douglaspmcgowan/cloth-feed-gripper/docs/gripper/evidence/ui-publication-20261023/README.md

# Gripper fit/loading fixes delivered

PR21 was merged to main2018f46 and deployed to the existing https://cloth-feed-gripper.vercel.app project. The actual public review HTML, facts and provenance match the independently accepted source bytes. The existing live guard passed27checks with0failures.

Receiving Windows static checks passed29tests with1unchanged native-CadQuery skip; lint, public-content and canonical project verification passed. The deployed viewer regression exercised gap/overlap findings at390/768/1440, three loading/failure states and delayed-success recovery. All9native screenshots fully decode; raw assertions and bounds are retained.

The browser run used actual production HTML and model/data assets, with only the exact original verified Three.js dependency served from recorded fixtures. Blocked and delayed dependencies are intentional negative controls. This proves the scoped deployed UI behavior under that dependency boundary, not current CDN availability or full C2/hardware readiness. Prior independent acceptance in PDS PR87 applies to byte-identical product source. Known whole-model exploded clipping and camera-bearing permalink reload remain separate follow-ups. Film and engineering/physical claims are unchanged.

See summary.json and the complete19original browser artifacts. The phone gap capture shows both labelled comparison anchors and a locator; the dependency-terminal capture deliberately shows the failed-library recovery state.
