douglaspmcgowan/cloth-feed-gripper/ecad/gripper/kicad/fab/README.md

# Fabrication release — gripper controller rev A

<!-- ORDER-STATUS:BEGIN -->
## Order status — DO NOT ORDER

Input provenance uses per-module read granularity; each row lists modules read in margins.json.

- `input-fuse-hold`: missing: F1 MF-MSMF260/16X — hold-current tolerance at 25 C; find in datasheet electrical characteristics table; 47 uF ceramics — effective capacitance at DC bias; find in manufacturer DC-bias curves; FSR sensor — fit exponent confidence interval; find in DESIGN-BASIS.md section 10 force sweep; L1 SRP1245A-100M — inductance tolerance and bias derating; find in manufacturer datasheet curves; servo Fit A dyno specimen — stall-current fit confidence interval; find in DESIGN-BASIS.md section 10 force/current sweep; RS1 WSLP1206R1000FEA — resistance over temperature; find in manufacturer datasheet and calibration step; wrist capacitor — capacitance after bias temperature and ageing; find in manufacturer datasheet; unclassified: ELEC.c_comp_F; unclassified: ELEC.c_pole_F; unclassified: ELEC.cable_len_m; unclassified: ELEC.cable_power_awg; unclassified: ELEC.r_comp_ohm; unclassified: ELEC.r_fb_bot_ohm; unclassified: ELEC.r_fb_top_ohm; unclassified: ELEC.r_rt_ohm; unclassified: ELEC.vref_V; unclassified: ams_dropout_max; unclassified: ams_vout_tol; unclassified: awg20_ohm_m; unclassified: awg26_ohm_m; unclassified: buck_feedback_resistor_tolerance; unclassified: buck_input_max_v; unclassified: buck_input_min_v; unclassified: buck_nominal_input_v; unclassified: buck_servo_lead_resistance_ohm; unclassified: c12_esr; unclassified: c_wrist_esr; unclassified: cable_l_per_m; unclassified: cer_derate_6v6; unclassified: d2_vf; unclassified: d7_vf_100ma; unclassified: d7_vf_slope; unclassified: devkit_diode_drop; unclassified: devkit_overhead_a; unclassified: droop_5v_load_a; unclassified: droop_comp_zero_v; unclassified: droop_default_rise_s; unclassified: droop_default_vin_v; unclassified: droop_diode_v; unclassified: droop_end_time_s; unclassified: droop_fast_rise_s; unclassified: droop_fsw_hz; unclassified: droop_low_vin_v; unclassified: droop_no_wrist_cap_f; unclassified: droop_recovery_band_v; unclassified: droop_servo_idle_a; unclassified: droop_step_time_s; unclassified: droop_sweep_cap_1000_f; unclassified: droop_sweep_cap_2200_f; unclassified: droop_sweep_cap_220_f; unclassified: droop_sweep_cap_470_f; unclassified: droop_voltage_floor_v; unclassified: esp_bod_default; unclassified: esp_i_active_nowifi; unclassified: esp_i_wifi_rx; unclassified: esp_i_wifi_tx_peak; unclassified: esp_vdd_min_flash; unclassified: f1_hold; unclassified: f1_r1max; unclassified: fit_a_hold_a; unclassified: fit_a_resistance_ohm; unclassified: fit_a_torque_nm_per_a; unclassified: fit_b_hold_a; unclassified: fit_b_resistance_ohm; unclassified: fit_b_stall_a; unclassified: fit_b_torque_nm_per_a; unclassified: fsr_default_vcc_mv; unclassified: fsr_fit_r1n_ohm; unclassified: harness_plug_band_v; unclassified: ibus_5v_idle; unclassified: l1_dcr; unclassified: mcp_dropout_max; unclassified: mcp_iout_max; unclassified: mcp_rth_sot223; unclassified: mcp_vout_tol; unclassified: power_3v3_minus_1pct_mv; unclassified: power_3v3_minus_3pct_mv; unclassified: power_3v3_plus_1pct_mv; unclassified: power_3v3_rail_v; unclassified: power_board_plane_resistance_ohm; unclassified: power_diode_reference_current_a; unclassified: power_external_3v3_load_a; unclassified: power_fit_a_stall_current_a; unclassified: power_five_volt_rail_v; unclassified: power_fsr_force_high_n; unclassified: power_fsr_force_low_n; unclassified: power_fsr_return_current_a; unclassified: power_ground_wire_length_m; unclassified: power_ldo_dropout_scale_cap; unclassified: power_ldo_full_load_dropout_ratio; unclassified: power_ldo_light_load_a; unclassified: power_ldo_load_span_a; unclassified: power_log_current_floor_a; unclassified: power_rating_margin_factor; unclassified: power_regen_basis_mj; unclassified: power_regen_high_mj; unclassified: power_regen_low_mj; unclassified: power_regen_min_mj; unclassified: power_regen_rotor_mj; unclassified: power_starting_efficiency; unclassified: power_switch_transition_time_s; unclassified: power_usb_max_v; unclassified: power_usb_min_v; unclassified: q1_rds; unclassified: rs1_rating; unclassified: servo_idle_a; unclassified: servo_vmax; unclassified: servo_vmin; unclassified: tps_ea_gain; unclassified: tps_ea_gm; unclassified: tps_ea_imax; unclassified: tps_ilim_min; unclassified: tps_ilim_typ; unclassified: tps_iq; unclassified: tps_ps_gm; unclassified: tps_rds_typ; unclassified: tps_rt_coeff; unclassified: tps_rt_exp; unclassified: tps_rth_ja; unclassified: tps_vref; unclassified: tps_vref_max; unclassified: tps_vref_min; unclassified: wire_gauges_awg
- `input-fuse-trip`: missing: F1 MF-MSMF260/16X — trip-current tolerance at 25 C; find in datasheet electrical characteristics table; 47 uF ceramics — effective capacitance at DC bias; find in manufacturer DC-bias curves; FSR sensor — fit exponent confidence interval; find in DESIGN-BASIS.md section 10 force sweep; L1 SRP1245A-100M — inductance tolerance and bias derating; find in manufacturer datasheet curves; servo Fit A dyno specimen — stall-current fit confidence interval; find in DESIGN-BASIS.md section 10 force/current sweep; RS1 WSLP1206R1000FEA — resistance over temperature; find in manufacturer datasheet and calibration step; wrist capacitor — capacitance after bias temperature and ageing; find in manufacturer datasheet; unclassified: ELEC.c_comp_F; unclassified: ELEC.c_pole_F; unclassified: ELEC.cable_len_m; unclassified: ELEC.cable_power_awg; unclassified: ELEC.r_comp_ohm; unclassified: ELEC.r_fb_bot_ohm; unclassified: ELEC.r_fb_top_ohm; unclassified: ELEC.r_rt_ohm; unclassified: ELEC.vref_V; unclassified: ams_dropout_max; unclassified: ams_vout_tol; unclassified: awg20_ohm_m; unclassified: awg26_ohm_m; unclassified: buck_feedback_resistor_tolerance; unclassified: buck_input_max_v; unclassified: buck_input_min_v; unclassified: buck_nominal_input_v; unclassified: buck_servo_lead_resistance_ohm; unclassified: c12_esr; unclassified: c_wrist_esr; unclassified: cable_l_per_m; unclassified: cer_derate_6v6; unclassified: d2_vf; unclassified: d7_vf_100ma; unclassified: d7_vf_slope; unclassified: devkit_diode_drop; unclassified: devkit_overhead_a; unclassified: droop_5v_load_a; unclassified: droop_comp_zero_v; unclassified: droop_default_rise_s; unclassified: droop_default_vin_v; unclassified: droop_diode_v; unclassified: droop_end_time_s; unclassified: droop_fast_rise_s; unclassified: droop_fsw_hz; unclassified: droop_low_vin_v; unclassified: droop_no_wrist_cap_f; unclassified: droop_recovery_band_v; unclassified: droop_servo_idle_a; unclassified: droop_step_time_s; unclassified: droop_sweep_cap_1000_f; unclassified: droop_sweep_cap_2200_f; unclassified: droop_sweep_cap_220_f; unclassified: droop_sweep_cap_470_f; unclassified: droop_voltage_floor_v; unclassified: esp_bod_default; unclassified: esp_i_active_nowifi; unclassified: esp_i_wifi_rx; unclassified: esp_i_wifi_tx_peak; unclassified: esp_vdd_min_flash; unclassified: f1_hold; unclassified: f1_r1max; unclassified: f1_trip; unclassified: fit_a_hold_a; unclassified: fit_a_resistance_ohm; unclassified: fit_a_torque_nm_per_a; unclassified: fit_b_hold_a; unclassified: fit_b_resistance_ohm; unclassified: fit_b_stall_a; unclassified: fit_b_torque_nm_per_a; unclassified: fsr_default_vcc_mv; unclassified: fsr_fit_r1n_ohm; unclassified: harness_plug_band_v; unclassified: ibus_5v_idle; unclassified: l1_dcr; unclassified: mcp_dropout_max; unclassified: mcp_iout_max; unclassified: mcp_rth_sot223; unclassified: mcp_vout_tol; unclassified: power_3v3_minus_1pct_mv; unclassified: power_3v3_minus_3pct_mv; unclassified: power_3v3_plus_1pct_mv; unclassified: power_3v3_rail_v; unclassified: power_board_plane_resistance_ohm; unclassified: power_diode_reference_current_a; unclassified: power_external_3v3_load_a; unclassified: power_fit_a_stall_current_a; unclassified: power_five_volt_rail_v; unclassified: power_fsr_force_high_n; unclassified: power_fsr_force_low_n; unclassified: power_fsr_return_current_a; unclassified: power_ground_wire_length_m; unclassified: power_ldo_dropout_scale_cap; unclassified: power_ldo_full_load_dropout_ratio; unclassified: power_ldo_light_load_a; unclassified: power_ldo_load_span_a; unclassified: power_log_current_floor_a; unclassified: power_rating_margin_factor; unclassified: power_regen_basis_mj; unclassified: power_regen_high_mj; unclassified: power_regen_low_mj; unclassified: power_regen_min_mj; unclassified: power_regen_rotor_mj; unclassified: power_starting_efficiency; unclassified: power_switch_transition_time_s; unclassified: power_usb_max_v; unclassified: power_usb_min_v; unclassified: q1_rds; unclassified: rs1_rating; unclassified: servo_idle_a; unclassified: servo_vmax; unclassified: servo_vmin; unclassified: tps_ea_gain; unclassified: tps_ea_gm; unclassified: tps_ea_imax; unclassified: tps_ilim_min; unclassified: tps_ilim_typ; unclassified: tps_iq; unclassified: tps_ps_gm; unclassified: tps_rds_typ; unclassified: tps_rt_coeff; unclassified: tps_rt_exp; unclassified: tps_rth_ja; unclassified: tps_vref; unclassified: tps_vref_max; unclassified: tps_vref_min; unclassified: wire_gauges_awg
- `buck-current-limit`: missing: U1 TPS54560BDDAR — current-limit test-condition variation; find in datasheet electrical characteristics table; 47 uF ceramics — effective capacitance at DC bias; find in manufacturer DC-bias curves; L1 SRP1245A-100M — inductance tolerance and bias derating; find in manufacturer datasheet curves; servo Fit A dyno specimen — stall-current fit confidence interval; find in DESIGN-BASIS.md section 10 force/current sweep; RS1 WSLP1206R1000FEA — resistance over temperature; find in manufacturer datasheet and calibration step; wrist capacitor — capacitance after bias temperature and ageing; find in manufacturer datasheet; unclassified: ELEC.c_comp_F; unclassified: ELEC.c_pole_F; unclassified: ELEC.cable_len_m; unclassified: ELEC.cable_power_awg; unclassified: ELEC.r_comp_ohm; unclassified: ELEC.r_fb_bot_ohm; unclassified: ELEC.r_fb_top_ohm; unclassified: awg20_ohm_m; unclassified: c12_esr; unclassified: c_wrist_esr; unclassified: cable_l_per_m; unclassified: cer_derate_6v6; unclassified: devkit_overhead_a; unclassified: droop_5v_load_a; unclassified: droop_comp_zero_v; unclassified: droop_default_rise_s; unclassified: droop_default_vin_v; unclassified: droop_diode_v; unclassified: droop_end_time_s; unclassified: droop_fast_rise_s; unclassified: droop_fsw_hz; unclassified: droop_low_vin_v; unclassified: droop_no_wrist_cap_f; unclassified: droop_recovery_band_v; unclassified: droop_servo_idle_a; unclassified: droop_step_time_s; unclassified: droop_sweep_cap_1000_f; unclassified: droop_sweep_cap_2200_f; unclassified: droop_sweep_cap_220_f; unclassified: droop_sweep_cap_470_f; unclassified: droop_voltage_floor_v; unclassified: esp_i_active_nowifi; unclassified: esp_i_wifi_rx; unclassified: esp_i_wifi_tx_peak; unclassified: fit_a_hold_a; unclassified: fit_a_resistance_ohm; unclassified: fit_a_torque_nm_per_a; unclassified: fit_b_hold_a; unclassified: fit_b_resistance_ohm; unclassified: fit_b_stall_a; unclassified: fit_b_torque_nm_per_a; unclassified: ibus_5v_idle; unclassified: mcp_dropout_max; unclassified: mcp_iout_max; unclassified: power_external_3v3_load_a; unclassified: power_five_volt_rail_v; unclassified: power_ldo_dropout_scale_cap; unclassified: servo_vmin; unclassified: tps_ea_gain; unclassified: tps_ea_gm; unclassified: tps_ea_imax; unclassified: tps_ilim_min; unclassified: tps_ilim_typ; unclassified: tps_ps_gm; unclassified: tps_rds_typ; unclassified: tps_vref
- `buck-thermal`: missing: U1 TPS54560BDDAR — junction-to-ambient thermal resistance for the assembled PCB; find in DESIGN-BASIS.md section 10 thermal-rise bench step; 47 uF ceramics — effective capacitance at DC bias; find in manufacturer DC-bias curves; FSR sensor — fit exponent confidence interval; find in DESIGN-BASIS.md section 10 force sweep; L1 SRP1245A-100M — inductance tolerance and bias derating; find in manufacturer datasheet curves; servo Fit A dyno specimen — stall-current fit confidence interval; find in DESIGN-BASIS.md section 10 force/current sweep; RS1 WSLP1206R1000FEA — resistance over temperature; find in manufacturer datasheet and calibration step; wrist capacitor — capacitance after bias temperature and ageing; find in manufacturer datasheet; unclassified: ELEC.c_comp_F; unclassified: ELEC.c_pole_F; unclassified: ELEC.cable_len_m; unclassified: ELEC.cable_power_awg; unclassified: ELEC.r_comp_ohm; unclassified: ELEC.r_fb_bot_ohm; unclassified: ELEC.r_fb_top_ohm; unclassified: ELEC.r_rt_ohm; unclassified: ELEC.vref_V; unclassified: ams_dropout_max; unclassified: ams_vout_tol; unclassified: awg20_ohm_m; unclassified: awg26_ohm_m; unclassified: buck_feedback_resistor_tolerance; unclassified: buck_input_max_v; unclassified: buck_input_min_v; unclassified: buck_junction_rise_limit_c; unclassified: buck_nominal_input_v; unclassified: buck_servo_lead_resistance_ohm; unclassified: c12_esr; unclassified: c_wrist_esr; unclassified: cable_l_per_m; unclassified: cer_derate_6v6; unclassified: d2_vf; unclassified: d7_vf_100ma; unclassified: d7_vf_slope; unclassified: devkit_diode_drop; unclassified: devkit_overhead_a; unclassified: droop_5v_load_a; unclassified: droop_comp_zero_v; unclassified: droop_default_rise_s; unclassified: droop_default_vin_v; unclassified: droop_diode_v; unclassified: droop_end_time_s; unclassified: droop_fast_rise_s; unclassified: droop_fsw_hz; unclassified: droop_low_vin_v; unclassified: droop_no_wrist_cap_f; unclassified: droop_recovery_band_v; unclassified: droop_servo_idle_a; unclassified: droop_step_time_s; unclassified: droop_sweep_cap_1000_f; unclassified: droop_sweep_cap_2200_f; unclassified: droop_sweep_cap_220_f; unclassified: droop_sweep_cap_470_f; unclassified: droop_voltage_floor_v; unclassified: esp_bod_default; unclassified: esp_i_active_nowifi; unclassified: esp_i_wifi_rx; unclassified: esp_i_wifi_tx_peak; unclassified: esp_vdd_min_flash; unclassified: f1_hold; unclassified: f1_r1max; unclassified: fit_a_hold_a; unclassified: fit_a_resistance_ohm; unclassified: fit_a_torque_nm_per_a; unclassified: fit_b_hold_a; unclassified: fit_b_resistance_ohm; unclassified: fit_b_stall_a; unclassified: fit_b_torque_nm_per_a; unclassified: fsr_default_vcc_mv; unclassified: fsr_fit_r1n_ohm; unclassified: harness_plug_band_v; unclassified: ibus_5v_idle; unclassified: l1_dcr; unclassified: mcp_dropout_max; unclassified: mcp_iout_max; unclassified: mcp_rth_sot223; unclassified: mcp_vout_tol; unclassified: power_3v3_minus_1pct_mv; unclassified: power_3v3_minus_3pct_mv; unclassified: power_3v3_plus_1pct_mv; unclassified: power_3v3_rail_v; unclassified: power_board_plane_resistance_ohm; unclassified: power_diode_reference_current_a; unclassified: power_external_3v3_load_a; unclassified: power_fit_a_stall_current_a; unclassified: power_five_volt_rail_v; unclassified: power_fsr_force_high_n; unclassified: power_fsr_force_low_n; unclassified: power_fsr_return_current_a; unclassified: power_ground_wire_length_m; unclassified: power_ldo_dropout_scale_cap; unclassified: power_ldo_full_load_dropout_ratio; unclassified: power_ldo_light_load_a; unclassified: power_ldo_load_span_a; unclassified: power_log_current_floor_a; unclassified: power_rating_margin_factor; unclassified: power_regen_basis_mj; unclassified: power_regen_high_mj; unclassified: power_regen_low_mj; unclassified: power_regen_min_mj; unclassified: power_regen_rotor_mj; unclassified: power_starting_efficiency; unclassified: power_switch_transition_time_s; unclassified: power_usb_max_v; unclassified: power_usb_min_v; unclassified: q1_rds; unclassified: rs1_rating; unclassified: servo_idle_a; unclassified: servo_vmax; unclassified: servo_vmin; unclassified: tps_ea_gain; unclassified: tps_ea_gm; unclassified: tps_ea_imax; unclassified: tps_ilim_min; unclassified: tps_ilim_typ; unclassified: tps_iq; unclassified: tps_ps_gm; unclassified: tps_rds_typ; unclassified: tps_rt_coeff; unclassified: tps_rt_exp; unclassified: tps_rth_ja; unclassified: tps_vref; unclassified: tps_vref_max; unclassified: tps_vref_min; unclassified: wire_gauges_awg
- `trace-current`: missing: PCB copper — finished copper thickness tolerance; find in PCB fabricator stack-up certificate; servo Fit A dyno specimen — stall-current fit confidence interval; find in DESIGN-BASIS.md section 10 force/current sweep; unclassified: cu_rho; unclassified: cu_tc; unclassified: ipc_b; unclassified: ipc_c; unclassified: ipc_k_ext; unclassified: ipc_mil_per_oz; unclassified: trace_ambient_temperature_c; unclassified: trace_auxiliary_current_a; unclassified: trace_hold_current_a; unclassified: trace_mm_per_mil; unclassified: trace_reference_length_mm; unclassified: trace_reference_temperature_c; unclassified: trace_supply_current_a; unclassified: trace_temperature_rises_c; unclassified: trace_via_drill_mm; unclassified: trace_via_plating_um
- `trace-neck-current`: verify transient heating or widen neck; missing: PCB copper — finished copper thickness tolerance; find in PCB fabricator stack-up certificate; servo Fit A dyno specimen — stall-current fit confidence interval; find in DESIGN-BASIS.md section 10 force/current sweep; unclassified: cu_rho; unclassified: cu_tc; unclassified: ipc_b; unclassified: ipc_c; unclassified: ipc_k_ext; unclassified: ipc_mil_per_oz; unclassified: trace_ambient_temperature_c; unclassified: trace_auxiliary_current_a; unclassified: trace_hold_current_a; unclassified: trace_mm_per_mil; unclassified: trace_reference_length_mm; unclassified: trace_reference_temperature_c; unclassified: trace_supply_current_a; unclassified: trace_temperature_rises_c; unclassified: trace_via_drill_mm; unclassified: trace_via_plating_um
- `trace-temperature`: missing: PCB copper — finished copper thickness tolerance; find in PCB fabricator stack-up certificate; servo Fit A dyno specimen — stall-current fit confidence interval; find in DESIGN-BASIS.md section 10 force/current sweep; unclassified: cu_rho; unclassified: cu_tc; unclassified: ipc_b; unclassified: ipc_c; unclassified: ipc_k_ext; unclassified: ipc_mil_per_oz; unclassified: trace_ambient_temperature_c; unclassified: trace_auxiliary_current_a; unclassified: trace_hold_current_a; unclassified: trace_mm_per_mil; unclassified: trace_reference_length_mm; unclassified: trace_reference_temperature_c; unclassified: trace_supply_current_a; unclassified: trace_temp_rise_limit_c; unclassified: trace_temperature_rises_c; unclassified: trace_via_drill_mm; unclassified: trace_via_plating_um
- `trace-drop`: missing: PCB copper — finished copper thickness tolerance; find in PCB fabricator stack-up certificate; servo Fit A dyno specimen — stall-current fit confidence interval; find in DESIGN-BASIS.md section 10 force/current sweep; unclassified: cu_rho; unclassified: cu_tc; unclassified: ipc_b; unclassified: ipc_c; unclassified: ipc_k_ext; unclassified: ipc_mil_per_oz; unclassified: trace_ambient_temperature_c; unclassified: trace_auxiliary_current_a; unclassified: trace_hold_current_a; unclassified: trace_mm_per_mil; unclassified: trace_reference_length_mm; unclassified: trace_reference_temperature_c; unclassified: trace_servo_drop_limit_mv; unclassified: trace_supply_current_a; unclassified: trace_temperature_rises_c; unclassified: trace_via_drill_mm; unclassified: trace_via_plating_um
- `shunt-power`: 47 uF ceramics — effective capacitance at DC bias; find in manufacturer DC-bias curves; FSR sensor — fit exponent confidence interval; find in DESIGN-BASIS.md section 10 force sweep; L1 SRP1245A-100M — inductance tolerance and bias derating; find in manufacturer datasheet curves; servo Fit A dyno specimen — stall-current fit confidence interval; find in DESIGN-BASIS.md section 10 force/current sweep; RS1 WSLP1206R1000FEA — resistance over temperature; find in manufacturer datasheet and calibration step; wrist capacitor — capacitance after bias temperature and ageing; find in manufacturer datasheet; unclassified: ELEC.c_comp_F; unclassified: ELEC.c_pole_F; unclassified: ELEC.cable_len_m; unclassified: ELEC.cable_power_awg; unclassified: ELEC.r_comp_ohm; unclassified: ELEC.r_fb_bot_ohm; unclassified: ELEC.r_fb_top_ohm; unclassified: ELEC.r_rt_ohm; unclassified: ELEC.vref_V; unclassified: ams_dropout_max; unclassified: ams_vout_tol; unclassified: awg20_ohm_m; unclassified: awg26_ohm_m; unclassified: buck_feedback_resistor_tolerance; unclassified: buck_input_max_v; unclassified: buck_input_min_v; unclassified: buck_nominal_input_v; unclassified: buck_servo_lead_resistance_ohm; unclassified: c12_esr; unclassified: c_wrist_esr; unclassified: cable_l_per_m; unclassified: cer_derate_6v6; unclassified: d2_vf; unclassified: d7_vf_100ma; unclassified: d7_vf_slope; unclassified: devkit_diode_drop; unclassified: devkit_overhead_a; unclassified: droop_5v_load_a; unclassified: droop_comp_zero_v; unclassified: droop_default_rise_s; unclassified: droop_default_vin_v; unclassified: droop_diode_v; unclassified: droop_end_time_s; unclassified: droop_fast_rise_s; unclassified: droop_fsw_hz; unclassified: droop_low_vin_v; unclassified: droop_no_wrist_cap_f; unclassified: droop_recovery_band_v; unclassified: droop_servo_idle_a; unclassified: droop_step_time_s; unclassified: droop_sweep_cap_1000_f; unclassified: droop_sweep_cap_2200_f; unclassified: droop_sweep_cap_220_f; unclassified: droop_sweep_cap_470_f; unclassified: droop_voltage_floor_v; unclassified: esp_bod_default; unclassified: esp_i_active_nowifi; unclassified: esp_i_wifi_rx; unclassified: esp_i_wifi_tx_peak; unclassified: esp_vdd_min_flash; unclassified: f1_hold; unclassified: f1_r1max; unclassified: fit_a_hold_a; unclassified: fit_a_resistance_ohm; unclassified: fit_a_torque_nm_per_a; unclassified: fit_b_hold_a; unclassified: fit_b_resistance_ohm; unclassified: fit_b_stall_a; unclassified: fit_b_torque_nm_per_a; unclassified: fsr_default_vcc_mv; unclassified: fsr_fit_r1n_ohm; unclassified: harness_plug_band_v; unclassified: ibus_5v_idle; unclassified: l1_dcr; unclassified: mcp_dropout_max; unclassified: mcp_iout_max; unclassified: mcp_rth_sot223; unclassified: mcp_vout_tol; unclassified: power_3v3_minus_1pct_mv; unclassified: power_3v3_minus_3pct_mv; unclassified: power_3v3_plus_1pct_mv; unclassified: power_3v3_rail_v; unclassified: power_board_plane_resistance_ohm; unclassified: power_diode_reference_current_a; unclassified: power_external_3v3_load_a; unclassified: power_fit_a_stall_current_a; unclassified: power_five_volt_rail_v; unclassified: power_fsr_force_high_n; unclassified: power_fsr_force_low_n; unclassified: power_fsr_return_current_a; unclassified: power_ground_wire_length_m; unclassified: power_ldo_dropout_scale_cap; unclassified: power_ldo_full_load_dropout_ratio; unclassified: power_ldo_light_load_a; unclassified: power_ldo_load_span_a; unclassified: power_log_current_floor_a; unclassified: power_rating_margin_factor; unclassified: power_regen_basis_mj; unclassified: power_regen_high_mj; unclassified: power_regen_low_mj; unclassified: power_regen_min_mj; unclassified: power_regen_rotor_mj; unclassified: power_starting_efficiency; unclassified: power_switch_transition_time_s; unclassified: power_usb_max_v; unclassified: power_usb_min_v; unclassified: q1_rds; unclassified: rs1_rating; unclassified: rs1_tol; unclassified: servo_idle_a; unclassified: servo_vmax; unclassified: servo_vmin; unclassified: tps_ea_gain; unclassified: tps_ea_gm; unclassified: tps_ea_imax; unclassified: tps_ilim_min; unclassified: tps_ilim_typ; unclassified: tps_iq; unclassified: tps_ps_gm; unclassified: tps_rds_typ; unclassified: tps_rt_coeff; unclassified: tps_rt_exp; unclassified: tps_rth_ja; unclassified: tps_vref; unclassified: tps_vref_max; unclassified: tps_vref_min; unclassified: wire_gauges_awg
- `sense-range`: missing: U2 INA219AIDR — input-filter source-impedance mismatch; find in DESIGN-BASIS.md section 10 current-calibration bench step; servo Fit A dyno specimen — stall-current fit confidence interval; find in DESIGN-BASIS.md section 10 force/current sweep; RS1 WSLP1206R1000FEA — resistance over temperature; find in manufacturer datasheet and calibration step; unclassified: ELEC.r_ina_filter_ohm; unclassified: fit_a_hold_a; unclassified: fit_a_resistance_ohm; unclassified: fit_a_torque_nm_per_a; unclassified: fit_b_hold_a; unclassified: fit_b_resistance_ohm; unclassified: fit_b_stall_a; unclassified: fit_b_torque_nm_per_a; unclassified: gripper_pad_radius_m; unclassified: gripper_train_efficiency; unclassified: ina_average_codes_samples; unclassified: ina_average_fit_limit_s; unclassified: ina_chop_duty; unclassified: ina_chop_frequencies_hz; unclassified: ina_control_period_s; unclassified: ina_conv_12bit; unclassified: ina_conv_12bit_max; unclassified: ina_default_cfg; unclassified: ina_detection_limit_s; unclassified: ina_force_caps_n; unclassified: ina_fs_pga8; unclassified: ina_gain_tc; unclassified: ina_gain_temperature_span_c; unclassified: ina_ibias; unclassified: ina_input_impedance_ohm; unclassified: ina_lsb; unclassified: ina_meas_err_max; unclassified: ina_recommended_sadc_code; unclassified: ina_sadc_mask; unclassified: ina_sadc_shift; unclassified: ina_saturation_error_fraction; unclassified: ina_shunt_temperature_rise_c; unclassified: ina_trip_current_a; unclassified: ina_trip_window_s; unclassified: ina_vos_pga8; unclassified: rs1_tcr; unclassified: rs1_tol; unclassified: servo_hold_torque_nm
- `current-error`: missing: U2 INA219AIDR — input-filter source-impedance mismatch; find in DESIGN-BASIS.md section 10 current-calibration bench step; servo Fit A dyno specimen — stall-current fit confidence interval; find in DESIGN-BASIS.md section 10 force/current sweep; RS1 WSLP1206R1000FEA — resistance over temperature; find in manufacturer datasheet and calibration step; unclassified: ELEC.r_ina_filter_ohm; unclassified: fit_a_hold_a; unclassified: fit_a_resistance_ohm; unclassified: fit_a_torque_nm_per_a; unclassified: fit_b_hold_a; unclassified: fit_b_resistance_ohm; unclassified: fit_b_stall_a; unclassified: fit_b_torque_nm_per_a; unclassified: gripper_pad_radius_m; unclassified: gripper_train_efficiency; unclassified: ina_average_codes_samples; unclassified: ina_average_fit_limit_s; unclassified: ina_chop_duty; unclassified: ina_chop_frequencies_hz; unclassified: ina_control_period_s; unclassified: ina_conv_12bit; unclassified: ina_conv_12bit_max; unclassified: ina_current_error_limit_a; unclassified: ina_default_cfg; unclassified: ina_detection_limit_s; unclassified: ina_force_caps_n; unclassified: ina_fs_pga8; unclassified: ina_gain_tc; unclassified: ina_gain_temperature_span_c; unclassified: ina_ibias; unclassified: ina_input_impedance_ohm; unclassified: ina_lsb; unclassified: ina_meas_err_max; unclassified: ina_recommended_sadc_code; unclassified: ina_sadc_mask; unclassified: ina_sadc_shift; unclassified: ina_saturation_error_fraction; unclassified: ina_shunt_temperature_rise_c; unclassified: ina_trip_current_a; unclassified: ina_trip_window_s; unclassified: ina_vos_pga8; unclassified: rs1_tcr; unclassified: rs1_tol; unclassified: servo_hold_torque_nm
- `detection-time`: missing: U2 INA219AIDR — input-filter source-impedance mismatch; find in DESIGN-BASIS.md section 10 current-calibration bench step; servo Fit A dyno specimen — stall-current fit confidence interval; find in DESIGN-BASIS.md section 10 force/current sweep; RS1 WSLP1206R1000FEA — resistance over temperature; find in manufacturer datasheet and calibration step; unclassified: ELEC.r_ina_filter_ohm; unclassified: fit_a_hold_a; unclassified: fit_a_resistance_ohm; unclassified: fit_a_torque_nm_per_a; unclassified: fit_b_hold_a; unclassified: fit_b_resistance_ohm; unclassified: fit_b_stall_a; unclassified: fit_b_torque_nm_per_a; unclassified: gripper_pad_radius_m; unclassified: gripper_train_efficiency; unclassified: ina_average_codes_samples; unclassified: ina_average_fit_limit_s; unclassified: ina_chop_duty; unclassified: ina_chop_frequencies_hz; unclassified: ina_control_period_s; unclassified: ina_conv_12bit; unclassified: ina_conv_12bit_max; unclassified: ina_default_cfg; unclassified: ina_detection_limit_s; unclassified: ina_force_caps_n; unclassified: ina_fs_pga8; unclassified: ina_gain_tc; unclassified: ina_gain_temperature_span_c; unclassified: ina_ibias; unclassified: ina_input_impedance_ohm; unclassified: ina_lsb; unclassified: ina_meas_err_max; unclassified: ina_recommended_sadc_code; unclassified: ina_sadc_mask; unclassified: ina_sadc_shift; unclassified: ina_saturation_error_fraction; unclassified: ina_shunt_temperature_rise_c; unclassified: ina_trip_current_a; unclassified: ina_trip_window_s; unclassified: ina_vos_pga8; unclassified: rs1_tcr; unclassified: rs1_tol; unclassified: servo_hold_torque_nm
- `fsr-node-high`: missing: U3 ESP32-WROOM-32E — ADC linear-range endpoint variation; find in DESIGN-BASIS.md section 10 ADC sweep bench step; FSR sensor — fit exponent confidence interval; find in DESIGN-BASIS.md section 10 force sweep; unclassified: ELEC.c_aa_F; unclassified: ELEC.r_aa_ohm; unclassified: ctrl_lag_budget_s; unclassified: ema_alpha; unclassified: esp_adc_cs_pf; unclassified: esp_adc_err_mv; unclassified: esp_adc_max_mv; unclassified: esp_adc_min_mv; unclassified: esp_adc_resolution_bits; unclassified: esp_adc_rsw_ohm; unclassified: fsr_default_vcc_mv; unclassified: fsr_e96_search_hi_ohm; unclassified: fsr_e96_search_lo_ohm; unclassified: fsr_filter_gain_freqs_hz; unclassified: fsr_fit_r1n_ohm; unclassified: fsr_resolution_force_n; unclassified: fsr_sample_rate_hz; unclassified: fsr_table_forces_n; unclassified: fsr_unloaded_force_n; unclassified: ina_force_caps_n
- `force-reading-error`: missing: J1/J2/J3 harness assembly — finished conductor resistance and contact-resistance range; find in DESIGN-BASIS.md section 10 harness milliohm bench step; FSR sensor — fit exponent confidence interval; find in DESIGN-BASIS.md section 10 force sweep; servo Fit A dyno specimen — stall-current fit confidence interval; find in DESIGN-BASIS.md section 10 force/current sweep; unclassified: ELEC.cable_len_m; unclassified: ELEC.r_fb_bot_ohm; unclassified: ELEC.r_fb_top_ohm; unclassified: ELEC.r_lim_pullup_ohm; unclassified: ELEC.vref_V; unclassified: awg20_ohm_m; unclassified: awg22_ohm_m; unclassified: awg26_ohm_m; unclassified: buck_feedback_resistor_tolerance; unclassified: buck_servo_lead_resistance_ohm; unclassified: esp_adc_resolution_bits; unclassified: fit_a_hold_a; unclassified: fit_a_resistance_ohm; unclassified: fit_a_torque_nm_per_a; unclassified: fit_b_hold_a; unclassified: fit_b_resistance_ohm; unclassified: fit_b_stall_a; unclassified: fit_b_torque_nm_per_a; unclassified: fsr_default_vcc_mv; unclassified: fsr_fit_r1n_ohm; unclassified: harness_adapter_cord_mm; unclassified: harness_awg_pigtail; unclassified: harness_awg_power; unclassified: harness_awg_signal; unclassified: harness_bend_factor; unclassified: harness_bend_factor_abs; unclassified: harness_cap_lead_mm; unclassified: harness_cycle_s; unclassified: harness_design_life_cycles; unclassified: harness_force_error_limit_n; unclassified: harness_fsr_error_forces_n; unclassified: harness_fsr_force_cap_n; unclassified: harness_fsr_run_mm; unclassified: harness_jaw_max_deg; unclassified: harness_limit_run_mm; unclassified: harness_od_26awg_mm; unclassified: harness_pigtail_mm; unclassified: harness_plug_band_v; unclassified: harness_plug_rating_v; unclassified: harness_pwm_current_a; unclassified: harness_semester_fraction; unclassified: harness_servo_lead_ohm; unclassified: harness_servo_v_min; unclassified: harness_spare_fraction; unclassified: harness_unwired_length_mm; unclassified: harness_usb_cable_mm; unclassified: harness_vil_fraction; unclassified: tps_vref_max; unclassified: tps_vref_min
- `adc-charge`: missing: C17 100 nF — capacitance tolerance; find in C17 manufacturer datasheet capacitance-tolerance table; FSR sensor — fit exponent confidence interval; find in DESIGN-BASIS.md section 10 force sweep; unclassified: ELEC.c_aa_F; unclassified: ELEC.r_aa_ohm; unclassified: ctrl_lag_budget_s; unclassified: ema_alpha; unclassified: esp_adc_cs_pf; unclassified: esp_adc_err_mv; unclassified: esp_adc_max_mv; unclassified: esp_adc_min_mv; unclassified: esp_adc_resolution_bits; unclassified: esp_adc_rsw_ohm; unclassified: fsr_adc_droop_limit_mv; unclassified: fsr_default_vcc_mv; unclassified: fsr_e96_search_hi_ohm; unclassified: fsr_e96_search_lo_ohm; unclassified: fsr_filter_gain_freqs_hz; unclassified: fsr_fit_r1n_ohm; unclassified: fsr_resolution_force_n; unclassified: fsr_sample_rate_hz; unclassified: fsr_table_forces_n; unclassified: fsr_unloaded_force_n; unclassified: ina_force_caps_n
- `filter-delay`: missing: C17 100 nF — capacitance tolerance; find in C17 manufacturer datasheet capacitance-tolerance table; FSR sensor — fit exponent confidence interval; find in DESIGN-BASIS.md section 10 force sweep; unclassified: ELEC.c_aa_F; unclassified: ELEC.r_aa_ohm; unclassified: ctrl_lag_budget_s; unclassified: ema_alpha; unclassified: esp_adc_cs_pf; unclassified: esp_adc_err_mv; unclassified: esp_adc_max_mv; unclassified: esp_adc_min_mv; unclassified: esp_adc_resolution_bits; unclassified: esp_adc_rsw_ohm; unclassified: fsr_default_vcc_mv; unclassified: fsr_e96_search_hi_ohm; unclassified: fsr_e96_search_lo_ohm; unclassified: fsr_filter_gain_freqs_hz; unclassified: fsr_fit_r1n_ohm; unclassified: fsr_resolution_force_n; unclassified: fsr_sample_rate_hz; unclassified: fsr_table_forces_n; unclassified: fsr_unloaded_force_n; unclassified: ina_force_caps_n
- `firmware-trip-10N`: missing: servo Fit A dyno specimen — torque-constant and hold-current fit confidence interval; find in DESIGN-BASIS.md section 10 force/current sweep; servo Fit A dyno specimen — stall-current fit confidence interval; find in DESIGN-BASIS.md section 10 force/current sweep; RS1 WSLP1206R1000FEA — resistance over temperature; find in manufacturer datasheet and calibration step; unclassified: ELEC.r_ina_filter_ohm; unclassified: fit_a_hold_a; unclassified: fit_a_resistance_ohm; unclassified: fit_a_torque_nm_per_a; unclassified: fit_b_hold_a; unclassified: fit_b_resistance_ohm; unclassified: fit_b_stall_a; unclassified: fit_b_torque_nm_per_a; unclassified: gripper_pad_radius_m; unclassified: gripper_train_efficiency; unclassified: ina_average_codes_samples; unclassified: ina_average_fit_limit_s; unclassified: ina_chop_duty; unclassified: ina_chop_frequencies_hz; unclassified: ina_control_period_s; unclassified: ina_conv_12bit; unclassified: ina_conv_12bit_max; unclassified: ina_default_cfg; unclassified: ina_detection_limit_s; unclassified: ina_force_caps_n; unclassified: ina_fs_pga8; unclassified: ina_gain_tc; unclassified: ina_gain_temperature_span_c; unclassified: ina_ibias; unclassified: ina_input_impedance_ohm; unclassified: ina_lsb; unclassified: ina_meas_err_max; unclassified: ina_recommended_sadc_code; unclassified: ina_sadc_mask; unclassified: ina_sadc_shift; unclassified: ina_saturation_error_fraction; unclassified: ina_shunt_temperature_rise_c; unclassified: ina_trip_current_a; unclassified: ina_trip_window_s; unclassified: ina_vos_pga8; unclassified: rs1_tcr; unclassified: rs1_tol; unclassified: servo_hold_torque_nm
- `firmware-trip-8N`: missing: servo Fit A dyno specimen — torque-constant and hold-current fit confidence interval; find in DESIGN-BASIS.md section 10 force/current sweep; servo Fit A dyno specimen — stall-current fit confidence interval; find in DESIGN-BASIS.md section 10 force/current sweep; RS1 WSLP1206R1000FEA — resistance over temperature; find in manufacturer datasheet and calibration step; unclassified: ELEC.r_ina_filter_ohm; unclassified: fit_a_hold_a; unclassified: fit_a_resistance_ohm; unclassified: fit_a_torque_nm_per_a; unclassified: fit_b_hold_a; unclassified: fit_b_resistance_ohm; unclassified: fit_b_stall_a; unclassified: fit_b_torque_nm_per_a; unclassified: gripper_pad_radius_m; unclassified: gripper_train_efficiency; unclassified: ina_average_codes_samples; unclassified: ina_average_fit_limit_s; unclassified: ina_chop_duty; unclassified: ina_chop_frequencies_hz; unclassified: ina_control_period_s; unclassified: ina_conv_12bit; unclassified: ina_conv_12bit_max; unclassified: ina_default_cfg; unclassified: ina_detection_limit_s; unclassified: ina_force_caps_n; unclassified: ina_fs_pga8; unclassified: ina_gain_tc; unclassified: ina_gain_temperature_span_c; unclassified: ina_ibias; unclassified: ina_input_impedance_ohm; unclassified: ina_lsb; unclassified: ina_meas_err_max; unclassified: ina_recommended_sadc_code; unclassified: ina_sadc_mask; unclassified: ina_sadc_shift; unclassified: ina_saturation_error_fraction; unclassified: ina_shunt_temperature_rise_c; unclassified: ina_trip_current_a; unclassified: ina_trip_window_s; unclassified: ina_vos_pga8; unclassified: rs1_tcr; unclassified: rs1_tol; unclassified: servo_hold_torque_nm
- `adapter-current`: missing: PS1 12 V 3 A adapter — rated-current capability over temperature; find in adapter datasheet output-current table; 47 uF ceramics — effective capacitance at DC bias; find in manufacturer DC-bias curves; FSR sensor — fit exponent confidence interval; find in DESIGN-BASIS.md section 10 force sweep; L1 SRP1245A-100M — inductance tolerance and bias derating; find in manufacturer datasheet curves; servo Fit A dyno specimen — stall-current fit confidence interval; find in DESIGN-BASIS.md section 10 force/current sweep; RS1 WSLP1206R1000FEA — resistance over temperature; find in manufacturer datasheet and calibration step; wrist capacitor — capacitance after bias temperature and ageing; find in manufacturer datasheet; unclassified: ELEC.c_comp_F; unclassified: ELEC.c_pole_F; unclassified: ELEC.cable_len_m; unclassified: ELEC.cable_power_awg; unclassified: ELEC.r_comp_ohm; unclassified: ELEC.r_fb_bot_ohm; unclassified: ELEC.r_fb_top_ohm; unclassified: ELEC.r_rt_ohm; unclassified: ELEC.vref_V; unclassified: adapter_current_a; unclassified: ams_dropout_max; unclassified: ams_vout_tol; unclassified: awg20_ohm_m; unclassified: awg26_ohm_m; unclassified: buck_feedback_resistor_tolerance; unclassified: buck_input_max_v; unclassified: buck_input_min_v; unclassified: buck_nominal_input_v; unclassified: buck_servo_lead_resistance_ohm; unclassified: c12_esr; unclassified: c_wrist_esr; unclassified: cable_l_per_m; unclassified: cer_derate_6v6; unclassified: d2_vf; unclassified: d7_vf_100ma; unclassified: d7_vf_slope; unclassified: devkit_diode_drop; unclassified: devkit_overhead_a; unclassified: droop_5v_load_a; unclassified: droop_comp_zero_v; unclassified: droop_default_rise_s; unclassified: droop_default_vin_v; unclassified: droop_diode_v; unclassified: droop_end_time_s; unclassified: droop_fast_rise_s; unclassified: droop_fsw_hz; unclassified: droop_low_vin_v; unclassified: droop_no_wrist_cap_f; unclassified: droop_recovery_band_v; unclassified: droop_servo_idle_a; unclassified: droop_step_time_s; unclassified: droop_sweep_cap_1000_f; unclassified: droop_sweep_cap_2200_f; unclassified: droop_sweep_cap_220_f; unclassified: droop_sweep_cap_470_f; unclassified: droop_voltage_floor_v; unclassified: esp_bod_default; unclassified: esp_i_active_nowifi; unclassified: esp_i_wifi_rx; unclassified: esp_i_wifi_tx_peak; unclassified: esp_vdd_min_flash; unclassified: f1_hold; unclassified: f1_r1max; unclassified: fit_a_hold_a; unclassified: fit_a_resistance_ohm; unclassified: fit_a_torque_nm_per_a; unclassified: fit_b_hold_a; unclassified: fit_b_resistance_ohm; unclassified: fit_b_stall_a; unclassified: fit_b_torque_nm_per_a; unclassified: fsr_default_vcc_mv; unclassified: fsr_fit_r1n_ohm; unclassified: harness_plug_band_v; unclassified: ibus_5v_idle; unclassified: l1_dcr; unclassified: mcp_dropout_max; unclassified: mcp_iout_max; unclassified: mcp_rth_sot223; unclassified: mcp_vout_tol; unclassified: power_3v3_minus_1pct_mv; unclassified: power_3v3_minus_3pct_mv; unclassified: power_3v3_plus_1pct_mv; unclassified: power_3v3_rail_v; unclassified: power_board_plane_resistance_ohm; unclassified: power_diode_reference_current_a; unclassified: power_external_3v3_load_a; unclassified: power_fit_a_stall_current_a; unclassified: power_five_volt_rail_v; unclassified: power_fsr_force_high_n; unclassified: power_fsr_force_low_n; unclassified: power_fsr_return_current_a; unclassified: power_ground_wire_length_m; unclassified: power_ldo_dropout_scale_cap; unclassified: power_ldo_full_load_dropout_ratio; unclassified: power_ldo_light_load_a; unclassified: power_ldo_load_span_a; unclassified: power_log_current_floor_a; unclassified: power_rating_margin_factor; unclassified: power_regen_basis_mj; unclassified: power_regen_high_mj; unclassified: power_regen_low_mj; unclassified: power_regen_min_mj; unclassified: power_regen_rotor_mj; unclassified: power_starting_efficiency; unclassified: power_switch_transition_time_s; unclassified: power_usb_max_v; unclassified: power_usb_min_v; unclassified: q1_rds; unclassified: rs1_rating; unclassified: servo_idle_a; unclassified: servo_vmax; unclassified: servo_vmin; unclassified: tps_ea_gain; unclassified: tps_ea_gm; unclassified: tps_ea_imax; unclassified: tps_ilim_min; unclassified: tps_ilim_typ; unclassified: tps_iq; unclassified: tps_ps_gm; unclassified: tps_rds_typ; unclassified: tps_rt_coeff; unclassified: tps_rt_exp; unclassified: tps_rth_ja; unclassified: tps_vref; unclassified: tps_vref_max; unclassified: tps_vref_min; unclassified: wire_gauges_awg
- `droop-servo-min`: missing: C12 1000 uF — capacitance and ESR after bias, temperature, and ageing; find in DESIGN-BASIS.md section 10 load-step bench step; 47 uF ceramics — effective capacitance at DC bias; find in manufacturer DC-bias curves; L1 SRP1245A-100M — inductance tolerance and bias derating; find in manufacturer datasheet curves; servo Fit A dyno specimen — stall-current fit confidence interval; find in DESIGN-BASIS.md section 10 force/current sweep; RS1 WSLP1206R1000FEA — resistance over temperature; find in manufacturer datasheet and calibration step; wrist capacitor — capacitance after bias temperature and ageing; find in manufacturer datasheet; unclassified: ELEC.c_comp_F; unclassified: ELEC.c_pole_F; unclassified: ELEC.cable_len_m; unclassified: ELEC.cable_power_awg; unclassified: ELEC.r_comp_ohm; unclassified: ELEC.r_fb_bot_ohm; unclassified: ELEC.r_fb_top_ohm; unclassified: awg20_ohm_m; unclassified: c12_esr; unclassified: c_wrist_esr; unclassified: cable_l_per_m; unclassified: cer_derate_6v6; unclassified: devkit_overhead_a; unclassified: droop_5v_load_a; unclassified: droop_comp_zero_v; unclassified: droop_default_rise_s; unclassified: droop_default_vin_v; unclassified: droop_diode_v; unclassified: droop_end_time_s; unclassified: droop_fast_rise_s; unclassified: droop_fsw_hz; unclassified: droop_low_vin_v; unclassified: droop_no_wrist_cap_f; unclassified: droop_recovery_band_v; unclassified: droop_servo_idle_a; unclassified: droop_step_time_s; unclassified: droop_sweep_cap_1000_f; unclassified: droop_sweep_cap_2200_f; unclassified: droop_sweep_cap_220_f; unclassified: droop_sweep_cap_470_f; unclassified: droop_voltage_floor_v; unclassified: esp_i_active_nowifi; unclassified: esp_i_wifi_rx; unclassified: esp_i_wifi_tx_peak; unclassified: fit_a_hold_a; unclassified: fit_a_resistance_ohm; unclassified: fit_a_torque_nm_per_a; unclassified: fit_b_hold_a; unclassified: fit_b_resistance_ohm; unclassified: fit_b_stall_a; unclassified: fit_b_torque_nm_per_a; unclassified: ibus_5v_idle; unclassified: mcp_dropout_max; unclassified: mcp_iout_max; unclassified: power_external_3v3_load_a; unclassified: power_five_volt_rail_v; unclassified: power_ldo_dropout_scale_cap; unclassified: servo_vmin; unclassified: tps_ea_gain; unclassified: tps_ea_gm; unclassified: tps_ea_imax; unclassified: tps_ilim_min; unclassified: tps_ilim_typ; unclassified: tps_ps_gm; unclassified: tps_rds_typ; unclassified: tps_vref
- `servo-voltage-max`: 47 uF ceramics — effective capacitance at DC bias; find in manufacturer DC-bias curves; L1 SRP1245A-100M — inductance tolerance and bias derating; find in manufacturer datasheet curves; RS1 WSLP1206R1000FEA — resistance over temperature; find in manufacturer datasheet and calibration step; wrist capacitor — capacitance after bias temperature and ageing; find in manufacturer datasheet; unclassified: ELEC.c_comp_F; unclassified: ELEC.c_pole_F; unclassified: ELEC.cable_len_m; unclassified: ELEC.cable_power_awg; unclassified: ELEC.r_comp_ohm; unclassified: ELEC.r_fb_bot_ohm; unclassified: ELEC.r_fb_top_ohm; unclassified: ELEC.r_rt_ohm; unclassified: ELEC.r_uvlo_bot_ohm; unclassified: ELEC.r_uvlo_top_ohm; unclassified: ELEC.vref_V; unclassified: awg20_ohm_m; unclassified: buck_bulk_esr_max_ohm; unclassified: buck_bulk_esr_min_ohm; unclassified: buck_bulk_scale_max; unclassified: buck_bulk_scale_min; unclassified: buck_ceramic_factor_mid; unclassified: buck_ceramic_factor_min; unclassified: buck_feedback_resistor_tolerance; unclassified: buck_gain_margin_min_db; unclassified: buck_input_max_v; unclassified: buck_input_min_v; unclassified: buck_load_half_a; unclassified: buck_load_light_a; unclassified: buck_load_max_a; unclassified: buck_load_min_a; unclassified: buck_load_resistance_floor_ohm; unclassified: buck_load_two_a; unclassified: buck_nominal_input_v; unclassified: buck_nominal_load_a; unclassified: buck_phase_margin_min_deg; unclassified: buck_servo_lead_resistance_ohm; unclassified: c12_esr; unclassified: c_wrist_esr; unclassified: cable_l_per_m; unclassified: cer_derate_6v6; unclassified: cer_esr; unclassified: mc_ridley; unclassified: servo_vmax; unclassified: tps_ea_gain; unclassified: tps_ea_gm; unclassified: tps_en_i1; unclassified: tps_en_i1_max; unclassified: tps_en_i1_min; unclassified: tps_en_ihys; unclassified: tps_en_ihys_max; unclassified: tps_en_ihys_min; unclassified: tps_en_thresh; unclassified: tps_en_thresh_max; unclassified: tps_en_thresh_min; unclassified: tps_ilim_min; unclassified: tps_ps_gm; unclassified: tps_rt_coeff; unclassified: tps_rt_exp; unclassified: tps_ton_min; unclassified: tps_vref_max; unclassified: tps_vref_min
- `plug-band-low`: missing: J1/J2/J3 harness assembly — finished conductor resistance and contact-resistance range; find in DESIGN-BASIS.md section 10 harness milliohm bench step; FSR sensor — fit exponent confidence interval; find in DESIGN-BASIS.md section 10 force sweep; servo Fit A dyno specimen — stall-current fit confidence interval; find in DESIGN-BASIS.md section 10 force/current sweep; unclassified: ELEC.cable_len_m; unclassified: ELEC.r_fb_bot_ohm; unclassified: ELEC.r_fb_top_ohm; unclassified: ELEC.r_lim_pullup_ohm; unclassified: ELEC.vref_V; unclassified: awg20_ohm_m; unclassified: awg22_ohm_m; unclassified: awg26_ohm_m; unclassified: buck_feedback_resistor_tolerance; unclassified: buck_servo_lead_resistance_ohm; unclassified: esp_adc_resolution_bits; unclassified: fit_a_hold_a; unclassified: fit_a_resistance_ohm; unclassified: fit_a_torque_nm_per_a; unclassified: fit_b_hold_a; unclassified: fit_b_resistance_ohm; unclassified: fit_b_stall_a; unclassified: fit_b_torque_nm_per_a; unclassified: fsr_default_vcc_mv; unclassified: fsr_fit_r1n_ohm; unclassified: harness_adapter_cord_mm; unclassified: harness_awg_pigtail; unclassified: harness_awg_power; unclassified: harness_awg_signal; unclassified: harness_bend_factor; unclassified: harness_bend_factor_abs; unclassified: harness_cap_lead_mm; unclassified: harness_cycle_s; unclassified: harness_design_life_cycles; unclassified: harness_fsr_error_forces_n; unclassified: harness_fsr_force_cap_n; unclassified: harness_fsr_run_mm; unclassified: harness_jaw_max_deg; unclassified: harness_limit_run_mm; unclassified: harness_od_26awg_mm; unclassified: harness_pigtail_mm; unclassified: harness_plug_band_v; unclassified: harness_plug_rating_v; unclassified: harness_pwm_current_a; unclassified: harness_semester_fraction; unclassified: harness_servo_lead_ohm; unclassified: harness_servo_v_min; unclassified: harness_spare_fraction; unclassified: harness_unwired_length_mm; unclassified: harness_usb_cable_mm; unclassified: harness_vil_fraction; unclassified: tps_vref_max; unclassified: tps_vref_min
- `plug-band-high`: missing: J1/J2/J3 harness assembly — finished conductor resistance and contact-resistance range; find in DESIGN-BASIS.md section 10 harness milliohm bench step; FSR sensor — fit exponent confidence interval; find in DESIGN-BASIS.md section 10 force sweep; servo Fit A dyno specimen — stall-current fit confidence interval; find in DESIGN-BASIS.md section 10 force/current sweep; unclassified: ELEC.cable_len_m; unclassified: ELEC.r_fb_bot_ohm; unclassified: ELEC.r_fb_top_ohm; unclassified: ELEC.r_lim_pullup_ohm; unclassified: ELEC.vref_V; unclassified: awg20_ohm_m; unclassified: awg22_ohm_m; unclassified: awg26_ohm_m; unclassified: buck_feedback_resistor_tolerance; unclassified: buck_servo_lead_resistance_ohm; unclassified: esp_adc_resolution_bits; unclassified: fit_a_hold_a; unclassified: fit_a_resistance_ohm; unclassified: fit_a_torque_nm_per_a; unclassified: fit_b_hold_a; unclassified: fit_b_resistance_ohm; unclassified: fit_b_stall_a; unclassified: fit_b_torque_nm_per_a; unclassified: fsr_default_vcc_mv; unclassified: fsr_fit_r1n_ohm; unclassified: harness_adapter_cord_mm; unclassified: harness_awg_pigtail; unclassified: harness_awg_power; unclassified: harness_awg_signal; unclassified: harness_bend_factor; unclassified: harness_bend_factor_abs; unclassified: harness_cap_lead_mm; unclassified: harness_cycle_s; unclassified: harness_design_life_cycles; unclassified: harness_fsr_error_forces_n; unclassified: harness_fsr_force_cap_n; unclassified: harness_fsr_run_mm; unclassified: harness_jaw_max_deg; unclassified: harness_limit_run_mm; unclassified: harness_od_26awg_mm; unclassified: harness_pigtail_mm; unclassified: harness_plug_band_v; unclassified: harness_plug_rating_v; unclassified: harness_pwm_current_a; unclassified: harness_semester_fraction; unclassified: harness_servo_lead_ohm; unclassified: harness_servo_v_min; unclassified: harness_spare_fraction; unclassified: harness_unwired_length_mm; unclassified: harness_usb_cable_mm; unclassified: harness_vil_fraction; unclassified: tps_vref_max; unclassified: tps_vref_min
- `loop-phase`: missing: U1 TPS54560BDDAR compensation network — small-signal plant/model error band; find in DESIGN-BASIS.md section 10 loop-response bench step; 47 uF ceramics — effective capacitance at DC bias; find in manufacturer DC-bias curves; L1 SRP1245A-100M — inductance tolerance and bias derating; find in manufacturer datasheet curves; RS1 WSLP1206R1000FEA — resistance over temperature; find in manufacturer datasheet and calibration step; wrist capacitor — capacitance after bias temperature and ageing; find in manufacturer datasheet; unclassified: ELEC.c_comp_F; unclassified: ELEC.c_pole_F; unclassified: ELEC.cable_len_m; unclassified: ELEC.cable_power_awg; unclassified: ELEC.r_comp_ohm; unclassified: ELEC.r_fb_bot_ohm; unclassified: ELEC.r_fb_top_ohm; unclassified: ELEC.r_rt_ohm; unclassified: ELEC.r_uvlo_bot_ohm; unclassified: ELEC.r_uvlo_top_ohm; unclassified: ELEC.vref_V; unclassified: awg20_ohm_m; unclassified: buck_bulk_esr_max_ohm; unclassified: buck_bulk_esr_min_ohm; unclassified: buck_bulk_scale_max; unclassified: buck_bulk_scale_min; unclassified: buck_ceramic_factor_mid; unclassified: buck_ceramic_factor_min; unclassified: buck_feedback_resistor_tolerance; unclassified: buck_gain_margin_min_db; unclassified: buck_input_max_v; unclassified: buck_input_min_v; unclassified: buck_load_half_a; unclassified: buck_load_light_a; unclassified: buck_load_max_a; unclassified: buck_load_min_a; unclassified: buck_load_resistance_floor_ohm; unclassified: buck_load_two_a; unclassified: buck_nominal_input_v; unclassified: buck_nominal_load_a; unclassified: buck_phase_margin_min_deg; unclassified: buck_servo_lead_resistance_ohm; unclassified: c12_esr; unclassified: c_wrist_esr; unclassified: cable_l_per_m; unclassified: cer_derate_6v6; unclassified: cer_esr; unclassified: mc_ridley; unclassified: tps_ea_gain; unclassified: tps_ea_gm; unclassified: tps_en_i1; unclassified: tps_en_i1_max; unclassified: tps_en_i1_min; unclassified: tps_en_ihys; unclassified: tps_en_ihys_max; unclassified: tps_en_ihys_min; unclassified: tps_en_thresh; unclassified: tps_en_thresh_max; unclassified: tps_en_thresh_min; unclassified: tps_ilim_min; unclassified: tps_ps_gm; unclassified: tps_rt_coeff; unclassified: tps_rt_exp; unclassified: tps_ton_min; unclassified: tps_vref_max; unclassified: tps_vref_min
- `loop-gain`: missing: U1 TPS54560BDDAR compensation network — small-signal plant/model error band; find in DESIGN-BASIS.md section 10 loop-response bench step; 47 uF ceramics — effective capacitance at DC bias; find in manufacturer DC-bias curves; L1 SRP1245A-100M — inductance tolerance and bias derating; find in manufacturer datasheet curves; RS1 WSLP1206R1000FEA — resistance over temperature; find in manufacturer datasheet and calibration step; wrist capacitor — capacitance after bias temperature and ageing; find in manufacturer datasheet; unclassified: ELEC.c_comp_F; unclassified: ELEC.c_pole_F; unclassified: ELEC.cable_len_m; unclassified: ELEC.cable_power_awg; unclassified: ELEC.r_comp_ohm; unclassified: ELEC.r_fb_bot_ohm; unclassified: ELEC.r_fb_top_ohm; unclassified: ELEC.r_rt_ohm; unclassified: ELEC.r_uvlo_bot_ohm; unclassified: ELEC.r_uvlo_top_ohm; unclassified: ELEC.vref_V; unclassified: awg20_ohm_m; unclassified: buck_bulk_esr_max_ohm; unclassified: buck_bulk_esr_min_ohm; unclassified: buck_bulk_scale_max; unclassified: buck_bulk_scale_min; unclassified: buck_ceramic_factor_mid; unclassified: buck_ceramic_factor_min; unclassified: buck_feedback_resistor_tolerance; unclassified: buck_gain_margin_min_db; unclassified: buck_input_max_v; unclassified: buck_input_min_v; unclassified: buck_load_half_a; unclassified: buck_load_light_a; unclassified: buck_load_max_a; unclassified: buck_load_min_a; unclassified: buck_load_resistance_floor_ohm; unclassified: buck_load_two_a; unclassified: buck_nominal_input_v; unclassified: buck_nominal_load_a; unclassified: buck_phase_margin_min_deg; unclassified: buck_servo_lead_resistance_ohm; unclassified: c12_esr; unclassified: c_wrist_esr; unclassified: cable_l_per_m; unclassified: cer_derate_6v6; unclassified: cer_esr; unclassified: mc_ridley; unclassified: tps_ea_gain; unclassified: tps_ea_gm; unclassified: tps_en_i1; unclassified: tps_en_i1_max; unclassified: tps_en_i1_min; unclassified: tps_en_ihys; unclassified: tps_en_ihys_max; unclassified: tps_en_ihys_min; unclassified: tps_en_thresh; unclassified: tps_en_thresh_max; unclassified: tps_en_thresh_min; unclassified: tps_ilim_min; unclassified: tps_ps_gm; unclassified: tps_rt_coeff; unclassified: tps_rt_exp; unclassified: tps_ton_min; unclassified: tps_vref_max; unclassified: tps_vref_min
- `uvlo-range`: missing: U1 TPS54560BDDAR compensation network — small-signal plant/model error band; find in DESIGN-BASIS.md section 10 loop-response bench step; 47 uF ceramics — effective capacitance at DC bias; find in manufacturer DC-bias curves; L1 SRP1245A-100M — inductance tolerance and bias derating; find in manufacturer datasheet curves; RS1 WSLP1206R1000FEA — resistance over temperature; find in manufacturer datasheet and calibration step; wrist capacitor — capacitance after bias temperature and ageing; find in manufacturer datasheet; unclassified: ELEC.c_comp_F; unclassified: ELEC.c_pole_F; unclassified: ELEC.cable_len_m; unclassified: ELEC.cable_power_awg; unclassified: ELEC.r_comp_ohm; unclassified: ELEC.r_fb_bot_ohm; unclassified: ELEC.r_fb_top_ohm; unclassified: ELEC.r_rt_ohm; unclassified: ELEC.r_uvlo_bot_ohm; unclassified: ELEC.r_uvlo_top_ohm; unclassified: ELEC.vref_V; unclassified: adapter_min_v; unclassified: awg20_ohm_m; unclassified: buck_bulk_esr_max_ohm; unclassified: buck_bulk_esr_min_ohm; unclassified: buck_bulk_scale_max; unclassified: buck_bulk_scale_min; unclassified: buck_ceramic_factor_mid; unclassified: buck_ceramic_factor_min; unclassified: buck_feedback_resistor_tolerance; unclassified: buck_gain_margin_min_db; unclassified: buck_input_max_v; unclassified: buck_input_min_v; unclassified: buck_load_half_a; unclassified: buck_load_light_a; unclassified: buck_load_max_a; unclassified: buck_load_min_a; unclassified: buck_load_resistance_floor_ohm; unclassified: buck_load_two_a; unclassified: buck_nominal_input_v; unclassified: buck_nominal_load_a; unclassified: buck_phase_margin_min_deg; unclassified: buck_servo_lead_resistance_ohm; unclassified: c12_esr; unclassified: c_wrist_esr; unclassified: cable_l_per_m; unclassified: cer_derate_6v6; unclassified: cer_esr; unclassified: mc_ridley; unclassified: tps_ea_gain; unclassified: tps_ea_gm; unclassified: tps_en_i1; unclassified: tps_en_i1_max; unclassified: tps_en_i1_min; unclassified: tps_en_ihys; unclassified: tps_en_ihys_max; unclassified: tps_en_ihys_min; unclassified: tps_en_thresh; unclassified: tps_en_thresh_max; unclassified: tps_en_thresh_min; unclassified: tps_ilim_min; unclassified: tps_ps_gm; unclassified: tps_rt_coeff; unclassified: tps_rt_exp; unclassified: tps_ton_min; unclassified: tps_vref_max; unclassified: tps_vref_min
- `regulator-headroom`: missing: PS1 12 V 3 A adapter — rated-current capability over temperature; find in adapter datasheet output-current table; 47 uF ceramics — effective capacitance at DC bias; find in manufacturer DC-bias curves; FSR sensor — fit exponent confidence interval; find in DESIGN-BASIS.md section 10 force sweep; L1 SRP1245A-100M — inductance tolerance and bias derating; find in manufacturer datasheet curves; servo Fit A dyno specimen — stall-current fit confidence interval; find in DESIGN-BASIS.md section 10 force/current sweep; RS1 WSLP1206R1000FEA — resistance over temperature; find in manufacturer datasheet and calibration step; wrist capacitor — capacitance after bias temperature and ageing; find in manufacturer datasheet; unclassified: ELEC.c_comp_F; unclassified: ELEC.c_pole_F; unclassified: ELEC.cable_len_m; unclassified: ELEC.cable_power_awg; unclassified: ELEC.r_comp_ohm; unclassified: ELEC.r_fb_bot_ohm; unclassified: ELEC.r_fb_top_ohm; unclassified: ELEC.r_rt_ohm; unclassified: ELEC.vref_V; unclassified: ams_dropout_max; unclassified: ams_vout_tol; unclassified: awg20_ohm_m; unclassified: awg26_ohm_m; unclassified: buck_feedback_resistor_tolerance; unclassified: buck_input_max_v; unclassified: buck_input_min_v; unclassified: buck_nominal_input_v; unclassified: buck_servo_lead_resistance_ohm; unclassified: c12_esr; unclassified: c_wrist_esr; unclassified: cable_l_per_m; unclassified: cer_derate_6v6; unclassified: d2_vf; unclassified: d7_vf_100ma; unclassified: d7_vf_slope; unclassified: devkit_diode_drop; unclassified: devkit_overhead_a; unclassified: droop_5v_load_a; unclassified: droop_comp_zero_v; unclassified: droop_default_rise_s; unclassified: droop_default_vin_v; unclassified: droop_diode_v; unclassified: droop_end_time_s; unclassified: droop_fast_rise_s; unclassified: droop_fsw_hz; unclassified: droop_low_vin_v; unclassified: droop_no_wrist_cap_f; unclassified: droop_recovery_band_v; unclassified: droop_servo_idle_a; unclassified: droop_step_time_s; unclassified: droop_sweep_cap_1000_f; unclassified: droop_sweep_cap_2200_f; unclassified: droop_sweep_cap_220_f; unclassified: droop_sweep_cap_470_f; unclassified: droop_voltage_floor_v; unclassified: esp_bod_default; unclassified: esp_i_active_nowifi; unclassified: esp_i_wifi_rx; unclassified: esp_i_wifi_tx_peak; unclassified: esp_vdd_min_flash; unclassified: f1_hold; unclassified: f1_r1max; unclassified: fit_a_hold_a; unclassified: fit_a_resistance_ohm; unclassified: fit_a_torque_nm_per_a; unclassified: fit_b_hold_a; unclassified: fit_b_resistance_ohm; unclassified: fit_b_stall_a; unclassified: fit_b_torque_nm_per_a; unclassified: fsr_default_vcc_mv; unclassified: fsr_fit_r1n_ohm; unclassified: harness_plug_band_v; unclassified: ibus_5v_idle; unclassified: l1_dcr; unclassified: mcp_dropout_max; unclassified: mcp_iout_max; unclassified: mcp_rth_sot223; unclassified: mcp_vout_tol; unclassified: power_3v3_minus_1pct_mv; unclassified: power_3v3_minus_3pct_mv; unclassified: power_3v3_plus_1pct_mv; unclassified: power_3v3_rail_v; unclassified: power_board_plane_resistance_ohm; unclassified: power_diode_reference_current_a; unclassified: power_external_3v3_load_a; unclassified: power_fit_a_stall_current_a; unclassified: power_five_volt_rail_v; unclassified: power_fsr_force_high_n; unclassified: power_fsr_force_low_n; unclassified: power_fsr_return_current_a; unclassified: power_ground_wire_length_m; unclassified: power_ldo_dropout_scale_cap; unclassified: power_ldo_full_load_dropout_ratio; unclassified: power_ldo_light_load_a; unclassified: power_ldo_load_span_a; unclassified: power_log_current_floor_a; unclassified: power_rating_margin_factor; unclassified: power_regen_basis_mj; unclassified: power_regen_high_mj; unclassified: power_regen_low_mj; unclassified: power_regen_min_mj; unclassified: power_regen_rotor_mj; unclassified: power_starting_efficiency; unclassified: power_switch_transition_time_s; unclassified: power_usb_max_v; unclassified: power_usb_min_v; unclassified: q1_rds; unclassified: rs1_rating; unclassified: servo_idle_a; unclassified: servo_vmax; unclassified: servo_vmin; unclassified: tps_ea_gain; unclassified: tps_ea_gm; unclassified: tps_ea_imax; unclassified: tps_ilim_min; unclassified: tps_ilim_typ; unclassified: tps_iq; unclassified: tps_ps_gm; unclassified: tps_rds_typ; unclassified: tps_rt_coeff; unclassified: tps_rt_exp; unclassified: tps_rth_ja; unclassified: tps_vref; unclassified: tps_vref_max; unclassified: tps_vref_min; unclassified: wire_gauges_awg
- `limit-switch-low`: missing: J1/J2/J3 harness assembly — finished conductor resistance and contact-resistance range; find in DESIGN-BASIS.md section 10 harness milliohm bench step; FSR sensor — fit exponent confidence interval; find in DESIGN-BASIS.md section 10 force sweep; servo Fit A dyno specimen — stall-current fit confidence interval; find in DESIGN-BASIS.md section 10 force/current sweep; unclassified: ELEC.cable_len_m; unclassified: ELEC.r_fb_bot_ohm; unclassified: ELEC.r_fb_top_ohm; unclassified: ELEC.r_lim_pullup_ohm; unclassified: ELEC.vref_V; unclassified: awg20_ohm_m; unclassified: awg22_ohm_m; unclassified: awg26_ohm_m; unclassified: buck_feedback_resistor_tolerance; unclassified: buck_servo_lead_resistance_ohm; unclassified: esp_adc_resolution_bits; unclassified: fit_a_hold_a; unclassified: fit_a_resistance_ohm; unclassified: fit_a_torque_nm_per_a; unclassified: fit_b_hold_a; unclassified: fit_b_resistance_ohm; unclassified: fit_b_stall_a; unclassified: fit_b_torque_nm_per_a; unclassified: fsr_default_vcc_mv; unclassified: fsr_fit_r1n_ohm; unclassified: harness_adapter_cord_mm; unclassified: harness_awg_pigtail; unclassified: harness_awg_power; unclassified: harness_awg_signal; unclassified: harness_bend_factor; unclassified: harness_bend_factor_abs; unclassified: harness_cap_lead_mm; unclassified: harness_cycle_s; unclassified: harness_design_life_cycles; unclassified: harness_fsr_error_forces_n; unclassified: harness_fsr_force_cap_n; unclassified: harness_fsr_run_mm; unclassified: harness_jaw_max_deg; unclassified: harness_limit_run_mm; unclassified: harness_od_26awg_mm; unclassified: harness_pigtail_mm; unclassified: harness_plug_band_v; unclassified: harness_plug_rating_v; unclassified: harness_pwm_current_a; unclassified: harness_semester_fraction; unclassified: harness_servo_lead_ohm; unclassified: harness_servo_v_min; unclassified: harness_spare_fraction; unclassified: harness_unwired_length_mm; unclassified: harness_usb_cable_mm; unclassified: harness_vil_fraction; unclassified: tps_vref_max; unclassified: tps_vref_min
- `regen-energy-2mJ`: measure returned energy; missing: PS1 12 V 3 A adapter — rated-current capability over temperature; find in adapter datasheet output-current table; 47 uF ceramics — effective capacitance at DC bias; find in manufacturer DC-bias curves; FSR sensor — fit exponent confidence interval; find in DESIGN-BASIS.md section 10 force sweep; L1 SRP1245A-100M — inductance tolerance and bias derating; find in manufacturer datasheet curves; servo Fit A dyno specimen — stall-current fit confidence interval; find in DESIGN-BASIS.md section 10 force/current sweep; RS1 WSLP1206R1000FEA — resistance over temperature; find in manufacturer datasheet and calibration step; wrist capacitor — capacitance after bias temperature and ageing; find in manufacturer datasheet; unclassified: ELEC.c_comp_F; unclassified: ELEC.c_pole_F; unclassified: ELEC.cable_len_m; unclassified: ELEC.cable_power_awg; unclassified: ELEC.r_comp_ohm; unclassified: ELEC.r_fb_bot_ohm; unclassified: ELEC.r_fb_top_ohm; unclassified: ELEC.r_rt_ohm; unclassified: ELEC.vref_V; unclassified: ams_dropout_max; unclassified: ams_vout_tol; unclassified: awg20_ohm_m; unclassified: awg26_ohm_m; unclassified: buck_feedback_resistor_tolerance; unclassified: buck_input_max_v; unclassified: buck_input_min_v; unclassified: buck_nominal_input_v; unclassified: buck_servo_lead_resistance_ohm; unclassified: c12_esr; unclassified: c_wrist_esr; unclassified: cable_l_per_m; unclassified: cer_derate_6v6; unclassified: d2_vf; unclassified: d7_vf_100ma; unclassified: d7_vf_slope; unclassified: devkit_diode_drop; unclassified: devkit_overhead_a; unclassified: droop_5v_load_a; unclassified: droop_comp_zero_v; unclassified: droop_default_rise_s; unclassified: droop_default_vin_v; unclassified: droop_diode_v; unclassified: droop_end_time_s; unclassified: droop_fast_rise_s; unclassified: droop_fsw_hz; unclassified: droop_low_vin_v; unclassified: droop_no_wrist_cap_f; unclassified: droop_recovery_band_v; unclassified: droop_servo_idle_a; unclassified: droop_step_time_s; unclassified: droop_sweep_cap_1000_f; unclassified: droop_sweep_cap_2200_f; unclassified: droop_sweep_cap_220_f; unclassified: droop_sweep_cap_470_f; unclassified: droop_voltage_floor_v; unclassified: esp_bod_default; unclassified: esp_i_active_nowifi; unclassified: esp_i_wifi_rx; unclassified: esp_i_wifi_tx_peak; unclassified: esp_vdd_min_flash; unclassified: f1_hold; unclassified: f1_r1max; unclassified: fit_a_hold_a; unclassified: fit_a_resistance_ohm; unclassified: fit_a_torque_nm_per_a; unclassified: fit_b_hold_a; unclassified: fit_b_resistance_ohm; unclassified: fit_b_stall_a; unclassified: fit_b_torque_nm_per_a; unclassified: fsr_default_vcc_mv; unclassified: fsr_fit_r1n_ohm; unclassified: harness_plug_band_v; unclassified: ibus_5v_idle; unclassified: l1_dcr; unclassified: mcp_dropout_max; unclassified: mcp_iout_max; unclassified: mcp_rth_sot223; unclassified: mcp_vout_tol; unclassified: power_3v3_minus_1pct_mv; unclassified: power_3v3_minus_3pct_mv; unclassified: power_3v3_plus_1pct_mv; unclassified: power_3v3_rail_v; unclassified: power_board_plane_resistance_ohm; unclassified: power_diode_reference_current_a; unclassified: power_external_3v3_load_a; unclassified: power_fit_a_stall_current_a; unclassified: power_five_volt_rail_v; unclassified: power_fsr_force_high_n; unclassified: power_fsr_force_low_n; unclassified: power_fsr_return_current_a; unclassified: power_ground_wire_length_m; unclassified: power_ldo_dropout_scale_cap; unclassified: power_ldo_full_load_dropout_ratio; unclassified: power_ldo_light_load_a; unclassified: power_ldo_load_span_a; unclassified: power_log_current_floor_a; unclassified: power_rating_margin_factor; unclassified: power_regen_basis_mj; unclassified: power_regen_high_mj; unclassified: power_regen_low_mj; unclassified: power_regen_min_mj; unclassified: power_regen_rotor_mj; unclassified: power_starting_efficiency; unclassified: power_switch_transition_time_s; unclassified: power_usb_max_v; unclassified: power_usb_min_v; unclassified: q1_rds; unclassified: rs1_rating; unclassified: servo_idle_a; unclassified: servo_vmax; unclassified: servo_vmin; unclassified: tps_ea_gain; unclassified: tps_ea_gm; unclassified: tps_ea_imax; unclassified: tps_ilim_min; unclassified: tps_ilim_typ; unclassified: tps_iq; unclassified: tps_ps_gm; unclassified: tps_rds_typ; unclassified: tps_rt_coeff; unclassified: tps_rt_exp; unclassified: tps_rth_ja; unclassified: tps_vref; unclassified: tps_vref_max; unclassified: tps_vref_min; unclassified: wire_gauges_awg
- `regen-energy-5mJ`: measure returned energy; missing: PS1 12 V 3 A adapter — rated-current capability over temperature; find in adapter datasheet output-current table; 47 uF ceramics — effective capacitance at DC bias; find in manufacturer DC-bias curves; FSR sensor — fit exponent confidence interval; find in DESIGN-BASIS.md section 10 force sweep; L1 SRP1245A-100M — inductance tolerance and bias derating; find in manufacturer datasheet curves; servo Fit A dyno specimen — stall-current fit confidence interval; find in DESIGN-BASIS.md section 10 force/current sweep; RS1 WSLP1206R1000FEA — resistance over temperature; find in manufacturer datasheet and calibration step; wrist capacitor — capacitance after bias temperature and ageing; find in manufacturer datasheet; unclassified: ELEC.c_comp_F; unclassified: ELEC.c_pole_F; unclassified: ELEC.cable_len_m; unclassified: ELEC.cable_power_awg; unclassified: ELEC.r_comp_ohm; unclassified: ELEC.r_fb_bot_ohm; unclassified: ELEC.r_fb_top_ohm; unclassified: ELEC.r_rt_ohm; unclassified: ELEC.vref_V; unclassified: ams_dropout_max; unclassified: ams_vout_tol; unclassified: awg20_ohm_m; unclassified: awg26_ohm_m; unclassified: buck_feedback_resistor_tolerance; unclassified: buck_input_max_v; unclassified: buck_input_min_v; unclassified: buck_nominal_input_v; unclassified: buck_servo_lead_resistance_ohm; unclassified: c12_esr; unclassified: c_wrist_esr; unclassified: cable_l_per_m; unclassified: cer_derate_6v6; unclassified: d2_vf; unclassified: d7_vf_100ma; unclassified: d7_vf_slope; unclassified: devkit_diode_drop; unclassified: devkit_overhead_a; unclassified: droop_5v_load_a; unclassified: droop_comp_zero_v; unclassified: droop_default_rise_s; unclassified: droop_default_vin_v; unclassified: droop_diode_v; unclassified: droop_end_time_s; unclassified: droop_fast_rise_s; unclassified: droop_fsw_hz; unclassified: droop_low_vin_v; unclassified: droop_no_wrist_cap_f; unclassified: droop_recovery_band_v; unclassified: droop_servo_idle_a; unclassified: droop_step_time_s; unclassified: droop_sweep_cap_1000_f; unclassified: droop_sweep_cap_2200_f; unclassified: droop_sweep_cap_220_f; unclassified: droop_sweep_cap_470_f; unclassified: droop_voltage_floor_v; unclassified: esp_bod_default; unclassified: esp_i_active_nowifi; unclassified: esp_i_wifi_rx; unclassified: esp_i_wifi_tx_peak; unclassified: esp_vdd_min_flash; unclassified: f1_hold; unclassified: f1_r1max; unclassified: fit_a_hold_a; unclassified: fit_a_resistance_ohm; unclassified: fit_a_torque_nm_per_a; unclassified: fit_b_hold_a; unclassified: fit_b_resistance_ohm; unclassified: fit_b_stall_a; unclassified: fit_b_torque_nm_per_a; unclassified: fsr_default_vcc_mv; unclassified: fsr_fit_r1n_ohm; unclassified: harness_plug_band_v; unclassified: ibus_5v_idle; unclassified: l1_dcr; unclassified: mcp_dropout_max; unclassified: mcp_iout_max; unclassified: mcp_rth_sot223; unclassified: mcp_vout_tol; unclassified: power_3v3_minus_1pct_mv; unclassified: power_3v3_minus_3pct_mv; unclassified: power_3v3_plus_1pct_mv; unclassified: power_3v3_rail_v; unclassified: power_board_plane_resistance_ohm; unclassified: power_diode_reference_current_a; unclassified: power_external_3v3_load_a; unclassified: power_fit_a_stall_current_a; unclassified: power_five_volt_rail_v; unclassified: power_fsr_force_high_n; unclassified: power_fsr_force_low_n; unclassified: power_fsr_return_current_a; unclassified: power_ground_wire_length_m; unclassified: power_ldo_dropout_scale_cap; unclassified: power_ldo_full_load_dropout_ratio; unclassified: power_ldo_light_load_a; unclassified: power_ldo_load_span_a; unclassified: power_log_current_floor_a; unclassified: power_rating_margin_factor; unclassified: power_regen_basis_mj; unclassified: power_regen_high_mj; unclassified: power_regen_low_mj; unclassified: power_regen_min_mj; unclassified: power_regen_rotor_mj; unclassified: power_starting_efficiency; unclassified: power_switch_transition_time_s; unclassified: power_usb_max_v; unclassified: power_usb_min_v; unclassified: q1_rds; unclassified: rs1_rating; unclassified: servo_idle_a; unclassified: servo_vmax; unclassified: servo_vmin; unclassified: tps_ea_gain; unclassified: tps_ea_gm; unclassified: tps_ea_imax; unclassified: tps_ilim_min; unclassified: tps_ilim_typ; unclassified: tps_iq; unclassified: tps_ps_gm; unclassified: tps_rds_typ; unclassified: tps_rt_coeff; unclassified: tps_rt_exp; unclassified: tps_rth_ja; unclassified: tps_vref; unclassified: tps_vref_max; unclassified: tps_vref_min; unclassified: wire_gauges_awg
- `regen-energy-20mJ`: measure returned energy; missing: PS1 12 V 3 A adapter — rated-current capability over temperature; find in adapter datasheet output-current table; 47 uF ceramics — effective capacitance at DC bias; find in manufacturer DC-bias curves; FSR sensor — fit exponent confidence interval; find in DESIGN-BASIS.md section 10 force sweep; L1 SRP1245A-100M — inductance tolerance and bias derating; find in manufacturer datasheet curves; servo Fit A dyno specimen — stall-current fit confidence interval; find in DESIGN-BASIS.md section 10 force/current sweep; RS1 WSLP1206R1000FEA — resistance over temperature; find in manufacturer datasheet and calibration step; wrist capacitor — capacitance after bias temperature and ageing; find in manufacturer datasheet; unclassified: ELEC.c_comp_F; unclassified: ELEC.c_pole_F; unclassified: ELEC.cable_len_m; unclassified: ELEC.cable_power_awg; unclassified: ELEC.r_comp_ohm; unclassified: ELEC.r_fb_bot_ohm; unclassified: ELEC.r_fb_top_ohm; unclassified: ELEC.r_rt_ohm; unclassified: ELEC.vref_V; unclassified: ams_dropout_max; unclassified: ams_vout_tol; unclassified: awg20_ohm_m; unclassified: awg26_ohm_m; unclassified: buck_feedback_resistor_tolerance; unclassified: buck_input_max_v; unclassified: buck_input_min_v; unclassified: buck_nominal_input_v; unclassified: buck_servo_lead_resistance_ohm; unclassified: c12_esr; unclassified: c_wrist_esr; unclassified: cable_l_per_m; unclassified: cer_derate_6v6; unclassified: d2_vf; unclassified: d7_vf_100ma; unclassified: d7_vf_slope; unclassified: devkit_diode_drop; unclassified: devkit_overhead_a; unclassified: droop_5v_load_a; unclassified: droop_comp_zero_v; unclassified: droop_default_rise_s; unclassified: droop_default_vin_v; unclassified: droop_diode_v; unclassified: droop_end_time_s; unclassified: droop_fast_rise_s; unclassified: droop_fsw_hz; unclassified: droop_low_vin_v; unclassified: droop_no_wrist_cap_f; unclassified: droop_recovery_band_v; unclassified: droop_servo_idle_a; unclassified: droop_step_time_s; unclassified: droop_sweep_cap_1000_f; unclassified: droop_sweep_cap_2200_f; unclassified: droop_sweep_cap_220_f; unclassified: droop_sweep_cap_470_f; unclassified: droop_voltage_floor_v; unclassified: esp_bod_default; unclassified: esp_i_active_nowifi; unclassified: esp_i_wifi_rx; unclassified: esp_i_wifi_tx_peak; unclassified: esp_vdd_min_flash; unclassified: f1_hold; unclassified: f1_r1max; unclassified: fit_a_hold_a; unclassified: fit_a_resistance_ohm; unclassified: fit_a_torque_nm_per_a; unclassified: fit_b_hold_a; unclassified: fit_b_resistance_ohm; unclassified: fit_b_stall_a; unclassified: fit_b_torque_nm_per_a; unclassified: fsr_default_vcc_mv; unclassified: fsr_fit_r1n_ohm; unclassified: harness_plug_band_v; unclassified: ibus_5v_idle; unclassified: l1_dcr; unclassified: mcp_dropout_max; unclassified: mcp_iout_max; unclassified: mcp_rth_sot223; unclassified: mcp_vout_tol; unclassified: power_3v3_minus_1pct_mv; unclassified: power_3v3_minus_3pct_mv; unclassified: power_3v3_plus_1pct_mv; unclassified: power_3v3_rail_v; unclassified: power_board_plane_resistance_ohm; unclassified: power_diode_reference_current_a; unclassified: power_external_3v3_load_a; unclassified: power_fit_a_stall_current_a; unclassified: power_five_volt_rail_v; unclassified: power_fsr_force_high_n; unclassified: power_fsr_force_low_n; unclassified: power_fsr_return_current_a; unclassified: power_ground_wire_length_m; unclassified: power_ldo_dropout_scale_cap; unclassified: power_ldo_full_load_dropout_ratio; unclassified: power_ldo_light_load_a; unclassified: power_ldo_load_span_a; unclassified: power_log_current_floor_a; unclassified: power_rating_margin_factor; unclassified: power_regen_basis_mj; unclassified: power_regen_high_mj; unclassified: power_regen_low_mj; unclassified: power_regen_min_mj; unclassified: power_regen_rotor_mj; unclassified: power_starting_efficiency; unclassified: power_switch_transition_time_s; unclassified: power_usb_max_v; unclassified: power_usb_min_v; unclassified: q1_rds; unclassified: rs1_rating; unclassified: servo_idle_a; unclassified: servo_vmax; unclassified: servo_vmin; unclassified: tps_ea_gain; unclassified: tps_ea_gm; unclassified: tps_ea_imax; unclassified: tps_ilim_min; unclassified: tps_ilim_typ; unclassified: tps_iq; unclassified: tps_ps_gm; unclassified: tps_rds_typ; unclassified: tps_rt_coeff; unclassified: tps_rt_exp; unclassified: tps_rth_ja; unclassified: tps_vref; unclassified: tps_vref_max; unclassified: tps_vref_min; unclassified: wire_gauges_awg
- `regen-energy-50mJ`: measure returned energy; missing: PS1 12 V 3 A adapter — rated-current capability over temperature; find in adapter datasheet output-current table; 47 uF ceramics — effective capacitance at DC bias; find in manufacturer DC-bias curves; FSR sensor — fit exponent confidence interval; find in DESIGN-BASIS.md section 10 force sweep; L1 SRP1245A-100M — inductance tolerance and bias derating; find in manufacturer datasheet curves; servo Fit A dyno specimen — stall-current fit confidence interval; find in DESIGN-BASIS.md section 10 force/current sweep; RS1 WSLP1206R1000FEA — resistance over temperature; find in manufacturer datasheet and calibration step; wrist capacitor — capacitance after bias temperature and ageing; find in manufacturer datasheet; unclassified: ELEC.c_comp_F; unclassified: ELEC.c_pole_F; unclassified: ELEC.cable_len_m; unclassified: ELEC.cable_power_awg; unclassified: ELEC.r_comp_ohm; unclassified: ELEC.r_fb_bot_ohm; unclassified: ELEC.r_fb_top_ohm; unclassified: ELEC.r_rt_ohm; unclassified: ELEC.vref_V; unclassified: ams_dropout_max; unclassified: ams_vout_tol; unclassified: awg20_ohm_m; unclassified: awg26_ohm_m; unclassified: buck_feedback_resistor_tolerance; unclassified: buck_input_max_v; unclassified: buck_input_min_v; unclassified: buck_nominal_input_v; unclassified: buck_servo_lead_resistance_ohm; unclassified: c12_esr; unclassified: c_wrist_esr; unclassified: cable_l_per_m; unclassified: cer_derate_6v6; unclassified: d2_vf; unclassified: d7_vf_100ma; unclassified: d7_vf_slope; unclassified: devkit_diode_drop; unclassified: devkit_overhead_a; unclassified: droop_5v_load_a; unclassified: droop_comp_zero_v; unclassified: droop_default_rise_s; unclassified: droop_default_vin_v; unclassified: droop_diode_v; unclassified: droop_end_time_s; unclassified: droop_fast_rise_s; unclassified: droop_fsw_hz; unclassified: droop_low_vin_v; unclassified: droop_no_wrist_cap_f; unclassified: droop_recovery_band_v; unclassified: droop_servo_idle_a; unclassified: droop_step_time_s; unclassified: droop_sweep_cap_1000_f; unclassified: droop_sweep_cap_2200_f; unclassified: droop_sweep_cap_220_f; unclassified: droop_sweep_cap_470_f; unclassified: droop_voltage_floor_v; unclassified: esp_bod_default; unclassified: esp_i_active_nowifi; unclassified: esp_i_wifi_rx; unclassified: esp_i_wifi_tx_peak; unclassified: esp_vdd_min_flash; unclassified: f1_hold; unclassified: f1_r1max; unclassified: fit_a_hold_a; unclassified: fit_a_resistance_ohm; unclassified: fit_a_torque_nm_per_a; unclassified: fit_b_hold_a; unclassified: fit_b_resistance_ohm; unclassified: fit_b_stall_a; unclassified: fit_b_torque_nm_per_a; unclassified: fsr_default_vcc_mv; unclassified: fsr_fit_r1n_ohm; unclassified: harness_plug_band_v; unclassified: ibus_5v_idle; unclassified: l1_dcr; unclassified: mcp_dropout_max; unclassified: mcp_iout_max; unclassified: mcp_rth_sot223; unclassified: mcp_vout_tol; unclassified: power_3v3_minus_1pct_mv; unclassified: power_3v3_minus_3pct_mv; unclassified: power_3v3_plus_1pct_mv; unclassified: power_3v3_rail_v; unclassified: power_board_plane_resistance_ohm; unclassified: power_diode_reference_current_a; unclassified: power_external_3v3_load_a; unclassified: power_fit_a_stall_current_a; unclassified: power_five_volt_rail_v; unclassified: power_fsr_force_high_n; unclassified: power_fsr_force_low_n; unclassified: power_fsr_return_current_a; unclassified: power_ground_wire_length_m; unclassified: power_ldo_dropout_scale_cap; unclassified: power_ldo_full_load_dropout_ratio; unclassified: power_ldo_light_load_a; unclassified: power_ldo_load_span_a; unclassified: power_log_current_floor_a; unclassified: power_rating_margin_factor; unclassified: power_regen_basis_mj; unclassified: power_regen_high_mj; unclassified: power_regen_low_mj; unclassified: power_regen_min_mj; unclassified: power_regen_rotor_mj; unclassified: power_starting_efficiency; unclassified: power_switch_transition_time_s; unclassified: power_usb_max_v; unclassified: power_usb_min_v; unclassified: q1_rds; unclassified: rs1_rating; unclassified: servo_idle_a; unclassified: servo_vmax; unclassified: servo_vmin; unclassified: tps_ea_gain; unclassified: tps_ea_gm; unclassified: tps_ea_imax; unclassified: tps_ilim_min; unclassified: tps_ilim_typ; unclassified: tps_iq; unclassified: tps_ps_gm; unclassified: tps_rds_typ; unclassified: tps_rt_coeff; unclassified: tps_rt_exp; unclassified: tps_rth_ja; unclassified: tps_vref; unclassified: tps_vref_max; unclassified: tps_vref_min; unclassified: wire_gauges_awg
- `regen-energy-174mJ`: measure returned energy; missing: PS1 12 V 3 A adapter — rated-current capability over temperature; find in adapter datasheet output-current table; 47 uF ceramics — effective capacitance at DC bias; find in manufacturer DC-bias curves; FSR sensor — fit exponent confidence interval; find in DESIGN-BASIS.md section 10 force sweep; L1 SRP1245A-100M — inductance tolerance and bias derating; find in manufacturer datasheet curves; servo Fit A dyno specimen — stall-current fit confidence interval; find in DESIGN-BASIS.md section 10 force/current sweep; RS1 WSLP1206R1000FEA — resistance over temperature; find in manufacturer datasheet and calibration step; wrist capacitor — capacitance after bias temperature and ageing; find in manufacturer datasheet; unclassified: ELEC.c_comp_F; unclassified: ELEC.c_pole_F; unclassified: ELEC.cable_len_m; unclassified: ELEC.cable_power_awg; unclassified: ELEC.r_comp_ohm; unclassified: ELEC.r_fb_bot_ohm; unclassified: ELEC.r_fb_top_ohm; unclassified: ELEC.r_rt_ohm; unclassified: ELEC.vref_V; unclassified: ams_dropout_max; unclassified: ams_vout_tol; unclassified: awg20_ohm_m; unclassified: awg26_ohm_m; unclassified: buck_feedback_resistor_tolerance; unclassified: buck_input_max_v; unclassified: buck_input_min_v; unclassified: buck_nominal_input_v; unclassified: buck_servo_lead_resistance_ohm; unclassified: c12_esr; unclassified: c_wrist_esr; unclassified: cable_l_per_m; unclassified: cer_derate_6v6; unclassified: d2_vf; unclassified: d7_vf_100ma; unclassified: d7_vf_slope; unclassified: devkit_diode_drop; unclassified: devkit_overhead_a; unclassified: droop_5v_load_a; unclassified: droop_comp_zero_v; unclassified: droop_default_rise_s; unclassified: droop_default_vin_v; unclassified: droop_diode_v; unclassified: droop_end_time_s; unclassified: droop_fast_rise_s; unclassified: droop_fsw_hz; unclassified: droop_low_vin_v; unclassified: droop_no_wrist_cap_f; unclassified: droop_recovery_band_v; unclassified: droop_servo_idle_a; unclassified: droop_step_time_s; unclassified: droop_sweep_cap_1000_f; unclassified: droop_sweep_cap_2200_f; unclassified: droop_sweep_cap_220_f; unclassified: droop_sweep_cap_470_f; unclassified: droop_voltage_floor_v; unclassified: esp_bod_default; unclassified: esp_i_active_nowifi; unclassified: esp_i_wifi_rx; unclassified: esp_i_wifi_tx_peak; unclassified: esp_vdd_min_flash; unclassified: f1_hold; unclassified: f1_r1max; unclassified: fit_a_hold_a; unclassified: fit_a_resistance_ohm; unclassified: fit_a_torque_nm_per_a; unclassified: fit_b_hold_a; unclassified: fit_b_resistance_ohm; unclassified: fit_b_stall_a; unclassified: fit_b_torque_nm_per_a; unclassified: fsr_default_vcc_mv; unclassified: fsr_fit_r1n_ohm; unclassified: harness_plug_band_v; unclassified: ibus_5v_idle; unclassified: l1_dcr; unclassified: mcp_dropout_max; unclassified: mcp_iout_max; unclassified: mcp_rth_sot223; unclassified: mcp_vout_tol; unclassified: power_3v3_minus_1pct_mv; unclassified: power_3v3_minus_3pct_mv; unclassified: power_3v3_plus_1pct_mv; unclassified: power_3v3_rail_v; unclassified: power_board_plane_resistance_ohm; unclassified: power_diode_reference_current_a; unclassified: power_external_3v3_load_a; unclassified: power_fit_a_stall_current_a; unclassified: power_five_volt_rail_v; unclassified: power_fsr_force_high_n; unclassified: power_fsr_force_low_n; unclassified: power_fsr_return_current_a; unclassified: power_ground_wire_length_m; unclassified: power_ldo_dropout_scale_cap; unclassified: power_ldo_full_load_dropout_ratio; unclassified: power_ldo_light_load_a; unclassified: power_ldo_load_span_a; unclassified: power_log_current_floor_a; unclassified: power_rating_margin_factor; unclassified: power_regen_basis_mj; unclassified: power_regen_high_mj; unclassified: power_regen_low_mj; unclassified: power_regen_min_mj; unclassified: power_regen_rotor_mj; unclassified: power_starting_efficiency; unclassified: power_switch_transition_time_s; unclassified: power_usb_max_v; unclassified: power_usb_min_v; unclassified: q1_rds; unclassified: rs1_rating; unclassified: servo_idle_a; unclassified: servo_vmax; unclassified: servo_vmin; unclassified: tps_ea_gain; unclassified: tps_ea_gm; unclassified: tps_ea_imax; unclassified: tps_ilim_min; unclassified: tps_ilim_typ; unclassified: tps_iq; unclassified: tps_ps_gm; unclassified: tps_rds_typ; unclassified: tps_rt_coeff; unclassified: tps_rt_exp; unclassified: tps_rth_ja; unclassified: tps_vref; unclassified: tps_vref_max; unclassified: tps_vref_min; unclassified: wire_gauges_awg
- `fault-limit-servo`: protect J4 pin 3; resolve: D5, R17, R18, controller pin, +3V3 rail; missing: repository has no continuous-current or clamp-power quote; repository has no continuous-power quote; repository has no continuous-power quote; repository has no controller injection-current quote; repository has no 3.3 V rail sink-current quote

### Missing figures by part

- **47 uF ceramics:** effective capacitance at DC bias — manufacturer DC-bias curves; datasheet lookup; blocks adapter-current, buck-current-limit, buck-thermal, droop-servo-min, input-fuse-hold, input-fuse-trip, loop-gain, loop-phase, regen-energy-174mJ, regen-energy-20mJ, regen-energy-2mJ, regen-energy-50mJ, regen-energy-5mJ, regulator-headroom, servo-voltage-max, shunt-power, uvlo-range
- **C12 1000 uF:** capacitance and ESR after bias, temperature, and ageing — DESIGN-BASIS.md section 10 load-step bench step; datasheet lookup; blocks droop-servo-min
- **C17 100 nF:** capacitance tolerance — C17 manufacturer datasheet capacitance-tolerance table; datasheet lookup; blocks adc-charge, filter-delay
- **F1 MF-MSMF260/16X:** hold-current tolerance at 25 C — datasheet electrical characteristics table; datasheet lookup; blocks input-fuse-hold
- **F1 MF-MSMF260/16X:** trip-current tolerance at 25 C — datasheet electrical characteristics table; datasheet lookup; blocks input-fuse-trip
- **FSR sensor:** fit exponent confidence interval — DESIGN-BASIS.md section 10 force sweep; bench measurement; blocks adapter-current, adc-charge, buck-thermal, filter-delay, force-reading-error, fsr-node-high, input-fuse-hold, input-fuse-trip, limit-switch-low, plug-band-high, plug-band-low, regen-energy-174mJ, regen-energy-20mJ, regen-energy-2mJ, regen-energy-50mJ, regen-energy-5mJ, regulator-headroom, shunt-power
- **J1/J2/J3 harness assembly:** finished conductor resistance and contact-resistance range — DESIGN-BASIS.md section 10 harness milliohm bench step; datasheet lookup; blocks force-reading-error, limit-switch-low, plug-band-high, plug-band-low
- **L1 SRP1245A-100M:** inductance tolerance and bias derating — manufacturer datasheet curves; datasheet lookup; blocks adapter-current, buck-current-limit, buck-thermal, droop-servo-min, input-fuse-hold, input-fuse-trip, loop-gain, loop-phase, regen-energy-174mJ, regen-energy-20mJ, regen-energy-2mJ, regen-energy-50mJ, regen-energy-5mJ, regulator-headroom, servo-voltage-max, shunt-power, uvlo-range
- **PCB copper:** finished copper thickness tolerance — PCB fabricator stack-up certificate; datasheet lookup; blocks trace-current, trace-drop, trace-neck-current, trace-temperature
- **PS1 12 V 3 A adapter:** rated-current capability over temperature — adapter datasheet output-current table; datasheet lookup; blocks adapter-current, regen-energy-174mJ, regen-energy-20mJ, regen-energy-2mJ, regen-energy-50mJ, regen-energy-5mJ, regulator-headroom
- **RS1 WSLP1206R1000FEA:** resistance over temperature — manufacturer datasheet and calibration step; datasheet lookup; blocks adapter-current, buck-current-limit, buck-thermal, current-error, detection-time, droop-servo-min, firmware-trip-10N, firmware-trip-8N, input-fuse-hold, input-fuse-trip, loop-gain, loop-phase, regen-energy-174mJ, regen-energy-20mJ, regen-energy-2mJ, regen-energy-50mJ, regen-energy-5mJ, regulator-headroom, sense-range, servo-voltage-max, shunt-power, uvlo-range
- **U1 TPS54560BDDAR:** current-limit test-condition variation — datasheet electrical characteristics table; datasheet lookup; blocks buck-current-limit
- **U1 TPS54560BDDAR:** junction-to-ambient thermal resistance for the assembled PCB — DESIGN-BASIS.md section 10 thermal-rise bench step; datasheet lookup; blocks buck-thermal
- **U1 TPS54560BDDAR compensation network:** small-signal plant/model error band — DESIGN-BASIS.md section 10 loop-response bench step; datasheet lookup; blocks loop-gain, loop-phase, uvlo-range
- **U2 INA219AIDR:** input-filter source-impedance mismatch — DESIGN-BASIS.md section 10 current-calibration bench step; datasheet lookup; blocks current-error, detection-time, sense-range
- **U3 ESP32-WROOM-32E:** ADC linear-range endpoint variation — DESIGN-BASIS.md section 10 ADC sweep bench step; datasheet lookup; blocks fsr-node-high
- **servo Fit A dyno specimen:** stall-current fit confidence interval — DESIGN-BASIS.md section 10 force/current sweep; bench measurement; blocks adapter-current, buck-current-limit, buck-thermal, current-error, detection-time, droop-servo-min, firmware-trip-10N, firmware-trip-8N, force-reading-error, input-fuse-hold, input-fuse-trip, limit-switch-low, plug-band-high, plug-band-low, regen-energy-174mJ, regen-energy-20mJ, regen-energy-2mJ, regen-energy-50mJ, regen-energy-5mJ, regulator-headroom, sense-range, shunt-power, trace-current, trace-drop, trace-neck-current, trace-temperature
- **servo Fit A dyno specimen:** torque-constant and hold-current fit confidence interval — DESIGN-BASIS.md section 10 force/current sweep; datasheet lookup; blocks firmware-trip-10N, firmware-trip-8N
- **wrist capacitor:** capacitance after bias temperature and ageing — manufacturer datasheet; datasheet lookup; blocks adapter-current, buck-current-limit, buck-thermal, droop-servo-min, input-fuse-hold, input-fuse-trip, loop-gain, loop-phase, regen-energy-174mJ, regen-energy-20mJ, regen-energy-2mJ, regen-energy-50mJ, regen-energy-5mJ, regulator-headroom, servo-voltage-max, shunt-power, uvlo-range

### Unclassified inputs

- **ELEC.c_aa_F:** blocks adc-charge, filter-delay, fsr-node-high
- **ELEC.c_comp_F:** blocks adapter-current, buck-current-limit, buck-thermal, droop-servo-min, input-fuse-hold, input-fuse-trip, loop-gain, loop-phase, regen-energy-174mJ, regen-energy-20mJ, regen-energy-2mJ, regen-energy-50mJ, regen-energy-5mJ, regulator-headroom, servo-voltage-max, shunt-power, uvlo-range
- **ELEC.c_pole_F:** blocks adapter-current, buck-current-limit, buck-thermal, droop-servo-min, input-fuse-hold, input-fuse-trip, loop-gain, loop-phase, regen-energy-174mJ, regen-energy-20mJ, regen-energy-2mJ, regen-energy-50mJ, regen-energy-5mJ, regulator-headroom, servo-voltage-max, shunt-power, uvlo-range
- **ELEC.cable_len_m:** blocks adapter-current, buck-current-limit, buck-thermal, droop-servo-min, force-reading-error, input-fuse-hold, input-fuse-trip, limit-switch-low, loop-gain, loop-phase, plug-band-high, plug-band-low, regen-energy-174mJ, regen-energy-20mJ, regen-energy-2mJ, regen-energy-50mJ, regen-energy-5mJ, regulator-headroom, servo-voltage-max, shunt-power, uvlo-range
- **ELEC.cable_power_awg:** blocks adapter-current, buck-current-limit, buck-thermal, droop-servo-min, input-fuse-hold, input-fuse-trip, loop-gain, loop-phase, regen-energy-174mJ, regen-energy-20mJ, regen-energy-2mJ, regen-energy-50mJ, regen-energy-5mJ, regulator-headroom, servo-voltage-max, shunt-power, uvlo-range
- **ELEC.r_aa_ohm:** blocks adc-charge, filter-delay, fsr-node-high
- **ELEC.r_comp_ohm:** blocks adapter-current, buck-current-limit, buck-thermal, droop-servo-min, input-fuse-hold, input-fuse-trip, loop-gain, loop-phase, regen-energy-174mJ, regen-energy-20mJ, regen-energy-2mJ, regen-energy-50mJ, regen-energy-5mJ, regulator-headroom, servo-voltage-max, shunt-power, uvlo-range
- **ELEC.r_fb_bot_ohm:** blocks adapter-current, buck-current-limit, buck-thermal, droop-servo-min, force-reading-error, input-fuse-hold, input-fuse-trip, limit-switch-low, loop-gain, loop-phase, plug-band-high, plug-band-low, regen-energy-174mJ, regen-energy-20mJ, regen-energy-2mJ, regen-energy-50mJ, regen-energy-5mJ, regulator-headroom, servo-voltage-max, shunt-power, uvlo-range
- **ELEC.r_fb_top_ohm:** blocks adapter-current, buck-current-limit, buck-thermal, droop-servo-min, force-reading-error, input-fuse-hold, input-fuse-trip, limit-switch-low, loop-gain, loop-phase, plug-band-high, plug-band-low, regen-energy-174mJ, regen-energy-20mJ, regen-energy-2mJ, regen-energy-50mJ, regen-energy-5mJ, regulator-headroom, servo-voltage-max, shunt-power, uvlo-range
- **ELEC.r_ina_filter_ohm:** blocks current-error, detection-time, firmware-trip-10N, firmware-trip-8N, sense-range
- **ELEC.r_lim_pullup_ohm:** blocks force-reading-error, limit-switch-low, plug-band-high, plug-band-low
- **ELEC.r_rt_ohm:** blocks adapter-current, buck-thermal, input-fuse-hold, input-fuse-trip, loop-gain, loop-phase, regen-energy-174mJ, regen-energy-20mJ, regen-energy-2mJ, regen-energy-50mJ, regen-energy-5mJ, regulator-headroom, servo-voltage-max, shunt-power, uvlo-range
- **ELEC.r_uvlo_bot_ohm:** blocks loop-gain, loop-phase, servo-voltage-max, uvlo-range
- **ELEC.r_uvlo_top_ohm:** blocks loop-gain, loop-phase, servo-voltage-max, uvlo-range
- **ELEC.vref_V:** blocks adapter-current, buck-thermal, force-reading-error, input-fuse-hold, input-fuse-trip, limit-switch-low, loop-gain, loop-phase, plug-band-high, plug-band-low, regen-energy-174mJ, regen-energy-20mJ, regen-energy-2mJ, regen-energy-50mJ, regen-energy-5mJ, regulator-headroom, servo-voltage-max, shunt-power, uvlo-range
- **adapter_current_a:** blocks adapter-current
- **adapter_min_v:** blocks uvlo-range
- **ams_dropout_max:** blocks adapter-current, buck-thermal, input-fuse-hold, input-fuse-trip, regen-energy-174mJ, regen-energy-20mJ, regen-energy-2mJ, regen-energy-50mJ, regen-energy-5mJ, regulator-headroom, shunt-power
- **ams_vout_tol:** blocks adapter-current, buck-thermal, input-fuse-hold, input-fuse-trip, regen-energy-174mJ, regen-energy-20mJ, regen-energy-2mJ, regen-energy-50mJ, regen-energy-5mJ, regulator-headroom, shunt-power
- **awg20_ohm_m:** blocks adapter-current, buck-current-limit, buck-thermal, droop-servo-min, force-reading-error, input-fuse-hold, input-fuse-trip, limit-switch-low, loop-gain, loop-phase, plug-band-high, plug-band-low, regen-energy-174mJ, regen-energy-20mJ, regen-energy-2mJ, regen-energy-50mJ, regen-energy-5mJ, regulator-headroom, servo-voltage-max, shunt-power, uvlo-range
- **awg22_ohm_m:** blocks force-reading-error, limit-switch-low, plug-band-high, plug-band-low
- **awg26_ohm_m:** blocks adapter-current, buck-thermal, force-reading-error, input-fuse-hold, input-fuse-trip, limit-switch-low, plug-band-high, plug-band-low, regen-energy-174mJ, regen-energy-20mJ, regen-energy-2mJ, regen-energy-50mJ, regen-energy-5mJ, regulator-headroom, shunt-power
- **buck_bulk_esr_max_ohm:** blocks loop-gain, loop-phase, servo-voltage-max, uvlo-range
- **buck_bulk_esr_min_ohm:** blocks loop-gain, loop-phase, servo-voltage-max, uvlo-range
- **buck_bulk_scale_max:** blocks loop-gain, loop-phase, servo-voltage-max, uvlo-range
- **buck_bulk_scale_min:** blocks loop-gain, loop-phase, servo-voltage-max, uvlo-range
- **buck_ceramic_factor_mid:** blocks loop-gain, loop-phase, servo-voltage-max, uvlo-range
- **buck_ceramic_factor_min:** blocks loop-gain, loop-phase, servo-voltage-max, uvlo-range
- **buck_feedback_resistor_tolerance:** blocks adapter-current, buck-thermal, force-reading-error, input-fuse-hold, input-fuse-trip, limit-switch-low, loop-gain, loop-phase, plug-band-high, plug-band-low, regen-energy-174mJ, regen-energy-20mJ, regen-energy-2mJ, regen-energy-50mJ, regen-energy-5mJ, regulator-headroom, servo-voltage-max, shunt-power, uvlo-range
- **buck_gain_margin_min_db:** blocks loop-gain, loop-phase, servo-voltage-max, uvlo-range
- **buck_input_max_v:** blocks adapter-current, buck-thermal, input-fuse-hold, input-fuse-trip, loop-gain, loop-phase, regen-energy-174mJ, regen-energy-20mJ, regen-energy-2mJ, regen-energy-50mJ, regen-energy-5mJ, regulator-headroom, servo-voltage-max, shunt-power, uvlo-range
- **buck_input_min_v:** blocks adapter-current, buck-thermal, input-fuse-hold, input-fuse-trip, loop-gain, loop-phase, regen-energy-174mJ, regen-energy-20mJ, regen-energy-2mJ, regen-energy-50mJ, regen-energy-5mJ, regulator-headroom, servo-voltage-max, shunt-power, uvlo-range
- **buck_junction_rise_limit_c:** blocks buck-thermal
- **buck_load_half_a:** blocks loop-gain, loop-phase, servo-voltage-max, uvlo-range
- **buck_load_light_a:** blocks loop-gain, loop-phase, servo-voltage-max, uvlo-range
- **buck_load_max_a:** blocks loop-gain, loop-phase, servo-voltage-max, uvlo-range
- **buck_load_min_a:** blocks loop-gain, loop-phase, servo-voltage-max, uvlo-range
- **buck_load_resistance_floor_ohm:** blocks loop-gain, loop-phase, servo-voltage-max, uvlo-range
- **buck_load_two_a:** blocks loop-gain, loop-phase, servo-voltage-max, uvlo-range
- **buck_nominal_input_v:** blocks adapter-current, buck-thermal, input-fuse-hold, input-fuse-trip, loop-gain, loop-phase, regen-energy-174mJ, regen-energy-20mJ, regen-energy-2mJ, regen-energy-50mJ, regen-energy-5mJ, regulator-headroom, servo-voltage-max, shunt-power, uvlo-range
- **buck_nominal_load_a:** blocks loop-gain, loop-phase, servo-voltage-max, uvlo-range
- **buck_phase_margin_min_deg:** blocks loop-gain, loop-phase, servo-voltage-max, uvlo-range
- **buck_servo_lead_resistance_ohm:** blocks adapter-current, buck-thermal, force-reading-error, input-fuse-hold, input-fuse-trip, limit-switch-low, loop-gain, loop-phase, plug-band-high, plug-band-low, regen-energy-174mJ, regen-energy-20mJ, regen-energy-2mJ, regen-energy-50mJ, regen-energy-5mJ, regulator-headroom, servo-voltage-max, shunt-power, uvlo-range
- **c12_esr:** blocks adapter-current, buck-current-limit, buck-thermal, droop-servo-min, input-fuse-hold, input-fuse-trip, loop-gain, loop-phase, regen-energy-174mJ, regen-energy-20mJ, regen-energy-2mJ, regen-energy-50mJ, regen-energy-5mJ, regulator-headroom, servo-voltage-max, shunt-power, uvlo-range
- **c_wrist_esr:** blocks adapter-current, buck-current-limit, buck-thermal, droop-servo-min, input-fuse-hold, input-fuse-trip, loop-gain, loop-phase, regen-energy-174mJ, regen-energy-20mJ, regen-energy-2mJ, regen-energy-50mJ, regen-energy-5mJ, regulator-headroom, servo-voltage-max, shunt-power, uvlo-range
- **cable_l_per_m:** blocks adapter-current, buck-current-limit, buck-thermal, droop-servo-min, input-fuse-hold, input-fuse-trip, loop-gain, loop-phase, regen-energy-174mJ, regen-energy-20mJ, regen-energy-2mJ, regen-energy-50mJ, regen-energy-5mJ, regulator-headroom, servo-voltage-max, shunt-power, uvlo-range
- **cer_derate_6v6:** blocks adapter-current, buck-current-limit, buck-thermal, droop-servo-min, input-fuse-hold, input-fuse-trip, loop-gain, loop-phase, regen-energy-174mJ, regen-energy-20mJ, regen-energy-2mJ, regen-energy-50mJ, regen-energy-5mJ, regulator-headroom, servo-voltage-max, shunt-power, uvlo-range
- **cer_esr:** blocks loop-gain, loop-phase, servo-voltage-max, uvlo-range
- **ctrl_lag_budget_s:** blocks adc-charge, filter-delay, fsr-node-high
- **cu_rho:** blocks trace-current, trace-drop, trace-neck-current, trace-temperature
- **cu_tc:** blocks trace-current, trace-drop, trace-neck-current, trace-temperature
- **d2_vf:** blocks adapter-current, buck-thermal, input-fuse-hold, input-fuse-trip, regen-energy-174mJ, regen-energy-20mJ, regen-energy-2mJ, regen-energy-50mJ, regen-energy-5mJ, regulator-headroom, shunt-power
- **d7_vf_100ma:** blocks adapter-current, buck-thermal, input-fuse-hold, input-fuse-trip, regen-energy-174mJ, regen-energy-20mJ, regen-energy-2mJ, regen-energy-50mJ, regen-energy-5mJ, regulator-headroom, shunt-power
- **d7_vf_slope:** blocks adapter-current, buck-thermal, input-fuse-hold, input-fuse-trip, regen-energy-174mJ, regen-energy-20mJ, regen-energy-2mJ, regen-energy-50mJ, regen-energy-5mJ, regulator-headroom, shunt-power
- **devkit_diode_drop:** blocks adapter-current, buck-thermal, input-fuse-hold, input-fuse-trip, regen-energy-174mJ, regen-energy-20mJ, regen-energy-2mJ, regen-energy-50mJ, regen-energy-5mJ, regulator-headroom, shunt-power
- **devkit_overhead_a:** blocks adapter-current, buck-current-limit, buck-thermal, droop-servo-min, input-fuse-hold, input-fuse-trip, regen-energy-174mJ, regen-energy-20mJ, regen-energy-2mJ, regen-energy-50mJ, regen-energy-5mJ, regulator-headroom, shunt-power
- **droop_5v_load_a:** blocks adapter-current, buck-current-limit, buck-thermal, droop-servo-min, input-fuse-hold, input-fuse-trip, regen-energy-174mJ, regen-energy-20mJ, regen-energy-2mJ, regen-energy-50mJ, regen-energy-5mJ, regulator-headroom, shunt-power
- **droop_comp_zero_v:** blocks adapter-current, buck-current-limit, buck-thermal, droop-servo-min, input-fuse-hold, input-fuse-trip, regen-energy-174mJ, regen-energy-20mJ, regen-energy-2mJ, regen-energy-50mJ, regen-energy-5mJ, regulator-headroom, shunt-power
- **droop_default_rise_s:** blocks adapter-current, buck-current-limit, buck-thermal, droop-servo-min, input-fuse-hold, input-fuse-trip, regen-energy-174mJ, regen-energy-20mJ, regen-energy-2mJ, regen-energy-50mJ, regen-energy-5mJ, regulator-headroom, shunt-power
- **droop_default_vin_v:** blocks adapter-current, buck-current-limit, buck-thermal, droop-servo-min, input-fuse-hold, input-fuse-trip, regen-energy-174mJ, regen-energy-20mJ, regen-energy-2mJ, regen-energy-50mJ, regen-energy-5mJ, regulator-headroom, shunt-power
- **droop_diode_v:** blocks adapter-current, buck-current-limit, buck-thermal, droop-servo-min, input-fuse-hold, input-fuse-trip, regen-energy-174mJ, regen-energy-20mJ, regen-energy-2mJ, regen-energy-50mJ, regen-energy-5mJ, regulator-headroom, shunt-power
- **droop_end_time_s:** blocks adapter-current, buck-current-limit, buck-thermal, droop-servo-min, input-fuse-hold, input-fuse-trip, regen-energy-174mJ, regen-energy-20mJ, regen-energy-2mJ, regen-energy-50mJ, regen-energy-5mJ, regulator-headroom, shunt-power
- **droop_fast_rise_s:** blocks adapter-current, buck-current-limit, buck-thermal, droop-servo-min, input-fuse-hold, input-fuse-trip, regen-energy-174mJ, regen-energy-20mJ, regen-energy-2mJ, regen-energy-50mJ, regen-energy-5mJ, regulator-headroom, shunt-power
- **droop_fsw_hz:** blocks adapter-current, buck-current-limit, buck-thermal, droop-servo-min, input-fuse-hold, input-fuse-trip, regen-energy-174mJ, regen-energy-20mJ, regen-energy-2mJ, regen-energy-50mJ, regen-energy-5mJ, regulator-headroom, shunt-power
- **droop_low_vin_v:** blocks adapter-current, buck-current-limit, buck-thermal, droop-servo-min, input-fuse-hold, input-fuse-trip, regen-energy-174mJ, regen-energy-20mJ, regen-energy-2mJ, regen-energy-50mJ, regen-energy-5mJ, regulator-headroom, shunt-power
- **droop_no_wrist_cap_f:** blocks adapter-current, buck-current-limit, buck-thermal, droop-servo-min, input-fuse-hold, input-fuse-trip, regen-energy-174mJ, regen-energy-20mJ, regen-energy-2mJ, regen-energy-50mJ, regen-energy-5mJ, regulator-headroom, shunt-power
- **droop_recovery_band_v:** blocks adapter-current, buck-current-limit, buck-thermal, droop-servo-min, input-fuse-hold, input-fuse-trip, regen-energy-174mJ, regen-energy-20mJ, regen-energy-2mJ, regen-energy-50mJ, regen-energy-5mJ, regulator-headroom, shunt-power
- **droop_servo_idle_a:** blocks adapter-current, buck-current-limit, buck-thermal, droop-servo-min, input-fuse-hold, input-fuse-trip, regen-energy-174mJ, regen-energy-20mJ, regen-energy-2mJ, regen-energy-50mJ, regen-energy-5mJ, regulator-headroom, shunt-power
- **droop_step_time_s:** blocks adapter-current, buck-current-limit, buck-thermal, droop-servo-min, input-fuse-hold, input-fuse-trip, regen-energy-174mJ, regen-energy-20mJ, regen-energy-2mJ, regen-energy-50mJ, regen-energy-5mJ, regulator-headroom, shunt-power
- **droop_sweep_cap_1000_f:** blocks adapter-current, buck-current-limit, buck-thermal, droop-servo-min, input-fuse-hold, input-fuse-trip, regen-energy-174mJ, regen-energy-20mJ, regen-energy-2mJ, regen-energy-50mJ, regen-energy-5mJ, regulator-headroom, shunt-power
- **droop_sweep_cap_2200_f:** blocks adapter-current, buck-current-limit, buck-thermal, droop-servo-min, input-fuse-hold, input-fuse-trip, regen-energy-174mJ, regen-energy-20mJ, regen-energy-2mJ, regen-energy-50mJ, regen-energy-5mJ, regulator-headroom, shunt-power
- **droop_sweep_cap_220_f:** blocks adapter-current, buck-current-limit, buck-thermal, droop-servo-min, input-fuse-hold, input-fuse-trip, regen-energy-174mJ, regen-energy-20mJ, regen-energy-2mJ, regen-energy-50mJ, regen-energy-5mJ, regulator-headroom, shunt-power
- **droop_sweep_cap_470_f:** blocks adapter-current, buck-current-limit, buck-thermal, droop-servo-min, input-fuse-hold, input-fuse-trip, regen-energy-174mJ, regen-energy-20mJ, regen-energy-2mJ, regen-energy-50mJ, regen-energy-5mJ, regulator-headroom, shunt-power
- **droop_voltage_floor_v:** blocks adapter-current, buck-current-limit, buck-thermal, droop-servo-min, input-fuse-hold, input-fuse-trip, regen-energy-174mJ, regen-energy-20mJ, regen-energy-2mJ, regen-energy-50mJ, regen-energy-5mJ, regulator-headroom, shunt-power
- **ema_alpha:** blocks adc-charge, filter-delay, fsr-node-high
- **esp_adc_cs_pf:** blocks adc-charge, filter-delay, fsr-node-high
- **esp_adc_err_mv:** blocks adc-charge, filter-delay, fsr-node-high
- **esp_adc_max_mv:** blocks adc-charge, filter-delay, fsr-node-high
- **esp_adc_min_mv:** blocks adc-charge, filter-delay, fsr-node-high
- **esp_adc_resolution_bits:** blocks adc-charge, filter-delay, force-reading-error, fsr-node-high, limit-switch-low, plug-band-high, plug-band-low
- **esp_adc_rsw_ohm:** blocks adc-charge, filter-delay, fsr-node-high
- **esp_bod_default:** blocks adapter-current, buck-thermal, input-fuse-hold, input-fuse-trip, regen-energy-174mJ, regen-energy-20mJ, regen-energy-2mJ, regen-energy-50mJ, regen-energy-5mJ, regulator-headroom, shunt-power
- **esp_i_active_nowifi:** blocks adapter-current, buck-current-limit, buck-thermal, droop-servo-min, input-fuse-hold, input-fuse-trip, regen-energy-174mJ, regen-energy-20mJ, regen-energy-2mJ, regen-energy-50mJ, regen-energy-5mJ, regulator-headroom, shunt-power
- **esp_i_wifi_rx:** blocks adapter-current, buck-current-limit, buck-thermal, droop-servo-min, input-fuse-hold, input-fuse-trip, regen-energy-174mJ, regen-energy-20mJ, regen-energy-2mJ, regen-energy-50mJ, regen-energy-5mJ, regulator-headroom, shunt-power
- **esp_i_wifi_tx_peak:** blocks adapter-current, buck-current-limit, buck-thermal, droop-servo-min, input-fuse-hold, input-fuse-trip, regen-energy-174mJ, regen-energy-20mJ, regen-energy-2mJ, regen-energy-50mJ, regen-energy-5mJ, regulator-headroom, shunt-power
- **esp_vdd_min_flash:** blocks adapter-current, buck-thermal, input-fuse-hold, input-fuse-trip, regen-energy-174mJ, regen-energy-20mJ, regen-energy-2mJ, regen-energy-50mJ, regen-energy-5mJ, regulator-headroom, shunt-power
- **f1_hold:** blocks adapter-current, buck-thermal, input-fuse-hold, input-fuse-trip, regen-energy-174mJ, regen-energy-20mJ, regen-energy-2mJ, regen-energy-50mJ, regen-energy-5mJ, regulator-headroom, shunt-power
- **f1_r1max:** blocks adapter-current, buck-thermal, input-fuse-hold, input-fuse-trip, regen-energy-174mJ, regen-energy-20mJ, regen-energy-2mJ, regen-energy-50mJ, regen-energy-5mJ, regulator-headroom, shunt-power
- **f1_trip:** blocks input-fuse-trip
- **fit_a_hold_a:** blocks adapter-current, buck-current-limit, buck-thermal, current-error, detection-time, droop-servo-min, firmware-trip-10N, firmware-trip-8N, force-reading-error, input-fuse-hold, input-fuse-trip, limit-switch-low, plug-band-high, plug-band-low, regen-energy-174mJ, regen-energy-20mJ, regen-energy-2mJ, regen-energy-50mJ, regen-energy-5mJ, regulator-headroom, sense-range, shunt-power
- **fit_a_resistance_ohm:** blocks adapter-current, buck-current-limit, buck-thermal, current-error, detection-time, droop-servo-min, firmware-trip-10N, firmware-trip-8N, force-reading-error, input-fuse-hold, input-fuse-trip, limit-switch-low, plug-band-high, plug-band-low, regen-energy-174mJ, regen-energy-20mJ, regen-energy-2mJ, regen-energy-50mJ, regen-energy-5mJ, regulator-headroom, sense-range, shunt-power
- **fit_a_torque_nm_per_a:** blocks adapter-current, buck-current-limit, buck-thermal, current-error, detection-time, droop-servo-min, firmware-trip-10N, firmware-trip-8N, force-reading-error, input-fuse-hold, input-fuse-trip, limit-switch-low, plug-band-high, plug-band-low, regen-energy-174mJ, regen-energy-20mJ, regen-energy-2mJ, regen-energy-50mJ, regen-energy-5mJ, regulator-headroom, sense-range, shunt-power
- **fit_b_hold_a:** blocks adapter-current, buck-current-limit, buck-thermal, current-error, detection-time, droop-servo-min, firmware-trip-10N, firmware-trip-8N, force-reading-error, input-fuse-hold, input-fuse-trip, limit-switch-low, plug-band-high, plug-band-low, regen-energy-174mJ, regen-energy-20mJ, regen-energy-2mJ, regen-energy-50mJ, regen-energy-5mJ, regulator-headroom, sense-range, shunt-power
- **fit_b_resistance_ohm:** blocks adapter-current, buck-current-limit, buck-thermal, current-error, detection-time, droop-servo-min, firmware-trip-10N, firmware-trip-8N, force-reading-error, input-fuse-hold, input-fuse-trip, limit-switch-low, plug-band-high, plug-band-low, regen-energy-174mJ, regen-energy-20mJ, regen-energy-2mJ, regen-energy-50mJ, regen-energy-5mJ, regulator-headroom, sense-range, shunt-power
- **fit_b_stall_a:** blocks adapter-current, buck-current-limit, buck-thermal, current-error, detection-time, droop-servo-min, firmware-trip-10N, firmware-trip-8N, force-reading-error, input-fuse-hold, input-fuse-trip, limit-switch-low, plug-band-high, plug-band-low, regen-energy-174mJ, regen-energy-20mJ, regen-energy-2mJ, regen-energy-50mJ, regen-energy-5mJ, regulator-headroom, sense-range, shunt-power
- **fit_b_torque_nm_per_a:** blocks adapter-current, buck-current-limit, buck-thermal, current-error, detection-time, droop-servo-min, firmware-trip-10N, firmware-trip-8N, force-reading-error, input-fuse-hold, input-fuse-trip, limit-switch-low, plug-band-high, plug-band-low, regen-energy-174mJ, regen-energy-20mJ, regen-energy-2mJ, regen-energy-50mJ, regen-energy-5mJ, regulator-headroom, sense-range, shunt-power
- **fsr_adc_droop_limit_mv:** blocks adc-charge
- **fsr_default_vcc_mv:** blocks adapter-current, adc-charge, buck-thermal, filter-delay, force-reading-error, fsr-node-high, input-fuse-hold, input-fuse-trip, limit-switch-low, plug-band-high, plug-band-low, regen-energy-174mJ, regen-energy-20mJ, regen-energy-2mJ, regen-energy-50mJ, regen-energy-5mJ, regulator-headroom, shunt-power
- **fsr_e96_search_hi_ohm:** blocks adc-charge, filter-delay, fsr-node-high
- **fsr_e96_search_lo_ohm:** blocks adc-charge, filter-delay, fsr-node-high
- **fsr_filter_gain_freqs_hz:** blocks adc-charge, filter-delay, fsr-node-high
- **fsr_fit_r1n_ohm:** blocks adapter-current, adc-charge, buck-thermal, filter-delay, force-reading-error, fsr-node-high, input-fuse-hold, input-fuse-trip, limit-switch-low, plug-band-high, plug-band-low, regen-energy-174mJ, regen-energy-20mJ, regen-energy-2mJ, regen-energy-50mJ, regen-energy-5mJ, regulator-headroom, shunt-power
- **fsr_resolution_force_n:** blocks adc-charge, filter-delay, fsr-node-high
- **fsr_sample_rate_hz:** blocks adc-charge, filter-delay, fsr-node-high
- **fsr_table_forces_n:** blocks adc-charge, filter-delay, fsr-node-high
- **fsr_unloaded_force_n:** blocks adc-charge, filter-delay, fsr-node-high
- **gripper_pad_radius_m:** blocks current-error, detection-time, firmware-trip-10N, firmware-trip-8N, sense-range
- **gripper_train_efficiency:** blocks current-error, detection-time, firmware-trip-10N, firmware-trip-8N, sense-range
- **harness_adapter_cord_mm:** blocks force-reading-error, limit-switch-low, plug-band-high, plug-band-low
- **harness_awg_pigtail:** blocks force-reading-error, limit-switch-low, plug-band-high, plug-band-low
- **harness_awg_power:** blocks force-reading-error, limit-switch-low, plug-band-high, plug-band-low
- **harness_awg_signal:** blocks force-reading-error, limit-switch-low, plug-band-high, plug-band-low
- **harness_bend_factor:** blocks force-reading-error, limit-switch-low, plug-band-high, plug-band-low
- **harness_bend_factor_abs:** blocks force-reading-error, limit-switch-low, plug-band-high, plug-band-low
- **harness_cap_lead_mm:** blocks force-reading-error, limit-switch-low, plug-band-high, plug-band-low
- **harness_cycle_s:** blocks force-reading-error, limit-switch-low, plug-band-high, plug-band-low
- **harness_design_life_cycles:** blocks force-reading-error, limit-switch-low, plug-band-high, plug-band-low
- **harness_force_error_limit_n:** blocks force-reading-error
- **harness_fsr_error_forces_n:** blocks force-reading-error, limit-switch-low, plug-band-high, plug-band-low
- **harness_fsr_force_cap_n:** blocks force-reading-error, limit-switch-low, plug-band-high, plug-band-low
- **harness_fsr_run_mm:** blocks force-reading-error, limit-switch-low, plug-band-high, plug-band-low
- **harness_jaw_max_deg:** blocks force-reading-error, limit-switch-low, plug-band-high, plug-band-low
- **harness_limit_run_mm:** blocks force-reading-error, limit-switch-low, plug-band-high, plug-band-low
- **harness_od_26awg_mm:** blocks force-reading-error, limit-switch-low, plug-band-high, plug-band-low
- **harness_pigtail_mm:** blocks force-reading-error, limit-switch-low, plug-band-high, plug-band-low
- **harness_plug_band_v:** blocks adapter-current, buck-thermal, force-reading-error, input-fuse-hold, input-fuse-trip, limit-switch-low, plug-band-high, plug-band-low, regen-energy-174mJ, regen-energy-20mJ, regen-energy-2mJ, regen-energy-50mJ, regen-energy-5mJ, regulator-headroom, shunt-power
- **harness_plug_rating_v:** blocks force-reading-error, limit-switch-low, plug-band-high, plug-band-low
- **harness_pwm_current_a:** blocks force-reading-error, limit-switch-low, plug-band-high, plug-band-low
- **harness_semester_fraction:** blocks force-reading-error, limit-switch-low, plug-band-high, plug-band-low
- **harness_servo_lead_ohm:** blocks force-reading-error, limit-switch-low, plug-band-high, plug-band-low
- **harness_servo_v_min:** blocks force-reading-error, limit-switch-low, plug-band-high, plug-band-low
- **harness_spare_fraction:** blocks force-reading-error, limit-switch-low, plug-band-high, plug-band-low
- **harness_unwired_length_mm:** blocks force-reading-error, limit-switch-low, plug-band-high, plug-band-low
- **harness_usb_cable_mm:** blocks force-reading-error, limit-switch-low, plug-band-high, plug-band-low
- **harness_vil_fraction:** blocks force-reading-error, limit-switch-low, plug-band-high, plug-band-low
- **ibus_5v_idle:** blocks adapter-current, buck-current-limit, buck-thermal, droop-servo-min, input-fuse-hold, input-fuse-trip, regen-energy-174mJ, regen-energy-20mJ, regen-energy-2mJ, regen-energy-50mJ, regen-energy-5mJ, regulator-headroom, shunt-power
- **ina_average_codes_samples:** blocks current-error, detection-time, firmware-trip-10N, firmware-trip-8N, sense-range
- **ina_average_fit_limit_s:** blocks current-error, detection-time, firmware-trip-10N, firmware-trip-8N, sense-range
- **ina_chop_duty:** blocks current-error, detection-time, firmware-trip-10N, firmware-trip-8N, sense-range
- **ina_chop_frequencies_hz:** blocks current-error, detection-time, firmware-trip-10N, firmware-trip-8N, sense-range
- **ina_control_period_s:** blocks current-error, detection-time, firmware-trip-10N, firmware-trip-8N, sense-range
- **ina_conv_12bit:** blocks current-error, detection-time, firmware-trip-10N, firmware-trip-8N, sense-range
- **ina_conv_12bit_max:** blocks current-error, detection-time, firmware-trip-10N, firmware-trip-8N, sense-range
- **ina_current_error_limit_a:** blocks current-error
- **ina_default_cfg:** blocks current-error, detection-time, firmware-trip-10N, firmware-trip-8N, sense-range
- **ina_detection_limit_s:** blocks current-error, detection-time, firmware-trip-10N, firmware-trip-8N, sense-range
- **ina_force_caps_n:** blocks adc-charge, current-error, detection-time, filter-delay, firmware-trip-10N, firmware-trip-8N, fsr-node-high, sense-range
- **ina_fs_pga8:** blocks current-error, detection-time, firmware-trip-10N, firmware-trip-8N, sense-range
- **ina_gain_tc:** blocks current-error, detection-time, firmware-trip-10N, firmware-trip-8N, sense-range
- **ina_gain_temperature_span_c:** blocks current-error, detection-time, firmware-trip-10N, firmware-trip-8N, sense-range
- **ina_ibias:** blocks current-error, detection-time, firmware-trip-10N, firmware-trip-8N, sense-range
- **ina_input_impedance_ohm:** blocks current-error, detection-time, firmware-trip-10N, firmware-trip-8N, sense-range
- **ina_lsb:** blocks current-error, detection-time, firmware-trip-10N, firmware-trip-8N, sense-range
- **ina_meas_err_max:** blocks current-error, detection-time, firmware-trip-10N, firmware-trip-8N, sense-range
- **ina_recommended_sadc_code:** blocks current-error, detection-time, firmware-trip-10N, firmware-trip-8N, sense-range
- **ina_sadc_mask:** blocks current-error, detection-time, firmware-trip-10N, firmware-trip-8N, sense-range
- **ina_sadc_shift:** blocks current-error, detection-time, firmware-trip-10N, firmware-trip-8N, sense-range
- **ina_saturation_error_fraction:** blocks current-error, detection-time, firmware-trip-10N, firmware-trip-8N, sense-range
- **ina_shunt_temperature_rise_c:** blocks current-error, detection-time, firmware-trip-10N, firmware-trip-8N, sense-range
- **ina_trip_current_a:** blocks current-error, detection-time, firmware-trip-10N, firmware-trip-8N, sense-range
- **ina_trip_window_s:** blocks current-error, detection-time, firmware-trip-10N, firmware-trip-8N, sense-range
- **ina_vos_pga8:** blocks current-error, detection-time, firmware-trip-10N, firmware-trip-8N, sense-range
- **ipc_b:** blocks trace-current, trace-drop, trace-neck-current, trace-temperature
- **ipc_c:** blocks trace-current, trace-drop, trace-neck-current, trace-temperature
- **ipc_k_ext:** blocks trace-current, trace-drop, trace-neck-current, trace-temperature
- **ipc_mil_per_oz:** blocks trace-current, trace-drop, trace-neck-current, trace-temperature
- **l1_dcr:** blocks adapter-current, buck-thermal, input-fuse-hold, input-fuse-trip, regen-energy-174mJ, regen-energy-20mJ, regen-energy-2mJ, regen-energy-50mJ, regen-energy-5mJ, regulator-headroom, shunt-power
- **mc_ridley:** blocks loop-gain, loop-phase, servo-voltage-max, uvlo-range
- **mcp_dropout_max:** blocks adapter-current, buck-current-limit, buck-thermal, droop-servo-min, input-fuse-hold, input-fuse-trip, regen-energy-174mJ, regen-energy-20mJ, regen-energy-2mJ, regen-energy-50mJ, regen-energy-5mJ, regulator-headroom, shunt-power
- **mcp_iout_max:** blocks adapter-current, buck-current-limit, buck-thermal, droop-servo-min, input-fuse-hold, input-fuse-trip, regen-energy-174mJ, regen-energy-20mJ, regen-energy-2mJ, regen-energy-50mJ, regen-energy-5mJ, regulator-headroom, shunt-power
- **mcp_rth_sot223:** blocks adapter-current, buck-thermal, input-fuse-hold, input-fuse-trip, regen-energy-174mJ, regen-energy-20mJ, regen-energy-2mJ, regen-energy-50mJ, regen-energy-5mJ, regulator-headroom, shunt-power
- **mcp_vout_tol:** blocks adapter-current, buck-thermal, input-fuse-hold, input-fuse-trip, regen-energy-174mJ, regen-energy-20mJ, regen-energy-2mJ, regen-energy-50mJ, regen-energy-5mJ, regulator-headroom, shunt-power
- **power_3v3_minus_1pct_mv:** blocks adapter-current, buck-thermal, input-fuse-hold, input-fuse-trip, regen-energy-174mJ, regen-energy-20mJ, regen-energy-2mJ, regen-energy-50mJ, regen-energy-5mJ, regulator-headroom, shunt-power
- **power_3v3_minus_3pct_mv:** blocks adapter-current, buck-thermal, input-fuse-hold, input-fuse-trip, regen-energy-174mJ, regen-energy-20mJ, regen-energy-2mJ, regen-energy-50mJ, regen-energy-5mJ, regulator-headroom, shunt-power
- **power_3v3_plus_1pct_mv:** blocks adapter-current, buck-thermal, input-fuse-hold, input-fuse-trip, regen-energy-174mJ, regen-energy-20mJ, regen-energy-2mJ, regen-energy-50mJ, regen-energy-5mJ, regulator-headroom, shunt-power
- **power_3v3_rail_v:** blocks adapter-current, buck-thermal, input-fuse-hold, input-fuse-trip, regen-energy-174mJ, regen-energy-20mJ, regen-energy-2mJ, regen-energy-50mJ, regen-energy-5mJ, regulator-headroom, shunt-power
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
- **power_regen_low_mj:** blocks adapter-current, buck-thermal, input-fuse-hold, input-fuse-trip, regen-energy-174mJ, regen-energy-20mJ, regen-energy-2mJ, regen-energy-50mJ, regen-energy-5mJ, regulator-headroom, shunt-power
- **power_regen_min_mj:** blocks adapter-current, buck-thermal, input-fuse-hold, input-fuse-trip, regen-energy-174mJ, regen-energy-20mJ, regen-energy-2mJ, regen-energy-50mJ, regen-energy-5mJ, regulator-headroom, shunt-power
- **power_regen_rotor_mj:** blocks adapter-current, buck-thermal, input-fuse-hold, input-fuse-trip, regen-energy-174mJ, regen-energy-20mJ, regen-energy-2mJ, regen-energy-50mJ, regen-energy-5mJ, regulator-headroom, shunt-power
- **power_starting_efficiency:** blocks adapter-current, buck-thermal, input-fuse-hold, input-fuse-trip, regen-energy-174mJ, regen-energy-20mJ, regen-energy-2mJ, regen-energy-50mJ, regen-energy-5mJ, regulator-headroom, shunt-power
- **power_switch_transition_time_s:** blocks adapter-current, buck-thermal, input-fuse-hold, input-fuse-trip, regen-energy-174mJ, regen-energy-20mJ, regen-energy-2mJ, regen-energy-50mJ, regen-energy-5mJ, regulator-headroom, shunt-power
- **power_usb_max_v:** blocks adapter-current, buck-thermal, input-fuse-hold, input-fuse-trip, regen-energy-174mJ, regen-energy-20mJ, regen-energy-2mJ, regen-energy-50mJ, regen-energy-5mJ, regulator-headroom, shunt-power
- **power_usb_min_v:** blocks adapter-current, buck-thermal, input-fuse-hold, input-fuse-trip, regen-energy-174mJ, regen-energy-20mJ, regen-energy-2mJ, regen-energy-50mJ, regen-energy-5mJ, regulator-headroom, shunt-power
- **q1_rds:** blocks adapter-current, buck-thermal, input-fuse-hold, input-fuse-trip, regen-energy-174mJ, regen-energy-20mJ, regen-energy-2mJ, regen-energy-50mJ, regen-energy-5mJ, regulator-headroom, shunt-power
- **rs1_rating:** blocks adapter-current, buck-thermal, input-fuse-hold, input-fuse-trip, regen-energy-174mJ, regen-energy-20mJ, regen-energy-2mJ, regen-energy-50mJ, regen-energy-5mJ, regulator-headroom, shunt-power
- **rs1_tcr:** blocks current-error, detection-time, firmware-trip-10N, firmware-trip-8N, sense-range
- **rs1_tol:** blocks current-error, detection-time, firmware-trip-10N, firmware-trip-8N, sense-range, shunt-power
- **servo_hold_torque_nm:** blocks current-error, detection-time, firmware-trip-10N, firmware-trip-8N, sense-range
- **servo_idle_a:** blocks adapter-current, buck-thermal, input-fuse-hold, input-fuse-trip, regen-energy-174mJ, regen-energy-20mJ, regen-energy-2mJ, regen-energy-50mJ, regen-energy-5mJ, regulator-headroom, shunt-power
- **servo_vmax:** blocks adapter-current, buck-thermal, input-fuse-hold, input-fuse-trip, regen-energy-174mJ, regen-energy-20mJ, regen-energy-2mJ, regen-energy-50mJ, regen-energy-5mJ, regulator-headroom, servo-voltage-max, shunt-power
- **servo_vmin:** blocks adapter-current, buck-current-limit, buck-thermal, droop-servo-min, input-fuse-hold, input-fuse-trip, regen-energy-174mJ, regen-energy-20mJ, regen-energy-2mJ, regen-energy-50mJ, regen-energy-5mJ, regulator-headroom, shunt-power
- **tps_ea_gain:** blocks adapter-current, buck-current-limit, buck-thermal, droop-servo-min, input-fuse-hold, input-fuse-trip, loop-gain, loop-phase, regen-energy-174mJ, regen-energy-20mJ, regen-energy-2mJ, regen-energy-50mJ, regen-energy-5mJ, regulator-headroom, servo-voltage-max, shunt-power, uvlo-range
- **tps_ea_gm:** blocks adapter-current, buck-current-limit, buck-thermal, droop-servo-min, input-fuse-hold, input-fuse-trip, loop-gain, loop-phase, regen-energy-174mJ, regen-energy-20mJ, regen-energy-2mJ, regen-energy-50mJ, regen-energy-5mJ, regulator-headroom, servo-voltage-max, shunt-power, uvlo-range
- **tps_ea_imax:** blocks adapter-current, buck-current-limit, buck-thermal, droop-servo-min, input-fuse-hold, input-fuse-trip, regen-energy-174mJ, regen-energy-20mJ, regen-energy-2mJ, regen-energy-50mJ, regen-energy-5mJ, regulator-headroom, shunt-power
- **tps_en_i1:** blocks loop-gain, loop-phase, servo-voltage-max, uvlo-range
- **tps_en_i1_max:** blocks loop-gain, loop-phase, servo-voltage-max, uvlo-range
- **tps_en_i1_min:** blocks loop-gain, loop-phase, servo-voltage-max, uvlo-range
- **tps_en_ihys:** blocks loop-gain, loop-phase, servo-voltage-max, uvlo-range
- **tps_en_ihys_max:** blocks loop-gain, loop-phase, servo-voltage-max, uvlo-range
- **tps_en_ihys_min:** blocks loop-gain, loop-phase, servo-voltage-max, uvlo-range
- **tps_en_thresh:** blocks loop-gain, loop-phase, servo-voltage-max, uvlo-range
- **tps_en_thresh_max:** blocks loop-gain, loop-phase, servo-voltage-max, uvlo-range
- **tps_en_thresh_min:** blocks loop-gain, loop-phase, servo-voltage-max, uvlo-range
- **tps_ilim_min:** blocks adapter-current, buck-current-limit, buck-thermal, droop-servo-min, input-fuse-hold, input-fuse-trip, loop-gain, loop-phase, regen-energy-174mJ, regen-energy-20mJ, regen-energy-2mJ, regen-energy-50mJ, regen-energy-5mJ, regulator-headroom, servo-voltage-max, shunt-power, uvlo-range
- **tps_ilim_typ:** blocks adapter-current, buck-current-limit, buck-thermal, droop-servo-min, input-fuse-hold, input-fuse-trip, regen-energy-174mJ, regen-energy-20mJ, regen-energy-2mJ, regen-energy-50mJ, regen-energy-5mJ, regulator-headroom, shunt-power
- **tps_iq:** blocks adapter-current, buck-thermal, input-fuse-hold, input-fuse-trip, regen-energy-174mJ, regen-energy-20mJ, regen-energy-2mJ, regen-energy-50mJ, regen-energy-5mJ, regulator-headroom, shunt-power
- **tps_ps_gm:** blocks adapter-current, buck-current-limit, buck-thermal, droop-servo-min, input-fuse-hold, input-fuse-trip, loop-gain, loop-phase, regen-energy-174mJ, regen-energy-20mJ, regen-energy-2mJ, regen-energy-50mJ, regen-energy-5mJ, regulator-headroom, servo-voltage-max, shunt-power, uvlo-range
- **tps_rds_typ:** blocks adapter-current, buck-current-limit, buck-thermal, droop-servo-min, input-fuse-hold, input-fuse-trip, regen-energy-174mJ, regen-energy-20mJ, regen-energy-2mJ, regen-energy-50mJ, regen-energy-5mJ, regulator-headroom, shunt-power
- **tps_rt_coeff:** blocks adapter-current, buck-thermal, input-fuse-hold, input-fuse-trip, loop-gain, loop-phase, regen-energy-174mJ, regen-energy-20mJ, regen-energy-2mJ, regen-energy-50mJ, regen-energy-5mJ, regulator-headroom, servo-voltage-max, shunt-power, uvlo-range
- **tps_rt_exp:** blocks adapter-current, buck-thermal, input-fuse-hold, input-fuse-trip, loop-gain, loop-phase, regen-energy-174mJ, regen-energy-20mJ, regen-energy-2mJ, regen-energy-50mJ, regen-energy-5mJ, regulator-headroom, servo-voltage-max, shunt-power, uvlo-range
- **tps_rth_ja:** blocks adapter-current, buck-thermal, input-fuse-hold, input-fuse-trip, regen-energy-174mJ, regen-energy-20mJ, regen-energy-2mJ, regen-energy-50mJ, regen-energy-5mJ, regulator-headroom, shunt-power
- **tps_ton_min:** blocks loop-gain, loop-phase, servo-voltage-max, uvlo-range
- **tps_vref:** blocks adapter-current, buck-current-limit, buck-thermal, droop-servo-min, input-fuse-hold, input-fuse-trip, regen-energy-174mJ, regen-energy-20mJ, regen-energy-2mJ, regen-energy-50mJ, regen-energy-5mJ, regulator-headroom, shunt-power
- **tps_vref_max:** blocks adapter-current, buck-thermal, force-reading-error, input-fuse-hold, input-fuse-trip, limit-switch-low, loop-gain, loop-phase, plug-band-high, plug-band-low, regen-energy-174mJ, regen-energy-20mJ, regen-energy-2mJ, regen-energy-50mJ, regen-energy-5mJ, regulator-headroom, servo-voltage-max, shunt-power, uvlo-range
- **tps_vref_min:** blocks adapter-current, buck-thermal, force-reading-error, input-fuse-hold, input-fuse-trip, limit-switch-low, loop-gain, loop-phase, plug-band-high, plug-band-low, regen-energy-174mJ, regen-energy-20mJ, regen-energy-2mJ, regen-energy-50mJ, regen-energy-5mJ, regulator-headroom, servo-voltage-max, shunt-power, uvlo-range
- **trace_ambient_temperature_c:** blocks trace-current, trace-drop, trace-neck-current, trace-temperature
- **trace_auxiliary_current_a:** blocks trace-current, trace-drop, trace-neck-current, trace-temperature
- **trace_hold_current_a:** blocks trace-current, trace-drop, trace-neck-current, trace-temperature
- **trace_mm_per_mil:** blocks trace-current, trace-drop, trace-neck-current, trace-temperature
- **trace_reference_length_mm:** blocks trace-current, trace-drop, trace-neck-current, trace-temperature
- **trace_reference_temperature_c:** blocks trace-current, trace-drop, trace-neck-current, trace-temperature
- **trace_servo_drop_limit_mv:** blocks trace-drop
- **trace_supply_current_a:** blocks trace-current, trace-drop, trace-neck-current, trace-temperature
- **trace_temp_rise_limit_c:** blocks trace-temperature
- **trace_temperature_rises_c:** blocks trace-current, trace-drop, trace-neck-current, trace-temperature
- **trace_via_drill_mm:** blocks trace-current, trace-drop, trace-neck-current, trace-temperature
- **trace_via_plating_um:** blocks trace-current, trace-drop, trace-neck-current, trace-temperature
- **wire_gauges_awg:** blocks adapter-current, buck-thermal, input-fuse-hold, input-fuse-trip, regen-energy-174mJ, regen-energy-20mJ, regen-energy-2mJ, regen-energy-50mJ, regen-energy-5mJ, regulator-headroom, shunt-power

Uncertainties combine by worst-case sum of absolute endpoint sensitivities.

| id | margin | uncertainty | components | status |
|---|---:|---:|---|---|
| input-fuse-hold | 0.1124745 A | known subtotal 0; 123 band(s) missing | F1 MF-MSMF260/16X hold-current tolerance at 25 C: missing band (missing: F1 MF-MSMF260/16X — hold-current tolerance at 25 C; find in datasheet electrical characteristics table) | margin positive, uncertainty not evidenced |
| input-fuse-trip | 2.512475 A | known subtotal 0; 124 band(s) missing | F1 MF-MSMF260/16X trip-current tolerance at 25 C: missing band (missing: F1 MF-MSMF260/16X — trip-current tolerance at 25 C; find in datasheet electrical characteristics table) | margin positive, uncertainty not evidenced |
| buck-current-limit | 2.223063 A | known subtotal 0; 62 band(s) missing | U1 TPS54560BDDAR current-limit test-condition variation: missing band (missing: U1 TPS54560BDDAR — current-limit test-condition variation; find in datasheet electrical characteristics table) | margin positive, uncertainty not evidenced |
| buck-thermal | 52.08829 C | known subtotal 0; 124 band(s) missing | U1 TPS54560BDDAR junction-to-ambient thermal resistance for the assembled PCB: missing band (missing: U1 TPS54560BDDAR — junction-to-ambient thermal resistance for the assembled PCB; find in DESIGN-BASIS.md section 10 thermal-rise bench step) | margin positive, uncertainty not evidenced |
| trace-current | 0.1831129 A | known subtotal 0; 18 band(s) missing | PCB copper finished copper thickness tolerance: missing band (missing: PCB copper — finished copper thickness tolerance; find in PCB fabricator stack-up certificate) | margin positive, uncertainty not evidenced |
| trace-neck-current | -2.118601 A | known subtotal 0; 18 band(s) missing | PCB copper finished copper thickness tolerance: missing band (missing: PCB copper — finished copper thickness tolerance; find in PCB fabricator stack-up certificate) | not met pending measurement |
| trace-temperature | 1.021854 C | known subtotal 0; 19 band(s) missing | PCB copper finished copper thickness tolerance: missing band (missing: PCB copper — finished copper thickness tolerance; find in PCB fabricator stack-up certificate) | margin positive, uncertainty not evidenced |
| trace-drop | 28.80989 mV | known subtotal 0; 19 band(s) missing | PCB copper finished copper thickness tolerance: missing band (missing: PCB copper — finished copper thickness tolerance; find in PCB fabricator stack-up certificate) | margin positive, uncertainty not evidenced |
| shunt-power | 0.7844592 W | known subtotal 0.01215541; 123 band(s) missing | RS1 resistance tolerance: [-0.01, 0.01] (constants.py:138, RS1 0.1 ohm 1 percent design value) | margin positive, uncertainty not evidenced |
| sense-range | -0.57 A | known subtotal 0; 41 band(s) missing | U2 INA219AIDR input-filter source-impedance mismatch: missing band (missing: U2 INA219AIDR — input-filter source-impedance mismatch; find in DESIGN-BASIS.md section 10 current-calibration bench step) | not met pending measurement |
| current-error | -0.01384375 A | known subtotal 0; 42 band(s) missing | U2 INA219AIDR input-filter source-impedance mismatch: missing band (missing: U2 INA219AIDR — input-filter source-impedance mismatch; find in DESIGN-BASIS.md section 10 current-calibration bench step) | not met pending measurement |
| detection-time | 0.079414 s | known subtotal 0; 41 band(s) missing | U2 INA219AIDR input-filter source-impedance mismatch: missing band (missing: U2 INA219AIDR — input-filter source-impedance mismatch; find in DESIGN-BASIS.md section 10 current-calibration bench step) | margin positive, uncertainty not evidenced |
| fsr-node-high | -7.456691 mV | known subtotal 0; 22 band(s) missing | U3 ESP32-WROOM-32E ADC linear-range endpoint variation: missing band (missing: U3 ESP32-WROOM-32E — ADC linear-range endpoint variation; find in DESIGN-BASIS.md section 10 ADC sweep bench step) | not met pending measurement |
| force-reading-error | 0.09717833 N | known subtotal 0; 52 band(s) missing | J1/J2/J3 harness assembly finished conductor resistance and contact-resistance range: missing band (missing: J1/J2/J3 harness assembly — finished conductor resistance and contact-resistance range; find in DESIGN-BASIS.md section 10 harness milliohm bench step) | margin positive, uncertainty not evidenced |
| adc-charge | 0.391684 mV | known subtotal 0; 23 band(s) missing | C17 100 nF capacitance tolerance: missing band (missing: C17 100 nF — capacitance tolerance; find in C17 manufacturer datasheet capacitance-tolerance table) | margin positive, uncertainty not evidenced |
| filter-delay | 0.07475854 s | known subtotal 0; 22 band(s) missing | C17 100 nF capacitance tolerance: missing band (missing: C17 100 nF — capacitance tolerance; find in C17 manufacturer datasheet capacitance-tolerance table) | margin positive, uncertainty not evidenced |
| firmware-trip-10N | 0.7540514 A | known subtotal 0; 41 band(s) missing | servo Fit A dyno specimen torque-constant and hold-current fit confidence interval: missing band (missing: servo Fit A dyno specimen — torque-constant and hold-current fit confidence interval; find in DESIGN-BASIS.md section 10 force/current sweep) | margin positive, uncertainty not evidenced |
| firmware-trip-8N | 1.109315 A | known subtotal 0; 41 band(s) missing | servo Fit A dyno specimen torque-constant and hold-current fit confidence interval: missing band (missing: servo Fit A dyno specimen — torque-constant and hold-current fit confidence interval; find in DESIGN-BASIS.md section 10 force/current sweep) | margin positive, uncertainty not evidenced |
| adapter-current | -0.1094069 A | known subtotal 0; 124 band(s) missing | PS1 12 V 3 A adapter rated-current capability over temperature: missing band (missing: PS1 12 V 3 A adapter — rated-current capability over temperature; find in adapter datasheet output-current table) | not met pending measurement |
| droop-servo-min | 1.293385 V | known subtotal 0; 62 band(s) missing | C12 1000 uF capacitance and ESR after bias, temperature, and ageing: missing band (missing: C12 1000 uF — capacitance and ESR after bias, temperature, and ageing; find in DESIGN-BASIS.md section 10 load-step bench step) | margin positive, uncertainty not evidenced |
| servo-voltage-max | 0.1410554 V | known subtotal 0; 61 band(s) missing | none; demand already evaluated at listed extremes | margin positive, uncertainty not evidenced |
| plug-band-low | 0.03196618 V | known subtotal 0; 51 band(s) missing | J1/J2/J3 harness assembly finished conductor resistance and contact-resistance range: missing band (missing: J1/J2/J3 harness assembly — finished conductor resistance and contact-resistance range; find in DESIGN-BASIS.md section 10 harness milliohm bench step) | margin positive, uncertainty not evidenced |
| plug-band-high | 0.113279 V | known subtotal 0; 51 band(s) missing | J1/J2/J3 harness assembly finished conductor resistance and contact-resistance range: missing band (missing: J1/J2/J3 harness assembly — finished conductor resistance and contact-resistance range; find in DESIGN-BASIS.md section 10 harness milliohm bench step) | margin positive, uncertainty not evidenced |
| loop-phase | 46.06384 deg | known subtotal 0; 61 band(s) missing | U1 TPS54560BDDAR compensation network small-signal plant/model error band: missing band (missing: U1 TPS54560BDDAR compensation network — small-signal plant/model error band; find in DESIGN-BASIS.md section 10 loop-response bench step) | margin positive, uncertainty not evidenced |
| loop-gain | 9.50081 dB | known subtotal 0; 61 band(s) missing | U1 TPS54560BDDAR compensation network small-signal plant/model error band: missing band (missing: U1 TPS54560BDDAR compensation network — small-signal plant/model error band; find in DESIGN-BASIS.md section 10 loop-response bench step) | margin positive, uncertainty not evidenced |
| uvlo-range | 2.023298 V | known subtotal 0; 62 band(s) missing | U1 TPS54560BDDAR compensation network small-signal plant/model error band: missing band (missing: U1 TPS54560BDDAR compensation network — small-signal plant/model error band; find in DESIGN-BASIS.md section 10 loop-response bench step) | margin positive, uncertainty not evidenced |
| regulator-headroom | 0.8860886 V | known subtotal 0; 123 band(s) missing | PS1 12 V 3 A adapter rated-current capability over temperature: missing band (missing: PS1 12 V 3 A adapter — rated-current capability over temperature; find in adapter datasheet output-current table) | margin positive, uncertainty not evidenced |
| limit-switch-low | 824.7744 mV | known subtotal 0; 51 band(s) missing | J1/J2/J3 harness assembly finished conductor resistance and contact-resistance range: missing band (missing: J1/J2/J3 harness assembly — finished conductor resistance and contact-resistance range; find in DESIGN-BASIS.md section 10 harness milliohm bench step) | margin positive, uncertainty not evidenced |
| regen-energy-2mJ | 0.02239736 V | known subtotal 0; 123 band(s) missing | PS1 12 V 3 A adapter rated-current capability over temperature: missing band (missing: PS1 12 V 3 A adapter — rated-current capability over temperature; find in adapter datasheet output-current table) | margin positive, uncertainty not evidenced |
| regen-energy-5mJ | -0.2616369 V | known subtotal 0; 123 band(s) missing | PS1 12 V 3 A adapter rated-current capability over temperature: missing band (missing: PS1 12 V 3 A adapter — rated-current capability over temperature; find in adapter datasheet output-current table) | not met pending measurement |
| regen-energy-20mJ | -1.537914 V | known subtotal 0; 123 band(s) missing | PS1 12 V 3 A adapter rated-current capability over temperature: missing band (missing: PS1 12 V 3 A adapter — rated-current capability over temperature; find in adapter datasheet output-current table) | not met pending measurement |
| regen-energy-50mJ | -3.632113 V | known subtotal 0; 123 band(s) missing | PS1 12 V 3 A adapter rated-current capability over temperature: missing band (missing: PS1 12 V 3 A adapter — rated-current capability over temperature; find in adapter datasheet output-current table) | not met pending measurement |
| regen-energy-174mJ | -9.671271 V | known subtotal 0; 123 band(s) missing | PS1 12 V 3 A adapter rated-current capability over temperature: missing band (missing: PS1 12 V 3 A adapter — rated-current capability over temperature; find in adapter datasheet output-current table) | not met pending measurement |

### Computed faults

| id | entry | applied | part | current | power | rating | verdict |
|---|---|---:|---|---:|---:|---|---|
| fault-limit-servo | LIM_SIG | 6.65895 V | D5 | 6.3 A | not evidenced W | not quoted (repository has no continuous-current or clamp-power quote) | not evidenced |
| fault-limit-servo | LIM_SIG | 6.65895 V | R17 | 0.000714669 A | 0.002400534 W | not quoted (repository has no continuous-power quote) | not evidenced |
| fault-limit-servo | LIM_SIG | 6.65895 V | R18 | 0.00665895 A | 0.04434155 W | not quoted (repository has no continuous-power quote) | not evidenced |
| fault-limit-servo | LIM_SIG | 6.65895 V | controller pin | 0.00665895 A | 0.0 W | not quoted (repository has no controller injection-current quote) | not evidenced |
| fault-limit-servo | LIM_SIG | 6.65895 V | +3V3 rail | 0.000714669 A | 0.0 W | not quoted (repository has no 3.3 V rail sink-current quote) | not evidenced |

#### Proposed in-memory protection

| entry | part | current | power | rating | verdict |
|---|---|---:|---:|---|---|
| LIM_RAW | R25 | 0.00665895 A | 0.04434155 W | not quoted (repository has no continuous-power quote) | not evidenced |
| LIM_RAW | R17 | 0.000702128 A | 0.002317021 W | not quoted (repository has no continuous-power quote) | not evidenced |
| LIM_RAW | R18 | 0 A | 0.0 W | not quoted (repository has no continuous-power quote) | not evidenced |
| LIM_RAW | D5 | 0.00736107 A | not evidenced W | not quoted (repository has no continuous-current or clamp-power quote) | not evidenced |
| LIM_RAW | controller pin | 0 A | 0.0 W | not quoted (repository has no controller injection-current quote) | not evidenced |
| LIM_RAW | +3V3 rail | 0.000702128 A | 0.0 W | not quoted (repository has no 3.3 V rail sink-current quote) | not evidenced |

Closed low 0.578947 V against 0.825 V VIL; close tau 0.000182456 s; release tau 0.00057 s.
<!-- ORDER-STATUS:END -->

## Release-artifact discovery rule

The order gate walks `ecad/gripper/` and treats these supplier-facing files as release artifacts:
Gerber layers (`.gbr` and KiCad Gerber extensions), Excellon `.drl` files and `-drl_map.pdf` drill maps,
`.gbrjob` job files, placement and BOM CSVs, `.step`/`.stp` board models, and release archives
(`.zip`, `.7z`, `.rar`, `.tar`, `.tgz`, and compressed tar variants). A CSV is a BOM only when its
case-insensitive header contains either `Item, Qty, Manufacturer, MPN` or
`Comment, Designator, Footprint, LCSC Part #`. A placement CSV is recognised by the header columns
`Ref, PosX, PosY, Rot, Side`. Names alone never make a CSV a BOM or placement file.

Every directory containing one of these artifacts has an `ORDER-STATUS.md`; each BOM also has a
`<stem>-ORDER-STATUS.md` companion. Run the calculation gate after fabrication regeneration.

Generated fabrication files for revision A:

- `gripper-bom-jlcpcb.csv`
- `gripper-bom.csv`
- `gripper-harness-bom.csv`
- `gripper-pos.csv`
- `gripper.step`
