douglaspmcgowan/cloth-feed-gripper/ecad/gripper/calc/out/open_requirements.txt

Ruled R15 = 8 N and R19 = 0.75 s; historical comparisons 10 N and 0.5 s are superseded 2026-10-12
quantity                                                 R15 10 N / R19 0.5 s (superseded 2026-10-12)  R15 10 N / R19 0.75 s (ruled 2026-10-12)  R15 8 N / R19 0.5 s (superseded 2026-10-12)  R15 8 N / R19 0.75 s (ruled 2026-10-12)
-------------------------------------------------------  --------------------------------------------  ----------------------------------------  -------------------------------------------  ---------------------------------------
servo current at the cap, Fit A (T/K + offset) A         2.246                                         2.246                                     1.891                                        1.891
servo current at the cap, Fit B A                        1.323                                         1.323                                     1.116                                        1.116
  same, T/K only: Fit A / Fit B A                        1.776 / 1.038                                 1.776 / 1.038                             1.421 / 0.830                                1.421 / 0.830
margin to the firmware trip, Fit A / Fit B A             +0.754 / +1.677                               +0.754 / +1.677                           +1.109 / +1.884                              +1.109 / +1.884
  same, T/K only: Fit A / Fit B A                        +1.224 / +1.962                               +1.224 / +1.962                           +1.579 / +2.170                              +1.579 / +2.170
FSR node at the cap, board R15 2.70k mV                  2457.5 (+7.5 vs 2450)                         2457.5 (+7.5 vs 2450)                     2337.7 (-112.3 vs 2450)                      2337.7 (-112.3 vs 2450)
FSR node at the cap, best E96 R15 mV                     2610 ohm -> 2436.0                            2610 ohm -> 2436.0                        3160 ohm -> 2441.3                           3160 ohm -> 2441.3
shunt dissipation at the cap, Fit A / Fit B W            0.50 / 0.18                                   0.50 / 0.18                               0.36 / 0.12                                  0.36 / 0.12
cycle time s                                             35.00                                         35.25                                     35.00                                        35.25
mean servo-rail current over the cycle, Fit A / Fit B A  1.033 / 0.628                                 1.035 / 0.630                             1.033 / 0.628                                1.035 / 0.630
mean current from the 12 V adapter, Fit A / Fit B mA     660 / 419                                     662 / 419                                 660 / 419                                    662 / 419

Mean current assumes: close phase at the 5 N hold current, hold phases at the dyno.md hold current, parked/moving 0.15 A, release the mean of the two [A].

Board values that change for each combination:
  R15 10 N / R19 0.5 s:
    - board R15: 2.70k -> 2.61k or 2.67k (node at 10 N is 2457.5 mV, +7.5 mV over the 2450 mV edge; harmless but the cap is the strict case)
    - firmware (not board): STALL_CURRENT_A 3.0 A; Fit A holding current at 10 N is 2.25 A with offset, 1.78 A ideal; the trip must stay above the holding current (minimum 2.41 A) or the stall test moves to a differential measurement
    - F1, adapter, RS1, buck, bulk C12, trace width: none (set by the 3.77 A Fit A stall, not by the cap or the close time)
    - close time 0.5 s (superseded 2026-10-12): none on the board
  R15 10 N / R19 0.75 s:
    - board R15: 2.70k -> 2.61k or 2.67k (node at 10 N is 2457.5 mV, +7.5 mV over the 2450 mV edge; harmless but the cap is the strict case)
    - firmware (not board): STALL_CURRENT_A 3.0 A; Fit A holding current at 10 N is 2.25 A with offset, 1.78 A ideal; the trip must stay above the holding current (minimum 2.41 A) or the stall test moves to a differential measurement
    - F1, adapter, RS1, buck, bulk C12, trace width: none (set by the 3.77 A Fit A stall, not by the cap or the close time)
    - close time 0.75 s: none on the board (cycle 35.25 s instead of 35.00 s; mean current changes under 0.5 %)
  R15 8 N / R19 0.5 s:
    - board R15: 2.70k -> 3.16k (E96) puts 8 N at 2441 mV instead of 2338 mV; 2.70k still works with 112 mV of spare span
    - firmware (not board): STALL_CURRENT_A 3.0 A; Fit A holding current at 8 N is 1.89 A with offset, 1.42 A ideal; the trip must stay above the holding current (minimum 2.03 A) or the stall test moves to a differential measurement
    - F1, adapter, RS1, buck, bulk C12, trace width: none (set by the 3.77 A Fit A stall, not by the cap or the close time)
    - close time 0.5 s (superseded 2026-10-12): none on the board
  R15 8 N / R19 0.75 s:
    - board R15: 2.70k -> 3.16k (E96) puts 8 N at 2441 mV instead of 2338 mV; 2.70k still works with 112 mV of spare span
    - firmware (not board): STALL_CURRENT_A 3.0 A; Fit A holding current at 8 N is 1.89 A with offset, 1.42 A ideal; the trip must stay above the holding current (minimum 2.03 A) or the stall test moves to a differential measurement
    - F1, adapter, RS1, buck, bulk C12, trace width: none (set by the 3.77 A Fit A stall, not by the cap or the close time)
    - close time 0.75 s: none on the board (cycle 35.25 s instead of 35.00 s; mean current changes under 0.5 %)

Summary: the close time (R19) changes no board value. The force cap (R15) changes board R15 only, and only at the margin. The firmware trip (STALL_CURRENT_A) is compared with the Fit A holding current at each cap (see ina219_budget.py).
