douglaspmcgowan/cloth-feed-gripper/LOG.md

# Work log

## 2026-10-23T04:45:15.545642+00:00 — Publish accepted phone-fit and loading recovery

Merged PR21/main2018f46; existing production deploymentCMsREADY. Three exact public-byte comparisons,27liveguards and deployed fit/loading CLI passed;19original artifacts/9decoded PNGs preserved. Current Windows29pass/1unchanged native skip, lint/public/VerifyProject pass. Scope and dependency boundary are explicit in the evidence README; no film, camera-followup or hardware completion claim.

<!-- Append: YYYY-MM-DD | completed work | verifier or evidence -->
