douglaspmcgowan/cloth-feed-gripper/TASK.md

# Task

## Intent

Douglas asked on 2026-10-22 to fix poor CAD in the ongoing product design program. Preserve the full gripper program and repair two independently demonstrated review-app defects without changing engineering evidence.

## Specs

- [x] At a 390px phone viewport, the first gap and overlap findings show both comparison anchors, complete relevant labels and locator within the fit stage, proven by actual browser bounds and inspected screenshots.
- [x] A blocked pinned 3D dependency exposes distinct initial, early still-loading/reload and terminal recovery states, with keyboard recovery and usable Parts; slow eventual success clears loading correctly.
- [x] Model/fit/parts/assembly controls and exact data/fit artifacts remain intact; deterministic source-owned viewer build and focused static/browser tests pass before fresh independent acceptance.

## Goal

Fix actual phone fit framing and loading feedback from the independently verified current main d4861b3, retaining honest unbuilt and physical-failure claims. No merge or deployment is authorized here.

## Active

## Queue

- [ ] Deliver accepted source PR21 when explicit default-branch/deployment authority is available. Done when: authorized merge/deployment and actual endpoint checks complete; source repair and independent local acceptance are already finished, physical and broader program gates remain separate.

## Blocked

## Needs decision

## Completed

- [x] Independent local UI acceptance complete: task_e_6ad9f051eb9c83208e2b066ea030a064 returns READY/no actionable findings for corrected fit/loading and exercised primary flows at source/publicreview. Both actual browser CLIs pass; focused independent control exercise passes; cloud static29pass/1CadQueryskip and Windows30pass. All10returnedPNGs fullydecoded/staged-identical; archive-free evidence PDS PR87 head d6604e3. Controlled exact Three.js fixture is explicit; no deployed CDN, wholeC2/C3 or hardware certification. Initial contended timing failure retained; serial source/served runs passed unchanged.

- [x] Prepare isolated owned source branch at verified current main d4861b3. Required generated harness installed through canonical Manage-Harness EnsureProject and VerifyProject exits0. Existing detector reports18slop/24quality legacy findings, not an enrolled design verdict; no unrelated UI polish.
- [x] Refute original runtime-review static finding3 using complete same-commit dependency closure:28source-owned static tests passed30.84s without product/fit/guard changes. Actual phone clipping and20second loading ambiguity remain verified defects. Evidence and adjudication preserved in PDS PR87.

## Verification

- Run existing test_viewer_static.py plus meaningful focused browser regression and coherent deterministic viewer generation after source repair. A model screenshot is not deployed/hardware proof.
- G1: owned branch clean/pushed; G2: no secrets/spend/default changes; preserve existing source and physical thresholds.
