douglaspmcgowan/cloth-feed-gripper/MEMORY.md

# Memory index

<!-- One linked line per durable reference: - [Title](path.md) — when to read it. -->

- [Product system record](PRODUCT.md#system-record) — read for project architecture, ownership, integrations, data flow, and important paths.
- [Harness index](.agents/INDEX.md) — read for canonical harness skills, tools, owners, and search routes.
