douglaspmcgowan/cloth-feed-gripper/ecad/gripper/HARNESS.md

# Gripper harness: build guide

<!-- ORDER-STATUS:BEGIN -->
## Order status — DO NOT ORDER

Input provenance uses per-module read granularity; each row lists modules read in margins.json.

- `input-fuse-hold`: missing: F1 MF-MSMF260/16X — hold-current tolerance at 25 C; find in datasheet electrical characteristics table; assembled gripper controller — ams_dropout_max uncertainty or qualification; find in DESIGN-BASIS section 10 corresponding bench step; assembled gripper controller — 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
- `input-fuse-trip`: missing: F1 MF-MSMF260/16X — trip-current tolerance at 25 C; find in datasheet electrical characteristics table; assembled gripper controller — ams_dropout_max uncertainty or qualification; find in DESIGN-BASIS section 10 corresponding bench step; assembled gripper controller — 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
- `buck-current-limit`: missing: U1 TPS54560BDDAR — current-limit test-condition variation; find in datasheet electrical characteristics table; finished servo harness — awg20_ohm_m uncertainty or qualification; find in selected wire datasheet or finished-harness measurement; assembled gripper controller — c12_esr uncertainty or qualification; find in DESIGN-BASIS section 10 corresponding bench step; assembled gripper controller — c_wrist_esr uncertainty or qualification; find in DESIGN-BASIS section 10 corresponding bench step; finished servo harness — cable_l_per_m uncertainty or qualification; find in selected wire datasheet or finished-harness measurement; assembled gripper controller — cer_derate_6v6 uncertainty or qualification; find in DESIGN-BASIS section 10 corresponding bench step; 47 uF ceramics — effective capacitance at DC bias; find in manufacturer DC-bias curves; assembled gripper controller — devkit_overhead_a uncertainty or qualification; find in DESIGN-BASIS section 10 corresponding bench step; assembled gripper controller — droop_5v_load_a uncertainty or qualification; find in DESIGN-BASIS section 10 corresponding bench step; assembled gripper controller — droop_comp_zero_v uncertainty or qualification; find in DESIGN-BASIS section 10 corresponding bench step; assembled gripper controller — droop_default_rise_s uncertainty or qualification; find in DESIGN-BASIS section 10 corresponding bench step; assembled gripper controller — droop_default_vin_v uncertainty or qualification; find in DESIGN-BASIS section 10 corresponding bench step; assembled gripper controller — droop_diode_v uncertainty or qualification; find in DESIGN-BASIS section 10 corresponding bench step; assembled gripper controller — droop_end_time_s uncertainty or qualification; find in DESIGN-BASIS section 10 corresponding bench step; assembled gripper controller — droop_fsw_hz uncertainty or qualification; find in DESIGN-BASIS section 10 corresponding bench step; assembled gripper controller — droop_recovery_band_v uncertainty or qualification; find in DESIGN-BASIS section 10 corresponding bench step; assembled gripper controller — droop_servo_idle_a uncertainty or qualification; find in DESIGN-BASIS section 10 corresponding bench step; assembled gripper controller — droop_step_time_s uncertainty or qualification; find in DESIGN-BASIS section 10 corresponding bench step; assembled gripper controller — droop_voltage_floor_v uncertainty or qualification; find in DESIGN-BASIS section 10 corresponding bench step; selected servo and dyno specimen — fit_a_hold_a uncertainty or qualification; find in manufacturer datasheet or DESIGN-BASIS section 10 force/current bench step; selected servo and dyno specimen — fit_a_resistance_ohm uncertainty or qualification; find in manufacturer datasheet or DESIGN-BASIS section 10 force/current bench step; selected servo and dyno specimen — fit_a_torque_nm_per_a uncertainty or qualification; find in manufacturer datasheet or DESIGN-BASIS section 10 force/current bench step; selected servo and dyno specimen — fit_b_hold_a uncertainty or qualification; find in manufacturer datasheet or DESIGN-BASIS section 10 force/current bench step; selected servo and dyno specimen — fit_b_resistance_ohm uncertainty or qualification; find in manufacturer datasheet or DESIGN-BASIS section 10 force/current bench step; selected servo and dyno specimen — fit_b_stall_a uncertainty or qualification; find in manufacturer datasheet or DESIGN-BASIS section 10 force/current bench step; selected servo and dyno specimen — fit_b_torque_nm_per_a uncertainty or qualification; find in manufacturer datasheet or DESIGN-BASIS section 10 force/current bench step; assembled gripper controller — ibus_5v_idle uncertainty or qualification; find in DESIGN-BASIS section 10 corresponding bench step; L1 SRP1245A-100M — inductance tolerance and bias derating; find in manufacturer datasheet curves; assembled gripper controller — power_external_3v3_load_a uncertainty or qualification; find in DESIGN-BASIS section 10 corresponding bench step; assembled gripper controller — power_five_volt_rail_v uncertainty or qualification; find in DESIGN-BASIS section 10 corresponding bench step; assembled gripper controller — power_ldo_dropout_scale_cap uncertainty or qualification; find in DESIGN-BASIS section 10 corresponding bench step; servo Fit A dyno specimen — stall-current fit confidence interval; find in DESIGN-BASIS.md section 10 force/current sweep; selected servo and dyno specimen — servo_vmin uncertainty or qualification; find in manufacturer datasheet or DESIGN-BASIS section 10 force/current bench step; RS1 WSLP1206R1000FEA — resistance over temperature; find in manufacturer datasheet and calibration step; wrist capacitor — capacitance after bias temperature and ageing; find in manufacturer datasheet
- `buck-thermal`: missing: U1 TPS54560BDDAR — junction-to-ambient thermal resistance for the assembled PCB; find in DESIGN-BASIS.md section 10 thermal-rise bench step; assembled gripper controller — ams_dropout_max uncertainty or qualification; find in DESIGN-BASIS section 10 corresponding bench ste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
- `trace-current`: missing: PCB copper — finished copper thickness tolerance; find in PCB fabricator stack-up certificate; fabricated PCB copper — cu_rho uncertainty or qualification; find in fabricator stack-up or finished-trace measurement; fabricated PCB copper — cu_tc uncertainty or qualification; find in fabricator stack-up or finished-trace measurement; fabricated PCB copper — ipc_b uncertainty or qualification; find in fabricator stack-up or finished-trace measurement; fabricated PCB copper — ipc_c uncertainty or qualification; find in fabricator stack-up or finished-trace measurement; fabricated PCB copper — ipc_k_ext uncertainty or qualification; find in fabricator stack-up or finished-trace measurement; fabricated PCB copper — ipc_mil_per_oz uncertainty or qualification; find in fabricator stack-up or finished-trace measurement; fabricated PCB copper — trace_ambient_temperature_c uncertainty or qualification; find in fabricator stack-up or finished-trace measurement; fabricated PCB copper — trace_auxiliary_current_a uncertainty or qualification; find in fabricator stack-up or finished-trace measurement; servo Fit A dyno specimen — stall-current fit confidence interval; find in DESIGN-BASIS.md section 10 force/current sweep; fabricated PCB copper — trace_hold_current_a uncertainty or qualification; find in fabricator stack-up or finished-trace measurement; fabricated PCB copper — trace_reference_length_mm uncertainty or qualification; find in fabricator stack-up or finished-trace measurement; fabricated PCB copper — trace_reference_temperature_c uncertainty or qualification; find in fabricator stack-up or finished-trace measurement; fabricated PCB copper — trace_supply_current_a uncertainty or qualification; find in fabricator stack-up or finished-trace measurement; fabricated PCB copper — trace_temperature_rises_c uncertainty or qualification; find in fabricator stack-up or finished-trace measurement; fabricated PCB copper — trace_via_drill_mm uncertainty or qualification; find in fabricator stack-up or finished-trace measurement; fabricated PCB copper — trace_via_plating_um uncertainty or qualification; find in fabricator stack-up or finished-trace measurement
- `trace-neck-current`: verify transient heating or widen neck; missing: PCB copper — finished copper thickness tolerance; find in PCB fabricator stack-up certificate; fabricated PCB copper — cu_rho uncertainty or qualification; find in fabricator stack-up or finished-trace measurement; fabricated PCB copper — cu_tc uncertainty or qualification; find in fabricator stack-up or finished-trace measurement; fabricated PCB copper — ipc_b uncertainty or qualification; find in fabricator stack-up or finished-trace measurement; fabricated PCB copper — ipc_c uncertainty or qualification; find in fabricator stack-up or finished-trace measurement; fabricated PCB copper — ipc_k_ext uncertainty or qualification; find in fabricator stack-up or finished-trace measurement; fabricated PCB copper — ipc_mil_per_oz uncertainty or qualification; find in fabricator stack-up or finished-trace measurement; fabricated PCB copper — trace_ambient_temperature_c uncertainty or qualification; find in fabricator stack-up or finished-trace measurement; fabricated PCB copper — trace_auxiliary_current_a uncertainty or qualification; find in fabricator stack-up or finished-trace measurement; servo Fit A dyno specimen — stall-current fit confidence interval; find in DESIGN-BASIS.md section 10 force/current sweep; fabricated PCB copper — trace_hold_current_a uncertainty or qualification; find in fabricator stack-up or finished-trace measurement; fabricated PCB copper — trace_reference_length_mm uncertainty or qualification; find in fabricator stack-up or finished-trace measurement; fabricated PCB copper — trace_reference_temperature_c uncertainty or qualification; find in fabricator stack-up or finished-trace measurement; fabricated PCB copper — trace_supply_current_a uncertainty or qualification; find in fabricator stack-up or finished-trace measurement; fabricated PCB copper — trace_temperature_rises_c uncertainty or qualification; find in fabricator stack-up or finished-trace measurement; fabricated PCB copper — trace_via_drill_mm uncertainty or qualification; find in fabricator stack-up or finished-trace measurement; fabricated PCB copper — trace_via_plating_um uncertainty or qualification; find in fabricator stack-up or finished-trace measurement
- `trace-temperature`: missing: PCB copper — finished copper thickness tolerance; find in PCB fabricator stack-up certificate; fabricated PCB copper — cu_rho uncertainty or qualification; find in fabricator stack-up or finished-trace measurement; fabricated PCB copper — cu_tc uncertainty or qualification; find in fabricator stack-up or finished-trace measurement; fabricated PCB copper — ipc_b uncertainty or qualification; find in fabricator stack-up or finished-trace measurement; fabricated PCB copper — ipc_c uncertainty or qualification; find in fabricator stack-up or finished-trace measurement; fabricated PCB copper — ipc_k_ext uncertainty or qualification; find in fabricator stack-up or finished-trace measurement; fabricated PCB copper — ipc_mil_per_oz uncertainty or qualification; find in fabricator stack-up or finished-trace measurement; fabricated PCB copper — trace_ambient_temperature_c uncertainty or qualification; find in fabricator stack-up or finished-trace measurement; fabricated PCB copper — trace_auxiliary_current_a uncertainty or qualification; find in fabricator stack-up or finished-trace measurement; servo Fit A dyno specimen — stall-current fit confidence interval; find in DESIGN-BASIS.md section 10 force/current sweep; fabricated PCB copper — trace_hold_current_a uncertainty or qualification; find in fabricator stack-up or finished-trace measurement; fabricated PCB copper — trace_reference_length_mm uncertainty or qualification; find in fabricator stack-up or finished-trace measurement; fabricated PCB copper — trace_reference_temperature_c uncertainty or qualification; find in fabricator stack-up or finished-trace measurement; fabricated PCB copper — trace_supply_current_a uncertainty or qualification; find in fabricator stack-up or finished-trace measurement; fabricated PCB copper — trace_temp_rise_limit_c uncertainty or qualification; find in fabricator stack-up or finished-trace measurement; fabricated PCB copper — trace_temperature_rises_c uncertainty or qualification; find in fabricator stack-up or finished-trace measurement; fabricated PCB copper — trace_via_drill_mm uncertainty or qualification; find in fabricator stack-up or finished-trace measurement; fabricated PCB copper — trace_via_plating_um uncertainty or qualification; find in fabricator stack-up or finished-trace measurement
- `trace-drop`: missing: PCB copper — finished copper thickness tolerance; find in PCB fabricator stack-up certificate; fabricated PCB copper — cu_rho uncertainty or qualification; find in fabricator stack-up or finished-trace measurement; fabricated PCB copper — cu_tc uncertainty or qualification; find in fabricator stack-up or finished-trace measurement; fabricated PCB copper — ipc_b uncertainty or qualification; find in fabricator stack-up or finished-trace measurement; fabricated PCB copper — ipc_c uncertainty or qualification; find in fabricator stack-up or finished-trace measurement; fabricated PCB copper — ipc_k_ext uncertainty or qualification; find in fabricator stack-up or finished-trace measurement; fabricated PCB copper — ipc_mil_per_oz uncertainty or qualification; find in fabricator stack-up or finished-trace measurement; fabricated PCB copper — trace_ambient_temperature_c uncertainty or qualification; find in fabricator stack-up or finished-trace measurement; fabricated PCB copper — trace_auxiliary_current_a uncertainty or qualification; find in fabricator stack-up or finished-trace measurement; servo Fit A dyno specimen — stall-current fit confidence interval; find in DESIGN-BASIS.md section 10 force/current sweep; fabricated PCB copper — trace_hold_current_a uncertainty or qualification; find in fabricator stack-up or finished-trace measurement; fabricated PCB copper — trace_reference_length_mm uncertainty or qualification; find in fabricator stack-up or finished-trace measurement; fabricated PCB copper — trace_reference_temperature_c uncertainty or qualification; find in fabricator stack-up or finished-trace measurement; fabricated PCB copper — trace_servo_drop_limit_mv uncertainty or qualification; find in fabricator stack-up or finished-trace measurement; fabricated PCB copper — trace_supply_current_a uncertainty or qualification; find in fabricator stack-up or finished-trace measurement; fabricated PCB copper — trace_temperature_rises_c uncertainty or qualification; find in fabricator stack-up or finished-trace measurement; fabricated PCB copper — trace_via_drill_mm uncertainty or qualification; find in fabricator stack-up or finished-trace measurement; fabricated PCB copper — trace_via_plating_um uncertainty or qualification; find in fabricator stack-up or finished-trace measurement
- `shunt-power`: assembled gripper controller — ams_dropout_max uncertainty or qualification; find in DESIGN-BASIS section 10 corresponding bench step; assembled gripper controller — ams_vout_tol uncertainty or qualification; find in DESIGN-BASIS section 10 corresponding bench step; finished servo h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
- `sense-range`: missing: U2 INA219AIDR — input-filter source-impedance mismatch; find in DESIGN-BASIS.md section 10 current-calibration bench step; selected servo and dyno specimen — fit_a_hold_a uncertainty or qualification; find in manufacturer datasheet or DESIGN-BASIS section 10 force/current bench step; selected servo and dyno specimen — fit_a_resistance_ohm uncertainty or qualification; find in manufacturer datasheet or DESIGN-BASIS section 10 force/current bench step; selected servo and dyno specimen — fit_a_torque_nm_per_a uncertainty or qualification; find in manufacturer datasheet or DESIGN-BASIS section 10 force/current bench step; selected servo and dyno specimen — fit_b_hold_a uncertainty or qualification; find in manufacturer datasheet or DESIGN-BASIS section 10 force/current bench step; selected servo and dyno specimen — fit_b_resistance_ohm uncertainty or qualification; find in manufacturer datasheet or DESIGN-BASIS section 10 force/current bench step; selected servo and dyno specimen — fit_b_stall_a uncertainty or qualification; find in manufacturer datasheet or DESIGN-BASIS section 10 force/current bench step; selected servo and dyno specimen — fit_b_torque_nm_per_a uncertainty or qualification; find in manufacturer datasheet or DESIGN-BASIS section 10 force/current bench step; U2 INA219AIDR current-sense stage — ina_average_fit_limit_s uncertainty or qualification; find in U2 datasheet or current-calibration measurement; U2 INA219AIDR current-sense stage — ina_chop_duty uncertainty or qualification; find in U2 datasheet or current-calibration measurement; U2 INA219AIDR current-sense stage — ina_chop_frequencies_hz uncertainty or qualification; find in U2 datasheet or current-calibration measurement; U2 INA219AIDR current-sense stage — ina_force_caps_n uncertainty or qualification; find in U2 datasheet or current-calibration measurement; U2 INA219AIDR current-sense stage — ina_gain_temperature_span_c uncertainty or qualification; find in U2 datasheet or current-calibration measurement; U2 INA219AIDR current-sense stage — ina_saturation_error_fraction uncertainty or qualification; find in U2 datasheet or current-calibration measurement; U2 INA219AIDR current-sense stage — ina_shunt_temperature_rise_c uncertainty or qualification; find in U2 datasheet or current-calibration measurement; assembled gripper controller — rs1_tcr uncertainty or qualification; find in DESIGN-BASIS section 10 corresponding bench step; assembled gripper controller — rs1_tol uncertainty or qualification; find in DESIGN-BASIS section 10 corresponding bench step; selected servo and dyno specimen — servo_hold_torque_nm uncertainty or qualification; find in manufacturer datasheet or DESIGN-BASIS section 10 force/current bench step; servo Fit A dyno specimen — stall-current fit confidence interval; find in DESIGN-BASIS.md section 10 force/current sweep; RS1 WSLP1206R1000FEA — resistance over temperature; find in manufacturer datasheet and calibration step
- `current-error`: missing: U2 INA219AIDR — input-filter source-impedance mismatch; find in DESIGN-BASIS.md section 10 current-calibration bench step; selected servo and dyno specimen — fit_a_hold_a uncertainty or qualification; find in manufacturer datasheet or DESIGN-BASIS section 10 force/current bench step; selected servo and dyno specimen — fit_a_resistance_ohm uncertainty or qualification; find in manufacturer datasheet or DESIGN-BASIS section 10 force/current bench step; selected servo and dyno specimen — fit_a_torque_nm_per_a uncertainty or qualification; find in manufacturer datasheet or DESIGN-BASIS section 10 force/current bench step; selected servo and dyno specimen — fit_b_hold_a uncertainty or qualification; find in manufacturer datasheet or DESIGN-BASIS section 10 force/current bench step; selected servo and dyno specimen — fit_b_resistance_ohm uncertainty or qualification; find in manufacturer datasheet or DESIGN-BASIS section 10 force/current bench step; selected servo and dyno specimen — fit_b_stall_a uncertainty or qualification; find in manufacturer datasheet or DESIGN-BASIS section 10 force/current bench step; selected servo and dyno specimen — fit_b_torque_nm_per_a uncertainty or qualification; find in manufacturer datasheet or DESIGN-BASIS section 10 force/current bench step; U2 INA219AIDR current-sense stage — ina_average_fit_limit_s uncertainty or qualification; find in U2 datasheet or current-calibration measurement; U2 INA219AIDR current-sense stage — ina_chop_duty uncertainty or qualification; find in U2 datasheet or current-calibration measurement; U2 INA219AIDR current-sense stage — ina_chop_frequencies_hz uncertainty or qualification; find in U2 datasheet or current-calibration measurement; U2 INA219AIDR current-sense stage — ina_current_error_limit_a uncertainty or qualification; find in U2 datasheet or current-calibration measurement; U2 INA219AIDR current-sense stage — ina_force_caps_n uncertainty or qualification; find in U2 datasheet or current-calibration measurement; U2 INA219AIDR current-sense stage — ina_gain_temperature_span_c uncertainty or qualification; find in U2 datasheet or current-calibration measurement; U2 INA219AIDR current-sense stage — ina_saturation_error_fraction uncertainty or qualification; find in U2 datasheet or current-calibration measurement; U2 INA219AIDR current-sense stage — ina_shunt_temperature_rise_c uncertainty or qualification; find in U2 datasheet or current-calibration measurement; assembled gripper controller — rs1_tcr uncertainty or qualification; find in DESIGN-BASIS section 10 corresponding bench step; assembled gripper controller — rs1_tol uncertainty or qualification; find in DESIGN-BASIS section 10 corresponding bench step; selected servo and dyno specimen — servo_hold_torque_nm uncertainty or qualification; find in manufacturer datasheet or DESIGN-BASIS section 10 force/current bench step; servo Fit A dyno specimen — stall-current fit confidence interval; find in DESIGN-BASIS.md section 10 force/current sweep; RS1 WSLP1206R1000FEA — resistance over temperature; find in manufacturer datasheet and calibration step
- `detection-time`: missing: U2 INA219AIDR — input-filter source-impedance mismatch; find in DESIGN-BASIS.md section 10 current-calibration bench step; selected servo and dyno specimen — fit_a_hold_a uncertainty or qualification; find in manufacturer datasheet or DESIGN-BASIS section 10 force/current bench step; selected servo and dyno specimen — fit_a_resistance_ohm uncertainty or qualification; find in manufacturer datasheet or DESIGN-BASIS section 10 force/current bench step; selected servo and dyno specimen — fit_a_torque_nm_per_a uncertainty or qualification; find in manufacturer datasheet or DESIGN-BASIS section 10 force/current bench step; selected servo and dyno specimen — fit_b_hold_a uncertainty or qualification; find in manufacturer datasheet or DESIGN-BASIS section 10 force/current bench step; selected servo and dyno specimen — fit_b_resistance_ohm uncertainty or qualification; find in manufacturer datasheet or DESIGN-BASIS section 10 force/current bench step; selected servo and dyno specimen — fit_b_stall_a uncertainty or qualification; find in manufacturer datasheet or DESIGN-BASIS section 10 force/current bench step; selected servo and dyno specimen — fit_b_torque_nm_per_a uncertainty or qualification; find in manufacturer datasheet or DESIGN-BASIS section 10 force/current bench step; U2 INA219AIDR current-sense stage — ina_average_fit_limit_s uncertainty or qualification; find in U2 datasheet or current-calibration measurement; U2 INA219AIDR current-sense stage — ina_chop_duty uncertainty or qualification; find in U2 datasheet or current-calibration measurement; U2 INA219AIDR current-sense stage — ina_chop_frequencies_hz uncertainty or qualification; find in U2 datasheet or current-calibration measurement; U2 INA219AIDR current-sense stage — ina_force_caps_n uncertainty or qualification; find in U2 datasheet or current-calibration measurement; U2 INA219AIDR current-sense stage — ina_gain_temperature_span_c uncertainty or qualification; find in U2 datasheet or current-calibration measurement; U2 INA219AIDR current-sense stage — ina_saturation_error_fraction uncertainty or qualification; find in U2 datasheet or current-calibration measurement; U2 INA219AIDR current-sense stage — ina_shunt_temperature_rise_c uncertainty or qualification; find in U2 datasheet or current-calibration measurement; assembled gripper controller — rs1_tcr uncertainty or qualification; find in DESIGN-BASIS section 10 corresponding bench step; assembled gripper controller — rs1_tol uncertainty or qualification; find in DESIGN-BASIS section 10 corresponding bench step; selected servo and dyno specimen — servo_hold_torque_nm uncertainty or qualification; find in manufacturer datasheet or DESIGN-BASIS section 10 force/current bench step; servo Fit A dyno specimen — stall-current fit confidence interval; find in DESIGN-BASIS.md section 10 force/current sweep; RS1 WSLP1206R1000FEA — resistance over temperature; find in manufacturer datasheet and calibration step
- `fsr-node-high`: missing: U3 ESP32-WROOM-32E — ADC linear-range endpoint variation; find in DESIGN-BASIS.md section 10 ADC sweep bench step; assembled gripper controller — ctrl_lag_budget_s uncertainty or qualification; find in DESIGN-BASIS section 10 corresponding bench step; assembled gripper controller — ema_alpha uncertainty or qualification; find in DESIGN-BASIS section 10 corresponding bench step; ESP32 DevKitC V4 assembly — esp_adc_cs_pf uncertainty or qualification; find in module and board documentation or rail measurement; ESP32 DevKitC V4 assembly — esp_adc_resolution_bits uncertainty or qualification; find in module and board documentation or rail measurement; ESP32 DevKitC V4 assembly — esp_adc_rsw_ohm uncertainty or qualification; find in module and board documentation or rail measurement; FSR sensor and analog front end — fsr_e96_search_hi_ohm uncertainty or qualification; find in manufacturer curve or DESIGN-BASIS section 10 force/ADC sweep; FSR sensor and analog front end — fsr_e96_search_lo_ohm uncertainty or qualification; find in manufacturer curve or DESIGN-BASIS section 10 force/ADC sweep; FSR sensor and analog front end — fsr_filter_gain_freqs_hz uncertainty or qualification; find in manufacturer curve or DESIGN-BASIS section 10 force/ADC sweep; FSR sensor — fit exponent confidence interval; find in DESIGN-BASIS.md section 10 force sweep; FSR sensor and analog front end — fsr_resolution_force_n uncertainty or qualification; find in manufacturer curve or DESIGN-BASIS section 10 force/ADC sweep; FSR sensor and analog front end — fsr_sample_rate_hz uncertainty or qualification; find in manufacturer curve or DESIGN-BASIS section 10 force/ADC sweep; FSR sensor and analog front end — fsr_table_forces_n uncertainty or qualification; find in manufacturer curve or DESIGN-BASIS section 10 force/ADC sweep; FSR sensor and analog front end — fsr_unloaded_force_n uncertainty or qualification; find in manufacturer curve or DESIGN-BASIS section 10 force/ADC sweep; U2 INA219AIDR current-sense stage — ina_force_caps_n uncertainty or qualification; find in U2 datasheet or current-calibration measurement
- `force-reading-error`: missing: J1/J2/J3 harness assembly — finished conductor resistance and contact-resistance range; find in DESIGN-BASIS.md section 10 harness milliohm bench step; finished servo harness — awg20_ohm_m uncertainty or qualification; find in selected wire datasheet or finished-har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
- `adc-charge`: missing: C17 100 nF — capacitance tolerance; find in C17 manufacturer datasheet capacitance-tolerance table; assembled gripper controller — ctrl_lag_budget_s uncertainty or qualification; find in DESIGN-BASIS section 10 corresponding bench step; assembled gripper controller — ema_alpha uncertainty or qualification; find in DESIGN-BASIS section 10 corresponding bench step; ESP32 DevKitC V4 assembly — esp_adc_cs_pf uncertainty or qualification; find in module and board documentation or rail measurement; ESP32 DevKitC V4 assembly — esp_adc_resolution_bits uncertainty or qualification; find in module and board documentation or rail measurement; ESP32 DevKitC V4 assembly — esp_adc_rsw_ohm uncertainty or qualification; find in module and board documentation or rail measurement; FSR sensor and analog front end — fsr_adc_droop_limit_mv uncertainty or qualification; find in manufacturer curve or DESIGN-BASIS section 10 force/ADC sweep; FSR sensor and analog front end — fsr_e96_search_hi_ohm uncertainty or qualification; find in manufacturer curve or DESIGN-BASIS section 10 force/ADC sweep; FSR sensor and analog front end — fsr_e96_search_lo_ohm uncertainty or qualification; find in manufacturer curve or DESIGN-BASIS section 10 force/ADC sweep; FSR sensor and analog front end — fsr_filter_gain_freqs_hz uncertainty or qualification; find in manufacturer curve or DESIGN-BASIS section 10 force/ADC sweep; FSR sensor — fit exponent confidence interval; find in DESIGN-BASIS.md section 10 force sweep; FSR sensor and analog front end — fsr_resolution_force_n uncertainty or qualification; find in manufacturer curve or DESIGN-BASIS section 10 force/ADC sweep; FSR sensor and analog front end — fsr_sample_rate_hz uncertainty or qualification; find in manufacturer curve or DESIGN-BASIS section 10 force/ADC sweep; FSR sensor and analog front end — fsr_table_forces_n uncertainty or qualification; find in manufacturer curve or DESIGN-BASIS section 10 force/ADC sweep; FSR sensor and analog front end — fsr_unloaded_force_n uncertainty or qualification; find in manufacturer curve or DESIGN-BASIS section 10 force/ADC sweep; U2 INA219AIDR current-sense stage — ina_force_caps_n uncertainty or qualification; find in U2 datasheet or current-calibration measurement
- `filter-delay`: missing: C17 100 nF — capacitance tolerance; find in C17 manufacturer datasheet capacitance-tolerance table; assembled gripper controller — ctrl_lag_budget_s uncertainty or qualification; find in DESIGN-BASIS section 10 corresponding bench step; assembled gripper controller — ema_alpha uncertainty or qualification; find in DESIGN-BASIS section 10 corresponding bench step; ESP32 DevKitC V4 assembly — esp_adc_cs_pf uncertainty or qualification; find in module and board documentation or rail measurement; ESP32 DevKitC V4 assembly — esp_adc_resolution_bits uncertainty or qualification; find in module and board documentation or rail measurement; ESP32 DevKitC V4 assembly — esp_adc_rsw_ohm uncertainty or qualification; find in module and board documentation or rail measurement; FSR sensor and analog front end — fsr_e96_search_hi_ohm uncertainty or qualification; find in manufacturer curve or DESIGN-BASIS section 10 force/ADC sweep; FSR sensor and analog front end — fsr_e96_search_lo_ohm uncertainty or qualification; find in manufacturer curve or DESIGN-BASIS section 10 force/ADC sweep; FSR sensor and analog front end — fsr_filter_gain_freqs_hz uncertainty or qualification; find in manufacturer curve or DESIGN-BASIS section 10 force/ADC sweep; FSR sensor — fit exponent confidence interval; find in DESIGN-BASIS.md section 10 force sweep; FSR sensor and analog front end — fsr_resolution_force_n uncertainty or qualification; find in manufacturer curve or DESIGN-BASIS section 10 force/ADC sweep; FSR sensor and analog front end — fsr_sample_rate_hz uncertainty or qualification; find in manufacturer curve or DESIGN-BASIS section 10 force/ADC sweep; FSR sensor and analog front end — fsr_table_forces_n uncertainty or qualification; find in manufacturer curve or DESIGN-BASIS section 10 force/ADC sweep; FSR sensor and analog front end — fsr_unloaded_force_n uncertainty or qualification; find in manufacturer curve or DESIGN-BASIS section 10 force/ADC sweep; U2 INA219AIDR current-sense stage — ina_force_caps_n uncertainty or qualification; find in U2 datasheet or current-calibration measurement
- `firmware-trip-10N`: missing: servo Fit A dyno specimen — torque-constant and hold-current fit confidence interval; find in DESIGN-BASIS.md section 10 force/current sweep; selected servo and dyno specimen — fit_a_hold_a uncertainty or qualification; find in manufacturer datasheet or DESIGN-BASIS section 10 force/current bench step; selected servo and dyno specimen — fit_a_resistance_ohm uncertainty or qualification; find in manufacturer datasheet or DESIGN-BASIS section 10 force/current bench step; selected servo and dyno specimen — fit_a_torque_nm_per_a uncertainty or qualification; find in manufacturer datasheet or DESIGN-BASIS section 10 force/current bench step; selected servo and dyno specimen — fit_b_hold_a uncertainty or qualification; find in manufacturer datasheet or DESIGN-BASIS section 10 force/current bench step; selected servo and dyno specimen — fit_b_resistance_ohm uncertainty or qualification; find in manufacturer datasheet or DESIGN-BASIS section 10 force/current bench step; selected servo and dyno specimen — fit_b_stall_a uncertainty or qualification; find in manufacturer datasheet or DESIGN-BASIS section 10 force/current bench step; selected servo and dyno specimen — fit_b_torque_nm_per_a uncertainty or qualification; find in manufacturer datasheet or DESIGN-BASIS section 10 force/current bench step; U2 INA219AIDR current-sense stage — ina_average_fit_limit_s uncertainty or qualification; find in U2 datasheet or current-calibration measurement; U2 INA219AIDR current-sense stage — ina_chop_duty uncertainty or qualification; find in U2 datasheet or current-calibration measurement; U2 INA219AIDR current-sense stage — ina_chop_frequencies_hz uncertainty or qualification; find in U2 datasheet or current-calibration measurement; U2 INA219AIDR current-sense stage — ina_force_caps_n uncertainty or qualification; find in U2 datasheet or current-calibration measurement; U2 INA219AIDR current-sense stage — ina_gain_temperature_span_c uncertainty or qualification; find in U2 datasheet or current-calibration measurement; U2 INA219AIDR current-sense stage — ina_saturation_error_fraction uncertainty or qualification; find in U2 datasheet or current-calibration measurement; U2 INA219AIDR current-sense stage — ina_shunt_temperature_rise_c uncertainty or qualification; find in U2 datasheet or current-calibration measurement; assembled gripper controller — rs1_tcr uncertainty or qualification; find in DESIGN-BASIS section 10 corresponding bench step; assembled gripper controller — rs1_tol uncertainty or qualification; find in DESIGN-BASIS section 10 corresponding bench step; selected servo and dyno specimen — servo_hold_torque_nm uncertainty or qualification; find in manufacturer datasheet or DESIGN-BASIS section 10 force/current bench step; servo Fit A dyno specimen — stall-current fit confidence interval; find in DESIGN-BASIS.md section 10 force/current sweep; RS1 WSLP1206R1000FEA — resistance over temperature; find in manufacturer datasheet and calibration step
- `firmware-trip-8N`: missing: servo Fit A dyno specimen — torque-constant and hold-current fit confidence interval; find in DESIGN-BASIS.md section 10 force/current sweep; selected servo and dyno specimen — fit_a_hold_a uncertainty or qualification; find in manufacturer datasheet or DESIGN-BASIS section 10 force/current bench step; selected servo and dyno specimen — fit_a_resistance_ohm uncertainty or qualification; find in manufacturer datasheet or DESIGN-BASIS section 10 force/current bench step; selected servo and dyno specimen — fit_a_torque_nm_per_a uncertainty or qualification; find in manufacturer datasheet or DESIGN-BASIS section 10 force/current bench step; selected servo and dyno specimen — fit_b_hold_a uncertainty or qualification; find in manufacturer datasheet or DESIGN-BASIS section 10 force/current bench step; selected servo and dyno specimen — fit_b_resistance_ohm uncertainty or qualification; find in manufacturer datasheet or DESIGN-BASIS section 10 force/current bench step; selected servo and dyno specimen — fit_b_stall_a uncertainty or qualification; find in manufacturer datasheet or DESIGN-BASIS section 10 force/current bench step; selected servo and dyno specimen — fit_b_torque_nm_per_a uncertainty or qualification; find in manufacturer datasheet or DESIGN-BASIS section 10 force/current bench step; U2 INA219AIDR current-sense stage — ina_average_fit_limit_s uncertainty or qualification; find in U2 datasheet or current-calibration measurement; U2 INA219AIDR current-sense stage — ina_chop_duty uncertainty or qualification; find in U2 datasheet or current-calibration measurement; U2 INA219AIDR current-sense stage — ina_chop_frequencies_hz uncertainty or qualification; find in U2 datasheet or current-calibration measurement; U2 INA219AIDR current-sense stage — ina_force_caps_n uncertainty or qualification; find in U2 datasheet or current-calibration measurement; U2 INA219AIDR current-sense stage — ina_gain_temperature_span_c uncertainty or qualification; find in U2 datasheet or current-calibration measurement; U2 INA219AIDR current-sense stage — ina_saturation_error_fraction uncertainty or qualification; find in U2 datasheet or current-calibration measurement; U2 INA219AIDR current-sense stage — ina_shunt_temperature_rise_c uncertainty or qualification; find in U2 datasheet or current-calibration measurement; assembled gripper controller — rs1_tcr uncertainty or qualification; find in DESIGN-BASIS section 10 corresponding bench step; assembled gripper controller — rs1_tol uncertainty or qualification; find in DESIGN-BASIS section 10 corresponding bench step; selected servo and dyno specimen — servo_hold_torque_nm uncertainty or qualification; find in manufacturer datasheet or DESIGN-BASIS section 10 force/current bench step; servo Fit A dyno specimen — stall-current fit confidence interval; find in DESIGN-BASIS.md section 10 force/current sweep; RS1 WSLP1206R1000FEA — resistance over temperature; find in manufacturer datasheet and calibration step
- `adapter-current`: missing: PS1 12 V 3 A adapter — rated-current capability over temperature; find in adapter datasheet output-current table; assembled gripper controller — adapter_current_a uncertainty or qualification; find in DESIGN-BASIS section 10 corresponding bench step; assembled gripper c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
- `droop-servo-min`: missing: C12 1000 uF — capacitance and ESR after bias, temperature, and ageing; find in DESIGN-BASIS.md section 10 load-step bench step; finished servo harness — awg20_ohm_m uncertainty or qualification; find in selected wire datasheet or finished-harness measurement; assembled gripper controller — c12_esr uncertainty or qualification; find in DESIGN-BASIS section 10 corresponding bench step; assembled gripper controller — c_wrist_esr uncertainty or qualification; find in DESIGN-BASIS section 10 corresponding bench step; finished servo harness — cable_l_per_m uncertainty or qualification; find in selected wire datasheet or finished-harness measurement; assembled gripper controller — cer_derate_6v6 uncertainty or qualification; find in DESIGN-BASIS section 10 corresponding bench step; 47 uF ceramics — effective capacitance at DC bias; find in manufacturer DC-bias curves; assembled gripper controller — devkit_overhead_a uncertainty or qualification; find in DESIGN-BASIS section 10 corresponding bench step; assembled gripper controller — droop_5v_load_a uncertainty or qualification; find in DESIGN-BASIS section 10 corresponding bench step; assembled gripper controller — droop_comp_zero_v uncertainty or qualification; find in DESIGN-BASIS section 10 corresponding bench step; assembled gripper controller — droop_default_rise_s uncertainty or qualification; find in DESIGN-BASIS section 10 corresponding bench step; assembled gripper controller — droop_default_vin_v uncertainty or qualification; find in DESIGN-BASIS section 10 corresponding bench step; assembled gripper controller — droop_diode_v uncertainty or qualification; find in DESIGN-BASIS section 10 corresponding bench step; assembled gripper controller — droop_end_time_s uncertainty or qualification; find in DESIGN-BASIS section 10 corresponding bench step; assembled gripper controller — droop_fsw_hz uncertainty or qualification; find in DESIGN-BASIS section 10 corresponding bench step; assembled gripper controller — droop_recovery_band_v uncertainty or qualification; find in DESIGN-BASIS section 10 corresponding bench step; assembled gripper controller — droop_servo_idle_a uncertainty or qualification; find in DESIGN-BASIS section 10 corresponding bench step; assembled gripper controller — droop_step_time_s uncertainty or qualification; find in DESIGN-BASIS section 10 corresponding bench step; assembled gripper controller — droop_voltage_floor_v uncertainty or qualification; find in DESIGN-BASIS section 10 corresponding bench step; selected servo and dyno specimen — fit_a_hold_a uncertainty or qualification; find in manufacturer datasheet or DESIGN-BASIS section 10 force/current bench step; selected servo and dyno specimen — fit_a_resistance_ohm uncertainty or qualification; find in manufacturer datasheet or DESIGN-BASIS section 10 force/current bench step; selected servo and dyno specimen — fit_a_torque_nm_per_a uncertainty or qualification; find in manufacturer datasheet or DESIGN-BASIS section 10 force/current bench step; selected servo and dyno specimen — fit_b_hold_a uncertainty or qualification; find in manufacturer datasheet or DESIGN-BASIS section 10 force/current bench step; selected servo and dyno specimen — fit_b_resistance_ohm uncertainty or qualification; find in manufacturer datasheet or DESIGN-BASIS section 10 force/current bench step; selected servo and dyno specimen — fit_b_stall_a uncertainty or qualification; find in manufacturer datasheet or DESIGN-BASIS section 10 force/current bench step; selected servo and dyno specimen — fit_b_torque_nm_per_a uncertainty or qualification; find in manufacturer datasheet or DESIGN-BASIS section 10 force/current bench step; assembled gripper controller — ibus_5v_idle uncertainty or qualification; find in DESIGN-BASIS section 10 corresponding bench step; L1 SRP1245A-100M — inductance tolerance and bias derating; find in manufacturer datasheet curves; assembled gripper controller — power_external_3v3_load_a uncertainty or qualification; find in DESIGN-BASIS section 10 corresponding bench step; assembled gripper controller — power_five_volt_rail_v uncertainty or qualification; find in DESIGN-BASIS section 10 corresponding bench step; assembled gripper controller — power_ldo_dropout_scale_cap uncertainty or qualification; find in DESIGN-BASIS section 10 corresponding bench step; servo Fit A dyno specimen — stall-current fit confidence interval; find in DESIGN-BASIS.md section 10 force/current sweep; selected servo and dyno specimen — servo_vmin uncertainty or qualification; find in manufacturer datasheet or DESIGN-BASIS section 10 force/current bench step; RS1 WSLP1206R1000FEA — resistance over temperature; find in manufacturer datasheet and calibration step; wrist capacitor — capacitance after bias temperature and ageing; find in manufacturer datasheet
- `servo-voltage-max`: finished servo harness — awg20_ohm_m uncertainty or qualification; find in selected wire datasheet or finished-harness measurement; U1 TPS54560B buck stage — buck_bulk_scale_max uncertainty or qualification; find in U1 datasheet or assembled loop measurement; U1 TPS54560B buck stage — buck_bulk_scale_min uncertainty or qualification; find in U1 datasheet or assembled loop measurement; U1 TPS54560B buck stage — buck_nominal_input_v uncertainty or qualification; find in U1 datasheet or assembled loop measurement; U1 TPS54560B buck stage — buck_nominal_load_a uncertainty or qualification; find in U1 datasheet or assembled loop measurement; U1 TPS54560B buck stage — buck_servo_lead_resistance_ohm uncertainty or qualification; find in U1 datasheet or assembled loop measurement; assembled gripper controller — c12_esr uncertainty or qualification; find in DESIGN-BASIS section 10 corresponding bench step; assembled gripper controller — c_wrist_esr uncertainty or qualification; find in DESIGN-BASIS section 10 corresponding bench step; finished servo harness — cable_l_per_m uncertainty or qualification; find in selected wire datasheet or finished-harness measurement; assembled gripper controller — cer_derate_6v6 uncertainty or qualification; find in DESIGN-BASIS section 10 corresponding bench step; assembled gripper controller — cer_esr uncertainty or qualification; find in DESIGN-BASIS section 10 corresponding bench step; 47 uF ceramics — effective capacitance at DC bias; find in manufacturer DC-bias curves; L1 SRP1245A-100M — inductance tolerance and bias derating; find in manufacturer datasheet curves; assembled gripper controller — mc_ridley uncertainty or qualification; find in DESIGN-BASIS section 10 corresponding bench step; selected servo and dyno specimen — servo_vmax uncertainty or qualification; find in manufacturer datasheet or DESIGN-BASIS section 10 force/current bench step; RS1 WSLP1206R1000FEA — resistance over temperature; find in manufacturer datasheet and calibration step; wrist capacitor — capacitance after bias temperature and ageing; find in manufacturer datasheet
- `plug-band-low`: missing: J1/J2/J3 harness assembly — finished conductor resistance and contact-resistance range; find in DESIGN-BASIS.md section 10 harness milliohm bench step; finished servo harness — awg20_ohm_m uncertainty or qualification; find in selected wire datasheet or finished-harness m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
- `plug-band-high`: missing: J1/J2/J3 harness assembly — finished conductor resistance and contact-resistance range; find in DESIGN-BASIS.md section 10 harness milliohm bench step; finished servo harness — awg20_ohm_m uncertainty or qualification; find in selected wire datasheet or finished-harness 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
- `loop-phase`: missing: U1 TPS54560BDDAR compensation network — small-signal plant/model error band; find in DESIGN-BASIS.md section 10 loop-response bench step; finished servo harness — awg20_ohm_m uncertainty or qualification; find in selected wire datasheet or finished-harness measurement; U1 TPS54560B buck stage — buck_bulk_scale_max uncertainty or qualification; find in U1 datasheet or assembled loop measurement; U1 TPS54560B buck stage — buck_bulk_scale_min uncertainty or qualification; find in U1 datasheet or assembled loop measurement; U1 TPS54560B buck stage — buck_nominal_input_v uncertainty or qualification; find in U1 datasheet or assembled loop measurement; U1 TPS54560B buck stage — buck_nominal_load_a uncertainty or qualification; find in U1 datasheet or assembled loop measurement; U1 TPS54560B buck stage — buck_servo_lead_resistance_ohm uncertainty or qualification; find in U1 datasheet or assembled loop measurement; assembled gripper controller — c12_esr uncertainty or qualification; find in DESIGN-BASIS section 10 corresponding bench step; assembled gripper controller — c_wrist_esr uncertainty or qualification; find in DESIGN-BASIS section 10 corresponding bench step; finished servo harness — cable_l_per_m uncertainty or qualification; find in selected wire datasheet or finished-harness measurement; assembled gripper controller — cer_derate_6v6 uncertainty or qualification; find in DESIGN-BASIS section 10 corresponding bench step; assembled gripper controller — cer_esr uncertainty or qualification; find in DESIGN-BASIS section 10 corresponding bench step; 47 uF ceramics — effective capacitance at DC bias; find in manufacturer DC-bias curves; L1 SRP1245A-100M — inductance tolerance and bias derating; find in manufacturer datasheet curves; assembled gripper controller — mc_ridley uncertainty or qualification; find in DESIGN-BASIS section 10 corresponding bench step; RS1 WSLP1206R1000FEA — resistance over temperature; find in manufacturer datasheet and calibration step; wrist capacitor — capacitance after bias temperature and ageing; find in manufacturer datasheet
- `loop-gain`: missing: U1 TPS54560BDDAR compensation network — small-signal plant/model error band; find in DESIGN-BASIS.md section 10 loop-response bench step; finished servo harness — awg20_ohm_m uncertainty or qualification; find in selected wire datasheet or finished-harness measurement; U1 TPS54560B buck stage — buck_bulk_scale_max uncertainty or qualification; find in U1 datasheet or assembled loop measurement; U1 TPS54560B buck stage — buck_bulk_scale_min uncertainty or qualification; find in U1 datasheet or assembled loop measurement; U1 TPS54560B buck stage — buck_nominal_input_v uncertainty or qualification; find in U1 datasheet or assembled loop measurement; U1 TPS54560B buck stage — buck_nominal_load_a uncertainty or qualification; find in U1 datasheet or assembled loop measurement; U1 TPS54560B buck stage — buck_servo_lead_resistance_ohm uncertainty or qualification; find in U1 datasheet or assembled loop measurement; assembled gripper controller — c12_esr uncertainty or qualification; find in DESIGN-BASIS section 10 corresponding bench step; assembled gripper controller — c_wrist_esr uncertainty or qualification; find in DESIGN-BASIS section 10 corresponding bench step; finished servo harness — cable_l_per_m uncertainty or qualification; find in selected wire datasheet or finished-harness measurement; assembled gripper controller — cer_derate_6v6 uncertainty or qualification; find in DESIGN-BASIS section 10 corresponding bench step; assembled gripper controller — cer_esr uncertainty or qualification; find in DESIGN-BASIS section 10 corresponding bench step; 47 uF ceramics — effective capacitance at DC bias; find in manufacturer DC-bias curves; L1 SRP1245A-100M — inductance tolerance and bias derating; find in manufacturer datasheet curves; assembled gripper controller — mc_ridley uncertainty or qualification; find in DESIGN-BASIS section 10 corresponding bench step; RS1 WSLP1206R1000FEA — resistance over temperature; find in manufacturer datasheet and calibration step; wrist capacitor — capacitance after bias temperature and ageing; find in manufacturer datasheet
- `uvlo-range`: missing: U1 TPS54560BDDAR compensation network — small-signal plant/model error band; find in DESIGN-BASIS.md section 10 loop-response bench step; assembled gripper controller — adapter_min_v uncertainty or qualification; find in DESIGN-BASIS section 10 corresponding bench step; finished servo harness — awg20_ohm_m uncertainty or qualification; find in selected wire datasheet or finished-harness measurement; U1 TPS54560B buck stage — buck_bulk_scale_max uncertainty or qualification; find in U1 datasheet or assembled loop measurement; U1 TPS54560B buck stage — buck_bulk_scale_min uncertainty or qualification; find in U1 datasheet or assembled loop measurement; U1 TPS54560B buck stage — buck_nominal_input_v uncertainty or qualification; find in U1 datasheet or assembled loop measurement; U1 TPS54560B buck stage — buck_nominal_load_a uncertainty or qualification; find in U1 datasheet or assembled loop measurement; U1 TPS54560B buck stage — buck_servo_lead_resistance_ohm uncertainty or qualification; find in U1 datasheet or assembled loop measurement; assembled gripper controller — c12_esr uncertainty or qualification; find in DESIGN-BASIS section 10 corresponding bench step; assembled gripper controller — c_wrist_esr uncertainty or qualification; find in DESIGN-BASIS section 10 corresponding bench step; finished servo harness — cable_l_per_m uncertainty or qualification; find in selected wire datasheet or finished-harness measurement; assembled gripper controller — cer_derate_6v6 uncertainty or qualification; find in DESIGN-BASIS section 10 corresponding bench step; assembled gripper controller — cer_esr uncertainty or qualification; find in DESIGN-BASIS section 10 corresponding bench step; 47 uF ceramics — effective capacitance at DC bias; find in manufacturer DC-bias curves; L1 SRP1245A-100M — inductance tolerance and bias derating; find in manufacturer datasheet curves; assembled gripper controller — mc_ridley uncertainty or qualification; find in DESIGN-BASIS section 10 corresponding bench step; RS1 WSLP1206R1000FEA — resistance over temperature; find in manufacturer datasheet and calibration step; wrist capacitor — capacitance after bias temperature and ageing; find in manufacturer datasheet
- `regulator-headroom`: missing: PS1 12 V 3 A adapter — rated-current capability over temperature; find in adapter datasheet output-current table; assembled gripper controller — ams_dropout_max uncertainty or qualification; find in DESIGN-BASIS section 10 corresponding bench step; assembled gripper 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
- `limit-switch-low`: missing: J1/J2/J3 harness assembly — finished conductor resistance and contact-resistance range; find in DESIGN-BASIS.md section 10 harness milliohm bench step; finished servo harness — awg20_ohm_m uncertainty or qualification; find in selected wire datasheet or finished-harnes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
- `regen-energy-2mJ`: measure returned energy; missing: PS1 12 V 3 A adapter — rated-current capability over temperature; find in adapter datasheet output-current table; assembled gripper controller — ams_dropout_max uncertainty or qualification; find in DESIGN-BASIS section 10 corresponding bench s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
- `regen-energy-5mJ`: measure returned energy; missing: PS1 12 V 3 A adapter — rated-current capability over temperature; find in adapter datasheet output-current table; assembled gripper controller — ams_dropout_max uncertainty or qualification; find in DESIGN-BASIS section 10 corresponding bench s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
- `regen-energy-20mJ`: measure returned energy; missing: PS1 12 V 3 A adapter — rated-current capability over temperature; find in adapter datasheet output-current table; assembled gripper controller — ams_dropout_max uncertainty or qualification; find in DESIGN-BASIS section 10 corresponding bench 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
- `regen-energy-50mJ`: measure returned energy; missing: PS1 12 V 3 A adapter — rated-current capability over temperature; find in adapter datasheet output-current table; assembled gripper controller — ams_dropout_max uncertainty or qualification; find in DESIGN-BASIS section 10 corresponding bench 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
- `regen-energy-174mJ`: measure returned energy; missing: PS1 12 V 3 A adapter — rated-current capability over temperature; find in adapter datasheet output-current table; assembled gripper controller — ams_dropout_max uncertainty or qualification; find in DESIGN-BASIS section 10 corresponding bench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
- `fault-limit-servo`: protect J4 pin 3; resolve: D5, R17, R18, controller pin, +3V3 rail; missing: repository has no continuous-current or clamp-power quote; repository has no continuous-power quote; repository has no continuous-power quote; repository has no controller injection-current quote; repository has no 3.3 V rail sink-current quote

### Missing figures by part

- **47 uF ceramics:** effective capacitance at DC bias — manufacturer DC-bias curves; datasheet lookup; blocks adapter-current, buck-current-limit, buck-thermal, droop-servo-min, input-fuse-hold, input-fuse-trip, loop-gain, loop-phase, regen-energy-174mJ, regen-energy-20mJ, regen-energy-2mJ, regen-energy-50mJ, regen-energy-5mJ, regulator-headroom, servo-voltage-max, shunt-power, uvlo-range
- **C12 1000 uF:** capacitance and ESR after bias, temperature, and ageing — DESIGN-BASIS.md section 10 load-step bench step; datasheet lookup; blocks droop-servo-min
- **C17 100 nF:** capacitance tolerance — C17 manufacturer datasheet capacitance-tolerance table; datasheet lookup; blocks adc-charge, filter-delay
- **ESP32 DevKitC V4 assembly:** esp_adc_cs_pf uncertainty or qualification — module and board documentation or rail measurement; datasheet lookup or bench measurement; blocks adc-charge, filter-delay, fsr-node-high
- **ESP32 DevKitC V4 assembly:** esp_adc_resolution_bits uncertainty or qualification — module and board documentation or rail measurement; datasheet lookup or bench measurement; blocks adc-charge, filter-delay, force-reading-error, fsr-node-high, limit-switch-low, plug-band-high, plug-band-low
- **ESP32 DevKitC V4 assembly:** esp_adc_rsw_ohm uncertainty or qualification — module and board documentation or rail measurement; datasheet lookup or bench measurement; blocks adc-charge, filter-delay, fsr-node-high
- **ESP32 DevKitC V4 assembly:** esp_bod_default uncertainty or qualification — module and board documentation or rail measurement; datasheet lookup or bench measurement; blocks adapter-current, buck-thermal, input-fuse-hold, input-fuse-trip, regen-energy-174mJ, regen-energy-20mJ, regen-energy-2mJ, regen-energy-50mJ, regen-energy-5mJ, regulator-headroom, shunt-power
- **ESP32 DevKitC V4 assembly:** esp_vdd_min_flash uncertainty or qualification — module and board documentation or rail measurement; datasheet lookup or bench measurement; blocks adapter-current, buck-thermal, input-fuse-hold, input-fuse-trip, regen-energy-174mJ, regen-energy-20mJ, regen-energy-2mJ, regen-energy-50mJ, regen-energy-5mJ, regulator-headroom, shunt-power
- **ESP32 DevKitC V4 assembly:** power_3v3_rail_v uncertainty or qualification — module and board documentation or rail measurement; datasheet lookup or bench measurement; blocks adapter-current, buck-thermal, input-fuse-hold, input-fuse-trip, regen-energy-174mJ, regen-energy-20mJ, regen-energy-2mJ, regen-energy-50mJ, regen-energy-5mJ, regulator-headroom, shunt-power
- **F1 MF-MSMF260/16X:** hold-current tolerance at 25 C — datasheet electrical characteristics table; datasheet lookup; blocks input-fuse-hold
- **F1 MF-MSMF260/16X:** trip-current tolerance at 25 C — datasheet electrical characteristics table; datasheet lookup; blocks input-fuse-trip
- **F1 RUILON SMD1812P260TF/16:** f1_hold uncertainty or qualification — RUILON electrical-characteristics datasheet; datasheet lookup or bench measurement; blocks adapter-current, buck-thermal, input-fuse-hold, input-fuse-trip, regen-energy-174mJ, regen-energy-20mJ, regen-energy-2mJ, regen-energy-50mJ, regen-energy-5mJ, regulator-headroom, shunt-power
- **F1 RUILON SMD1812P260TF/16:** f1_r1max uncertainty or qualification — RUILON electrical-characteristics datasheet; datasheet lookup or bench measurement; blocks adapter-current, buck-thermal, input-fuse-hold, input-fuse-trip, regen-energy-174mJ, regen-energy-20mJ, regen-energy-2mJ, regen-energy-50mJ, regen-energy-5mJ, regulator-headroom, shunt-power
- **F1 RUILON SMD1812P260TF/16:** f1_trip uncertainty or qualification — RUILON electrical-characteristics datasheet; datasheet lookup or bench measurement; blocks input-fuse-trip
- **FSR sensor:** fit exponent confidence interval — DESIGN-BASIS.md section 10 force sweep; bench measurement; blocks adapter-current, adc-charge, buck-thermal, filter-delay, force-reading-error, fsr-node-high, input-fuse-hold, input-fuse-trip, limit-switch-low, plug-band-high, plug-band-low, regen-energy-174mJ, regen-energy-20mJ, regen-energy-2mJ, regen-energy-50mJ, regen-energy-5mJ, regulator-headroom, shunt-power
- **FSR sensor and analog front end:** fsr_adc_droop_limit_mv uncertainty or qualification — manufacturer curve or DESIGN-BASIS section 10 force/ADC sweep; datasheet lookup or bench measurement; blocks adc-charge
- **FSR sensor and analog front end:** fsr_e96_search_hi_ohm uncertainty or qualification — manufacturer curve or DESIGN-BASIS section 10 force/ADC sweep; datasheet lookup or bench measurement; blocks adc-charge, filter-delay, fsr-node-high
- **FSR sensor and analog front end:** fsr_e96_search_lo_ohm uncertainty or qualification — manufacturer curve or DESIGN-BASIS section 10 force/ADC sweep; datasheet lookup or bench measurement; blocks adc-charge, filter-delay, fsr-node-high
- **FSR sensor and analog front end:** fsr_filter_gain_freqs_hz uncertainty or qualification — manufacturer curve or DESIGN-BASIS section 10 force/ADC sweep; datasheet lookup or bench measurement; blocks adc-charge, filter-delay, fsr-node-high
- **FSR sensor and analog front end:** fsr_resolution_force_n uncertainty or qualification — manufacturer curve or DESIGN-BASIS section 10 force/ADC sweep; datasheet lookup or bench measurement; blocks adc-charge, filter-delay, fsr-node-high
- **FSR sensor and analog front end:** fsr_sample_rate_hz uncertainty or qualification — manufacturer curve or DESIGN-BASIS section 10 force/ADC sweep; datasheet lookup or bench measurement; blocks adc-charge, filter-delay, fsr-node-high
- **FSR sensor and analog front end:** fsr_table_forces_n uncertainty or qualification — manufacturer curve or DESIGN-BASIS section 10 force/ADC sweep; datasheet lookup or bench measurement; blocks adc-charge, filter-delay, fsr-node-high
- **FSR sensor and analog front end:** fsr_unloaded_force_n uncertainty or qualification — manufacturer curve or DESIGN-BASIS section 10 force/ADC sweep; datasheet lookup or bench measurement; blocks adc-charge, filter-delay, fsr-node-high
- **J1/J2/J3 harness assembly:** finished conductor resistance and contact-resistance range — DESIGN-BASIS.md section 10 harness milliohm bench step; datasheet lookup; blocks force-reading-error, limit-switch-low, plug-band-high, plug-band-low
- **L1 SRP1245A-100M:** inductance tolerance and bias derating — manufacturer datasheet curves; datasheet lookup; blocks adapter-current, buck-current-limit, buck-thermal, droop-servo-min, input-fuse-hold, input-fuse-trip, loop-gain, loop-phase, regen-energy-174mJ, regen-energy-20mJ, regen-energy-2mJ, regen-energy-50mJ, regen-energy-5mJ, regulator-headroom, servo-voltage-max, shunt-power, uvlo-range
- **PCB copper:** finished copper thickness tolerance — PCB fabricator stack-up certificate; datasheet lookup; blocks trace-current, trace-drop, trace-neck-current, trace-temperature
- **PS1 12 V 3 A adapter:** rated-current capability over temperature — adapter datasheet output-current table; datasheet lookup; blocks adapter-current, regen-energy-174mJ, regen-energy-20mJ, regen-energy-2mJ, regen-energy-50mJ, regen-energy-5mJ, regulator-headroom
- **Q1 MSKSEMI AO4407A:** q1_rds uncertainty or qualification — MSKSEMI electrical-characteristics datasheet; datasheet lookup or bench measurement; blocks adapter-current, buck-thermal, input-fuse-hold, input-fuse-trip, regen-energy-174mJ, regen-energy-20mJ, regen-energy-2mJ, regen-energy-50mJ, regen-energy-5mJ, regulator-headroom, shunt-power
- **RS1 WSLP1206R1000FEA:** resistance over temperature — manufacturer datasheet and calibration step; datasheet lookup; blocks adapter-current, buck-current-limit, buck-thermal, current-error, detection-time, droop-servo-min, firmware-trip-10N, firmware-trip-8N, input-fuse-hold, input-fuse-trip, loop-gain, loop-phase, regen-energy-174mJ, regen-energy-20mJ, regen-energy-2mJ, regen-energy-50mJ, regen-energy-5mJ, regulator-headroom, sense-range, servo-voltage-max, shunt-power, uvlo-range
- **U1 TPS54560B buck stage:** buck_bulk_scale_max uncertainty or qualification — U1 datasheet or assembled loop measurement; datasheet lookup or bench measurement; blocks loop-gain, loop-phase, servo-voltage-max, uvlo-range
- **U1 TPS54560B buck stage:** buck_bulk_scale_min uncertainty or qualification — U1 datasheet or assembled loop measurement; datasheet lookup or bench measurement; blocks loop-gain, loop-phase, servo-voltage-max, uvlo-range
- **U1 TPS54560B buck stage:** buck_junction_rise_limit_c uncertainty or qualification — U1 datasheet or assembled loop measurement; datasheet lookup or bench measurement; blocks buck-thermal
- **U1 TPS54560B buck stage:** buck_nominal_input_v uncertainty or qualification — U1 datasheet or assembled loop measurement; datasheet lookup or bench measurement; blocks adapter-current, buck-thermal, input-fuse-hold, input-fuse-trip, loop-gain, loop-phase, regen-energy-174mJ, regen-energy-20mJ, regen-energy-2mJ, regen-energy-50mJ, regen-energy-5mJ, regulator-headroom, servo-voltage-max, shunt-power, uvlo-range
- **U1 TPS54560B buck stage:** buck_nominal_load_a uncertainty or qualification — U1 datasheet or assembled loop measurement; datasheet lookup or bench measurement; blocks loop-gain, loop-phase, servo-voltage-max, uvlo-range
- **U1 TPS54560B buck stage:** buck_servo_lead_resistance_ohm uncertainty or qualification — U1 datasheet or assembled loop measurement; datasheet lookup or bench measurement; blocks adapter-current, buck-thermal, force-reading-error, input-fuse-hold, input-fuse-trip, limit-switch-low, loop-gain, loop-phase, plug-band-high, plug-band-low, regen-energy-174mJ, regen-energy-20mJ, regen-energy-2mJ, regen-energy-50mJ, regen-energy-5mJ, regulator-headroom, servo-voltage-max, shunt-power, uvlo-range
- **U1 TPS54560BDDAR:** current-limit test-condition variation — datasheet electrical characteristics table; datasheet lookup; blocks buck-current-limit
- **U1 TPS54560BDDAR:** junction-to-ambient thermal resistance for the assembled PCB — DESIGN-BASIS.md section 10 thermal-rise bench step; datasheet lookup; blocks buck-thermal
- **U1 TPS54560BDDAR compensation network:** small-signal plant/model error band — DESIGN-BASIS.md section 10 loop-response bench step; datasheet lookup; blocks loop-gain, loop-phase, uvlo-range
- **U2 INA219AIDR:** input-filter source-impedance mismatch — DESIGN-BASIS.md section 10 current-calibration bench step; datasheet lookup; blocks current-error, detection-time, sense-range
- **U2 INA219AIDR current-sense stage:** ina_average_fit_limit_s uncertainty or qualification — U2 datasheet or current-calibration measurement; datasheet lookup or bench measurement; blocks current-error, detection-time, firmware-trip-10N, firmware-trip-8N, sense-range
- **U2 INA219AIDR current-sense stage:** ina_chop_duty uncertainty or qualification — U2 datasheet or current-calibration measurement; datasheet lookup or bench measurement; blocks current-error, detection-time, firmware-trip-10N, firmware-trip-8N, sense-range
- **U2 INA219AIDR current-sense stage:** ina_chop_frequencies_hz uncertainty or qualification — U2 datasheet or current-calibration measurement; datasheet lookup or bench measurement; blocks current-error, detection-time, firmware-trip-10N, firmware-trip-8N, sense-range
- **U2 INA219AIDR current-sense stage:** ina_current_error_limit_a uncertainty or qualification — U2 datasheet or current-calibration measurement; datasheet lookup or bench measurement; blocks current-error
- **U2 INA219AIDR current-sense stage:** ina_force_caps_n uncertainty or qualification — U2 datasheet or current-calibration measurement; datasheet lookup or bench measurement; blocks adc-charge, current-error, detection-time, filter-delay, firmware-trip-10N, firmware-trip-8N, fsr-node-high, sense-range
- **U2 INA219AIDR current-sense stage:** ina_gain_temperature_span_c uncertainty or qualification — U2 datasheet or current-calibration measurement; datasheet lookup or bench measurement; blocks current-error, detection-time, firmware-trip-10N, firmware-trip-8N, sense-range
- **U2 INA219AIDR current-sense stage:** ina_saturation_error_fraction uncertainty or qualification — U2 datasheet or current-calibration measurement; datasheet lookup or bench measurement; blocks current-error, detection-time, firmware-trip-10N, firmware-trip-8N, sense-range
- **U2 INA219AIDR current-sense stage:** ina_shunt_temperature_rise_c uncertainty or qualification — U2 datasheet or current-calibration measurement; datasheet lookup or bench measurement; blocks current-error, detection-time, firmware-trip-10N, firmware-trip-8N, sense-range
- **U3 ESP32-WROOM-32E:** ADC linear-range endpoint variation — DESIGN-BASIS.md section 10 ADC sweep bench step; datasheet lookup; blocks fsr-node-high
- **U4 MCP1703AT-5002E/DB:** mcp_rth_sot223 uncertainty or qualification — Microchip datasheet and assembled-board thermal measurement; datasheet lookup or bench measurement; blocks adapter-current, buck-thermal, input-fuse-hold, input-fuse-trip, regen-energy-174mJ, regen-energy-20mJ, regen-energy-2mJ, regen-energy-50mJ, regen-energy-5mJ, regulator-headroom, shunt-power
- **U4 MCP1703AT-5002E/DB:** mcp_vout_tol uncertainty or qualification — Microchip datasheet and assembled-board thermal measurement; datasheet lookup or bench measurement; blocks adapter-current, buck-thermal, input-fuse-hold, input-fuse-trip, regen-energy-174mJ, regen-energy-20mJ, regen-energy-2mJ, regen-energy-50mJ, regen-energy-5mJ, regulator-headroom, shunt-power
- **assembled gripper controller:** adapter_current_a uncertainty or qualification — DESIGN-BASIS section 10 corresponding bench step; datasheet lookup or bench measurement; blocks adapter-current
- **assembled gripper controller:** adapter_min_v uncertainty or qualification — DESIGN-BASIS section 10 corresponding bench step; datasheet lookup or bench measurement; blocks uvlo-range
- **assembled gripper controller:** ams_dropout_max uncertainty or qualification — DESIGN-BASIS section 10 corresponding bench step; datasheet lookup or bench measurement; blocks adapter-current, buck-thermal, input-fuse-hold, input-fuse-trip, regen-energy-174mJ, regen-energy-20mJ, regen-energy-2mJ, regen-energy-50mJ, regen-energy-5mJ, regulator-headroom, shunt-power
- **assembled gripper controller:** ams_vout_tol uncertainty or qualification — DESIGN-BASIS section 10 corresponding bench step; datasheet lookup or bench measurement; blocks adapter-current, buck-thermal, input-fuse-hold, input-fuse-trip, regen-energy-174mJ, regen-energy-20mJ, regen-energy-2mJ, regen-energy-50mJ, regen-energy-5mJ, regulator-headroom, shunt-power
- **assembled gripper controller:** c12_esr uncertainty or qualification — DESIGN-BASIS section 10 corresponding bench step; datasheet lookup or bench measurement; blocks adapter-current, buck-current-limit, buck-thermal, droop-servo-min, input-fuse-hold, input-fuse-trip, loop-gain, loop-phase, regen-energy-174mJ, regen-energy-20mJ, regen-energy-2mJ, regen-energy-50mJ, regen-energy-5mJ, regulator-headroom, servo-voltage-max, shunt-power, uvlo-range
- **assembled gripper controller:** c_wrist_esr uncertainty or qualification — DESIGN-BASIS section 10 corresponding bench step; datasheet lookup or bench measurement; blocks adapter-current, buck-current-limit, buck-thermal, droop-servo-min, input-fuse-hold, input-fuse-trip, loop-gain, loop-phase, regen-energy-174mJ, regen-energy-20mJ, regen-energy-2mJ, regen-energy-50mJ, regen-energy-5mJ, regulator-headroom, servo-voltage-max, shunt-power, uvlo-range
- **assembled gripper controller:** cer_derate_6v6 uncertainty or qualification — DESIGN-BASIS section 10 corresponding bench step; datasheet lookup or bench measurement; blocks adapter-current, buck-current-limit, buck-thermal, droop-servo-min, input-fuse-hold, input-fuse-trip, loop-gain, loop-phase, regen-energy-174mJ, regen-energy-20mJ, regen-energy-2mJ, regen-energy-50mJ, regen-energy-5mJ, regulator-headroom, servo-voltage-max, shunt-power, uvlo-range
- **assembled gripper controller:** cer_esr uncertainty or qualification — DESIGN-BASIS section 10 corresponding bench step; datasheet lookup or bench measurement; blocks loop-gain, loop-phase, servo-voltage-max, uvlo-range
- **assembled gripper controller:** ctrl_lag_budget_s uncertainty or qualification — DESIGN-BASIS section 10 corresponding bench step; datasheet lookup or bench measurement; blocks adc-charge, filter-delay, fsr-node-high
- **assembled gripper controller:** d2_vf uncertainty or qualification — DESIGN-BASIS section 10 corresponding bench step; datasheet lookup or bench measurement; blocks adapter-current, buck-thermal, input-fuse-hold, input-fuse-trip, regen-energy-174mJ, regen-energy-20mJ, regen-energy-2mJ, regen-energy-50mJ, regen-energy-5mJ, regulator-headroom, shunt-power
- **assembled gripper controller:** d7_vf_100ma uncertainty or qualification — DESIGN-BASIS section 10 corresponding bench step; datasheet lookup or bench measurement; blocks adapter-current, buck-thermal, input-fuse-hold, input-fuse-trip, regen-energy-174mJ, regen-energy-20mJ, regen-energy-2mJ, regen-energy-50mJ, regen-energy-5mJ, regulator-headroom, shunt-power
- **assembled gripper controller:** d7_vf_slope uncertainty or qualification — DESIGN-BASIS section 10 corresponding bench step; datasheet lookup or bench measurement; blocks adapter-current, buck-thermal, input-fuse-hold, input-fuse-trip, regen-energy-174mJ, regen-energy-20mJ, regen-energy-2mJ, regen-energy-50mJ, regen-energy-5mJ, regulator-headroom, shunt-power
- **assembled gripper controller:** devkit_diode_drop uncertainty or qualification — DESIGN-BASIS section 10 corresponding bench step; datasheet lookup or bench measurement; blocks adapter-current, buck-thermal, input-fuse-hold, input-fuse-trip, regen-energy-174mJ, regen-energy-20mJ, regen-energy-2mJ, regen-energy-50mJ, regen-energy-5mJ, regulator-headroom, shunt-power
- **assembled gripper controller:** devkit_overhead_a uncertainty or qualification — DESIGN-BASIS section 10 corresponding bench step; datasheet lookup or bench measurement; blocks adapter-current, buck-current-limit, buck-thermal, droop-servo-min, input-fuse-hold, input-fuse-trip, regen-energy-174mJ, regen-energy-20mJ, regen-energy-2mJ, regen-energy-50mJ, regen-energy-5mJ, regulator-headroom, shunt-power
- **assembled gripper controller:** droop_5v_load_a uncertainty or qualification — DESIGN-BASIS section 10 corresponding bench step; datasheet lookup or bench measurement; blocks adapter-current, buck-current-limit, buck-thermal, droop-servo-min, input-fuse-hold, input-fuse-trip, regen-energy-174mJ, regen-energy-20mJ, regen-energy-2mJ, regen-energy-50mJ, regen-energy-5mJ, regulator-headroom, shunt-power
- **assembled gripper controller:** droop_comp_zero_v uncertainty or qualification — DESIGN-BASIS section 10 corresponding bench step; datasheet lookup or bench measurement; blocks adapter-current, buck-current-limit, buck-thermal, droop-servo-min, input-fuse-hold, input-fuse-trip, regen-energy-174mJ, regen-energy-20mJ, regen-energy-2mJ, regen-energy-50mJ, regen-energy-5mJ, regulator-headroom, shunt-power
- **assembled gripper controller:** droop_default_rise_s uncertainty or qualification — DESIGN-BASIS section 10 corresponding bench step; datasheet lookup or bench measurement; blocks adapter-current, buck-current-limit, buck-thermal, droop-servo-min, input-fuse-hold, input-fuse-trip, regen-energy-174mJ, regen-energy-20mJ, regen-energy-2mJ, regen-energy-50mJ, regen-energy-5mJ, regulator-headroom, shunt-power
- **assembled gripper controller:** droop_default_vin_v uncertainty or qualification — DESIGN-BASIS section 10 corresponding bench step; datasheet lookup or bench measurement; blocks adapter-current, buck-current-limit, buck-thermal, droop-servo-min, input-fuse-hold, input-fuse-trip, regen-energy-174mJ, regen-energy-20mJ, regen-energy-2mJ, regen-energy-50mJ, regen-energy-5mJ, regulator-headroom, shunt-power
- **assembled gripper controller:** droop_diode_v uncertainty or qualification — DESIGN-BASIS section 10 corresponding bench step; datasheet lookup or bench measurement; blocks adapter-current, buck-current-limit, buck-thermal, droop-servo-min, input-fuse-hold, input-fuse-trip, regen-energy-174mJ, regen-energy-20mJ, regen-energy-2mJ, regen-energy-50mJ, regen-energy-5mJ, regulator-headroom, shunt-power
- **assembled gripper controller:** droop_end_time_s uncertainty or qualification — DESIGN-BASIS section 10 corresponding bench step; datasheet lookup or bench measurement; blocks adapter-current, buck-current-limit, buck-thermal, droop-servo-min, input-fuse-hold, input-fuse-trip, regen-energy-174mJ, regen-energy-20mJ, regen-energy-2mJ, regen-energy-50mJ, regen-energy-5mJ, regulator-headroom, shunt-power
- **assembled gripper controller:** droop_fsw_hz uncertainty or qualification — DESIGN-BASIS section 10 corresponding bench step; datasheet lookup or bench measurement; blocks adapter-current, buck-current-limit, buck-thermal, droop-servo-min, input-fuse-hold, input-fuse-trip, regen-energy-174mJ, regen-energy-20mJ, regen-energy-2mJ, regen-energy-50mJ, regen-energy-5mJ, regulator-headroom, shunt-power
- **assembled gripper controller:** droop_recovery_band_v uncertainty or qualification — DESIGN-BASIS section 10 corresponding bench step; datasheet lookup or bench measurement; blocks adapter-current, buck-current-limit, buck-thermal, droop-servo-min, input-fuse-hold, input-fuse-trip, regen-energy-174mJ, regen-energy-20mJ, regen-energy-2mJ, regen-energy-50mJ, regen-energy-5mJ, regulator-headroom, shunt-power
- **assembled gripper controller:** droop_servo_idle_a uncertainty or qualification — DESIGN-BASIS section 10 corresponding bench step; datasheet lookup or bench measurement; blocks adapter-current, buck-current-limit, buck-thermal, droop-servo-min, input-fuse-hold, input-fuse-trip, regen-energy-174mJ, regen-energy-20mJ, regen-energy-2mJ, regen-energy-50mJ, regen-energy-5mJ, regulator-headroom, shunt-power
- **assembled gripper controller:** droop_step_time_s uncertainty or qualification — DESIGN-BASIS section 10 corresponding bench step; datasheet lookup or bench measurement; blocks adapter-current, buck-current-limit, buck-thermal, droop-servo-min, input-fuse-hold, input-fuse-trip, regen-energy-174mJ, regen-energy-20mJ, regen-energy-2mJ, regen-energy-50mJ, regen-energy-5mJ, regulator-headroom, shunt-power
- **assembled gripper controller:** droop_voltage_floor_v uncertainty or qualification — DESIGN-BASIS section 10 corresponding bench step; datasheet lookup or bench measurement; blocks adapter-current, buck-current-limit, buck-thermal, droop-servo-min, input-fuse-hold, input-fuse-trip, regen-energy-174mJ, regen-energy-20mJ, regen-energy-2mJ, regen-energy-50mJ, regen-energy-5mJ, regulator-headroom, shunt-power
- **assembled gripper controller:** ema_alpha uncertainty or qualification — DESIGN-BASIS section 10 corresponding bench step; datasheet lookup or bench measurement; blocks adc-charge, filter-delay, fsr-node-high
- **assembled gripper controller:** ibus_5v_idle uncertainty or qualification — DESIGN-BASIS section 10 corresponding bench step; datasheet lookup or bench measurement; blocks adapter-current, buck-current-limit, buck-thermal, droop-servo-min, input-fuse-hold, input-fuse-trip, regen-energy-174mJ, regen-energy-20mJ, regen-energy-2mJ, regen-energy-50mJ, regen-energy-5mJ, regulator-headroom, shunt-power
- **assembled gripper controller:** l1_dcr uncertainty or qualification — DESIGN-BASIS section 10 corresponding bench step; datasheet lookup or bench measurement; blocks adapter-current, buck-thermal, input-fuse-hold, input-fuse-trip, regen-energy-174mJ, regen-energy-20mJ, regen-energy-2mJ, regen-energy-50mJ, regen-energy-5mJ, regulator-headroom, shunt-power
- **assembled gripper controller:** mc_ridley uncertainty or qualification — DESIGN-BASIS section 10 corresponding bench step; datasheet lookup or bench measurement; blocks loop-gain, loop-phase, servo-voltage-max, uvlo-range
- **assembled gripper controller:** power_board_plane_resistance_ohm uncertainty or qualification — DESIGN-BASIS section 10 corresponding bench step; datasheet lookup or bench measurement; blocks adapter-current, buck-thermal, input-fuse-hold, input-fuse-trip, regen-energy-174mJ, regen-energy-20mJ, regen-energy-2mJ, regen-energy-50mJ, regen-energy-5mJ, regulator-headroom, shunt-power
- **assembled gripper controller:** power_diode_reference_current_a uncertainty or qualification — DESIGN-BASIS section 10 corresponding bench step; datasheet lookup or bench measurement; blocks adapter-current, buck-thermal, input-fuse-hold, input-fuse-trip, regen-energy-174mJ, regen-energy-20mJ, regen-energy-2mJ, regen-energy-50mJ, regen-energy-5mJ, regulator-headroom, shunt-power
- **assembled gripper controller:** power_external_3v3_load_a uncertainty or qualification — DESIGN-BASIS section 10 corresponding bench step; datasheet lookup or bench measurement; blocks adapter-current, buck-current-limit, buck-thermal, droop-servo-min, input-fuse-hold, input-fuse-trip, regen-energy-174mJ, regen-energy-20mJ, regen-energy-2mJ, regen-energy-50mJ, regen-energy-5mJ, regulator-headroom, shunt-power
- **assembled gripper controller:** power_fit_a_stall_current_a uncertainty or qualification — DESIGN-BASIS section 10 corresponding bench step; datasheet lookup or bench measurement; blocks adapter-current, buck-thermal, input-fuse-hold, input-fuse-trip, regen-energy-174mJ, regen-energy-20mJ, regen-energy-2mJ, regen-energy-50mJ, regen-energy-5mJ, regulator-headroom, shunt-power
- **assembled gripper controller:** power_five_volt_rail_v uncertainty or qualification — DESIGN-BASIS section 10 corresponding bench step; datasheet lookup or bench measurement; blocks adapter-current, buck-current-limit, buck-thermal, droop-servo-min, input-fuse-hold, input-fuse-trip, regen-energy-174mJ, regen-energy-20mJ, regen-energy-2mJ, regen-energy-50mJ, regen-energy-5mJ, regulator-headroom, shunt-power
- **assembled gripper controller:** power_fsr_return_current_a uncertainty or qualification — DESIGN-BASIS section 10 corresponding bench step; datasheet lookup or bench measurement; blocks adapter-current, buck-thermal, input-fuse-hold, input-fuse-trip, regen-energy-174mJ, regen-energy-20mJ, regen-energy-2mJ, regen-energy-50mJ, regen-energy-5mJ, regulator-headroom, shunt-power
- **assembled gripper controller:** power_ldo_dropout_scale_cap uncertainty or qualification — DESIGN-BASIS section 10 corresponding bench step; datasheet lookup or bench measurement; blocks adapter-current, buck-current-limit, buck-thermal, droop-servo-min, input-fuse-hold, input-fuse-trip, regen-energy-174mJ, regen-energy-20mJ, regen-energy-2mJ, regen-energy-50mJ, regen-energy-5mJ, regulator-headroom, shunt-power
- **assembled gripper controller:** power_ldo_full_load_dropout_ratio uncertainty or qualification — DESIGN-BASIS section 10 corresponding bench step; datasheet lookup or bench measurement; blocks adapter-current, buck-thermal, input-fuse-hold, input-fuse-trip, regen-energy-174mJ, regen-energy-20mJ, regen-energy-2mJ, regen-energy-50mJ, regen-energy-5mJ, regulator-headroom, shunt-power
- **assembled gripper controller:** power_ldo_light_load_a uncertainty or qualification — DESIGN-BASIS section 10 corresponding bench step; datasheet lookup or bench measurement; blocks adapter-current, buck-thermal, input-fuse-hold, input-fuse-trip, regen-energy-174mJ, regen-energy-20mJ, regen-energy-2mJ, regen-energy-50mJ, regen-energy-5mJ, regulator-headroom, shunt-power
- **assembled gripper controller:** power_ldo_load_span_a uncertainty or qualification — DESIGN-BASIS section 10 corresponding bench step; datasheet lookup or bench measurement; blocks adapter-current, buck-thermal, input-fuse-hold, input-fuse-trip, regen-energy-174mJ, regen-energy-20mJ, regen-energy-2mJ, regen-energy-50mJ, regen-energy-5mJ, regulator-headroom, shunt-power
- **assembled gripper controller:** power_log_current_floor_a uncertainty or qualification — DESIGN-BASIS section 10 corresponding bench step; datasheet lookup or bench measurement; blocks adapter-current, buck-thermal, input-fuse-hold, input-fuse-trip, regen-energy-174mJ, regen-energy-20mJ, regen-energy-2mJ, regen-energy-50mJ, regen-energy-5mJ, regulator-headroom, shunt-power
- **assembled gripper controller:** power_rating_margin_factor uncertainty or qualification — DESIGN-BASIS section 10 corresponding bench step; datasheet lookup or bench measurement; blocks adapter-current, buck-thermal, input-fuse-hold, input-fuse-trip, regen-energy-174mJ, regen-energy-20mJ, regen-energy-2mJ, regen-energy-50mJ, regen-energy-5mJ, regulator-headroom, shunt-power
- **assembled gripper controller:** power_regen_basis_mj uncertainty or qualification — DESIGN-BASIS section 10 corresponding bench step; datasheet lookup or bench measurement; blocks adapter-current, buck-thermal, input-fuse-hold, input-fuse-trip, regen-energy-174mJ, regen-energy-20mJ, regen-energy-2mJ, regen-energy-50mJ, regen-energy-5mJ, regulator-headroom, shunt-power
- **assembled gripper controller:** power_regen_rotor_mj uncertainty or qualification — DESIGN-BASIS section 10 corresponding bench step; datasheet lookup or bench measurement; blocks adapter-current, buck-thermal, input-fuse-hold, input-fuse-trip, regen-energy-174mJ, regen-energy-20mJ, regen-energy-2mJ, regen-energy-50mJ, regen-energy-5mJ, regulator-headroom, shunt-power
- **assembled gripper controller:** power_starting_efficiency uncertainty or qualification — DESIGN-BASIS section 10 corresponding bench step; datasheet lookup or bench measurement; blocks adapter-current, buck-thermal, input-fuse-hold, input-fuse-trip, regen-energy-174mJ, regen-energy-20mJ, regen-energy-2mJ, regen-energy-50mJ, regen-energy-5mJ, regulator-headroom, shunt-power
- **assembled gripper controller:** power_switch_transition_time_s uncertainty or qualification — DESIGN-BASIS section 10 corresponding bench step; datasheet lookup or bench measurement; blocks adapter-current, buck-thermal, input-fuse-hold, input-fuse-trip, regen-energy-174mJ, regen-energy-20mJ, regen-energy-2mJ, regen-energy-50mJ, regen-energy-5mJ, regulator-headroom, shunt-power
- **assembled gripper controller:** rs1_tcr uncertainty or qualification — DESIGN-BASIS section 10 corresponding bench step; datasheet lookup or bench measurement; blocks current-error, detection-time, firmware-trip-10N, firmware-trip-8N, sense-range
- **assembled gripper controller:** rs1_tol uncertainty or qualification — DESIGN-BASIS section 10 corresponding bench step; datasheet lookup or bench measurement; blocks current-error, detection-time, firmware-trip-10N, firmware-trip-8N, sense-range, shunt-power
- **assembled gripper controller:** wire_gauges_awg uncertainty or qualification — DESIGN-BASIS section 10 corresponding bench step; datasheet lookup or bench measurement; blocks adapter-current, buck-thermal, input-fuse-hold, input-fuse-trip, regen-energy-174mJ, regen-energy-20mJ, regen-energy-2mJ, regen-energy-50mJ, regen-energy-5mJ, regulator-headroom, shunt-power
- **fabricated PCB copper:** cu_rho uncertainty or qualification — fabricator stack-up or finished-trace measurement; datasheet lookup or bench measurement; blocks trace-current, trace-drop, trace-neck-current, trace-temperature
- **fabricated PCB copper:** cu_tc uncertainty or qualification — fabricator stack-up or finished-trace measurement; datasheet lookup or bench measurement; blocks trace-current, trace-drop, trace-neck-current, trace-temperature
- **fabricated PCB copper:** ipc_b uncertainty or qualification — fabricator stack-up or finished-trace measurement; datasheet lookup or bench measurement; blocks trace-current, trace-drop, trace-neck-current, trace-temperature
- **fabricated PCB copper:** ipc_c uncertainty or qualification — fabricator stack-up or finished-trace measurement; datasheet lookup or bench measurement; blocks trace-current, trace-drop, trace-neck-current, trace-temperature
- **fabricated PCB copper:** ipc_k_ext uncertainty or qualification — fabricator stack-up or finished-trace measurement; datasheet lookup or bench measurement; blocks trace-current, trace-drop, trace-neck-current, trace-temperature
- **fabricated PCB copper:** ipc_mil_per_oz uncertainty or qualification — fabricator stack-up or finished-trace measurement; datasheet lookup or bench measurement; blocks trace-current, trace-drop, trace-neck-current, trace-temperature
- **fabricated PCB copper:** trace_ambient_temperature_c uncertainty or qualification — fabricator stack-up or finished-trace measurement; datasheet lookup or bench measurement; blocks trace-current, trace-drop, trace-neck-current, trace-temperature
- **fabricated PCB copper:** trace_auxiliary_current_a uncertainty or qualification — fabricator stack-up or finished-trace measurement; datasheet lookup or bench measurement; blocks trace-current, trace-drop, trace-neck-current, trace-temperature
- **fabricated PCB copper:** trace_hold_current_a uncertainty or qualification — fabricator stack-up or finished-trace measurement; datasheet lookup or bench measurement; blocks trace-current, trace-drop, trace-neck-current, trace-temperature
- **fabricated PCB copper:** trace_reference_length_mm uncertainty or qualification — fabricator stack-up or finished-trace measurement; datasheet lookup or bench measurement; blocks trace-current, trace-drop, trace-neck-current, trace-temperature
- **fabricated PCB copper:** trace_reference_temperature_c uncertainty or qualification — fabricator stack-up or finished-trace measurement; datasheet lookup or bench measurement; blocks trace-current, trace-drop, trace-neck-current, trace-temperature
- **fabricated PCB copper:** trace_servo_drop_limit_mv uncertainty or qualification — fabricator stack-up or finished-trace measurement; datasheet lookup or bench measurement; blocks trace-drop
- **fabricated PCB copper:** trace_supply_current_a uncertainty or qualification — fabricator stack-up or finished-trace measurement; datasheet lookup or bench measurement; blocks trace-current, trace-drop, trace-neck-current, trace-temperature
- **fabricated PCB copper:** trace_temp_rise_limit_c uncertainty or qualification — fabricator stack-up or finished-trace measurement; datasheet lookup or bench measurement; blocks trace-temperature
- **fabricated PCB copper:** trace_temperature_rises_c uncertainty or qualification — fabricator stack-up or finished-trace measurement; datasheet lookup or bench measurement; blocks trace-current, trace-drop, trace-neck-current, trace-temperature
- **fabricated PCB copper:** trace_via_drill_mm uncertainty or qualification — fabricator stack-up or finished-trace measurement; datasheet lookup or bench measurement; blocks trace-current, trace-drop, trace-neck-current, trace-temperature
- **fabricated PCB copper:** trace_via_plating_um uncertainty or qualification — fabricator stack-up or finished-trace measurement; datasheet lookup or bench measurement; blocks trace-current, trace-drop, trace-neck-current, trace-temperature
- **finished servo harness:** awg20_ohm_m uncertainty or qualification — selected wire datasheet or finished-harness measurement; datasheet lookup or bench measurement; blocks adapter-current, buck-current-limit, buck-thermal, droop-servo-min, force-reading-error, input-fuse-hold, input-fuse-trip, limit-switch-low, loop-gain, loop-phase, plug-band-high, plug-band-low, regen-energy-174mJ, regen-energy-20mJ, regen-energy-2mJ, regen-energy-50mJ, regen-energy-5mJ, regulator-headroom, servo-voltage-max, shunt-power, uvlo-range
- **finished servo harness:** awg22_ohm_m uncertainty or qualification — selected wire datasheet or finished-harness measurement; datasheet lookup or bench measurement; blocks force-reading-error, limit-switch-low, plug-band-high, plug-band-low
- **finished servo harness:** awg26_ohm_m uncertainty or qualification — selected wire datasheet or finished-harness measurement; datasheet lookup or bench measurement; blocks adapter-current, buck-thermal, force-reading-error, input-fuse-hold, input-fuse-trip, limit-switch-low, plug-band-high, plug-band-low, regen-energy-174mJ, regen-energy-20mJ, regen-energy-2mJ, regen-energy-50mJ, regen-energy-5mJ, regulator-headroom, shunt-power
- **finished servo harness:** cable_l_per_m uncertainty or qualification — selected wire datasheet or finished-harness measurement; datasheet lookup or bench measurement; blocks adapter-current, buck-current-limit, buck-thermal, droop-servo-min, input-fuse-hold, input-fuse-trip, loop-gain, loop-phase, regen-energy-174mJ, regen-energy-20mJ, regen-energy-2mJ, regen-energy-50mJ, regen-energy-5mJ, regulator-headroom, servo-voltage-max, shunt-power, uvlo-range
- **finished servo harness:** harness_adapter_cord_mm uncertainty or qualification — selected wire datasheet or finished-harness measurement; datasheet lookup or bench measurement; blocks force-reading-error, limit-switch-low, plug-band-high, plug-band-low
- **finished servo harness:** harness_awg_pigtail uncertainty or qualification — selected wire datasheet or finished-harness measurement; datasheet lookup or bench measurement; blocks force-reading-error, limit-switch-low, plug-band-high, plug-band-low
- **finished servo harness:** harness_awg_power uncertainty or qualification — selected wire datasheet or finished-harness measurement; datasheet lookup or bench measurement; blocks force-reading-error, limit-switch-low, plug-band-high, plug-band-low
- **finished servo harness:** harness_awg_signal uncertainty or qualification — selected wire datasheet or finished-harness measurement; datasheet lookup or bench measurement; blocks force-reading-error, limit-switch-low, plug-band-high, plug-band-low
- **finished servo harness:** harness_bend_factor uncertainty or qualification — selected wire datasheet or finished-harness measurement; datasheet lookup or bench measurement; blocks force-reading-error, limit-switch-low, plug-band-high, plug-band-low
- **finished servo harness:** harness_bend_factor_abs uncertainty or qualification — selected wire datasheet or finished-harness measurement; datasheet lookup or bench measurement; blocks force-reading-error, limit-switch-low, plug-band-high, plug-band-low
- **finished servo harness:** harness_cap_lead_mm uncertainty or qualification — selected wire datasheet or finished-harness measurement; datasheet lookup or bench measurement; blocks force-reading-error, limit-switch-low, plug-band-high, plug-band-low
- **finished servo harness:** harness_cycle_s uncertainty or qualification — selected wire datasheet or finished-harness measurement; datasheet lookup or bench measurement; blocks force-reading-error, limit-switch-low, plug-band-high, plug-band-low
- **finished servo harness:** harness_design_life_cycles uncertainty or qualification — selected wire datasheet or finished-harness measurement; datasheet lookup or bench measurement; blocks force-reading-error, limit-switch-low, plug-band-high, plug-band-low
- **finished servo harness:** harness_force_error_limit_n uncertainty or qualification — selected wire datasheet or finished-harness measurement; datasheet lookup or bench measurement; blocks force-reading-error
- **finished servo harness:** harness_fsr_error_forces_n uncertainty or qualification — selected wire datasheet or finished-harness measurement; datasheet lookup or bench measurement; blocks force-reading-error, limit-switch-low, plug-band-high, plug-band-low
- **finished servo harness:** harness_fsr_force_cap_n uncertainty or qualification — selected wire datasheet or finished-harness measurement; datasheet lookup or bench measurement; blocks force-reading-error, limit-switch-low, plug-band-high, plug-band-low
- **finished servo harness:** harness_fsr_run_mm uncertainty or qualification — selected wire datasheet or finished-harness measurement; datasheet lookup or bench measurement; blocks force-reading-error, limit-switch-low, plug-band-high, plug-band-low
- **finished servo harness:** harness_jaw_max_deg uncertainty or qualification — selected wire datasheet or finished-harness measurement; datasheet lookup or bench measurement; blocks force-reading-error, limit-switch-low, plug-band-high, plug-band-low
- **finished servo harness:** harness_limit_run_mm uncertainty or qualification — selected wire datasheet or finished-harness measurement; datasheet lookup or bench measurement; blocks force-reading-error, limit-switch-low, plug-band-high, plug-band-low
- **finished servo harness:** harness_od_26awg_mm uncertainty or qualification — selected wire datasheet or finished-harness measurement; datasheet lookup or bench measurement; blocks force-reading-error, limit-switch-low, plug-band-high, plug-band-low
- **finished servo harness:** harness_pigtail_mm uncertainty or qualification — selected wire datasheet or finished-harness measurement; datasheet lookup or bench measurement; blocks force-reading-error, limit-switch-low, plug-band-high, plug-band-low
- **finished servo harness:** harness_plug_band_v uncertainty or qualification — selected wire datasheet or finished-harness measurement; datasheet lookup or bench measurement; blocks adapter-current, buck-thermal, force-reading-error, input-fuse-hold, input-fuse-trip, limit-switch-low, plug-band-high, plug-band-low, regen-energy-174mJ, regen-energy-20mJ, regen-energy-2mJ, regen-energy-50mJ, regen-energy-5mJ, regulator-headroom, shunt-power
- **finished servo harness:** harness_plug_rating_v uncertainty or qualification — selected wire datasheet or finished-harness measurement; datasheet lookup or bench measurement; blocks force-reading-error, limit-switch-low, plug-band-high, plug-band-low
- **finished servo harness:** harness_pwm_current_a uncertainty or qualification — selected wire datasheet or finished-harness measurement; datasheet lookup or bench measurement; blocks force-reading-error, limit-switch-low, plug-band-high, plug-band-low
- **finished servo harness:** harness_semester_fraction uncertainty or qualification — selected wire datasheet or finished-harness measurement; datasheet lookup or bench measurement; blocks force-reading-error, limit-switch-low, plug-band-high, plug-band-low
- **finished servo harness:** harness_servo_lead_ohm uncertainty or qualification — selected wire datasheet or finished-harness measurement; datasheet lookup or bench measurement; blocks force-reading-error, limit-switch-low, plug-band-high, plug-band-low
- **finished servo harness:** harness_servo_v_min uncertainty or qualification — selected wire datasheet or finished-harness measurement; datasheet lookup or bench measurement; blocks force-reading-error, limit-switch-low, plug-band-high, plug-band-low
- **finished servo harness:** harness_spare_fraction uncertainty or qualification — selected wire datasheet or finished-harness measurement; datasheet lookup or bench measurement; blocks force-reading-error, limit-switch-low, plug-band-high, plug-band-low
- **finished servo harness:** harness_unwired_length_mm uncertainty or qualification — selected wire datasheet or finished-harness measurement; datasheet lookup or bench measurement; blocks force-reading-error, limit-switch-low, plug-band-high, plug-band-low
- **finished servo harness:** harness_usb_cable_mm uncertainty or qualification — selected wire datasheet or finished-harness measurement; datasheet lookup or bench measurement; blocks force-reading-error, limit-switch-low, plug-band-high, plug-band-low
- **finished servo harness:** harness_vil_fraction uncertainty or qualification — selected wire datasheet or finished-harness measurement; datasheet lookup or bench measurement; blocks force-reading-error, limit-switch-low, plug-band-high, plug-band-low
- **selected servo and dyno specimen:** fit_a_hold_a uncertainty or qualification — manufacturer datasheet or DESIGN-BASIS section 10 force/current bench step; datasheet lookup or bench measurement; blocks adapter-current, buck-current-limit, buck-thermal, current-error, detection-time, droop-servo-min, firmware-trip-10N, firmware-trip-8N, force-reading-error, input-fuse-hold, input-fuse-trip, limit-switch-low, plug-band-high, plug-band-low, regen-energy-174mJ, regen-energy-20mJ, regen-energy-2mJ, regen-energy-50mJ, regen-energy-5mJ, regulator-headroom, sense-range, shunt-power
- **selected servo and dyno specimen:** fit_a_resistance_ohm uncertainty or qualification — manufacturer datasheet or DESIGN-BASIS section 10 force/current bench step; datasheet lookup or bench measurement; blocks adapter-current, buck-current-limit, buck-thermal, current-error, detection-time, droop-servo-min, firmware-trip-10N, firmware-trip-8N, force-reading-error, input-fuse-hold, input-fuse-trip, limit-switch-low, plug-band-high, plug-band-low, regen-energy-174mJ, regen-energy-20mJ, regen-energy-2mJ, regen-energy-50mJ, regen-energy-5mJ, regulator-headroom, sense-range, shunt-power
- **selected servo and dyno specimen:** fit_a_torque_nm_per_a uncertainty or qualification — manufacturer datasheet or DESIGN-BASIS section 10 force/current bench step; datasheet lookup or bench measurement; blocks adapter-current, buck-current-limit, buck-thermal, current-error, detection-time, droop-servo-min, firmware-trip-10N, firmware-trip-8N, force-reading-error, input-fuse-hold, input-fuse-trip, limit-switch-low, plug-band-high, plug-band-low, regen-energy-174mJ, regen-energy-20mJ, regen-energy-2mJ, regen-energy-50mJ, regen-energy-5mJ, regulator-headroom, sense-range, shunt-power
- **selected servo and dyno specimen:** fit_b_hold_a uncertainty or qualification — manufacturer datasheet or DESIGN-BASIS section 10 force/current bench step; datasheet lookup or bench measurement; blocks adapter-current, buck-current-limit, buck-thermal, current-error, detection-time, droop-servo-min, firmware-trip-10N, firmware-trip-8N, force-reading-error, input-fuse-hold, input-fuse-trip, limit-switch-low, plug-band-high, plug-band-low, regen-energy-174mJ, regen-energy-20mJ, regen-energy-2mJ, regen-energy-50mJ, regen-energy-5mJ, regulator-headroom, sense-range, shunt-power
- **selected servo and dyno specimen:** fit_b_resistance_ohm uncertainty or qualification — manufacturer datasheet or DESIGN-BASIS section 10 force/current bench step; datasheet lookup or bench measurement; blocks adapter-current, buck-current-limit, buck-thermal, current-error, detection-time, droop-servo-min, firmware-trip-10N, firmware-trip-8N, force-reading-error, input-fuse-hold, input-fuse-trip, limit-switch-low, plug-band-high, plug-band-low, regen-energy-174mJ, regen-energy-20mJ, regen-energy-2mJ, regen-energy-50mJ, regen-energy-5mJ, regulator-headroom, sense-range, shunt-power
- **selected servo and dyno specimen:** fit_b_stall_a uncertainty or qualification — manufacturer datasheet or DESIGN-BASIS section 10 force/current bench step; datasheet lookup or bench measurement; blocks adapter-current, buck-current-limit, buck-thermal, current-error, detection-time, droop-servo-min, firmware-trip-10N, firmware-trip-8N, force-reading-error, input-fuse-hold, input-fuse-trip, limit-switch-low, plug-band-high, plug-band-low, regen-energy-174mJ, regen-energy-20mJ, regen-energy-2mJ, regen-energy-50mJ, regen-energy-5mJ, regulator-headroom, sense-range, shunt-power
- **selected servo and dyno specimen:** fit_b_torque_nm_per_a uncertainty or qualification — manufacturer datasheet or DESIGN-BASIS section 10 force/current bench step; datasheet lookup or bench measurement; blocks adapter-current, buck-current-limit, buck-thermal, current-error, detection-time, droop-servo-min, firmware-trip-10N, firmware-trip-8N, force-reading-error, input-fuse-hold, input-fuse-trip, limit-switch-low, plug-band-high, plug-band-low, regen-energy-174mJ, regen-energy-20mJ, regen-energy-2mJ, regen-energy-50mJ, regen-energy-5mJ, regulator-headroom, sense-range, shunt-power
- **selected servo and dyno specimen:** servo_hold_torque_nm uncertainty or qualification — manufacturer datasheet or DESIGN-BASIS section 10 force/current bench step; datasheet lookup or bench measurement; blocks current-error, detection-time, firmware-trip-10N, firmware-trip-8N, sense-range
- **selected servo and dyno specimen:** servo_idle_a uncertainty or qualification — manufacturer datasheet or DESIGN-BASIS section 10 force/current bench step; datasheet lookup or bench measurement; blocks adapter-current, buck-thermal, input-fuse-hold, input-fuse-trip, regen-energy-174mJ, regen-energy-20mJ, regen-energy-2mJ, regen-energy-50mJ, regen-energy-5mJ, regulator-headroom, shunt-power
- **selected servo and dyno specimen:** servo_vmax uncertainty or qualification — manufacturer datasheet or DESIGN-BASIS section 10 force/current bench step; datasheet lookup or bench measurement; blocks adapter-current, buck-thermal, input-fuse-hold, input-fuse-trip, regen-energy-174mJ, regen-energy-20mJ, regen-energy-2mJ, regen-energy-50mJ, regen-energy-5mJ, regulator-headroom, servo-voltage-max, shunt-power
- **selected servo and dyno specimen:** servo_vmin uncertainty or qualification — manufacturer datasheet or DESIGN-BASIS section 10 force/current bench step; datasheet lookup or bench measurement; blocks adapter-current, buck-current-limit, buck-thermal, droop-servo-min, input-fuse-hold, input-fuse-trip, regen-energy-174mJ, regen-energy-20mJ, regen-energy-2mJ, regen-energy-50mJ, regen-energy-5mJ, regulator-headroom, shunt-power
- **servo Fit A dyno specimen:** stall-current fit confidence interval — DESIGN-BASIS.md section 10 force/current sweep; bench measurement; blocks adapter-current, buck-current-limit, buck-thermal, current-error, detection-time, droop-servo-min, firmware-trip-10N, firmware-trip-8N, force-reading-error, input-fuse-hold, input-fuse-trip, limit-switch-low, plug-band-high, plug-band-low, regen-energy-174mJ, regen-energy-20mJ, regen-energy-2mJ, regen-energy-50mJ, regen-energy-5mJ, regulator-headroom, sense-range, shunt-power, trace-current, trace-drop, trace-neck-current, trace-temperature
- **servo Fit A dyno specimen:** torque-constant and hold-current fit confidence interval — DESIGN-BASIS.md section 10 force/current sweep; datasheet lookup; blocks firmware-trip-10N, firmware-trip-8N
- **wrist capacitor:** capacitance after bias temperature and ageing — manufacturer datasheet; datasheet lookup; blocks adapter-current, buck-current-limit, buck-thermal, droop-servo-min, input-fuse-hold, input-fuse-trip, loop-gain, loop-phase, regen-energy-174mJ, regen-energy-20mJ, regen-energy-2mJ, regen-energy-50mJ, regen-energy-5mJ, regulator-headroom, servo-voltage-max, shunt-power, uvlo-range

Uncertainties combine by worst-case sum of absolute endpoint sensitivities.

| id | margin | uncertainty | components | status |
|---|---:|---:|---|---|
| input-fuse-hold | 0.1124745 A | known subtotal 0; 71 band(s) missing | F1 MF-MSMF260/16X hold-current tolerance at 25 C: missing band (missing: F1 MF-MSMF260/16X — hold-current tolerance at 25 C; find in datasheet electrical characteristics table) | margin positive, uncertainty not evidenced |
| input-fuse-trip | 2.512475 A | known subtotal 0; 72 band(s) missing | F1 MF-MSMF260/16X trip-current tolerance at 25 C: missing band (missing: F1 MF-MSMF260/16X — trip-current tolerance at 25 C; find in datasheet electrical characteristics table) | margin positive, uncertainty not evidenced |
| buck-current-limit | 2.223063 A | known subtotal 0; 35 band(s) missing | U1 TPS54560BDDAR current-limit test-condition variation: missing band (missing: U1 TPS54560BDDAR — current-limit test-condition variation; find in datasheet electrical characteristics table) | margin positive, uncertainty not evidenced |
| buck-thermal | 52.08829 C | known subtotal 0; 72 band(s) missing | U1 TPS54560BDDAR junction-to-ambient thermal resistance for the assembled PCB: missing band (missing: U1 TPS54560BDDAR — junction-to-ambient thermal resistance for the assembled PCB; find in DESIGN-BASIS.md section 10 thermal-rise bench step) | margin positive, uncertainty not evidenced |
| trace-current | 0.1831129 A | known subtotal 0; 17 band(s) missing | PCB copper finished copper thickness tolerance: missing band (missing: PCB copper — finished copper thickness tolerance; find in PCB fabricator stack-up certificate) | margin positive, uncertainty not evidenced |
| trace-neck-current | -2.118601 A | known subtotal 0; 17 band(s) missing | PCB copper finished copper thickness tolerance: missing band (missing: PCB copper — finished copper thickness tolerance; find in PCB fabricator stack-up certificate) | not met pending measurement |
| trace-temperature | 1.021854 C | known subtotal 0; 18 band(s) missing | PCB copper finished copper thickness tolerance: missing band (missing: PCB copper — finished copper thickness tolerance; find in PCB fabricator stack-up certificate) | margin positive, uncertainty not evidenced |
| trace-drop | 28.80989 mV | known subtotal 0; 18 band(s) missing | PCB copper finished copper thickness tolerance: missing band (missing: PCB copper — finished copper thickness tolerance; find in PCB fabricator stack-up certificate) | margin positive, uncertainty not evidenced |
| shunt-power | 0.7844592 W | known subtotal 0.01215541; 71 band(s) missing | RS1 resistance tolerance: [-0.01, 0.01] (constants.py:138, RS1 0.1 ohm 1 percent design value) | margin positive, uncertainty not evidenced |
| sense-range | -0.57 A | known subtotal 0; 20 band(s) missing | U2 INA219AIDR input-filter source-impedance mismatch: missing band (missing: U2 INA219AIDR — input-filter source-impedance mismatch; find in DESIGN-BASIS.md section 10 current-calibration bench step) | not met pending measurement |
| current-error | -0.01384375 A | known subtotal 0; 21 band(s) missing | U2 INA219AIDR input-filter source-impedance mismatch: missing band (missing: U2 INA219AIDR — input-filter source-impedance mismatch; find in DESIGN-BASIS.md section 10 current-calibration bench step) | not met pending measurement |
| detection-time | 0.079414 s | known subtotal 0; 20 band(s) missing | U2 INA219AIDR input-filter source-impedance mismatch: missing band (missing: U2 INA219AIDR — input-filter source-impedance mismatch; find in DESIGN-BASIS.md section 10 current-calibration bench step) | margin positive, uncertainty not evidenced |
| fsr-node-high | -7.456691 mV | known subtotal 0; 15 band(s) missing | U3 ESP32-WROOM-32E ADC linear-range endpoint variation: missing band (missing: U3 ESP32-WROOM-32E — ADC linear-range endpoint variation; find in DESIGN-BASIS.md section 10 ADC sweep bench step) | not met pending measurement |
| force-reading-error | 0.09717833 N | known subtotal 0; 42 band(s) missing | J1/J2/J3 harness assembly finished conductor resistance and contact-resistance range: missing band (missing: J1/J2/J3 harness assembly — finished conductor resistance and contact-resistance range; find in DESIGN-BASIS.md section 10 harness milliohm bench step) | margin positive, uncertainty not evidenced |
| adc-charge | 0.391684 mV | known subtotal 0; 16 band(s) missing | C17 100 nF capacitance tolerance: missing band (missing: C17 100 nF — capacitance tolerance; find in C17 manufacturer datasheet capacitance-tolerance table) | margin positive, uncertainty not evidenced |
| filter-delay | 0.07475854 s | known subtotal 0; 15 band(s) missing | C17 100 nF capacitance tolerance: missing band (missing: C17 100 nF — capacitance tolerance; find in C17 manufacturer datasheet capacitance-tolerance table) | margin positive, uncertainty not evidenced |
| firmware-trip-10N | 0.7540514 A | known subtotal 0; 20 band(s) missing | servo Fit A dyno specimen torque-constant and hold-current fit confidence interval: missing band (missing: servo Fit A dyno specimen — torque-constant and hold-current fit confidence interval; find in DESIGN-BASIS.md section 10 force/current sweep) | margin positive, uncertainty not evidenced |
| firmware-trip-8N | 1.109315 A | known subtotal 0; 20 band(s) missing | servo Fit A dyno specimen torque-constant and hold-current fit confidence interval: missing band (missing: servo Fit A dyno specimen — torque-constant and hold-current fit confidence interval; find in DESIGN-BASIS.md section 10 force/current sweep) | margin positive, uncertainty not evidenced |
| adapter-current | -0.1094069 A | known subtotal 0; 72 band(s) missing | PS1 12 V 3 A adapter rated-current capability over temperature: missing band (missing: PS1 12 V 3 A adapter — rated-current capability over temperature; find in adapter datasheet output-current table) | not met pending measurement |
| droop-servo-min | 1.293385 V | known subtotal 0; 35 band(s) missing | C12 1000 uF capacitance and ESR after bias, temperature, and ageing: missing band (missing: C12 1000 uF — capacitance and ESR after bias, temperature, and ageing; find in DESIGN-BASIS.md section 10 load-step bench step) | margin positive, uncertainty not evidenced |
| servo-voltage-max | 0.1410554 V | known subtotal 0; 17 band(s) missing | none; demand already evaluated at listed extremes | margin positive, uncertainty not evidenced |
| plug-band-low | 0.03196618 V | known subtotal 0; 41 band(s) missing | J1/J2/J3 harness assembly finished conductor resistance and contact-resistance range: missing band (missing: J1/J2/J3 harness assembly — finished conductor resistance and contact-resistance range; find in DESIGN-BASIS.md section 10 harness milliohm bench step) | margin positive, uncertainty not evidenced |
| plug-band-high | 0.113279 V | known subtotal 0; 41 band(s) missing | J1/J2/J3 harness assembly finished conductor resistance and contact-resistance range: missing band (missing: J1/J2/J3 harness assembly — finished conductor resistance and contact-resistance range; find in DESIGN-BASIS.md section 10 harness milliohm bench step) | margin positive, uncertainty not evidenced |
| loop-phase | 46.06384 deg | known subtotal 0; 17 band(s) missing | U1 TPS54560BDDAR compensation network small-signal plant/model error band: missing band (missing: U1 TPS54560BDDAR compensation network — small-signal plant/model error band; find in DESIGN-BASIS.md section 10 loop-response bench step) | margin positive, uncertainty not evidenced |
| loop-gain | 9.50081 dB | known subtotal 0; 17 band(s) missing | U1 TPS54560BDDAR compensation network small-signal plant/model error band: missing band (missing: U1 TPS54560BDDAR compensation network — small-signal plant/model error band; find in DESIGN-BASIS.md section 10 loop-response bench step) | margin positive, uncertainty not evidenced |
| uvlo-range | 2.023298 V | known subtotal 0; 18 band(s) missing | U1 TPS54560BDDAR compensation network small-signal plant/model error band: missing band (missing: U1 TPS54560BDDAR compensation network — small-signal plant/model error band; find in DESIGN-BASIS.md section 10 loop-response bench step) | margin positive, uncertainty not evidenced |
| regulator-headroom | 0.8860886 V | known subtotal 0; 71 band(s) missing | PS1 12 V 3 A adapter rated-current capability over temperature: missing band (missing: PS1 12 V 3 A adapter — rated-current capability over temperature; find in adapter datasheet output-current table) | margin positive, uncertainty not evidenced |
| limit-switch-low | 824.7744 mV | known subtotal 0; 41 band(s) missing | J1/J2/J3 harness assembly finished conductor resistance and contact-resistance range: missing band (missing: J1/J2/J3 harness assembly — finished conductor resistance and contact-resistance range; find in DESIGN-BASIS.md section 10 harness milliohm bench step) | margin positive, uncertainty not evidenced |
| regen-energy-2mJ | 0.02239736 V | known subtotal 0; 71 band(s) missing | PS1 12 V 3 A adapter rated-current capability over temperature: missing band (missing: PS1 12 V 3 A adapter — rated-current capability over temperature; find in adapter datasheet output-current table) | margin positive, uncertainty not evidenced |
| regen-energy-5mJ | -0.2616369 V | known subtotal 0; 71 band(s) missing | PS1 12 V 3 A adapter rated-current capability over temperature: missing band (missing: PS1 12 V 3 A adapter — rated-current capability over temperature; find in adapter datasheet output-current table) | not met pending measurement |
| regen-energy-20mJ | -1.537914 V | known subtotal 0; 71 band(s) missing | PS1 12 V 3 A adapter rated-current capability over temperature: missing band (missing: PS1 12 V 3 A adapter — rated-current capability over temperature; find in adapter datasheet output-current table) | not met pending measurement |
| regen-energy-50mJ | -3.632113 V | known subtotal 0; 71 band(s) missing | PS1 12 V 3 A adapter rated-current capability over temperature: missing band (missing: PS1 12 V 3 A adapter — rated-current capability over temperature; find in adapter datasheet output-current table) | not met pending measurement |
| regen-energy-174mJ | -9.671271 V | known subtotal 0; 71 band(s) missing | PS1 12 V 3 A adapter rated-current capability over temperature: missing band (missing: PS1 12 V 3 A adapter — rated-current capability over temperature; find in adapter datasheet output-current table) | not met pending measurement |

### Computed faults

| id | entry | applied | part | current | power | rating | verdict |
|---|---|---:|---|---:|---:|---|---|
| fault-limit-servo | LIM_SIG | 6.65895 V | D5 | 6.3 A | not evidenced W | not quoted (repository has no continuous-current or clamp-power quote) | not evidenced |
| fault-limit-servo | LIM_SIG | 6.65895 V | R17 | 0.000714669 A | 0.002400534 W | not quoted (repository has no continuous-power quote) | not evidenced |
| fault-limit-servo | LIM_SIG | 6.65895 V | R18 | 0.00665895 A | 0.04434155 W | not quoted (repository has no continuous-power quote) | not evidenced |
| fault-limit-servo | LIM_SIG | 6.65895 V | controller pin | 0.00665895 A | 0.0 W | not quoted (repository has no controller injection-current quote) | not evidenced |
| fault-limit-servo | LIM_SIG | 6.65895 V | +3V3 rail | 0.000714669 A | 0.0 W | not quoted (repository has no 3.3 V rail sink-current quote) | not evidenced |

#### Proposed in-memory protection

| entry | part | current | power | rating | verdict |
|---|---|---:|---:|---|---|
| LIM_RAW | R25 | 0.00665895 A | 0.04434155 W | not quoted (repository has no continuous-power quote) | not evidenced |
| LIM_RAW | R17 | 0.000702128 A | 0.002317021 W | not quoted (repository has no continuous-power quote) | not evidenced |
| LIM_RAW | R18 | 0 A | 0.0 W | not quoted (repository has no continuous-power quote) | not evidenced |
| LIM_RAW | D5 | 0.00736107 A | not evidenced W | not quoted (repository has no continuous-current or clamp-power quote) | not evidenced |
| LIM_RAW | controller pin | 0 A | 0.0 W | not quoted (repository has no controller injection-current quote) | not evidenced |
| LIM_RAW | +3V3 rail | 0.000702128 A | 0.0 W | not quoted (repository has no 3.3 V rail sink-current quote) | not evidenced |

Closed low 0.578947 V against 0.825 V VIL; close tau 0.000182456 s; release tau 0.00057 s.
<!-- ORDER-STATUS:END -->

Tags: [S] sourced (document named), [D] derived by `ecad/gripper/calc/harness.py` and printed in `ecad/gripper/calc/out/harness.txt`, [A] assumed.

## What to build

1. One sleeved cable, 1200 mm [A, measure at assembly], from the controller board (J3 servo terminal, J4 sensor header) to the wrist: a 20 AWG red/black pair for servo power and five 26 AWG conductors (orange PWM, red +3V3, white FSR, green limit, gray sensor ground).
2. At the forearm end the pair and the PWM wire are spliced to the cut-off stub of a servo extension lead whose male plug mates the servo's own lead; a 470 uF 16 V capacitor is soldered across the splice.
3. The four sensor wires end in a latching 4-position connector (SM) so the gripper detaches; beyond it, two wires go to the FSR through a Clincher connector (never solder to the FSR tail) and two to the jaw-open limit switch (contacts COM and NO).

Pass/fail numbers through X1: the 20 AWG pair costs 79.9 mohm loop resistance and X1 stays inside the 6.35 to 6.65 V hold band at the nominal set point (6.459 V at Fit A hold); a 26 AWG pair would not (6.133 V) [D, harness.txt (b)]. The selected-servo lead is excluded because its gauge and length are not recorded.

## Wiring table

Generated by `python ecad/gripper/calc/harness.py` from the repository root (also writes `ecad/gripper/calc/out/harness_wiring.csv` and `harness_wiring.md`). Board-side pin nets are checked against `ecad/gripper/design.py` on every run; a mismatch stops the script.

Lead-in names: SPL-* is a soldered, heat-shrunk splice at the forearm end. X1 is the male 3-pin plug of the servo extension lead. SM is the JST SM latching pair. FSR.1/.2 are the two Clincher positions. SW is the D2F-01L microswitch.

<!-- harness-wiring:start -->
| id | from | to | signal | gauge AWG | colour | length mm | connector and pin | notes |
|---|---|---|---|---|---|---|---|---|
| H01 | J3.1 | SPL-GND | GND | 20 | black | 1200 | J3 Phoenix MKDS 1,5/3-5.08 screw terminal, pin 1 | Trunk, in the braided sleeve. Servo return. Splice at the forearm end with H04 and the capacitor lead H08. |
| H02 | J3.2 | SPL-V | SERVO_V | 20 | red | 1200 | J3 Phoenix MKDS 1,5/3-5.08 screw terminal, pin 2 | Trunk, in the braided sleeve. Servo V+, 6.58 V nominal. Splice with H05 and the capacitor lead H07. |
| H03 | J3.3 | SPL-PWM | SERVO_PWM | 26 | orange | 1200 | J3 Phoenix MKDS 1,5/3-5.08 screw terminal, pin 3 | Trunk, in the braided sleeve. 5 V logic, 50 Hz. Fold the strands back on themselves so the screw clamps more copper. |
| H04 | SPL-GND | X1.1 |  | 22 | black | 100 | Servo extension lead 972, male plug X1, pin 1 | Pigtail. Gauge is not stated by the seller [A]. Cut the female end off the lead. |
| H05 | SPL-V | X1.2 |  | 22 | red | 100 | Servo extension lead 972, male plug X1, pin 2 | Pigtail [A gauge]. |
| H06 | SPL-PWM | X1.3 |  | 22 | white | 100 | Servo extension lead 972, male plug X1, pin 3 | Pigtail [A gauge]; white is the signal wire of this lead. |
| H07 | SPL-V | C_WRIST.+ |  | cap lead | red | 10 | EEU-FR1C471 470 uF 16 V, + lead (longer lead) | Soldered across the splice. Polarised: wrong way round it fails. Capacitance is design.ELEC c_wrist_F. |
| H08 | SPL-GND | C_WRIST.- |  | cap lead | black | 10 | EEU-FR1C471 470 uF 16 V, - lead (stripe side) | Soldered across the splice. |
| H09 | X1.1 | SERVO.GND |  | could-not-tell | could-not-tell | could-not-tell | DSServo DS3230 MG lead, 3-pin plug | Supplied with the selected servo; lead gauge, colour, and length are not recorded. Not built. Team must confirm on delivered servo. |
| H10 | X1.2 | SERVO.V+ |  | could-not-tell | could-not-tell | could-not-tell | DSServo DS3230 MG lead, 3-pin plug | Supplied with the selected servo; lead gauge, colour, and length are not recorded. Team must confirm on delivered servo. |
| H11 | X1.3 | SERVO.SIG |  | could-not-tell | could-not-tell | could-not-tell | DSServo DS3230 MG lead, 3-pin plug | Supplied with the selected servo; lead gauge, colour, and length are not recorded. Team must confirm on delivered servo. |
| H12 | J4.1 | SM.1 | +3V3 | 26 | red | 1200 | J4 JST XH B4B-XH-A, housing XHP-4 with SXH-001T-P0.6 crimp contact, pin 1 | Trunk, in the braided sleeve. 3.3 V to the FSR, about 0.9 mA at 10 N. |
| H13 | J4.2 | SM.2 | FSR_SIG | 26 | white | 1200 | J4 JST XH B4B-XH-A, housing XHP-4 with SXH-001T-P0.6 crimp contact, pin 2 | Trunk, in the braided sleeve. FSR node; carries the same 0.9 mA as H12 because R15 is on the board. |
| H14 | J4.3 | SM.3 | LIM_SIG | 26 | green | 1200 | J4 JST XH B4B-XH-A, housing XHP-4 with SXH-001T-P0.6 crimp contact, pin 3 | Trunk, in the braided sleeve. Pulled up by R17 4.7 k; switch closing pulls it to GND. |
| H15 | J4.4 | SM.4 | GND | 26 | gray | 1200 | J4 JST XH B4B-XH-A, housing XHP-4 with SXH-001T-P0.6 crimp contact, pin 4 | Trunk, in the braided sleeve. Sensor return, separate from the servo return H01. Carries only the 0.7 mA limit current. |
| H16 | SM.1 | FSR.1 |  | 26 | red | 150 | JST SM 4-position pair SMP-04V-BC / SMR-04V-B, wrist end, contact 1; to Clincher position 1 | Along finger B. Clincher end: crimp or solder to the Clincher contact per Amphenol, never to the FSR tail. Length includes the service loop [A]. |
| H17 | SM.2 | FSR.2 |  | 26 | white | 150 | JST SM 4-position pair SMP-04V-BC / SMR-04V-B, wrist end, contact 2; to Clincher position 2 | Same route as H16. FSR leg polarity does not matter. |
| H18 | SM.3 | SW.NO |  | 26 | green | 120 | JST SM 4-position pair SMP-04V-BC / SMR-04V-B, wrist end, contact 3; to D2F-01L NO terminal | Normally-open contact: closes to COM when the lever is pressed at jaw open. |
| H19 | SM.4 | SW.COM |  | 26 | gray | 120 | JST SM 4-position pair SMP-04V-BC / SMR-04V-B, wrist end, contact 4; to D2F-01L COM terminal | Common contact, to the sensor return. |
| A01 | ADAPTER.TIP | J1.1 | VIN_RAW | supplied cord | supplied | 1500 | J1 barrel jack 5.5 x 2.1 mm, centre positive; Pololu WPA-1774 | 12 V in. J2 is the screw-terminal alternative; use one input only. |
| A02 | ADAPTER.SLEEVE | J1.2 | GND | supplied cord | supplied | 1500 | J1 barrel jack sleeve | Return of the adapter cord (same cord as A01). |
| U01 | HOST.USB-A | U5.USB |  | supplied cable | supplied | 914 | Adafruit 592 USB A to micro-B on the DevKitC | Firmware load and serial. Not part of the wrist cable. |
| N01 | J2 | - | VIN_RAW | - | - | 0 | J2 screw terminal 2-way | Not wired: alternative 12 V input, use J1 or J2, not both. |
| N02 | J5 | - | FB_IN | - | - | 0 | J5 1x3 header | Not wired: optional servo position feedback, unfitted (FB_ENABLED 0). |
| N03 | J6 | - | DRV_AIN1 | - | - | 0 | J6 1x8 header | Not wired: DC-gearmotor branch expansion, unused in the servo build. |
| N04 | J7 | - | SERVO_PWM | - | - | 0 | J7 1x3 header | Not wired: bench servo header, bench use only. |
<!-- harness-wiring:end -->

### Limit switch contact: COM and NO

Firmware reads the jaw-open limit as a pin pulled to GND (`config.h` `PIN_LIMIT_OPEN`: "switch to GND, INPUT_PULLUP"; `events.h` `EV_LIMIT_HIT`: "switch closed"). R17 (4.7 k) pulls LIM_SIG up on the board. So the switch must close at jaw open: COM to sensor ground, NO to LIM_SIG. A cut or unplugged wire then reads "not at the limit" and can never fake a limit hit. NC would do the opposite. Contact load is 0.70 mA at 3.3 V [D]; check it against the D2F-01L datasheet minimum load before relying on the switch (not read this session) [A].

## Numbers the design depends on

All from `ecad/gripper/calc/out/harness.txt` unless tagged otherwise.

| Quantity | Value |
|---|---|
| 20 AWG power pair, 1200 mm out and back | 79.9 mohm |
| Loop through 100 mm pigtail to X1 (servo lead excluded) | 90.5 mohm |
| Drop in the 20 AWG pair, Fit A hold 1.35 A / stall 3.42 A | 0.108 V / 0.274 V |
| Total drop to X1, Fit A hold / stall | 0.122 V / 0.315 V |
| X1 voltage, Fit A hold, low / nominal / high set point | 6.382 / 6.459 / 6.537 V |
| Same with 26 AWG power pair, Fit A hold nominal | 6.133 V (fails the 6.35 V band edge) |
| Each 26 AWG signal conductor, 1200 mm | 160.7 mohm |
| Worst drop of a signal conductor (PWM, 1 mA [A]) | 0.161 mV, 0.2 ADC step |
| FSR force error from the two series wires, at 5 N / 8 N | -0.0012 N / -0.0028 N |
| Limit input with switch closed | 0.226 mV above ground; ESP32 low threshold 825 mV [A] |
| Wire to buy, with 15 % spare | 20 AWG red and black 1380 mm each; 26 AWG: orange 1380, red 1552, white 1552, green 1518, gray 1518 mm; sleeve 1380 mm |
| Minimum dynamic bend radius, 26 AWG (1.5 mm OD) | 15.0 mm (10 x OD); absolute minimum 7.5 mm (5 x) [S flex_wire] |
| Service loop diameter | at least 30 mm |
| Slack to absorb over the 27.4 deg jaw travel at that radius | 7.2 mm |
| Flex cycles to survive | 100000 [A] = 102.9 cycles/h x 972 h (35 s cycle, DESIGN-BASIS section 7) |

Corner finding through X1: at the lowest set point and Fit A hold X1 is 32 mV above the 6.35 V band edge; the loop may be at most 114 mohm and is 90.5 mohm. The pigtail is 10.6 mohm. The unrecorded selected-servo lead is excluded, so confirm it before treating this margin as an at-servo result.

## Parts

From `ecad/gripper/sourcing.py` `HARNESS` (prices and sellers are in that file).

| Item | Qty | Part |
|---|---|---|
| 12 V 3 A regulated adapter, 5.5 x 2.1 mm centre positive | 1 | Pololu WPA-1774 |
| 20 AWG silicone stranded wire, red + black | 2 packs (1 m of each colour per pack) | Pyrodrone X8-1424-24, or any 20 AWG silicone wire |
| 26 AWG silicone stranded wire, 2 m spool, five colours | 5 | Adafruit 1877 red, 1880 green, 1882 white, 1883 orange, 1884 gray |
| JST XH 4-position housing with 4 crimp contacts | 1 | XHP-4 + SXH-001T-P0.6 |
| 4-position latching wire-to-wire pair (wrist end) | 1 | SMP-04V-BC + SMR-04V-B, plus 4 pin and 4 socket SM crimp contacts (JST SYM-001T-P0.6 and SHF-001T-0.8BS [A]: recalled from the JST SM series, not confirmed on a supplier page and not priced; confirm before ordering) |
| 3-pin servo extension lead (male end mates the servo plug) | 1 | Adafruit 972 |
| 470 uF 16 V low-ESR radial electrolytic | 1 | Panasonic EEU-FR1C471 |
| Amphenol Clincher 2-position female for the FSR tail | 1 | 65801-002LF (SparkFun COM-14194) |
| Jaw-open limit microswitch | 1 | Omron D2F-01L |
| Braided sleeve | 2 m | TE Versaflex 1/4 inch (6 mm ID relaxed [S]) |
| M3 standoffs F-F 10 mm, 4 off (board mounting) | 1 set | any |
| USB A to micro-B cable | 1 | Adafruit 592 |
| Not in `sourcing.HARNESS`, needed | | J3 and J4 mating parts are on the board; heat-shrink (3 splices H01 to H06, 1 for the capacitor); 2.5 mm zip ties [A]; a crimp tool for XH and SM contacts |

<!-- harness-orientation:start -->
## Connector orientation views

Numbers, signals, and colours below are generated from the wiring rows. Opposite sides are mirrored.

### J3 — Phoenix MKDS 1,5/3-5.08

board screw terminal; builder inserts stripped trunk wires.
Position-1 reference: could-not-tell: identify position 1 from the moulded mark on the part in hand and the manufacturer drawing named here; do not infer it from the latch, key, or wire colours.
Source: KiCad footprint pad 1 and design.py J3 pin list; Phoenix MKDS 1,5/3-5.08 drawing must locate the physical cavity.

viewed from the wire-entry side:
```text
reference: could-not-tell: identify position 1 from the moulded mark on the part in hand and the manufacturer drawing named here; do not infer it from the latch, key, or wire colours
[1 GND black] | [2 SERVO_V red] | [3 SERVO_PWM orange]
```

viewed from the mating face:
```text
reference: could-not-tell: identify position 1 from the moulded mark on the part in hand and the manufacturer drawing named here; do not infer it from the latch, key, or wire colours
[3 SERVO_PWM orange] | [2 SERVO_V red] | [1 GND black]
```

### J4 — JST B4B-XH-A / XHP-4

builder populates the XHP-4 cable housing.
Position-1 reference: could-not-tell: identify position 1 from the moulded mark on the part in hand and the manufacturer drawing named here; do not infer it from the latch, key, or wire colours.
Source: KiCad footprint pad 1 and design.py J4 pin list; JST XHP-4 drawing must locate the housing cavity.

viewed from the wire-entry side:
```text
reference: could-not-tell: identify position 1 from the moulded mark on the part in hand and the manufacturer drawing named here; do not infer it from the latch, key, or wire colours
[1 +3V3 red] | [2 FSR_SIG white] | [3 LIM_SIG green] | [4 GND gray]
```

viewed from the mating face:
```text
reference: could-not-tell: identify position 1 from the moulded mark on the part in hand and the manufacturer drawing named here; do not infer it from the latch, key, or wire colours
[4 GND gray] | [3 LIM_SIG green] | [2 FSR_SIG white] | [1 +3V3 red]
```

### SM-T — JST SMP-04V-BC

trunk half at the wrist; builder populates this plug.
Position-1 reference: could-not-tell: identify position 1 from the moulded mark on the part in hand and the manufacturer drawing named here; do not infer it from the latch, key, or wire colours.
Source: sourcing.py identifies SMP-04V-BC; JST SM connector drawing must locate the cavity.

viewed from the wire-entry side:
```text
reference: could-not-tell: identify position 1 from the moulded mark on the part in hand and the manufacturer drawing named here; do not infer it from the latch, key, or wire colours
[1 +3V3 red] | [2 FSR_SIG white] | [3 LIM_SIG green] | [4 GND gray]
```

viewed from the mating face:
```text
reference: could-not-tell: identify position 1 from the moulded mark on the part in hand and the manufacturer drawing named here; do not infer it from the latch, key, or wire colours
[4 GND gray] | [3 LIM_SIG green] | [2 FSR_SIG white] | [1 +3V3 red]
```

### SM-W — JST SMR-04V-B

wrist pigtail half; builder populates this receptacle.
Position-1 reference: could-not-tell: identify position 1 from the moulded mark on the part in hand and the manufacturer drawing named here; do not infer it from the latch, key, or wire colours.
Source: sourcing.py identifies SMR-04V-B; JST SM connector drawing must locate the cavity.

viewed from the wire-entry side:
```text
reference: could-not-tell: identify position 1 from the moulded mark on the part in hand and the manufacturer drawing named here; do not infer it from the latch, key, or wire colours
[4 GND gray] | [3 LIM_SIG green] | [2 FSR_SIG white] | [1 +3V3 red]
```

viewed from the mating face:
```text
reference: could-not-tell: identify position 1 from the moulded mark on the part in hand and the manufacturer drawing named here; do not infer it from the latch, key, or wire colours
[1 +3V3 red] | [2 FSR_SIG white] | [3 LIM_SIG green] | [4 GND gray]
```

### X1 — Adafruit 972 male servo-extension plug

builder retains and splices the male-plug pigtail.
Position-1 reference: could-not-tell: identify position 1 from the moulded mark on the part in hand and the manufacturer drawing named here; do not infer it from the latch, key, or wire colours.
Source: sourcing.py identifies lead 972; its product/manufacturer drawing must locate the cavity.

viewed from the wire-entry side:
```text
reference: could-not-tell: identify position 1 from the moulded mark on the part in hand and the manufacturer drawing named here; do not infer it from the latch, key, or wire colours
[1 GND black] | [2 SERVO_V red] | [3 SERVO_PWM white]
```

viewed from the mating face:
```text
reference: could-not-tell: identify position 1 from the moulded mark on the part in hand and the manufacturer drawing named here; do not infer it from the latch, key, or wire colours
[3 SERVO_PWM white] | [2 SERVO_V red] | [1 GND black]
```

### FSR — Amphenol 65801-002LF Clincher

builder terminates the female Clincher onto H16/H17.
Position-1 reference: could-not-tell: identify position 1 from the moulded mark on the part in hand and the manufacturer drawing named here; do not infer it from the latch, key, or wire colours.
Source: sourcing.py identifies 65801-002LF; Amphenol 65801 drawing must locate position 1.

viewed from the wire-entry side:
```text
reference: could-not-tell: identify position 1 from the moulded mark on the part in hand and the manufacturer drawing named here; do not infer it from the latch, key, or wire colours
[1 +3V3 red] | [2 FSR_SIG white]
```

viewed from the mating face:
```text
reference: could-not-tell: identify position 1 from the moulded mark on the part in hand and the manufacturer drawing named here; do not infer it from the latch, key, or wire colours
[2 FSR_SIG white] | [1 +3V3 red]
```

### SW — Omron D2F-01L

builder solders the NO and COM terminals.
Position-1 reference: terminal mould marks NO and COM; position 1 in this note means NO.
Source: design.py pin list (LIM_SIG to NO, GND to COM); D2F-01L terminal names are moulded on the case.

viewed from the wire-entry side:
```text
reference: terminal mould marks NO and COM; position 1 in this note means NO
[1 LIM_SIG green] | [2 GND gray]
```

viewed from the mating face:
```text
reference: terminal mould marks NO and COM; position 1 in this note means NO
[2 GND gray] | [1 LIM_SIG green]
```

### Team must confirm

- J3: locate cavity 1 using the Phoenix MKDS 1,5/3-5.08 manufacturer drawing and the part in hand.
- J4/XHP-4: locate cavity 1 using the JST XHP-4 drawing and moulded mark.
- Both SM halves: locate cavity 1 independently using the JST SM drawings and moulded marks; do not transfer a latch-side rule between halves.
- X1: locate contact 1 on the Adafruit 972 male plug from its drawing or continuity to its labelled conductors.
- Clincher: locate position 1 using the Amphenol 65801 drawing and moulded mark.
- Selected DSServo DS3230 MG lead gauge, length, colours, contact order, and mating orientation on the delivered servo.
<!-- harness-orientation:end -->

## Assembly order

1. Measure the route from the board to the wrist with the arm at full reach and at its tightest bend. If it is not 1200 mm, change `cable_len_m` in `ecad/gripper/design.py`, rerun `python ecad/gripper/calc/harness.py`, and cut to the new table.
2. Cut every `spool` wire in the table to length. Mark both ends of each wire with its id (H01 and so on) before anything else; the colours repeat.
3. Board end of the sensor trunk: crimp SXH-001T-P0.6 contacts on H12 to H15 and seat them in the XHP-4 housing at positions 1 to 4. Pin 1 is the +3V3 red wire. Pull each contact to check it is latched.
4. Board end of the power trunk: strip H01, H02, H03 and clamp them in J3 pins 1, 2, 3. Fold the 26 AWG strands back so the screw has more copper. Tug test each.
5. Wrist end of the trunk: crimp SM contacts on H12 to H15 and seat them in the SM plug. Crimp SM contacts on the wrist-side wires H16 to H19 and seat them in the SM receptacle at the same positions. Mate once and confirm the latch clicks.
6. Servo splice: cut the female end off the extension lead 972, leaving a 100 mm pigtail with the male plug. Slide heat-shrink over each wire. Solder H01 to the black pigtail wire (H04), H02 to the red wire (H05), H03 to the white wire (H06). Solder the capacitor leads across the red and black splices, + to red and - (stripe) to black, leads trimmed to about 10 mm [A]. Shrink the sleeves.
7. Braided sleeve: thread it over the five trunk wires and the two power wires before the second end is terminated, that is after step 3 and before steps 5 and 6 (the expanded sleeve may not pass over a finished SM housing or the splice [A]), so it covers H01 to H03 and H12 to H15 end to end. Secure its ends with a tie and a short heat-shrink band so it cannot ride back.
8. FSR end: terminate H16 and H17 on the Clincher connector according to Amphenol's instructions. Never solder to the FSR tail: soldering heat destroys the tail. Press the tail into the Clincher.
9. Switch end: solder H18 to the NO terminal and H19 to the COM terminal of the D2F-01L (terminals are marked on the case) [A].
10. Run the continuity checks below before any power.

## Strain relief

What the CAD has: the servo sits on `front_plate` and `wrist_mount` (PETG, four M3x6 into the horn); finger B turns on its knuckle and carries the FSR in `fsr_backing_b` (tail slot 7.6 mm wide) (`cad/gripper/params.json`, `drawings/BOM.md`). The CAD has no cable anchor, no sleeve clamp, no Clincher seat and no limit-switch pocket. Until rev B adds them, use the temporary method below and request the features under "Requested CAD changes".

Temporary anchoring until rev B:

1. Anchor the sleeve end on the fixed part: tie it with a 2.5 mm zip tie [A] to the `wrist_mount` ribs or the servo body at the side away from the jaws, so the sleeve cannot move. All movement then happens in the loose wire beyond the sleeve.
2. Service loop: beyond the sleeve end, leave the wire free in one open loop of diameter at least 30 mm, i.e. bend radius at least 15 mm (10 x 1.5 mm OD [S flex_wire]; 7.5 mm is the absolute minimum). Never lay a wire in a tighter bend than 15 mm, including at a tie.
3. The SM connector sits at the loop's fixed side so the gripper can detach without touching the sleeve.
4. Finger side: tie H16 and H17 to the finger-B web near the root with a tie, then to the Clincher, so the wires move with the finger and bend only in the free span across the knuckle.
5. The span across the knuckle sees 27.4 deg of bending (jaw -7.4 to +20 deg [config.h, DESIGN-BASIS R18]). At 15 mm radius that is 7.2 mm of slack taken up and given back each cycle [D]; leave at least that much, with the loop not touching the pivot.

Check the wrist-flex swing too (SO-101 wrist flex, DESIGN-BASIS R9): the loop must not pinch between the flex parts at +/-95 deg [A that the CAD envelope check applies].

## FSR lead flex-life

The FSR 402 tail carries printed silver traces that crack if flexed, and soldering heat destroys the tail [S: sourcing.EVIDENCE['fsr_tail'], Interlink guidance not readable in the session, [A]]. The data sheet gives up to 10 million actuations of the sensing area, not of the tail. The lead past the Clincher moves on every jaw cycle: 100000 of them over the design life [A].

Mitigation:

1. Clincher, not solder: the tail goes into the Clincher and is never heated.
2. Bond or tie the tail and the Clincher to the finger-B backing so neither moves relative to the finger. Only the silicone wire (H16, H17) bends, and only in the free span across the knuckle.
3. Stranded silicone wire (26 AWG, 1.4 to 1.5 mm OD) and the 15 mm minimum radius above.
4. Keep the service loop at or above 15 mm radius at all jaw angles; check it by eye at open (+20 deg) and closed (-7.4 deg).
5. Inspect every 10000 cycles (about 97 h of use, one semester [A, DESIGN-BASIS section 7]): look for a crack or kink at the Clincher crimp and at the knuckle span; check continuity of H16, H17 flexed by hand. Replace the wire at the first break; do not repair in place.

## Requested CAD changes (rev B)

All numbers are my proposals [A]; check against the real parts.

| Where | Change | Number |
|---|---|---|
| `wrist_mount` | Two tie slots for a 2.5 mm zip tie on the side away from the jaws | 3.0 x 1.6 mm each, 12 mm apart |
| `wrist_mount` | Sleeve seat so the sleeve end cannot slide | open channel 6.5 mm wide (sleeve 6 mm ID relaxed), 8 mm long |
| Finger B web, root half | Two tie slots, wires leave toward the knuckle | 3.0 x 1.6 mm each, 10 mm apart |
| `fsr_backing_b` | Seat for the Clincher so the tail and connector are bonded to the finger | pocket from the Amphenol 65801 drawing (not read); placeholder 10 x 6 x 5 mm |
| Front plate, jaw-open end | Pocket and two M2 holes for the D2F-01L, lever pressed at jaw open | pocket from the Omron drawing (not read); placeholder 13 x 6 x 7 mm |
| Whole gripper | Check a 30 mm diameter loop volume beside knuckle B against wrist-flex and jaw sweep | no interference at 0, 10, 20 deg and -7.4 deg |

Firmware: no change needed for COM and NO. Leave `LIMIT_REQUIRED 0` until the switch is installed and tested.

<!-- harness-checks:start -->
## Continuity and isolation before first power

Disconnect all power; unplug the servo and ESP32 module; mate the SM pair. Use a low-ohms meter.

### End-to-end by signal

| signal | from | to | expected |
|---|---|---|---|
| GND servo | J3.1 | X1.1 | under 1 ohm |
| SERVO_V | J3.2 | X1.2 | under 1 ohm |
| SERVO_PWM | J3.3 | X1.3 | under 1 ohm |
| +3V3 | J4.1 | FSR.1 | under 1 ohm |
| FSR_SIG | J4.2 | FSR.2 | under 1 ohm |
| LIM_SIG | J4.3 | SW.1 | under 1 ohm |
| GND sensor | J4.4 | SW.2 | under 1 ohm |
| FSR element | FSR.1 | FSR.2 | not a short: open unloaded, finite resistance when pressed |

### Adjacent-position isolation

Each probe below crosses to the far contact belonging to the adjacent position; this makes a swapped wire read continuity instead of open.

| connector | adjacent positions | from | unintended far contact | expected |
|---|---|---|---|---|
| J3 | 1-2 | J3.1 | X1.2 | open |
| J3 | 1-2 | J3.2 | X1.1 | open |
| J3 | 2-3 | J3.2 | X1.3 | open |
| J3 | 2-3 | J3.3 | X1.2 | open |
| J4 | 1-2 | J4.1 | FSR.2 | open |
| J4 | 1-2 | J4.2 | FSR.1 | open |
| J4 | 2-3 | J4.2 | SW.1 | open |
| J4 | 2-3 | J4.3 | FSR.2 | open |
| J4 | 3-4 | J4.3 | SW.2 | open |
| J4 | 3-4 | J4.4 | SW.1 | open |
| SM-T | 1-2 | SM-T.1 | SM-W.2 | open |
| SM-T | 1-2 | SM-T.2 | SM-W.1 | open |
| SM-T | 2-3 | SM-T.2 | SM-W.3 | open |
| SM-T | 2-3 | SM-T.3 | SM-W.2 | open |
| SM-T | 3-4 | SM-T.3 | SM-W.4 | open |
| SM-T | 3-4 | SM-T.4 | SM-W.3 | open |
| SM-W | 1-2 | SM-W.1 | SM-T.2 | open |
| SM-W | 1-2 | SM-W.2 | SM-T.1 | open |
| SM-W | 2-3 | SM-W.2 | SM-T.3 | open |
| SM-W | 2-3 | SM-W.3 | SM-T.2 | open |
| SM-W | 3-4 | SM-W.3 | SM-T.4 | open |
| SM-W | 3-4 | SM-W.4 | SM-T.3 | open |
| X1 | 1-2 | X1.1 | J3.2 | open |
| X1 | 1-2 | X1.2 | J3.1 | open |
| X1 | 2-3 | X1.2 | J3.3 | open |
| X1 | 2-3 | X1.3 | J3.2 | open |
| FSR | 1-2 | FSR.1 | J4.2 | open |
| FSR | 1-2 | FSR.2 | J4.1 | open |
| SW | 1-2 | SW.1 | J4.4 | open |
| SW | 1-2 | SW.2 | J4.3 | open |

### Required wrong-build challenge

| wrong build | continuity rows that fail | isolation rows that fail |
|---|---|---|
| mirrored XHP-4 | J4.1 to FSR.1; J4.2 to FSR.2; J4.3 to SW.NO; J4.4 to SW.COM | J4.2 to adjacent remote SW.NO (expected open); J4.3 to adjacent remote FSR.2 (expected open) |
| mirrored SM trunk half | J4.1 to FSR.1; J4.2 to FSR.2; J4.3 to SW.NO; J4.4 to SW.COM | J4.2 to adjacent remote SW.NO (expected open); J4.3 to adjacent remote FSR.2 (expected open) |
| one-position-shifted XHP-4 | J4.1 to FSR.1; J4.2 to FSR.2; J4.3 to SW.NO; J4.4 to SW.COM | J4.1 to adjacent remote FSR.2 (expected open); J4.2 to adjacent remote SW.NO (expected open); J4.3 to adjacent remote SW.COM (expected open) |

### Every single conductor swap

| first | second | signals | detected | physical check |
|---|---|---|---|---|
| J3.1 | J3.2 | GND servo / SERVO_V | yes | continuity procedure |
| J3.1 | J3.3 | GND servo / SERVO_PWM | yes | continuity procedure |
| J3.1 | J4.1 | GND servo / +3V3 | yes | continuity procedure |
| J3.1 | J4.2 | GND servo / FSR_SIG | yes | continuity procedure |
| J3.1 | J4.3 | GND servo / LIM_SIG | yes | continuity procedure |
| J3.1 | J4.4 | GND servo / GND sensor | NO | trace conductor end to end; confirm colour and gauge |
| J3.2 | J3.3 | SERVO_V / SERVO_PWM | yes | continuity procedure |
| J3.2 | J4.1 | SERVO_V / +3V3 | yes | continuity procedure |
| J3.2 | J4.2 | SERVO_V / FSR_SIG | yes | continuity procedure |
| J3.2 | J4.3 | SERVO_V / LIM_SIG | yes | continuity procedure |
| J3.2 | J4.4 | SERVO_V / GND sensor | yes | continuity procedure |
| J3.3 | J4.1 | SERVO_PWM / +3V3 | yes | continuity procedure |
| J3.3 | J4.2 | SERVO_PWM / FSR_SIG | yes | continuity procedure |
| J3.3 | J4.3 | SERVO_PWM / LIM_SIG | yes | continuity procedure |
| J3.3 | J4.4 | SERVO_PWM / GND sensor | yes | continuity procedure |
| J4.1 | J4.2 | +3V3 / FSR_SIG | yes | continuity procedure |
| J4.1 | J4.3 | +3V3 / LIM_SIG | yes | continuity procedure |
| J4.1 | J4.4 | +3V3 / GND sensor | yes | continuity procedure |
| J4.2 | J4.3 | FSR_SIG / LIM_SIG | yes | continuity procedure |
| J4.2 | J4.4 | FSR_SIG / GND sensor | yes | continuity procedure |
| J4.3 | J4.4 | LIM_SIG / GND sensor | yes | continuity procedure |

The procedure detects 20 of 21 swaps. J3.1 servo ground exchanged with J4.4 sensor ground is electrically invisible; trace each conductor and confirm its colour and gauge.
<!-- harness-checks:end -->
