douglaspmcgowan/cloth-feed-gripper/video/gripper/CREDITS.md

# Credits and licences

| Asset | Source | Licence |
|---|---|---|
| 3D geometry | `cad/gripper/out/*.stl`, this repository (CadQuery model `cad/gripper/gripper_concept.py`) | Project's own work |
| Force trace data | `analysis/gripper/firmware_sim/results/fw_sim.json`, this repository | Project's own work |
| Typeface | Archivo, variable (`assets/fonts/Archivo-Variable.ttf`), from github.com/google/fonts `ofl/archivo` | SIL Open Font License 1.1, text in `assets/fonts/OFL.txt` |
| Music and sound design | Synthesised by `audio/make_audio.py` (numpy oscillators, filtered noise, envelopes; fixed seed). No samples, no third-party audio | Project's own work; nothing to license |
| Renderer | Blender 5.1.2 (`bpy` from PyPI), Cycles, OpenImageDenoise | Blender: GPL; the renders are the project's own output |
| Encoder | ffmpeg with libx264 and the native AAC encoder | Tools only; no licence attaches to the output |

No paid assets, paid APIs or stock footage were used.
