douglaspmcgowan/cloth-feed-gripper/docs/gripper/analysis/electrical.md

# Gripper electrical design: power, board, harness

Lane: gripper-electrical. Date: 2026-10-11. Board: SO-101 GRIPPER CTRL rev A.

- **Design files:** `ecad/gripper/design.py` (every part and net), `ecad/gripper/sourcing.py` (what to buy), `ecad/gripper/kicad/` (KiCad 10 project, generated), `ecad/gripper/kicad/fab/` (Gerbers, drill, position, BOM, STEP), `ecad/gripper/HARNESS.md` (cable build guide).
- **Calculations:** `ecad/gripper/calc/*.py`, outputs in `ecad/gripper/calc/out/` (one `.txt` and one `.json` per script).
- **Re-run calculations:** `python ecad/gripper/calc/run_all.py` from the repository root; add `--check` to compare without writing, or `--figures` to refresh figures on request. PNG bytes are stable only when regenerated on one machine. The full build is `python ecad/gripper/build.py` (about 15 minutes; needs KiCad 10). Tests: `python -m pytest ecad/gripper -q`.
- **Tags:** [S] sourced, [D] derived by a committed script (the output file is named), [A] assumed. A number with no tag in a table is from the file named in that table's heading.
- **Words used.** *Buck*: a step-down switching regulator. *Shunt*: a small resistor whose voltage drop measures current. *Stall*: the servo powered but blocked; it draws its largest current. *Fit A / Fit B*: the two servo-current models in `analysis/dyno.md`; Fit A stalls at 3.77 A, Fit B at the datasheet 2.2 A. Which is true is not known until measurement M6. *Plug*: the point where the harness meets the servo's own lead. *ERC / DRC*: KiCad's electrical and design rule checks. *DNP*: do not populate. *Brown-out*: the supply level at which the ESP32 resets itself.

## 0. Answer

<!-- ORDER-STATUS:BEGIN -->
## Order status — DO NOT ORDER

Input provenance uses per-module read granularity; each row lists modules read in margins.json.

- `input-fuse-hold`: missing: F1 MF-MSMF260/16X — hold-current tolerance at 25 C; find in datasheet electrical characteristics table; assembled gripper controller — ams_dropout_max uncertainty or qualification; find in DESIGN-BASIS section 10 corresponding bench step; assembled gripper controller — 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
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
