douglaspmcgowan/cloth-feed-gripper/docs/gripper/analysis/actuation_trade.md

# Actuation trade: which actuator, ratio and drive to buy

Lane gripper-actuation-trade, 2026-10-11, revised after review the same day and rerun on pull request 20's firmware the same evening (section 0, "Rerun with the merged firmware"). **Recommendation: wait for the backordered DSServo DS3230 (row A32 "MG", $27.00 [S], or row A39 "PRO", $25.00 [S]; both list the same figures) and place the backorder today (it has no ship date). Fall back to the DS3235 datasheet part (A19). The only option in stock is the DS3218MG you already have (A17) with a new 1.5:1 gear stage; its arm-weight gate is marginal and it is a redesign, not a purchase.**

What this study does and does not fix:

- **Neither servo meets R14 by itself.** The firmware study measures R14 (true pad force ≥ 5 N through the hold) in **45.1 %** of grips with the present servo, for causes that do not depend on the actuator: finger stiffness, droop and force-sensor span error (pull request 20, not merged, as of 2026-10-11). This study does not model those causes. A stronger servo meets the **R16 hold-torque margin**, which is a different test.
- **Keep:** the 1:1 drive (servo horn on knuckle A, m1.5 z19 sector pair) and the 6.5 ± 0.15 V rail.
- **Change:** gear face width 8 → 10.5 mm (C1); servo pocket 20.4 → 20.5 mm with the servo located by its output boss (tolerance note T14, revision B rows 1 and 3); supply and wiring for ≥ 5 A (E1); three firmware constants and the current trip (section 5).

**Ordering status.** No part is both in stock and clearly passing. The DS3230 MG is backordered at the one vendor checked, with no ship date. The DS3230 **PRO** product page lists the same figures as the MG, $25.00, and also says the 180° version is backordered, while the collection page read earlier the same day showed "In stock" [S, `actuators.csv` row A39]. Which is right is unresolved; check it on the day of ordering.

- **Script:** `analysis/gripper/actuation/actuation_trade.py`. The model is in `model.py`, the add-on calculations in `extras.py`, and the tests in `test_actuation.py`.
  - Inputs: `docs/gripper/research/actuators.csv`, `analysis/gripper/results/gears.json` and `gears.py`, and the rev A (DS3218MG, A17) payload geometry/grip/arm-fit reference, `firmware/gripper/config.h`, `analysis/gripper/firmware_sim/results/fw_sim.json` and `analysis/gripper/thermal/results/thermal.json`, pinned from commit `7e1039a` into `analysis/gripper/actuation/rev_a/` by `pin_rev_a.py`. The historical study reads `rev_a/payload_reference.json`; the live `analysis/gripper/results/payload_torque.json` separately reports current catalogue ranks and ruled selections. Rev B.1 re-based the live firmware on the DS3230 MG this study chose; live CAD geometry must not move the rev A reference either.
- **Re-run** from the repository root: `python3 analysis/gripper/actuation/actuation_trade.py`.
  - `python3 analysis/gripper/actuation/actuation_trade.py --check` recomputes without writing, prints differing JSON keys, and exits nonzero when the committed result is stale.
  - It is seeded and deterministic and takes about 12 min [A, one timed run]. A rerun leaves `git status` clean.
  - It writes `analysis/gripper/actuation/results/actuation_trade.json` and `actuation_trade_stdout.txt`. The JSON has a `definitions` block that says what each probability means.
  - Every number in this note is in that stdout file or the JSON (`decision`, `recommendation`, `configs[]`), unless it is tagged [S] or [A].
- **Tests:** `python3 -m pytest analysis/gripper/actuation -q`. They cover hand calculations, limit cases, agreement with `payload_torque.json`, `gears.py`, `thermal.json` and the compiled-firmware simulation `fw_sim.json`, and agreement of this note's section 0 with the JSON.
- **Tags:**
  - [S] sourced: URL and date are in `actuators.csv`.
  - [D] derived by a repository script.
  - [A] assumed, with the reason.
  - Each model input is listed with its tag in `actuation_trade.json` → `inputs`.
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
