douglaspmcgowan/cloth-feed-gripper/docs/gripper/analysis/controls.md

# Firmware and controls

Gripper firmware and controls lane, 2026-10-11: W2b-1 (2026-10-09), the first controls pass, and its review follow-up (same day). The firmware drives the DS3230 MG PWM servo from an ESP32. A state machine sequences the grip, and a force loop on the finger-B FSR (force-sensing resistor) holds the cloth. `DESIGN-BASIS.md` (DB) wins where this note disagrees.
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
