douglaspmcgowan/cloth-feed-gripper/cad/gripper/viewer_src/shots/after_tolerances_375_dark.png

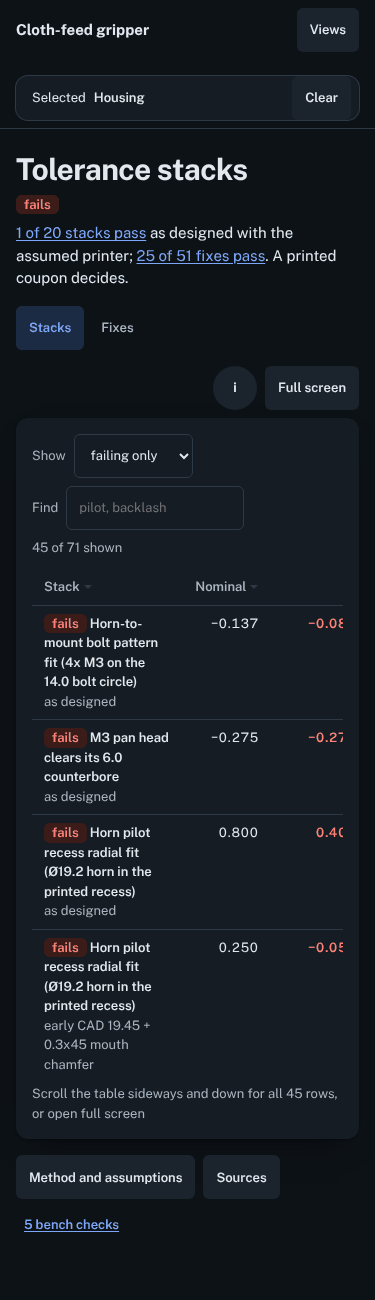
cad/gripper/viewer_src/shots/after_tolerances_375_dark.png
