douglaspmcgowan/cloth-feed-gripper/cad/gripper/viewer_src/shots/before_finger-stiffness_375_dark.png

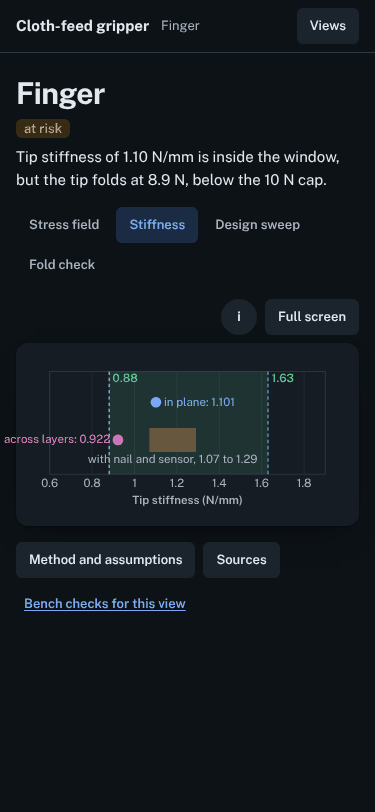
cad/gripper/viewer_src/shots/before_finger-stiffness_375_dark.png
