douglaspmcgowan/cloth-feed-gripper/cad/gripper/viewer_src/shots/before_fit_1440_light.png

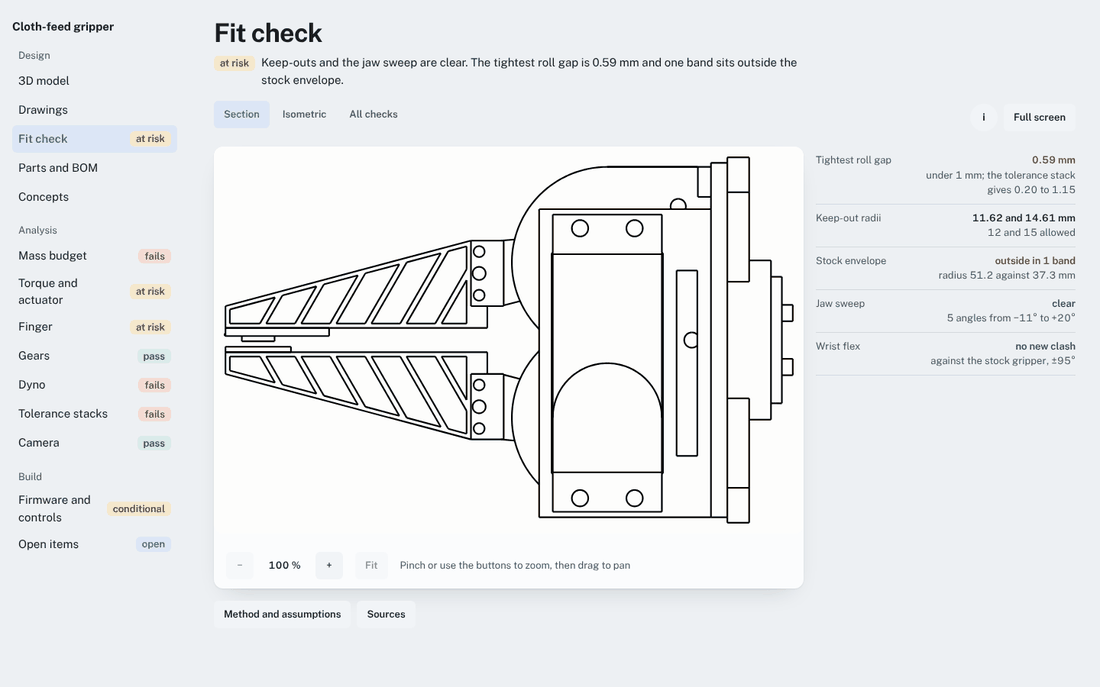
cad/gripper/viewer_src/shots/before_fit_1440_light.png
