douglaspmcgowan/cloth-feed-gripper/cad/gripper/viewer_src/shots/fit3d_1440_light.png

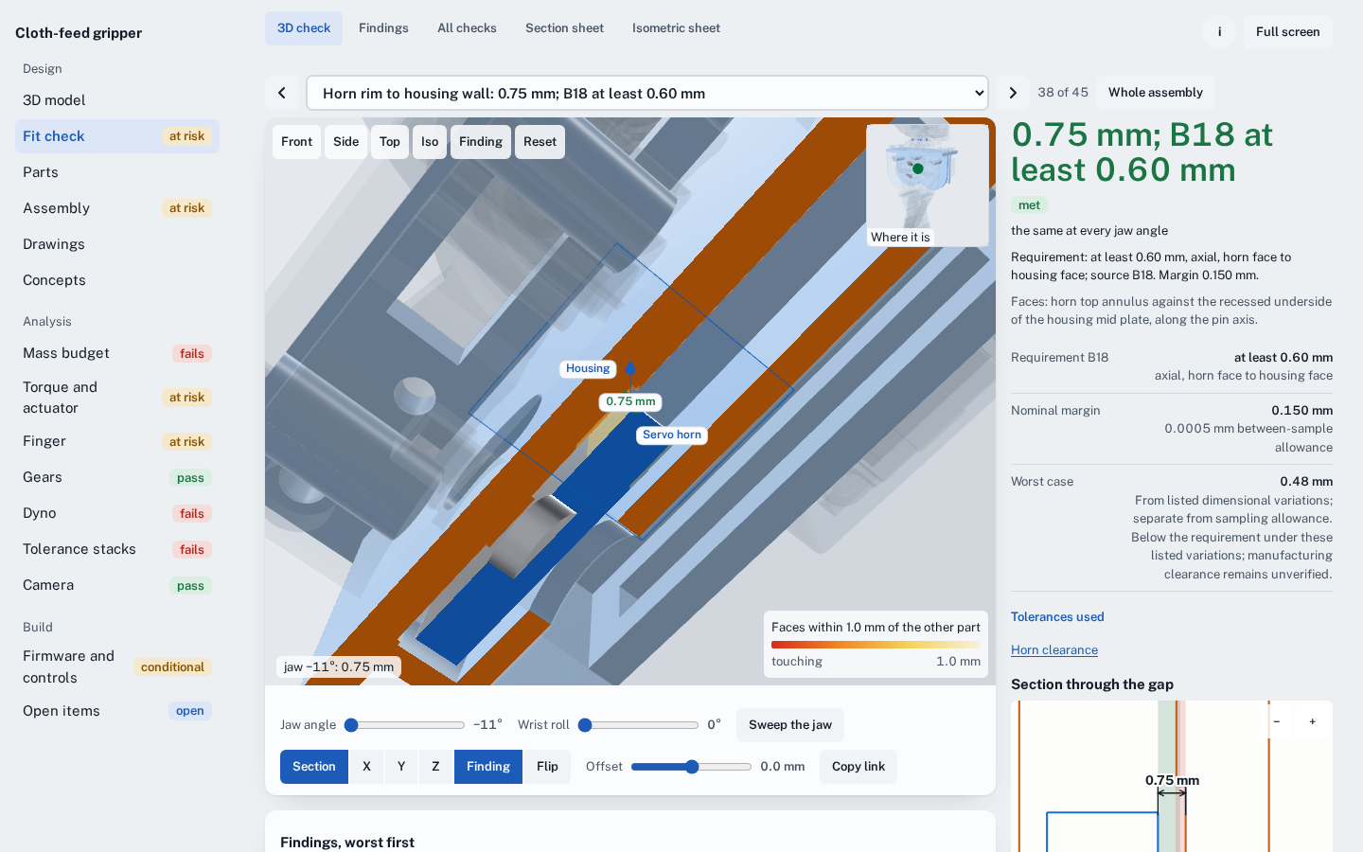
cad/gripper/viewer_src/shots/fit3d_1440_light.png
