douglaspmcgowan/cloth-feed-gripper/cad/gripper/viewer_src/shots/fit3d_b19_finger_b_1440_light.png

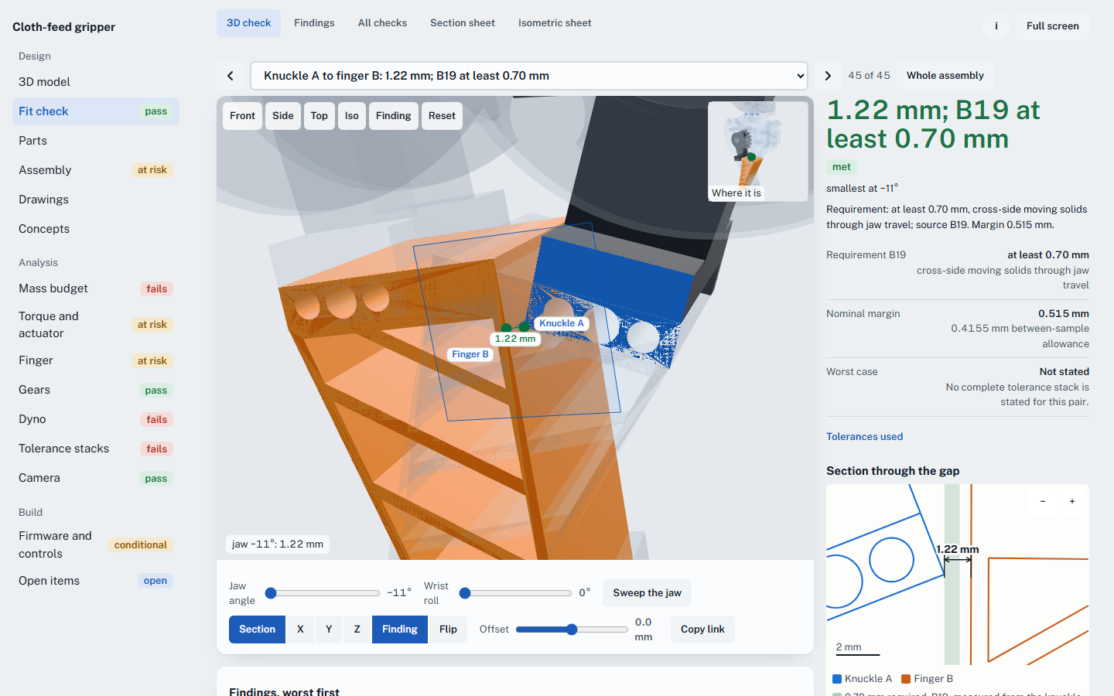
cad/gripper/viewer_src/shots/fit3d_b19_finger_b_1440_light.png
