douglaspmcgowan/cloth-feed-gripper/cad/gripper/viewer_src/shots/fit3d_deck_screw_1_1440_light.png

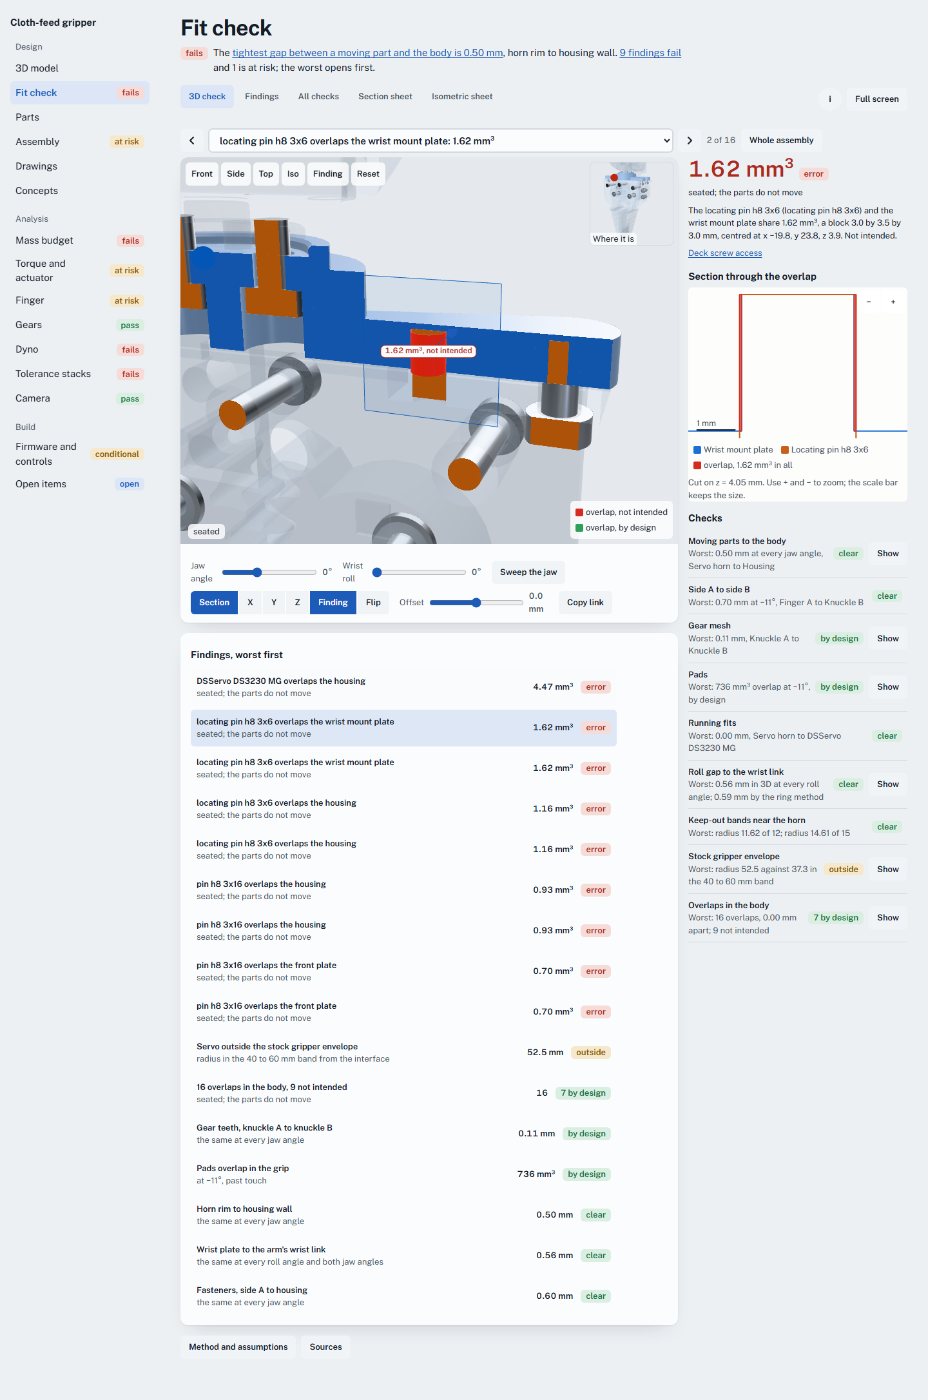
cad/gripper/viewer_src/shots/fit3d_deck_screw_1_1440_light.png
