douglaspmcgowan/cloth-feed-gripper/cad/gripper/viewer_src/shots/fit_findings_1440_light.png

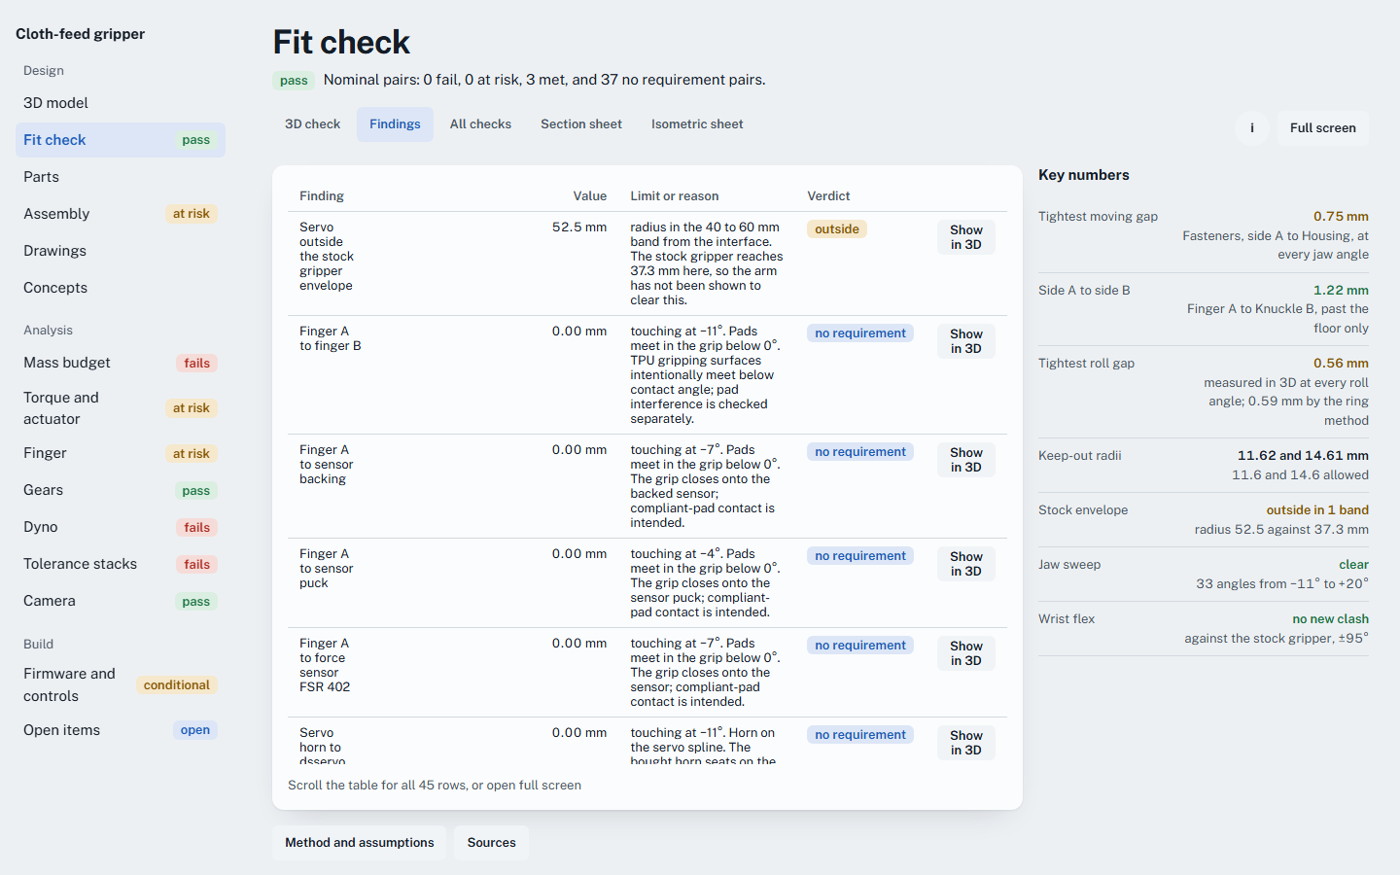
cad/gripper/viewer_src/shots/fit_findings_1440_light.png
