douglaspmcgowan/cloth-feed-gripper/cad/gripper/viewer_src/shots/lib_babylon.png

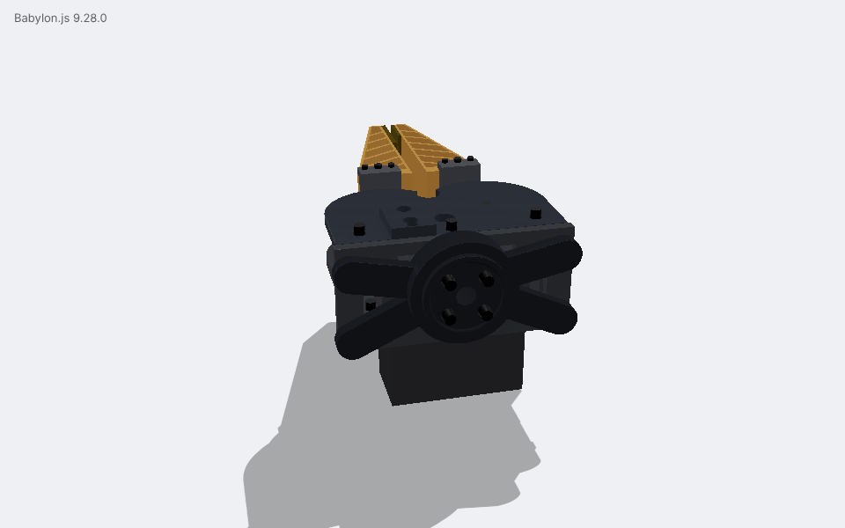
cad/gripper/viewer_src/shots/lib_babylon.png
