douglaspmcgowan/cloth-feed-gripper/cad/gripper/viewer_src/shots/lib_threejs.png

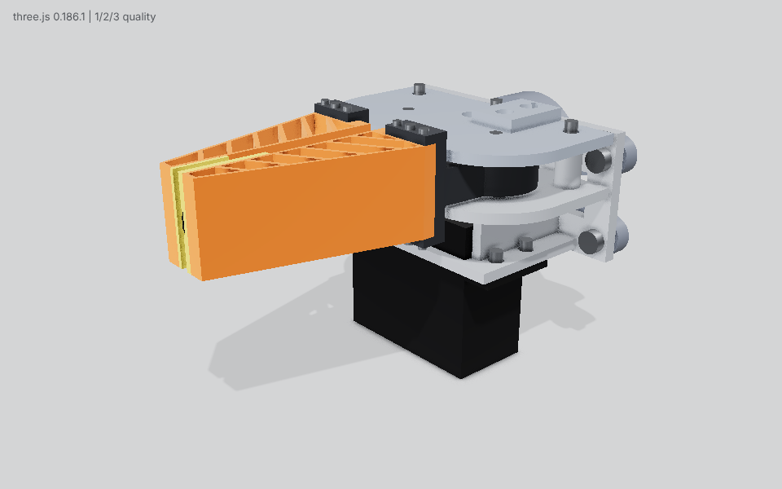
cad/gripper/viewer_src/shots/lib_threejs.png
