douglaspmcgowan/cloth-feed-gripper/cad/gripper/viewer_src/shots/lib_threejs_q0.png

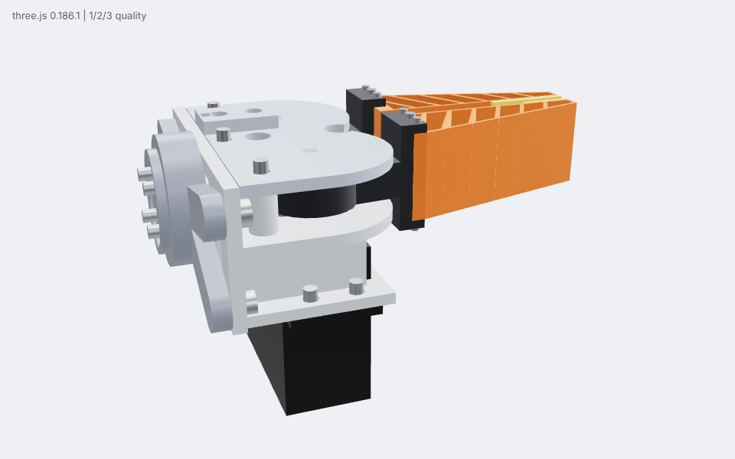
cad/gripper/viewer_src/shots/lib_threejs_q0.png
