douglaspmcgowan/cloth-feed-gripper/cad/gripper/viewer_src/shots/open_requirements_375_dark.png

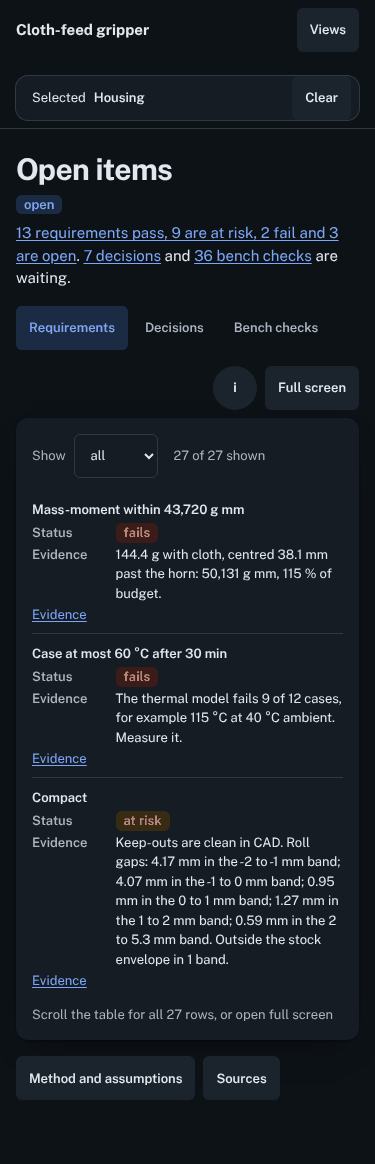
cad/gripper/viewer_src/shots/open_requirements_375_dark.png
