douglaspmcgowan/cloth-feed-gripper/docs/gripper/evidence/camera-resume-20261023/prior-diagnosis/baseline-model-exploded-390x844.png

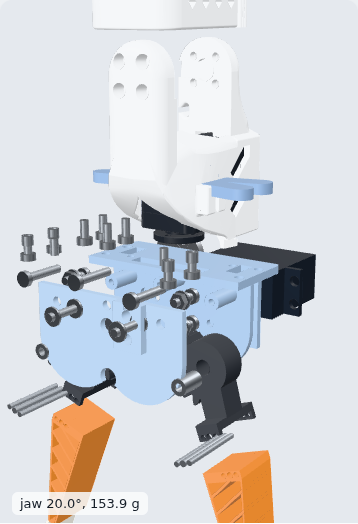
docs/gripper/evidence/camera-resume-20261023/prior-diagnosis/baseline-model-exploded-390x844.png
