douglaspmcgowan/cloth-feed-gripper/docs/gripper/evidence/camera-resume-20261023/source2-green/dependency-terminal-390.png

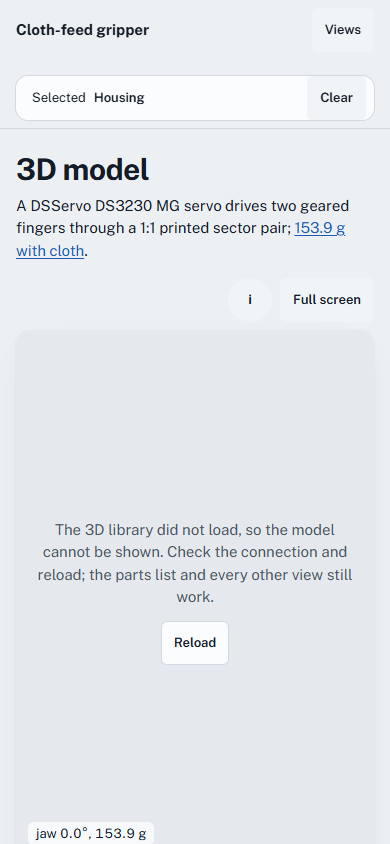
docs/gripper/evidence/camera-resume-20261023/source2-green/dependency-terminal-390.png
