douglaspmcgowan/cloth-feed-gripper/docs/gripper/evidence/camera-resume-20261023/source2-red/fit-late-host-attach.png

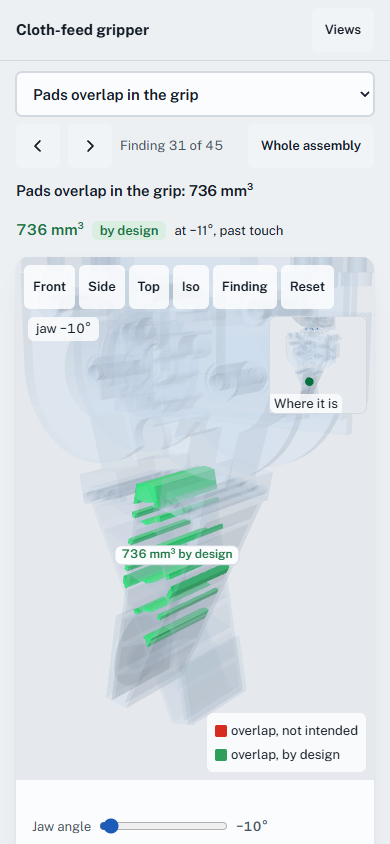
docs/gripper/evidence/camera-resume-20261023/source2-red/fit-late-host-attach.png
