douglaspmcgowan/cloth-feed-gripper/docs/gripper/evidence/camera-resume-20261023/source2-red/model-768x1024/exploded-midpoint.png

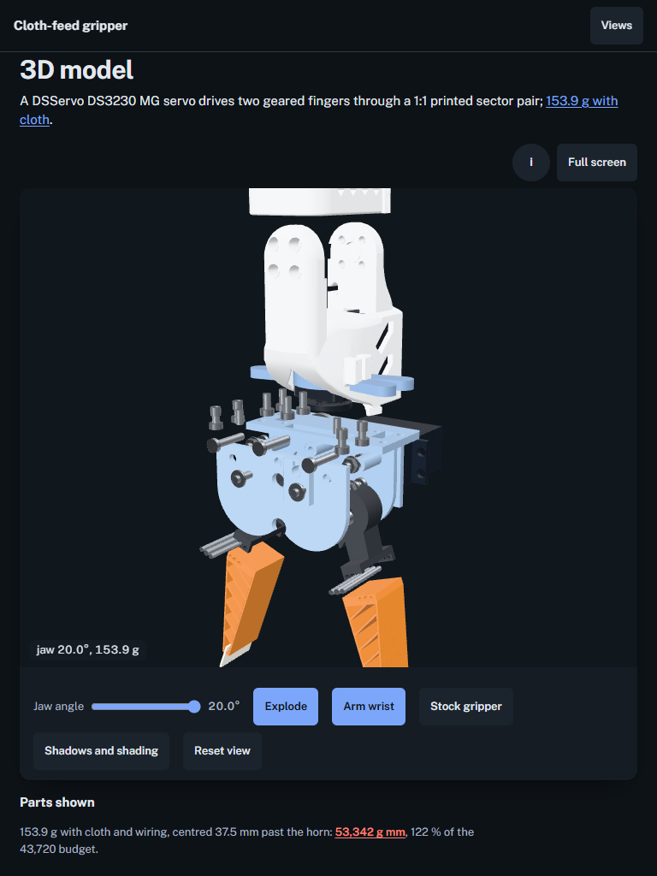
docs/gripper/evidence/camera-resume-20261023/source2-red/model-768x1024/exploded-midpoint.png
