douglaspmcgowan/cloth-feed-gripper/docs/gripper/evidence/ui-publication-20261023/dependency-initial-390.png

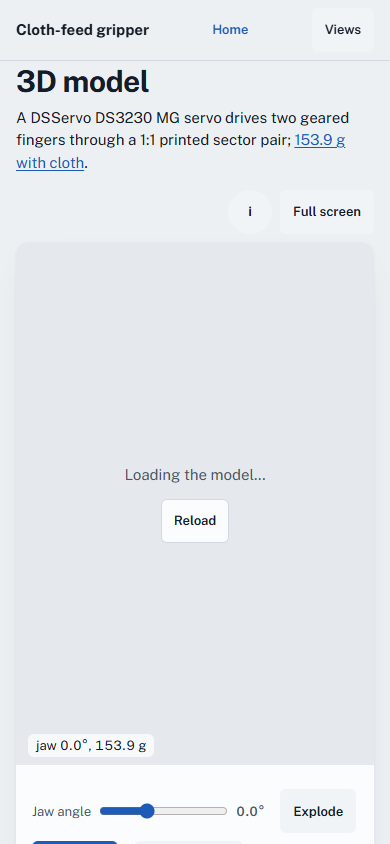
docs/gripper/evidence/ui-publication-20261023/dependency-initial-390.png
