douglaspmcgowan/cloth-feed-gripper/docs/gripper/evidence/ui-publication-20261023/finding-gap-390x844.png

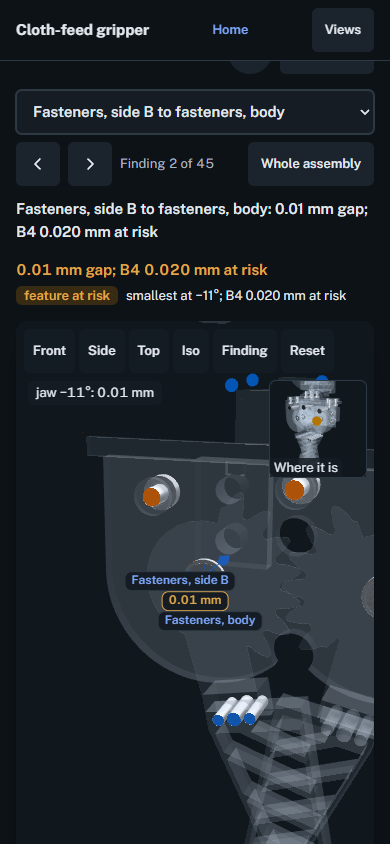
docs/gripper/evidence/ui-publication-20261023/finding-gap-390x844.png
