douglaspmcgowan/cloth-feed-gripper/docs/gripper/evidence/ui-publication-20261023/finding-overlap-768x1024.png

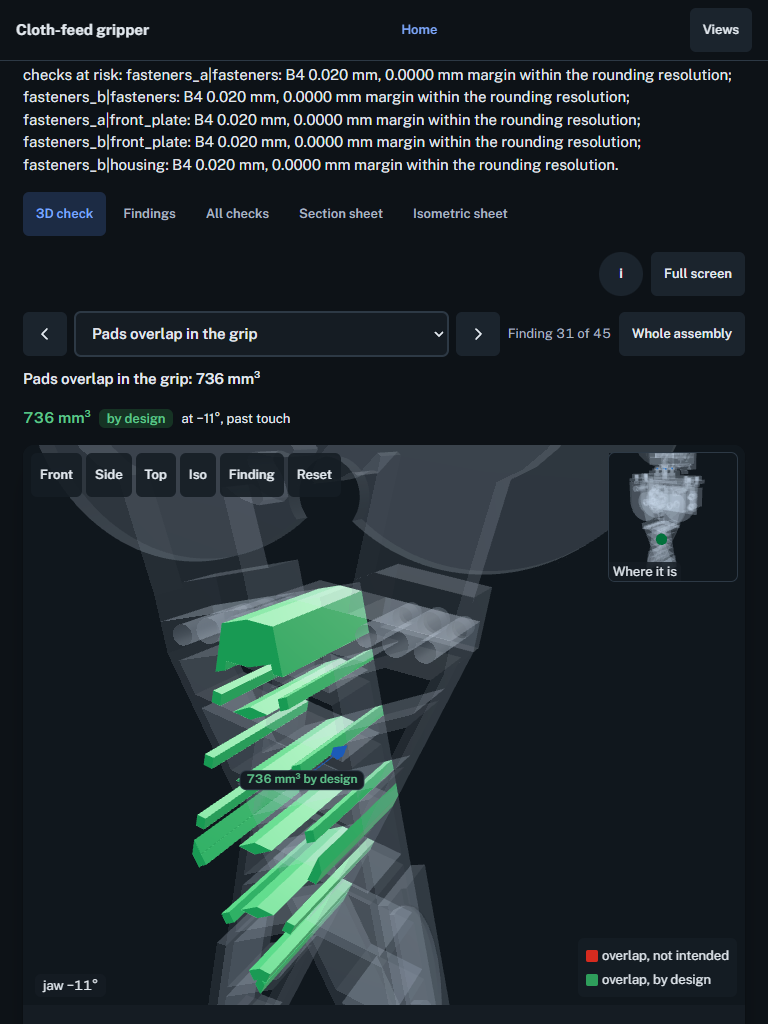
docs/gripper/evidence/ui-publication-20261023/finding-overlap-768x1024.png
