douglaspmcgowan/cloth-feed-gripper/docs/gripper/figures/actuator_scores.png

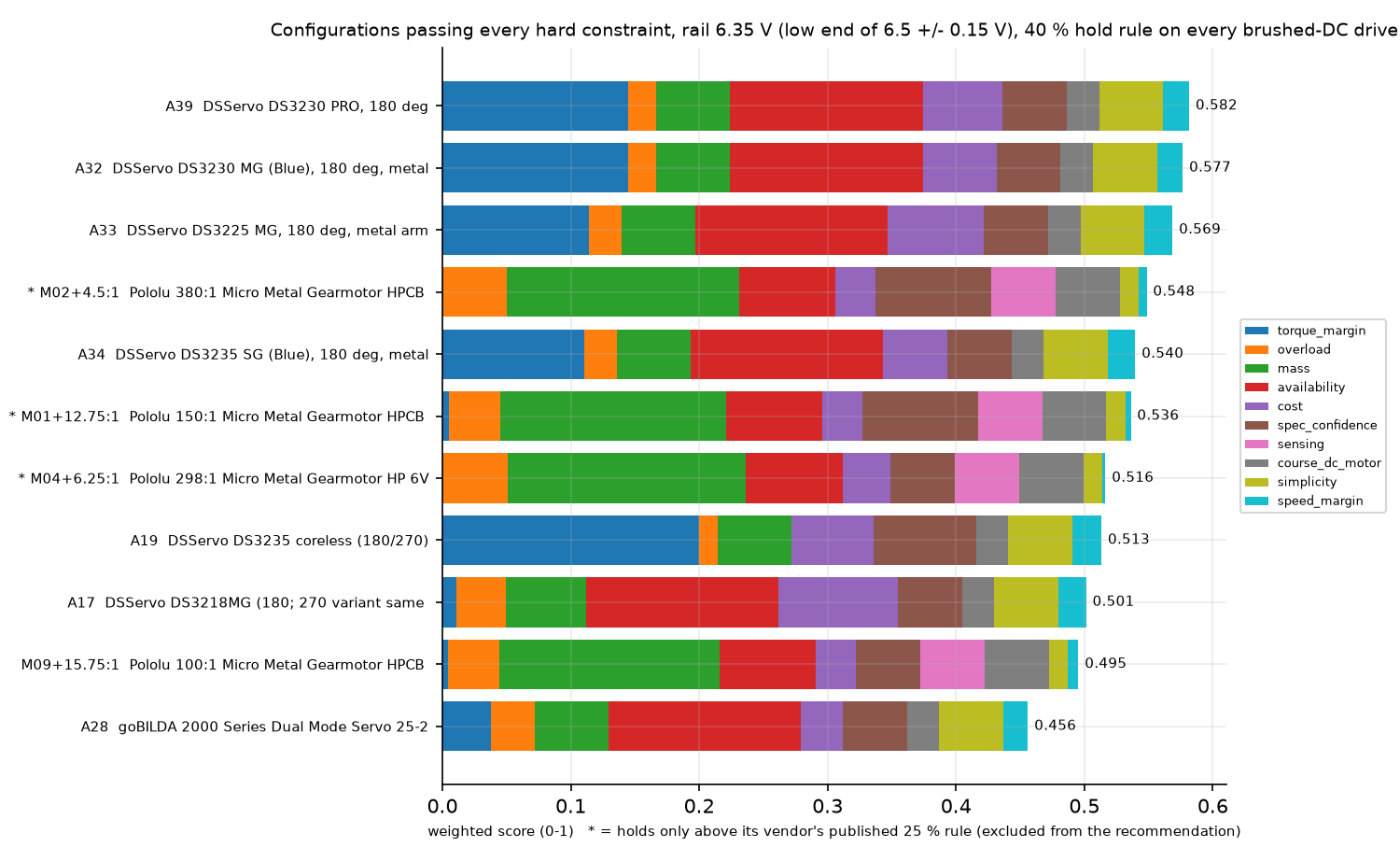
docs/gripper/figures/actuator_scores.png
