douglaspmcgowan/cloth-feed-gripper/docs/gripper/figures/actuator_torque_tornado.png

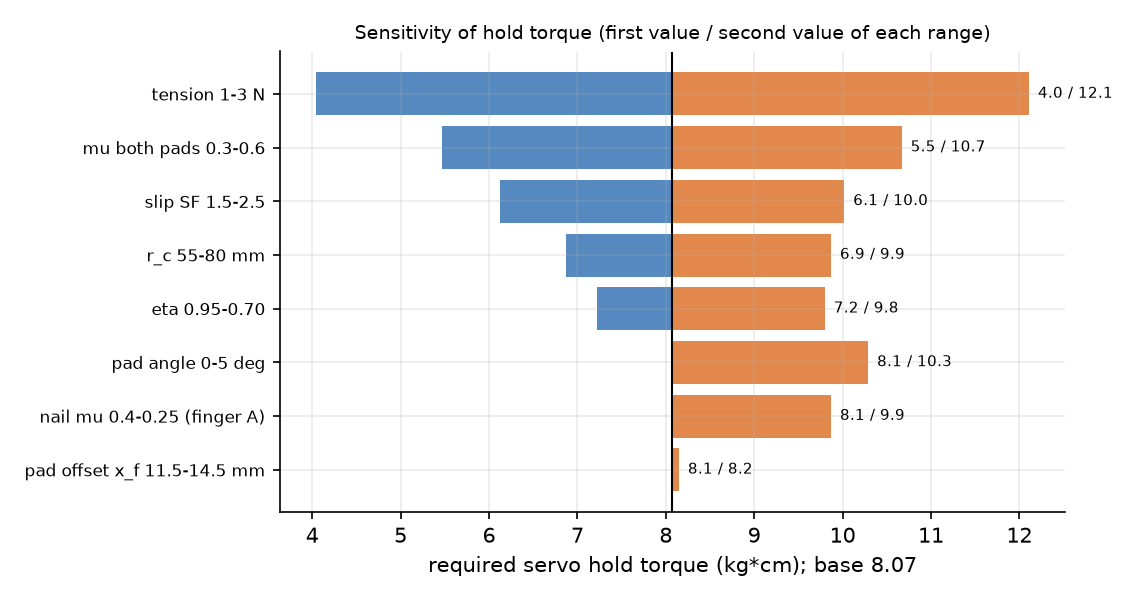
docs/gripper/figures/actuator_torque_tornado.png
