douglaspmcgowan/cloth-feed-gripper/docs/gripper/figures/actuator_torque_vs_lever.png

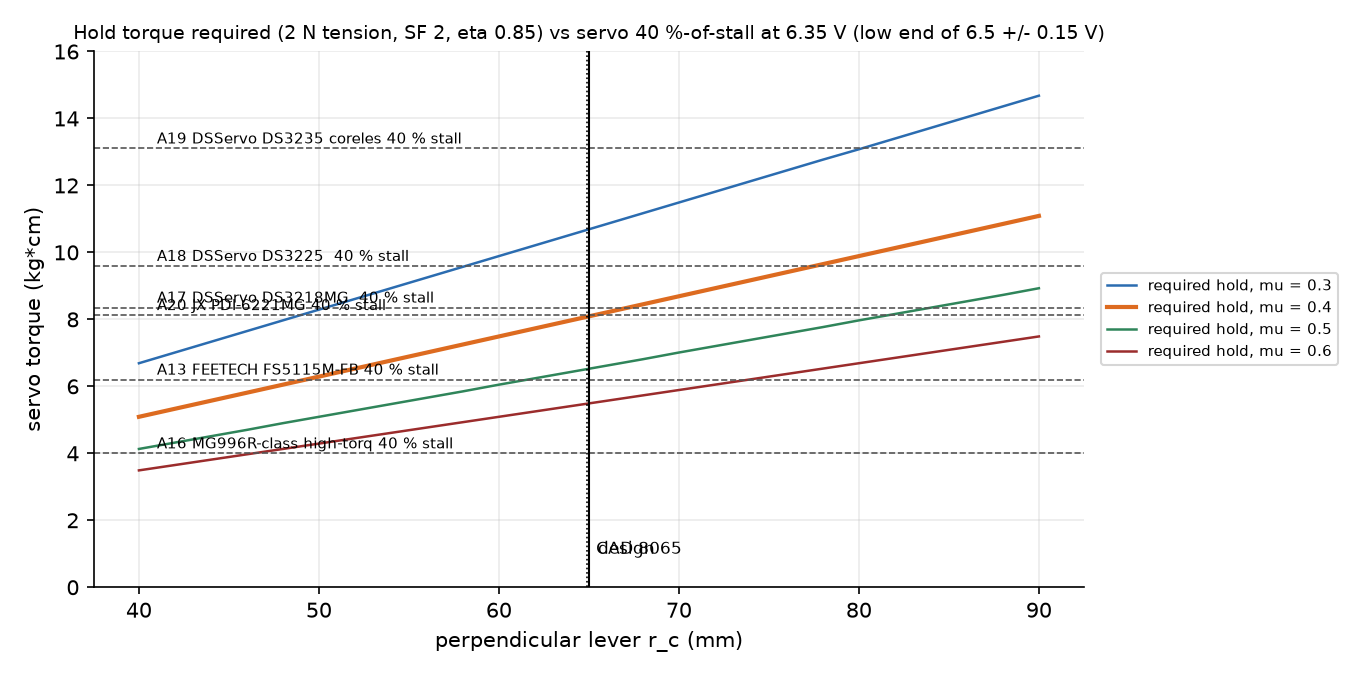
docs/gripper/figures/actuator_torque_vs_lever.png
