douglaspmcgowan/cloth-feed-gripper/docs/gripper/figures/actuator_weight_sensitivity.png

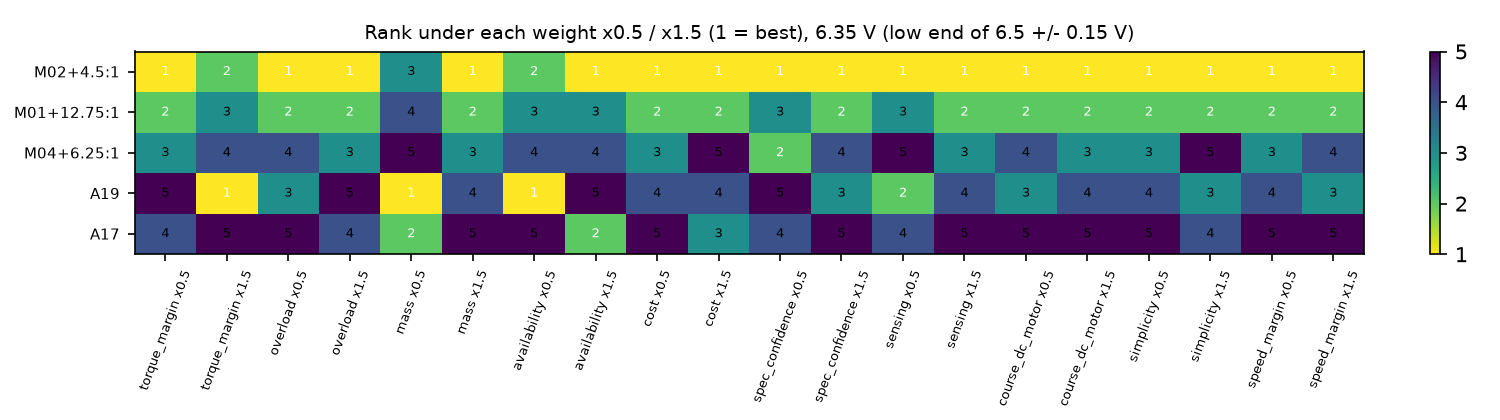
docs/gripper/figures/actuator_weight_sensitivity.png
