douglaspmcgowan/cloth-feed-gripper/docs/gripper/figures/camera_views.png

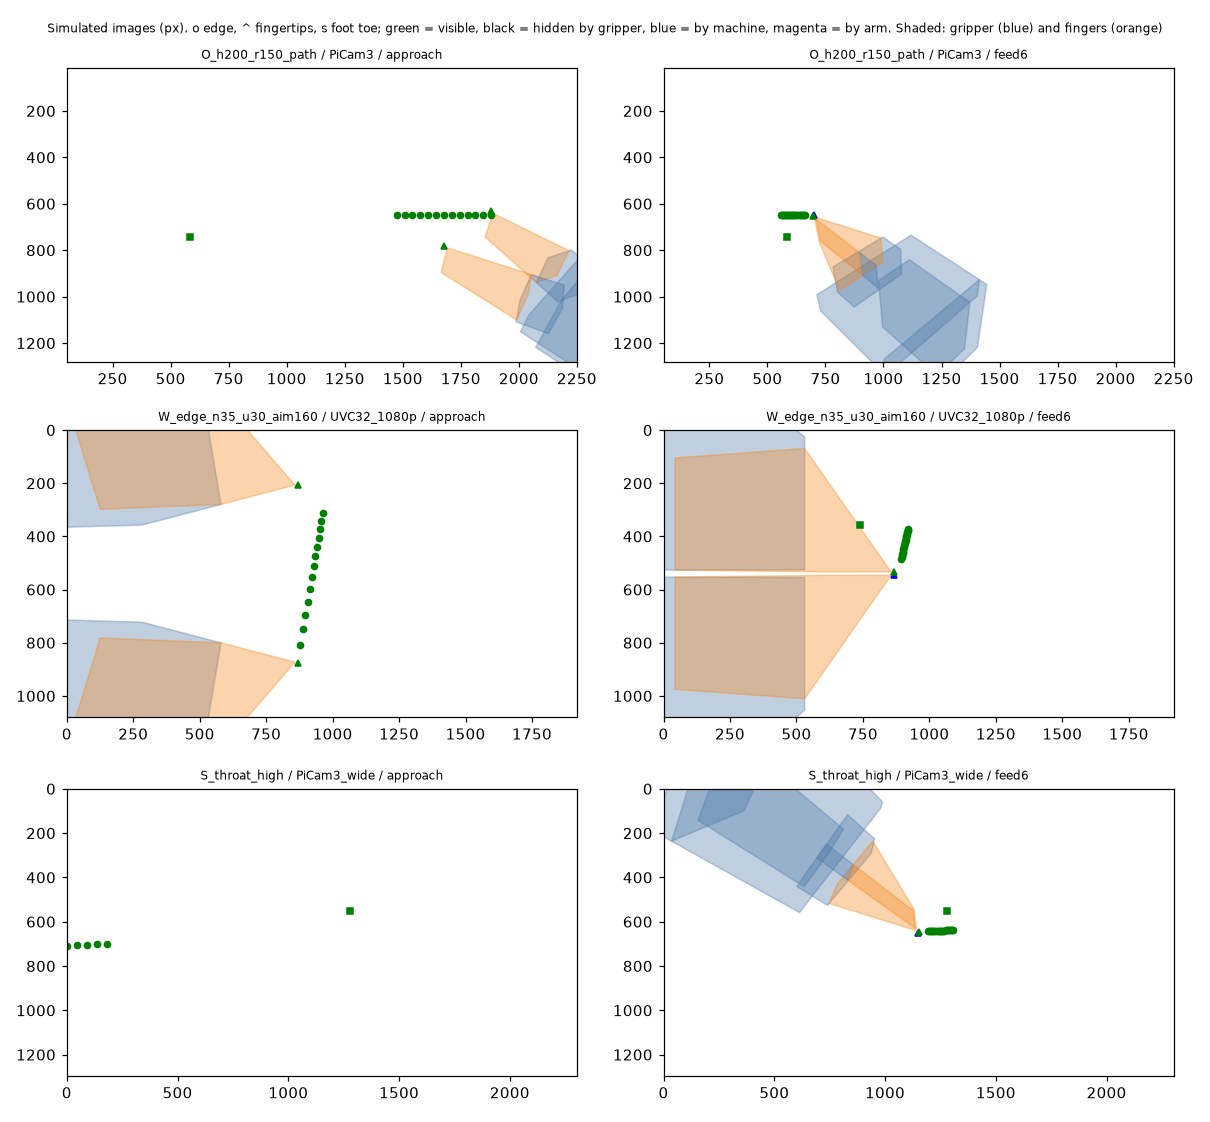
docs/gripper/figures/camera_views.png
