douglaspmcgowan/cloth-feed-gripper/docs/gripper/figures/controls_noise.png

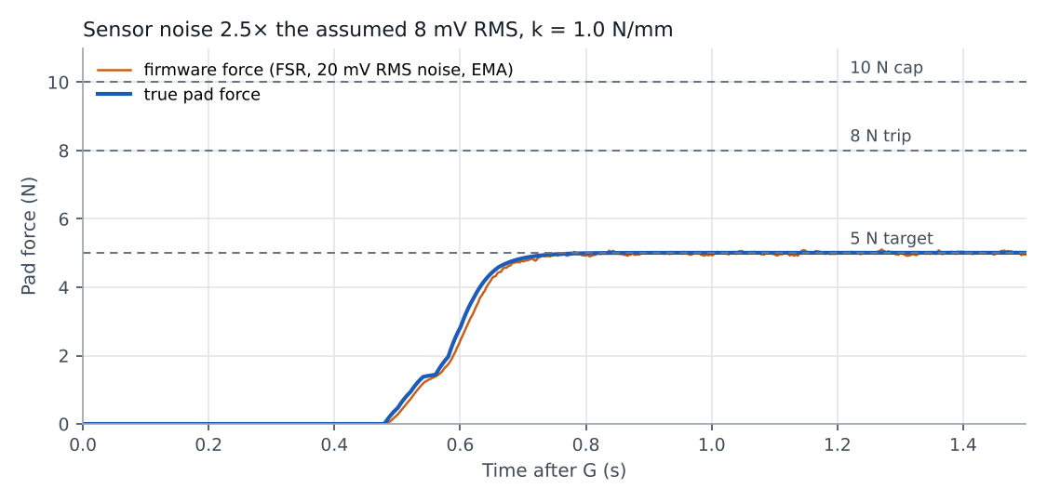
docs/gripper/figures/controls_noise.png
