douglaspmcgowan/cloth-feed-gripper/docs/gripper/figures/dyno_duty_cycle.png

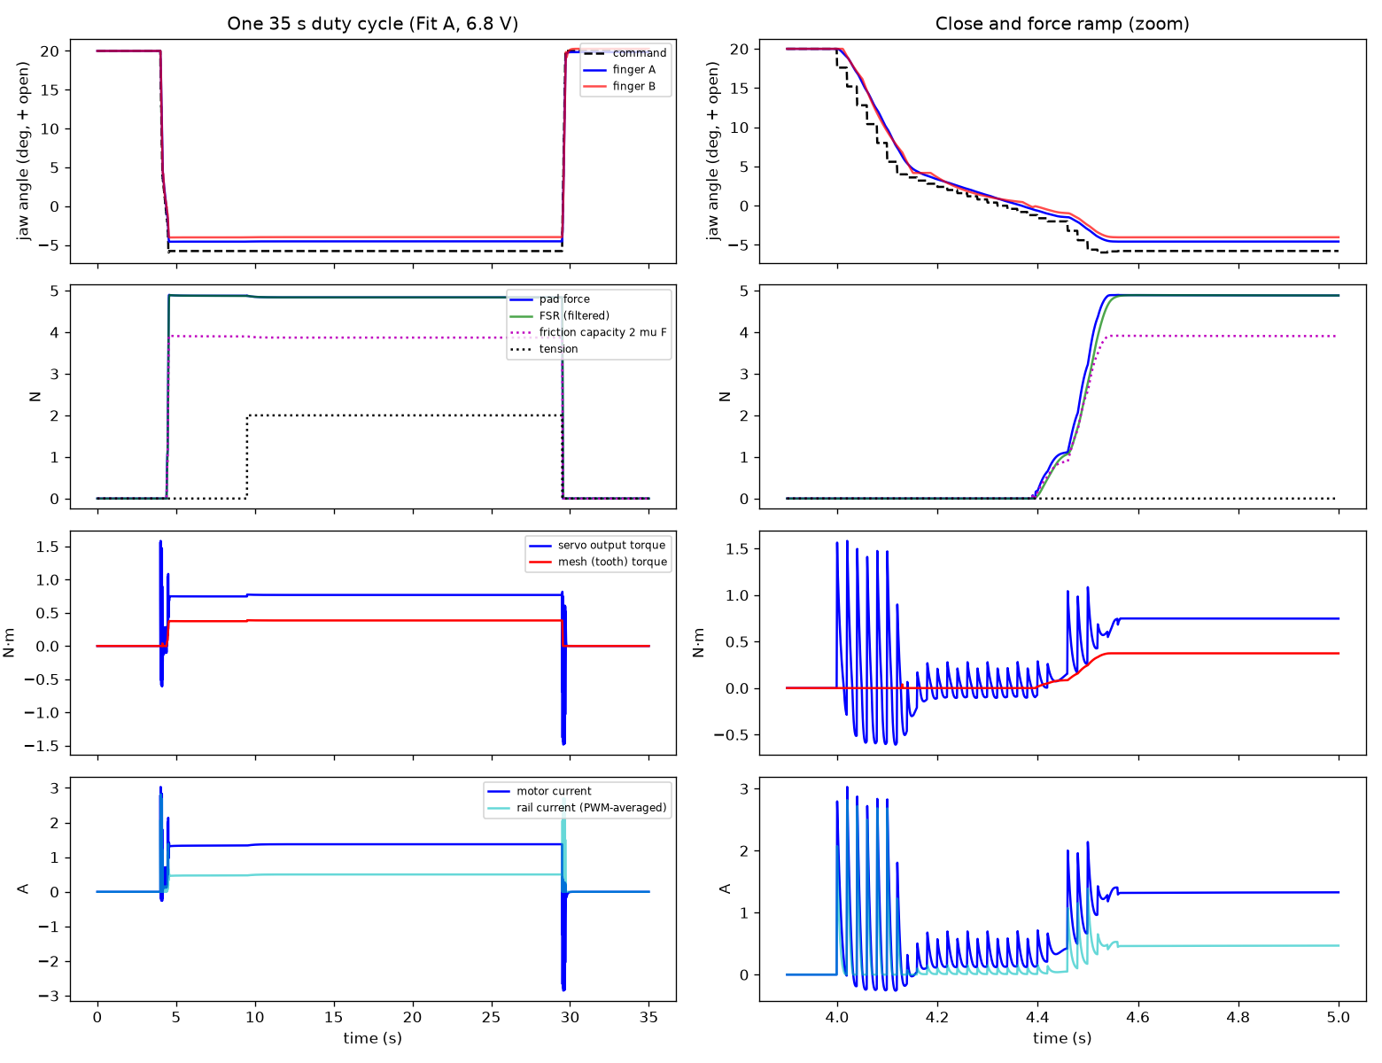
docs/gripper/figures/dyno_duty_cycle.png
