douglaspmcgowan/cloth-feed-gripper/docs/gripper/figures/dyno_fatigue.png

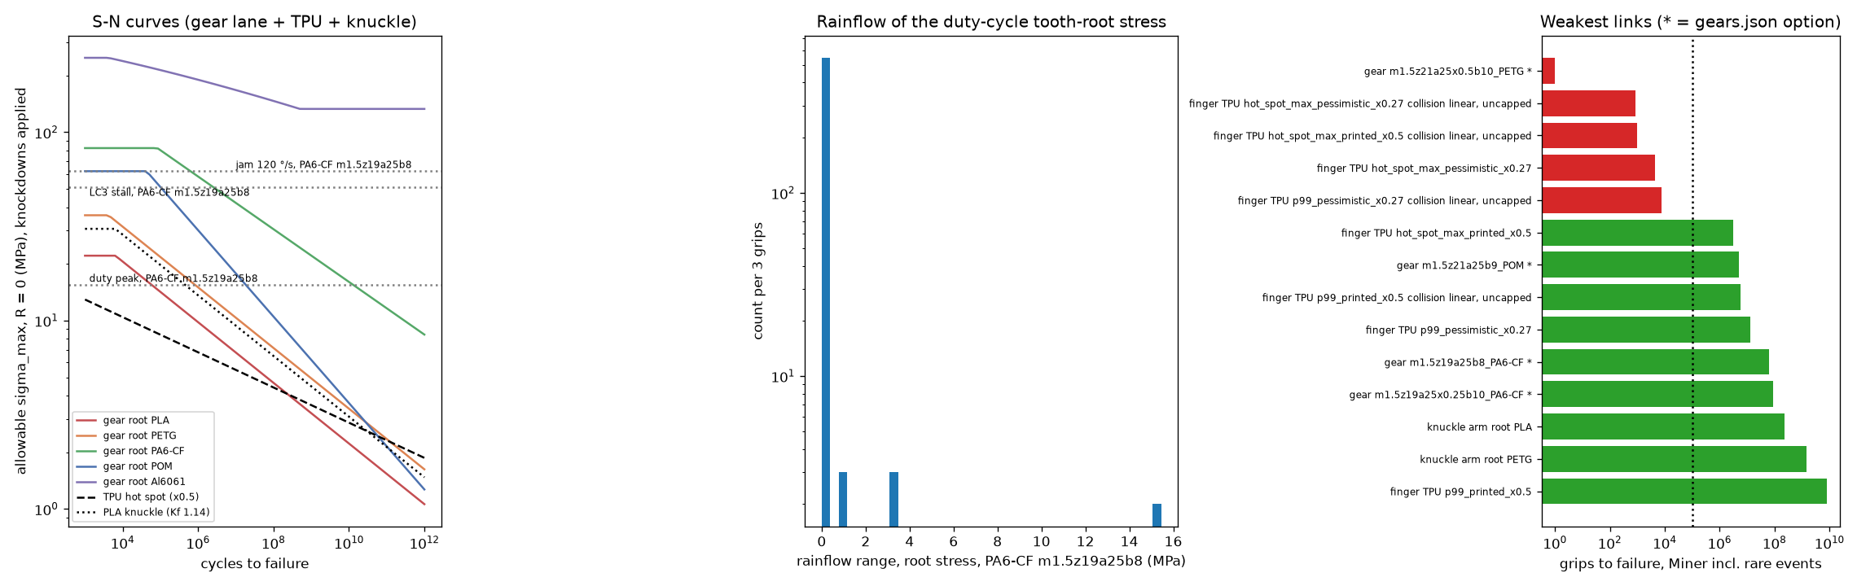
docs/gripper/figures/dyno_fatigue.png
