douglaspmcgowan/cloth-feed-gripper/docs/gripper/figures/dyno_per_cycle.png

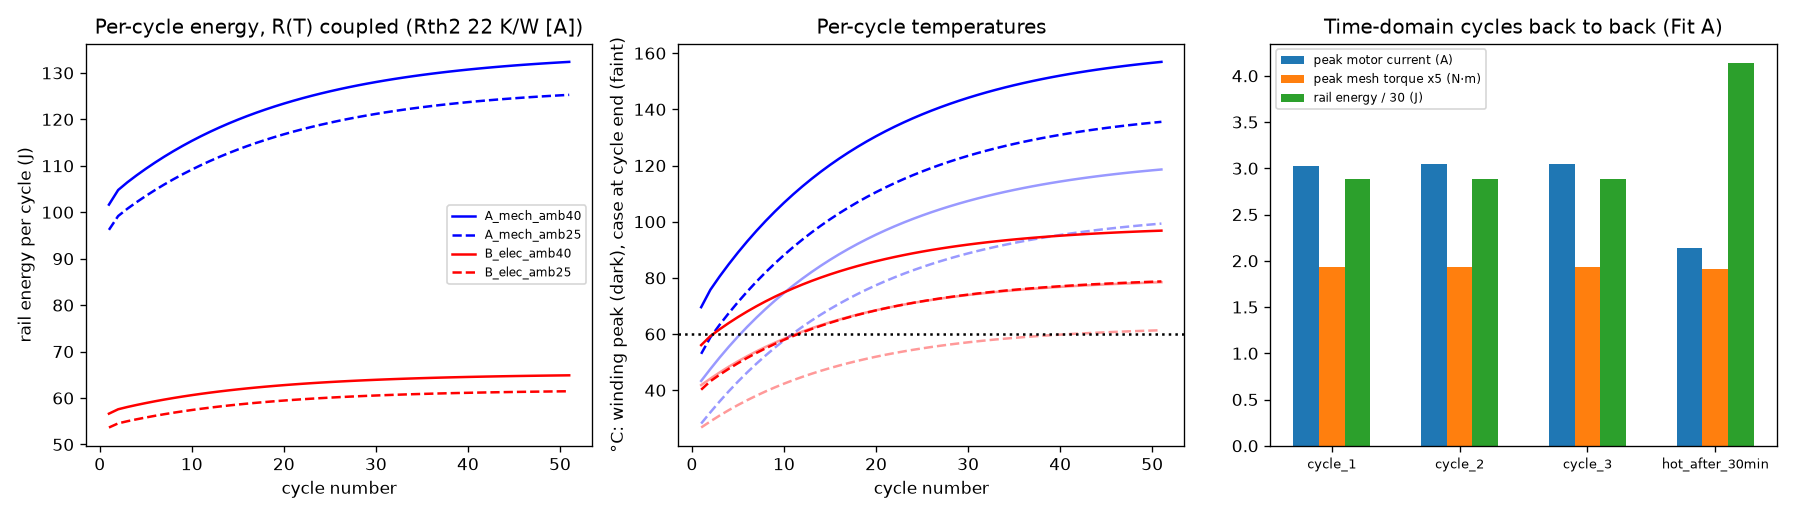
docs/gripper/figures/dyno_per_cycle.png
