douglaspmcgowan/cloth-feed-gripper/docs/gripper/figures/dyno_shock.png

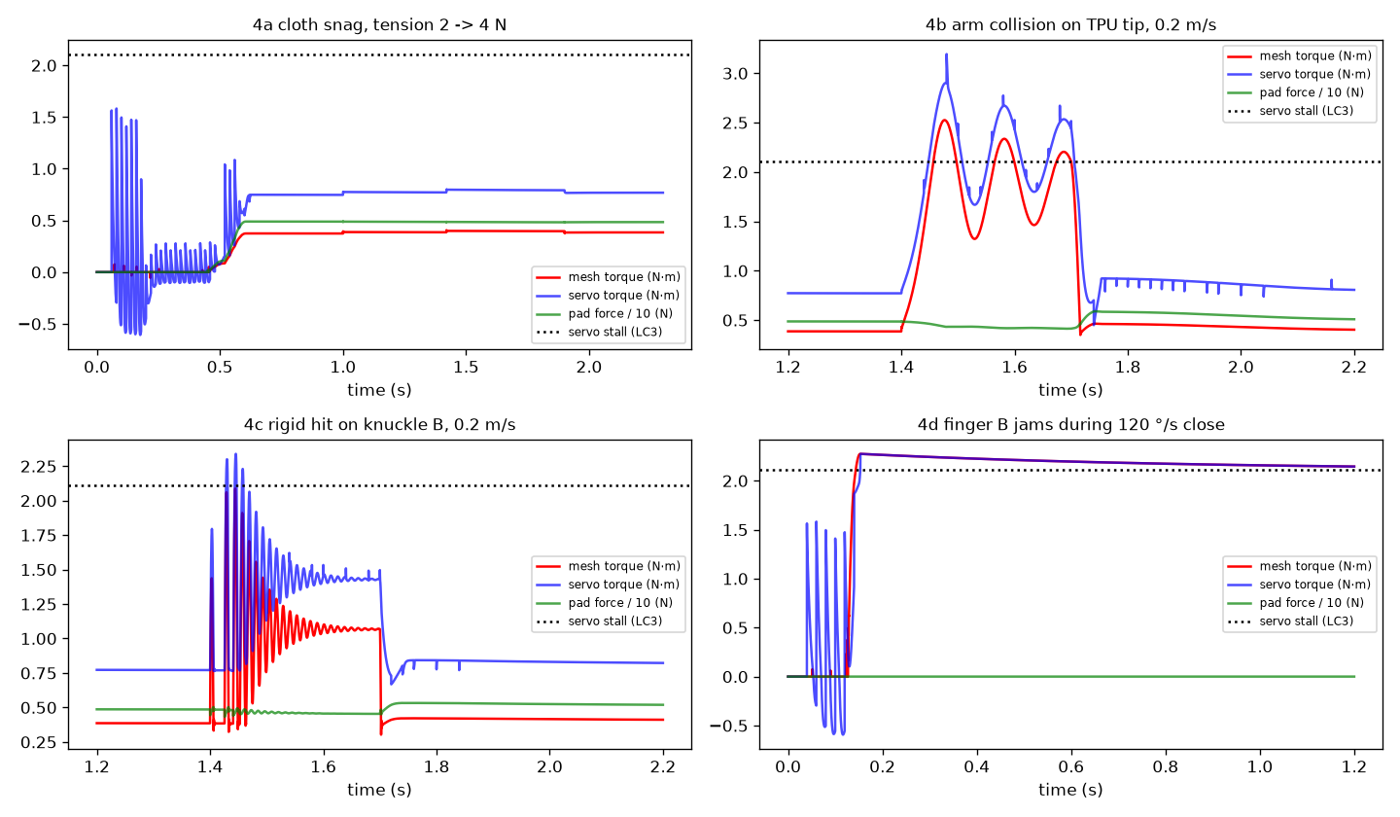
docs/gripper/figures/dyno_shock.png
