douglaspmcgowan/cloth-feed-gripper/docs/gripper/figures/dyno_stall.png

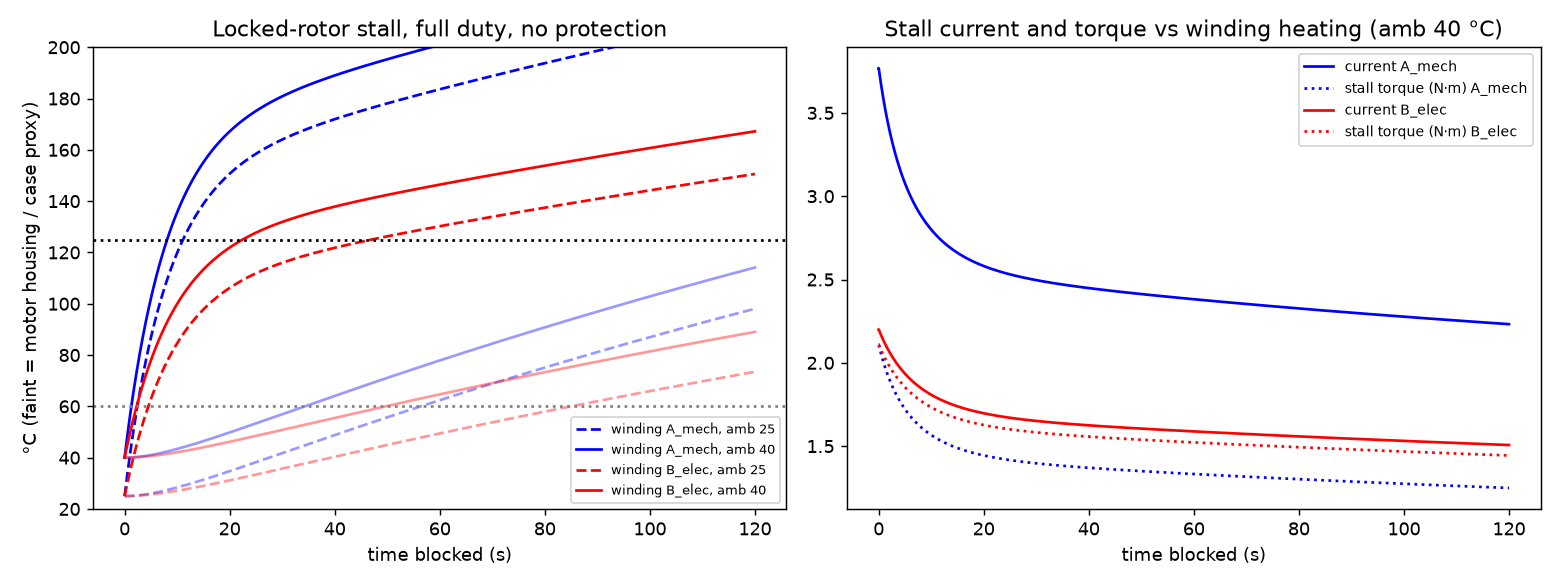
docs/gripper/figures/dyno_stall.png
