douglaspmcgowan/cloth-feed-gripper/docs/gripper/figures/dyno_thermal_30min.png

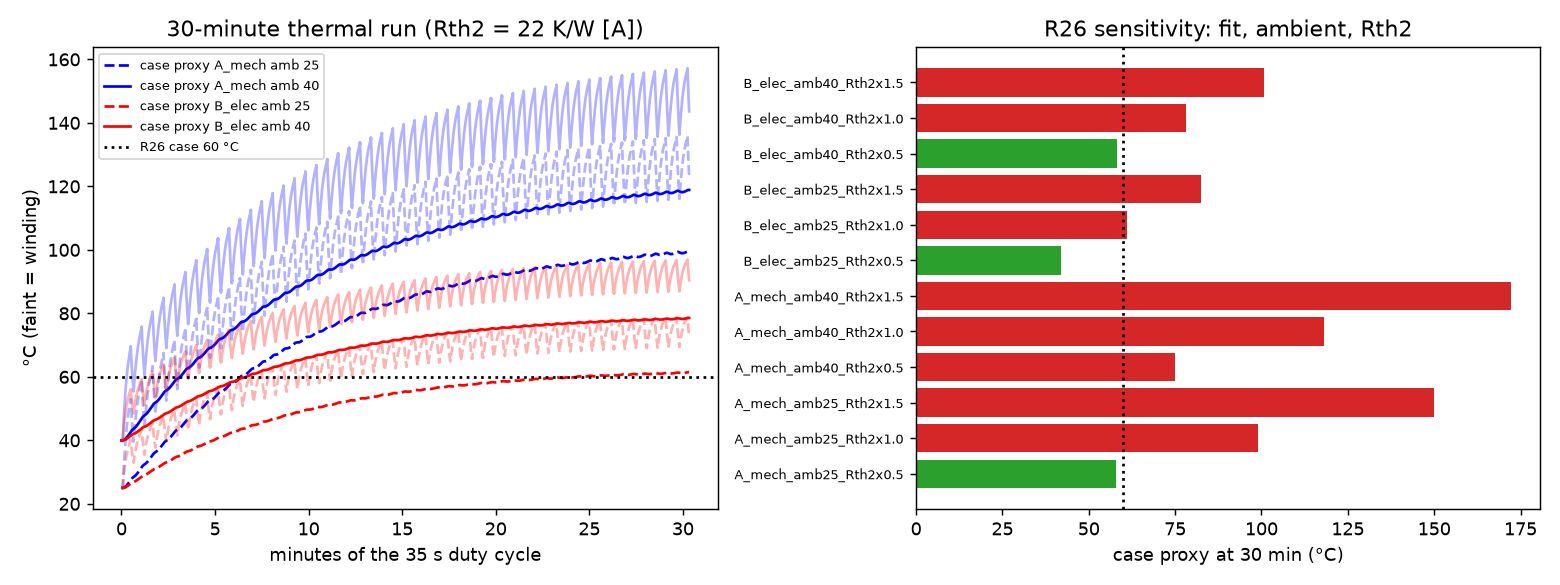
docs/gripper/figures/dyno_thermal_30min.png
