douglaspmcgowan/cloth-feed-gripper/docs/gripper/figures/fea_nl_mode.png

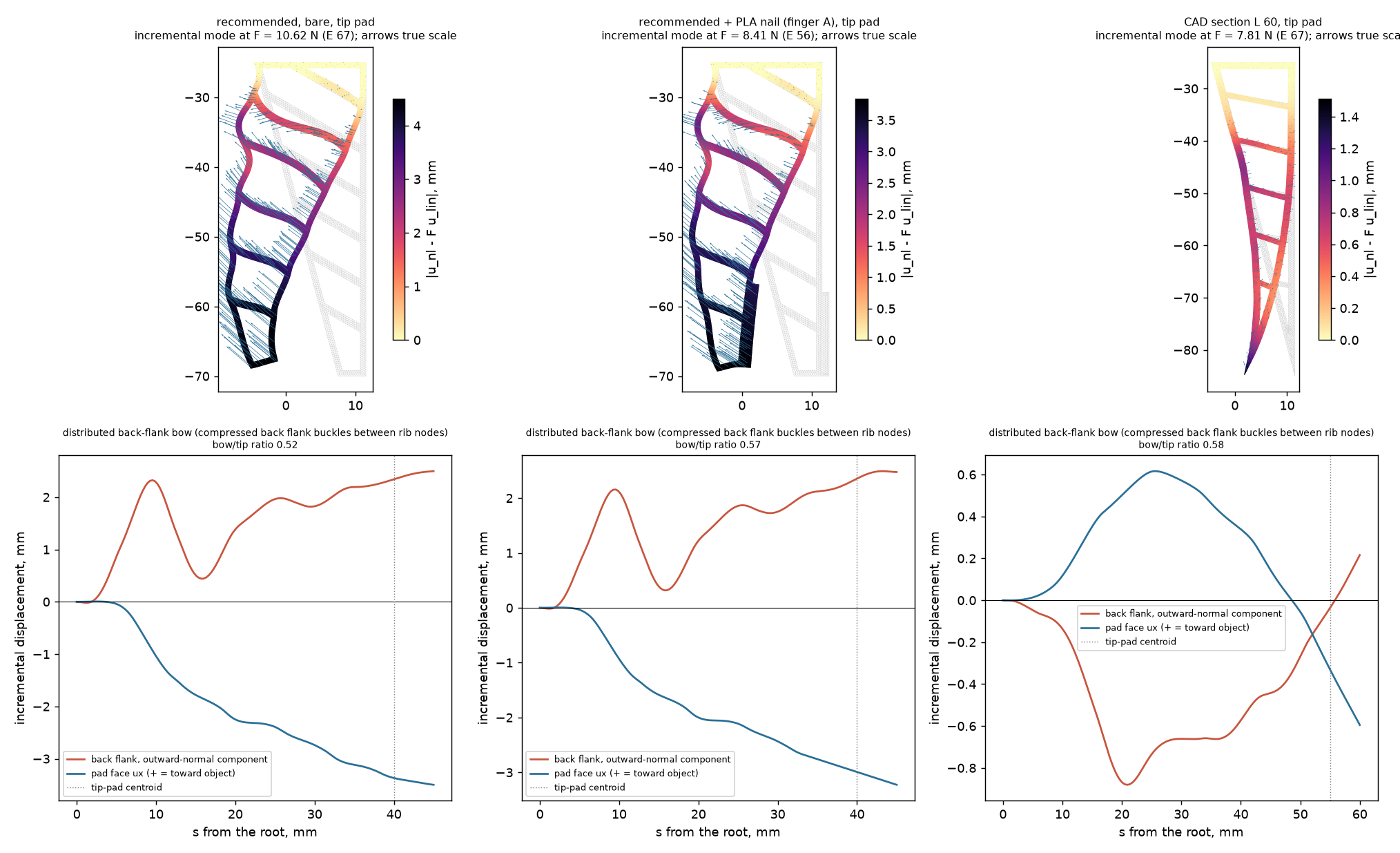
docs/gripper/figures/fea_nl_mode.png
