douglaspmcgowan/cloth-feed-gripper/docs/gripper/figures/fea_stress.png

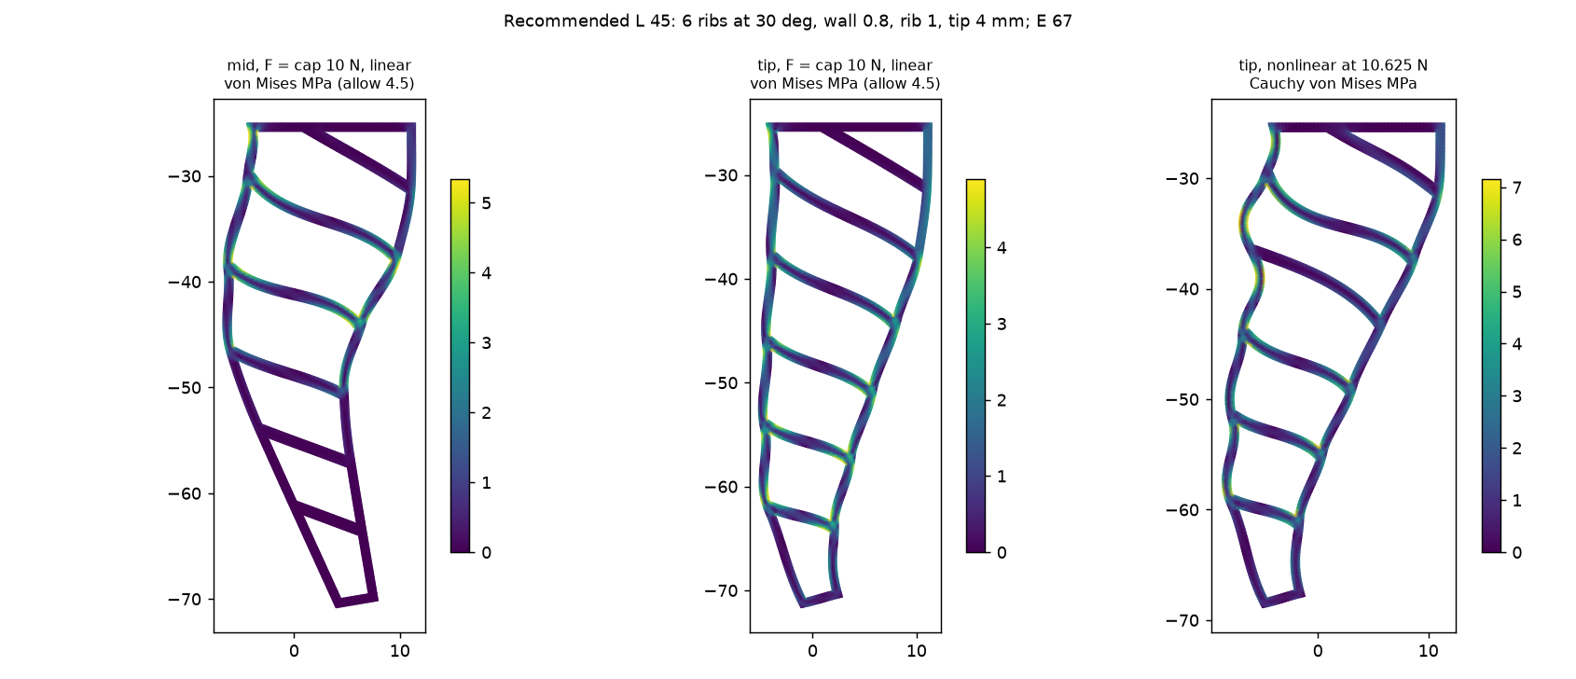
docs/gripper/figures/fea_stress.png
