douglaspmcgowan/cloth-feed-gripper/docs/gripper/figures/fea_sweep.png

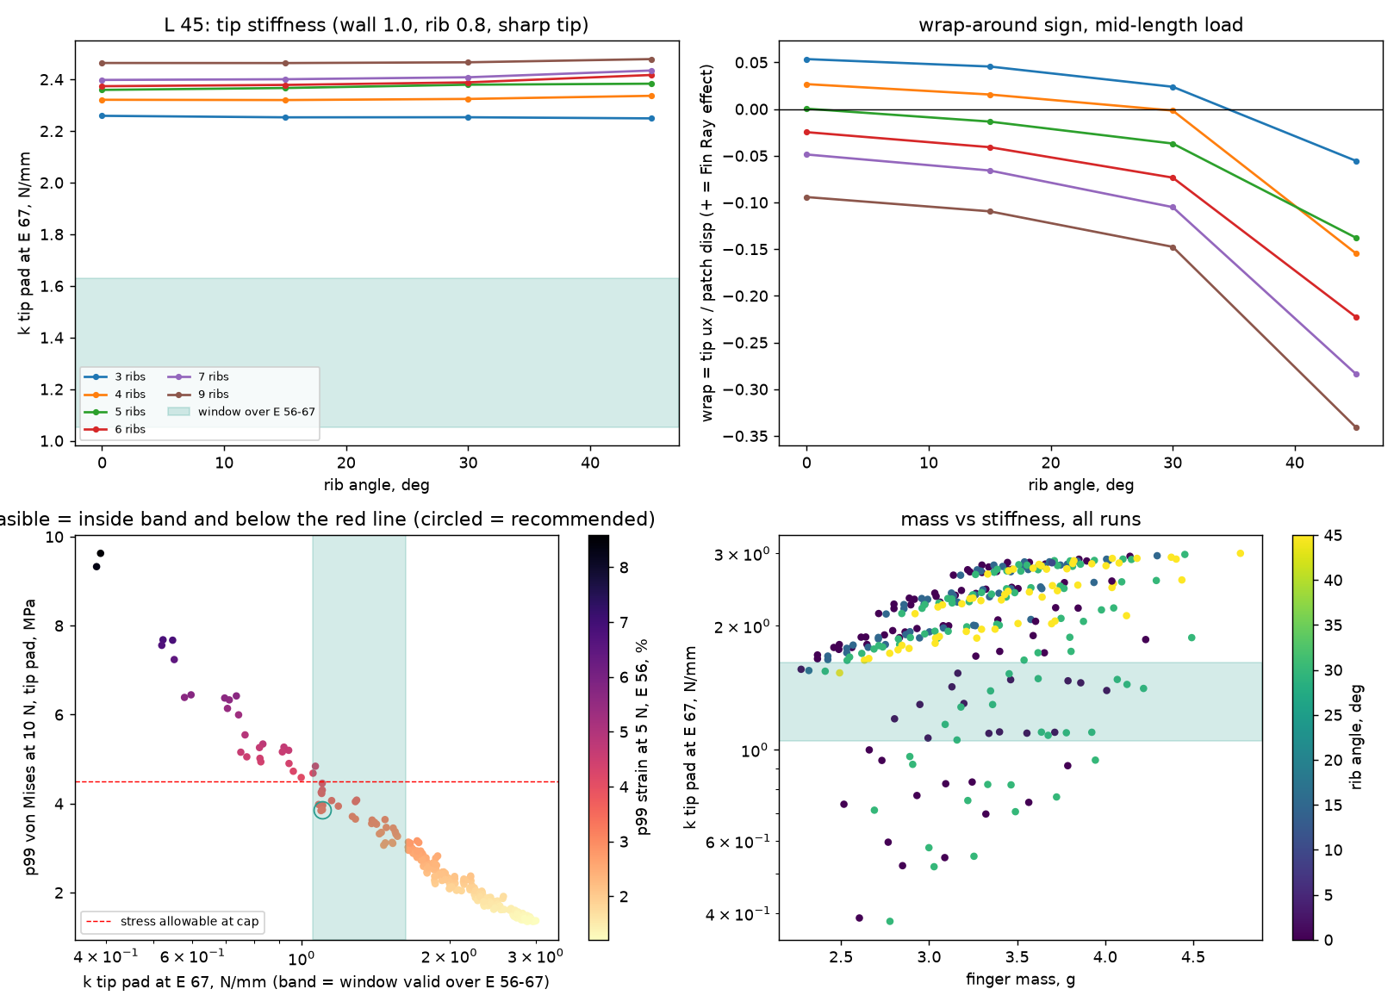
docs/gripper/figures/fea_sweep.png
