douglaspmcgowan/cloth-feed-gripper/docs/gripper/figures/finger_beam.png

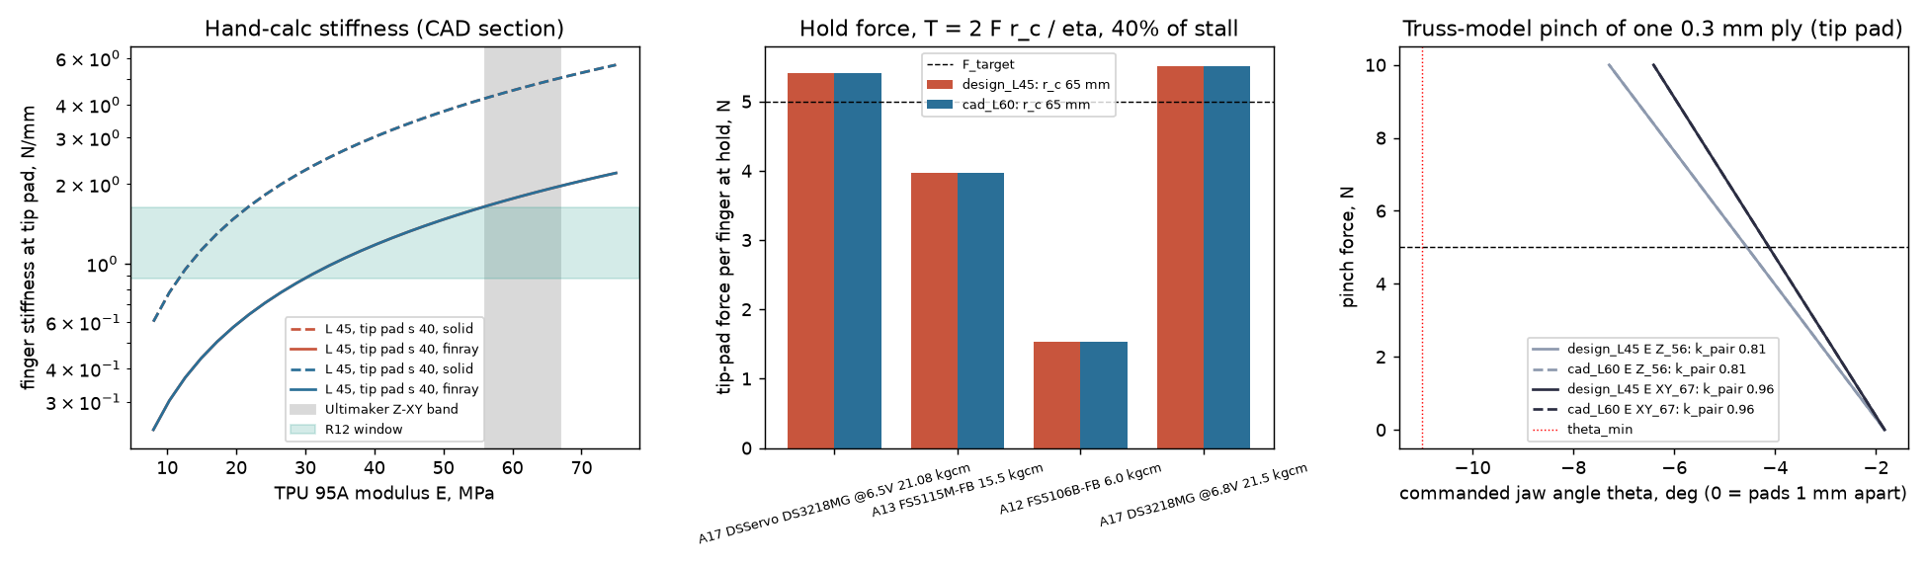
docs/gripper/figures/finger_beam.png
