douglaspmcgowan/cloth-feed-gripper/docs/gripper/figures/gear_design_space.png

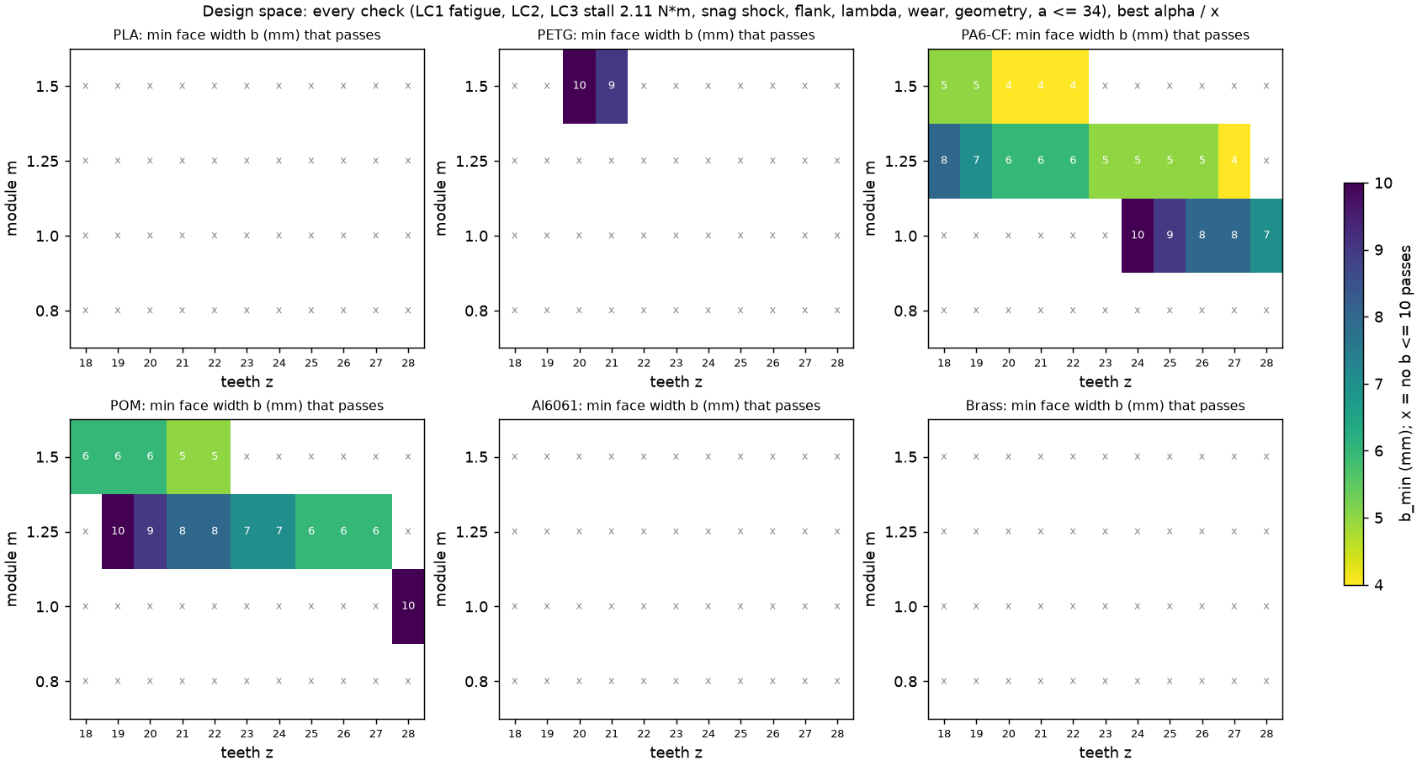
docs/gripper/figures/gear_design_space.png
