douglaspmcgowan/cloth-feed-gripper/docs/gripper/figures/gear_shock.png

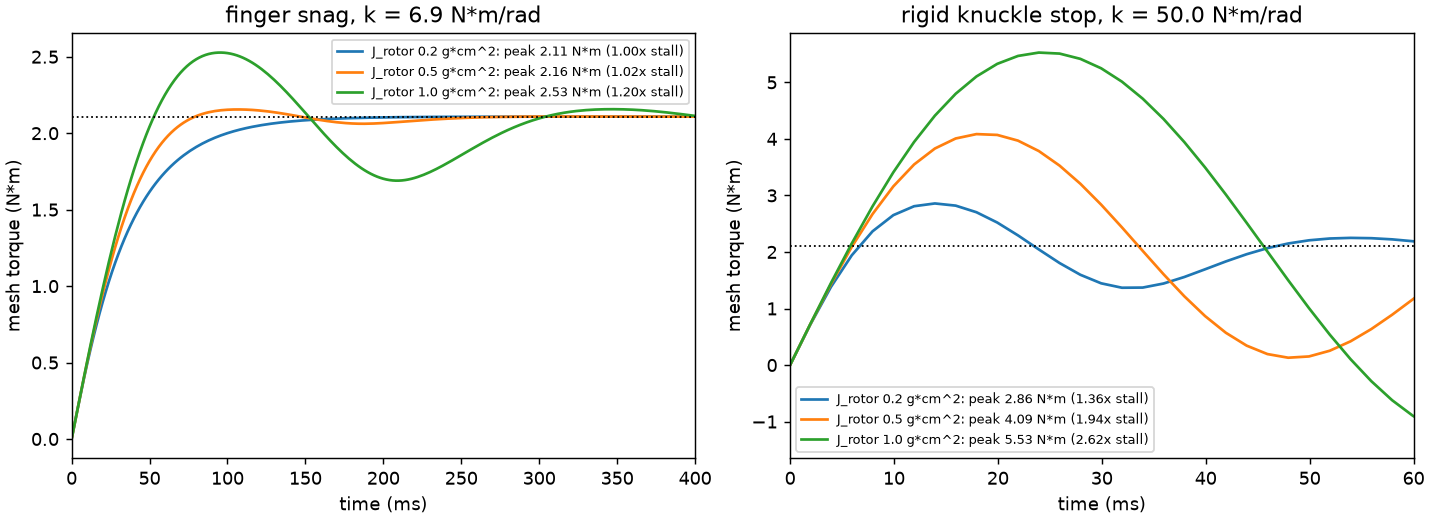
docs/gripper/figures/gear_shock.png
