douglaspmcgowan/cloth-feed-gripper/docs/gripper/figures/payload_allowable_mass.png

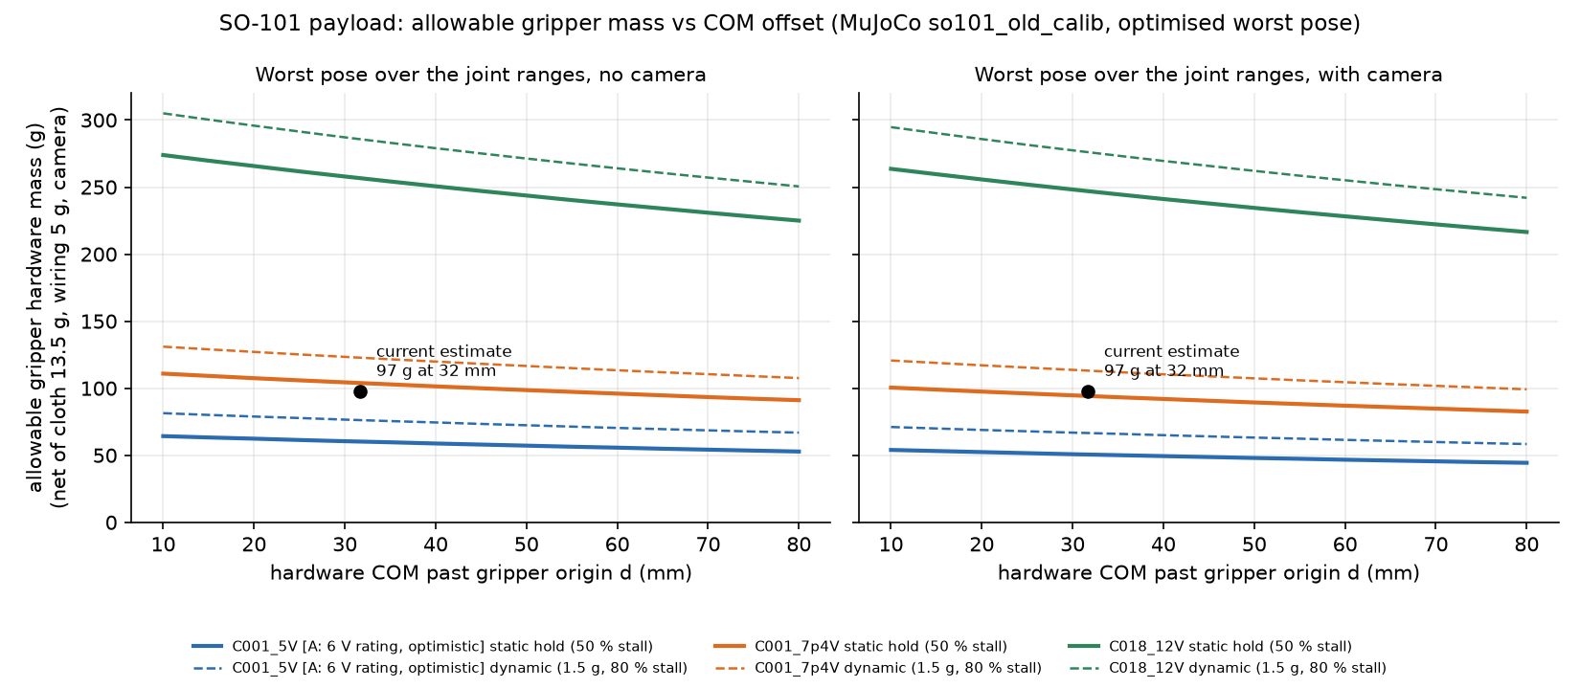
docs/gripper/figures/payload_allowable_mass.png
