douglaspmcgowan/cloth-feed-gripper/docs/gripper/figures/payload_feed_reach.png

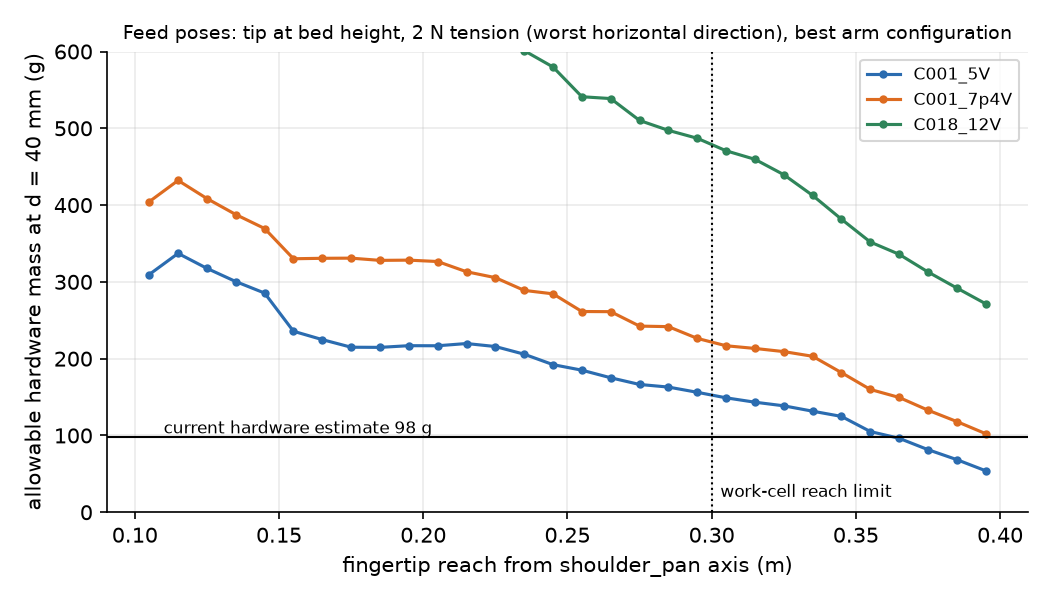
docs/gripper/figures/payload_feed_reach.png
