douglaspmcgowan/cloth-feed-gripper/docs/gripper/figures/tol_T01-drill33.png

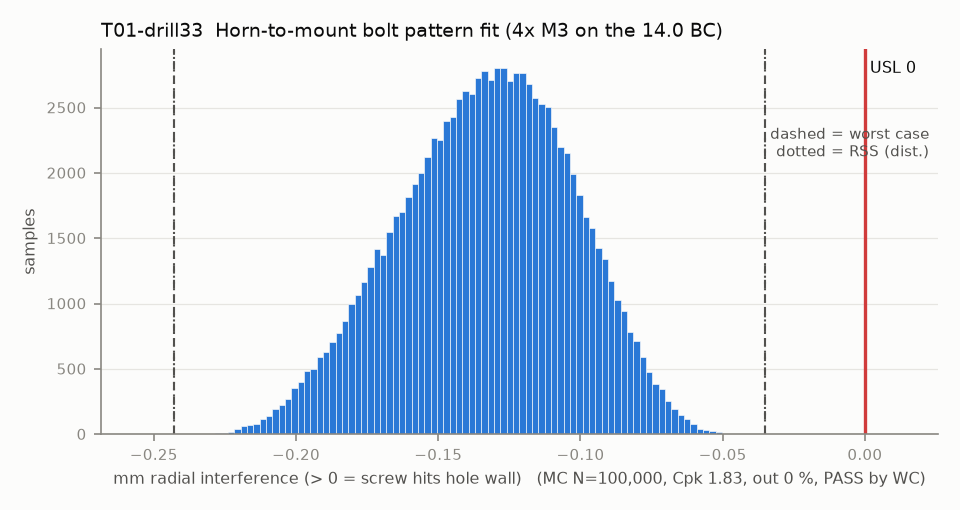
docs/gripper/figures/tol_T01-drill33.png
