douglaspmcgowan/cloth-feed-gripper/docs/gripper/figures/tol_T02-cad1951.png

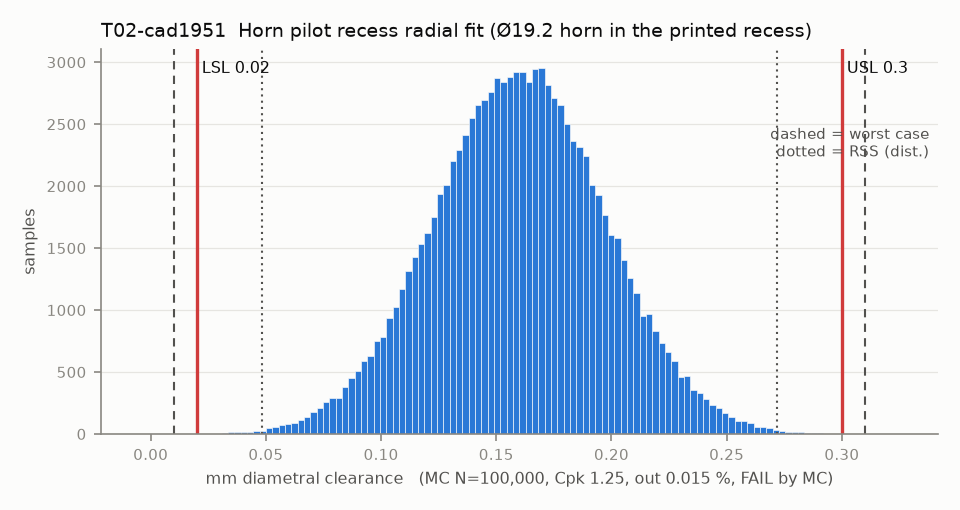
docs/gripper/figures/tol_T02-cad1951.png
