douglaspmcgowan/cloth-feed-gripper/docs/gripper/figures/tol_T02-db1945.png

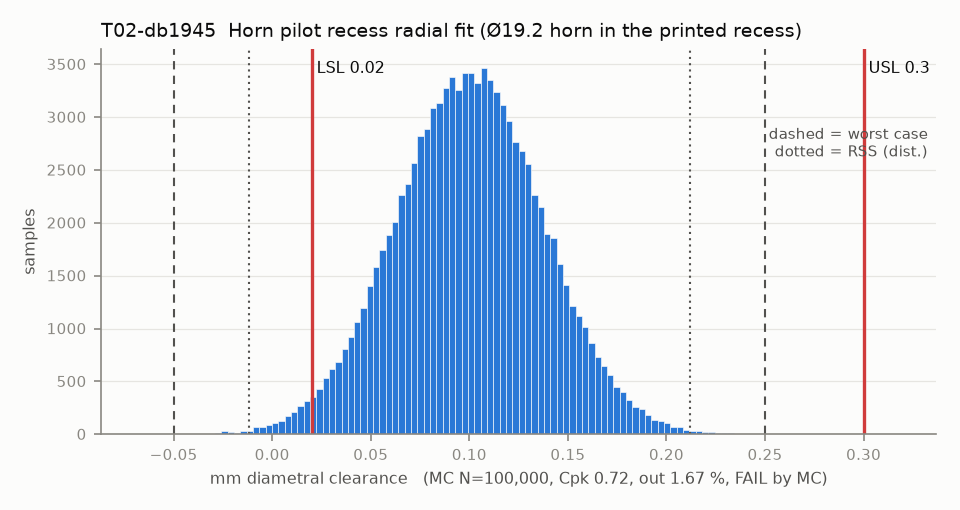
docs/gripper/figures/tol_T02-db1945.png
