douglaspmcgowan/cloth-feed-gripper/docs/gripper/figures/tol_T02.png

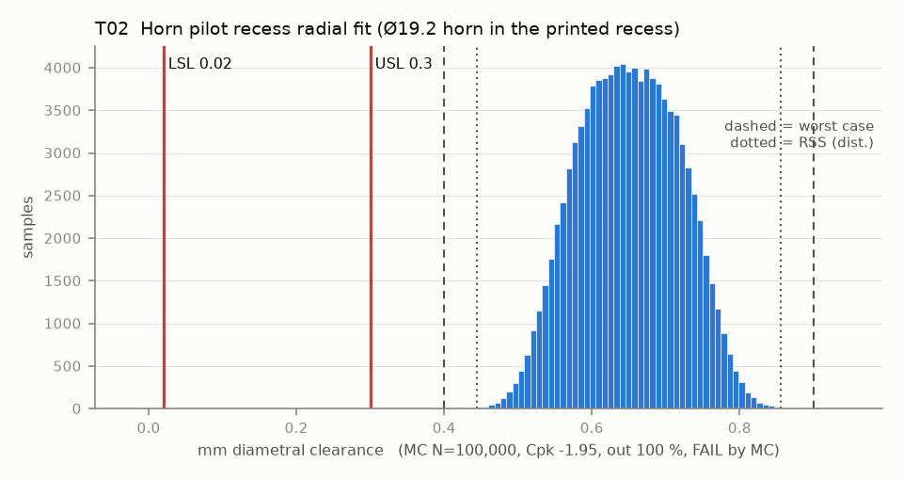
docs/gripper/figures/tol_T02.png
