douglaspmcgowan/cloth-feed-gripper/docs/gripper/figures/tol_T03B-m3x5.png

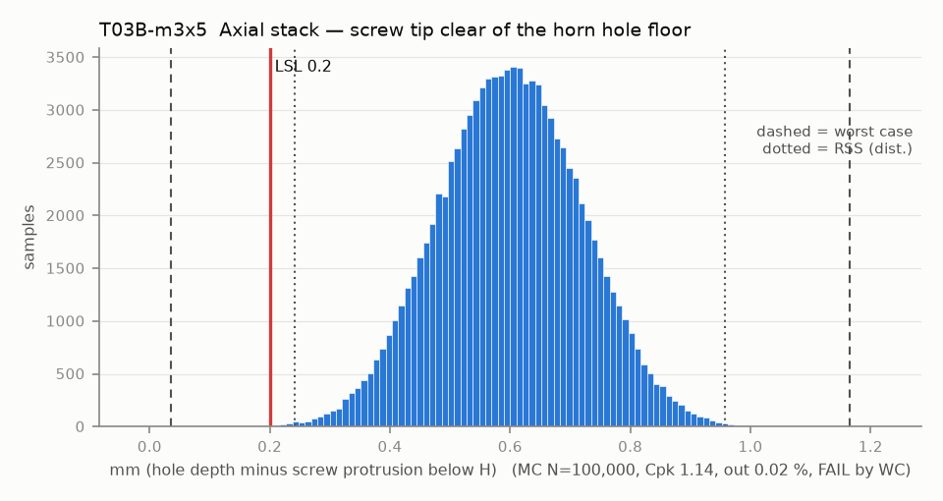
docs/gripper/figures/tol_T03B-m3x5.png
