douglaspmcgowan/cloth-feed-gripper/docs/gripper/figures/tol_T03B.png

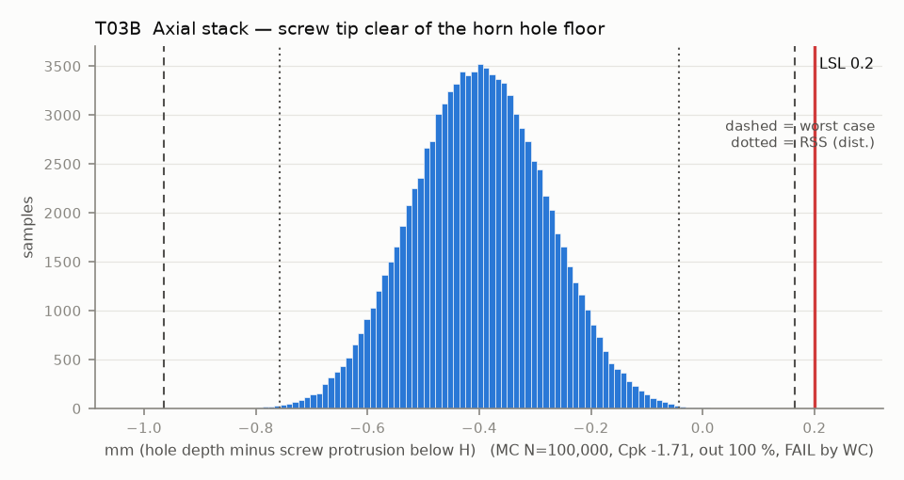
docs/gripper/figures/tol_T03B.png
