douglaspmcgowan/cloth-feed-gripper/docs/gripper/figures/tol_T04-cad1951.png

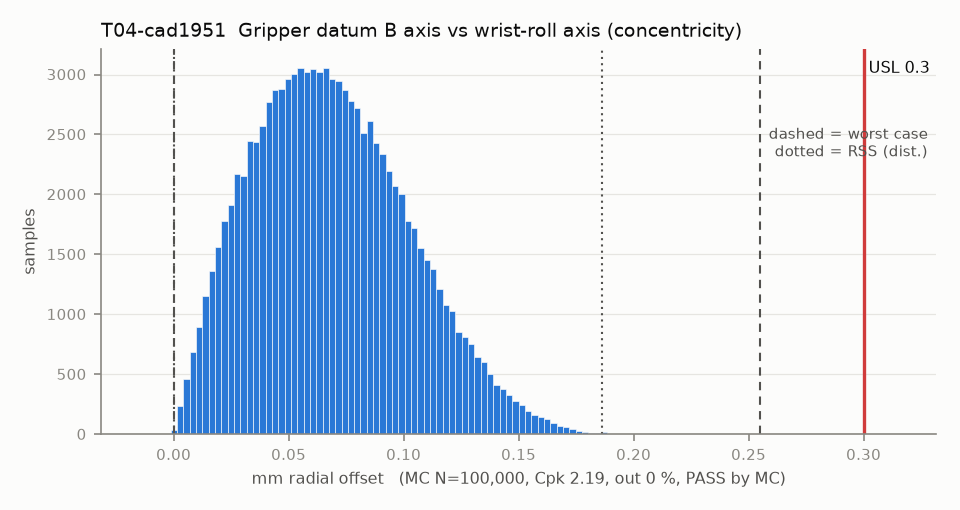
docs/gripper/figures/tol_T04-cad1951.png
