douglaspmcgowan/cloth-feed-gripper/docs/gripper/figures/tol_T04.png

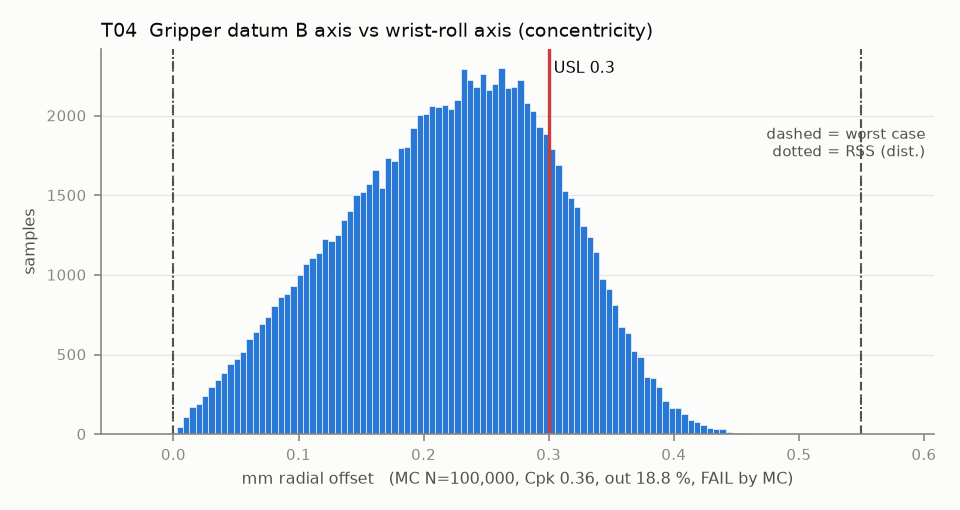
docs/gripper/figures/tol_T04.png
