douglaspmcgowan/cloth-feed-gripper/docs/gripper/figures/tol_T05-pinned.png

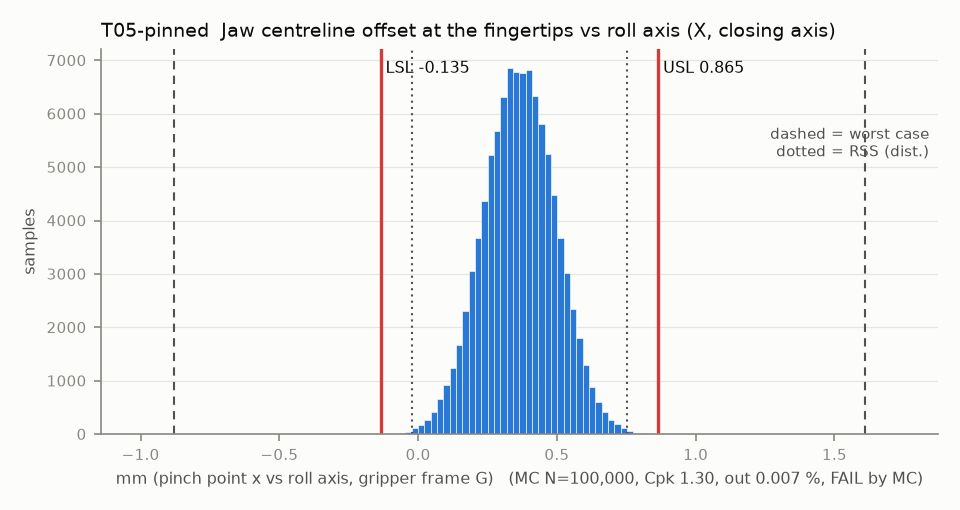
docs/gripper/figures/tol_T05-pinned.png
