douglaspmcgowan/cloth-feed-gripper/docs/gripper/figures/tol_T05-spring-pegs.png

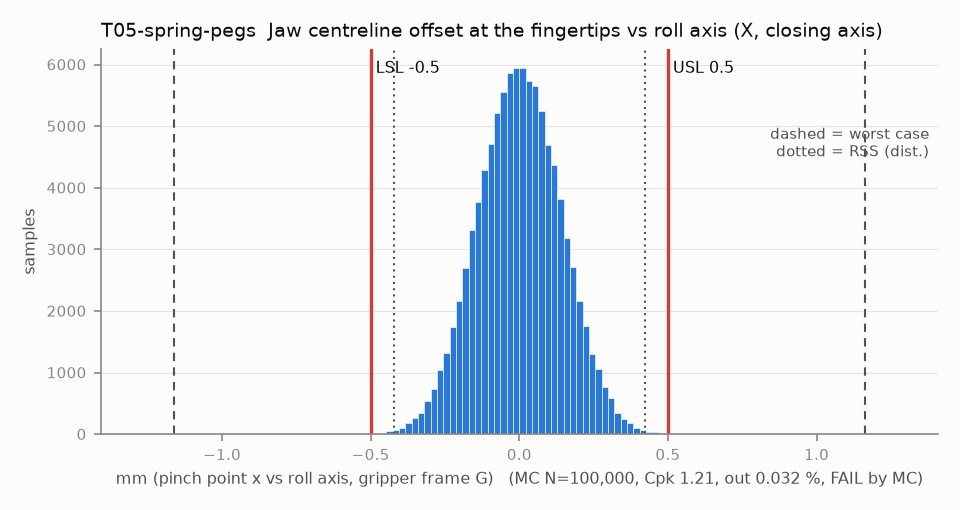
docs/gripper/figures/tol_T05-spring-pegs.png
