douglaspmcgowan/cloth-feed-gripper/docs/gripper/figures/tol_T05.png

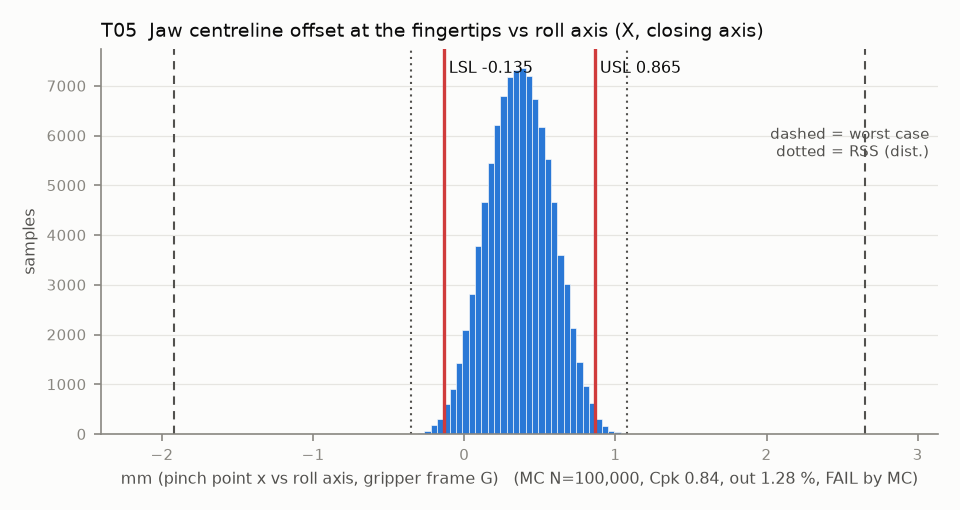
docs/gripper/figures/tol_T05.png
