douglaspmcgowan/cloth-feed-gripper/docs/gripper/figures/tol_T06-bushed.png

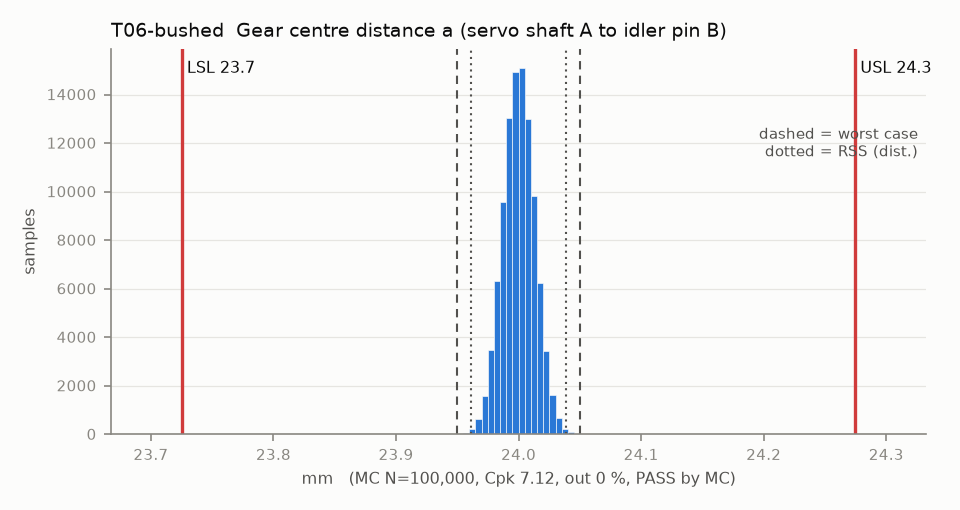
docs/gripper/figures/tol_T06-bushed.png
