douglaspmcgowan/cloth-feed-gripper/docs/gripper/figures/tol_T06-pinned.png

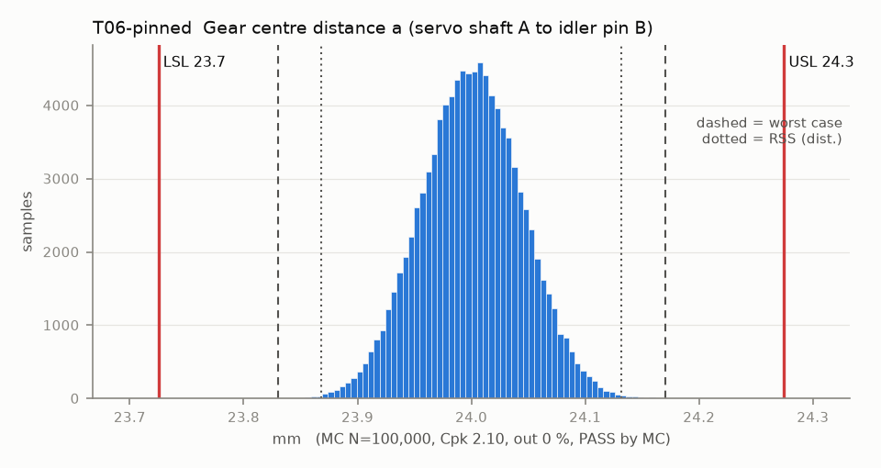
docs/gripper/figures/tol_T06-pinned.png
