douglaspmcgowan/cloth-feed-gripper/docs/gripper/figures/tol_T06-slotted.png

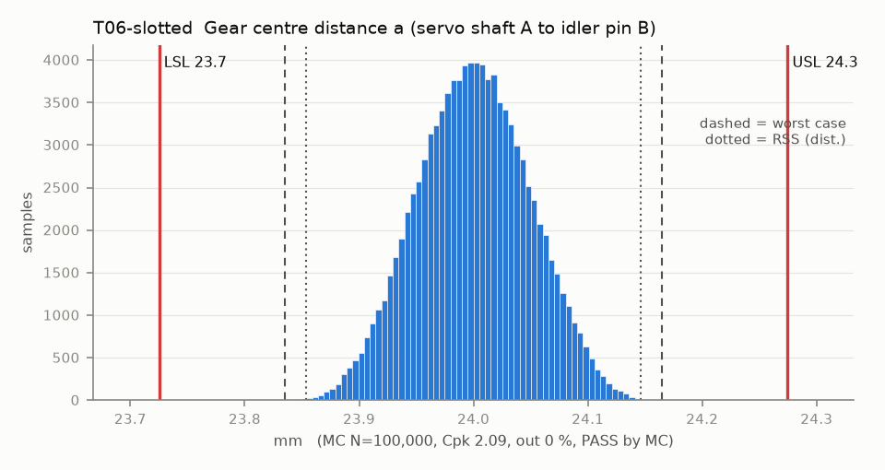
docs/gripper/figures/tol_T06-slotted.png
