douglaspmcgowan/cloth-feed-gripper/docs/gripper/figures/tol_T07-slotted.png

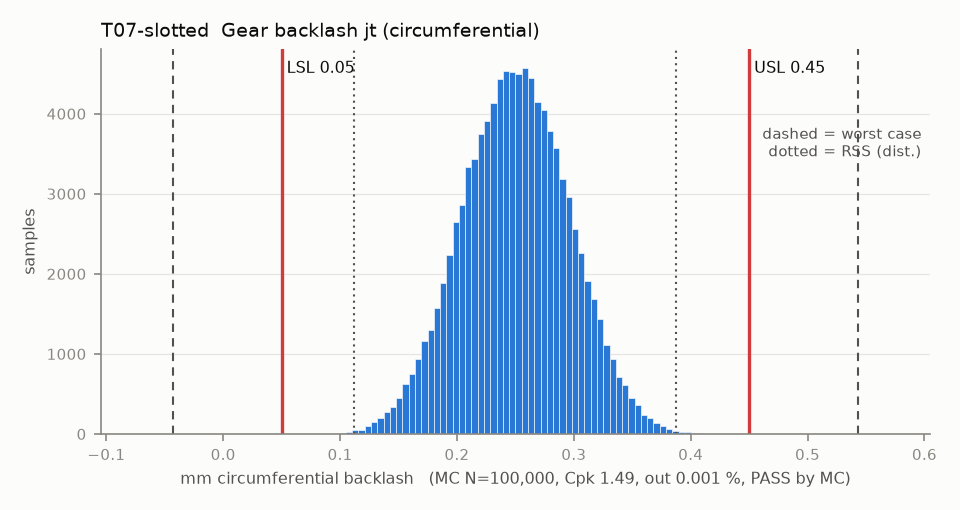
docs/gripper/figures/tol_T07-slotted.png
