douglaspmcgowan/cloth-feed-gripper/docs/gripper/figures/tol_T07.png

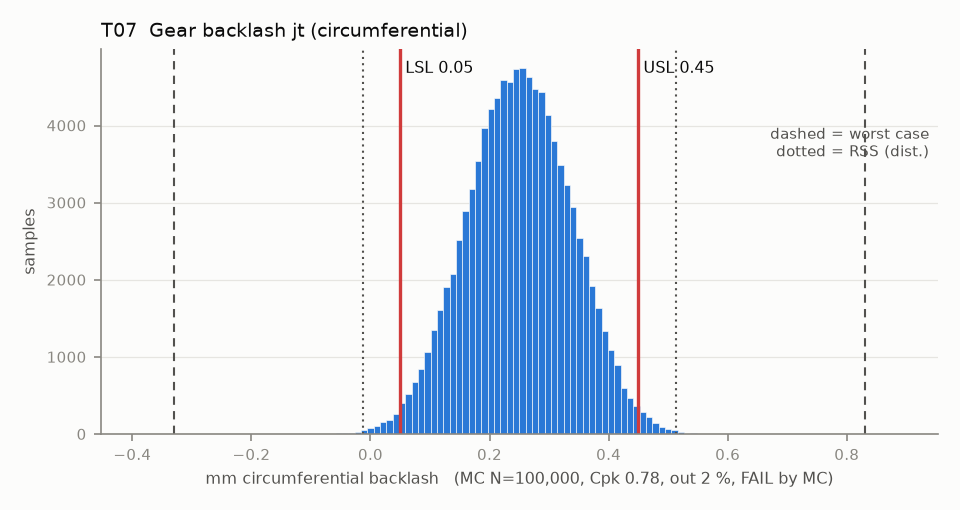
docs/gripper/figures/tol_T07.png
