douglaspmcgowan/cloth-feed-gripper/docs/gripper/figures/tol_T08-shimmed.png

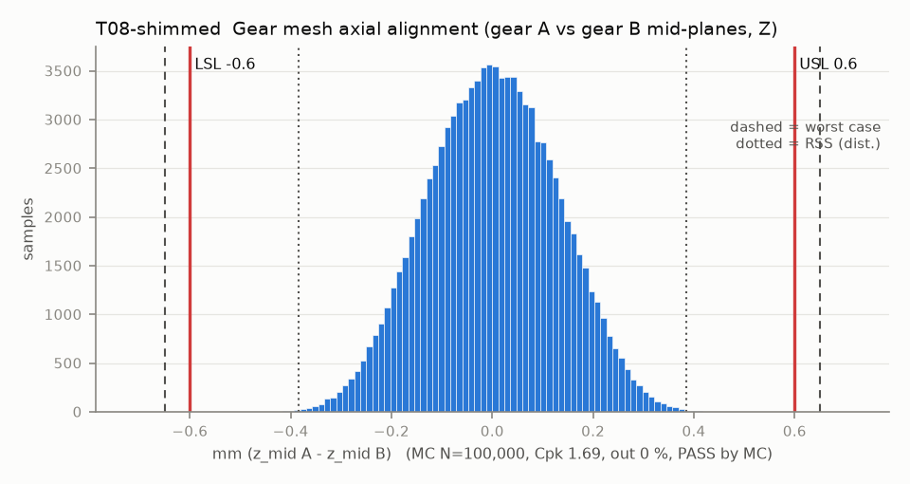
docs/gripper/figures/tol_T08-shimmed.png
