douglaspmcgowan/cloth-feed-gripper/docs/gripper/figures/tol_T09-capcheck-rigidB.png

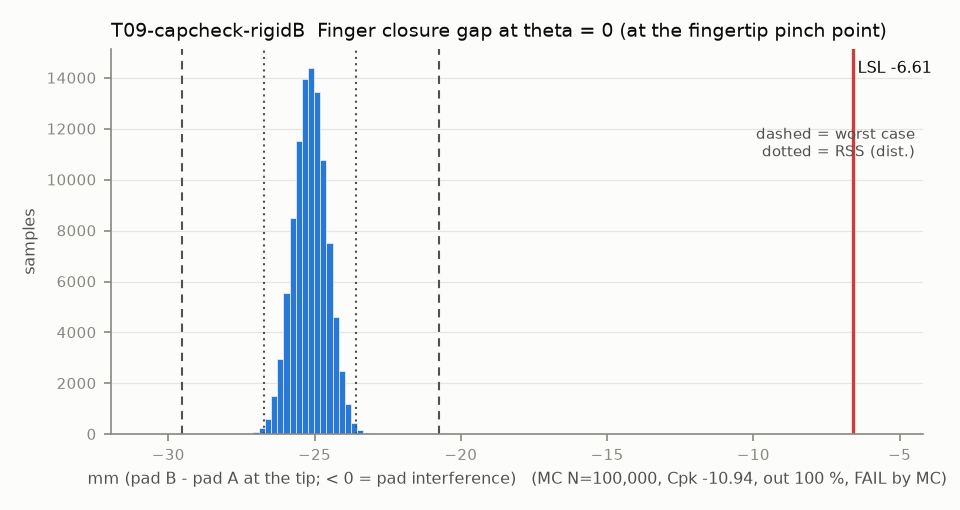
docs/gripper/figures/tol_T09-capcheck-rigidB.png
