douglaspmcgowan/cloth-feed-gripper/docs/gripper/figures/tol_T09-capcheck.png

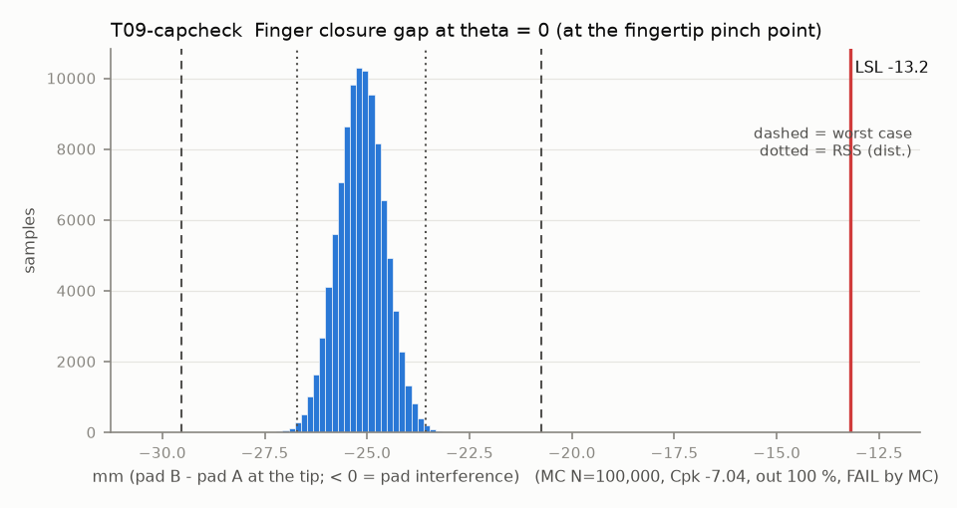
docs/gripper/figures/tol_T09-capcheck.png
