douglaspmcgowan/cloth-feed-gripper/docs/gripper/figures/tol_T09-forceclose-rigidB.png

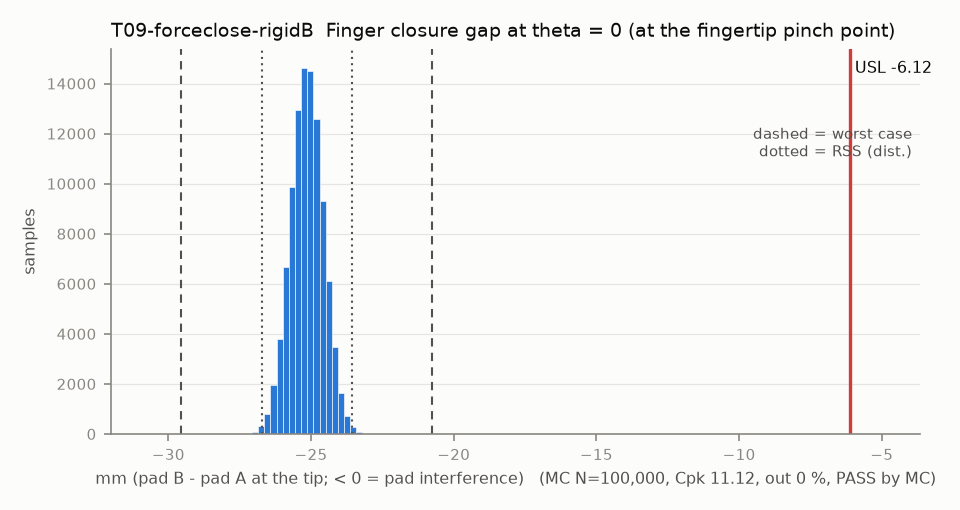
docs/gripper/figures/tol_T09-forceclose-rigidB.png
