douglaspmcgowan/cloth-feed-gripper/docs/gripper/figures/tol_T09-hold47-rigidB.png

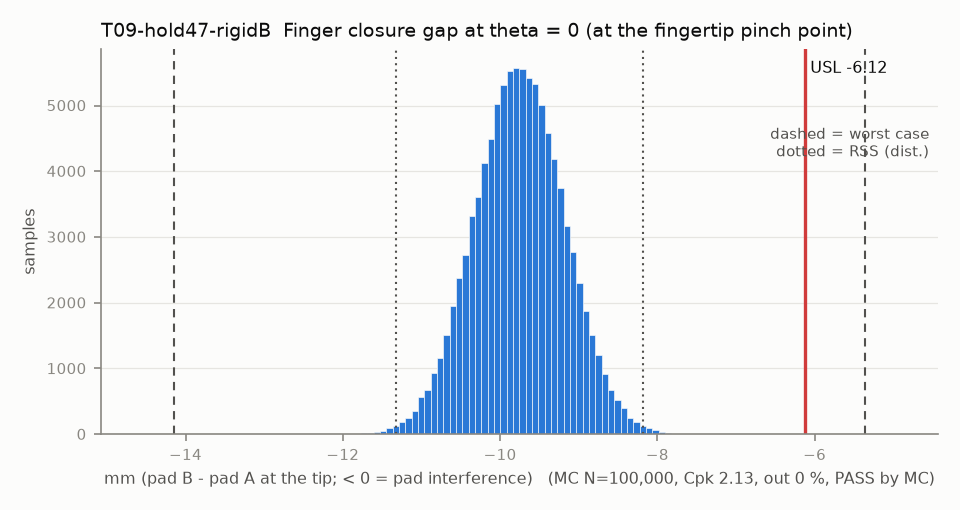
docs/gripper/figures/tol_T09-hold47-rigidB.png
