douglaspmcgowan/cloth-feed-gripper/docs/gripper/figures/tol_T09-hold47.png

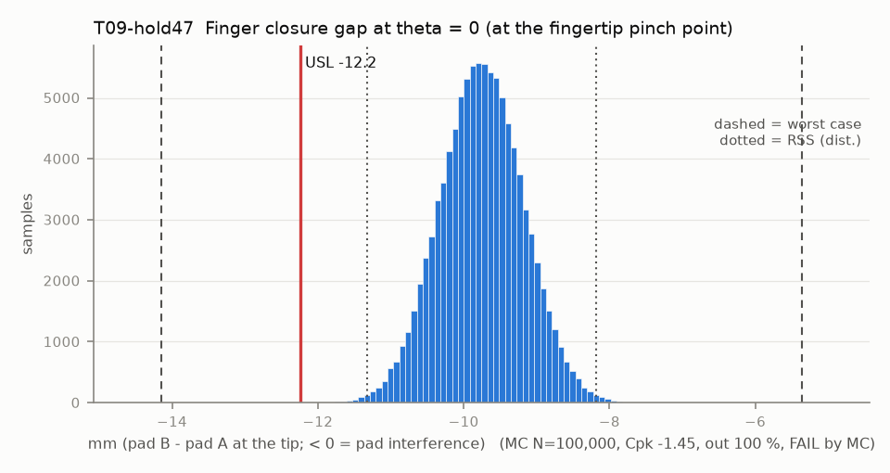
docs/gripper/figures/tol_T09-hold47.png
