douglaspmcgowan/cloth-feed-gripper/docs/gripper/figures/tol_T09-pinned-forceclose.png

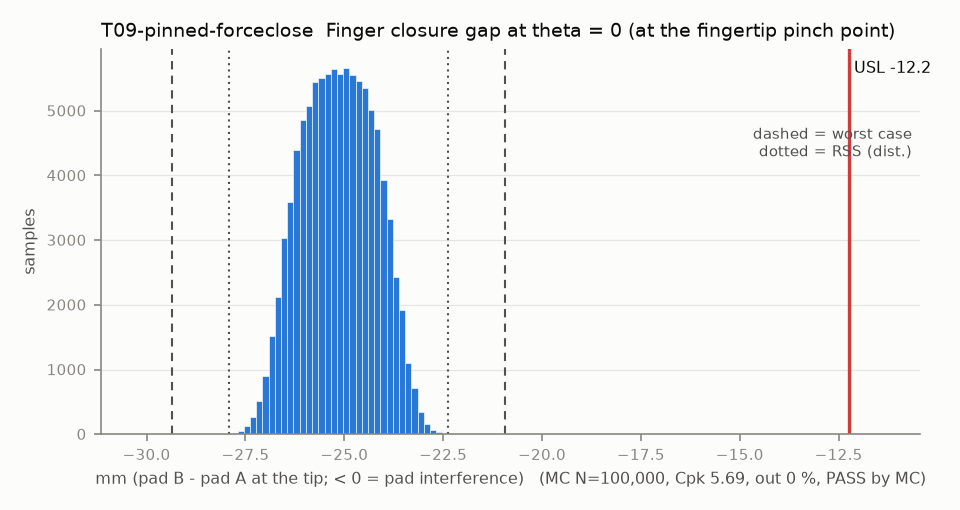
docs/gripper/figures/tol_T09-pinned-forceclose.png
