douglaspmcgowan/cloth-feed-gripper/docs/gripper/figures/tol_T09-pinned.png

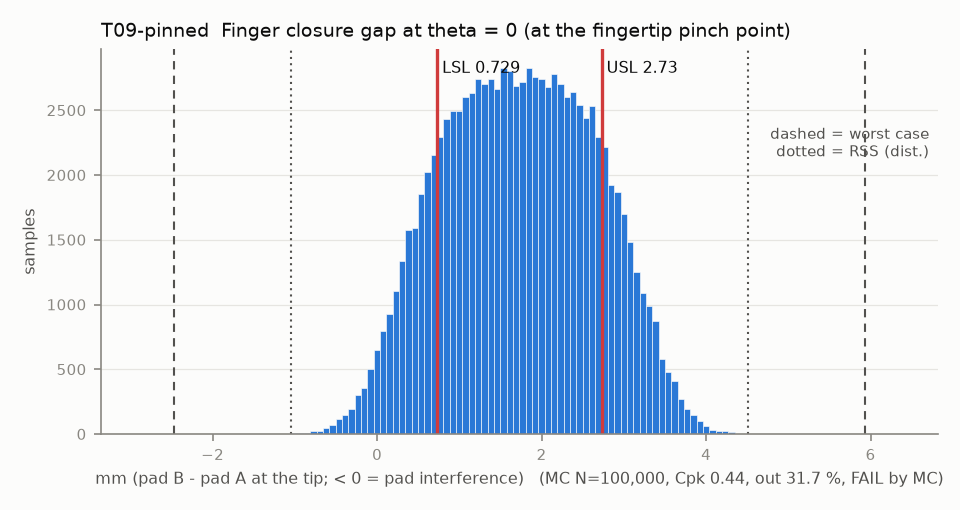
docs/gripper/figures/tol_T09-pinned.png
