douglaspmcgowan/cloth-feed-gripper/docs/gripper/figures/tol_T09.png

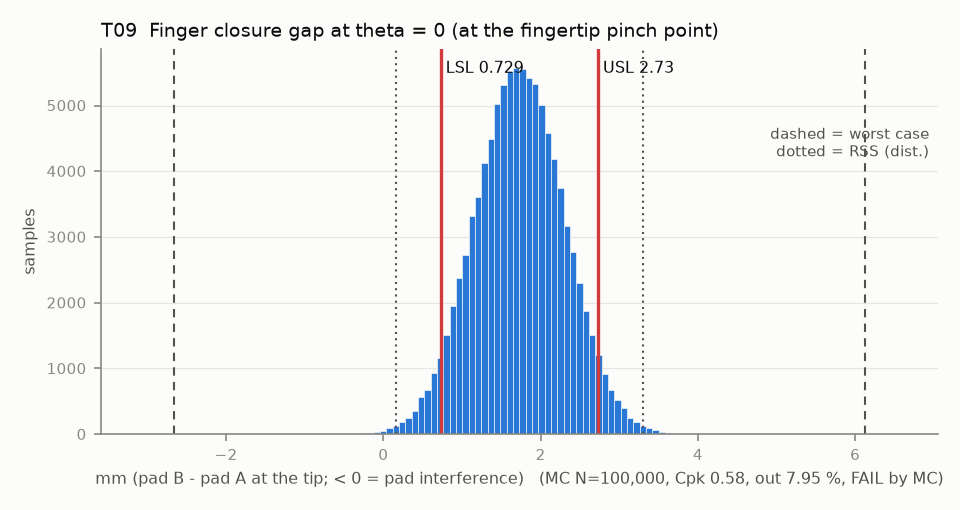
docs/gripper/figures/tol_T09.png
