douglaspmcgowan/cloth-feed-gripper/docs/gripper/figures/tol_T10-pegs.png

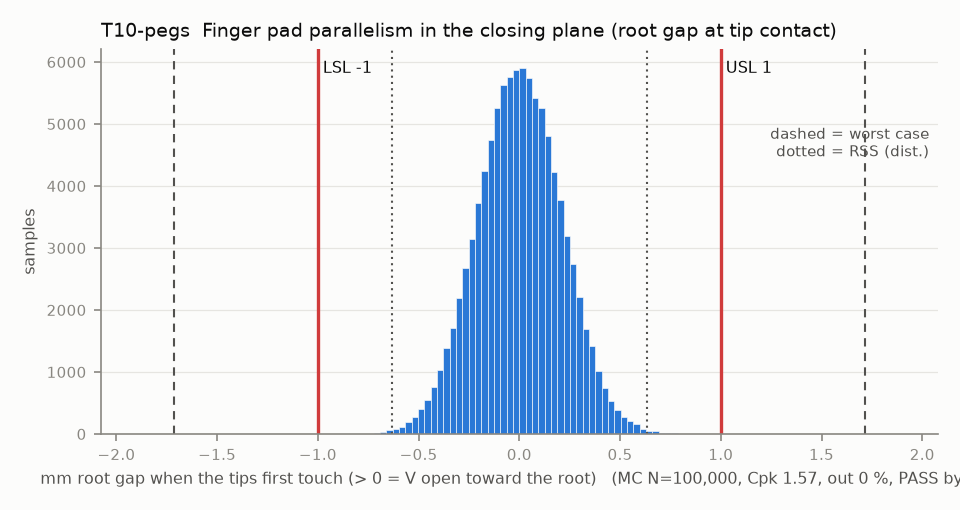
docs/gripper/figures/tol_T10-pegs.png
