douglaspmcgowan/cloth-feed-gripper/docs/gripper/figures/tol_T10.png

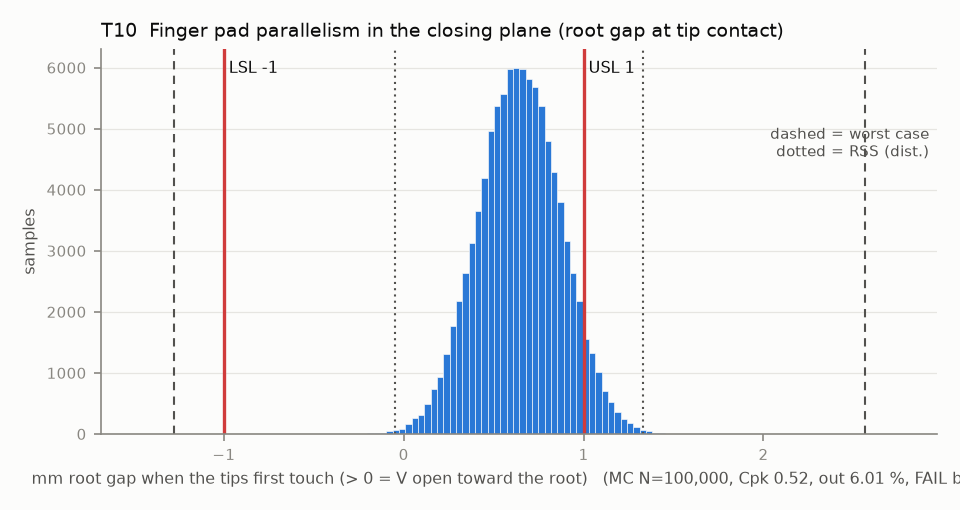
docs/gripper/figures/tol_T10.png
