douglaspmcgowan/cloth-feed-gripper/docs/gripper/figures/tol_T10B-bushed-pegs.png

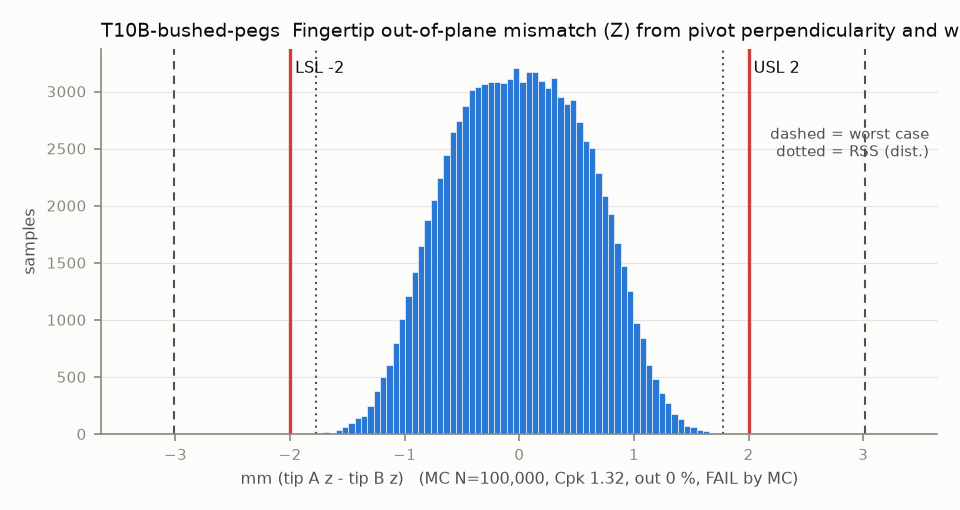
docs/gripper/figures/tol_T10B-bushed-pegs.png
