douglaspmcgowan/cloth-feed-gripper/docs/gripper/figures/tol_T10B-pinned-bushed-pegs.png

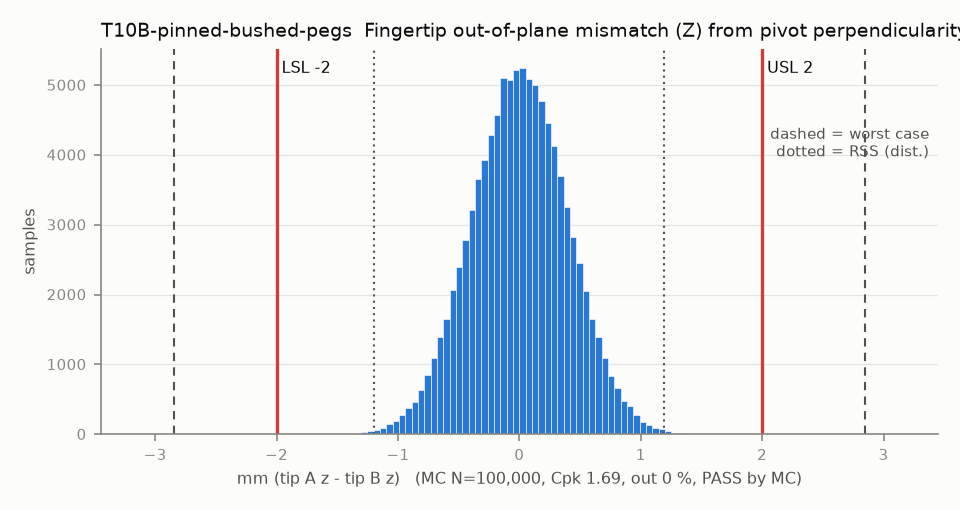
docs/gripper/figures/tol_T10B-pinned-bushed-pegs.png
