douglaspmcgowan/cloth-feed-gripper/docs/gripper/figures/tol_T10B-shimmed.png

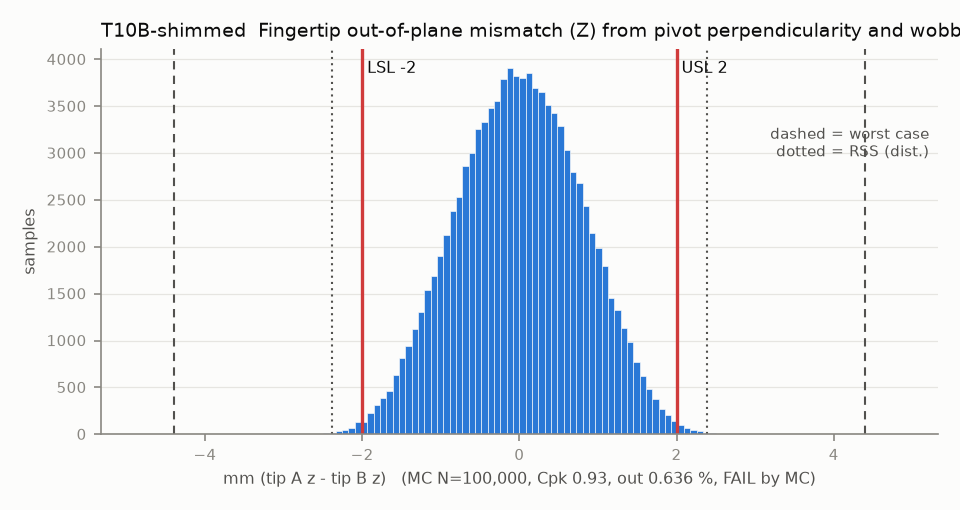
docs/gripper/figures/tol_T10B-shimmed.png
