douglaspmcgowan/cloth-feed-gripper/docs/gripper/figures/tol_T11-cad1951.png

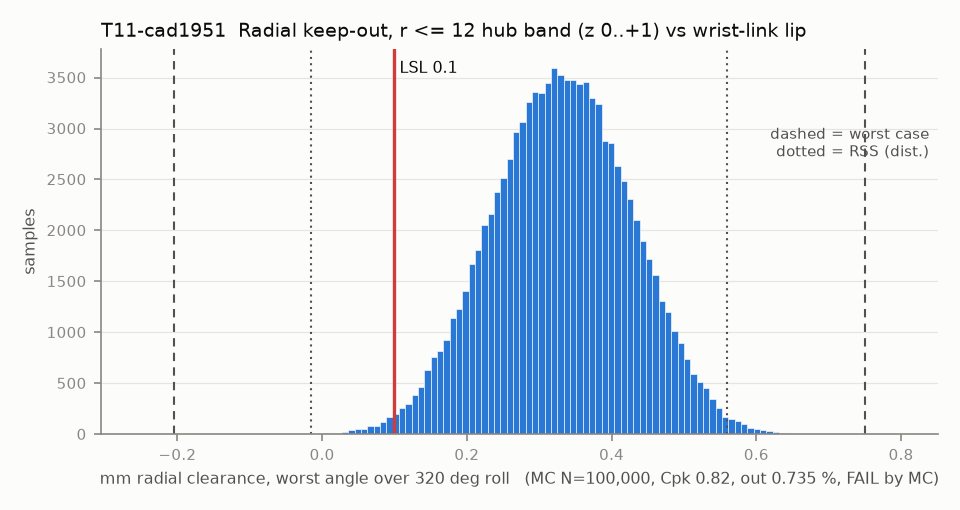
docs/gripper/figures/tol_T11-cad1951.png
