douglaspmcgowan/cloth-feed-gripper/docs/gripper/figures/tol_T12.png

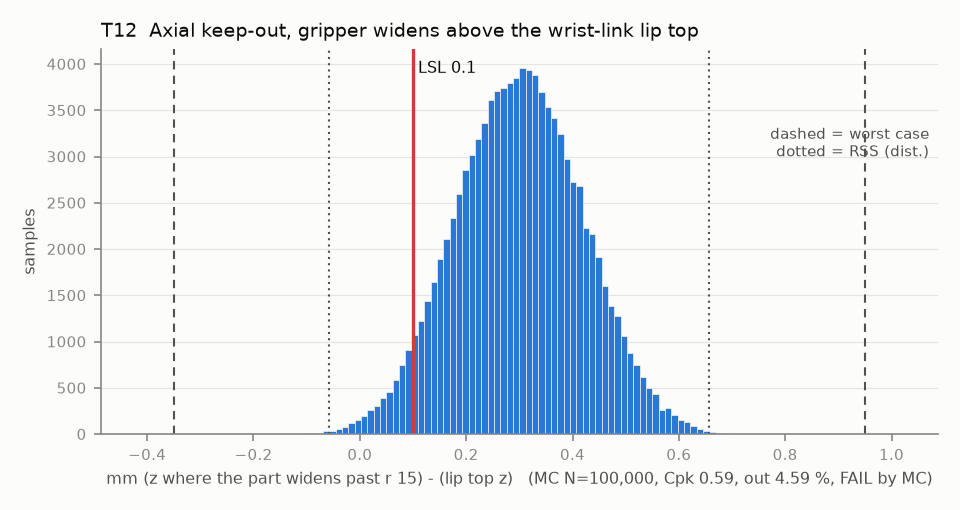
docs/gripper/figures/tol_T12.png
