douglaspmcgowan/cloth-feed-gripper/docs/gripper/figures/tol_T12B.png

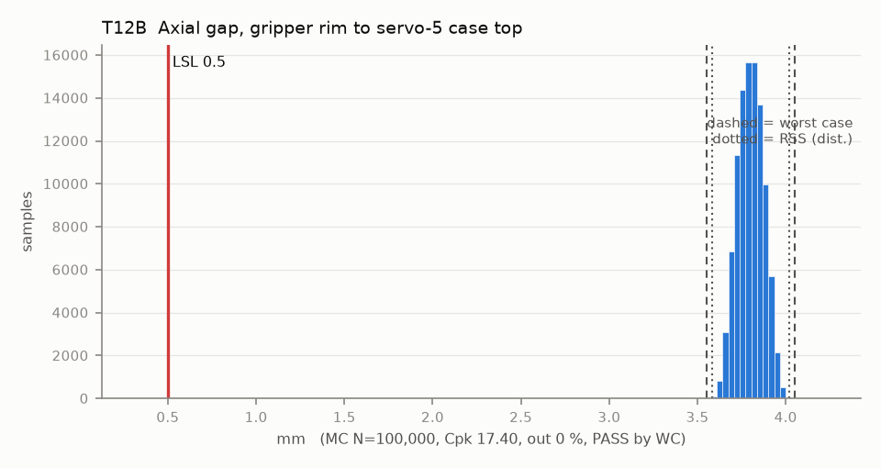
docs/gripper/figures/tol_T12B.png
