douglaspmcgowan/cloth-feed-gripper/docs/gripper/figures/tol_T16-bushed.png

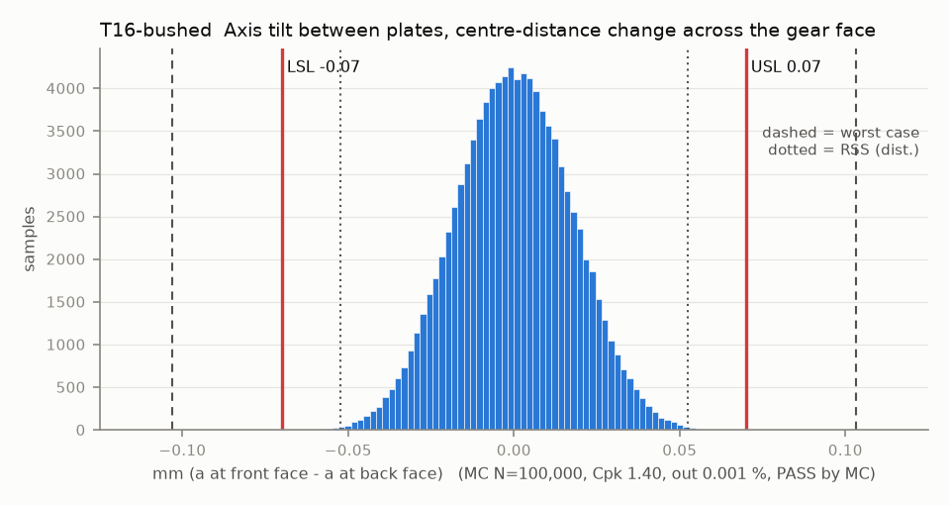
docs/gripper/figures/tol_T16-bushed.png
