douglaspmcgowan/cloth-feed-gripper/docs/gripper/figures/tol_T16-dowelled.png

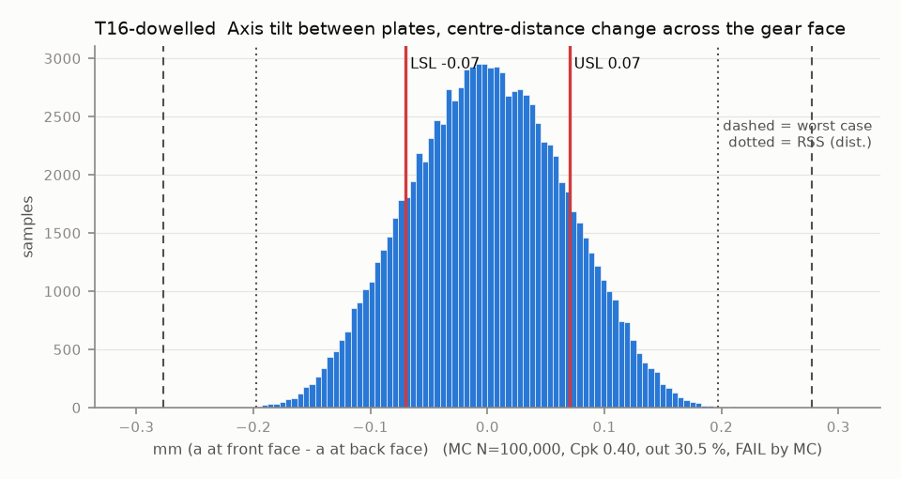
docs/gripper/figures/tol_T16-dowelled.png
