douglaspmcgowan/cloth-feed-gripper/docs/screens/job-c-horn-1440.png

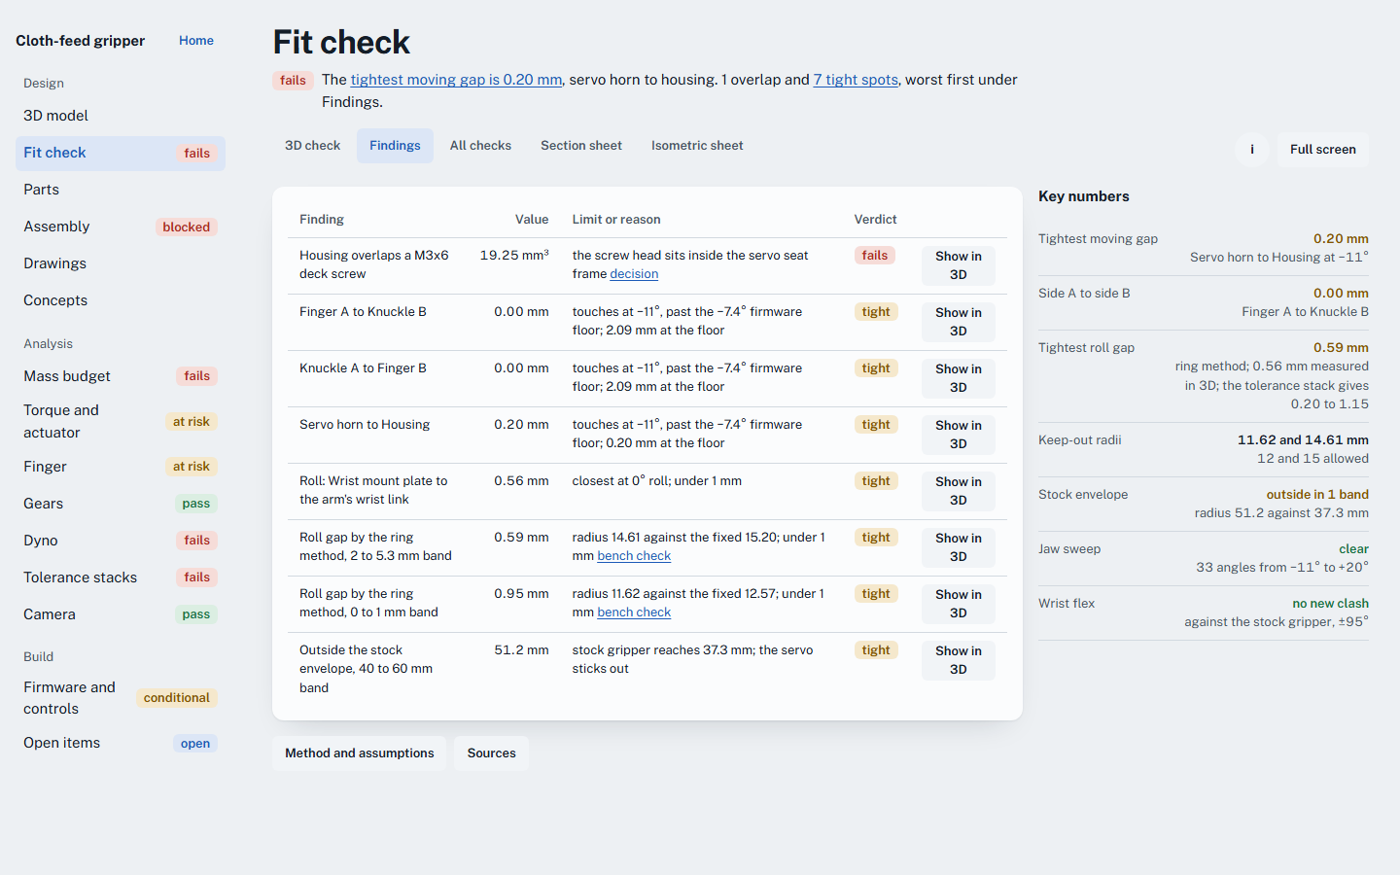
docs/screens/job-c-horn-1440.png
