douglaspmcgowan/cloth-feed-gripper/docs/screens/landing-dark-768.png

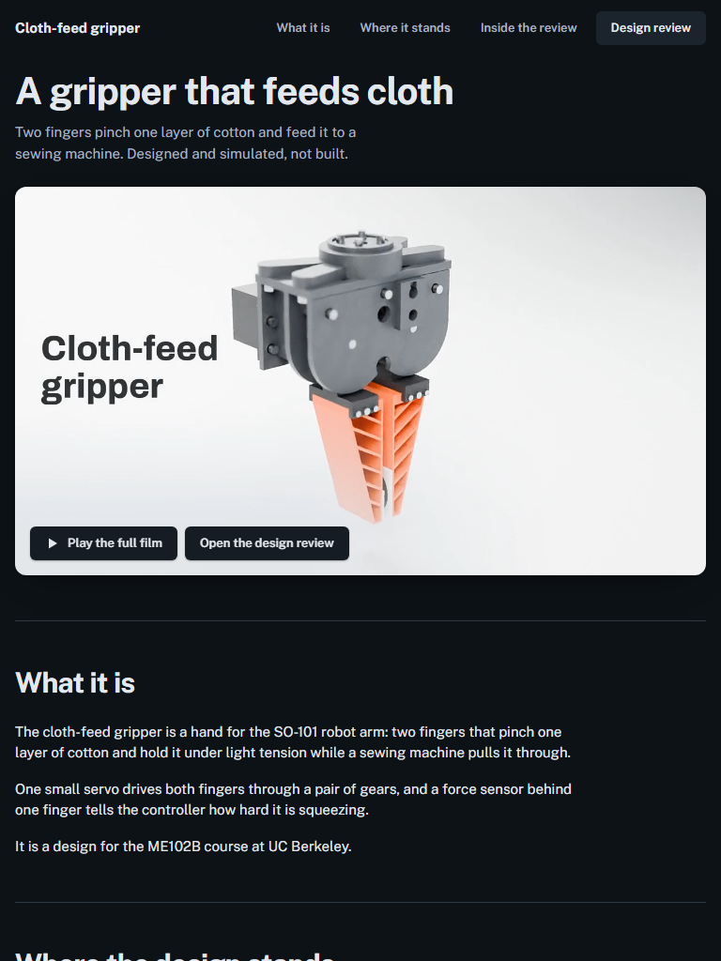
docs/screens/landing-dark-768.png
