douglaspmcgowan/cloth-feed-gripper/docs/screens/landing-dark-1440-full.png

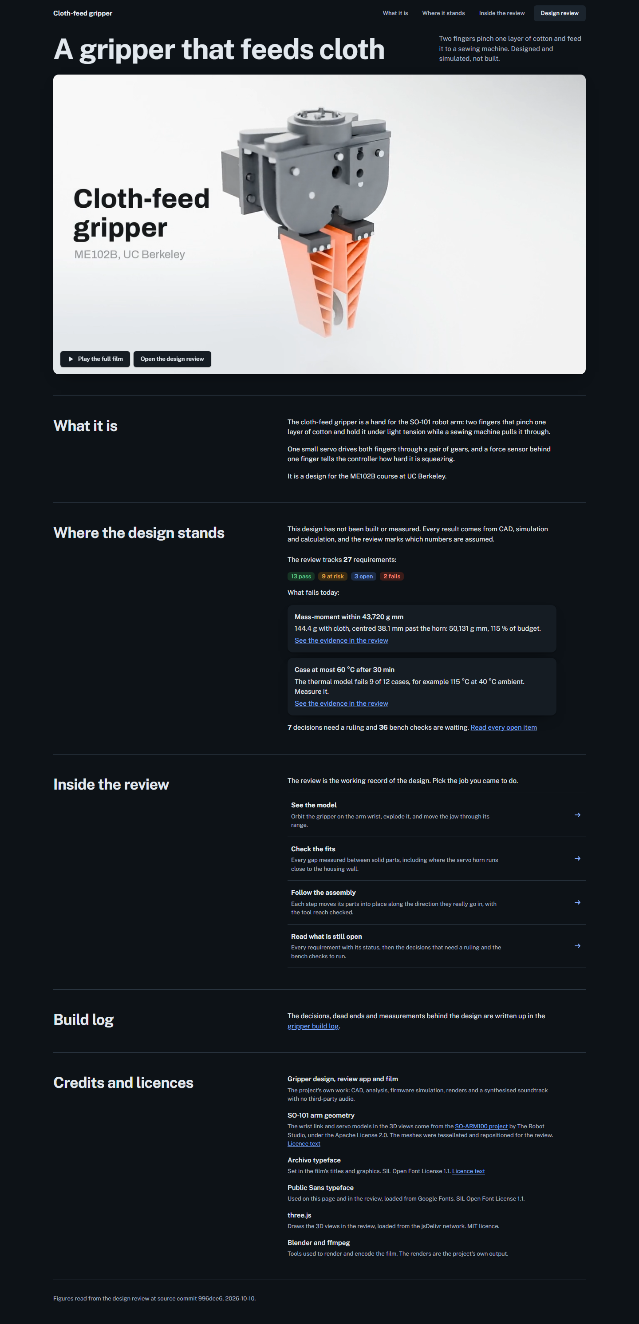
docs/screens/landing-dark-1440-full.png
