douglaspmcgowan/cloth-feed-gripper/docs/screens/landing-light-768-full.png

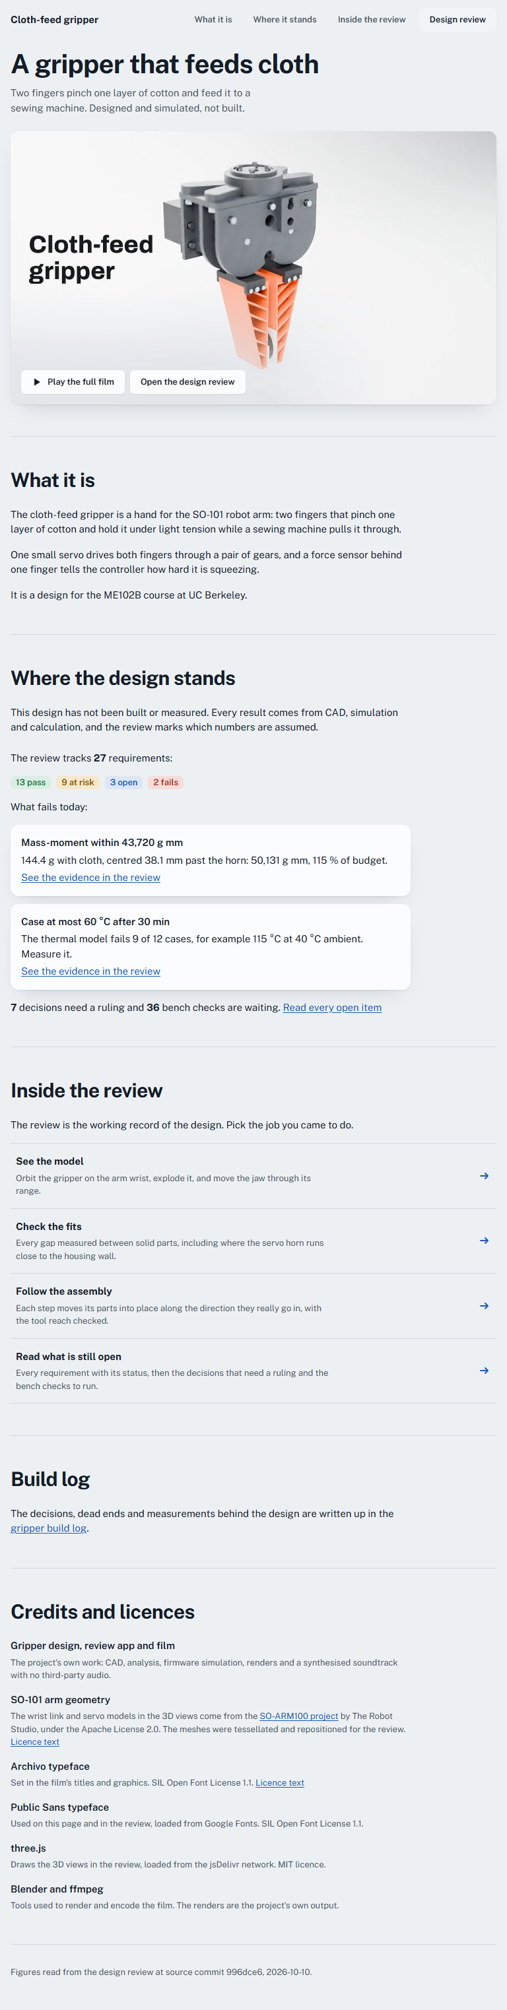
docs/screens/landing-light-768-full.png
