douglaspmcgowan/cloth-feed-gripper/docs/screens/landing-light-768.png

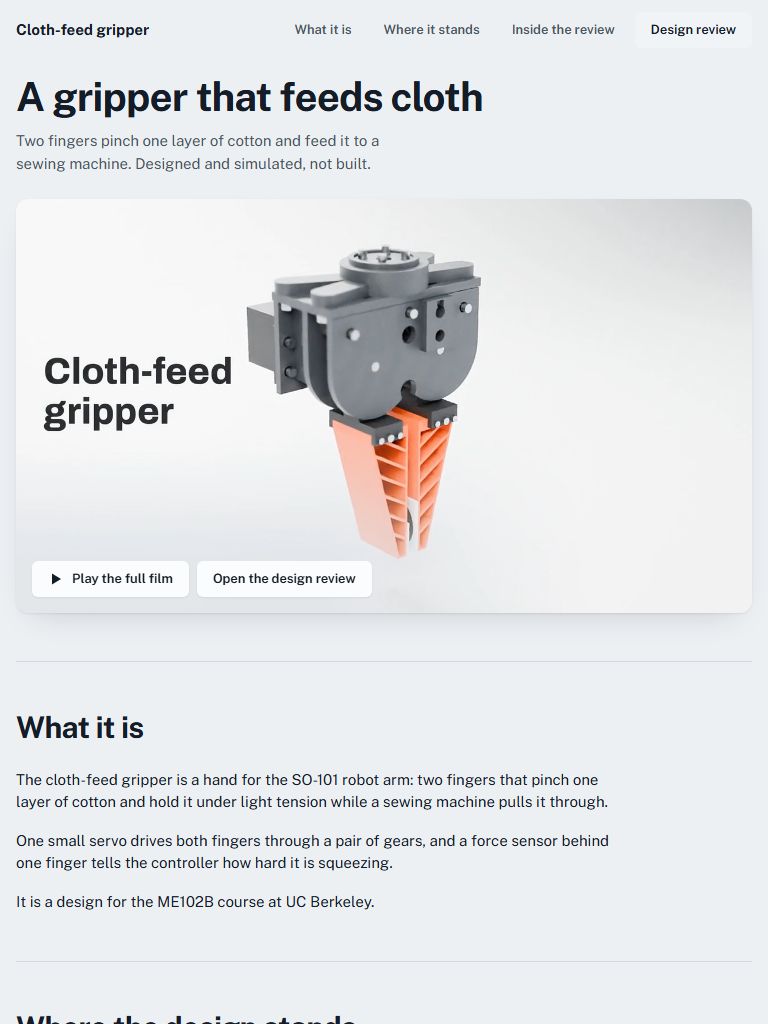
docs/screens/landing-light-768.png
