douglaspmcgowan/cloth-feed-gripper/docs/screens/landing-light-1440.png

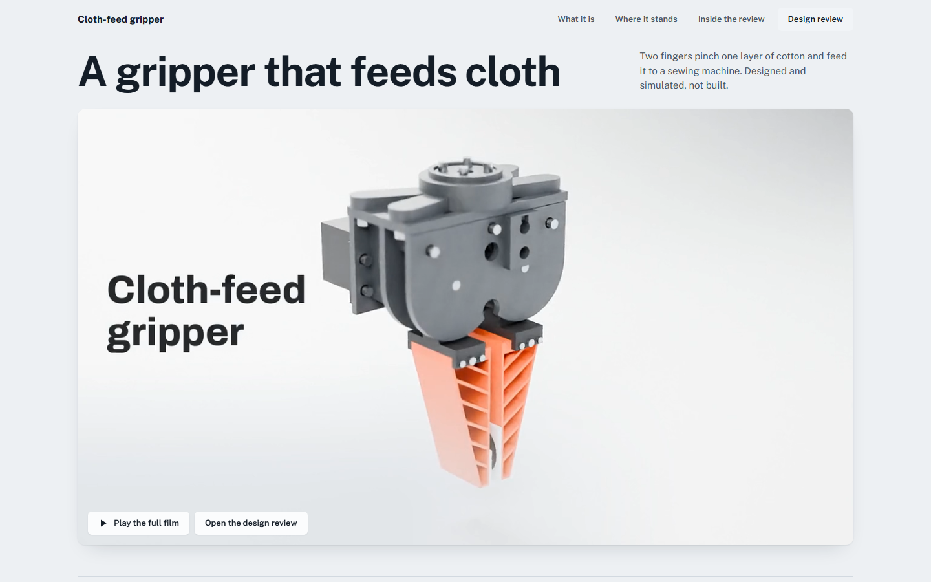
docs/screens/landing-light-1440.png
