douglaspmcgowan/cloth-feed-gripper/docs/screens/review-dark-768.png

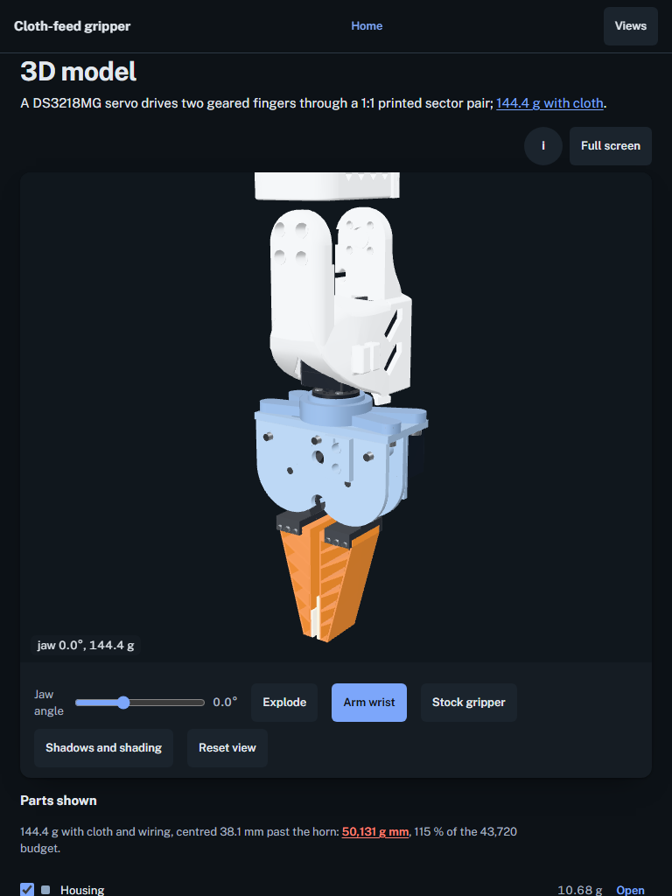
docs/screens/review-dark-768.png
