douglaspmcgowan/cloth-feed-gripper/ecad/gripper/calc/out/figures/droop_transient.png

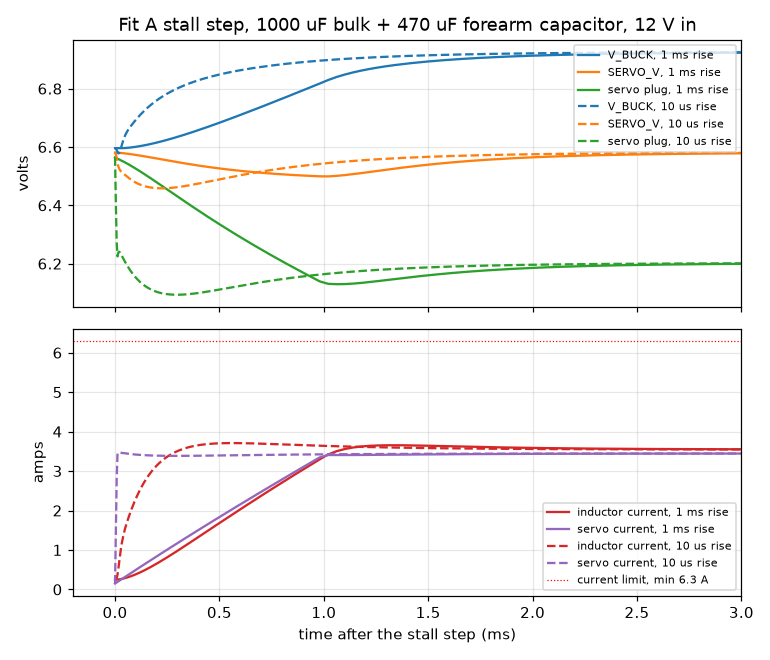
ecad/gripper/calc/out/figures/droop_transient.png
