douglaspmcgowan/cloth-feed-gripper/ecad/gripper/calc/out/figures/droop_vs_cbulk.png

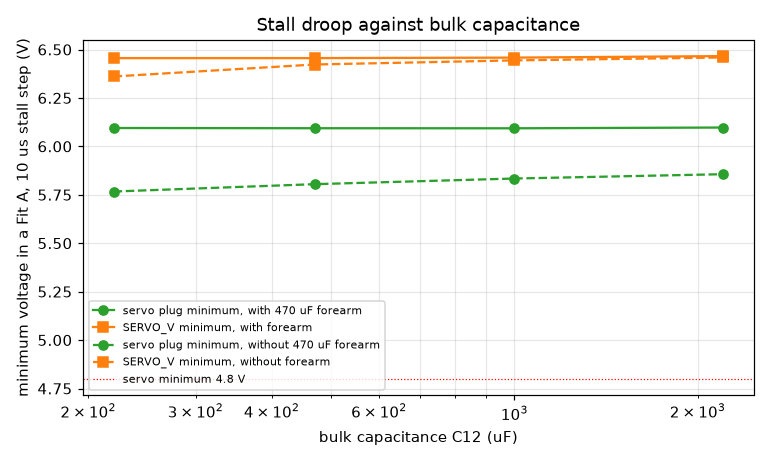
ecad/gripper/calc/out/figures/droop_vs_cbulk.png
