douglaspmcgowan/cloth-feed-gripper/ecad/gripper/calc/out/figures/fsr_node_vs_force.png

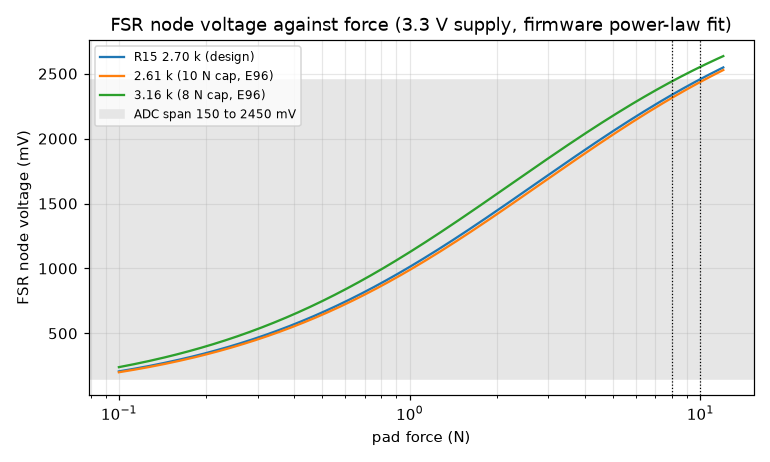
ecad/gripper/calc/out/figures/fsr_node_vs_force.png
