douglaspmcgowan/cloth-feed-gripper/ecad/gripper/calc/out/figures/loop_bode.png

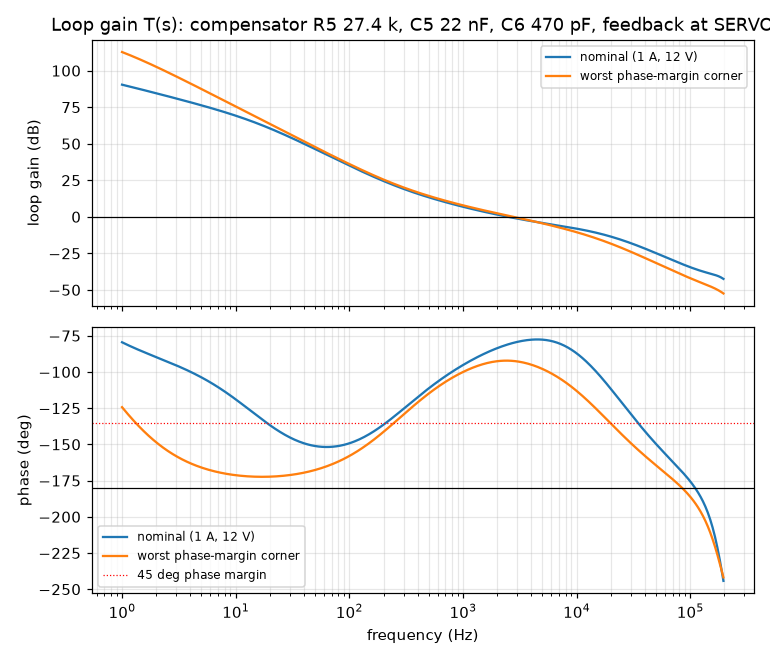
ecad/gripper/calc/out/figures/loop_bode.png
