douglaspmcgowan/cloth-feed-gripper/ecad/gripper/kicad/out/board-top.png

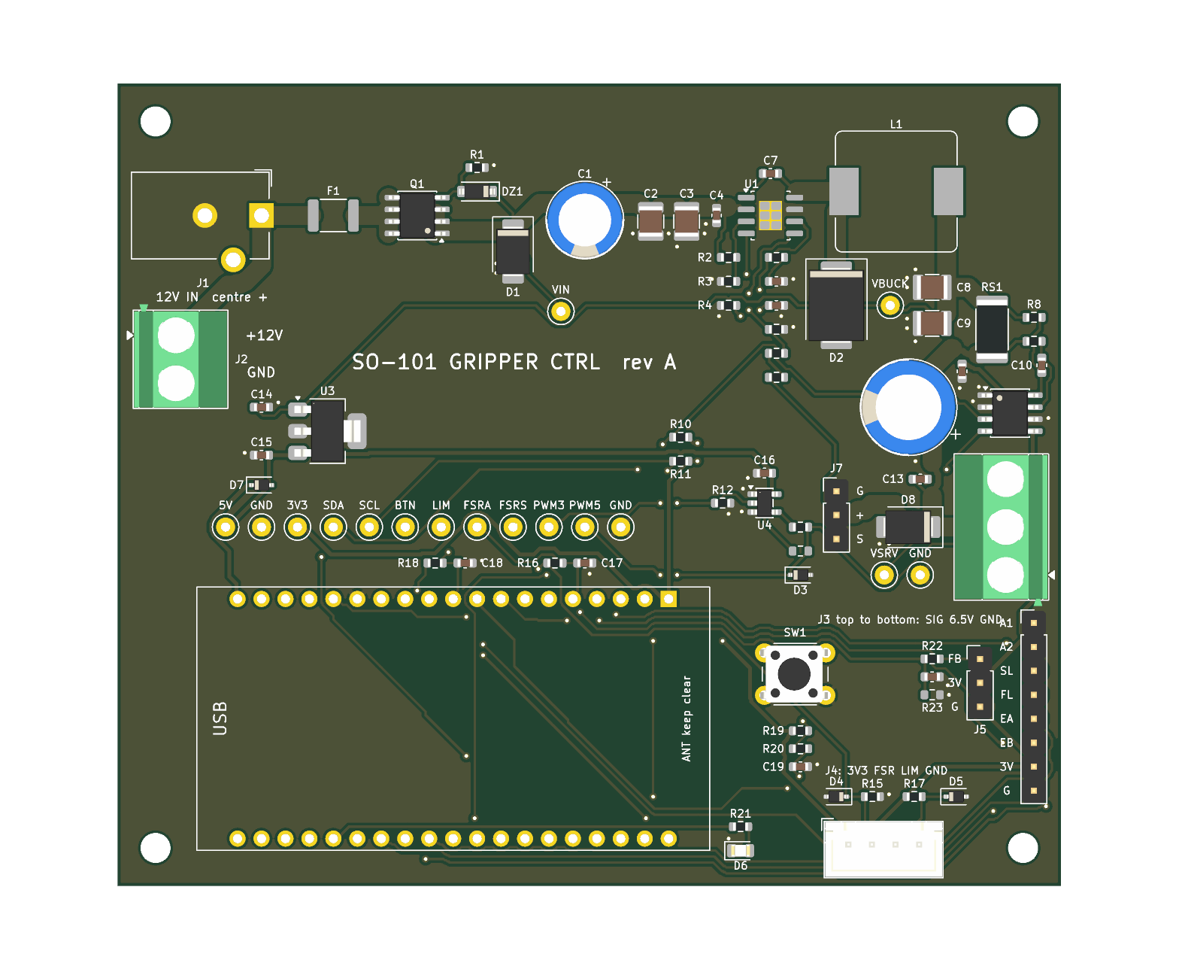
ecad/gripper/kicad/out/board-top.png
