douglaspmcgowan/cloth-feed-gripper/public/media/og.jpg

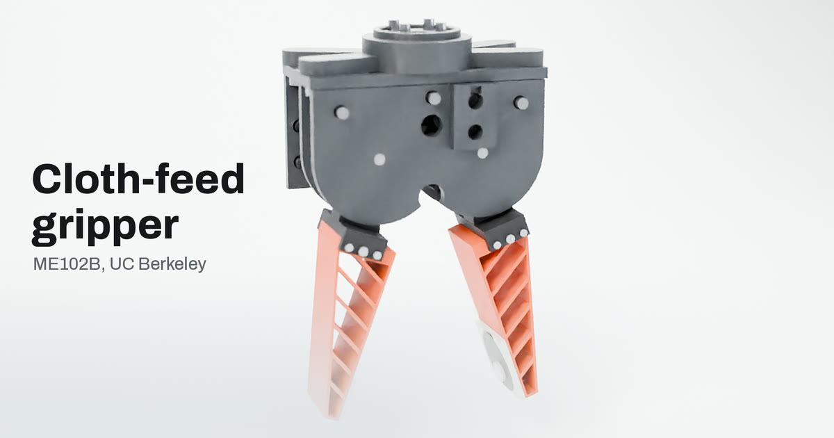
public/media/og.jpg
