douglaspmcgowan/cloth-feed-gripper/public/media/poster.webp

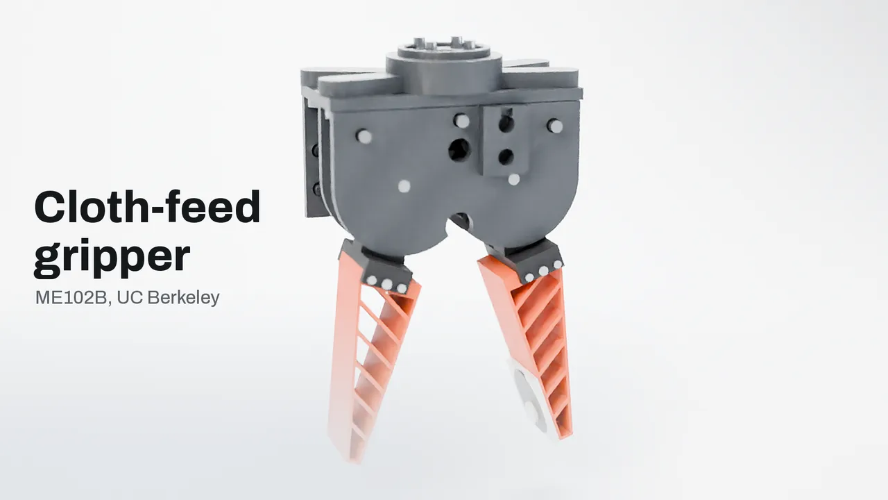
public/media/poster.webp
