douglaspmcgowan/cloth-feed-gripper/public/media/poster_vertical.webp

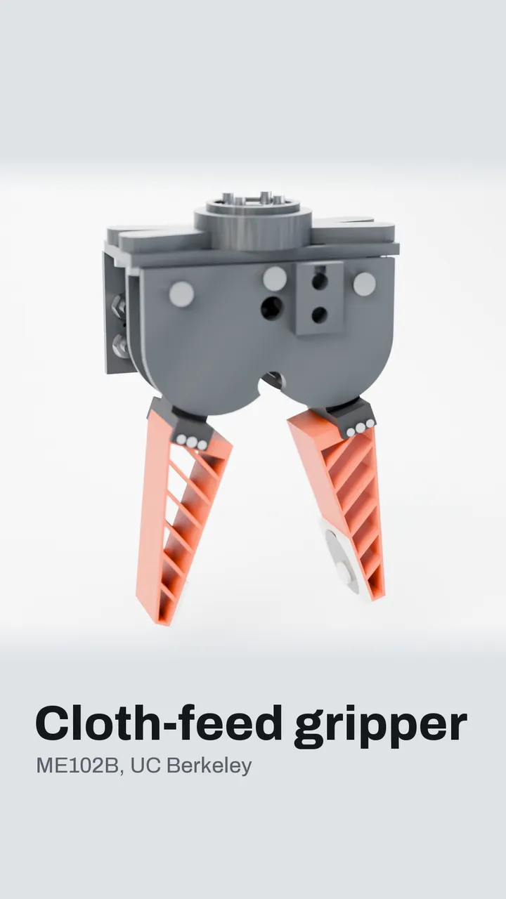
public/media/poster_vertical.webp
