douglaspmcgowan/cloth-feed-gripper/video/gripper/review/bench/bench_S1.png

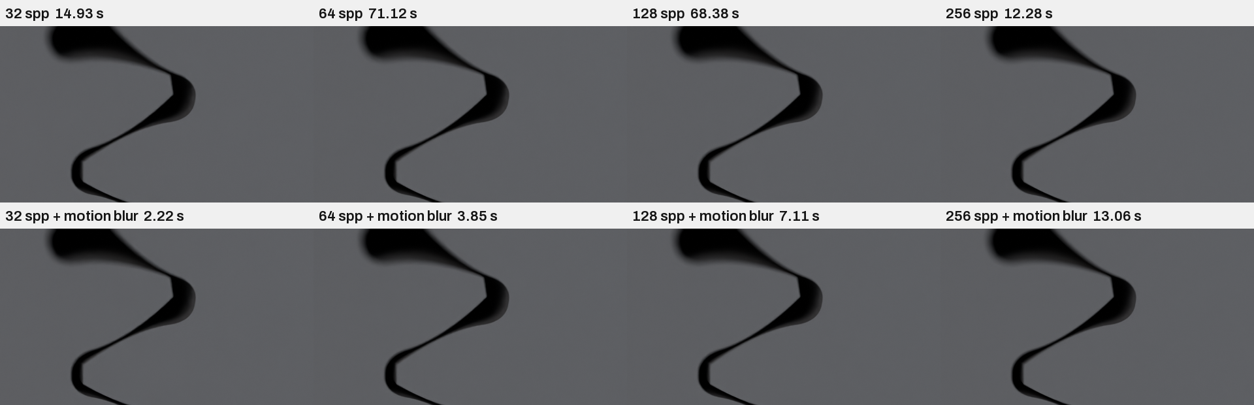
video/gripper/review/bench/bench_S1.png
