douglaspmcgowan/cloth-feed-gripper/video/gripper/review/bench/bench_S2.png

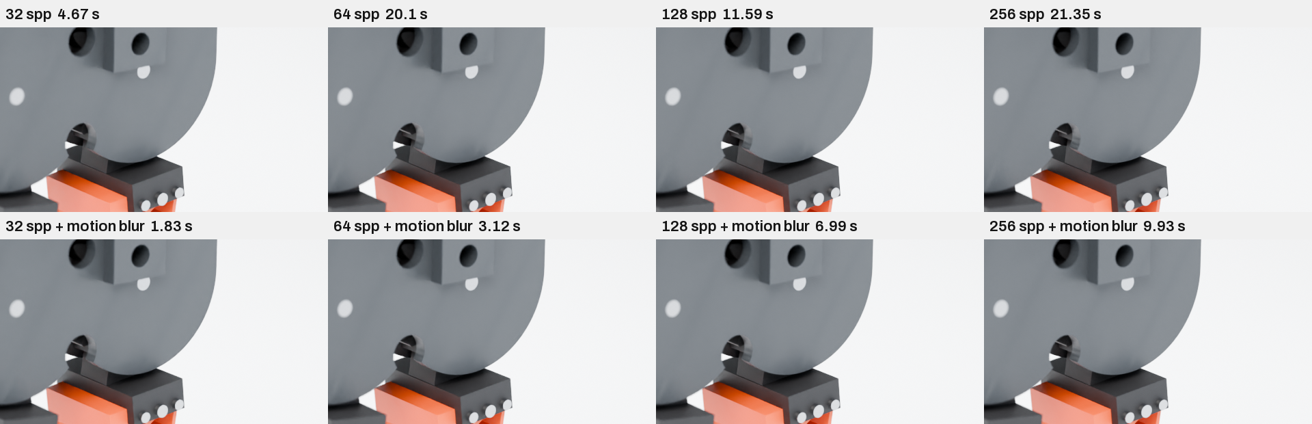
video/gripper/review/bench/bench_S2.png
