douglaspmcgowan/cloth-feed-gripper/video/gripper/review/bench/bench_S6.png

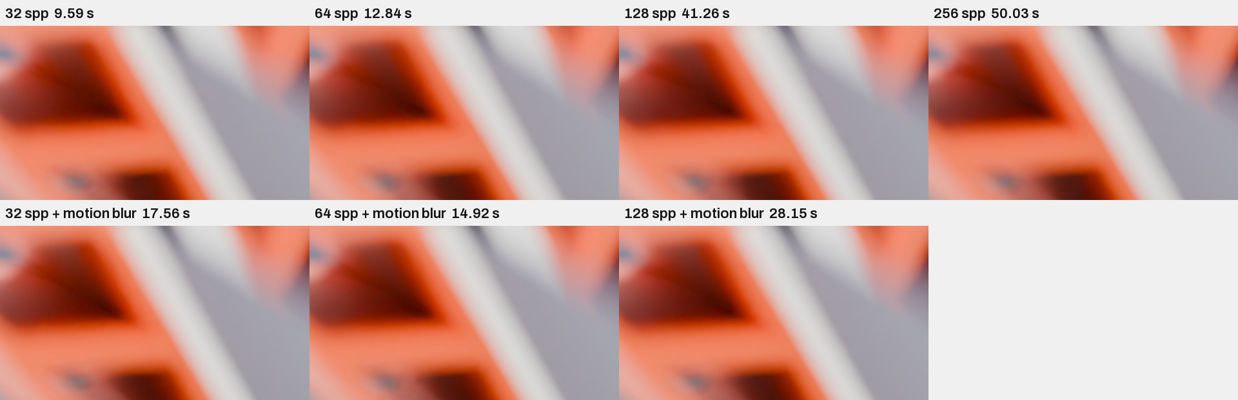
video/gripper/review/bench/bench_S6.png
