douglaspmcgowan/cloth-feed-gripper/video/gripper/review/compare/b1_044s.png

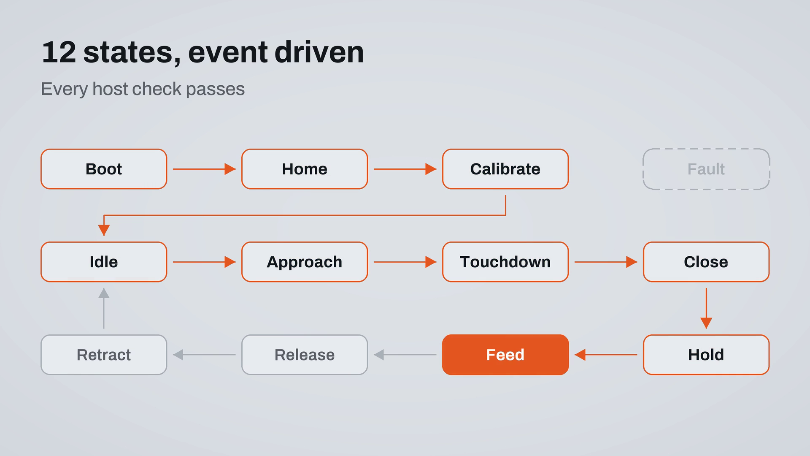
video/gripper/review/compare/b1_044s.png
