douglaspmcgowan/cloth-feed-gripper/video/gripper/review/compare/land_02s.png

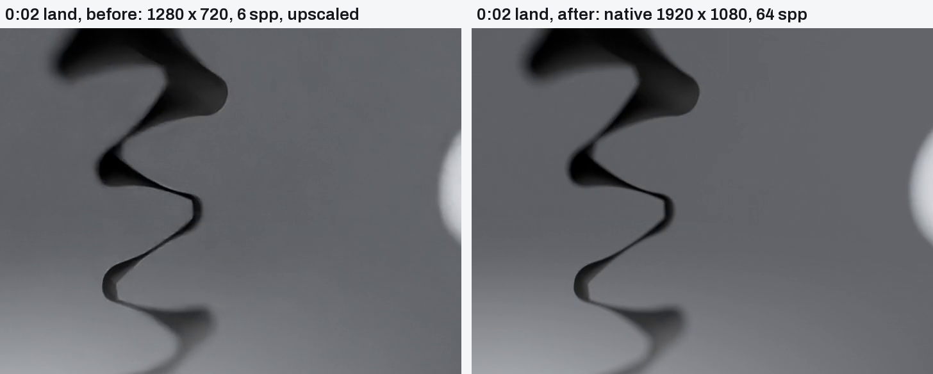
video/gripper/review/compare/land_02s.png
