douglaspmcgowan/cloth-feed-gripper/video/gripper/review/compare/land_20s.png

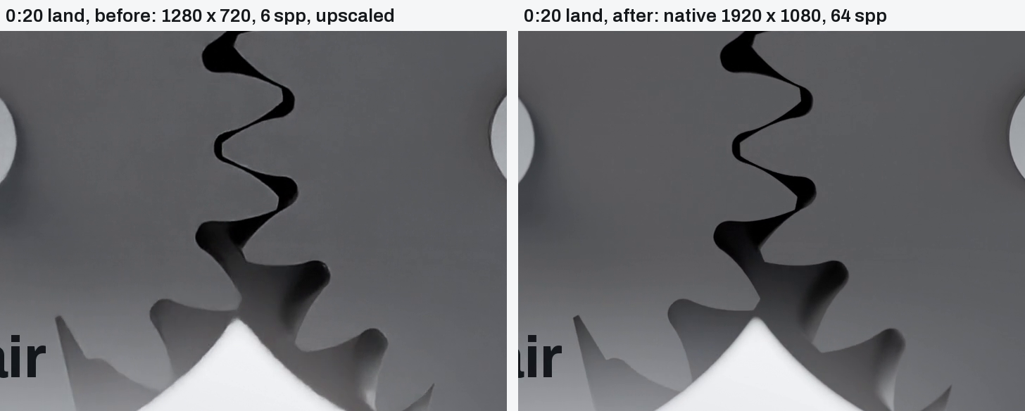
video/gripper/review/compare/land_20s.png
