douglaspmcgowan/cloth-feed-gripper/video/gripper/review/compare/preview_s10_0056_5_land.png

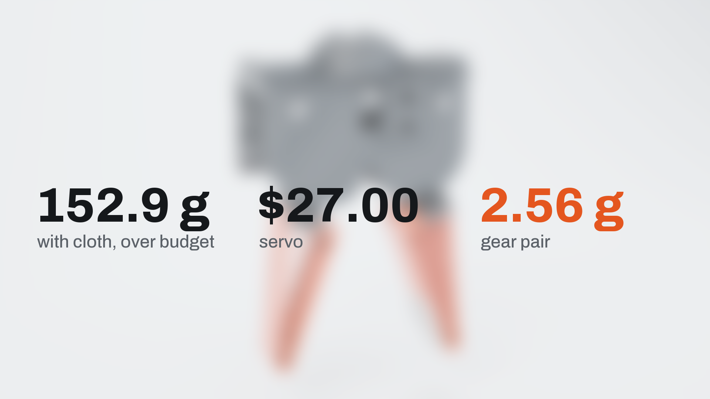
video/gripper/review/compare/preview_s10_0056_5_land.png
