douglaspmcgowan/cloth-feed-gripper/video/gripper/review/compare/rerender_006s.png

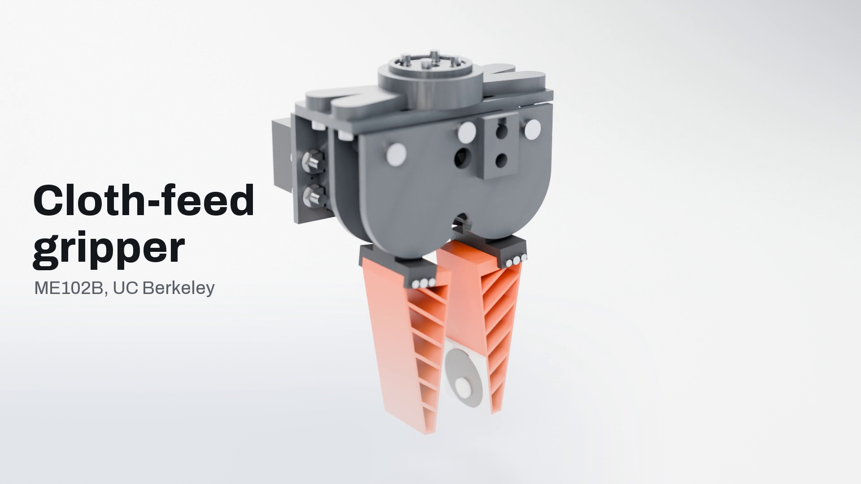
video/gripper/review/compare/rerender_006s.png
