douglaspmcgowan/cloth-feed-gripper/video/gripper/review/compare/rerender_S2_0100_crop100.png

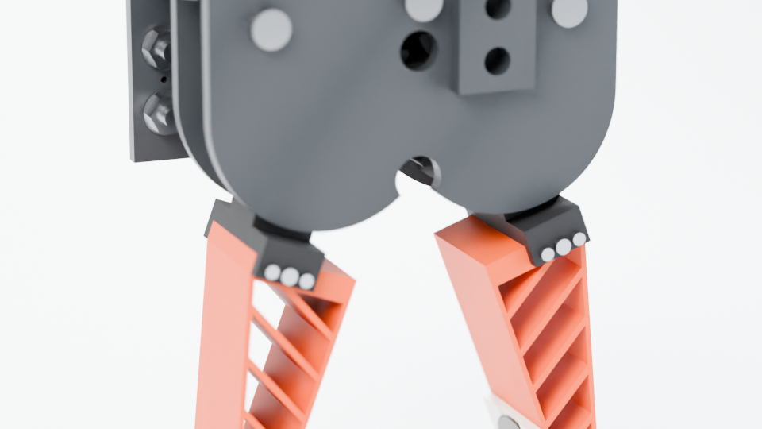
video/gripper/review/compare/rerender_S2_0100_crop100.png
