douglaspmcgowan/cloth-feed-gripper/video/gripper/review/compare/vert_02s.png

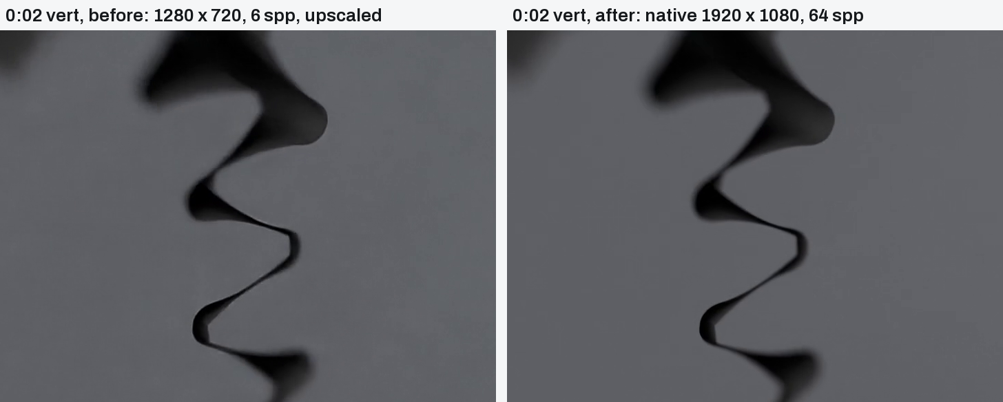
video/gripper/review/compare/vert_02s.png
