douglaspmcgowan/cloth-feed-gripper/video/gripper/review/compare/vert_06s.png

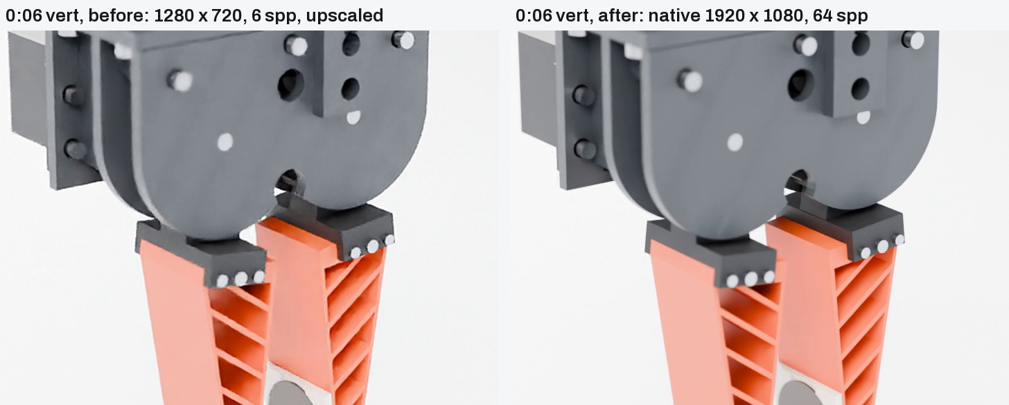
video/gripper/review/compare/vert_06s.png
