douglaspmcgowan/cloth-feed-gripper/video/gripper/review/compare/vert_12s.png

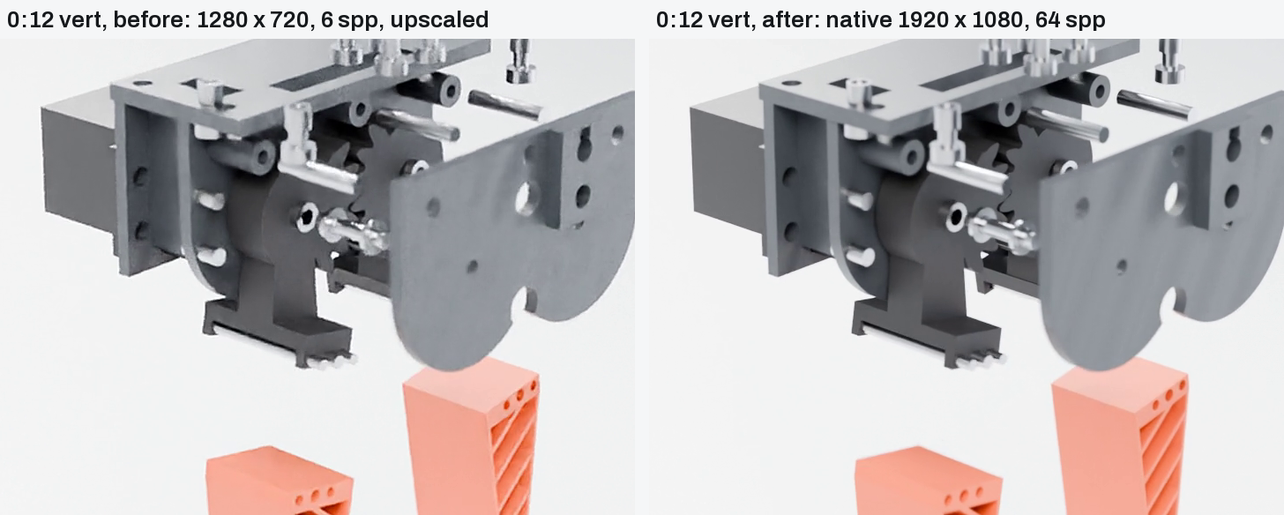
video/gripper/review/compare/vert_12s.png
