douglaspmcgowan/cloth-feed-gripper/video/gripper/review/compare/vert_20s.png

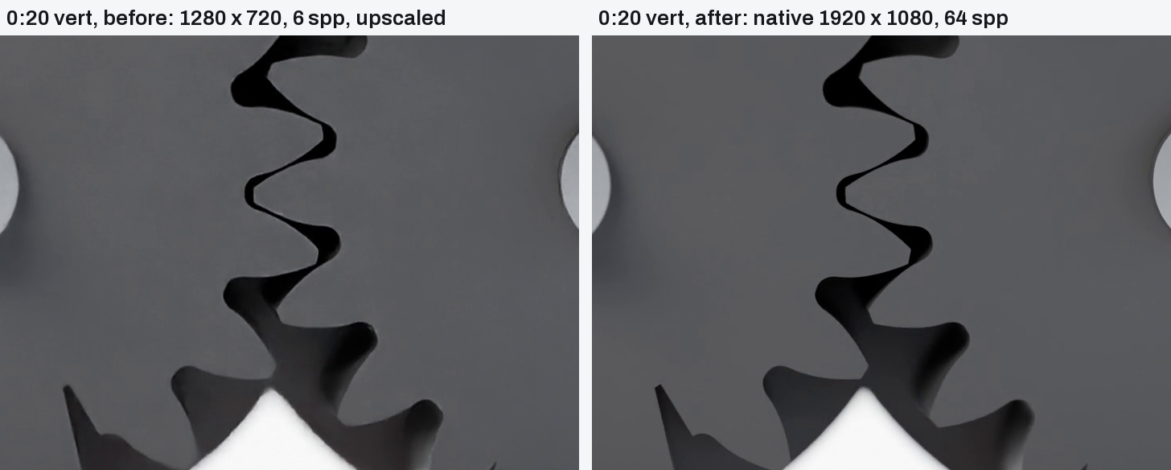
video/gripper/review/compare/vert_20s.png
