douglaspmcgowan/cloth-feed-gripper/video/gripper/review/frames/land_04s.jpg

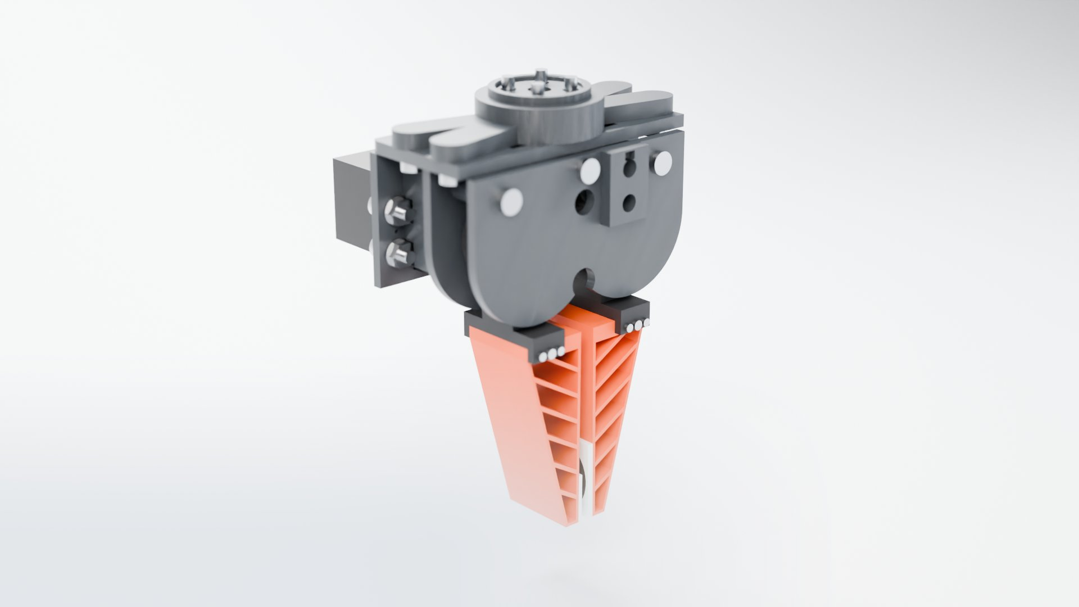
video/gripper/review/frames/land_04s.jpg
