douglaspmcgowan/cloth-feed-gripper/video/gripper/review/frames/land_22s.jpg

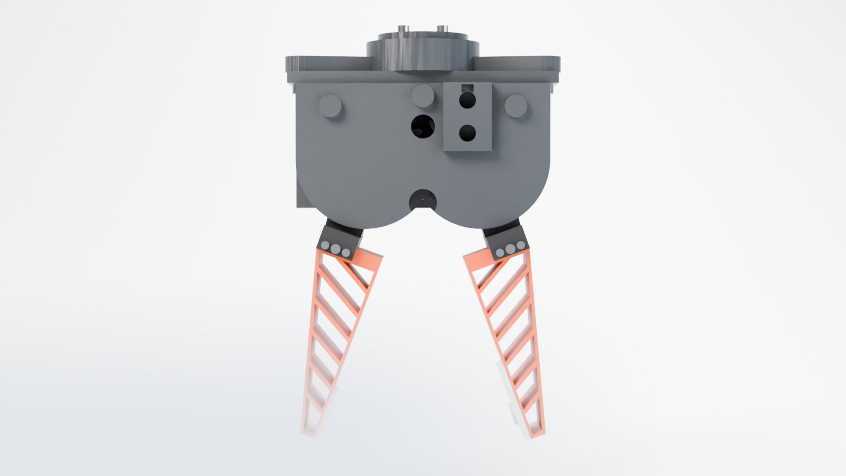
video/gripper/review/frames/land_22s.jpg
