douglaspmcgowan/cloth-feed-gripper/video/gripper/review/frames/land_30s.jpg

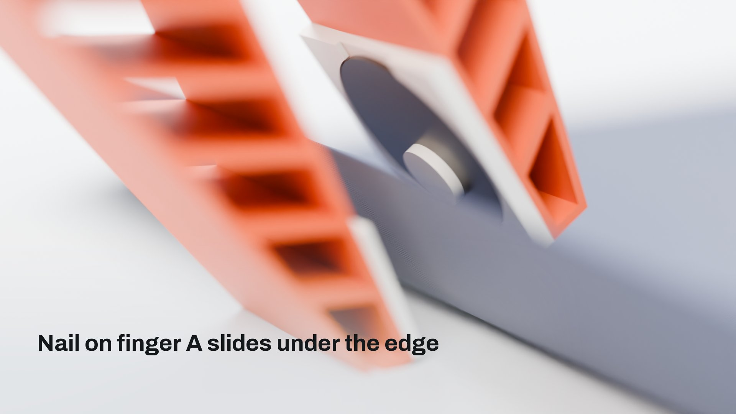
video/gripper/review/frames/land_30s.jpg
