douglaspmcgowan/cloth-feed-gripper/video/gripper/review/frames/land_34s.jpg

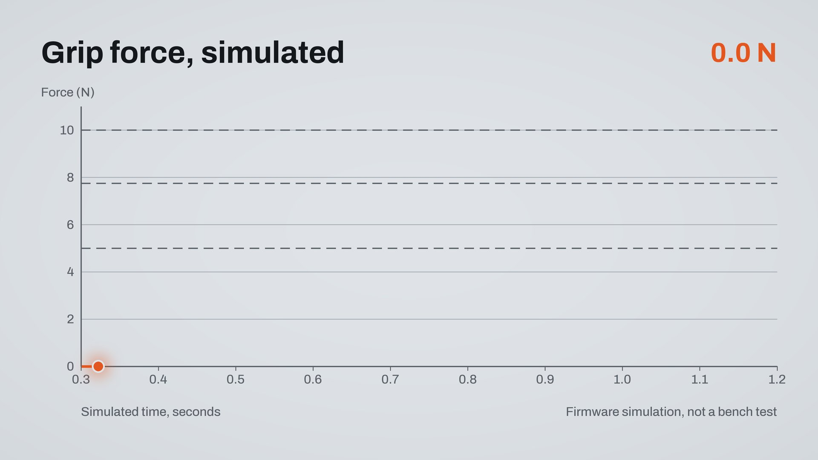
video/gripper/review/frames/land_34s.jpg
