douglaspmcgowan/cloth-feed-gripper/video/gripper/review/frames/land_42s.jpg

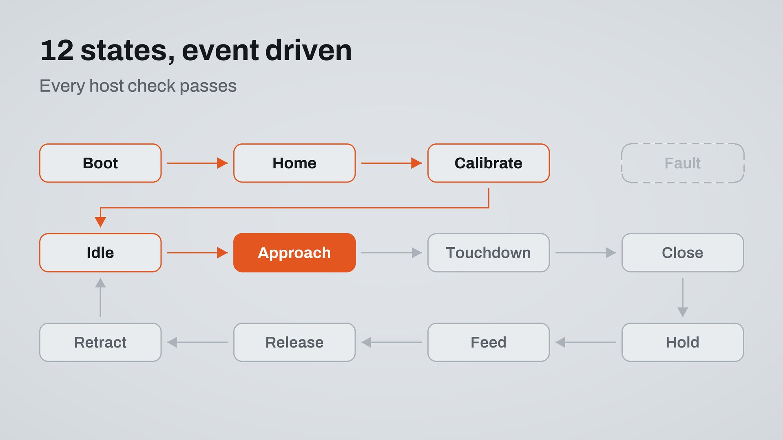
video/gripper/review/frames/land_42s.jpg
