douglaspmcgowan/cloth-feed-gripper/video/gripper/review/frames/land_58s.jpg

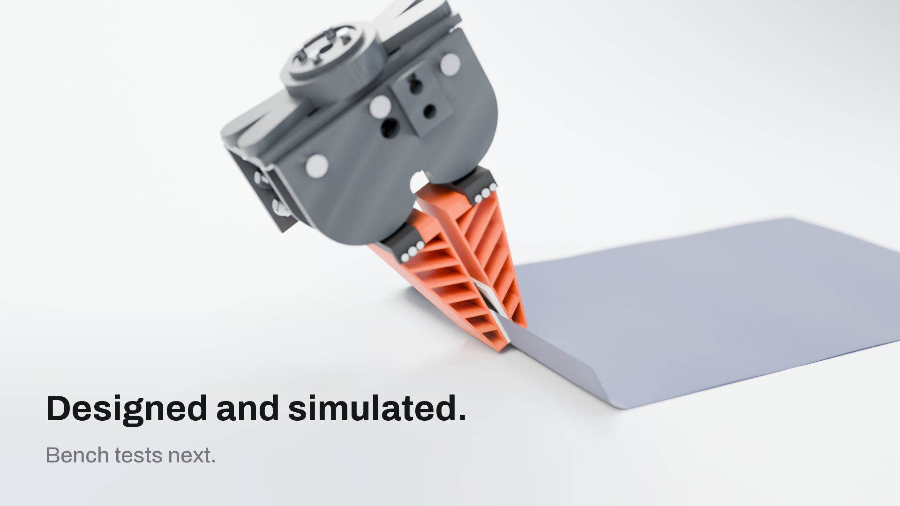
video/gripper/review/frames/land_58s.jpg
