douglaspmcgowan/cloth-feed-gripper/video/gripper/review/frames/land_60s.jpg

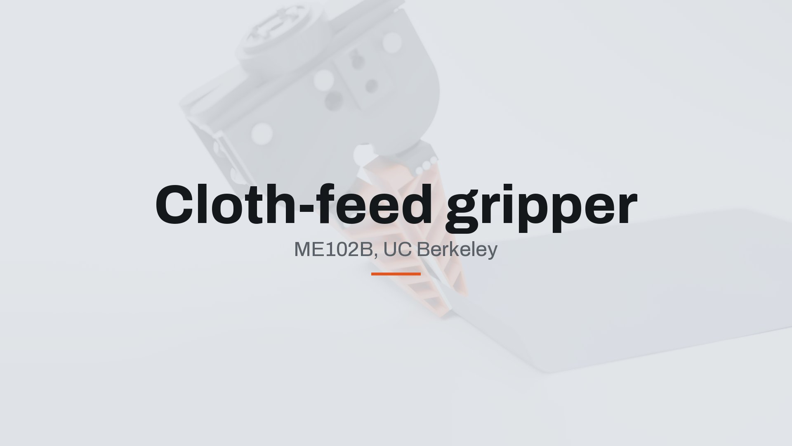
video/gripper/review/frames/land_60s.jpg
