douglaspmcgowan/cloth-feed-gripper/video/gripper/review/frames/vert_02s.jpg

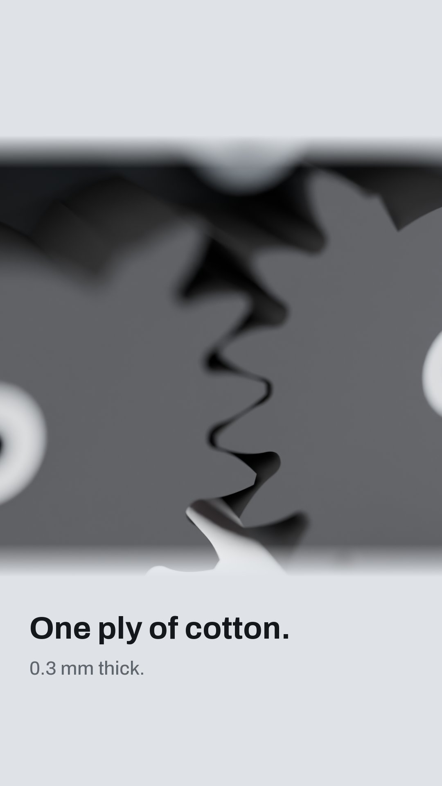
video/gripper/review/frames/vert_02s.jpg
