douglaspmcgowan/cloth-feed-gripper/video/gripper/review/frames/vert_06s.jpg

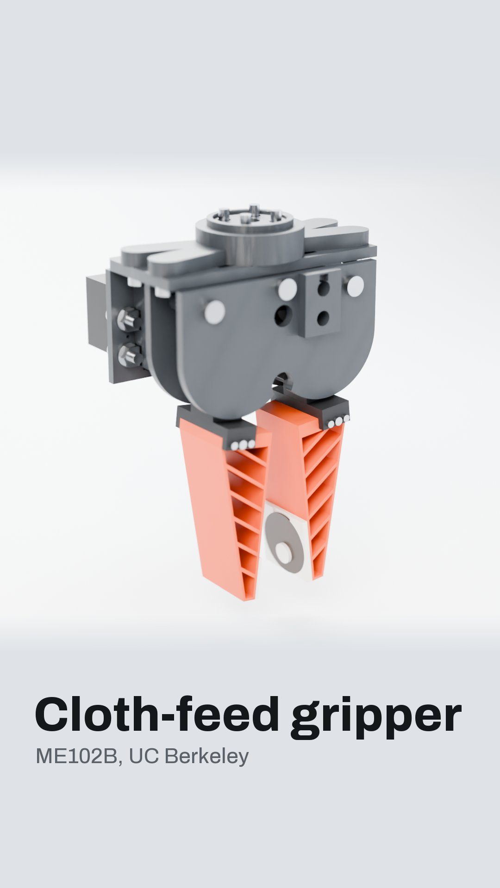
video/gripper/review/frames/vert_06s.jpg
