douglaspmcgowan/cloth-feed-gripper/video/gripper/review/frames/vert_10s.jpg

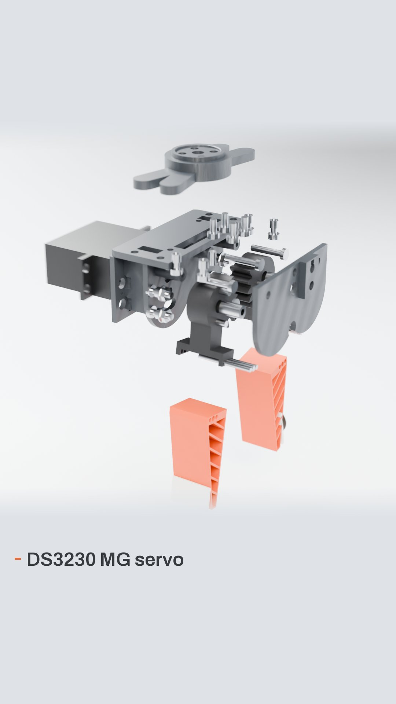
video/gripper/review/frames/vert_10s.jpg
