douglaspmcgowan/cloth-feed-gripper/video/gripper/review/frames/vert_12s.jpg

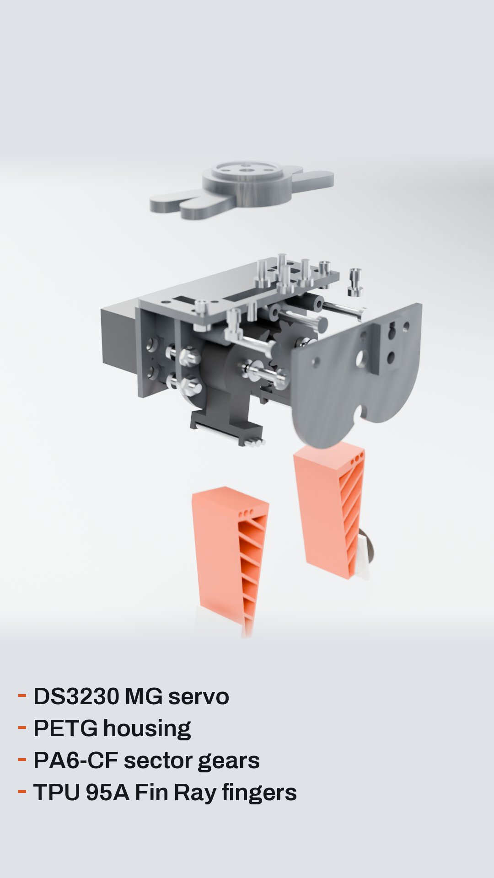
video/gripper/review/frames/vert_12s.jpg
