douglaspmcgowan/cloth-feed-gripper/video/gripper/review/frames/vert_14s.jpg

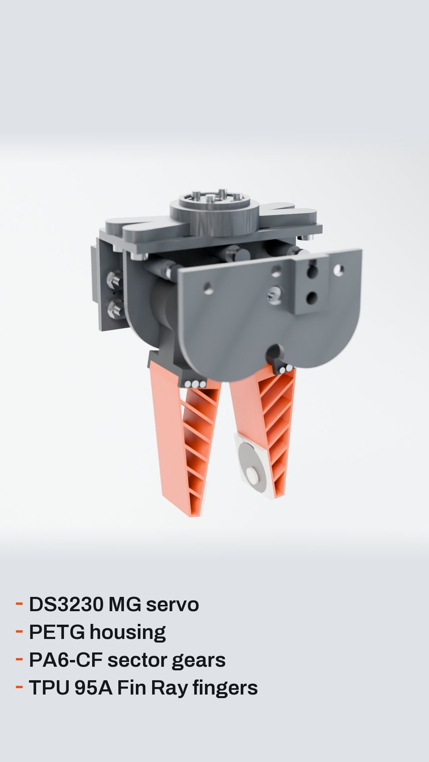
video/gripper/review/frames/vert_14s.jpg
