douglaspmcgowan/cloth-feed-gripper/video/gripper/review/frames/vert_16s.jpg

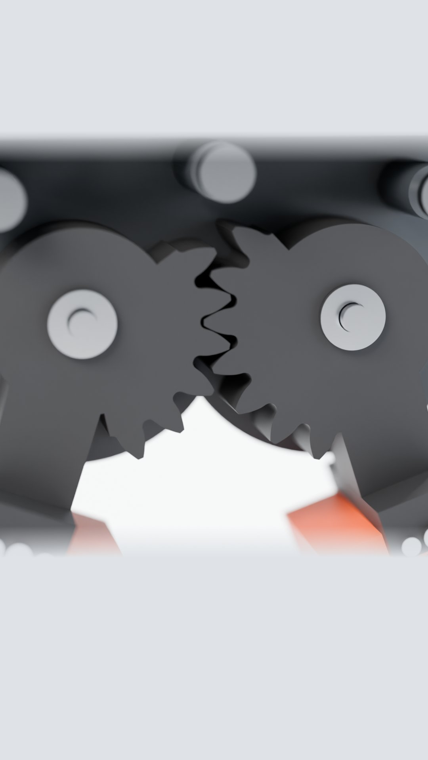
video/gripper/review/frames/vert_16s.jpg
