douglaspmcgowan/cloth-feed-gripper/video/gripper/review/frames/vert_20s.jpg

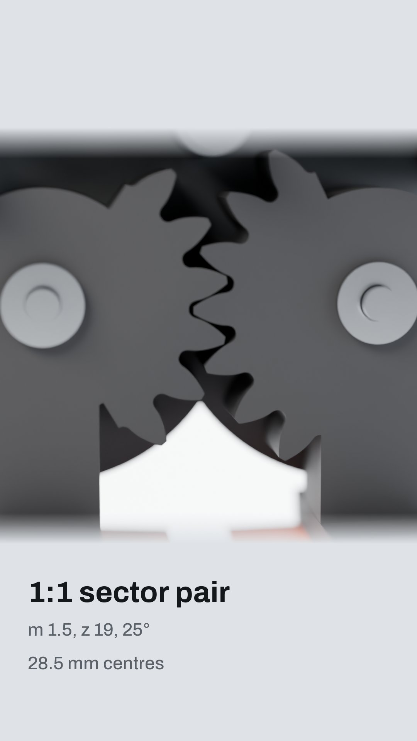
video/gripper/review/frames/vert_20s.jpg
