douglaspmcgowan/cloth-feed-gripper/video/gripper/review/frames/vert_28s.jpg

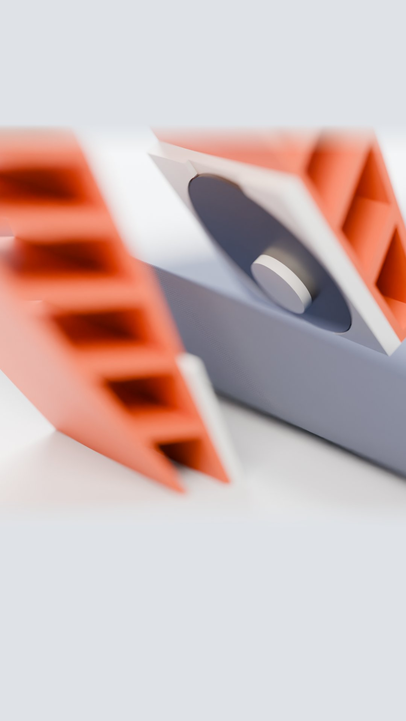
video/gripper/review/frames/vert_28s.jpg
