douglaspmcgowan/cloth-feed-gripper/video/gripper/review/frames/vert_34s.jpg

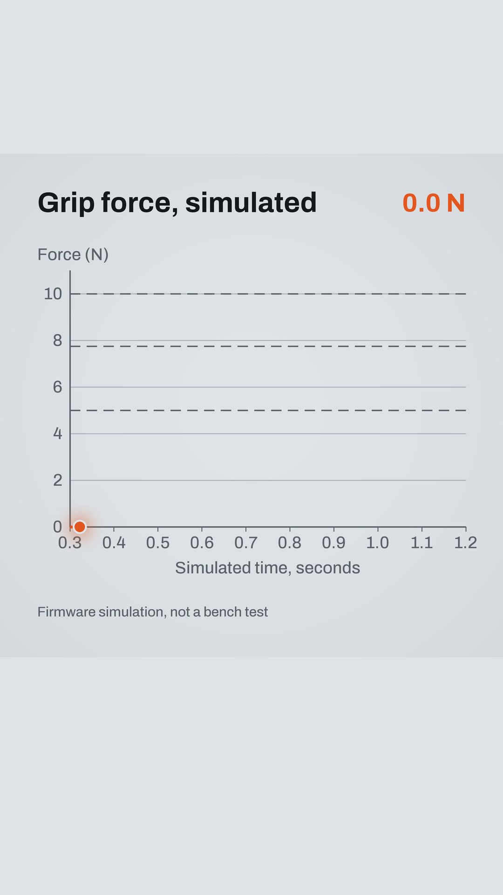
video/gripper/review/frames/vert_34s.jpg
