douglaspmcgowan/cloth-feed-gripper/video/gripper/review/frames/vert_36s.jpg

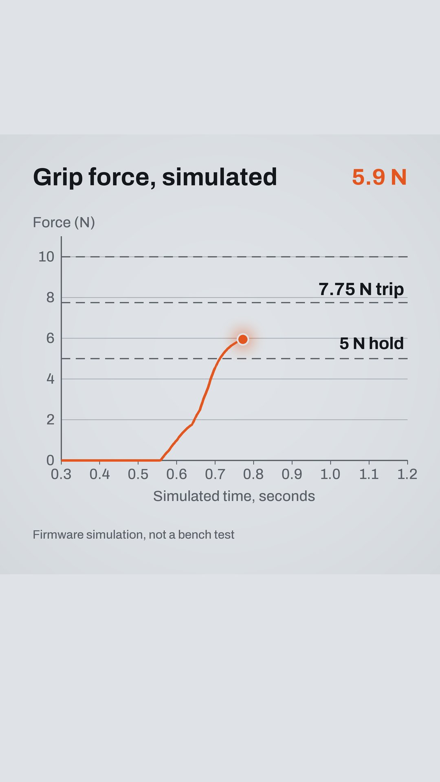
video/gripper/review/frames/vert_36s.jpg
