douglaspmcgowan/cloth-feed-gripper/video/gripper/review/frames/vert_48s.jpg

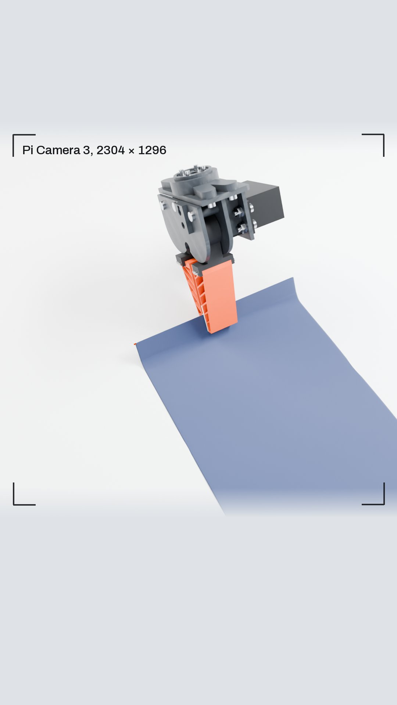
video/gripper/review/frames/vert_48s.jpg
