douglaspmcgowan/cloth-feed-gripper/video/gripper/review/frames/vert_50s.jpg

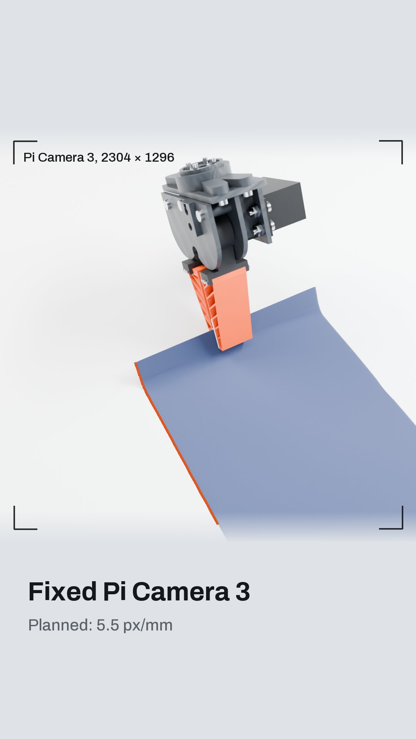
video/gripper/review/frames/vert_50s.jpg
