douglaspmcgowan/cloth-feed-gripper/video/gripper/review/frames/vert_54s.jpg

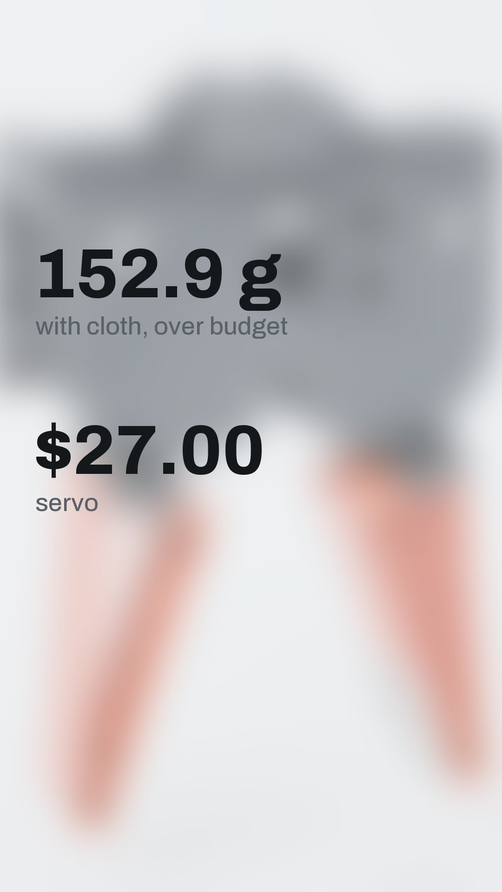
video/gripper/review/frames/vert_54s.jpg
