douglaspmcgowan/cloth-feed-gripper/video/gripper/review/frames/vert_60s.jpg

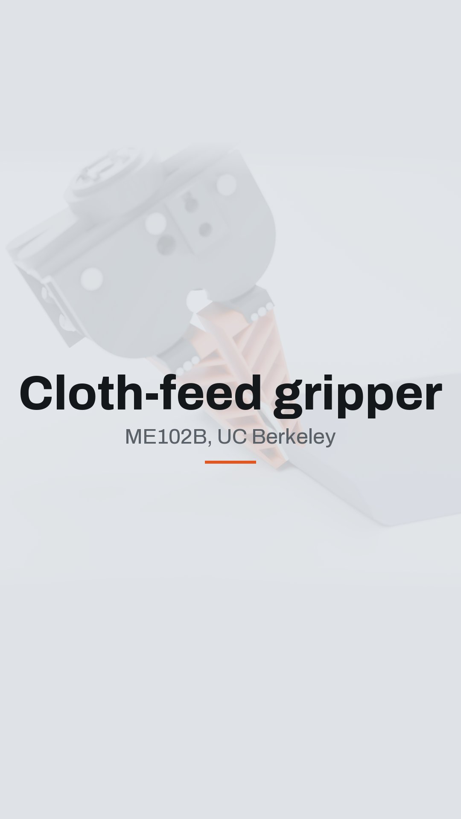
video/gripper/review/frames/vert_60s.jpg
