douglaspmcgowan/cloth-feed-gripper/cad/gripper/drawings/BOM.md

# Gripper bill of materials (revision B)

Generated by `cad/gripper/gripper_concept.py` from `params.json`. Mass [D] = CAD volume x density x fill; filament cost [A] = mass x $/kg; bought parts [A] unit prices unless tagged S. Revision B changes are listed in `cad/gripper/CHANGELOG.md`.

## Printed parts

| Part | Qty | Material | Infill | Orientation | Post-processing | Mass g | Filament USD |
|---|---:|---|---|---|---|---:|---:|
| housing | 1 | PETG | 60 % gyroid, 0.2 mm layers, 4 walls | mid plate (datum D) on the bed; supports under deck and boss web | ream pin holes 3.0 H7 (with front plate), boss bore 9.0 H7 (1.6 mm web on supports: clear support, light feed, tear-out risk), deck peg holes 3.0 H7; check Ø1 thermocouple hole | 11.7 [D] | 0.49 |
| front_plate | 1 | PETG | 60 % gyroid | front face on the bed | ream blind pin holes 3.0 H7 with the housing; 2 heat-set inserts in the camera pad (optional) | 4.1 [D] | 0.17 |
| wrist_mount | 1 | PETG | 100 % | recess face up | ream peg holes 3.0; press 4 M3 heat-set inserts (iron) | 9.2 [D] | 0.23 |
| knuckle_a | 1 | PA6-CF | 100 % | hub face on the bed; hardened nozzle, dried, annealed | ream bore 6.0 H7, press bush 3x6x10; pin-gauge the pressed bore | 6.1 [D] | 0.37 |
| knuckle_b | 1 | PA6-CF | 100 % | hub face on the bed | ream bore 6.0 H7, press bush 3x6x10; pin-gauge the pressed bore | 6.4 [D] | 0.38 |
| finger_a | 1 | TPU 95A | 100 % | flat (rib plane on the bed) | clear the Ø2 peg holes with a 2.0 drill by hand | 4.6 [D] | 0.16 |
| finger_b | 1 | TPU 95A | 100 % | flat (rib plane on the bed) | as finger A | 4.6 [D] | 0.16 |
| nail_a | 1 | PLA | 100 % | flat | bond (CA) on finger A pad | 0.3 [D] | 0.01 |
| fsr_backing_b | 1 | PLA | 100 % | pocket up | bond (CA) on finger B pad | 0.5 [D] | 0.01 |
| fsr_puck_b | 1 | PLA | 100 % | flat | bond (CA) on the FSR active area | 0.0 [D] | 0.00 |

## Bought parts

| Item | Qty | Specification | Supplier class | Unit USD | Note |
|---|---:|---|---|---:|---|
| Servo | 1 | DSServo DS3230 MG (A32), 25T spline, 6.5 V rail | hobby RC vendor (aifitlab listing) | 27.00 | S price; dimensions [A]: measure on the delivered part (README) |
| Horn | 1 | 25T aluminium disc horn Ø22 x 3 with a counterbored centre and two Ø6 hardened steel threaded inserts at r 7 | machined horn / hobby RC blank | 3.00 | A; bore and spline concentricity, insert retention and 1 mm outer rim need coupon verification |
| Horn centre screw | 1 | M3x6 ISO 7380 button head, 2.0 mm hex | hardware (McMaster/Misumi class) | 0.10 | replaces the Phillips screw; driven through the Ø3 pin A bore |
| Dog set screws | 2 | custom M3x10 hardened dog screw with smooth Ø2.9 shoulder starting 0.1 below the horn face | machined hardware | 0.50 | threaded into steel insert; verify shoulder hardness, root radius and retention on coupon |
| Dog steel inserts | 2 | Ø6 outer x M3 threaded bore x 3 long hardened steel sleeve | machined hardware | 0.50 | pressed into aluminium horn; verify 1 mm outer rim on coupon |
| Knuckle pins | 2 | ISO 2338 h8 3 x 16 (2.986-3.000), graded so each pin runs 0.000-0.020 in its pressed bush [tolerance row 2] | precision pins (Misumi/McMaster class) | 0.40 | buy 10 to grade; retaining compound 638 in the mid plate |
| Knuckle bushes | 2 | sintered bronze plain bush 3 x 6 x 10 (oil-impregnated) | bearing supplier (Oilite class) | 0.60 | no 3 x 5 found [A]; buy 5 for the coupon |
| Shims | 4 | shim washer 3.2 x 7, 0.05 mm step assortment (0.1-1.0) [A] | hardware (RC shim class) | 0.10 | one stack per knuckle face, 0.85 nominal; bears on the hub face (OD > the Ø6 bush); picked at assembly to 0.3 ± 0.05 end play |
| Deck locating pins | 2 | ISO 2338 h8 3 x 6 | precision pins | 0.30 | bonded in the spider, slip in the deck (row 5) |
| Horn screws | 4 | M3x6 pan head ISO 7045 | hardware | 0.05 | length per measured horn hole depth: M3x6 needs ≥ 3.75 mm |
| Deck screws | 4 | M3x6 pan head ISO 7045 | hardware | 0.05 |  |
| Heat-set inserts | 4 | M3 brass heat-set insert, bore 4.2 x 3.5 | hardware | 0.15 | spider |
| Camera-pad inserts (optional) | 2 | M3 brass heat-set insert 4.2 x 4.5 | hardware | 0.15 | only for the wrist UVC option |
| Servo tester or controller | 1 | servo tester, or the ESP32 controller on the 6.5 V rail | hobby RC / course kit | 0.00 | steps 11 and 29-31 drive the jaw |
| Ear screws | 4 | M3x10 pan head ISO 7045 | hardware | 0.05 | head under the servo ear |
| Compression limiters | 4 | brass or steel tube 5.0 x 3.2, cut to 2.55 (thermal.md C1) [A] | metal tube stock (K&S class) | 0.10 | thermal C1 |
| Washers | 4 | M3 ISO 7089 7 x 3.2 x 0.5 [S class] | hardware | 0.02 | mandatory under each nut |
| Nuts | 4 | M3 hex nut ISO 4032 | hardware | 0.02 | on the frame front face, in the notch |
| Front plate screws | 3 | M3x16 pan head, self-tapping into the Ø2.5 standoff pilots | hardware | 0.06 | stop at first snug |
| Finger pegs | 4 | dowel pin 2 x 24 (= root block width; the 26 mm CAD solid is the hole tool, 1 mm proud each side) | hardware | 0.20 | RISK F48 |
| Finger root bolts | 2 | M2x30 + nut (24 block + 1.6 nut + thread) | hardware | 0.08 | RISK F48; was M2x25, too short |
| FSR | 1 | Interlink FSR 402 (Adafruit 166) | Adafruit | 7.95 | S |
| Thermocouple | 1 | type-K bead, Ø ≤ 1.0 (test only) | test equipment | 0.00 | thermal.md 6; not on the arm |
| Consumables | 1 | retaining compound 638, thread-locker 243, CA glue | hardware | 0.00 | shared |

## Mass and cost

| Item | Qty | Material | Source | Mass g | USD | Basis |
|---|---:|---|---|---:|---:|---|
| printed parts | 10 | PETG / PA6-CF / TPU / PLA | printed | 47.6 | 1.98 | D mass; A filament price |
| servo | 1 | - | bought | 60.0 | 27.00 | S listing |
| horn | 1 | Al | bought | 3.4 | 3.00 | D envelope x density |
| FSR | 1 | - | bought | 0.6 | 7.95 | A |
| fasteners, pins, bushes, sleeves, other bought items | 1 set | steel / bronze / brass | bought | 23.8 | 8.30 | D per item |
| **total on the arm (no cloth, no wiring)** | | | | **135.4** | **48.23** | |

Unrounded 135.38 g; `fitcheck.py` adds 13.5 g cloth and 5.0 g wiring (153.88 g) for R10.

- Printed parts 47.6 g; servo 60.0 g [S listing]; horn 3.4 g [D]; FSR 0.6 g [A]; fasteners, pins, bushes, sleeves 23.8 g [D per item, `out/parts.json` fastener_masses_g].
- **Total on the arm (no cloth, no wiring): 135.4 g**; filament 1.98 USD + bought 46.25 USD = **48.23 USD**.

## Tools for post-processing and assembly

- M3 tap and 2.5 mm drill (horn dog holes)
- 7 mm spanner or pliers
- tweezers
- flat block
- depth gauge (horn hole depth)
- torque-limited screwdriver (plate screws, RISK F45)
- 3.0 mm H7 hand reamer
- 6.0 mm H7 hand reamer
- 9.0 mm H7 hand reamer
- 3 mm pin gauges (0.002 step) or a 0-25 micrometer
- feeler gauges 0.05-0.5
- 2.0 mm and 1.5 mm hex keys
- Phillips #1
- soldering iron with insert tip
- arbor press or vice
- caliper with depth rod
- 1.0 mm drill (thermocouple hole check)

## Measure before you buy or assemble

- Horn hole depth on the arm (DB M15): pick the horn screw length by `wrist_mount.horn_screw_rule` (M3x6 needs ≥ 3.75 mm; 3.5-3.7 marginal; shallower: drill and re-tap).
- Servo case width in 3 places on 3 units: pocket = largest + 0.40 (set `servo.body_x`); boss diameter; ear pattern (servo `measure_on_delivered_part`).
- Pressed bush bores (pin gauge) and each pin (micrometer): pair them for 0.000-0.020 clearance.
- Shim stack at each pin with feeler gauges for 0.3 ± 0.05 end play.

Off-arm (not in the mass): primary camera Pi Camera 3 on a table post (camera.md 6), ESP32 DevKitC, INA219, 6.5 V buck, 1000 uF cap.
