douglaspmcgowan/cloth-feed-gripper/docs/gripper/test/verification_matrix.csv

id | requirement | method | procedure | pass_criterion | instrument | sample_size | status
R1 | ≥ 1 moving transmission DOF | Demonstration + inspection | TP-10 | Jaw opens and closes through the 1:1 sector pair; GSI confirms a 1:1 pair counts (M20). Pass/fail | Eyes; assembly drawing | 1 demo; a rule is checked once | not started
R2 | ≥ 1 DC motor | Inspection | TP-10 | GSI answer that a PWM hobby servo counts as the DC motor, recorded in LOG.md (M20). Pass/fail | Written answer | 1; documentary | analysed only
R3 | ≥ 1 analog input | Demonstration | TP-10, TP-01 | `analogRead` trace of the FSR changes by ≥ 300 mV between 0 and 5 N during a grip [A threshold] | Host log, 1 mV | 1 trace; a function either works or not | simulated
R4 | ≥ 1 digital button | Demonstration | TP-10 | Each of 5 presses logs one `EVT BUTTON_PRESS`; a 0.8 s hold logs `BUTTON_LONG` | Event log, 1 ms | 5 presses: catches bounce | simulated
R5 | Microcontroller | Inspection + test | TP-10 | `arduino-cli compile --fqbn esp32:esp32:esp32` exits 0 on the tested commit; the board boots to IDLE | Compiler exit code | 1; deterministic | simulated
R6 | State machine, event-driven, no blocking delay() | Inspection + demonstration | TP-10, TP-03 | No `delay(` in `firmware/gripper/`; the event log of one full cycle shows ENTER_ events in the section 8 order | grep; event log | 1 full cycle; deterministic code | simulated
R7 | PWM actuator, not the STS3215 bus | Inspection + test | TP-10, TP-13 | Signal is 50 ± 1 Hz, pulse 500-2500 µs range, clamped 1200-1900 µs by the firmware | Scope or logic analyser, U = 1.6 µs (k = 2) | 1 sweep; deterministic | analysed only
R8 | ≤ $50 per actuator | Inspection | TP-10 | Receipt or vendor page price ≤ US$50.00 (BOM: DS3218MG US$12.99) | Receipt | 1 | analysed only
R9 | Compact (rolling envelope) | Inspection + analysis | TP-09, TP-11 | Hub ≤ Ø23.2 mm to H+1 and ≤ Ø29.2 mm to H+4.5 (tolerance_stacks.md fix 5; DB R9 says Ø24 / Ø30); full wrist roll and flex sweep with no contact | Calipers ±0.05 mm (k = 2) | 3 readings per diameter; one sweep | analysed only
R10 | Light: mass-moment ≤ 43,720 g·mm | Test (measurement) + analysis | TP-09 | m × (309.1 mm + COM past H) ≤ 43,720 g·mm with cloth and wiring; stretch ≤ 33,380 (PASS needs ≤ 33166 g·mm after U). CAD revision B predicts 53342 g·mm (122.0 %): FAIL at full reach; PASS if value ≤ 43506 g·mm (limit − U); FAIL if value ≥ 43934 g·mm (limit + U); INDETERMINATE in between. Disposition: no holds beyond 284.1 mm COM reach, enforced by TP-14. The DB and BOM estimates are retained as history | Balance 0.1 g; knife edge ±1 mm; U = 214 g·mm | 3 weighings, 3 balance points: averages out placement | analysed only
R11 | Public, cited sources only | Inspection | TP-10 | Every [S] in docs/gripper has a public URL; none is a course file or pirated PDF | Reviewer checklist | 1 pass over the source lists | not started
R12 | Compliant fingers, 0.88 ≤ k ≤ 1.63 N/mm | Test | TP-12 | Secant tip-pad stiffness 0.5-5 N inside 0.88-1.63 N/mm for both fingers with their D7 parts; at the 8 N proposed cap k ≥ 1.05 N/mm | Dial 0.01 mm + masses; U = 4.5 % of k | 3 load-unload runs per finger: hysteresis and repeatability of printed TPU | analysed only (FEA)
R13 | Strong gear profile | Analysis + test | TP-15, TP-06 | Spare sector pair holds LC1 0.38 N·m (DB; gears.md 0.399 with the tension moment) to LC3 2.11 N·m in +20 % steps for 60 s each with no crack and backlash growth ≤ 0.1 mm at the pad [A] | Lever + hanger masses, ±1 % | 1 destructive pair (2 if PETG is still a candidate): the cost of a pair | analysed only
R14 | Hold ≥ 5.0 N per pad through the 25.5 s hold | Test | TP-01, TP-02 | Probe force ≥ 5.0 N at every sample of a 25.5 s hold; no slip > 0.5 mm at 2 N tension; pull-to-slip ≥ 4.0 N (SF 2 at μ 0.4) | Pinch probe, U = 0.10 N (k = 2) at 5 N | 11 holds on the softest finger pair and 3 on the stiffest (by TP-12): softest judged hold by hold as a zero-failure run (each F_min clears 5.0 N + U; the 95/90 bound cannot clear at a bench-sized n), stiffest by the 95/90 bound; 11 pulls: zero-failure run R 0.8 / C 0.9 | simulated
R15 | Force cap | Test + analysis | TP-04, TP-16 | Peak probe force ≤ 10 N (written) and ≤ 8 N (proposed) in: G 7, contact 6-10° early, FSR reading 50 %, pushed finger; FSR_OVER → FAULT within 20 ms of crossing the trip; a shorted, open or frozen FSR or a bad FSR zero ends in FAULT_FSR_SHORT / FAULT_FSR_OPEN (or a miss under 0.60 A) / FAULT_FSR_STUCK / FAULT_ZERO_BAD in 3 of 3 trials (TP-16) | Pinch probe, U = 0.11 N at 10 N | 3 per deterministic case (G 7, early contact, FSR at 50 %); 22 pushed-finger trips: zero-failure run R 0.9 / C 0.9 (safety) | simulated
R16 | Servo hold ≤ 40 % of stall | Test | TP-13 | Stall torque ≥ 1.98 N·m (20.2 kg·cm) at the 6.35 V rail low end; hold current ≤ 40 % of stall current | Lever + probe; U = 1.6 % of T | 3 stalls of ≤ 2 s: winding heats 3 K per 0.2 s | analysed only
R17 | Moment arm r_c ≤ 65 mm | Inspection | TP-09 | Pivot-to-pad-normal distance r_c on both fingers, one-sided (the requirement is a maximum, so a short arm is not a fail): PASS if value ≤ 64.92 mm (limit − U); FAIL if value ≥ 65.08 mm (limit + U); INDETERMINATE in between. U = 0.077 mm | Calipers and square, U = 0.077 mm (the r_c method, not the caliper alone) | 3 readings per finger | analysed only
R18 | Motion range | Test + inspection | TP-08, TP-10 | Open stop +20 ± 1° (TP-08). Floor θ ≥ θ_c0 − 4.9° in the force loop (config.h JAW_FLOOR_BELOW_C0_DEG) and θ ≥ -10.2° absolute (JAW_MIN_DEG, inside DB R18's −11°) checked by inspection of the firmware clamp in TP-10; the bench closes never reach it (squeeze cap about −3°), so it is not exercised | Protractor on video ±0.6° | 3 sweeps | simulated
R19 | Close time | Test | TP-03 | From `G 5` at the open stop (+20°): historical contact ≤ 0.50 s (superseded 2026-10-12); ruled R19, 4.5 N and 5.0 N each ≤ 0.75 s. Both: last 3° before contact: commanded speed JAW_SPEED_NEAR_DPS = 20 °/s (DB limit 20, inspected, U = 0) and the video fit v + U ≤ 25 °/s (U = 2.2 °/s). Ruled limit: PASS if bound ≤ 0.7464 s (limit − U); FAIL if bound ≥ 0.7536 s (limit + U); INDETERMINATE in between, on the upper 95 %/90 % tolerance bound of the closes | Event log U = 3.6 ms; video 240 fps U = 6.8 ms | 10 closes: the 95/90 tolerance bound clears 0.75 s at n = 9 on the predicted 8 ms scatter; 10 gives a scatter estimate | simulated
R20 | Stall back-off ≤ 200 ms | Test | TP-05, TP-16 | Back-off command begins ≤ 200 ms after over-current onset (host test 140 ms); PASS if value ≤ 180 ms (limit − U); FAIL if value ≥ 220 ms (limit + U); INDETERMINATE in between. The reading 'unloaded within 200 ms' is also logged (O11). A stall after contact trips the force-loop limit (3.1 A) in 3 of 3 (TP-05 part D); a current sensor lost after boot ends in FAULT_I_SENSOR in 3 of 3 (TP-16) | 50 Hz ST lines + INA219 (20 ms tick), U = 20.0 ms | 22 blocked closes: zero-failure run R 0.9 / C 0.9 (safety); 3 stalls after contact | simulated
R21 | Calibration stores θ_c0 | Demonstration + test | TP-08 | Boot log shows `EVT CAL_THETA_C0` inside −4…+4°; 10 recalibrations scatter ≤ ±0.27° (one deadband) [A] | Event log, 0.01° | 10: estimates the scatter itself | simulated
R22 | Wrist interface | Inspection + test | TP-11 | Coupon slides onto the real horn pilot by hand; BC Ø14.0 and pilot Ø19.2 (M15) measured; 4 × M3 seat with ≥ 1.5 mm engagement. Rev B gate (TP-11 part F): servo body width W and shaft offset s on 3 servos, pocket chosen so printed P − W_max is 0.10-0.30 mm (PASS), ≤ 0.00 mm (FAIL), else INDETERMINATE | Calipers; coupon | 1 coupon per CAD size tried | analysed only
R23 | Camera provision | Inspection | TP-11 | 2 × M3 insert bores on the front plate accept an M3 screw; camera allowance 10 g counted in R10 | Eyes; an M3 screw | 1 | analysed only
R24 | Work cell | Inspection + test | TP-14 | Shoulder_lift axis within ±50 mm of the cloth tension line; COM reach ≤ 284.1 mm (R10 budget / CAD mass), equivalent fingertip reach ≤ 342.6 mm; existing feed-pose fingertip reach ≤ 300 mm is tighter; arm shoulder load ≤ 50 % of stall (M19) | Tape ±1 mm; STS3215 load register | 1 layout; 3 load readings | analysed only
R25 | Life 1e5 grips | Analysis + test (screen) | TP-06 | Analysis (dyno.md) carries the 1e5 claim. Bench screen: 1e4 fast cycles with no fault, no crack, backlash growth ≤ 0.1 mm, hold still ≥ 5.0 N | Dial 0.01 mm; probe | 1 unit, 1e4 cycles: a zero-failure demo of 1e5 needs about 2.6e5 cycles (β 2, C 0.5) — not affordable | analysed only
R26 | Servo case ≤ 60 °C after 30 min | Test | TP-07 | Case thermocouple: PASS if value ≤ 58.4 °C (limit − U); FAIL if value ≥ 61.6 °C (limit + U); INDETERMINATE in between, at 30 min of the section 7 duty cycle at 5 N. Printed mount (thermocouple in the C3 hole under a servo ear), thermal.md section 3: PASS if value ≤ 48.4 °C (limit − U); FAIL if value ≥ 51.6 °C (limit + U); INDETERMINATE in between with bare PETG (limit 50 °C), PASS if value ≤ 58.4 °C (limit − U); FAIL if value ≥ 61.6 °C (limit + U); INDETERMINATE in between with the C1 metal sleeves (limit 60 °C). Report ambient | Type K + MAX31855 on case and mount, U = 1.6 °C | 1 soak (30 min) + 1 repeat if within 5 °C of the limit | analysed only (model fails 9 of 12)
R27 | Power rail | Test + inspection | TP-13 | Rail 6.5 ± 0.15 V (DB says 6.0 V, superseded) and ≥ 6.35 V during a stall; supply rated ≥ 3 A (4 A until M6, dyno.md); 1000 µF at the servo; common ground | DMM U = 0.06 V; scope | 3 stalls | analysed only
