douglaspmcgowan/cloth-feed-gripper/docs/gripper/research/actuators.csv

id | model | category | vendor | price_usd | price_date | vendor_url | datasheet_url | voltage_min_V | voltage_max_V | torque_low_kgcm | torque_low_at_V | torque_high_kgcm | torque_high_at_V | speed_low_s_per_60deg | speed_high_s_per_60deg | no_load_speed_rpm | weight_g | dim_L_mm | dim_W_mm | dim_H_mm | gear_material | travel_deg | feedback | encoder_counts_per_output_rev | deadband_us | idle_current_mA | no_load_current_mA | stall_current_A | provenance | notes | output_interface | horn_included | mount_pattern | stock_checked | interface_source | torque_mid_kgcm | torque_mid_at_V | flange_span_mm | ear_hole_pattern_mm | spec_basis | stall_current_at_V | retrieved_date | recheck_price_usd | recheck_stock | recheck_source
A01 | Generic SG90-class 9 g micro (SparkFun ROB-09065) | micro servo 180 | SparkFun | 12.95 | 2026-09-22 | https://www.sparkfun.com/servo-generic-sub-micro-size.html | https://handsontec.com/dataspecs/motor_fan/SG90-Servo.pdf | 4.8 | 6.0 | 1.20 | 4.8 | 1.50 | 6.0 | 0.15 | 0.10 | 100 | 9 | 31.8 | 11.7 | 29 | nylon | 180 | none |  | 10 |  |  |  | torque derived from vendor 16.6/20.8 oz-in; rpm derived (10/t); deadband sourced from TowerPro SG90 datasheet (not this exact unit); travel assumed | SG90 clones from Amazon are cheaper per unit but spec quality is weakest in this class; TowerPro SG90 lists 1.8 kgcm at 4.8 V
A02 | TowerPro SG92R | micro servo 180 | Adafruit #169 | 5.95 | 2026-09-22 | https://www.adafruit.com/product/169 | https://www.adafruit.com/product/169 | 3.0 | 6.0 | 2.5 | 4.8 |  |  | 0.10 |  | 100 | 9 | 23 | 11 | 29 | POM + carbon fiber | 180 | none |  |  |  |  |  | sourced (Adafruit page); rpm derived | coreless motor; 2.5 kgcm at 9 g is optimistic vs SG90 1.8 kgcm
A03 | TowerPro MG90D (digital) / MG90S class | micro servo metal gear | Adafruit #1143 | 9.95 | 2026-09-22 | https://www.adafruit.com/product/1143 | https://www.electronicoscaldas.com/datasheet/MG90S_Tower-Pro.pdf | 4.8 | 6.0 | 2.1 | 4.8 | 2.4 | 6.0 | 0.10 | 0.08 | 125 | 13.4 | 22.8 | 12.2 | 28.5 | metal | 90 | none |  |  |  |  |  | sourced (Adafruit page); rpm derived | out of stock at Adafruit 2026-09-22; TowerPro MG90S datasheet lists 1.8/2.2 kgcm at 4.8/6 V, 22.5x12x35.5 mm; travel ~90 deg at standard pulses, more with 0.75-2.25 ms
A04 | EMAX ES08MA II | micro servo metal gear | Ready Made RC | 7.75 | 2026-09-22 | https://www.readymaderc.com/products/details/emax-es08ma-ii-metal-gear-servo | https://servodatabase.com/servo/emax/es08ma | 4.8 | 6.0 | 1.6 | 4.8 | 2.0 | 6.0 | 0.12 | 0.10 | 100 | 12 | 23 | 11.5 | 24 | metal |  | none |  |  |  |  |  | sourced (RMRC page); rpm derived | analog; lightest metal-gear option with a known brand
A05 | Savox SH-0255MGP | micro servo metal gear digital | Servos.net | 34.99 | 2026-09-22 | https://www.servos.net/products/savsh0255mgp-micro-digital-mg-servo-13-54 | https://savox-servo.com/en/product/SH-0255MGplus/ | 4.8 | 6.0 | 3.1 | 4.8 | 3.9 | 6.0 | 0.16 | 0.13 | 77 | 15.8 | 22.8 | 12.0 | 29.4 | metal (aluminum middle case) | 90 | none |  |  | 5 | 240 | 1.4 | sourced (Servos.net page); rpm derived; stall/no-load current at 6 V | sold out at Servos.net 2026-09-22; best-documented micro (currents published); 145 deg max travel
A06 | Adafruit Analog Feedback Micro Servo - Plastic Gear | micro servo + analog feedback | Adafruit #1449 | 9.95 | 2026-09-22 | https://www.adafruit.com/product/1449 | https://www.adafruit.com/product/1449 | 4.8 | 6.0 |  |  | 1.60 | 6.0 |  | 0.10 | 100 | 13.82 | 22.75 | 11.58 | 29.19 | plastic | 180 | analog pot wiper (4th wire) |  |  |  |  |  | torque derived from 22.24 oz-in; voltage_min assumed; rpm derived | pot wiper to Arduino analog pin covers the course analog-input requirement and gives position/contact sensing
A07 | Adafruit Analog Feedback Micro Servo - Metal Gear | micro servo + analog feedback | Adafruit #1450 | 14.95 | 2026-09-22 | https://www.adafruit.com/product/1450 | https://www.adafruit.com/product/1450 | 4.8 | 6.0 |  |  | 1.8 | 6.0 |  | 0.10 | 100 | 15.81 | 22.75 | 11.58 | 29.19 | metal | 120 | analog pot wiper (4th wire) |  |  |  |  |  | sourced; voltage_min assumed; rpm derived
A08 | Adafruit Analog Feedback Standard-Size Servo | standard servo + analog feedback | Adafruit #1404 | 14.95 | 2026-09-22 | https://www.adafruit.com/product/1404 | https://www.adafruit.com/product/1404 | 4.8 | 6.0 | 3.8 | 4.8 | 5.0 | 6.0 | 0.22 | 0.18 | 56 | 48.8 | 39.3 | 19.4 | 38.7 | nylon | 180 | analog pot wiper (4th wire) |  |  |  |  |  | sourced; rpm derived | out of stock 2026-09-22
A09 | FEETECH FS0403-FB | sub-micro servo + analog feedback | Pololu #3438 | 14.81 | 2026-09-22 | https://www.pololu.com/product/3438 | https://www.pololu.com/product/3438 |  | 6.0 |  |  | 0.72 | 6.0 |  | 0.08 | 125 | 6 |  |  |  |  |  | analog pot (green wire) |  |  |  |  |  | torque derived from 10 oz-in (Pololu category list); rpm derived; dims not retrieved | too weak for a 2-finger cloth grip unless geared down; listed for weight floor
A10 | FEETECH FS90-FB | micro servo + analog feedback | Pololu #3436 | 12.26 | 2026-09-22 | https://www.pololu.com/product/3436 | https://www.pololu.com/product/3436 |  | 6.0 |  |  | 1.5 | 6.0 |  | 0.10 | 100 | 13 |  |  |  |  | 120 | analog pot (green wire) |  |  |  |  |  | sourced (Pololu page); rpm derived; dims not retrieved | 120 deg over 900-2100 us; feedback linear
A11 | FEETECH FT1117M-FB | mini servo + analog feedback | Pololu #3440 | 19.65 | 2026-09-22 | https://www.pololu.com/product/3440 | https://www.pololu.com/product/3440 |  | 6.0 |  |  | 3.5 | 6.0 |  | 0.11 | 91 | 22 |  |  |  | metal (plastic pinion) | 120 | analog pot (green wire) |  |  |  |  |  | sourced (Pololu page); rpm derived; dims not retrieved | ~165 deg unofficial with 550-2400 us; good weight/torque middle ground with feedback
A12 | FEETECH FS5106B-FB | standard servo + analog feedback | Pololu #3442 | 25.64 | 2026-09-22 | https://www.pololu.com/product/3442 | https://www.pololu.com/product/3442 |  | 6.0 |  |  | 6.0 | 6.0 |  | 0.11 | 91 | 43 |  |  |  |  | 180 | analog pot (green wire) |  |  |  |  |  | sourced (Pololu page); rpm derived | 180 deg over 700-2300 us; non-FB FS5106B is $22.58
A13 | FEETECH FS5115M-FB | standard servo high torque + analog feedback | Pololu #3443 | 35.77 | 2026-09-22 | https://www.pololu.com/product/3443 | https://www.pololu.com/product/3443 | 4.8 | 6.0 |  |  | 15.5 | 6.0 |  | 0.20 | 50 | 62 |  |  |  | all metal | 180 | analog pot (green wire) |  |  |  |  | 3 | sourced (Pololu page); stall current listed as >3 A at 6 V; rpm derived | best-documented high-torque PWM servo with feedback under $50; non-FB FS5115M is $32.06 |  |  |  | listed $35.77, inventory not shown (Pololu, 2026-09-22) | S https://www.pololu.com/product/3443 |  |  |  |  | mixed | 6.0 | 2026-10-11 | 35.77 | backorders allowed on the product page; Pololu RC-servo category lists it out of stock (Pololu, 2026-10-11) | https://www.pololu.com/product/3443 ; https://www.pololu.com/category/23/rc-servos
A14 | TowerPro SG-5010 | standard servo | Adafruit #155 | 12.00 | 2026-09-22 | https://www.adafruit.com/product/155 | https://www.adafruit.com/product/155 | 4.8 | 6.0 | 5.5 | 5.0 | 6.5 | 6.0 | 0.20 | 0.16 | 63 | 47 | 40.6 | 20.5 | 38 | POM | 180 | none |  | 1 |  |  |  | sourced (Adafruit page); rpm derived | out of stock 2026-09-22; 1 us deadband claim is implausible for an analog servo
A15 | Hitec HS-485HB | standard servo | ServoCity | 28.99 | 2026-09-22 | https://www.servocity.com/hs-485hb-servo/ | https://hitecrcd.com/hs-485hb-deluxe-hd-ball-bearing-standard-servo/ | 4.8 | 6.0 | 4.8 | 4.8 | 6.0 | 6.0 | 0.22 | 0.18 | 56 | 45 | 38.1 | 19.8 | 38.6 | Karbonite |  | none |  | 8 | 8.8 | 180 |  | sourced (ServoCity page); dims derived from 1.5x0.78x1.52 in; rpm derived; currents at 6 V | name-brand spec sheet with idle/no-load currents; stall current not listed
A16 | MG996R-class high-torque standard | standard servo metal gear | Adafruit #1142 | 19.95 | 2026-09-22 | https://www.adafruit.com/product/1142 | https://www.electronicoscaldas.com/datasheet/MG996R_Tower-Pro.pdf | 4.8 | 6.0 | 8.5 | 4.8 | 10 | 6.0 | 0.20 | 0.16 | 63 | 62.41 | 40.7 | 19.7 | 42.9 | metal | 120 | none |  | 5 |  | 500 | 2.5 | torque/speed/weight sourced from Adafruit; deadband 5 us, running 500 mA, stall 2.5 A @6 V sourced from Handsontec guide https://www.handsontec.com/dataspecs/motor_fan/MG996R.pdf | three sources disagree: TowerPro 9.4/11 kgcm and 0.19/0.15 s; Handsontec 0.17/0.14 s and 4.8-7.2 V; Adafruit 8.5/10 kgcm; clones common |  |  |  |  |  |  |  |  |  | mixed | 6.0 | 2026-10-11 | 19.95 | out of stock, notify-me form (Adafruit, 2026-10-11) | https://www.adafruit.com/product/1142
A17 | DSServo DS3218MG (180; 270 variant same body) | standard servo metal gear digital | SpeedyFPV | 12.99 | 2026-09-22 | https://speedyfpv.com/products/ds3218mg-digital-servo-high-speed-high-torque-metal-gear-waterproof-20kg-torque-180-degrees-w-accessories | https://images-na.ssl-images-amazon.com/images/I/81Lbgu+nG6L.pdf | 4.8 | 6.8 | 19 | 5.0 | 21.5 | 6.8 | 0.16 | 0.14 | 71 | 58 | 40 | 20 | 40.5 | copper + aluminum metal | 180 | none |  | 3 | 5 |  | 2.2 | sourced; torque/speed from SpeedyFPV; stall 2.2 A @6.8 V, idle 5 mA from Miuzei datasheet; rpm derived | datasheets conflict: Miuzei 18 kgcm @5 V and 2.2 A stall @6.8 V vs Annimos 19 kgcm @5 V and 1.8 A stall @6.8 V (both 21.5 kgcm @6.8 V) (https://cdck-file-uploads-europe1.s3.dualstack.eu-west-1.amazonaws.com/arduino/original/4X/7/4/f/74f50fff235673f3d7b2a23ae8b8d6e7f30a47f7.pdf); weight 58 vs 60 g; IP66 | 25T spline, 5.9 mm | 1x aluminum arm + 4x plastic arms | standard-size flange servo, body 40.0x20.5x40.5 mm; 4 ear holes on a 49.5 x 10 mm pattern, 54.5 mm across the ears (Miuzei drawing) | in stock, 14 units (SpeedyFPV, 2026-09-22) | S https://speedyfpv.com/products/ds3218mg-digital-servo-high-speed-high-torque-metal-gear-waterproof-20kg-torque-180-degrees-w-accessories ; drawing https://images-na.ssl-images-amazon.com/images/I/81Lbgu+nG6L.pdf |  |  | 54.5 | 49.5 x 10 | mixed | 6.8 | 2026-10-11 | 12.99 | page shows "Maximum Available" next to the number 14; an explicit count is not stated (SpeedyFPV, 2026-10-11) | https://speedyfpv.com/products/ds3218mg-digital-servo-high-speed-high-torque-metal-gear-waterproof-20kg-torque-180-degrees-w-accessories
A18 | DSServo DS3225 (180) | standard servo metal gear digital | MakerFocus | 18.99 | 2026-09-22 | https://www.makerfocus.com/products/digital-servo-25kg | https://www.makerfocus.com/products/digital-servo-25kg | 4.8 | 6.8 | 21 | 5.0 | 25 | 6.8 | 0.15 | 0.13 | 77 | 67 | 40 | 20 | 40.5 | metal (hard-anodized) | 180 | none |  | 3 |  |  |  | sourced (MakerFocus page); rpm derived | sale price (list $21.99); other listings claim 24.5 kgcm and 60 g; 270 deg variant exists | 25T spline | 2x 25T adjustable metal arm | standard-size flange servo, body 40x20x40.5 mm; ear-hole spacing not published | unavailable (MakerFocus, 2026-09-22) | S https://www.makerfocus.com/products/digital-servo-25kg |  |  |  |  | vendor-listing |  | 2026-10-11 | 18.99 | unclear: Add to cart button plus a back-in-stock email signup (MakerFocus, 2026-10-11); sale price, list $21.99 | https://www.makerfocus.com/products/digital-servo-25kg
A19 | DSServo DS3235 coreless (180/270) | standard servo metal gear digital coreless | RCDrone | 24.49 | 2026-09-22 | https://rcdrone.top/products/dsservo-ds3235-waterproof-servo | https://hajim.rochester.edu/me/sites/kelley/me240/DS3235-270_datasheet.pdf | 5.0 | 7.4 | 29 | 5.0 | 35 | 7.4 | 0.13 | 0.11 | 91 | 60 | 40 | 20 | 38.5 | metal (hard-anodized) | 270 | none |  | 2 | 5 |  | 2.3 | sourced (datasheet): 29/32/35 kgcm and 1.9/2.1/2.3 A at 5/6/7.4 V; rpm derived | sold out at RCDrone 2026-09-22 (Amazon listings exist, price not retrieved); datasheet gear ratio 373; other listings claim 80 g | 25T spline | optional arm (datasheet section 8) | standard-size flange servo, body 40x20x38.5 mm (datasheet); 4 ear holes on a 49.5 x 10 mm pattern, 54.5 mm across the ears (datasheet section 1 drawing) | sold out (RCDrone, row notes) | S https://hajim.rochester.edu/me/sites/kelley/me240/DS3235-270_datasheet.pdf sections 1, 3, 4 and 7 | 32 | 6.0 | 54.5 | 49.5 x 10 | datasheet | 7.4 | 2026-10-11 |  | not rechecked: RCDrone page returned HTTP 403 on 2026-10-11. Same family at another public vendor: DSServo DS3235 SG (Blue) $30.00, backordered (aifitlab, 2026-10-11); different variant, torque 23/30/35 kg-cm at 5.0/7.4/8.4 V | https://rcdrone.top/products/dsservo-ds3235-waterproof-servo (HTTP 403) ; https://aifitlab.com/products/dsservo-ds3235-sg-servo-motor
A20 | JX PDI-6221MG | standard servo metal gear digital | RCDrone | 18.05 | 2026-09-22 | https://rcdrone.top/products/jx-20kg-servo-pdi-6221mg | http://www.jx-servo.com/en/Product/STANDARD/SD/555.html | 4.8 | 6.0 | 17.25 | 4.8 | 20.32 | 6.0 | 0.18 | 0.16 | 63 | 62 | 40.5 | 20.2 | 38 | aluminum metal | 180 | none |  | 2 |  |  |  | sourced (RCDrone page + search summary of JX spec); rpm derived | sold out at RCDrone 2026-09-22; also 60/360 deg variants | 25T (stated as 'Metal Teeth:25T' for the PDI-6221MG-360 variant; '25T Arm' option in the listing title; not stated for the 180 variant) | 25T arm offered as a listing option; inclusion not stated | standard-size flange servo, body 40.5x20.2x38 mm; mounting pattern not published | sold out (RCDrone, 2026-09-22) | S https://rcdrone.top/products/jx-20kg-servo-pdi-6221mg (JX site http://www.jx-servo.com/en/Product/STANDARD/SD/555.html not retrievable: certificate error) |  |  |  |  | vendor-listing |  | 2026-10-11 |  | not rechecked: RCDrone page returned HTTP 403 on 2026-10-11; no other public vendor price was read (servodatabase.com lists specs only, no price) | https://rcdrone.top/products/jx-20kg-servo-pdi-6221mg (HTTP 403) ; https://servodatabase.com/servo/jx-servo/pdi-6221mg
A21 | FEETECH FS5103R continuous | continuous-rotation servo | Adafruit #154 | 11.95 | 2026-09-22 | https://www.adafruit.com/product/154 | https://www.adafruit.com/product/154 | 4.8 | 6.0 | 3.0 | 4.8 | 3.2 | 6.0 |  | 0.18 | 56 | 40 | 54 | 37 | 20 |  | continuous | none |  |  |  |  |  | sourced; rpm derived from 0.18 s/60 deg | out of stock; continuous = speed control only, loses position unless external sensor
A22 | FEETECH FS90R continuous | continuous-rotation micro servo | Pololu #2820 | 9.82 | 2026-09-22 | https://www.pololu.com/product/2820 | https://www.pololu.com/product/2820 |  | 6.0 |  |  | 1.51 | 6.0 |  |  | 130 | 9 |  |  |  |  | continuous | none |  |  |  |  |  | price/torque/rpm/weight from Pololu category list; torque derived from 21 oz-in
A23 | Parallax Feedback 360 High-Speed | continuous servo + digital Hall feedback | Pololu #3432 | 29.95 | 2026-09-22 | https://www.pololu.com/product/3432 | https://www.pololu.com/product/3432 | 5.8 | 8.4 |  |  | 2.52 | 6.0 |  |  | 140 | 41 | 40.0 | 20.0 | 37.2 |  | continuous | digital Hall PWM (3.3 V ~1.1 ms period duty = angle) |  |  |  |  |  | sourced; torque derived from 35 oz-in | absolute angle via Hall; control 1280-1720 us
M01 | Pololu 150:1 Micro Metal Gearmotor HPCB 6V + 12 CPR encoder | DC gearmotor + quadrature encoder | Pololu #5193 | 32.45 | 2026-09-22 | https://www.pololu.com/product/5193/specs | https://www.pololu.com/product/5193/specs |  | 6.0 |  |  | 2.0 | 6.0 |  |  | 220 | 11 | 32 | 12 | 10 | steel (nitride-hardened stainless) | continuous | quadrature Hall encoder | 1807 |  |  | 150 | 1.5 | sourced; output counts derived 12 x 150.58 | needs H-bridge (e.g. DRV8833) + JST SH cable (sold separately); Pololu recommends <=2 kgcm instantaneous for this ratio | 3 mm D-shaft (same micro metal gearmotor gearbox family as M02) | none | no mounting holes; Pololu bracket pair #989 | listed $32.45 (Pololu, 2026-09-22) | S https://www.pololu.com/product/5193/specs ; bracket https://www.pololu.com/product/989 (shaft form by family, A) |  |  |  |  | vendor-listing | 6.0 | 2026-10-11 | 32.45 | Status "Active and Preferred", backorders allowed, no stock count shown (Pololu, 2026-10-11) | https://www.pololu.com/product/5193
M02 | Pololu 380:1 Micro Metal Gearmotor HPCB 6V + 12 CPR encoder | DC gearmotor + quadrature encoder | Pololu #5200 | 32.45 | 2026-09-22 | https://www.pololu.com/product/5200 | https://www.pololu.com/product/5200 |  | 6.0 |  |  | 5.0 | 6.0 |  |  | 85 | 11 | 32 | 12 | 10 | steel (nitride-hardened stainless) | continuous | quadrature Hall encoder | 4550 |  |  | 150 | 1.5 | sourced; stall torque theoretical (Pololu); weight assumed from #5193 | gearbox instantaneous limit 2.5 kgcm (Pololu category page) - usable grip torque is the limit, not the stall figure | 3 mm D-shaft, 9 mm long ('9 mm long, 3 mm diameter D-shaped gearbox output shaft'); specs page: output shaft adds 10 mm to the 32 mm length | none (hub or printed coupler needed) | no mounting holes on the gearmotor; Pololu micro metal gearmotor bracket pair #989 ($2.95, #2-56 x 7/16 in screws + nuts, captures the 10x12 mm gearbox); hole spacing not in the public text | listed $32.45, status 'Active and Preferred' (Pololu, 2026-09-22); page weight 11 g | S https://www.pololu.com/product/5200 ; https://www.pololu.com/product/5200/specs ; bracket https://www.pololu.com/product/989 |  |  |  |  | vendor-listing | 6.0 | 2026-10-11 | 32.45 | Status "Active and Preferred", backorders allowed, no stock count shown (Pololu, 2026-10-11) | https://www.pololu.com/product/5200
M03 | Pololu 1000:1 Micro Metal Gearmotor HPCB 6V + 12 CPR encoder | DC gearmotor + quadrature encoder | Pololu #5202 | 43.95 | 2026-09-22 | https://www.pololu.com/product/5202 | https://www.pololu.com/product/5202 |  | 6.0 |  |  | 11 | 6.0 |  |  | 33 | 11 |  | 12 | 10 | steel (nitride-hardened stainless) | continuous | quadrature Hall encoder | 11837 |  |  | 150 | 1.5 | sourced; stall torque theoretical; weight assumed from #5193 | limit 2.5 kgcm instantaneous; high ratio makes it effectively non-backdrivable (assumed), so it holds grip unpowered |  |  |  |  |  |  |  |  |  | vendor-listing | 6.0 | 2026-10-11 | 43.95 | Status "Active and Preferred", backorders allowed, no stock count shown (Pololu, 2026-10-11) | https://www.pololu.com/product/5202
M04 | Pololu 298:1 Micro Metal Gearmotor HP 6V + 12 CPR encoder | DC gearmotor + quadrature encoder | Pololu #5173 | 29.95 | 2026-09-22 | https://www.pololu.com/product/5173 | https://www.pololu.com/product/5173 |  | 6.0 |  |  | 4.0 | 6.0 |  |  | 100 | 11 |  | 12 | 10 | metal (brass plates per page) | continuous | quadrature Hall encoder | 3575 |  |  | 100 | 1.6 | sourced; counts derived 12 x 297.92; weight assumed | precious-metal brushes: shorter life than HPCB under frequent stall | 3 mm D-shaft (same micro metal gearmotor gearbox family as M02) | none | no mounting holes; Pololu bracket pair #989 | listed $29.95 (Pololu, 2026-09-22) | S https://www.pololu.com/product/5173 ; bracket https://www.pololu.com/product/989 (shaft form by family, A) |  |  |  |  | vendor-listing | 6.0 | 2026-10-11 | 29.95 | Status "Active and Preferred", backorders allowed, no stock count shown (Pololu, 2026-10-11) | https://www.pololu.com/product/5173
M05 | N20 6V 1:100 with magnetic encoder | DC gearmotor + quadrature encoder | Adafruit #4639 | 12.50 | 2026-09-22 | https://www.adafruit.com/product/4639 | https://www.adafruit.com/product/4639 | 4.5 | 6.0 |  |  | 0.5 | 6.0 |  |  | 60 |  | 30.5 |  |  | metal | continuous | quadrature Hall encoder | 1400 |  |  | 100 | 0.2 | price/voltage/currents/torque/rpm sourced from Adafruit ratio table; counts derived 14 x 100 | Adafruit 200 mA stall figure is implausibly low for an N20 (Pololu equivalents stall at 1.5 A) - verify on the bench
M06 | DFRobot FIT0483 micro metal gearmotor 6V 100:1 + encoder | DC gearmotor + quadrature encoder | DFRobot | 11.90 | 2026-09-22 | https://www.dfrobot.com/product-1433.html | https://www.dfrobot.com/product-1433.html |  | 6.0 |  |  | 1.5 | 6.0 |  |  | 155 | 18 |  |  |  | metal | continuous | quadrature Hall encoder | 1400 |  |  | 60 | 0.17 | sourced; rated torque 0.7 kgcm | 170 mA is labeled 'current rating', not a true stall value (assumed)
M07 | DFRobot FIT0520 25 mm metal gearmotor 6V 20:1 + encoder (JGA25-class) | DC gearmotor + quadrature encoder | DFRobot | 19.90 | 2026-09-22 | https://www.dfrobot.com/product-1619.html | https://www.dfrobot.com/product-1619.html |  | 6.0 |  |  | 3.6 | 6.0 |  |  | 300 | 96 | 50 | 24.4 | 24.4 | metal | continuous | quadrature Hall encoder | 224.4 |  |  | 100 | 2.7 | sourced; rated torque 1.8 kgcm | too heavy/fast for a hand-sized gripper; JGA25-370 12 V 75:1 variant reported at 6.5 kgcm @3 A in a search summary (unverified; candidate source https://media.digikey.com/pdf/Data%20Sheets/Seeed%20Technology/114090046_Web.pdf); price not retrieved
A24 | Hitec HS-65MG | micro servo metal gear | Ready Made RC | 34.99 | 2026-09-22 | https://www.readymaderc.com/products/details/hitec-hs-65mg | https://hitecrcd.com/hs-5065mg-high-torque-metal-gear-feather-servo/ | 4.8 | 6.0 | 1.80 | 4.8 | 2.23 | 6.0 | 0.14 | 0.11 | 91 | 11.9 | 23.37 | 11.43 | 23.88 | metal |  | none |  |  |  |  |  | torque derived from 25/31 oz-in; dims derived from 0.92x0.45x0.94 in; rpm derived | analog; name-brand micro with top ball bearing
A25 | Hitec HS-5065MG (digital) | micro servo metal gear digital | ServoCity | 44.99 | 2026-09-22 | https://www.servocity.com/hs-5065mg-servo/ | https://hitecrcd.com/hs-5065mg-high-torque-metal-gear-feather-servo/ | 4.8 | 6.0 | 1.80 | 4.8 | 2.20 | 6.0 | 0.14 | 0.11 | 91 | 11.9 |  |  |  | metal | 128 | none |  | 2 | 3 | 200 | 3 | sourced (ServoCity page); torque derived from 24.99/30.55 oz-in; stall 2 A @4.8 V, 3 A @6 V; rpm derived | 181 deg if reprogrammed ($54.99, over budget); fullest current data of any micro
A26 | Generic MG90S clone (Maker Portal) | micro servo metal gear | Maker Portal | 8.00 | 2026-09-22 | https://makersportal.com/shop/p/mg90s-micro-servo | https://components101.com/motors/mg90s-metal-gear-servo-motor | 4.8 | 6.0 |  |  |  |  | 0.10 |  | 100 | 13 | 32.5 | 12 | 32.5 | metal | 180 | none |  |  | 2.7 | 70 | 0.4 | price/currents/weight/dims sourced (Maker Portal, currents at 5 V); speed derived from 0.6 deg/ms at 5 V; rpm derived | sold out 2026-09-22; vendor states not genuine TowerPro; Miuzei MG90S lists 1.8/2.0 kgcm @4.8/6 V (https://servodatabase.com/servo/miuzei/mg90s); 0.4 A stall is low vs Hitec 3 A for similar class
A27 | Hitec HS-311 | standard servo | BuddyRC | 16.99 | 2026-09-22 | https://www.buddyrc.com/products/hitec-hs-311-standard-analog-sport-servo | https://hitecrcd.com/hs-311-standard-economy-servo/ | 4.8 | 6.0 | 3.0 | 4.8 | 3.5 | 6.0 | 0.19 | 0.15 | 67 | 43 | 39.9 | 19.8 | 36.3 | nylon (resin) |  | none |  | 5 | 7.7 | 180 | 0.8 | sourced (BuddyRC page); dims derived from 1.57x0.78x1.43 in; rpm derived | other listings give 3.7 kgcm @6 V (https://servodatabase.com/servo/hitec/hs-311); cheap name-brand baseline
M08 | NFP-JGA25-370-EN 25 mm gearmotor + Hall encoder | DC gearmotor + quadrature encoder | NFP Shop | 16.50 | 2026-09-22 | https://nfpshop.com/product/25mm-metal-gear-motor-model-nfp-jga25-370-en | https://nfpshop.com/product/25mm-metal-gear-motor-model-nfp-jga25-370-en | 6 | 24 |  |  | 9 |  |  |  | 12 | 110 |  | 25 |  | metal (spur) | continuous | quadrature Hall encoder (11 PPR motor) | 5259 |  |  |  |  | sourced (NFP page): torque is the max stall across ratios, rpm is the slowest ratio, counts = 11 PPR x 478:1 per page (x4 edges in quadrature, derived) | ratio chosen at order; 110 g is 10x a Pololu micro gearmotor - too heavy for a light gripper
W01 | NFP-WG1218S-N20 6V 1030:1 worm gearmotor (B45 type) | DC worm gearmotor | NFP Shop | 12.50 | 2026-09-22 | https://nfpshop.com/product/12mm-metal-gear-motor-model-nfp-n20-gm1218s | https://nfpshop.com/product/12mm-metal-gear-motor-model-nfp-n20-gm1218s |  | 6.0 |  |  | 3.0 | 6.0 |  |  | 22 | 13 |  |  |  | metal (worm) | continuous | none |  |  |  | 80 | 0.65 | sourced (NFP 6 V B45 table): stall <=3 kgcm, rated 1.2 kgcm at 15 rpm, 22 rpm no load, <=0.65 A stall, ~13 g | worm gearbox self-locks (vendor); needs an H-bridge; stall figure is an upper bound; 603:1 variant 2 kgcm / 37 rpm | 3 mm shaft, 8 mm long, right-angle worm output | none | N20 motor + worm gearbox; overall dimensions only in the page's outline image (not in the text) | listed $12.50 (NFP, 2026-09-22) | S https://nfpshop.com/product/12mm-metal-gear-motor-model-nfp-n20-gm1218s
W02 | NFP-WG1218S-N20-EN-SD 6V 1030:1 worm gearmotor + encoder | DC worm gearmotor + encoder | NFP Shop | 16.50 | 2026-09-22 | https://nfpshop.com/product/12mm-metal-gear-motor-model-nfp-n20-gm1218s | https://nfpshop.com/product/12mm-metal-gear-motor-model-nfp-n20-gm1218s |  | 6.0 |  |  | 3.0 | 6.0 |  |  | 22 | 13 |  |  |  | metal (worm) | continuous | encoder (counts not retrieved) |  |  |  | 80 | 0.65 | price sourced (NFP page); gearbox specs assumed equal to W01 | self-locking worm + encoder; needs an H-bridge | 3 mm shaft, 8 mm long, right-angle worm output | none | N20 motor + worm gearbox + encoder; overall dimensions only in the page's outline image | listed $16.50 (NFP, 2026-09-22) | S https://nfpshop.com/product/12mm-metal-gear-motor-model-nfp-n20-gm1218s
L01 | Actuonix PQ12-100-6-R micro linear servo (RC PWM input) | micro linear actuator (RC PWM) | SparkFun | 149.95 | 2026-09-22 | https://www.sparkfun.com/products/18591 | https://www.actuonix.com/assets/images/datasheets/ActuonixPQ12Datasheet.pdf | 6.0 | 6.0 |  |  |  |  |  |  |  | 21 | 36.5 | 21.5 | 15 |  | 20 mm stroke | internal pot (closed loop inside) |  |  |  |  | 0.55 | sourced: SparkFun price; PQ12 datasheet 40 N at 6 mm/s peak power, 50 N max, back-drive 35 N, 10 mm/s no load, 20 % max duty, 21 g (R) | over $50; linear stroke needs a crank to drive knuckle A; 1.0-2.0 ms pulses; 63:1 variant 30 N at 8 mm/s | 20 mm stroke rod, 3 mm rod-eye hole | n/a (linear) | 2 mounting brackets + M3 hardware included; body 36.5 x 21.5 x 15 mm retracted (datasheet drawing) | in stock (SparkFun, 2026-09-22) | S https://www.actuonix.com/assets/images/datasheets/ActuonixPQ12Datasheet.pdf
A28 | goBILDA 2000 Series Dual Mode Servo 25-2 (Torque), SKU 2000-0025-0002 | standard servo metal gear digital | goBILDA | 36.99 | 2026-10-11 | https://www.gobilda.com/2000-series-dual-mode-servo-25-2 | https://www.gobilda.com/2000-series-dual-mode-servo-25-2 | 4.8 | 7.4 | 17.2 | 4.8 | 25.2 | 7.4 | 0.25 | 0.17 | 59 | 60 |  |  |  | steel |  |  |  | 4 |  | 200 | 3.0 | sourced (goBILDA page spec table, read 2026-10-11); rpm derived 10/t at 7.4 V; no-load current column holds the 7.4 V value (150/160/200 mA at 4.8/6.0/7.4 V); stall current 2.0/2.5/3.0 A at 4.8/6.0/7.4 V | dual-mode servo (positional or continuous; the page names the dual mode, travel angle not read); manufacturer page only, no datasheet PDF (STEP file only); dimensions listed only as "Standard"; mounting pattern not published; page weight 60 g | 25 tooth spline |  | standard-size servo; dimensions and hole pattern not published on the page | in stock (goBILDA page structured data availability InStock, 2026-10-11) | S https://www.gobilda.com/2000-series-dual-mode-servo-25-2 (25 Tooth Spline) | 21.6 | 6.0 |  |  | vendor-listing | 7.4 | 2026-10-11
A29 | goBILDA 2000 Series Dual Mode Servo 25-3 (Speed), SKU 2000-0025-0003 | standard servo metal gear digital | goBILDA | 36.99 | 2026-10-11 | https://www.gobilda.com/2000-series-dual-mode-servo-25-3-speed | https://www.gobilda.com/2000-series-dual-mode-servo-25-3-speed | 4.8 | 7.4 | 7.9 | 4.8 | 10.8 | 7.4 | 0.11 | 0.07 | 143 | 58 |  |  |  | steel |  |  |  | 4 |  | 230 | 3.0 | sourced (goBILDA page spec table, read 2026-10-11); rpm derived 10/t at 7.4 V (page states 145 RPM); no-load current column holds the 7.4 V value (190/200/230 mA at 4.8/6.0/7.4 V); stall current 2.0/2.5/3.0 A at 4.8/6.0/7.4 V | speed variant of A28: stall torque below the 15 kg-cm target at every voltage; listed for the speed/torque trade only; manufacturer page only, no datasheet PDF (STEP file only); dimensions and mounting pattern not published | 25 tooth spline |  | standard-size servo; dimensions and hole pattern not published on the page | in stock (goBILDA page structured data availability InStock, 2026-10-11) | S https://www.gobilda.com/2000-series-dual-mode-servo-25-3-speed (25 Tooth Spline) | 9.3 | 6.0 |  |  | vendor-listing | 7.4 | 2026-10-11
A30 | REV Smart Robot Servo V2 Balanced, REV-41-3334 | standard servo metal gear digital | REV Robotics | 32.50 | 2026-10-11 | https://www.revrobotics.com/Smart-servo-v2 | https://www.revrobotics.com/content/docs/REV-41-3334-3336-DR.PDF | 4.8 | 7.4 | 13.5 | 6.0 | 16.7 | 7.4 | 0.14 | 0.12 | 83 | 62 | 40.2 | 20.0 | 38.0 | steel |  |  |  |  |  |  | 2.6 | sourced (REV product page 2026-10-11 for torque, speed, current, mass, dimensions; REV drawing PDF REV-41-3334-3336-DR for spline, flange and hole pattern, gear material); rpm derived 10/t at 7.4 V; torque and speed pairs are published at 6.0 and 7.4 V only; stall current 2.1 A at 6.0 V | smart servo, configurable through REV tooling; the 4.8 V end of the range has no published torque; page shows one price for both V2 variants; steel gears per the drawing; page lists 40.2 x 20 x 38 mm, drawing shows 43.6 mm overall height with the spline; the older Smart Robot Servo REV-41-1097 (13.5 kg-cm at 6 V, brass gear per its manual) is discontinued and its page returned 404 | H25T 3F standard servo spline (25 tooth), M3x0.5 thread 6 mm deep |  | standard-size flange servo; 4 holes dia 4.5 mm; hole pattern 49.5 mm (14.7 + 34.8) x 10 mm, 54.0 mm across the ears (REV drawing) | in stock ("In Stock & Ready To Ship!", REV, 2026-10-11) | S https://www.revrobotics.com/content/docs/REV-41-3334-3336-DR.PDF |  |  | 54.0 | 49.5 x 10 | mixed | 7.4 | 2026-10-11
A31 | REV Smart Robot Servo V2 UltraSpeed, REV-41-3336 | standard servo metal gear digital | REV Robotics | 32.50 | 2026-10-11 | https://www.revrobotics.com/Smart-servo-v2 | https://www.revrobotics.com/content/docs/REV-41-3334-3336-DR.PDF | 4.8 | 7.4 | 5.6 | 6.0 | 6.2 | 7.4 | 0.043 | 0.035 | 286 | 60 | 40.2 | 20.0 | 38.0 | steel |  |  |  |  |  |  | 3.7 | sourced (REV product page 2026-10-11; REV drawing PDF for spline, flange and hole pattern, gear material); rpm derived 10/t at 7.4 V; torque and speed pairs published at 6.0 and 7.4 V only; stall current 2.9 A at 6.0 V | speed variant of A30: stall torque far below the 15 kg-cm target; listed for the speed/torque trade only; page shows one price for both V2 variants; exterior dimensions identical to A30 per the drawing | H25T 3F standard servo spline (25 tooth), M3x0.5 thread 6 mm deep |  | standard-size flange servo; 4 holes dia 4.5 mm; hole pattern 49.5 mm (14.7 + 34.8) x 10 mm, 54.0 mm across the ears (REV drawing) | in stock ("In Stock & Ready To Ship!", REV, 2026-10-11) | S https://www.revrobotics.com/content/docs/REV-41-3334-3336-DR.PDF |  |  | 54.0 | 49.5 x 10 | mixed | 7.4 | 2026-10-11
A32 | DSServo DS3230 MG (Blue), 180 deg, metal arm | standard servo metal gear digital | aifitlab | 27.00 | 2026-10-11 | https://aifitlab.com/products/dsservo-ds3230-mg-servo-motor | https://aifitlab.com/products/dsservo-ds3230-mg-servo-motor | 4.8 | 6.8 | 26 | 5.0 | 30 | 6.8 | 0.20 | 0.18 | 56 | 60 | 40 | 20 | 40.5 |  | 180 |  |  | 3 | 5 |  | 3.8 | sourced (aifitlab page spec table, read 2026-10-11, values given at 5 V and 6.8 V); rpm derived 10/t at 6.8 V; idle current 4/5 mA at 5/6.8 V, column holds 6.8 V value; stall current 3.5/3.8 A at 5/6.8 V | gear material and spline not listed on the page (gear ratio 221, double bearing, IP66, 50-330 Hz); the Red variant on the same page lists 29.5/34.5 kg-cm at 5/6.8 V, 2.1/2.9 A, gear ratio 397, but its own price was not shown separately; the page offers 180 or 270 deg running degree; the DSServo collection page lists a different part, DS3230 PRO, at $25.00 "In stock" |  | metal arm option selected; other contents not stated | standard-size flange servo, body 40 x 20 x 40.5 mm; ear hole pattern not published on the page | backordered, "will ship as soon as it is back in stock" (aifitlab, 2026-10-11) |  |  |  |  |  | vendor-listing | 6.8 | 2026-10-11
A33 | DSServo DS3225 MG, 180 deg, metal arm | standard servo metal gear digital | aifitlab | 20.00 | 2026-10-11 | https://aifitlab.com/products/dsservo-ds3225mg-servo-motor | https://aifitlab.com/products/dsservo-ds3225mg-servo-motor | 4.8 | 6.8 | 24.5 | 5.0 | 28 | 6.8 | 0.16 | 0.14 | 71 | 60 | 40 | 20 | 40.5 |  | 180 |  |  | 3 | 5 |  | 2.9 | sourced (aifitlab page spec table, read 2026-10-11, values at 5 V and 6.8 V); rpm derived 10/t at 6.8 V; idle current 4/5 mA at 5/6.8 V, column holds 6.8 V value; stall current 2.1/2.9 A at 5/6.8 V | same part name as A18 (DS3225 at MakerFocus: 21/25 kg-cm at 5.0/6.8 V, 67 g); this listing claims 24.5/28 kg-cm and 60 g, so the two vendors disagree by about 12 %; 3-pole motor, gear ratio 275, IP66, 50-330 Hz; spline and gear material not listed; page offers 180 or 270 deg |  | metal arm option selected; other contents not stated | standard-size flange servo, body 40 x 20 x 40.5 mm; ear hole pattern not published on the page | backordered, "will ship as soon as it is back in stock" (aifitlab, 2026-10-11) |  |  |  |  |  | vendor-listing | 6.8 | 2026-10-11
A34 | DSServo DS3235 SG (Blue), 180 deg, metal arm | standard servo metal gear digital | aifitlab | 30.00 | 2026-10-11 | https://aifitlab.com/products/dsservo-ds3235-sg-servo-motor | https://aifitlab.com/products/dsservo-ds3235-sg-servo-motor | 5.0 | 8.4 | 23 | 5.0 | 35 | 8.4 | 0.18 | 0.11 | 91 | 60 | 40 | 20 | 38.5 |  | 180 |  |  |  |  |  | 3.2 | sourced (aifitlab page spec table, read 2026-10-11); voltage range taken from the lowest and highest voltage in the table, not a stated range; speed 0.18/0.13/0.11 s at 5/7.4/8.4 V; rpm derived 10/t at 8.4 V; stall current 2.2/2.9/3.2 A at 5/7.4/8.4 V | SG is not expanded on the page, gear material and spline not listed; gear ratio 342; the Red variant lists 33/42 kg-cm at 5/6.8 V, 3.1/3.9 A, ratio 275, 40 x 20 x 40.5 mm, but its own price was not shown separately; 8.4 V end is above the 7.4 V pack limit, use the 7.4 V figure; the DS3235 datasheet (A19) gives 35 kg-cm at 7.4 V for the unit of that name, so the two listings differ |  | metal arm option selected; other contents not stated | standard-size flange servo, body 40 x 20 x 38.5 mm; ear hole pattern not published on the page | backordered, "will ship as soon as it is back in stock" (aifitlab, 2026-10-11) |  | 30 | 7.4 |  |  | vendor-listing | 8.4 | 2026-10-11
A35 | Hitec HS-645MG (stock rotation, SKU 32645S) | standard servo metal gear | ServoCity | 43.99 | 2026-10-11 | https://www.servocity.com/hs-645mg-servo/ | https://www.servocity.com/hs-645mg-servo/ | 4.8 | 6.0 | 7.7 | 4.8 | 9.6 | 6.0 | 0.24 | 0.20 | 50 | 55.2 |  |  |  | 3 metal gears + 1 resin/metal gear |  |  |  | 8 | 9.1 | 450 |  | sourced (ServoCity page spec table, read 2026-10-11; 106.93/133.31 oz-in); rpm derived 10/t at 6.0 V; idle 8.8/9.1 mA and no-load 350/450 mA at 4.8/6.0 V, columns hold the 6.0 V values | analog name-brand servo; stall torque below the 15 kg-cm target (9.6 kg-cm at 6 V, about 19 % above the 8.07 kg-cm hold requirement with no derating); the Hitec product page for this part returned 404; the page lists size only as "Standard"; no stall current on the page | C24T spline |  | standard-size servo; dimensions and hole pattern not published on the page | in stock (ServoCity page structured data availability InStock, 2026-10-11) | S https://www.servocity.com/hs-645mg-servo/ (C24T Spline) |  |  |  |  | vendor-listing |  | 2026-10-11
A36 | FEETECH FT5325M digital standard servo, 180 deg | standard servo metal gear digital | Maplin UK (pro.maplin.co.uk) |  |  | https://pro.maplin.co.uk/products/ft5325m-high-torque-67g-25kg-cm-digital-180-rotation-servo-feetech | https://servodatabase.com/servo/feetech/ft5325m | 4 | 8.4 | 20.5 | 6.0 | 25 | 7.4 | 0.185 | 0.151 | 66 | 67 | 55 | 20 | 43 | metal | 180 |  |  |  | 6 | 100 | 3.0 | sourced (Maplin page spec table, read 2026-10-11; servodatabase.com agrees on torque 20.54/25.04 kg-cm and 67 g); rpm derived 10/t at 7.4 V; idle, running and stall current quoted at 6 V; no USD price read | price GBP 18.74 on the Maplin page (about $25 at any plausible rate, under the $50 cap); RobotShop US, CA and EU pages returned HTTP 403, so no USD price was retrieved; page dimensions conflict: description says 40 x 20 x 47.4 mm, table says 55 x 20 x 43 mm (length probably includes the ears); back-order lead time of 45 stated (unit not given); servodatabase.com lists deadband 4 us and 3.0-3.5 A stall at 7.4 V | 25T |  | standard-size flange servo; hole pattern not read | "Only 5 left!" (Maplin UK, 2026-10-11) | S https://pro.maplin.co.uk/products/ft5325m-high-torque-67g-25kg-cm-digital-180-rotation-servo-feetech (Spline 25T) |  |  |  |  | vendor-listing | 6.0 | 2026-10-11
A37 | FEETECH FT5330M digital standard servo, 180 deg | standard servo metal gear digital | Maplin UK (pro.maplin.co.uk) |  |  | https://pro.maplin.co.uk/products/ft5330m-high-torque-67g-35-5kg-cm-digital-180-rotation-servo-feetech | https://servodatabase.com/servo/feetech/ft5330m | 4 | 8.4 | 28.8 | 6.0 | 35.5 | 7.4 | 0.238 | 0.192 | 52 | 67 | 55 | 20 | 43 | metal | 180 |  |  |  | 6 | 150 | 3.2 | sourced (Maplin page spec table, read 2026-10-11; servodatabase.com agrees on 35.51 kg-cm at 7.4 V, 67 g, 3.2-3.9 A stall); rpm derived 10/t at 7.4 V; idle, running and stall current quoted at 6 V; no USD price read | price GBP 18.56 on the Maplin page (under the $50 cap); no US vendor page was reachable (RobotShop returned HTTP 403); page dimensions conflict as for A36 (40 x 20 x 47.4 mm vs 55 x 20 x 43 mm); back-order lead time of 45 stated (unit not given); servodatabase.com lists deadband 4 us and 3.2-3.9 A stall; slower than A36 (0.192 s vs 0.151 s per 60 deg at 7.4 V) | 25T |  | standard-size flange servo; hole pattern not read | "Only 3 left!" (Maplin UK, 2026-10-11) | S https://pro.maplin.co.uk/products/ft5330m-high-torque-67g-35-5kg-cm-digital-180-rotation-servo-feetech (Spline 25T) |  |  |  |  | vendor-listing | 6.0 | 2026-10-11
A38 | FEETECH FS5115M (no feedback wire), Pololu #3426 | standard servo high torque | Pololu #3426 | 32.06 | 2026-10-11 | https://www.pololu.com/product/3426 | https://www.pololu.com/file/0J1270/FS5115M-specs.pdf | 4.8 | 6.0 | 14 | 4.8 | 15.5 | 6.0 | 0.25 | 0.20 | 50 | 60.7 | 40.1 | 20.1 | 38.9 | copper | 180 | none |  | 4 | 6 | 220 | 1.7 | sourced (Feetech FS5115M product specification A/0 dated 2021-08-02, read 2026-10-11, for torque, speed, current, dimensions, mass, spline, deadband; Pololu page for price and stock); rpm derived 10/t at 6.0 V; running current 180/220 mA and stall current 1.3/1.7 A at 4.8/6.0 V | non-feedback sibling of A13; datasheet input voltage 4-8.4 V with 4.8 V and 6 V as the rated points; Pololu page says 62 g and "bursts in excess of 3 A at 6 V" while the datasheet gives 60.7 g and 1.7 A stall; datasheet limit angle 200 deg, 180 deg at 500-2500 us, rated load 5 kg-cm at 6 V; internal carbon-film potentiometer is not brought out; datasheet lists no accessories but Pololu says horns and hardware are included; height 38.9 mm is the case, 44.3 mm to the top of the spline | 25T / 5.9 mm, M3x6 screw | yes (Pololu: servo horns and associated hardware included) | standard-size flange servo; 4 holes dia 4.5 mm; hole pattern 49.5 x 10 mm, 54 mm across the ears (datasheet drawing) | no stock line on the product page, backorders allowed; the Pololu RC-servo category lists it out of stock (Pololu, 2026-10-11) | S https://www.pololu.com/file/0J1270/FS5115M-specs.pdf sections 6 and 9 |  |  | 54 | 49.5 x 10 | datasheet | 6.0 | 2026-10-11
M09 | Pololu 100:1 Micro Metal Gearmotor HPCB 6V + 12 CPR encoder (back connector) | DC gearmotor + quadrature encoder | Pololu #5190 | 32.45 | 2026-10-11 | https://www.pololu.com/product/5190 | https://www.pololu.com/product/5190 |  | 6.0 |  |  | 1.6 | 6.0 |  |  | 330 | 11 | 32 | 12 | 10 | metal (brass plates per page) | continuous | quadrature Hall encoder | 1204 |  |  | 150 | 1.5 | sourced (Pololu product page read 2026-10-11; stall torque and stall current are Pololu theoretical extrapolations, not measured); counts derived 12 CPR x 100.37 | needs an H-bridge (DRV8833 class) and a JST SH cable sold separately; Pololu instantaneous gearbox limit is 2 kg-cm for this ratio (category page), so the stall figure is not usable grip torque; weight 11 g and 10 x 12 x 32 mm from the #5190 specs page (output shaft adds about 10 mm to the length) | 3 mm D-shaft, 9 mm long | none | gearbox cross section 10 x 12 mm; mounting holes not stated on the page | status "Active and Preferred", backorders allowed, no stock count shown (Pololu, 2026-10-11) | S https://www.pololu.com/product/5190 |  |  |  |  | vendor-listing | 6.0 | 2026-10-11
M10 | Pololu 210:1 Micro Metal Gearmotor HPCB 6V + 12 CPR encoder (back connector) | DC gearmotor + quadrature encoder | Pololu #5194 | 32.45 | 2026-10-11 | https://www.pololu.com/product/5194 | https://www.pololu.com/product/5194 |  | 6.0 |  |  | 2.8 | 6.0 |  |  | 160 |  |  |  |  | metal (brass plates per page) | continuous | quadrature Hall encoder | 2527 |  |  | 150 | 1.5 | sourced (Pololu product page read 2026-10-11; stall torque and stall current are Pololu theoretical extrapolations, not measured); counts derived 12 CPR x 210.59 | needs an H-bridge (DRV8833 class) and a JST SH cable sold separately; Pololu instantaneous gearbox limit is 2 kg-cm for this ratio (category page), so the stall figure is not usable grip torque; weight and length not on this page (the #5190 page lists 11 g and 32 mm for the 100:1 unit, not assumed here) | 3 mm D-shaft, 9 mm long | none | gearbox cross section 10 x 12 mm; mounting holes not stated on the page | status "Active and Preferred", backorders allowed, no stock count shown (Pololu, 2026-10-11) | S https://www.pololu.com/product/5194 |  |  |  |  | vendor-listing | 6.0 | 2026-10-11
M11 | Pololu 250:1 Micro Metal Gearmotor HPCB 6V + 12 CPR encoder (back connector) | DC gearmotor + quadrature encoder | Pololu #5196 | 32.45 | 2026-10-11 | https://www.pololu.com/product/5196 | https://www.pololu.com/product/5196 |  | 6.0 |  |  | 3.2 | 6.0 |  |  | 130 |  |  |  |  | metal (brass plates per page) | continuous | quadrature Hall encoder | 2988 |  |  | 150 | 1.5 | sourced (Pololu product page read 2026-10-11; stall torque and stall current are Pololu theoretical extrapolations, not measured); counts derived 12 CPR x 248.98 | needs an H-bridge (DRV8833 class) and a JST SH cable sold separately; Pololu instantaneous gearbox limit is 2 kg-cm for this ratio (category page), so the stall figure is not usable grip torque; weight and length not on this page (the #5190 page lists 11 g and 32 mm for the 100:1 unit, not assumed here); stall 3.2 kg-cm exceeds the 2 kg-cm limit | 3 mm D-shaft, 9 mm long | none | gearbox cross section 10 x 12 mm; mounting holes not stated on the page | status "Active and Preferred", backorders allowed, no stock count shown (Pololu, 2026-10-11) | S https://www.pololu.com/product/5196 |  |  |  |  | vendor-listing | 6.0 | 2026-10-11
A39 | DSServo DS3230 PRO, 180 deg | standard servo metal gear digital | aifitlab | 25.00 | 2026-10-11 | https://aifitlab.com/products/dsservo-ds3230-pro-servo-motor | https://aifitlab.com/products/dsservo-ds3230-pro-servo-motor | 4.8 | 6.8 | 26 | 5.0 | 30 | 6.8 | 0.20 | 0.18 | 56 | 60 | 40 | 20 | 40.5 |  | 180 |  |  |  |  |  | 3.8 | sourced (aifitlab product page, read 2026-10-11 through a page summariser, not a raw copy); its spec table matches the DS3230 MG row A32 figure for figure | read 2026-10-11: 26/30 kg-cm at 5/6.8 V, 0.20/0.18 s/60 deg, 3.5/3.8 A, 60 g, 40 x 20 x 40.5 mm, gear ratio 221, $25.00; spline, gear material and ear-hole pattern not listed; what separates PRO from MG is not stated; the product page says the 180 deg version is backordered while the collection page read earlier the same day showed 'In stock', so stock is unresolved; idle current and datasheet not published |  |  |  | conflicting: product page backordered (180 deg), collection page 'In stock' (aifitlab, 2026-10-11) | S https://aifitlab.com/products/dsservo-ds3230-pro-servo-motor |  |  |  |  | vendor-listing | 6.8 | 2026-10-11
