douglaspmcgowan/cloth-feed-gripper/cad/gripper/viewer_src/shots/before_bom_1440_light.png

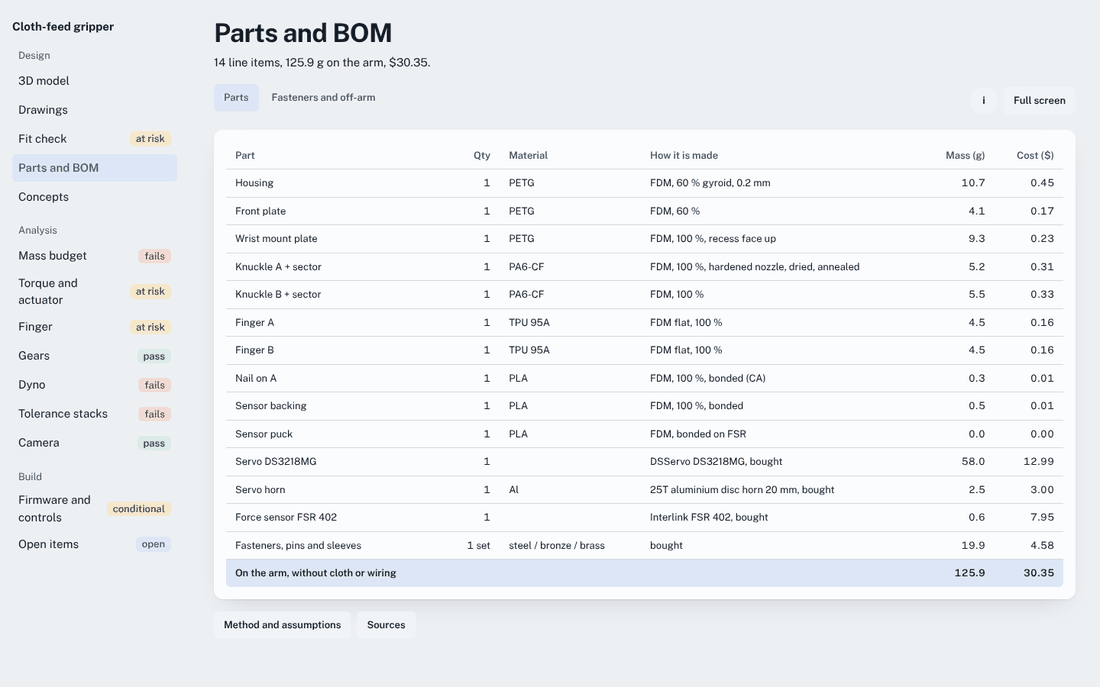
cad/gripper/viewer_src/shots/before_bom_1440_light.png
