douglaspmcgowan/cloth-feed-gripper/cad/gripper/viewer_src/shots/parts_browse_375_dark.png

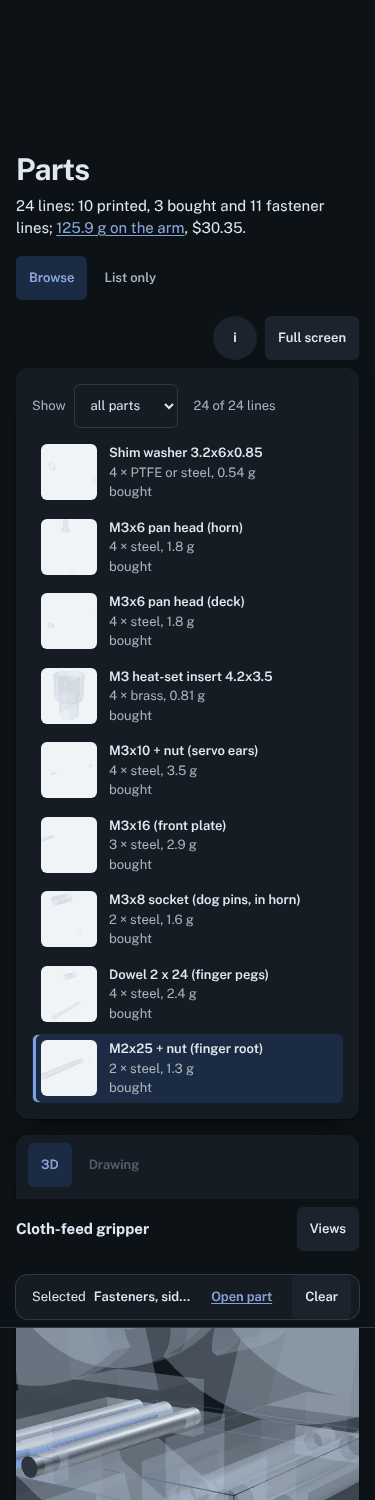
cad/gripper/viewer_src/shots/parts_browse_375_dark.png
