douglaspmcgowan/cloth-feed-gripper/cad/gripper/viewer_src/shots/parts_list_768_dark.png

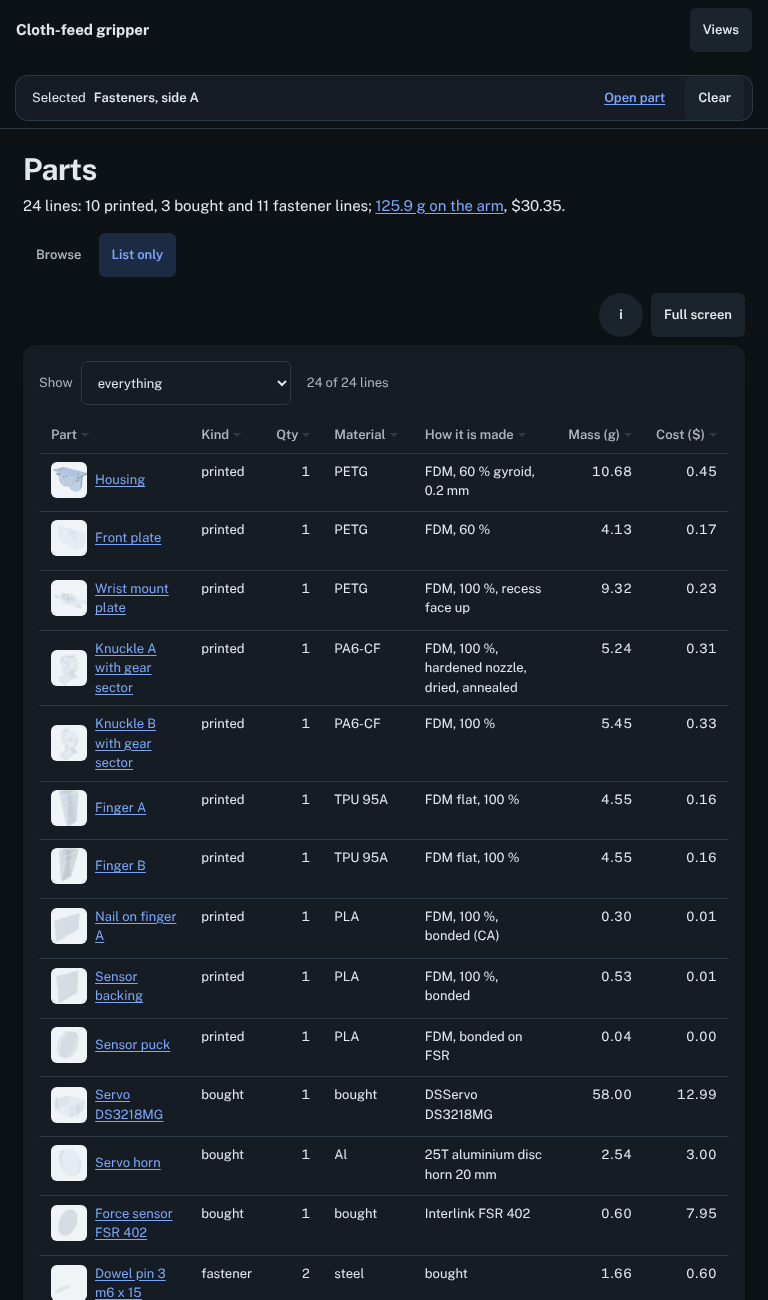
cad/gripper/viewer_src/shots/parts_list_768_dark.png
