douglaspmcgowan/cloth-feed-gripper/cad/gripper/out/assembly.step

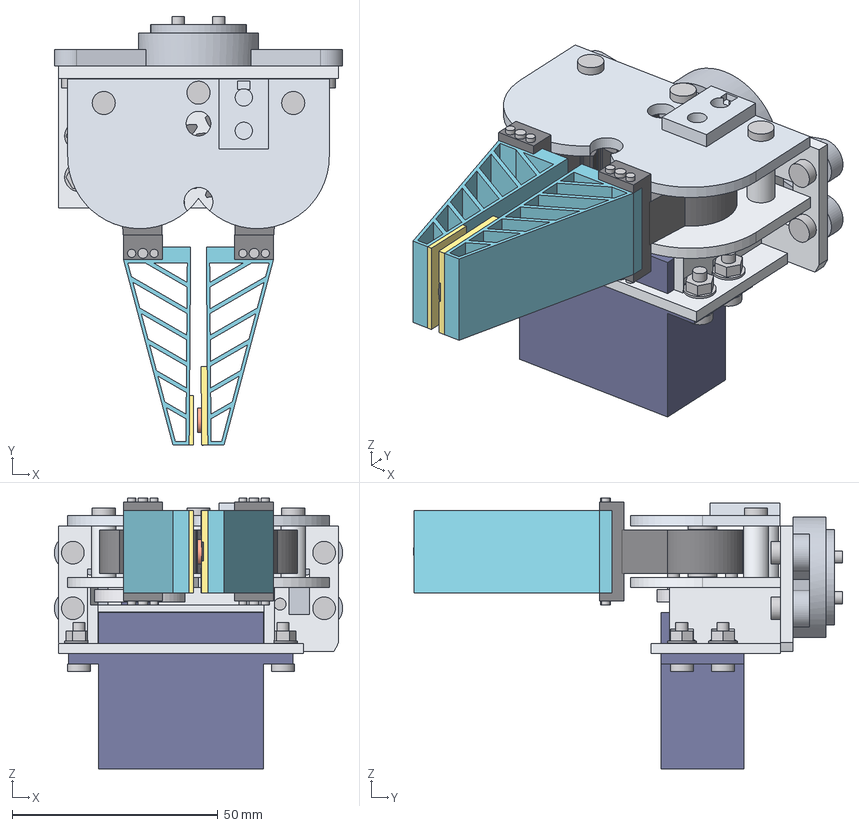
[picture p133: CAD file, 2026-10-19]
cad/gripper/out/assembly.step
70.0 x 104.1 x 65.8 mm
housing
front_plate
wrist_mount
knuckle_a
knuckle_b
finger_a
finger_b
nail_a
fsr_backing_b
fsr_sensor_b
fsr_puck_b
servo
horn
fasteners
fasteners_a
fasteners_b
