douglaspmcgowan/cloth-feed-gripper/cad/gripper/gear_profile.dxf

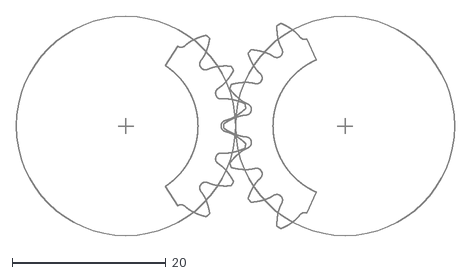
[picture p134: CAD file, 2026-10-19]
cad/gripper/gear_profile.dxf
57.0 x 28.5
