douglaspmcgowan/cloth-feed-gripper/cad/gripper/out/housing.step

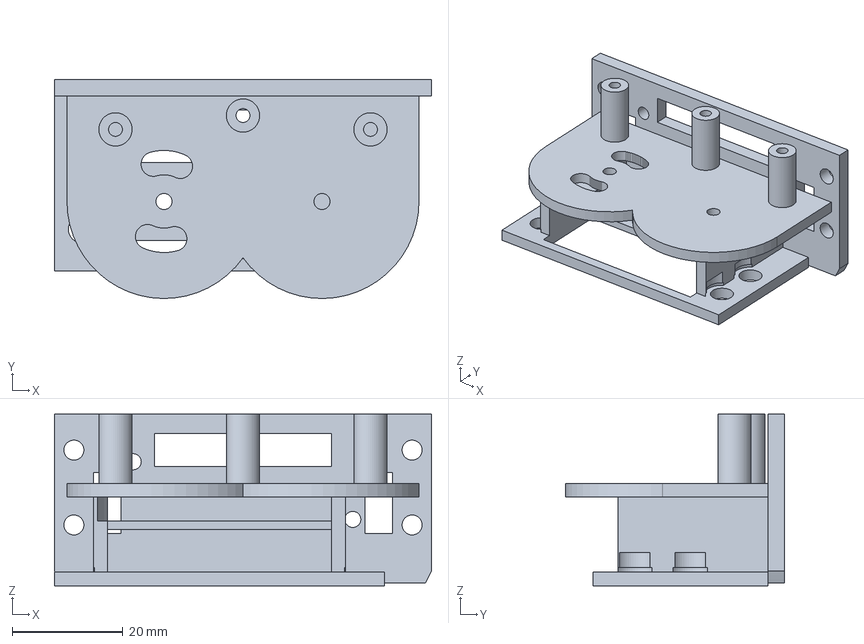
[picture p135: CAD file, 2026-10-19]
cad/gripper/out/housing.step
68.0 x 39.5 x 31.0 mm
