douglaspmcgowan/cloth-feed-gripper/ecad/gripper/kicad/fab/gripper.step

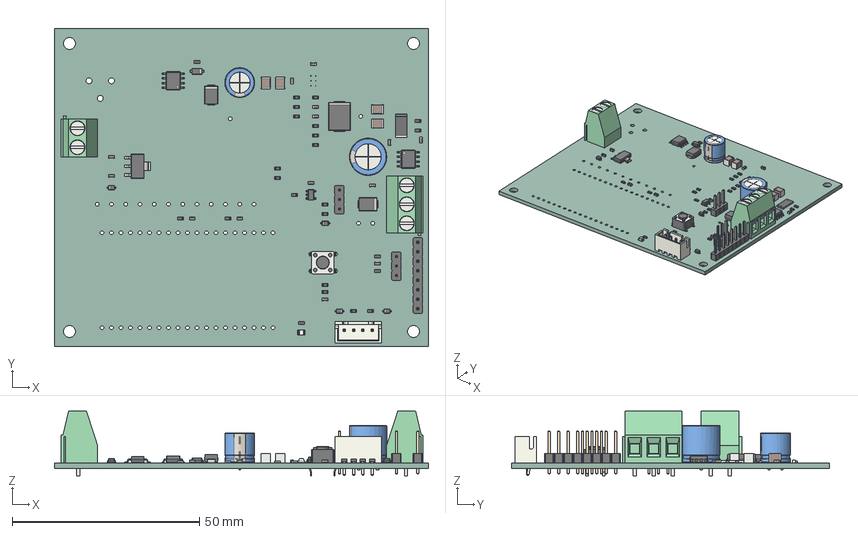
[picture p136: CAD file, 2026-10-19]
ecad/gripper/kicad/fab/gripper.step
100.0 x 85.0 x 17.3 mm
LED_0805_2012Metric
R_0603_1608Metric x 24
C_0603_1608Metric x 14
D_SOD-323 x 4
SOIC-8_3.9x4.9mm_P1.27mm x 2
D_SMB x 2
TerminalBlock_Phoenix_MKDS-1,5-3-5.08_1x03_P5.08mm_Horizontal
C_1210_3225Metric x 4
PinHeader_1x08_P254mm_Vertical
CP_Radial_D100mm_P500mm
PinHeader_1x03_P254mm_Vertical x 2
CP_Radial_D80mm_P350mm
SOT-223
TerminalBlock_Phoenix_MKDS-1,5-2-5.08_1x02_P5.08mm_Horizontal
JST_B4B_XH_A
R_2512_6332Metric
D_SMC
D_SOD-123
SOT-23-5
SW_PUSH_6mm
gripper_PCB
