douglaspmcgowan/cloth-feed-gripper/cad/gripper/out/fasteners.step

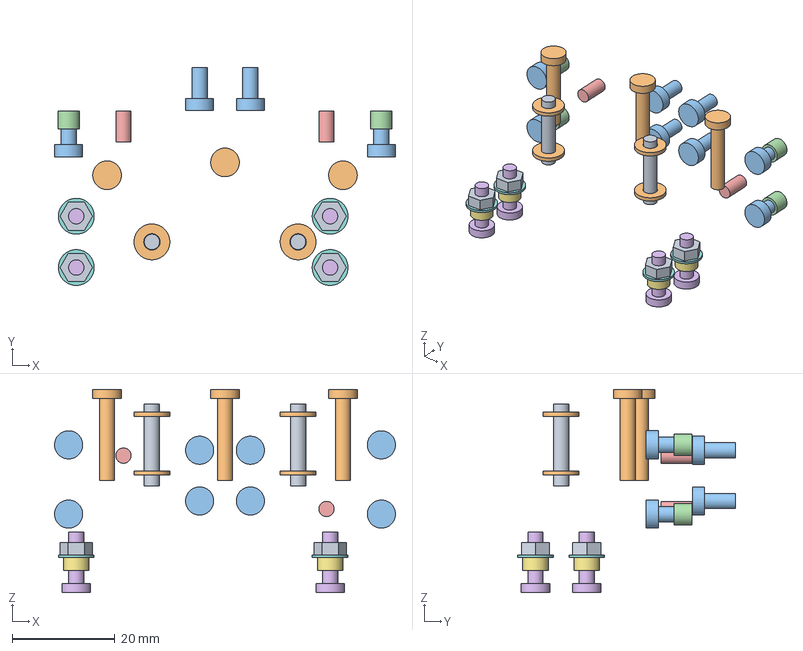
[picture p137: CAD file, 2026-10-19]
cad/gripper/out/fasteners.step
66.5 x 42.5 x 39.6 mm
