douglaspmcgowan/cloth-feed-gripper/cad/gripper/out/horn.step

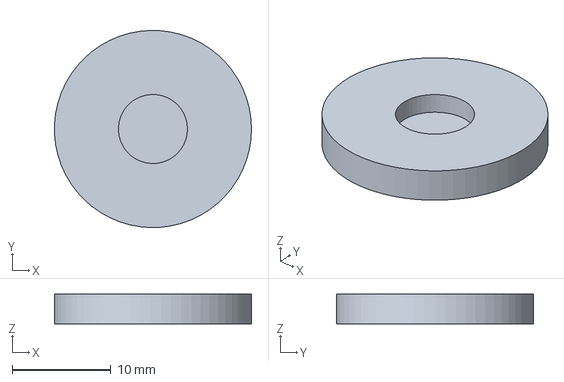
[picture p138: CAD file, 2026-10-19]
cad/gripper/out/horn.step
20.0 x 20.0 x 3.00 mm
