douglaspmcgowan/cloth-feed-gripper/cad/gripper/out/servo.step

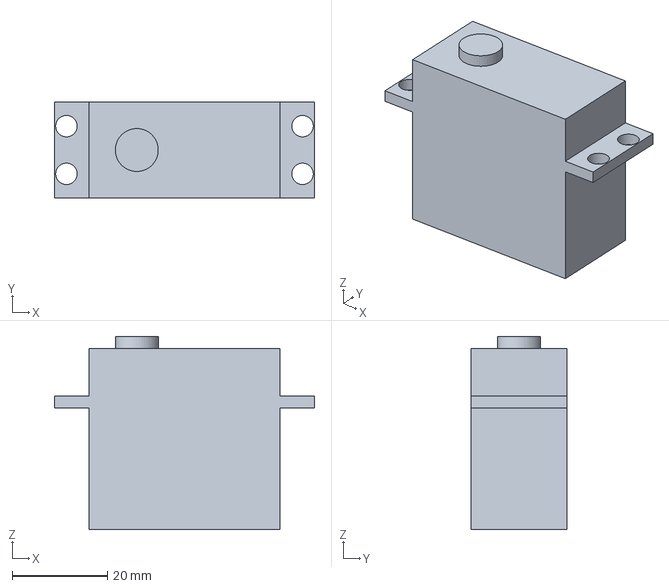
[picture p139: CAD file, 2026-10-19]
cad/gripper/out/servo.step
54.5 x 20.1 x 40.5 mm
