douglaspmcgowan/cloth-feed-gripper/cad/gripper/out/fsr_puck_b.step

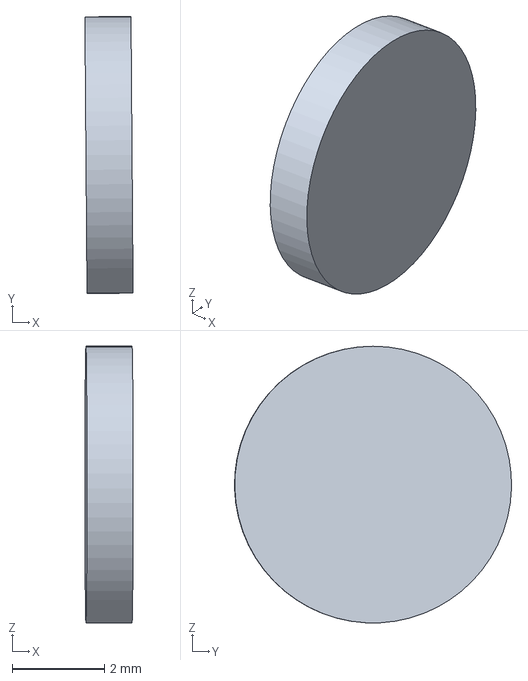
[picture p140: CAD file, 2026-10-19]
cad/gripper/out/fsr_puck_b.step
1.05 x 6.01 x 6.00 mm
