douglaspmcgowan/cloth-feed-gripper/cad/gripper/out/front_plate.stl

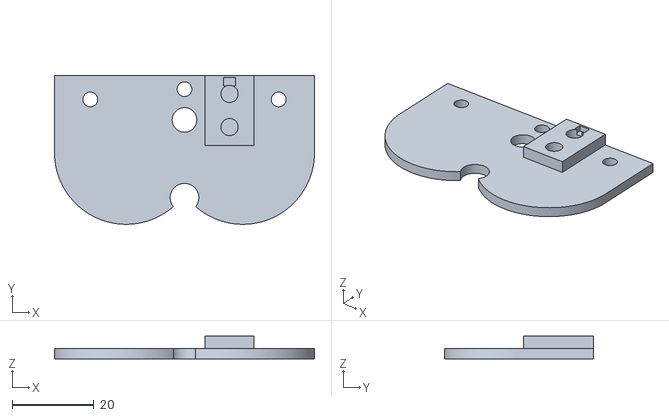
[picture p141: CAD file, 2026-10-19]
cad/gripper/out/front_plate.stl
63.5 x 36.3 x 5.50
