douglaspmcgowan/cloth-feed-gripper/cad/gripper/out/nail_a.step

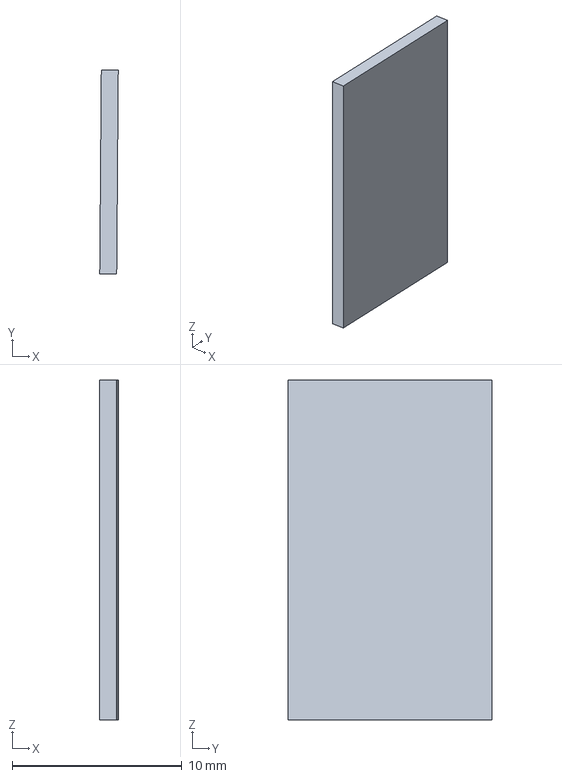
[picture p142: CAD file, 2026-10-19]
cad/gripper/out/nail_a.step
1.09 x 12.0 x 20.0 mm
