douglaspmcgowan/cloth-feed-gripper/cad/gripper/out/knuckle_a.step

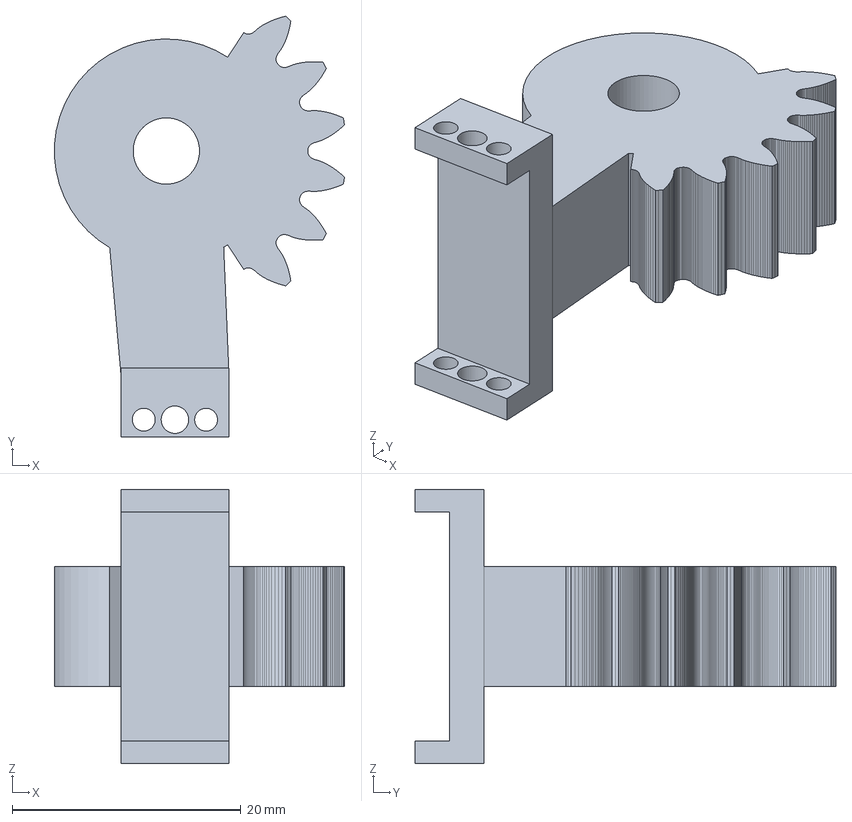
[picture p143: CAD file, 2026-10-19]
cad/gripper/out/knuckle_a.step
25.4 x 36.8 x 24.0 mm
