douglaspmcgowan/cloth-feed-gripper/cad/gripper/out/finger_b.step

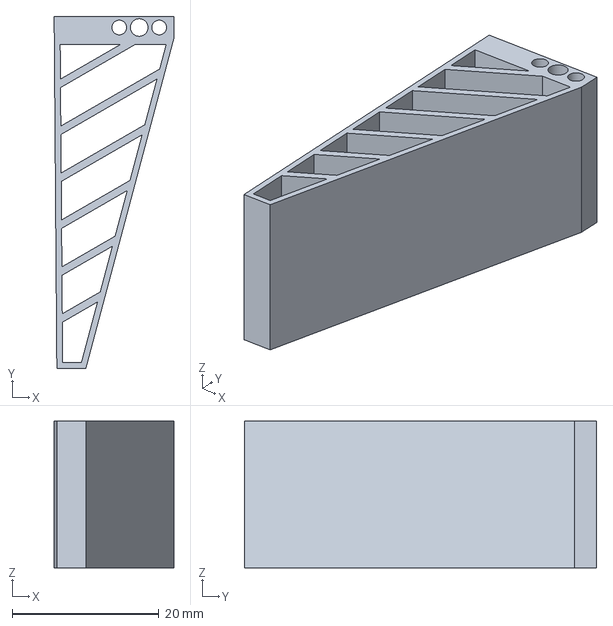
[picture p144: CAD file, 2026-10-19]
cad/gripper/out/finger_b.step
16.3 x 48.0 x 20.0 mm
