douglaspmcgowan/cloth-feed-gripper/cad/gripper/out/fasteners_b.step

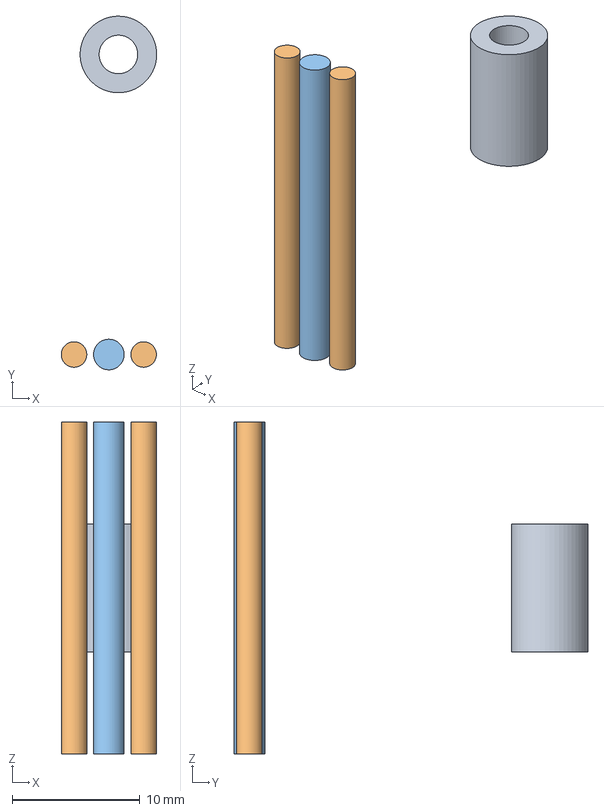
[picture p145: CAD file, 2026-10-19]
cad/gripper/out/fasteners_b.step
7.47 x 27.7 x 26.0 mm
