douglaspmcgowan/cloth-feed-gripper/cad/gripper/out/knuckle_b.step

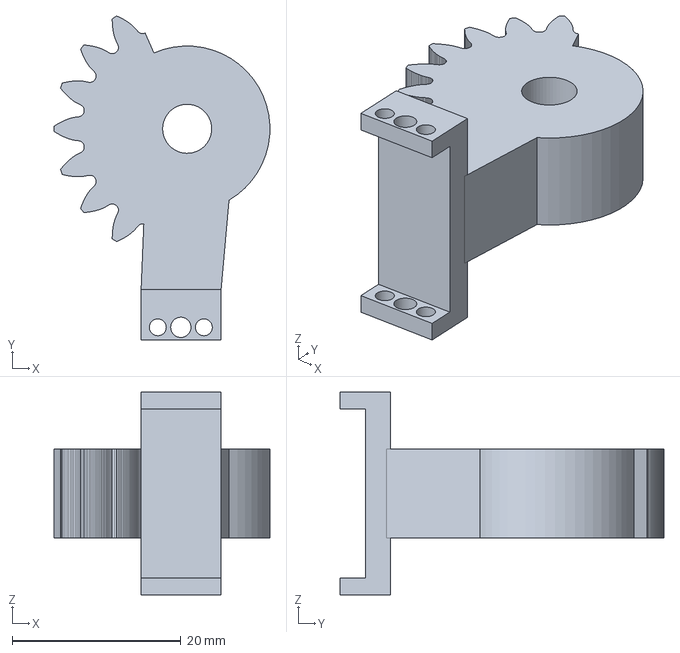
[picture p146: CAD file, 2026-10-19]
cad/gripper/out/knuckle_b.step
25.5 x 38.4 x 24.0 mm
