douglaspmcgowan/cloth-feed-gripper/cad/gripper/out/fsr_sensor_b.stl

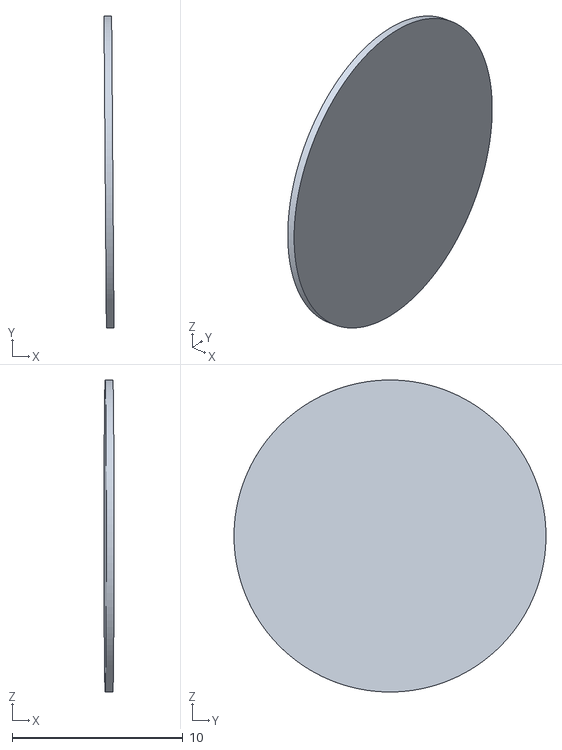
[picture p147: CAD file, 2026-10-19]
cad/gripper/out/fsr_sensor_b.stl
0.59 x 18.3 x 18.3
