douglaspmcgowan/cloth-feed-gripper/(list of files, cad)

Other CAD files:
cad/gripper/out/finger_b.stl
cad/gripper/out/horn.stl
cad/gripper/out/housing.stl
cad/gripper/out/knuckle_a.stl
cad/gripper/out/nail_a.stl
cad/gripper/out/servo.stl
