douglaspmcgowan/cloth-feed-gripper/docs/gripper/evidence/camera-resume-20261023/prior-diagnosis/baseline-model-assembled-768x1024.png

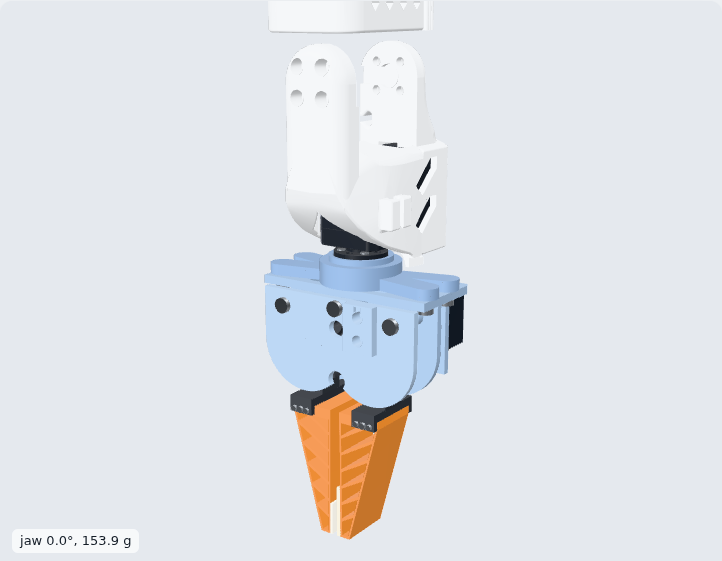
docs/gripper/evidence/camera-resume-20261023/prior-diagnosis/baseline-model-assembled-768x1024.png
