douglaspmcgowan/cloth-feed-gripper/docs/gripper/evidence/camera-resume-20261023/source2-green/model-390x844/assembled.png

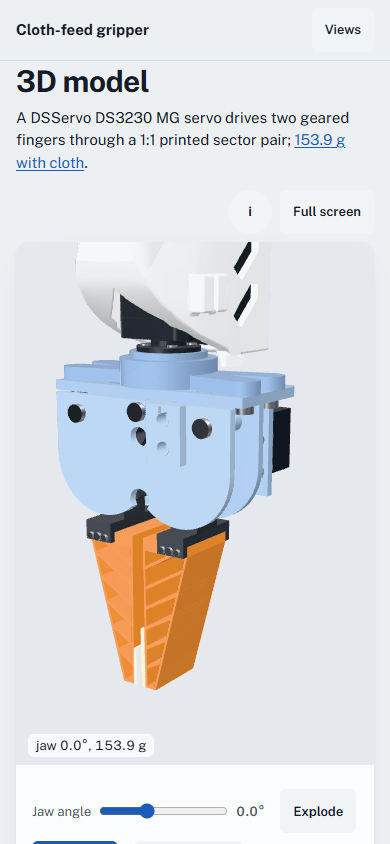
docs/gripper/evidence/camera-resume-20261023/source2-green/model-390x844/assembled.png
