douglaspmcgowan/cloth-feed-gripper/docs/gripper/figures/controls_step_response.png

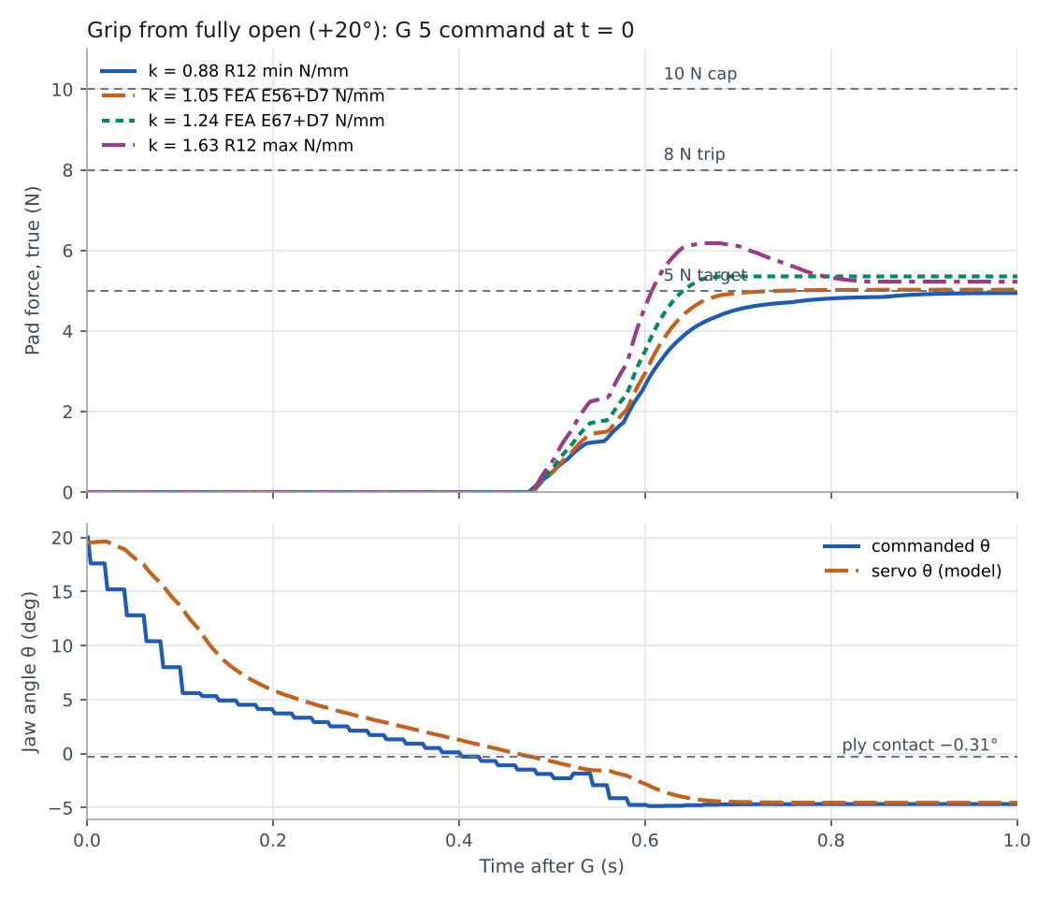
docs/gripper/figures/controls_step_response.png
