douglaspmcgowan/cloth-feed-gripper/docs/gripper/test/EQUIPMENT.md

# Test equipment

Dated 2026-10-11. Prices are the vendor's listed price on that date [S] unless tagged [A]; shipping and tax are not included. The table is generated by `test_plan.py`.

## 0. Answer

- **Buy:** US$98.14 in total, US$77.20 without the spares (servo, FSR, printed spare parts). Two orders: SparkFun (load cell, HX711) and Adafruit (two thermocouples and amplifiers, spare FSR), plus the spare servo and a relay module.
- **Budget:** US$100 [A]. About three times the gripper's own BOM cost (US$30.35, `BOM.md`) and two R8 actuator caps. It covers what a teaching lab will not lend and the spares that the destructive tests (TP-13 stall, TP-15 step load) can ruin. It leaves under US$2 for the fallbacks below: if the lab lends nothing, drop the spares first.
- **Borrow** from the ME102B lab or the student shop [A]: balance, calipers, dial indicator, feeler gauges, bench supply, multimeter, oscilloscope or logic analyser, IR thermometer, slotted masses. If none can be lent, the fallbacks add US$60 [A] (US$158.14 in all, over the budget; see the alternatives table for the instruments with a cheaper substitute).
- **Build:** the pinch-force probe, a horn lever, a finger load saddle, a printed protractor and the fit coupons. Their drawings are in the procedures that use them (TP-01, TP-13, TP-12, TP-08, TP-11).

## 1. List

<!-- equipment:begin -->
| Item | Qty | US$ | Used in | Resolution | Source |
|---|---|---|---|---|---|
| Load cell, 10 kg straight bar (TAL220), SparkFun SEN-13329 | 1 | 12.95 | TP-01 02 04 05 13 14 | see budget; ±0.05 % FS combined error | [S] https://www.sparkfun.com/load-cell-10kg-straight-bar-tal220.html, retrieved 2026-10-11 |
| Load cell amplifier HX711, SparkFun SEN-13879 | 1 | 4.95 | TP-01 02 04 05 13 14 | 24 bit, 80 SPS, 90 nV rms | [S] https://www.sparkfun.com/sparkfun-load-cell-amplifier-hx711.html, retrieved 2026-10-11 |
| Thermocouple amplifier MAX31855, Adafruit 269 (two: servo case and printed mount) | 2 | 14.95 | TP-06 07 | 0.25 °C | [S] https://www.adafruit.com/product/269, retrieved 2026-10-11 |
| Thermocouple type K, glass braid, Adafruit 270 (two: servo case and printed mount) | 2 | 9.95 | TP-06 07 | bead probe | [S] https://www.adafruit.com/product/270, retrieved 2026-10-11 |
| Relay module, 5 V coil, 10 A contacts, normally open (thermal cutoff in the servo's +6.5 V line) | 1 | 3.00 | TP-06 07 | - | [A] typical hobby relay board price; not looked up |
| Spare FSR, Adafruit 166 (now listed as Alpha MF01A, 0.3-10 N) | 1 | 3.95 | TP-01 04 (fault cases), spare | - | [S] https://www.adafruit.com/product/166, retrieved 2026-10-11 |
| Spare DS3218MG servo (stall and step-load tests are hard on it) | 1 | 12.99 | TP-13 15 | - | [S] docs/gripper/research/actuators.csv row A17 (SpeedyFPV, 2026-09-22) |
| Probe hardware: 2 × 40 × 15 × 3 mm aluminium flat or printed PETG plates, 4 × M4/M5 screws per TAL220 thread | 1 | 5.00 | TP-01 02 04 | - | [A] hardware-store estimate |
| Filament for fixtures (probe yoke, lever arm, load saddle, protractor, coupons), about 60 g PETG | 1 | 1.50 | TP-01 06 11 12 13 15 | - | [A] $25/kg as in BOM.md |
| Spare printed parts for the destructive tests: one PA6-CF gear sector pair, two TPU fingers with D7 parts, two M3 heat-set inserts | 1 | 4.00 | TP-04 11 12 15 | - | [A] PA6-CF at $60/kg and TPU at $35/kg (BOM.md) plus inserts |
| Two more microcontrollers: the probe reader (Uno or ESP32) and a test ESP32 for the TP-08/TP-13 sketches | 2 | borrow | TP-01 02 04 07 08 13 | - | [A] ME102B kit or lab |
| Soldering iron, hook-up wire, header pins (HX711, MAX31855) | 1 | borrow | probe build | - | [A] lab bench |
| Lab balance, 0.1 g or better, ≥ 500 g | 1 | borrow | TP-01 09 12 | 0.1 g | [A] teaching lab |
| Digital calipers 150 mm | 1 | borrow | TP-09 11 13 | 0.01 mm | [A] student shop |
| Dial indicator 0.01 mm with magnetic or clamp base | 1 | borrow | TP-06 08 12 15 | 0.01 mm | [A] student shop |
| Feeler gauge set 0.05-1.0 mm | 1 | borrow | TP-08 11 | 0.05 mm steps | [A] student shop |
| Bench power supply with current readout, ≥ 7 V 5 A (a Fit A stall draws 3.75 A, dyno.md) | 1 | borrow | TP-05 07 13 | 10 mA | [A] ME102B lab bench |
| Handheld digital multimeter | 1 | borrow | TP-07 13 | 10 mV | [A] ME102B lab bench |
| Oscilloscope or USB logic analyser | 1 | borrow | TP-10 13 | 1 µs | [A] ME102B lab bench |
| Handheld IR thermometer (cross-check only) | 1 | borrow | TP-07 | 0.1 °C display | [A] lab |
| Phone with 240 fps slow motion | 1 | borrow | TP-03 08 | 4.2 ms | [A] a teammate's phone; check its frame rate |
| Slotted masses or water bottles weighed on the balance, 50 g to 4.5 kg (TP-15 needs about 4.2 kg) | 1 | borrow | TP-01 12 15 | - | [A] lab, or tap water in bottles |
| Demo fabric, 300 × 300 mm, and a spare strip | 1 | borrow | TP-02 03 07 | - | [A] the team's demo cloth |
| Tape measure, plumb line, steel square, luggage scale (cross-check) | 1 | borrow | TP-09 11 14 15 | 1 mm | [A] student shop |
| Labelled fault-injection breakout: shrouded test points and insulated latching switches for FSR 3V3 short/open, limit open/closed and INA219 SDA open | 1 | borrow | TP-16 | install only with rail off | [A] perfboard and keyed connectors |
| Kapton tape, thermal paste, cable ties, marker, painter's tape | 1 | borrow | all | - | [A] lab consumables |
| **Total to buy** |  | **98.14** |  |  | [D] |
<!-- equipment:end -->

### Alternatives, and what they do to U

If the lab cannot lend one of the four instruments below, use the alternative; the last two columns are printed by `test_plan.py`.

<!-- alternatives:begin -->
| Item the lab may not lend | Used for | Alternative a student can get | U with the original | U with the alternative |
|---|---|---|---|---|
| Bench supply with current readout, ≥ 7 V 5 A | TP-05 07 13 current and rail | (a) another lab's supply; or (b) a 2S LiPo or 12 V adapter into a 6.5 V 5 A buck module (about US$8 [A]) with a 4 A fuse, current from the gripper's own INA219 (`I=` in every `ST` line), voltage from the DMM | supply readout U = 0.032 A [A: ±(1 % + 10 mA)] at 1.8 A | INA219 U = 0.021 A (budget `current_A`); DMM U = 0.061 V. The INA219 saturates above 3.2 A (±320 mV / 0.1 Ω), so it cannot log a 3.75 A Fit A stall: in TP-13 read that peak on the DMM in series, U ≈ 0.04 A [A] |
| Oscilloscope or USB logic analyser | TP-10 13 (R7 pulse and frame) | A second ESP32 timing the servo signal with `micros()` and an input-capture interrupt (the TP-08/TP-13 board), or a US$10 24 MHz USB logic-analyser clone [A] | scope / analyser at ≥ 1 MS/s: U = 1.6 µs | ESP32 micros(): U = 3.4 µs [A: 1 µs resolution, ±2 µs interrupt latency]. The R7 open-stop check (1722 ± 3 µs) becomes INDETERMINATE with this U; check the frame (19.61-20.41 ms) and the 1200-1900 µs clamp with it and take the 1722 µs reading on a borrowed scope |
| Handheld IR thermometer (cross-check only) | TP-07 case cross-check | A second type K bead on the case face next to the first, on the second MAX31855 channel (a contact thermocouple) | IR on a plastic or anodised case: U ≈ 2.3 °C [A] plus an emissivity error (`thermal.md` section 6: anodised shell 0.77-0.88 reads low) | contact bead U = 1.6 °C. The R26 verdict uses the bead in both cases, so the verdict's U does not change |
| Phone with 240 fps slow motion | TP-03 08 (independent close time, jaw speed) | A 120 fps or 60 fps phone camera (most phones), same procedure | 240 fps: close time U = 6.8 ms; jaw-speed fit U = 2.2 °/s over 36 frames | 120 fps: 13.6 ms, 3.1 °/s (18 frames); 60 fps: 27.2 ms, 4.4 °/s (9 frames). A conforming jaw (21 °/s) against the 25 °/s screening limit is PASS at 120 fps and INDETERMINATE at 60 fps. The R19 verdict does not use the video (event log U = 3.6 ms), so the video only cross-checks it |
<!-- alternatives:end -->

<!-- fallback:begin -->
| If the lab cannot lend it | US$ |
|---|---|
| Lab balance (if none to borrow): 500 g × 0.01 g pocket scale | 15.00 [A] |
| Digital calipers (if none to borrow) | 20.00 [A] |
| Dial indicator with base (if none to borrow) | 25.00 [A] |
<!-- fallback:end -->

## 2. Notes

- **Adafruit 166** is the FSR in `BOM.md` (listed there as Interlink FSR 402, US$7.95). On 2026-10-11 the same product number is listed as an Alpha MF01A-N-221 at US$3.95. Its force curve may differ from the Interlink table that `fsr_model.h` fits; TP-01 measures the curve, so either part can be used, but the BOM line is out of date.
- **Load cell choice.** A 10 kg cell covers the 41 N stall-lever force in TP-13 and the gear step-load in TP-15 with one sensor; its 0.05 % FS error (0.049 N) is still small against 5 N. A 1 kg cell (Adafruit 4540, US$3.95 [S]) would be about ten times more precise at 5 N but would be overloaded in TP-13 and TP-15.
- **The probe reader** is a second microcontroller running `tools/probe/probe.ino` (HX711 and MAX31855 on one board, one CSV line per sample). It is separate from the gripper's ESP32 so the gripper firmware stays the build under test.
