douglaspmcgowan/cloth-feed-gripper/analysis/gripper/tolstack/results/SUMMARY.md

# Tolerance stack summary (generated by tolstack.py; do not hand-edit)

N = 100,000 Monte Carlo samples per stack, seed 20260922. Verdict: PASS at Cpk ≥ 1.33 (MC-accepted) or worst case inside spec (WC-accepted); MARGINAL at 1.0 ≤ Cpk < 1.33, or a WC-accepted stack whose worst case breaks the spec while Cpk ≥ 1.0; FAIL otherwise.

Baseline (CAD rev A as drawn): 26 checks, 14 PASS, 2 MARGINAL, 10 FAIL as reported; 0 UNDECIDED (also gated in the worse count); by each check's own verdict 15 PASS, 2 MARGINAL, 9 independent FAIL (T03 reported as blocked by another check, not failing on its own).

## Verdicts, CAD rev A baseline

| Stack | Checks | Verdict | Yield (MC) | Cpk | Worst case | Spec | Dominant contributor (variance share) | Cheapest fix (proved by) |
|---|---|---|---|---:|---|---|---|---|
| T01 | Horn-to-mount bolt pattern fit (4x M3 on the 14.0 BC) | **MARGINAL** | 99.996 % (<92 ppm (4 of 100,000 samples; 95% upper bound) out) | 1.31 ± 0.02 | -0.313 … 0.015 (out) | USL 0.000 mm radial interference | hole_position (81 %) | Open the 4 mount holes to CAD 3.7 (T01-cad37). The recess locates the mount, so larger holes cost nothing. (T01-cad37: PASS, Cpk 1.77) |
| T01H | M3 pan head clears its counterbore (rev A Ø6.5) | **PASS** | 100.000 % (<30 ppm (0 of 100,000 samples; 95% upper bound) out) | 2.02 ± 0.01 | -0.550 … -0.075 (in) | USL 0.000 mm radial interference | cbore_position (55 %) | none needed |
| T02 | Horn pilot recess radial fit (Ø19.2 horn in the printed Ø19.51 recess) | **MARGINAL** | 99.976 % (240 ppm out) | 1.16 ± 0.02 | 0.000 … 0.300 (out) | LSL 0.020, USL 0.300 mm diametral clearance | recess_d_printed (80 %) | Open the recess to CAD 19.56 and accept up to 0.40 diametral clearance (T02-relax40). The radial float then stays inside the 0.30 concentricity budget (T04-relax40). Better still, print the coupon and size the recess from the measured hole. (T02-relax40: PASS, Cpk 1.61) |
| T03 | Axial stack horn face to clamp to screw — thread engagement | **FAIL (blocked by T03B; own check PASS)** | 100.000 % (<30 ppm (0 of 100,000 samples; 95% upper bound) out) | 4.99 ± 0.04 | 1.885 … 2.100 (in) | LSL 1.500 mm full-thread engagement below horn face H | horn_hole_depth (100 %) | Measure the real horn hole depth (DB M15) before buying screws. At 3.5 deep, M3x6 engages fully but is marginal on bottoming (T03-depth35), so run each screw in by hand and check the head seats before torquing. (T03-depth35: MARGINAL, Cpk 2.46) |
| T03B | Axial stack — screw tip clear of the horn hole floor | **FAIL** | 0.00 % | -1.55 ± 0.02 | -1.015 … 0.215 (out) | LSL 0.200 mm | clamp_thickness (41 %) | Measure the horn hole depth (DB M15) before buying screws. At the CAD 2.5, M3x6 bottoms and M3x5 engages too little (T03-m3x5); at 3.5 deep M3x6 is marginal (T03B-depth35), so check each head seats by hand. (T03B-depth35: MARGINAL, Cpk 1.04) |
| T04 | Gripper datum B axis vs wrist-roll axis (concentricity) | **PASS** | 100.000 % (<30 ppm (0 of 100,000 samples; 95% upper bound) out) | 2.25 ± 0.01 | 0.000 … 0.250 (in) | USL 0.300 mm radial offset | pilot_float (54 %) | none needed |
| T05 | Jaw centreline offset at the fingertips vs roll axis (X, closing axis) | **FAIL** | 99.36 % | 0.92 ± 0.01 | -1.330 … 1.944 (out) | LSL -0.193, USL 0.807 mm | deck_float (64 %) | Locate the deck on the spider with two bonded ISO 2338 h8 pins in reamed deck holes. That removes the deck screw float; T05-deckpegs includes translation clearance and rotation about the two-pin pattern. (T05-deckpegs: PASS, Cpk 1.35) |
| T06 | Gear centre distance a (pin A to pin B, rev A pinned layout) | **PASS** | 100.000 % (<30 ppm (0 of 100,000 samples; 95% upper bound) out) | 2.04 ± 0.00 | 28.356 … 28.644 (in) | LSL 28.286, USL 28.714 mm | pinA_to_pinB_holes (93 %) | none needed |
| T07 | Gear backlash jt (circumferential, m 1.5 z 19, alpha 25) | **PASS** | 99.998 % (<63 ppm (2 of 100,000 samples; 95% upper bound) out) | 1.44 ± 0.02 | -0.078 … 0.578 (out) | LSL 0.050, USL 0.450 mm circumferential backlash | centre_distance (50 %) | none needed |
| T08 | Gear mesh axial alignment (gear A vs gear B mid-planes, Z) | **PASS** | 100.000 % (<30 ppm (0 of 100,000 samples; 95% upper bound) out) | 2.49 ± 0.01 | -0.490 … 0.490 (in) | LSL -0.800, USL 0.800 mm | float_A (46 %) | none needed |
| T09 | Closure gap — first-contact angle of the jaw before calibration | **PASS** | 100.000 % (<30 ppm (0 of 100,000 samples; 95% upper bound) out) | 2.37 ± 0.03 | -3.875 … 1.566 (in) | LSL -4.000, USL 4.000 deg | horn_trim (68 %) | none needed |
| T09F | Pad force at the jaw floor with the FSR trip failed (position-only cap, R15) | **FAIL** | 44.91 % | -0.04 ± 0.00 | 3.589 … 13.338 (out) | USL 8.000 N | theta_c (57 %) | APPLIED in the firmware (config.h JAW_FLOOR_BELOW_C0_DEG 4.9, JAW_MIN_DEG -10.2 backstop; controls.md 6.4): the floor is relative to the calibrated contact angle (theta_c0 - 4.9 deg) instead of the absolute -7.4 deg, so the contact spread drops out, and 4.9 deg holds the ruled 8 N on the stiff pair (T09F-relfloor8). Round 2's 6.2 deg floor (T09F-relfloor) held the superseded 10 N only; 5.0 deg is MARGINAL. The base stack is the firmware before round 2. (T09F-relfloor8: PASS, Cpk 1.46) |
| T09H | Largest hold force the firmware can reach on the softest finger (R14 under the R15 cap) | **PASS** | 100.000 % (<30 ppm (0 of 100,000 samples; 95% upper bound) out) | 2.44 ± 0.01 | 4.183 … 6.858 (out) | LSL 5.000 N | k_pair (100 %) | Needed only once the dog slots open to 3.4 (rev B row 1): the 1.5 deg of dog lash moves the first contact toward the jaw floor, and the absolute floor then cuts the squeeze short (T09H falls to Cpk 0.99 in the combined rev B run). The floor relative to the calibrated contact angle (the T09F firmware request, APPLIED in config.h JAW_FLOOR_BELOW_C0_DEG 4.9 for the ruled 8 N; 6.2 in round 2): T09H-relfloor8. The 4.9 deg floor sits just past the 4.867 deg squeeze cap, so it is MARGINAL exactly as with 6.2 (T09H-relfloor); the softest pair at the cap is the limit, not the floor. (T09H-relfloor8: MARGINAL, Cpk 1.28) |
| T09P | Peak pad force when the FSR over-force trip fires (R15) | **FAIL** | 11.53 % | -0.52 ± 0.00 | 7.045 … 11.105 (out) | USL 8.000 N | squeeze_deg (86 %) | APPLIED in the firmware (config.h JAW_FLOOR_BELOW_C0_DEG 4.9; controls.md 6.4): the jaw floor theta_c0 - 4.9 deg is a position bound the squeeze cannot pass whether or not the trip fires, so the peak is the smaller of the trip peak and the force at the floor (T09P-floor49, same floor samples as T09F-relfloor8). No trip setting does it alone: the only trip that passes by itself, F_TRIP_N 5.5 with F_TRIP_MS 10 (T09P-trip55), sits inside the hold band and falsely trips grips, as F_TRIP_N 7.0 did (T09P-trip7, declined: 10 of 17 window grips, 34 of 1,000 drawn grips). (T09P-floor49: PASS, Cpk 1.46) |
| T09T | Close time to first contact after calibration (R19) | **PASS** | 100.000 % (<30 ppm (0 of 100,000 samples; 95% upper bound) out) | 8.28 ± 0.10 | 0.463 … 0.551 (in) | USL 0.750 s | servo_angle_error (70 %) | No timing fix needed for first contact under the ruled 0.75 s limit. Retain the 6 deg slow zone: the 3 deg alternative (T09T-slow3) was declined after firmware simulation found excessive contact speed and early-contact force (controls.md 6.4). (T09T-slow3: PASS, Cpk 12.54) |
| T10 | Finger pad parallelism in the closing plane (root gap at tip contact) | **FAIL** | 96.42 % | 0.60 ± 0.00 | -0.805 … 2.091 (out) | LSL -1.000, USL 1.000 mm root gap when the tips first touch | pad_A_tilt (25 %) | Toe the rigid contact faces in by 0.44 deg (contact_gap / (2 r_c) = 1.0 / 130 rad, hinged at the pad-contact point, the same -0.44 deg touch the firmware sim uses) so they are parallel at first contact, not at theta = 0 (T10-toein). The 0.64 mm design V then goes away and the tolerance band is centred. (T10-toein: PASS, Cpk 1.67) |
| T10B | Fingertip out-of-plane mismatch (Z) from pin perpendicularity and knuckle wobble | **PASS** | 100.000 % (<30 ppm (0 of 100,000 samples; 95% upper bound) out) | 1.95 ± 0.01 | -2.465 … 2.465 (out) | LSL -2.000, USL 2.000 mm | pinA_perpendicularity (29 %) | none needed |
| T11 | Radial keep-out, r 11.6 hub band (H-1..H+1) vs wrist-link lip r 12.6 | **PASS** | 100.000 % (<30 ppm (0 of 100,000 samples; 95% upper bound) out) | 2.26 ± 0.01 | 0.200 … 1.150 (in) | LSL 0.100 mm radial clearance, worst angle over 320 deg roll | lip_radius (49 %) | none needed |
| T12 | Axial keep-out, gripper widens (r > 15) above the wrist-link lip top | **PASS** | 100.000 % (<30 ppm (0 of 100,000 samples; 95% upper bound) out) | 1.85 ± 0.01 | 0.100 … 1.500 (in) | LSL 0.100 mm | widen_height_above_H (41 %) | none needed |
| T12B | Axial gap, gripper rim to servo-5 case top | **PASS** | 100.000 % (<30 ppm (0 of 100,000 samples; 95% upper bound) out) | 14.04 ± 0.04 | 3.500 … 4.100 (in) | LSL 0.500 mm | rim_below_H (79 %) | none needed |
| T13 | Wrist-camera aim angle error (optional UVC bracket on the front-plate pad) | **PASS** | 100.000 % (<30 ppm (0 of 100,000 samples; 95% upper bound) out) | 1.83 ± 0.01 | -3.033 … 3.033 (out) | LSL -3.000, USL 3.000 deg | lens_tilt (35 %) | none needed |
| T14 | Gripper servo body in cradle fit (20.4 pocket, DS3218MG 20.1 wide) | **FAIL** | 95.16 % | 0.55 ± 0.00 | -0.050 … 0.450 (out) | LSL 0.000, USL 0.300 mm clearance | pocket_width (69 %) | Locate the servo by its output boss (the T14B fix) so the cradle no longer has to locate it, then open the pocket to CAD 20.5 so it always drops in (T14-boss205). The listed DS3218MG width is 20.1, not the CAD 20.0. (T14-boss205: PASS, Cpk 1.68) |
| T14B | Dog coupling — servo shaft offset from pin A against the dog slot clearance | **FAIL** | 40.68 % | -0.06 ± 0.00 | -0.151 … 0.552 (out) | USL 0.000 mm tangential interference at a dog | shaft_in_case (38 %) | B40 keeps the Ø9 boss location and 3.4 mm slots. Custom hardened M3 shoulder dog screws (Ø2.9 at the horn face) load two Ø6 steel inserts in the horn. The chosen boss34 id is retained for the combined rev B overlay; its contributor now models the B40 shoulder. Verify insert retention, horn rim and lash on a coupon. (T14B-boss34: MARGINAL, Cpk 1.10) |
| T15 | Knuckle end play at pin B (three standoffs, shims 0.85 per side) | **FAIL** | 89.67 % | 0.50 ± 0.01 | -0.710 … 1.310 (out) | LSL 0.050, USL 0.500 mm axial end play | standoff_top (41 %) | Pick the shims at assembly: measure the gap at each pin with feeler gauges and stack shims from a 0.05-step set so the end play lands at 0.3 +/- 0.05 (T15-shimselect). No CAD change; buy a shim assortment. (T15-shimselect: PASS, Cpk 4.35) |
| T16 | Pin axis tilt, centre-distance change across the 8 mm gear face | **PASS** | 100.000 % (<30 ppm (0 of 100,000 samples; 95% upper bound) out) | 1.67 ± 0.01 | -0.067 … 0.067 (in) | LSL -0.070, USL 0.070 mm | knuckleA_tilt_on_pin (32 %) | none needed |
| T16B | Knuckle sleeve running fit on its pin (bronze bush bore vs m6 dowel) | **FAIL** | 68.93 % | 0.29 ± 0.00 | -0.008 … 0.014 (out) | LSL 0.000 mm diametral clearance | sleeve_bore (88 %) | Use an h8 pin (ISO 2338, 2.986-3.000) instead of the m6 dowel (T16B-h8pin). The bush maker recommends a running shaft of f7 or h7, and m6 is a press-fit size. Buy 3 x 6 bushes (no 3 x 5 bush was found in the catalogue searched [A]; confirm with the supplier) and open the knuckle bore to 6. The worst case of the fix is exactly 0.000 clearance (3.000 pin in a 3.000 bore), so check a few pins and pressed bores. (T16B-h8pin: PASS, Cpk 1.05) |

## Options, rejected layouts and scenarios

| Variant | Role | Change | Verdict | Yield (MC) | Cpk | Worst case |
|---|---|---|---|---|---:|---|
| T01-cad37 | option | mount holes CAD 3.7 | PASS | 100.000 % (<30 ppm (0 of 100,000 samples; 95% upper bound) out) | 1.77 ± 0.02 | -0.363 … -0.035 |
| T01-stock32 | rejected | stock CAD hole 3.2 (SO-101 gripper) | FAIL | 7.81 % | -0.53 ± 0.01 | -0.113 … 0.215 |
| T01H-stock60 | rejected | stock counterbore 6.0 | FAIL | 89.11 % | 0.47 ± 0.00 | -0.300 … 0.175 |
| T02-relax40 | option | recess CAD 19.56 and accept clearance up to 0.40 (checked by T04-relax40) | PASS | 100.000 % (<30 ppm (0 of 100,000 samples; 95% upper bound) out) | 1.61 ± 0.02 | 0.050 … 0.350 |
| T02-stock20 | rejected | stock Ø20.0 recess, no chamfer | FAIL | 0.00 % | -1.89 ± 0.01 | 0.390 … 0.890 |
| T03-depth35 | scenario | horn holes measured 3.5 deep (M15 outcome to confirm) | MARGINAL (blocked by T03B-depth35; own check PASS) | 100.000 % (<3 ppm (0 of 1,000,000 samples; 95% upper bound) out) | 2.46 ± 0.01 | 1.885 … 2.915 |
| T03-m3x5 | option | M3x5 screws in the 2.5 CAD hole | FAIL (blocked by T03B-m3x5; own check FAIL) | 23.15 % | -0.27 ± 0.00 | 0.885 … 1.915 |
| T03B-depth35 | scenario | horn holes measured 3.5 deep (M15 outcome to confirm) | MARGINAL | 99.916 % (835 ppm out) | 1.04 ± 0.00 | -0.015 … 1.215 |
| T03B-m3x5 | option | M3x5 screws | MARGINAL | 99.916 % (835 ppm out) | 1.04 ± 0.00 | -0.015 … 1.215 |
| T04-relax40 | scenario | recess CAD 19.56, clearance up to 0.40 (T02-relax40) | PASS | 100.000 % (<30 ppm (0 of 100,000 samples; 95% upper bound) out) | 1.96 ± 0.01 | 0.000 … 0.275 |
| T04-stock20 | rejected | stock Ø20.0 recess (T02-stock20) | FAIL | 82.80 % | 0.39 ± 0.00 | 0.000 … 0.545 |
| T05-deckpegs | option | deck located by two bought h8 pins in reamed holes | PASS | 99.996 % (43 ppm out) | 1.35 ± 0.00 | -1.037 … 1.651 |
| T05-tcpcal | option | measure the pinch point once and set the TCP (removes every fixed offset; leaves the T04 float) | PASS | 100.000 % (<30 ppm (0 of 100,000 samples; 95% upper bound) out) | 1.96 ± 0.02 | -0.517 … 1.131 |
| T06-servoshaft | rejected | pre-rev-A layout: knuckle A on the servo shaft, pin B in the housing | FAIL | 97.25 % | 0.75 ± 0.01 | 28.028 … 28.972 |
| T07-servoshaft | rejected | pre-rev-A layout (T06-servoshaft) | FAIL | 96.14 % | 0.69 ± 0.00 | -0.383 … 0.883 |
| T09-b40_shoulder34 | option | B40 hardened Ø2.9 shoulders (2.900 mm mid [A]) in 3.4 mm printed dog slots | PASS | 100.000 % (<30 ppm (0 of 100,000 samples; 95% upper bound) out) | 1.39 ± 0.02 | -5.050 … 0.392 |
| T09F-r15p8 | scenario | R15 ruled: cap 8 N | FAIL | 44.91 % | -0.04 ± 0.00 | 3.589 … 13.338 |
| T09F-relfloor | option | firmware round 2: floor = calibrated contact - 6.2 deg (held the superseded 10 N at the stiff finger) | FAIL | 47.07 % | -0.03 ± 0.00 | 6.408 … 9.863 |
| T09F-relfloor8 | option | firmware: floor = calibrated contact - 4.9 deg (config.h JAW_FLOOR_BELOW_C0_DEG), against the ruled 8 N cap | PASS | 100.000 % (<30 ppm (0 of 100,000 samples; 95% upper bound) out) | 1.46 ± 0.00 | 4.865 … 8.031 |
| T09H-relfloor8 | option | firmware: floor = calibrated contact - 4.9 deg (JAW_FLOOR_BELOW_C0_DEG), the squeeze still limited by u_max | MARGINAL | 99.996 % (<92 ppm (4 of 100,000 samples; 95% upper bound) out) | 1.28 ± 0.01 | 4.826 … 7.985 |
| T09H-relfloor | option | firmware round 2: floor = calibrated contact - 6.2 deg, so the squeeze is limited by u_max alone | MARGINAL | 99.996 % (<92 ppm (4 of 100,000 samples; 95% upper bound) out) | 1.28 ± 0.01 | 4.826 … 7.985 |
| T09H-r15p8 | scenario | squeeze cap sized for the ruled 8 N: 3.785 deg (basis u_max_8_deg, the firmware compiled with F_CAP_N 8) | FAIL | 39.50 % | -0.21 ± 0.00 | 4.183 … 5.333 |
| T09P-r15p8 | scenario | R15 ruled: cap 8 N | FAIL | 11.53 % | -0.52 ± 0.00 | 7.045 … 11.105 |
| T09P-trip7 | option | firmware: F_TRIP_N 7.0, F_TRIP_MS 10 | FAIL | 65.44 % | 0.18 ± 0.00 | 6.364 … 9.426 |
| T09P-trip55 | scenario | firmware: F_TRIP_N 5.5, F_TRIP_MS 10, against the ruled 8 N cap | PASS | 100.000 % (<30 ppm (0 of 100,000 samples; 95% upper bound) out) | 1.48 ± 0.01 | 5.000 … 7.760 |
| T09P-floor49 | option | firmware: trip 7.75 N / 20 ms, peak bounded by the jaw floor theta_c0 - 4.9 deg (JAW_FLOOR_BELOW_C0_DEG) | PASS | 100.000 % (<30 ppm (0 of 100,000 samples; 95% upper bound) out) | 1.46 ± 0.00 | 4.865 … 8.031 |
| T09T-r19p075 | scenario | Historical R19 limit: 0.5 s (legacy r19p075 scenario id) | FAIL | 24.04 % | -0.24 ± 0.00 | 0.463 … 0.551 |
| T09T-slow3 | option | firmware: JAW_SLOW_ZONE_DEG 6 -> 3 (0.125 s less: 3 deg at 120 instead of 20 deg/s) | PASS | 100.000 % (<30 ppm (0 of 100,000 samples; 95% upper bound) out) | 12.54 ± 0.15 | 0.338 … 0.426 |
| T10-toein | option | contact faces toed in 0.44 deg: parallel at first contact | PASS | 100.000 % (<30 ppm (0 of 100,000 samples; 95% upper bound) out) | 1.67 ± 0.01 | -1.448 … 1.448 |
| T11-band2 | scenario | second band: hub r 14.6 (H+1..H+5.0) vs lip r 15.4, not a first layer | PASS | 100.000 % (<30 ppm (0 of 100,000 samples; 95% upper bound) out) | 1.90 ± 0.01 | 0.100 … 1.050 |
| T11-stock12 | rejected | pre-rev-A hub r 12.0 | FAIL | 99.33 % | 0.83 ± 0.00 | -0.200 … 0.750 |
| T12-stock45 | rejected | pre-rev-A widen at 4.5 above H | FAIL | 92.96 % | 0.53 ± 0.00 | -0.400 … 1.000 |
| T13-notab | rejected | no locating tab: rotation set by 2 screws in Ø3.6 holes | FAIL | 68.01 % | 0.58 ± 0.00 | -6.983 … 6.983 |
| T14-w205 | scenario | servo body 20.5 (actuators.csv A17) in the rev A 20.4 pocket: it does not fit | FAIL | 0.03 % | -1.12 ± 0.01 | -0.450 … 0.050 |
| T14-w205p209 | scenario | servo body 20.5 in a pocket opened to 20.9 while the cradle still locates it: float over the 0.30 limit | FAIL | 49.90 % | -0.00 ± 0.00 | 0.050 … 0.550 |
| T14-boss | option | boss-located servo: only drop-in matters; pocket width from the case constants | MARGINAL | 99.958 % (420 ppm out) | 1.12 ± 0.01 | -0.050 … 0.450 |
| T14-boss205 | option | boss-located servo (T14B-boss34) + pocket CAD 20.5: only drop-in matters | PASS | 100.000 % (<30 ppm (0 of 100,000 samples; 95% upper bound) out) | 1.68 ± 0.02 | 0.050 … 0.550 |
| T14-cad205 | rejected | pocket CAD 20.5 while the cradle still locates the servo | FAIL | 49.90 % | -0.00 ± 0.00 | 0.050 … 0.550 |
| T14B-w205 | scenario | servo body 20.5 (actuators.csv A17) in a pocket opened to 20.9, rev A cradle-located: servo float 0.15 per side | FAIL | 33.89 % | -0.11 ± 0.00 | -0.115 … 0.602 |
| T14B-boss34 | option | B40: Ø9 boss location, Ø2.9 hardened shoulders in Ø6 steel inserts, dog slots 3.4 | MARGINAL | 99.940 % (600 ppm out) | 1.10 ± 0.01 | -0.272 … 0.206 |
| T14B-boss | option | servo located by its boss, slots unchanged at 3.14 | FAIL | 64.54 % | 0.11 ± 0.00 | -0.153 … 0.374 |
| T15-shimselect | option | shims picked at assembly from a 0.05-step set | PASS | 100.000 % (<30 ppm (0 of 100,000 samples; 95% upper bound) out) | 4.35 ± 0.05 | 0.245 … 0.355 |
| T16-noream | scenario | line reaming skipped: plate holes as printed, front plate located by the pins | FAIL | 96.83 % | 0.71 ± 0.01 | -0.157 … 0.157 |
| T16B-h8pin | option | ISO 2338 h8 pin 2.986-3.000 as the knuckle shaft | PASS | 100.000 % (<30 ppm (0 of 100,000 samples; 95% upper bound) out) | 1.05 ± 0.00 | -0.000 … 0.030 |

## All numbers

Nominal is the drawn value with no process bias and no radial term; the other columns include both, so Nominal can lie outside the WC band (T01, T01H, T04, T14B). Mean (MC) is the Monte Carlo mean with the bias.

| Stack | Role | Nominal | Mean (MC) | WC | RSS (dist.) | MC 99.73 % band | Out % | Cpk | Spec | Accept | Verdict |
|---|---|---:|---:|---|---|---|---:|---:|---|---|---|
| T01 Horn-to-mount bolt pattern fit (4x M3 on the 14.0 BC) | baseline | -0.337 | -0.143 | -0.313 … 0.015 | -0.299 … -0.014 | -0.259 … -0.034 | <92 ppm (4 of 100,000 samples; 95% upper bound) | 1.31 ± 0.02 | USL 0.000 | WC | **MARGINAL** |
| T01-cad37 (mount holes CAD 3.7) | option | -0.387 | -0.193 | -0.363 … -0.035 | -0.349 … -0.064 | -0.309 … -0.084 | <30 ppm (0 of 100,000 samples; 95% upper bound) | 1.77 ± 0.02 | USL 0.000 | WC | **PASS** |
| T01-stock32 (stock CAD hole 3.2 (SO-101 gripper)) | rejected | -0.137 | 0.057 | -0.113 … 0.215 | -0.099 … 0.186 | -0.059 … 0.166 | 92.2 % | -0.53 ± 0.01 | USL 0.000 | WC | **FAIL** |
| T01H M3 pan head clears its counterbore (rev A Ø6.5) | baseline | -0.525 | -0.326 | -0.550 … -0.075 | -0.550 … -0.152 | -0.485 … -0.165 | <30 ppm (0 of 100,000 samples; 95% upper bound) | 2.02 ± 0.01 | USL 0.000 | WC | **PASS** |
| T01H-stock60 (stock counterbore 6.0) | rejected | -0.275 | -0.076 | -0.300 … 0.175 | -0.300 … 0.098 | -0.235 … 0.085 | 10.9 % | 0.47 ± 0.00 | USL 0.000 | WC | **FAIL** |
| T02 Horn pilot recess radial fit (Ø19.2 horn in the printed Ø19.51 recess) | baseline | 0.310 | 0.150 | 0.000 … 0.300 | 0.038 … 0.262 | 0.038 … 0.262 | 240 ppm | 1.16 ± 0.02 | LSL 0.020, USL 0.300 | MC | **MARGINAL** |
| T02-relax40 (recess CAD 19.56 and accept clearance up to 0.40 (checked by T04-relax40)) | option | 0.360 | 0.200 | 0.050 … 0.350 | 0.088 … 0.312 | 0.088 … 0.312 | <30 ppm (0 of 100,000 samples; 95% upper bound) | 1.61 ± 0.02 | LSL 0.020, USL 0.400 | MC | **PASS** |
| T02-stock20 (stock Ø20.0 recess, no chamfer) | rejected | 0.800 | 0.640 | 0.390 … 0.890 | 0.434 … 0.846 | 0.462 … 0.819 | 100 % | -1.89 ± 0.01 | LSL 0.020, USL 0.300 | MC | **FAIL** |
| T03 Axial stack horn face to clamp to screw — thread engagement | baseline | 2.000 | 2.000 | 1.885 … 2.100 | 1.900 … 2.100 † | 1.900 … 2.101 | <30 ppm (0 of 100,000 samples; 95% upper bound) | 4.99 ± 0.04 | LSL 1.500 | WC | **FAIL (blocked by T03B; own check PASS)** |
| T03-depth35 (horn holes measured 3.5 deep (M15 outcome to confirm)) | scenario | 2.500 | 2.400 | 1.885 … 2.915 | 2.005 … 2.795 | 2.034 … 2.768 | <3 ppm (0 of 1,000,000 samples; 95% upper bound) | 2.46 ± 0.01 | LSL 1.500 | WC | **MARGINAL (blocked by T03B-depth35; own check PASS)** |
| T03-m3x5 (M3x5 screws in the 2.5 CAD hole) | option | 1.500 | 1.400 | 0.885 … 1.915 | 1.005 … 1.795 | 1.034 … 1.773 | 76.9 % | -0.27 ± 0.00 | LSL 1.500 | WC | **FAIL (blocked by T03B-m3x5; own check FAIL)** |
| T03B Axial stack — screw tip clear of the horn hole floor | baseline | -0.500 | -0.400 | -1.015 … 0.215 | -0.807 … 0.007 | -0.787 … -0.021 | 100 % | -1.55 ± 0.02 | LSL 0.200 | WC | **FAIL** |
| T03B-depth35 (horn holes measured 3.5 deep (M15 outcome to confirm)) | scenario | 0.500 | 0.600 | -0.015 … 1.215 | 0.193 … 1.007 | 0.217 … 0.981 | 835 ppm | 1.04 ± 0.00 | LSL 0.200 | WC | **MARGINAL** |
| T03B-m3x5 (M3x5 screws) | option | 0.500 | 0.600 | -0.015 … 1.215 | 0.193 … 1.007 | 0.217 … 0.981 | 835 ppm | 1.04 ± 0.00 | LSL 0.200 | WC | **MARGINAL** |
| T04 Gripper datum B axis vs wrist-roll axis (concentricity) | baseline | 0.000 | 0.066 | 0.000 … 0.250 | 0.000 … 0.180 | 0.003 … 0.168 | <30 ppm (0 of 100,000 samples; 95% upper bound) | 2.25 ± 0.01 | USL 0.300 | MC | **PASS** |
| T04-relax40 (recess CAD 19.56, clearance up to 0.40 (T02-relax40)) | scenario | 0.000 | 0.079 | 0.000 … 0.275 | 0.000 … 0.213 | 0.003 … 0.191 | <30 ppm (0 of 100,000 samples; 95% upper bound) | 1.96 ± 0.01 | USL 0.300 | MC | **PASS** |
| T04-stock20 (stock Ø20.0 recess (T02-stock20)) | rejected | 0.000 | 0.217 | 0.000 … 0.545 | 0.000 … 0.545 † | 0.012 … 0.422 | 17.2 % | 0.39 ± 0.00 | USL 0.300 | MC | **FAIL** |
| T05 Jaw centreline offset at the fingertips vs roll axis (X, closing axis) | baseline | 0.307 | 0.307 | -1.330 … 1.944 | -0.281 … 0.895 | -0.231 … 0.852 | 0.644 % | 0.92 ± 0.01 | LSL -0.193, USL 0.807 | MC | **FAIL** |
| T05-deckpegs (deck located by two bought h8 pins in reamed holes) | option | 0.307 | 0.307 | -1.037 … 1.651 | -0.048 … 0.662 | -0.063 … 0.674 | 43 ppm | 1.35 ± 0.00 | LSL -0.193, USL 0.807 | MC | **PASS** |
| T05-tcpcal (measure the pinch point once and set the TCP (removes every fixed offset; leaves the T04 float)) | option | 0.307 | 0.307 | -0.517 … 1.131 | 0.050 … 0.564 | 0.053 … 0.563 | <30 ppm (0 of 100,000 samples; 95% upper bound) | 1.96 ± 0.02 | LSL -0.193, USL 0.807 | MC | **PASS** |
| T06 Gear centre distance a (pin A to pin B, rev A pinned layout) | baseline | 28.500 | 28.500 | 28.356 … 28.644 | 28.396 … 28.604 | 28.397 … 28.605 | <30 ppm (0 of 100,000 samples; 95% upper bound) | 2.04 ± 0.00 | LSL 28.286, USL 28.714 | MC | **PASS** |
| T06-servoshaft (pre-rev-A layout: knuckle A on the servo shaft, pin B in the housing) | rejected | 28.500 | 28.500 | 28.028 … 28.972 | 28.204 … 28.796 | 28.213 … 28.787 | 2.75 % | 0.75 ± 0.01 | LSL 28.286, USL 28.714 | MC | **FAIL** |
| T07 Gear backlash jt (circumferential, m 1.5 z 19, alpha 25) | baseline | 0.250 | 0.250 | -0.078 … 0.578 | 0.113 … 0.387 | 0.111 … 0.389 | <63 ppm (2 of 100,000 samples; 95% upper bound) | 1.44 ± 0.02 | LSL 0.050, USL 0.450 | MC | **PASS** |
| T07-servoshaft (pre-rev-A layout (T06-servoshaft)) | rejected | 0.250 | 0.250 | -0.383 … 0.883 | -0.043 … 0.543 | -0.039 … 0.538 | 3.86 % | 0.69 ± 0.00 | LSL 0.050, USL 0.450 | MC | **FAIL** |
| T08 Gear mesh axial alignment (gear A vs gear B mid-planes, Z) | baseline | 0.000 | -0.000 | -0.490 … 0.490 | -0.383 … 0.383 | -0.321 … 0.321 | <30 ppm (0 of 100,000 samples; 95% upper bound) | 2.49 ± 0.01 | LSL -0.800, USL 0.800 | MC | **PASS** |
| T09 Closure gap — first-contact angle of the jaw before calibration | baseline | -1.154 | -1.154 | -3.875 … 1.566 | -2.364 … 0.055 | -2.352 … 0.069 | <30 ppm (0 of 100,000 samples; 95% upper bound) | 2.37 ± 0.03 | LSL -4.000, USL 4.000 | MC | **PASS** |
| T09-b40_shoulder34 (B40 hardened Ø2.9 shoulders (2.900 mm mid [A]) in 3.4 mm printed dog slots) | option | -2.329 | -2.328 | -5.050 … 0.392 | -3.538 … -1.120 | -3.526 … -1.106 | <30 ppm (0 of 100,000 samples; 95% upper bound) | 1.39 ± 0.02 | LSL -4.000, USL 4.000 | MC | **PASS** |
| T09F Pad force at the jaw floor with the FSR trip failed (position-only cap, R15) | baseline | 8.106 | 8.106 | 3.589 … 13.338 | 6.021 … 10.191 | 6.189 … 10.217 | 55.1 % | -0.04 ± 0.00 | USL 8.000 | MC | **FAIL** |
| T09F-r15p8 (R15 ruled: cap 8 N) | scenario | 8.106 | 8.106 | 3.589 … 13.338 | 6.021 … 10.191 | 6.189 … 10.217 | 55.1 % | -0.04 ± 0.00 | USL 8.000 | MC | **FAIL** |
| T09F-relfloor (firmware round 2: floor = calibrated contact - 6.2 deg (held the superseded 10 N at the stiff finger)) | option | 8.047 | 8.047 | 6.408 … 9.863 | 6.633 … 9.460 | 6.870 … 9.298 | 52.9 % | -0.03 ± 0.00 | USL 8.000 | MC | **FAIL** |
| T09F-relfloor8 (firmware: floor = calibrated contact - 4.9 deg (config.h JAW_FLOOR_BELOW_C0_DEG), against the ruled 8 N cap) | option | 6.359 | 6.360 | 4.865 … 8.031 | 5.150 … 7.569 | 5.307 … 7.480 | <30 ppm (0 of 100,000 samples; 95% upper bound) | 1.46 ± 0.00 | USL 8.000 | MC | **PASS** |
| T09H Largest hold force the firmware can reach on the softest finger (R14 under the R15 cap) | baseline | 6.317 | 6.316 | 4.183 … 6.858 | 5.379 … 6.858 † | 5.777 … 6.856 | <30 ppm (0 of 100,000 samples; 95% upper bound) | 2.44 ± 0.01 | LSL 5.000 | MC | **PASS** |
| T09H-relfloor8 (firmware: floor = calibrated contact - 4.9 deg (JAW_FLOOR_BELOW_C0_DEG), the squeeze still limited by u_max) | option | 6.317 | 6.317 | 4.826 … 7.985 | 5.112 … 7.521 | 5.283 … 7.447 | <92 ppm (4 of 100,000 samples; 95% upper bound) | 1.28 ± 0.01 | LSL 5.000 | MC | **MARGINAL** |
| T09H-relfloor (firmware round 2: floor = calibrated contact - 6.2 deg, so the squeeze is limited by u_max alone) | option | 6.317 | 6.317 | 4.826 … 7.985 | 5.112 … 7.521 | 5.283 … 7.447 | <92 ppm (4 of 100,000 samples; 95% upper bound) | 1.28 ± 0.01 | LSL 5.000 | MC | **MARGINAL** |
| T09H-r15p8 (squeeze cap sized for the ruled 8 N: 3.785 deg (basis u_max_8_deg, the firmware compiled with F_CAP_N 8)) | scenario | 4.912 | 4.912 | 4.183 … 5.333 | 4.183 … 5.333 † | 4.493 … 5.332 | 60.5 % | -0.21 ± 0.00 | LSL 5.000 | MC | **FAIL** |
| T09P Peak pad force when the FSR over-force trip fires (R15) | baseline | 8.899 | 8.908 | 7.045 … 11.105 | 7.045 … 11.040 † | 7.308 … 10.636 | 88.5 % | -0.52 ± 0.00 | USL 8.000 | MC | **FAIL** |
| T09P-r15p8 (R15 ruled: cap 8 N) | scenario | 8.899 | 8.908 | 7.045 … 11.105 | 7.045 … 11.040 † | 7.308 … 10.636 | 88.5 % | -0.52 ± 0.00 | USL 8.000 | MC | **FAIL** |
| T09P-trip7 (firmware: F_TRIP_N 7.0, F_TRIP_MS 10) | option | 7.759 | 7.767 | 6.364 … 9.426 | 6.364 … 9.253 † | 6.577 … 9.061 | 34.6 % | 0.18 ± 0.00 | USL 8.000 | MC | **FAIL** |
| T09P-trip55 (firmware: F_TRIP_N 5.5, F_TRIP_MS 10, against the ruled 8 N cap) | scenario | 6.259 | 6.266 | 5.000 … 7.760 | 5.000 … 7.689 † | 5.182 … 7.439 | <30 ppm (0 of 100,000 samples; 95% upper bound) | 1.48 ± 0.01 | USL 8.000 | MC | **PASS** |
| T09P-floor49 (firmware: trip 7.75 N / 20 ms, peak bounded by the jaw floor theta_c0 - 4.9 deg (JAW_FLOOR_BELOW_C0_DEG)) | option | 6.359 | 6.360 | 4.865 … 8.031 | 5.150 … 7.569 | 5.307 … 7.480 | <30 ppm (0 of 100,000 samples; 95% upper bound) | 1.46 ± 0.00 | USL 8.000 | MC | **PASS** |
| T09T Close time to first contact after calibration (R19) | baseline | 0.507 | 0.507 | 0.463 … 0.551 | 0.477 … 0.537 | 0.477 … 0.536 | <30 ppm (0 of 100,000 samples; 95% upper bound) | 8.28 ± 0.10 | USL 0.750 | MC | **PASS** |
| T09T-r19p075 (Historical R19 limit: 0.5 s (legacy r19p075 scenario id)) | scenario | 0.507 | 0.507 | 0.463 … 0.551 | 0.477 … 0.537 | 0.477 … 0.536 | 76 % | -0.24 ± 0.00 | USL 0.500 | MC | **FAIL** |
| T09T-slow3 (firmware: JAW_SLOW_ZONE_DEG 6 -> 3 (0.125 s less: 3 deg at 120 instead of 20 deg/s)) | option | 0.382 | 0.382 | 0.338 … 0.426 | 0.352 … 0.412 | 0.352 … 0.411 | <30 ppm (0 of 100,000 samples; 95% upper bound) | 12.54 ± 0.15 | USL 0.750 | MC | **PASS** |
| T10 Finger pad parallelism in the closing plane (root gap at tip contact) | baseline | 0.643 | 0.643 | -0.805 … 2.091 | 0.047 … 1.239 | 0.046 … 1.240 | 3.57 % | 0.60 ± 0.00 | LSL -1.000, USL 1.000 | MC | **FAIL** |
| T10-toein (contact faces toed in 0.44 deg: parallel at first contact) | option | 0.000 | 0.000 | -1.448 … 1.448 | -0.596 … 0.596 | -0.596 … 0.597 | <30 ppm (0 of 100,000 samples; 95% upper bound) | 1.67 ± 0.01 | LSL -1.000, USL 1.000 | MC | **PASS** |
| T10B Fingertip out-of-plane mismatch (Z) from pin perpendicularity and knuckle wobble | baseline | 0.000 | 0.002 | -2.465 … 2.465 | -1.038 … 1.038 | -1.024 … 1.022 | <30 ppm (0 of 100,000 samples; 95% upper bound) | 1.95 ± 0.01 | LSL -2.000, USL 2.000 | MC | **PASS** |
| T11 Radial keep-out, r 11.6 hub band (H-1..H+1) vs wrist-link lip r 12.6 | baseline | 1.000 | 0.733 | 0.200 … 1.150 | 0.388 … 0.962 | 0.453 … 1.006 | <30 ppm (0 of 100,000 samples; 95% upper bound) | 2.26 ± 0.01 | LSL 0.100 | MC | **PASS** |
| T11-band2 (second band: hub r 14.6 (H+1..H+5.0) vs lip r 15.4, not a first layer) | scenario | 0.800 | 0.633 | 0.100 … 1.050 | 0.288 … 0.862 | 0.353 … 0.906 | <30 ppm (0 of 100,000 samples; 95% upper bound) | 1.90 ± 0.01 | LSL 0.100 | MC | **PASS** |
| T11-stock12 (pre-rev-A hub r 12.0) | rejected | 0.600 | 0.333 | -0.200 … 0.750 | -0.012 … 0.562 | 0.053 … 0.606 | 0.673 % | 0.83 ± 0.00 | LSL 0.100 | MC | **FAIL** |
| T12 Axial keep-out, gripper widens (r > 15) above the wrist-link lip top | baseline | 0.700 | 0.800 | 0.100 … 1.500 | 0.394 … 1.206 | 0.421 … 1.179 | <30 ppm (0 of 100,000 samples; 95% upper bound) | 1.85 ± 0.01 | LSL 0.100 | MC | **PASS** |
| T12-stock45 (pre-rev-A widen at 4.5 above H) | rejected | 0.200 | 0.300 | -0.400 … 1.000 | -0.106 … 0.706 | -0.079 … 0.679 | 7.04 % | 0.53 ± 0.00 | LSL 0.100 | MC | **FAIL** |
| T12B Axial gap, gripper rim to servo-5 case top | baseline | 3.800 | 3.800 | 3.500 … 4.100 | 3.508 … 4.092 | 3.565 … 4.032 | <30 ppm (0 of 100,000 samples; 95% upper bound) | 14.04 ± 0.04 | LSL 0.500 | WC | **PASS** |
| T13 Wrist-camera aim angle error (optional UVC bracket on the front-plate pad) | baseline | 0.000 | 0.001 | -3.033 … 3.033 | -1.686 … 1.686 | -1.637 … 1.624 | <30 ppm (0 of 100,000 samples; 95% upper bound) | 1.83 ± 0.01 | LSL -3.000, USL 3.000 | MC | **PASS** |
| T13-notab (no locating tab: rotation set by 2 screws in Ø3.6 holes) | rejected | 0.000 | 0.008 | -6.983 … 6.983 | -6.983 … 6.983 † | -5.173 … 5.208 | 32 % | 0.58 ± 0.00 | LSL -3.000, USL 3.000 | MC | **FAIL** |
| T14 Gripper servo body in cradle fit (20.4 pocket, DS3218MG 20.1 wide) | baseline | 0.300 | 0.200 | -0.050 … 0.450 | 0.020 … 0.380 | 0.021 … 0.380 | 4.84 % | 0.55 ± 0.00 | LSL 0.000, USL 0.300 | MC | **FAIL** |
| T14-w205 (servo body 20.5 (actuators.csv A17) in the rev A 20.4 pocket: it does not fit) | scenario | -0.100 | -0.200 | -0.450 … 0.050 | -0.380 … -0.020 | -0.379 … -0.020 | 100 % | -1.12 ± 0.01 | LSL 0.000, USL 0.300 | MC | **FAIL** |
| T14-w205p209 (servo body 20.5 in a pocket opened to 20.9 while the cradle still locates it: float over the 0.30 limit) | scenario | 0.400 | 0.300 | 0.050 … 0.550 | 0.120 … 0.480 | 0.121 … 0.480 | 50.1 % | -0.00 ± 0.00 | LSL 0.000, USL 0.300 | MC | **FAIL** |
| T14-boss (boss-located servo: only drop-in matters; pocket width from the case constants) | option | 0.300 | 0.200 | -0.050 … 0.450 | 0.020 … 0.380 | 0.021 … 0.380 | 420 ppm | 1.12 ± 0.01 | LSL 0.000 | MC | **MARGINAL** |
| T14-boss205 (boss-located servo (T14B-boss34) + pocket CAD 20.5: only drop-in matters) | option | 0.400 | 0.300 | 0.050 … 0.550 | 0.120 … 0.480 | 0.121 … 0.480 | <30 ppm (0 of 100,000 samples; 95% upper bound) | 1.68 ± 0.02 | LSL 0.000 | MC | **PASS** |
| T14-cad205 (pocket CAD 20.5 while the cradle still locates the servo) | rejected | 0.400 | 0.300 | 0.050 … 0.550 | 0.120 … 0.480 | 0.121 … 0.480 | 50.1 % | -0.00 ± 0.00 | LSL 0.000, USL 0.300 | MC | **FAIL** |
| T14B Dog coupling — servo shaft offset from pin A against the dog slot clearance | baseline | -0.107 | 0.024 | -0.151 … 0.552 | -0.144 … 0.031 | -0.119 … 0.265 | 59.3 % | -0.06 ± 0.00 | USL 0.000 | WC | **FAIL** |
| T14B-w205 (servo body 20.5 (actuators.csv A17) in a pocket opened to 20.9, rev A cradle-located: servo float 0.15 per side) | scenario | -0.107 | 0.040 | -0.115 … 0.602 | -0.115 … 0.031 † | -0.117 … 0.304 | 66.1 % | -0.11 ± 0.00 | USL 0.000 | WC | **FAIL** |
| T14B-boss34 (B40: Ø9 boss location, Ø2.9 hardened shoulders in Ø6 steel inserts, dog slots 3.4) | option | -0.250 | -0.157 | -0.272 … 0.206 | -0.272 … -0.125 † | -0.258 … -0.014 | 600 ppm | 1.10 ± 0.01 | USL 0.000 | WC | **MARGINAL** |
| T14B-boss (servo located by its boss, slots unchanged at 3.14) | option | -0.107 | -0.014 | -0.153 … 0.374 | -0.144 … 0.031 | -0.124 … 0.136 | 35.5 % | 0.11 ± 0.00 | USL 0.000 | WC | **FAIL** |
| T15 Knuckle end play at pin B (three standoffs, shims 0.85 per side) | baseline | 0.300 | 0.300 | -0.710 … 1.310 | -0.109 … 0.709 | -0.113 … 0.702 | 10.3 % | 0.50 ± 0.01 | LSL 0.050, USL 0.500 | MC | **FAIL** |
| T15-shimselect (shims picked at assembly from a 0.05-step set) | option | 0.300 | 0.300 | 0.245 … 0.355 | 0.247 … 0.353 | 0.255 … 0.346 | <30 ppm (0 of 100,000 samples; 95% upper bound) | 4.35 ± 0.05 | LSL 0.050, USL 0.500 | MC | **PASS** |
| T16 Pin axis tilt, centre-distance change across the 8 mm gear face | baseline | 0.000 | -0.000 | -0.067 … 0.067 | -0.045 … 0.045 | -0.042 … 0.042 | <30 ppm (0 of 100,000 samples; 95% upper bound) | 1.67 ± 0.01 | LSL -0.070, USL 0.070 | MC | **PASS** |
| T16-noream (line reaming skipped: plate holes as printed, front plate located by the pins) | scenario | 0.000 | 0.000 | -0.157 … 0.157 | -0.097 … 0.097 | -0.097 … 0.098 | 3.17 % | 0.71 ± 0.01 | LSL -0.070, USL 0.070 | MC | **FAIL** |
| T16B Knuckle sleeve running fit on its pin (bronze bush bore vs m6 dowel) | baseline | 0.003 | 0.003 | -0.008 … 0.014 | -0.008 … 0.014 † | -0.007 … 0.014 | 31.1 % | 0.29 ± 0.00 | LSL 0.000 | WC | **FAIL** |
| T16B-h8pin (ISO 2338 h8 pin 2.986-3.000 as the knuckle shaft) | option | 0.015 | 0.015 | -0.000 … 0.030 | -0.000 … 0.030 † | 0.001 … 0.029 | <30 ppm (0 of 100,000 samples; 95% upper bound) | 1.05 ± 0.00 | LSL 0.000 | WC | **PASS** |

† Distribution-adjusted RSS clipped to the worst-case band (a bounded term dominates).
