douglaspmcgowan/cloth-feed-gripper/analysis/gripper/tolstack/results/T09T-r19p075.md

# T09T-r19p075 — Close time to first contact after calibration (R19)

Variant of `T09T` (scenario): Historical R19 limit: 0.5 s (legacy r19p075 scenario id)

- Requirement: DESIGN-BASIS R19: full close in <= 0.75 s (Douglas ruling 2026-10-12; supersedes 0.5 s). This stack measures time to first pad contact.
- Spec: USL 0.500 s (close command to first pad contact)
- Acceptance: MC (Cpk ≥ 1.33, percentile method)
- Model: linear; source file `T09T_close_time.yaml`; seed 20260922

The firmware simulation reaches contact in 503-511 ms with the calibrated contact angle (fw_sim.json). Any contact later than the calibrated angle adds (delta theta) / 20 deg/s, because the last part is at the near-contact speed. After calibration only the calibration repeatability and the servo repeatability remain.

| Contributor | Kind | Nominal | Bias | Tol (−/+) | Sens. | Dist | σ | Var % | Tag | Source |
|---|---|---:|---:|---|---:|---|---:|---:|---|---|
| t_contact_sim | linear | 0.507 | 0.000 | -0.004 / +0.004 | 1.0000 | uniform | 0.0023 | 5.3 | D | firmware_sim fw_sim.json, k 0.88-1.63 |
| cal_repeat | linear | 0.000 | 0.000 | -0.300 / +0.300 | 0.0500 | normal | 0.1000 | 25.1 | A | deg -> s at 20 deg/s |
| servo_angle_error | linear | 0.000 | 0.000 | -0.500 / +0.500 | 0.0500 | normal | 0.1667 | 69.6 | A | deg -> s at 20 deg/s |

| Result | Value |
|---|---|
| Nominal | 0.507 |
| Mean-shifted centre | 0.507 |
| Worst case | 0.463 … 0.551 (fail) |
| RSS classic (t = 3σ) | 0.478 … 0.536 |
| RSS distribution-adjusted | 0.477 … 0.537 (fail) |
| MC mean / σ | 0.507 / 0.0100 |
| MC 0.135 % … 99.865 % | 0.477 … 0.536 |
| MC min … max | 0.465 … 0.548 |
| MC out of spec | 76 % |
| Cpk percentile / normal | -0.24 ± 0.00 / -0.23 ± 0.00 |
| Yield (MC) | 24.04 % |
| Dominant contributor | servo_angle_error (70 %) |
| Pass/fail by the declared method (MC) | FAIL |
| **Verdict (pass / marginal / fail)** | **FAIL** |

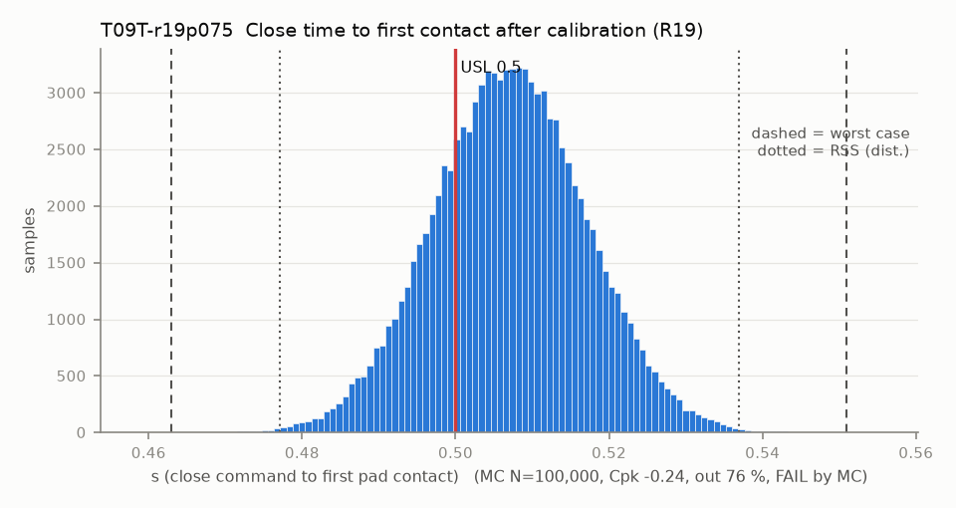
[picture p153: analysis/gripper/tolstack/results/figures/tol_T09T-r19p075.png]
T09T-r19p075 histogram
