douglaspmcgowan/cloth-feed-gripper/analysis/gripper/tolstack/results/T03-m3x5.md

# T03-m3x5 — Axial stack horn face to clamp to screw — thread engagement

Variant of `T03` (option): M3x5 screws in the 2.5 CAD hole

- Requirement: M3 engages >= 1.5 mm (3 pitches) of full horn thread. The screw reaches min(protrusion below H, hole depth), and its incomplete tip thread is inside the hole either way, so engagement = min(L - t - lift - runout, depth) - tip chamfer. Conditional on T03B: a screw that bottoms does not clamp.
- Spec: LSL 1.500 mm full-thread engagement below horn face H
- Acceptance: WC
- Model: expression; source file `T03_thread_engagement.yaml`; seed 20260922

Var % from Monte Carlo freeze-one (non-linear model); Sens. is a central difference at the mids and does not rank contributors. Worst case is taken over the corners only, so a minimum inside the box (the kink of abs()) can be missed.

| Contributor | Kind | Nominal | Bias | Tol (−/+) | Sens. | Dist | σ | Var % | Tag | Source |
|---|---|---:|---:|---|---:|---|---:|---:|---|---|
| screw_length | linear | 5.000 | 0.000 | -0.240 / +0.240 | 1.0000 | normal | 0.0800 | 37.1 | A | M3x6 [S LeRobot]; tol [A] |
| clamp_thickness | linear | 3.000 | 0.000 | -0.150 / +0.150 | -1.0000 | uniform | 0.0866 | 43.4 | S | 3.0 (params.json) [D]; Z band [S Gebre] |
| datum_A_flatness_lift | linear | 0.000 | 0.000 | 0.000 / +0.200 | -1.0000 | uniform | 0.0577 | 19.1 | A | flatness 0.2 on A: part rests on high points |
| horn_face_runout | linear | 0.000 | 0.000 | -0.025 / +0.025 | -1.0000 | normal | 0.0083 | 0.4 | A | horn face FIM 0.05 |
| horn_hole_depth | linear | 2.500 | 0.000 | -0.100 / +0.100 | 0.0000 | normal | 0.0333 | 0.0 | A | 2.5 CAD (so101.md row 4) [D]; tol [A] |
| screw_tip_chamfer | linear | 0.500 | 0.000 | -0.000 / +0.000 | -1.0000 | normal | 0.0000 | 0.0 | A | incomplete thread at the point |

| Result | Value |
|---|---|
| Nominal | 1.500 |
| Mean-shifted centre | 1.400 |
| Worst case | 0.885 … 1.915 (fail) |
| RSS classic (t = 3σ) | 1.099 … 1.701 |
| RSS distribution-adjusted | 1.005 … 1.795 (fail) |
| MC mean / σ | 1.400 / 0.1314 |
| MC 0.135 % … 99.865 % | 1.034 … 1.773 |
| MC min … max | 0.913 … 1.892 |
| MC out of spec | 76.9 % |
| Cpk percentile / normal | -0.27 ± 0.00 / -0.25 ± 0.00 |
| Yield (MC) | 23.15 % |
| Dominant contributor | clamp_thickness (43 %) |
| Pass/fail by the declared method (WC) | FAIL (own FAIL; needs T03B-m3x5) |
| **Verdict (pass / marginal / fail)** | **FAIL (blocked by T03B-m3x5; own check FAIL)** |

Verdict is conditional on: T03B-m3x5.

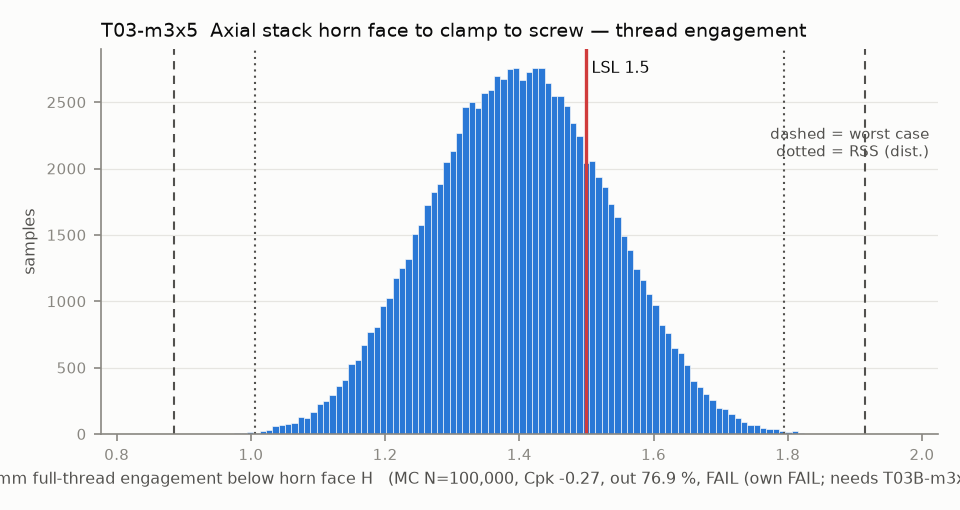
[picture p156: analysis/gripper/tolstack/results/figures/tol_T03-m3x5.png]
T03-m3x5 histogram
