douglaspmcgowan/cloth-feed-gripper/analysis/gripper/tolstack/results/T14B-w205.md

# T14B-w205 — Dog coupling — servo shaft offset from pin A against the dog slot clearance

Variant of `T14B` (scenario): servo body 20.5 (actuators.csv A17) in a pocket opened to 20.9, rev A cradle-located: servo float 0.15 per side

- Requirement: The servo shaft axis and pin A are two separate axes. The two M3 dogs on the horn sit in radial slots in knuckle A, so the slots absorb any offset along the slot, but an offset across the slot must fit inside the tangential half-clearance, or the coupling side-loads the servo bearing and pin A.
- Spec: USL 0.000 mm tangential interference at a dog (> 0 = the dogs force knuckle A sideways)
- Acceptance: WC
- Model: expression; source file `T14B_dog_coupling.yaml`; seed 20260922

Once the boss locates the servo (boss, boss34), the servo case width does not enter this stack at all; only the cradle-located layouts use servo_body_w. Offset across the slot = shaft in case + servo float in the cradle + cradle to pin A hole + spline play + dog screw position + knuckle A float on its pin. For boss variants, wall lean moves the web bore by boss_web_to_pinA * pin_perp_zone / pin_span = 6.30 * 0.10 / 15 = 0.042 mm. Servo-axis direction is set by the ear seats and cradle floor, not the 1.6 mm bore engagement; ear-seat flatness moves the dog plane by boss_to_dog_lever * mount_flatness / servo_ear_span = 3.05 * 0.20 / 54.5 = 0.011 mm. Both levers are CAD derived. Half-clearance = (printed slot width - screw major) / 2. Rev A has 0.06 nominal half-clearance against an offset that can reach 0.5.

Var % from Monte Carlo freeze-one (non-linear model); Sens. is a central difference at the mids and does not rank contributors. Worst case is taken over the corners only, so a minimum inside the box (the kink of abs()) can be missed.

| Contributor | Kind | Nominal | Bias | Tol (−/+) | Sens. | Dist | σ | Var % | Tag | Source |
|---|---|---:|---:|---|---:|---|---:|---:|---|---|
| shaft_in_case | linear | 0.000 | 0.000 | -0.200 / +0.200 | 0.0000 | normal | 0.0667 | 31.2 | A | unpublished |
| servo_float | linear | 0.000 | 0.000 | -0.150 / +0.150 | 0.0000 | uniform | 0.0866 | 39.8 | D | T14 nominal clearance / 2 |
| cradle_to_pinA | linear | 0.000 | 0.000 | -0.100 / +0.100 | 0.0000 | normal | 0.0333 | 7.3 | S | one mid-plate print, < 30 mm |
| spline_play | linear | 0.000 | 0.000 | -0.050 / +0.050 | 0.0000 | uniform | 0.0289 | 5.6 | A |  |
| dog_pos | linear | 0.000 | 0.000 | -0.050 / +0.050 | 0.0000 | normal | 0.0167 | 1.7 | A | dog screw holes in the horn |
| pinA_float | linear | 0.000 | 0.000 | -0.007 / +0.007 | 0.0000 | uniform | 0.0040 | 0.1 | D | knuckle A sleeve on pin A |
| slot_w | linear | 3.140 | -0.100 | -0.150 / +0.150 | -0.5000 | normal | 0.0500 | 10.4 | A | params.json dog_slot_w 3.14 [D]; slot bias and scatter [A] |
| dog_d | linear | 2.927 | 0.000 | -0.053 / +0.053 | 0.5000 | uniform | 0.0306 | 3.9 | S | M3 6g major |
| hot_servo_shift | linear | 0.000 | 0.000 | -0.000 / +0.000 | 0.0000 | uniform | 0.0000 | 0.0 | A | hot scenario only (0 when cold): PETG seat relaxes, servo shifts |
| hot_shaft_shift | linear | 0.000 | 0.000 | -0.000 / +0.000 | 0.0000 | normal | 0.0000 | 0.0 | A | hot scenario only (0 when cold): shaft position term widens |

| Result | Value |
|---|---|
| Nominal | -0.107 |
| Mean-shifted centre | -0.056 |
| Worst case | -0.115 … 0.602 (fail) |
| RSS classic (t = 3σ) | -0.136 … 0.023 — not valid: non-linear model, use Monte Carlo |
| RSS distribution-adjusted | -0.115 … 0.031 † (fail); clipped to WC, unclipped -0.144 … 0.031 — not valid: non-linear model, use Monte Carlo |
| MC mean / σ | 0.040 / 0.0752 |
| MC 0.135 % … 99.865 % | -0.117 … 0.304 |
| MC min … max | -0.168 … 0.424 |
| MC out of spec | 66.1 % |
| Cpk percentile / normal | -0.11 ± 0.00 / -0.18 ± 0.00 |
| Yield (MC) | 33.89 % |
| Dominant contributor | servo_float (40 %) |
| Pass/fail by the declared method (WC) | FAIL |
| **Verdict (pass / marginal / fail)** | **FAIL** |

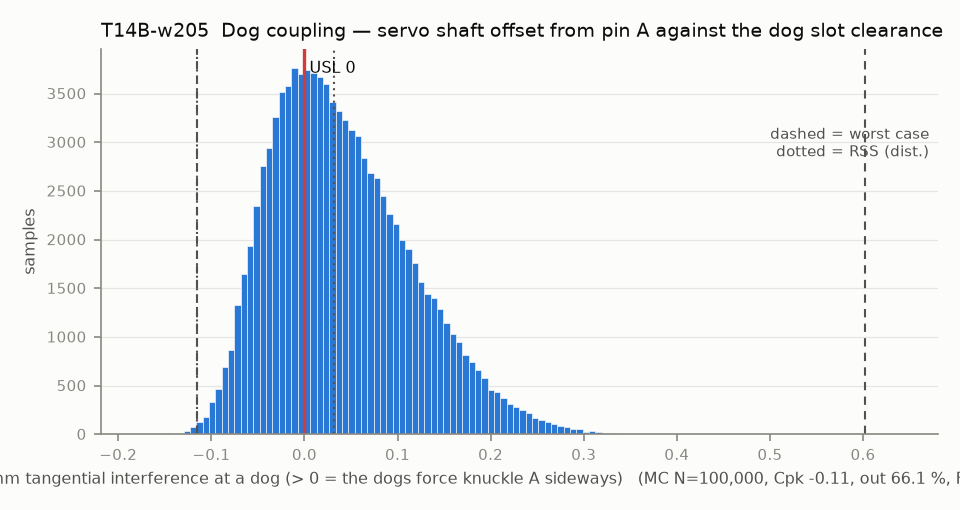
[picture p165: analysis/gripper/tolstack/results/figures/tol_T14B-w205.png]
T14B-w205 histogram
