douglaspmcgowan/cloth-feed-gripper/docs/gripper/test/procedure_templates/TP-13-servo-and-rail.md

**What it proves:** that the DS3218MG makes at least {{tp13.torque_limit}} at the {{tp13.rail_low_limit}} low end of the rail, so the 5 N hold uses no more than 40 % of stall (R16), and that the gripper's 6.5 V rail holds up during a stall (R27). It also measures the stall current, which decides between the two dyno fits (M6). The margin is only 2 %, so it is also run at 6.50 V. About 35 min, on the bare servo before assembly. Data sheet: [`../datasheets/TP-13.html`](../datasheets/TP-13.html) (CSV: `TP-13.csv`).

| | |
|---|---|
| Requirements | R16 (hold ≤ 40 % of stall), R27 (power rail); measurements M6 (stall torque and current), M16 (3.3 V pulse) |
| Pass | R16: stall torque at {{tp13.rail_low_limit}} ≥ {{tp13.torque_limit}} + U on every trial, and the TP-01 hold current ≤ 0.40 × stall current. R27: rail 6.5 ± 0.15 V, ≥ {{tp13.rail_low_limit}} during a stall, 1000 µF at the servo, common ground, supply ≥ 3 A |
| Instrument | 50 mm lever on the TAL220 load cell; U = 1.6 % of T [D `test_plan.py`]. DMM U = 0.06 V at 6.5 V; current U = 0.021 A |
| Sample size | 3 stalls at each voltage, ≤ 2 s each (the winding heats about 3 K per 0.2 s) |

## Expected values

| Quantity | Expected | Source |
|---|---|---|
| Stall torque at 6.50 V / {{tp13.rail_low_limit}} | 2.051 / 2.023 N·m | [D] `test_plan_out.json` → `expected.stall` (dyno rail sensitivity) |
| Force on the 50 mm lever at 6.5 V | 41.0 N | same |
| Stall current at 6.50 V, Fit B / Fit A | 2.10 / 3.75 A | [D] `analysis/dyno.md` section 5 |
| Stall current at {{tp13.rail_low_limit}}, Fit B / Fit A | 2.05 / 3.74 A | same |
| Hold current at 6.5 V, Fit B / Fit A | 0.79 / 1.35 A → ratio 0.38 / 0.36 | [D] `dyno.md` 5; ratio [D, equation] |
| Winding to 125 °C at full stall | 8.1-11.1 s (Fit A, 40 / 25 °C) | [D] `expected.stall` |
| Stall needed for the 40 % rule | {{tp13.torque_limit}} (20.2 kg·cm) | [D] `torque_and_actuator.md` section 0 |

## Equipment

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

## Fixture

```
 Top view. Servo clamped by its ears; lever on the horn; tip presses the cell's free end.

   [ vise ]                      L = 50.0 mm (horn centre to contact)
   +--------+   horn  o==========================( )  rounded tip (M3 pan head)
   | servo  |----(+)                              |  pushes along the cell's
   | DS3218 |                                     v  bending direction
   +--------+                 [M5][M5]==============[M5][M5]  TAL220, free end
                              [ fixed-end block, clamped ]
 Lever square to the cell within 3 degrees at contact.
```

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

## Test sketch (replaces the gripper firmware on the second ESP32 for this test)

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

```cpp
#include <ESP32Servo.h>
Servo s;
int base = 1500;
unsigned long tEnd = 0;
bool pushing = false;

void setup() {
  Serial.begin(115200);
  s.attach(18, 500, 2500);
  s.writeMicroseconds(base);
}

void loop() {
  if (Serial.available()) {
    bool push = (Serial.peek() == 'p');
    if (push) Serial.read();
    int us = Serial.parseInt();
    if (us >= 500 && us <= 2500) {
      s.writeMicroseconds(us);
      if (push) {
        tEnd = millis() + 1500;
        pushing = true;
        Serial.printf("PUSH %d %lu\n", us, millis());
      } else {
        base = us;
        Serial.printf("AT %d\n", us);
      }
    }
  }
  if (pushing && (long)(millis() - tEnd) >= 0) {
    s.writeMicroseconds(base);
    pushing = false;
    Serial.println("BACK");
  }
}
```

## Setup

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

## Steps

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

**A. Find contact.**

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

**B. Stall at 6.50 V, then {{tp13.rail_low_limit}} (R16, M6).**

2. Scope on the servo connector, AC-coupled, 1 V/div, trigger on a falling edge; DMM in series (10 A range) or read the supply.
3. Send `p <P_c + 100>` (about 9° past contact, enough for full drive [A, `dyno.md` 1: full duty at 3° error]). During the 1.5 s push record: probe peak and plateau force, rail current, the scope's lowest rail dip.
4. Wait 30 s. Repeat for 3 trials.
5. Reset the supply to {{tp13.rail_low_limit}} at the connector. 3 more trials, 30 s apart.

**C. The gripper's own rail (R27).**

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

## Data to record

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

## Calculation

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

## Pass / fail

- **R16 torque:** pass if every {{tp13.rail_low_limit}} trial ≥ {{tp13.torque_pass}} (1.98 + U) **and** the lower bound ≥ 1.98; indeterminate if any trial is within 1.948-2.013; fail if any is below 1.948. Also report the 6.50 V trials against {{tp13.torque_limit}} and 2.051 expected.
- **R16 current:** ratio limit 0.40. U of the ratio is about 2.8 % of its value (two current readings, U 0.021 A each at 1.4 A and 2.1 A; check with `analyze_log.py judge --value <ratio> --limit 0.40 --u <ratio × 0.03> --side upper`). **Pass** if ratio + U ≤ 0.40, **fail** if ratio − U ≥ 0.40, else **indeterminate** (measure the hold current again at a second force).
- **M6:** stall current near 2.1 A means Fit B; near 3.75 A, Fit A (then R26 heat is about 1.7× worse, `dyno.md` 8).
- **R27** (DMM U = {{tp13.rail_u}}): **pass** if the buck setting is 6.41-{{tp13.rail_pass}} (6.5 ± 0.15 less U), **fail** outside 6.28-{{tp13.rail_fail}} (6.5 ± 0.15 plus U), **indeterminate** in the strips between, and the stall minimum − 0.06 V ≥ {{tp13.rail_low_limit}}, the capacitor and common ground are present, and the supply is rated ≥ 3 A and ≥ 1.3 × I_stall. With Fit A that is 4.9 A, more than the 4 A that `dyno.md` 3 advises: report it.

## Hazards

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

## If it fails

| Symptom | Likely cause | Tell |
|---|---|---|
| Torque under {{tp13.torque_limit}} at {{tp13.rail_low_limit}} | Weak servo sample or rail sag at the connector; the R16 margin is gone; consider the DS3235 backup | Actuator owner |
| Rail dips under {{tp13.rail_low_limit}} | Long thin leads, small capacitor, or a 3 A supply with a Fit A servo | Electrical owner |
| Stall current about 3.75 A | Fit A: rail and heat sized too small | Electrical owner |
| Servo ignores the pulse | 3.3 V logic not accepted (M16): fit a 74AHCT125 | Electrical owner |
