douglaspmcgowan/cloth-feed-gripper/docs/gripper/test/procedures/TP-01-pad-force.md

# TP-01 Pad force against command, and FSR calibration

<!-- hardware-scope:begin -->
**Hardware scope — arm: `off`; gripper: `bench`.** The arm is off and its power supply is disconnected for this whole procedure. The gripper is fixed in the bench fixture; the arm is not powered.
<!-- hardware-scope:end -->

<!-- procedure-body:begin -->
**What it proves:** the true force between the pads, measured by a load-cell probe, against what the firmware commands and what its FSR reads. It calibrates the FSR span, then shows the 5.0 N hold of R14. About 64 min for its 14 holds (`test_plan.py`: the 62 min first sized for 12 holds plus 31.5 s per further hold); the data sheet has one row per hold. Data sheet: [`../datasheets/TP-01.html`](../datasheets/TP-01.html) (CSV: `TP-01.csv`).

| | |
|---|---|
| Requirements | R14 (hold ≥ 5.0 N per pad), R3 (analog input trace); measurements M11 (FSR curve), M18 (train efficiency, optional) |
| Pass | Every probe sample of each 25.5 s `G 5` hold ≥ 5.0 N **on each of two finger pairs: the softest and the stiffest by the TP-12 k** (the pad force is the same on both pads, but the finger spring sets how closely the loop holds it). Stiffest pair: also the 95 %/90 % lower tolerance bound of its hold minimums ≥ 5.0 N. Softest pair: a zero-failure run, every hold minimum PASS; its bound is reported, not judged |
| Instrument | Pinch probe (TAL220 10 kg + HX711), expanded uncertainty U = 0.096 N at 5 N [D `test_plan.py`] |
| Sample size | 14 holds: **11 on the softest pair, 3 on the stiffest**. Stiffest (sized at k 1.24 N/mm, hold 6.07 N): n = 3 is the smallest n whose bound clears 5.0 N. Softest (k 0.88 N/mm, holds at the squeeze cap, `FORCE_SAT`): predicted hold 5.22 N, margin 0.22 N = 2.2 U, so each hold is decidable on its own, but the bound would need n 55 at σ 0.111 N; it is judged as a zero-failure run, and 11 clean holds show R 0.80 at C 0.90. Risk: at σ 0.111 N, 11 clean holds has p 0.19; that σ is the FSR-span loop scatter, which does not set a hold at the position cap, and TP-01's measured scatter decides it. <!-- prediction-history:begin -->
History: before the firmware regulated its FSR reading 1 N above the setpoint (`F_HOLD_BIAS_N`, `controls.md` 4.1), the softest hold prediction was 5.02 N, inside U, and was expected INDETERMINATE (`MEASUREMENT-SIZING.md` section 3)
<!-- prediction-history:end --> |

## Expected values (from the analysis; a result far from these means a setup error)

| Quantity | Expected | Source |
|---|---|---|
| Hold force on a D7 finger (k 1.05-1.24 N/mm) | 6.07-6.20 N | [D] `fw_sim.json` via `test_plan_out.json` → `expected.close` |
| Hold force at the R12 extremes (k 0.88 / 1.63) | 5.22 (at the squeeze cap, `FORCE_SAT`) / 6.00 N | same |
| Peak during the close | 5.22-7.41 N (7.41 on the stiffest finger) | same |
| FSR reading in HOLD | 6.0-6.6 N: setpoint + `F_HOLD_BIAS_N` 1.0 N, then the 0.6 N integrator deadband (`CTRL_I_DB_HI_N`); lower on a finger that holds at the squeeze cap (`FORCE_SAT`) | [D] `config.h`, `controls.md` 4.1 |
| `G 7` result on a 1.0 N/mm finger | stops at the squeeze cap with `FORCE_SAT`, about 6.0 N (0.5 + 1.135·k·4.87°, CTRL_U_MAX_DEG in `force_ctrl.h`) | [D] `controls.md` 0, equation |
| θ_c0 with the 6 mm probe between the pads | about +2.2° (pads 1 mm apart at 0°, about 2.3 mm of gap per degree near 0°) | [D] `finger.md` 6.1, linearised |
| Probe sensitivity | 33.6 µV/N at 3.3 V excitation; noise 0.003 N rms | [D] `test_plan.py` from [S] TAL220 and HX711 datasheets |

## Equipment

Pinch probe (built below), second microcontroller running `../tools/probe/probe.ino`, lab balance, masses (water bottles weighed to 0.1 g are fine), the gripper on the bench with its 6.5 V rail, a laptop running `../tools/gripper_log.py` on the gripper's USB port and a serial monitor on the probe's port, a vise, a foam block.

## The pinch probe (build once, about 30 min plus printing)

The pads squeeze, so the force has to pass *through* the load cell from one pad to the other. Two thin plates do that: plate P1 is screwed to the load cell's fixed end, plate P2 to its free end, and both stick out past the free end, one above the other with a 2 mm gap. Pad A pushes P1, pad B pushes P2; the cell carries the difference as shear, which is what a parallel-beam cell measures.

```
 Side view. Squeeze direction is up-down on this page.

                                   pad B (FSR side) pushes down
                                              |
   fixed-end block         TAL220 10 kg        v   contact mark, 30 mm past the free end
  [ M5 ][ M5 ]======================[ M5 ][ M5 ]=====================  P2: 2 mm Al (or 3 mm PETG), on the free end
  [    ]                                                    2 mm gap
  [ M5 ]=========================== 1 mm clear of the bar ===========  P1: 2 mm Al, on the fixed end, runs under the bar
                                              ^
                                              |
                                   pad A (nail side) pushes up

 Total thickness at the contact mark: 2 + 2 + 2 = 6 mm.
```

- Keep the stack at the pads **≤ 8 mm**. CALIBRATE searches from +5° and faults if θ_c0 is outside −4…+4° (`config.h` `CAL_C0_MIN_DEG`, `CAL_C0_MAX_DEG`). A 6 mm stack calibrates near +2.2°.
- Mark the contact point on both plates (pen line 30 mm past the free end, where the pad centres will sit).
- Plate tip deflection at 10 N is about 0.13 mm each for 2 × 15 mm aluminium on a 30 mm overhang [D, cantilever FL³/3EI with E 69 GPa], so the probe is about 40 N/mm, stiff against the 1 N/mm finger.
- Wire the TAL220 to the HX711 (red E+, black E−, green A+, white A−, as the TAL220 datasheet colours them [S]), the HX711 to the probe microcontroller (DT, SCK, 3.3 V, GND as set at the top of `probe.ino`).

## Setup

1. Gripper on the bench, wrist plate in a vise, fingers horizontal, so the pads squeeze sideways. Rail at 6.50 V (DMM). USB to the laptop: `python docs/gripper/test/tools/gripper_log.py --port <COM or /dev/tty...> --out TP-01_log.csv` (it timestamps every line; it also accepts interactive input).
2. Probe microcontroller on its own USB port, logging with its serial monitor or `gripper_log.py --port <probe port> --out TP-01_probe.csv`.
3. Let the load cell warm up powered for 10 min (zero drift settles).

## Steps

**A. Calibrate the probe (once per session).**

1. Clamp the fixed-end block in the vise with the squeeze axis vertical and P2 on top. Send `t` to `probe.ino` to tare.
2. Hang masses from a thread loop sitting on the P2 contact mark: 0, 102, 204, 510, 816, 1020 g (0, 1, 2, 5, 8, 10 N at g = 9.80 m/s²). Record the mean of 20 readings at each (`r` in `probe.ino` prints the raw counts). Then unload in reverse.
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
