douglaspmcgowan/cloth-feed-gripper/analysis/gripper/controls/results/figures/loop_bode.png

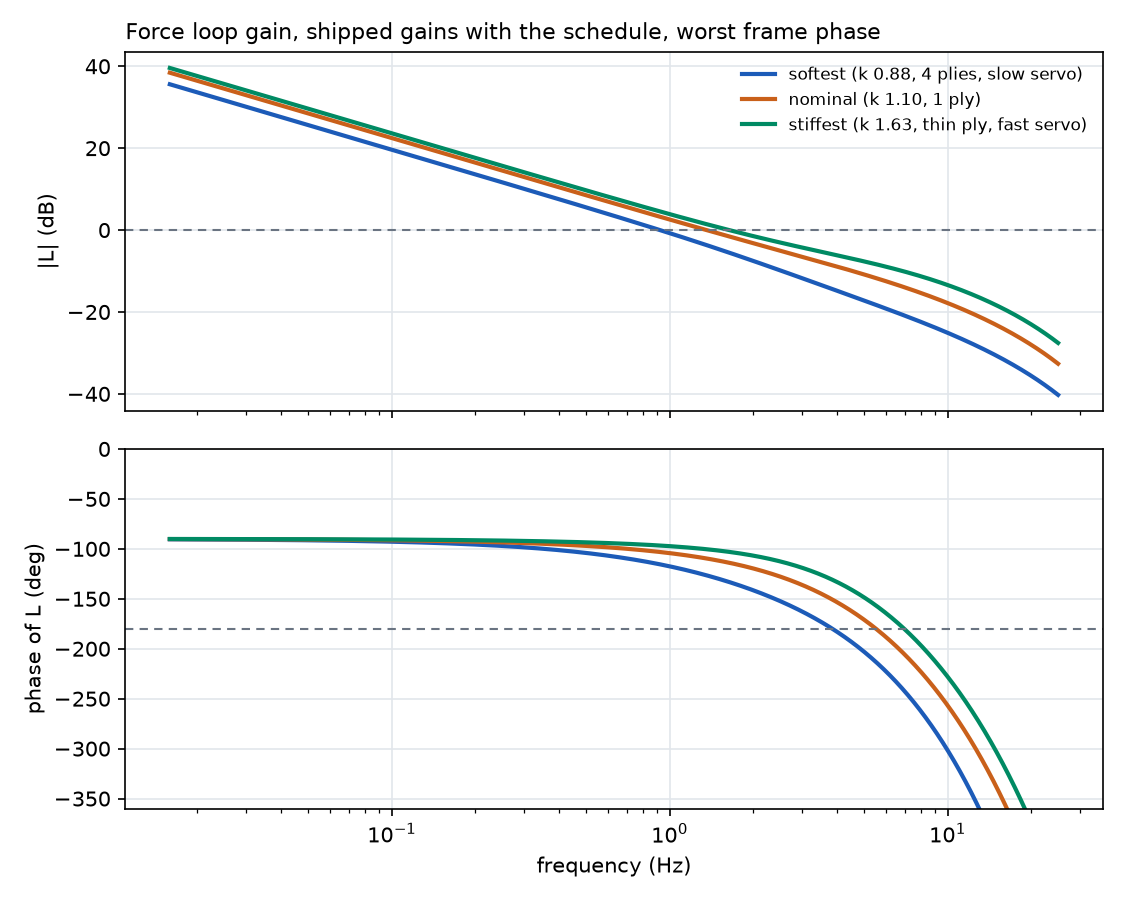
analysis/gripper/controls/results/figures/loop_bode.png
