douglaspmcgowan/cloth-feed-gripper/analysis/gripper/controls/results/figures/mc_cdf.png

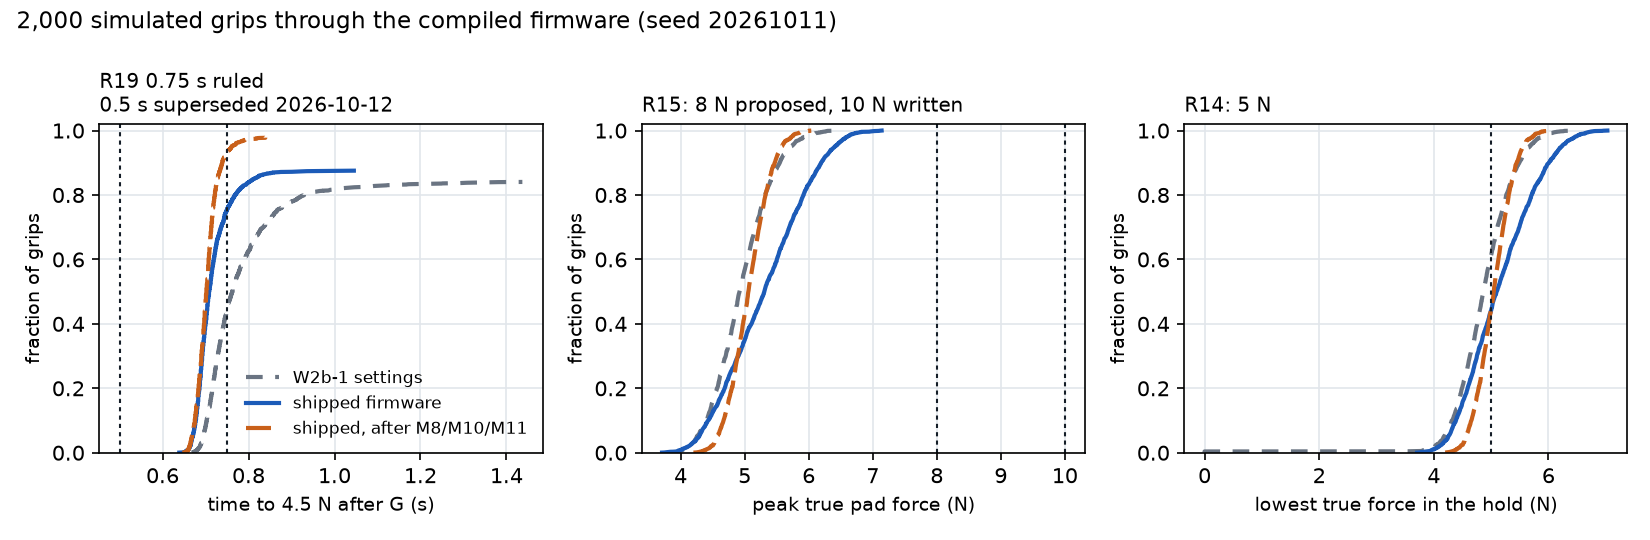
analysis/gripper/controls/results/figures/mc_cdf.png
