douglaspmcgowan/cloth-feed-gripper/analysis/gripper/firmware_sim/results/figures/controls_noise.png

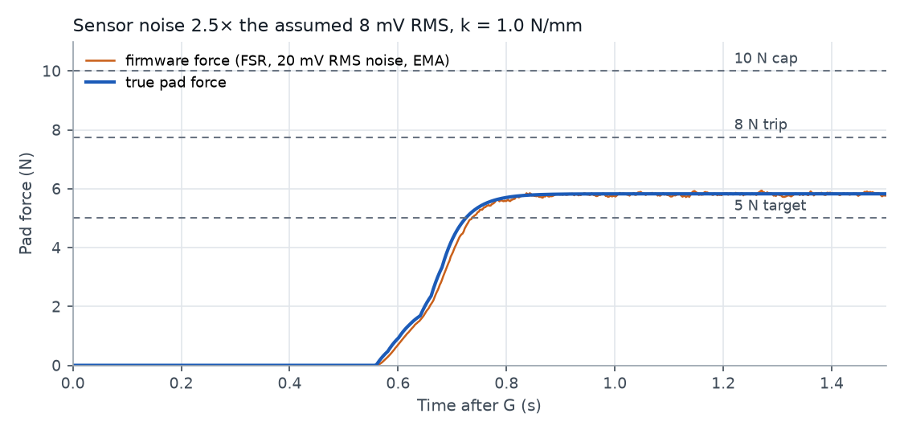
analysis/gripper/firmware_sim/results/figures/controls_noise.png
