douglaspmcgowan/cloth-feed-gripper/analysis/gripper/firmware_sim/results/figures/controls_setpoint_slip.png

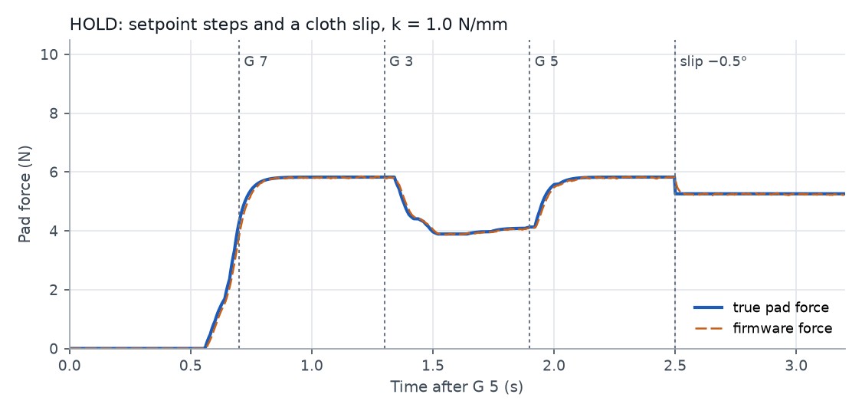
analysis/gripper/firmware_sim/results/figures/controls_setpoint_slip.png
