douglaspmcgowan/cloth-feed-gripper/analysis/gripper/firmware_sim/results/figures/controls_stiffness_sweep.png

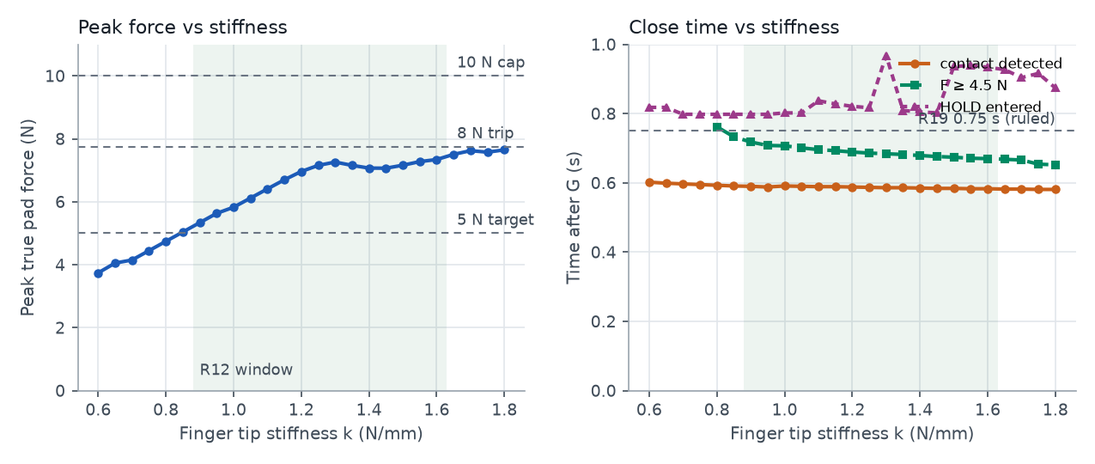
analysis/gripper/firmware_sim/results/figures/controls_stiffness_sweep.png
