douglaspmcgowan/cloth-feed-gripper/analysis/gripper/tolstack/results/figures/tol_T01-cad37.png

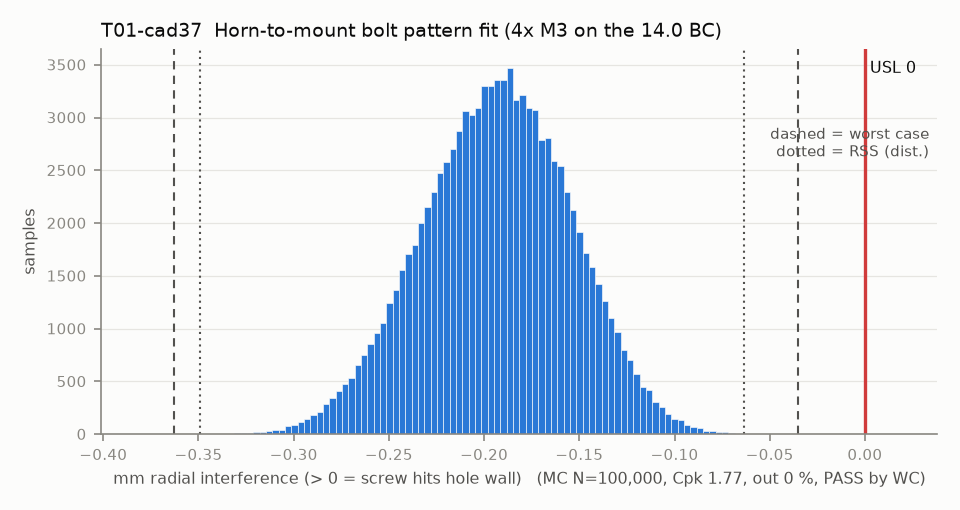
analysis/gripper/tolstack/results/figures/tol_T01-cad37.png
