douglaspmcgowan/cloth-feed-gripper/analysis/gripper/tolstack/results/figures/tol_T01-stock32.png

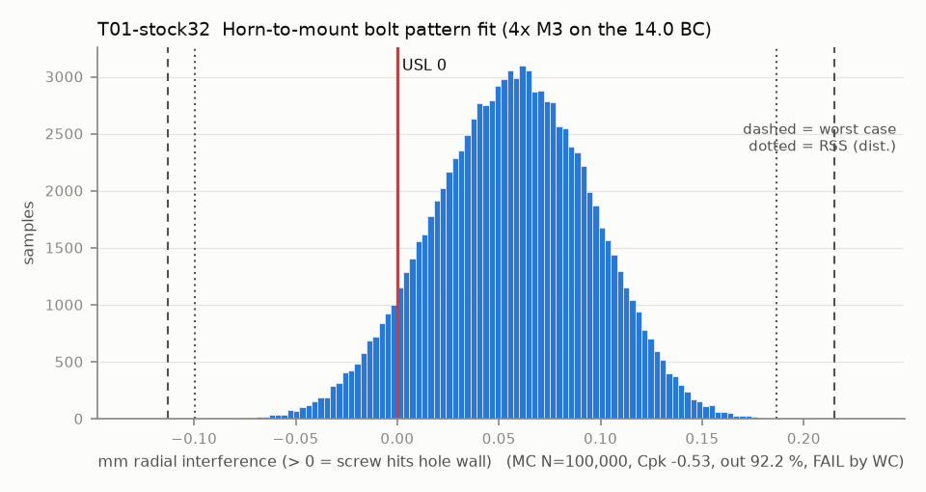
analysis/gripper/tolstack/results/figures/tol_T01-stock32.png
