douglaspmcgowan/cloth-feed-gripper/analysis/gripper/tolstack/results/figures/tol_T01.png

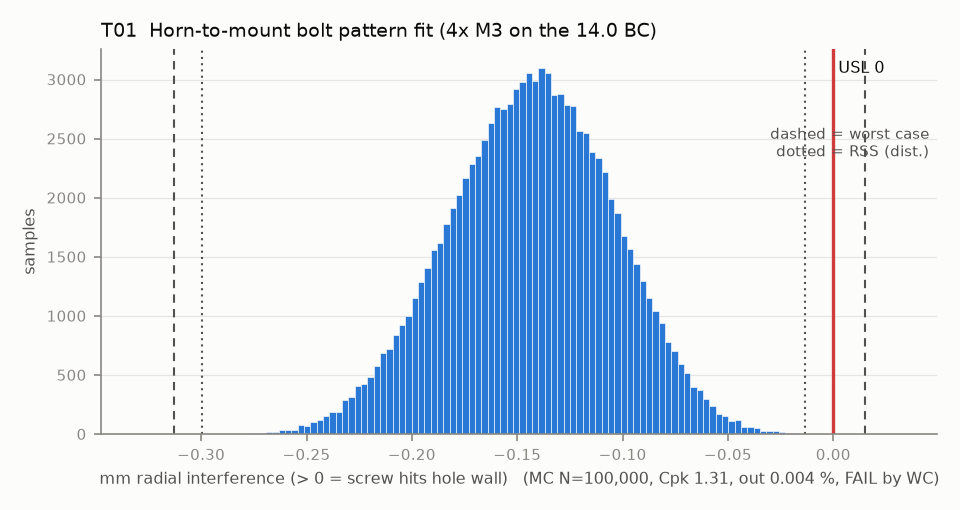
analysis/gripper/tolstack/results/figures/tol_T01.png
