douglaspmcgowan/cloth-feed-gripper/analysis/gripper/tolstack/results/figures/tol_T01H-stock60.png

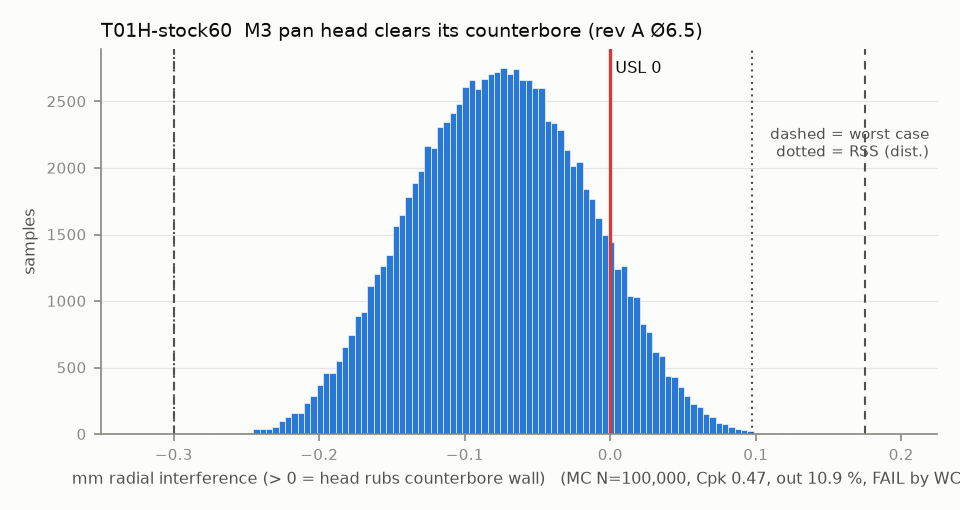
analysis/gripper/tolstack/results/figures/tol_T01H-stock60.png
