douglaspmcgowan/cloth-feed-gripper/analysis/gripper/tolstack/results/figures/tol_T04-relax40.png

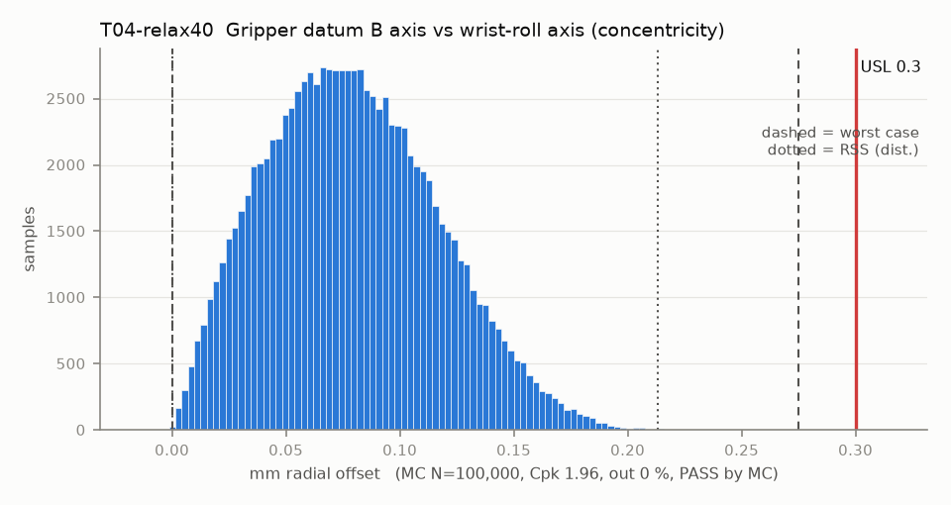
analysis/gripper/tolstack/results/figures/tol_T04-relax40.png
