douglaspmcgowan/cloth-feed-gripper/analysis/gripper/tolstack/results/figures/tol_T06-servoshaft.png

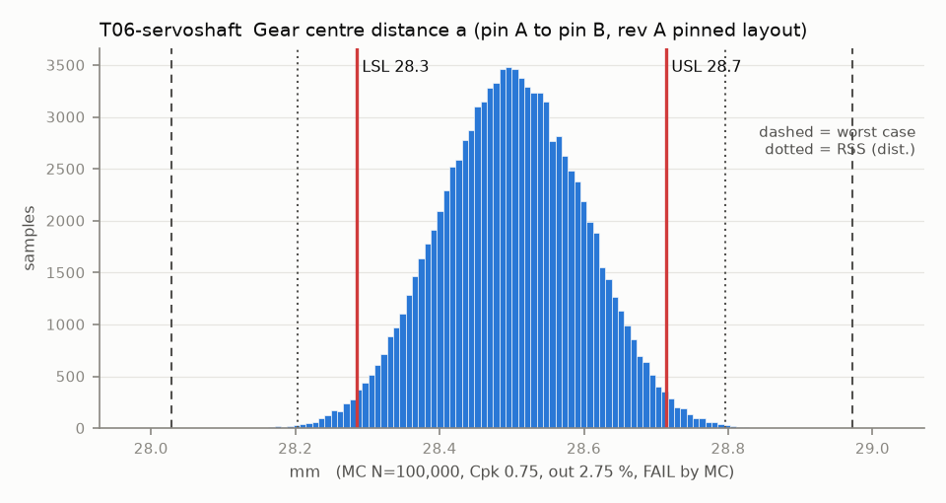
analysis/gripper/tolstack/results/figures/tol_T06-servoshaft.png
