douglaspmcgowan/cloth-feed-gripper/analysis/gripper/tolstack/results/figures/tol_T08.png

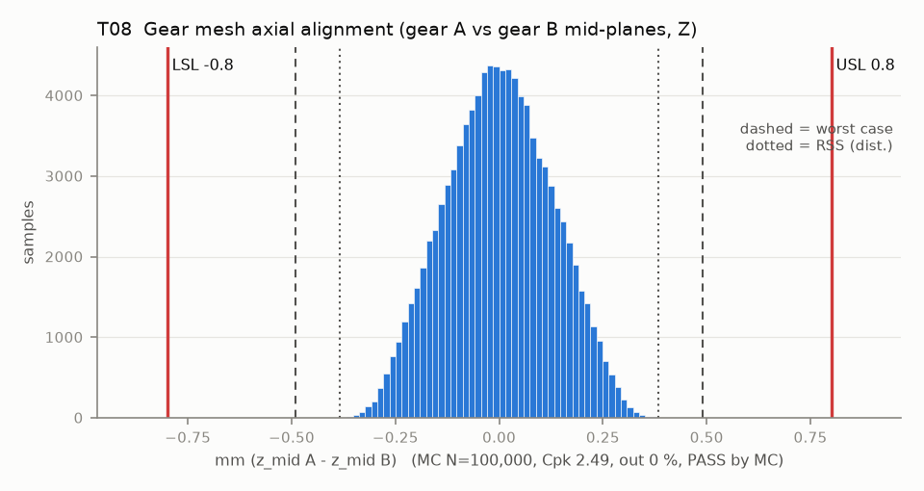
analysis/gripper/tolstack/results/figures/tol_T08.png
