douglaspmcgowan/cloth-feed-gripper/analysis/gripper/tolstack/results/figures/tol_T09.png

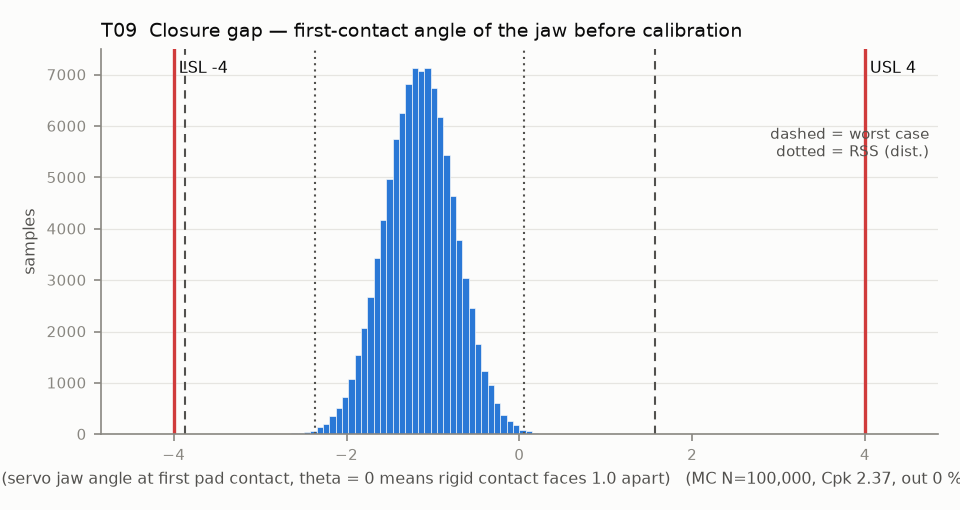
analysis/gripper/tolstack/results/figures/tol_T09.png
