douglaspmcgowan/cloth-feed-gripper/analysis/gripper/tolstack/results/figures/tol_T09P-trip7.png

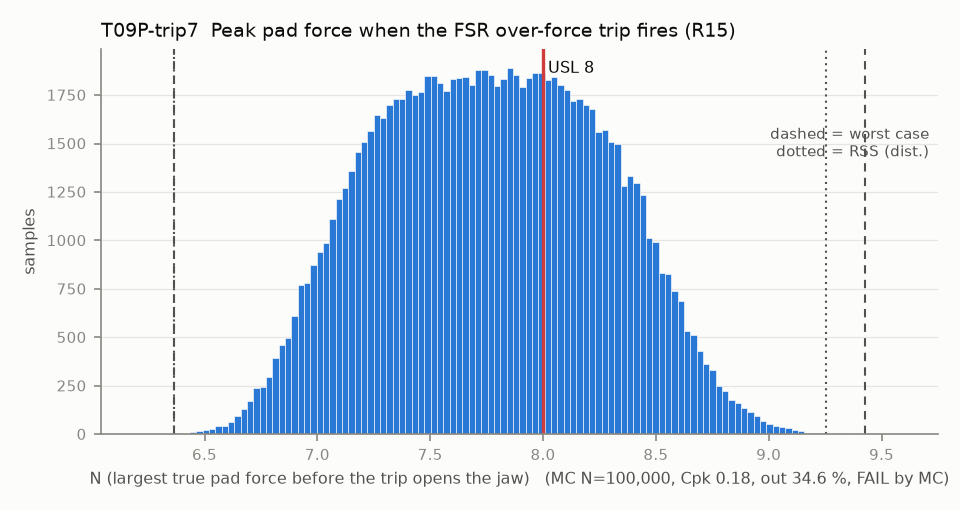
analysis/gripper/tolstack/results/figures/tol_T09P-trip7.png
