douglaspmcgowan/cloth-feed-gripper/analysis/gripper/tolstack/results/figures/tol_T09P.png

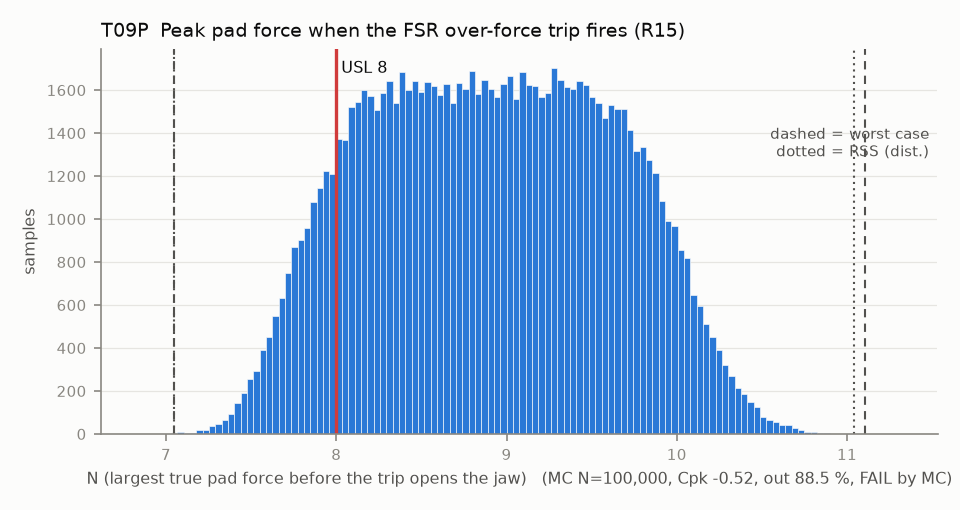
analysis/gripper/tolstack/results/figures/tol_T09P.png
