douglaspmcgowan/cloth-feed-gripper/analysis/gripper/tolstack/results/figures/tol_T10-toein.png

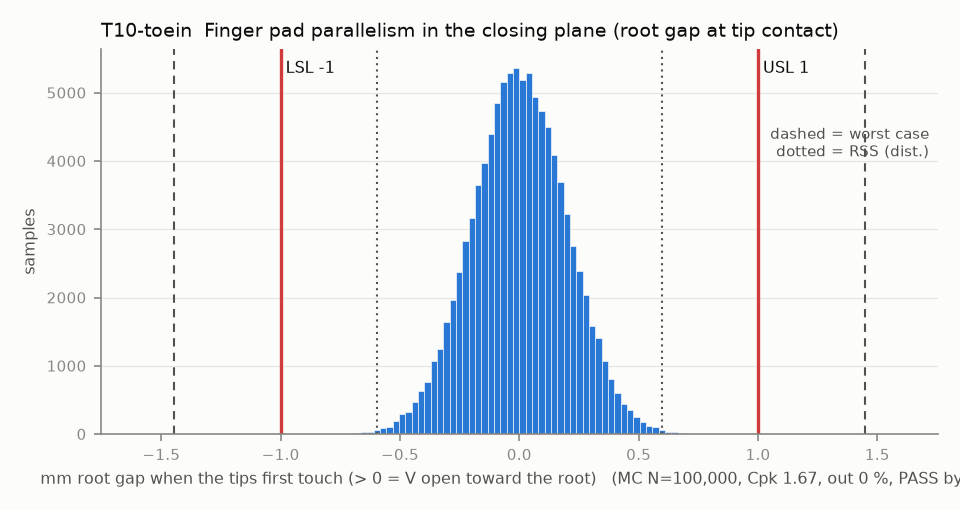
analysis/gripper/tolstack/results/figures/tol_T10-toein.png
