douglaspmcgowan/cloth-feed-gripper/analysis/gripper/tolstack/results/figures/tol_T11-stock12.png

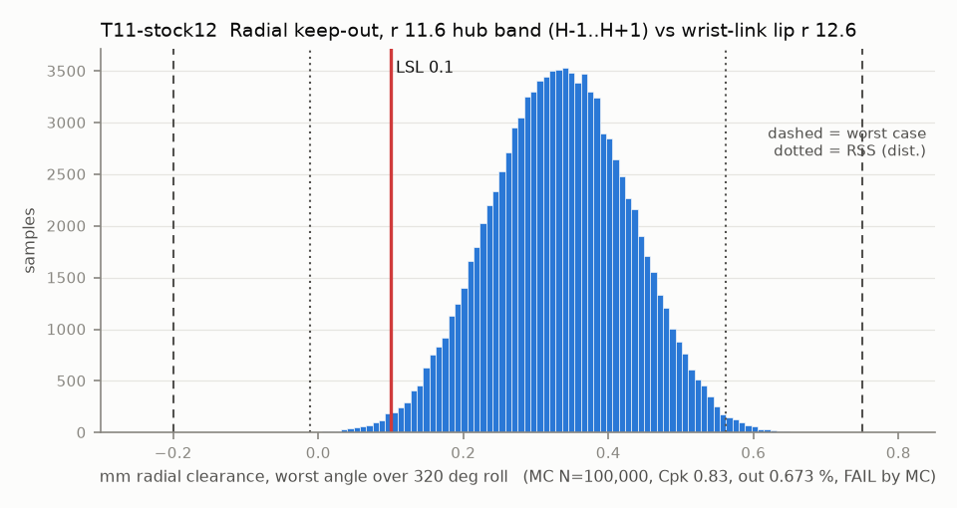
analysis/gripper/tolstack/results/figures/tol_T11-stock12.png
