douglaspmcgowan/cloth-feed-gripper/analysis/gripper/tolstack/results/figures/tol_T13-notab.png

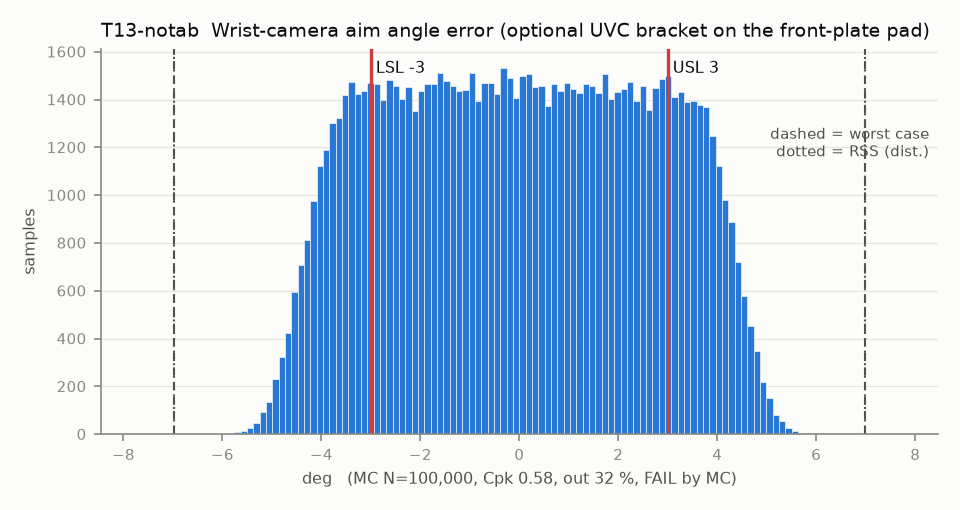
analysis/gripper/tolstack/results/figures/tol_T13-notab.png
