douglaspmcgowan/cloth-feed-gripper/analysis/gripper/tolstack/results/figures/tol_T14-boss205.png

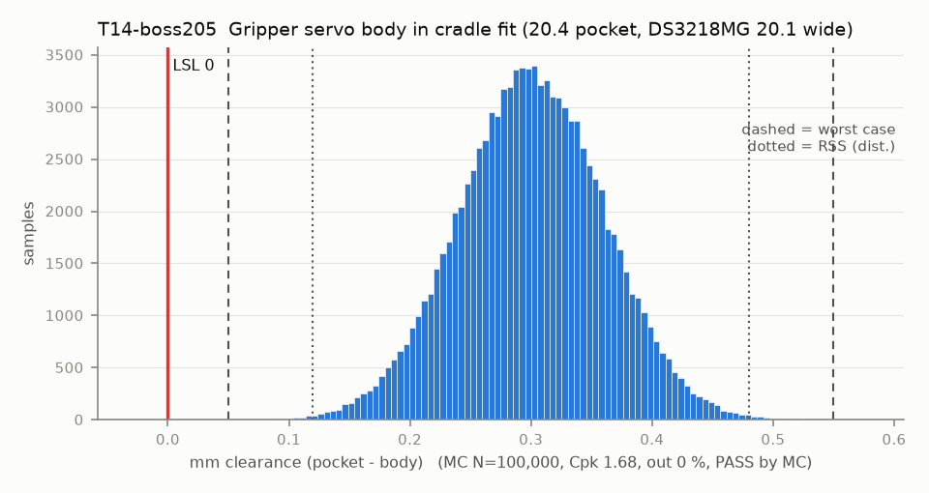
analysis/gripper/tolstack/results/figures/tol_T14-boss205.png
