douglaspmcgowan/cloth-feed-gripper/analysis/gripper/tolstack/results/figures/tol_T14-w205.png

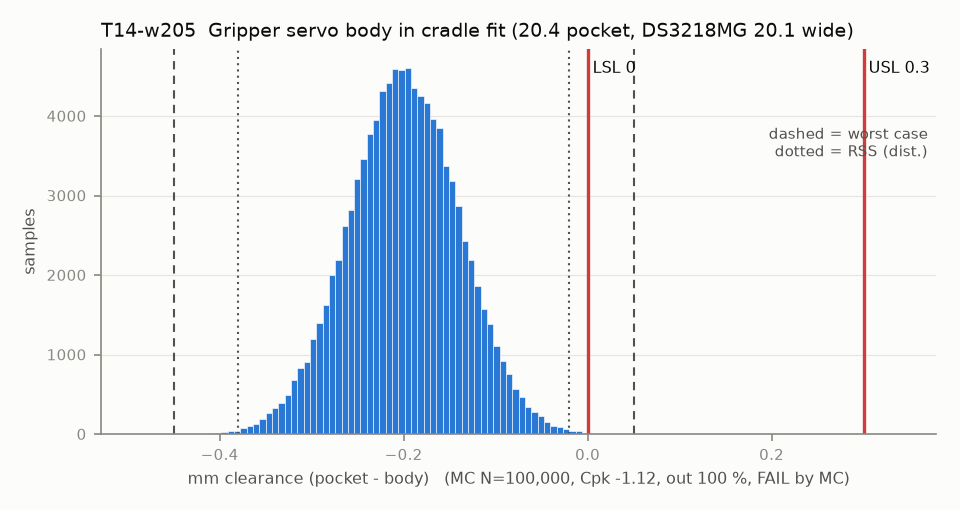
analysis/gripper/tolstack/results/figures/tol_T14-w205.png
