douglaspmcgowan/cloth-feed-gripper/analysis/gripper/tolstack/results/figures/tol_T16.png

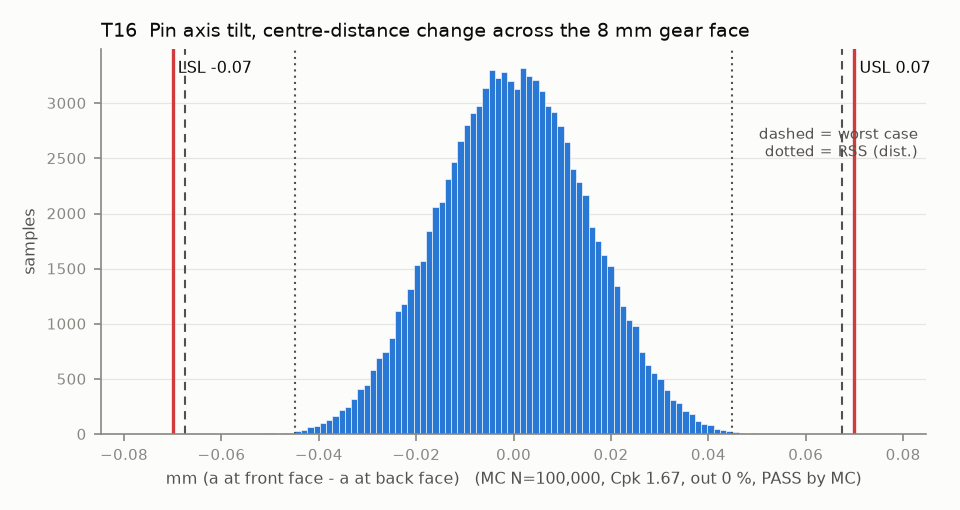
analysis/gripper/tolstack/results/figures/tol_T16.png
