douglaspmcgowan/cloth-feed-gripper/docs/gripper/RISK.md

# Cloth-feed gripper: design failure mode and effects analysis (DFMEA)

Draft 2026-10-11, concept stage, nothing built. Scope: the ME102B cloth-feed gripper on the SO-101 wrist, as drawn in `cad/gripper/`, `assembly/ASSEMBLY.md` and `firmware/gripper/`. `DESIGN-BASIS.md` (DB) wins where this note disagrees. This note ranks what is most likely to hurt the project and names the bench test that would catch each risk.

Tags: **[S1]**–**[S3]** sourced (URL and retrieval date in Sources), **[D file]** derived or quoted from that repository file (**[D SUMMARY.md]** means `analysis/gripper/tolstack/results/SUMMARY.md`, the CAD rev A tolerance results), **[A reason]** assumed. A tag on a table row covers every number in that row up to the next tag. Two requirements are open with Douglas and are **not settled here**: R19 close time (0.5 s as written, 0.75 s proposed) and R15 force cap (10 N as written, about 8 N proposed). Every row that depends on one is written twice, once per value.

## 1. Top ten risks

Ranked by RPN, ties broken by higher severity, then lower id. Occurrence O for F20, F57, F58, F59 and F61 comes from the CAD rev A baseline stack yields in `analysis/gripper/tolstack/results/SUMMARY.md` (see section 2); O for F63 is a judgement [A] checked against the hot-seat stack run. **F20's rank is conditional on the measured horn hole depth** (its O of 10 assumes the CAD 2.5 mm). F57–F59 depend on R15, and F57 is the 10 N counterpart of F58; R15 is ruled at 8 N (Douglas 2026-10-12): F58 and F59 are live, F57 is the historical 10 N row.

**The ten rows are not ten distinct risks.** F57 and F58 are one risk (the force peak when the FSR trip fires) scored at the two R15 values, and F59 is the 8 N twin of F35 (force at the jaw floor with the trip failed; F35 is RPN 105, outside the list). Once R15 is ruled, one of F57/F58 drops out (and F59 too if 10 N is kept), so the list holds eight or nine distinct risks. Severities were aligned on 2026-10-11: F35, F36, F57, F58 and F59 share the effect "force above the cap, finger folds" and all score S 7; F51 now scores S 9 because its effect names injury.

| Rank | Id | Risk | RPN | Mitigation | Bench test that detects it, and the reading that counts as a fail |
|---|---|---|---|---|---|
| 1 | F58 | R15 = 8 N ruled: peak pad force at the FSR trip exceeds 8 N in 88.47 % of builds with the trip alone (T09P, trip 7.75 N, 11.53 % within) | 315 | **Applied 2026-10-16:** the jaw floor θ_c0 − 4.9° (`JAW_FLOOR_BELOW_C0_DEG`) bounds the peak whatever the trip does (T09P-floor49 PASS, 100 % within 8 N, Cpk 1.46) and adds no false trip in the firmware simulation (controls.md 6.4). No trip setting does it alone: the only trip that passes the stack, `F_TRIP_N` 5.5 with `F_TRIP_MS` 10 (T09P-trip55, Cpk 1.48 [D SUMMARY.md]), sits inside the normal hold band and false-trips grips (controls.md 6.4) | Trip-peak test (below). Fail: any peak above 8 N [A: threshold is the proposed cap] |
| 2 | F63 | PETG servo seat or ear-screw preload creeps at temperature; the servo shifts in its seat and the hot-seat dog coupling fails (T14B, rev B hot: 98.76 % yield, Cpk 0.75) | 252 | Metal compression limiters in the four ear-screw holes and the friction back-off hold (C1 and F1 in `docs/gripper/analysis/thermal.md`); re-torque check at 1 and 4 weeks [D thermal.md] | Clamped-coupon creep test (PETG seat, M3, 500 N, 50 °C, 24 h) and a thermocouple in the C3 hole (thermal.md 6). Fail: more than 50 % preload loss in 24 h [A] |
| 3 | F57 | R15 = 10 N, historical (superseded by the 8 N ruling, 2026-10-12; live row F58): peak pad force at the FSR trip exceeded 10 N in 14.02 % of builds (pre-ruling T09P run, 85.98 % within) | 245 | **Open, no firmware fix.** The stack's fix (`F_TRIP_N` 7.0, `F_TRIP_MS` 10; T09P-trip7 passed against the superseded 10 N; against the ruled 8 N it FAILs, Cpk 0.18) was declined in the firmware simulation: it falsely trips normal holds (10 of 17 window grips, 16 of 1,000 drawn) and leaves the early-contact peaks (9.62 N linear bound) unchanged [D controls.md 6.4]. Those peaks sit above the 8.4–8.9 N finger fold, so F11's finger fix and a slower approach (controls.md 4.4, O9) are the levers | Trip-peak test (below). Fail: any peak above 10 N [A: threshold is the written cap] |
| 4 | F20 | Horn screw M3×6 bottoms in the 2.5 mm horn hole, so the wrist joint never clamps (T03B: 0.00 % yield) **(conditional: O 10 holds only if the real hole is 2.5 mm deep; at 3.75 mm or more O falls to 3 and the RPN to 72)** | 240 | Measure the real horn hole depth, then pick the screw length so the tip clearance holds (depth − (L − 3.0 mm clamp − lift) ≥ 0.2 mm); at 3.5 mm deep M3×6 is MARGINAL (T03B-depth35, Cpk 1.04), so check each head seats by hand [D SUMMARY.md] | M15 (depth gauge or caliper depth rod in each horn hole) plus stack T03B. With M3×6: under 3.5 mm FAIL, 3.5–3.7 mm MARGINAL (hand-check every head seats), 3.75 mm or more PASS [D `analysis/gripper/tolstack/results/sweep_T03B_horn_hole_depth.md`]. Under 3.5 mm, drill and re-tap the holes to at least 3.75 mm; M3×5 or a washer does not help, because thread engagement then fails (T03-m3x5, 23.15 %) [D SUMMARY.md] |
| 5 | F64 | Pinch or entrapment at the closing fingers or in the exposed gear mesh (S 9: the mesh carries up to 147 N at stall) | 216 | Cover plate or finger guard over the gear sides; arm unpowered whenever someone reaches in; label the cell [A] | Probe test with the arm unpowered. Fail: a 6 mm probe reaches the mesh [A] |
| 6 | F61 | Dog coupling: the as-drawn M3 dogs bind in 59.32 % of builds (T14B, 40.68 % yield); side load on the servo bearing and pin A | 216 | B40: Ø9 boss location, hardened shoulder dogs in Ø6 steel inserts, and the 3.4 mm slots; T14B-boss34 is MARGINAL at Cpk 1.10, 99.94 % yield [D SUMMARY.md]. The hot-seat case still needs a coupon | Coupon item 8 plus a fitted-servo turn through −11°…+20°. Fail: binding, insert movement, or lash beyond ±1.7° [A; T14B shoulder/slot geometry] |
| 7 | F28 | FSR span error: the force reads wrong, so the 8 N trip and the 10 N cap rest on a false number | 200 | Run `CALF <N>` with a known weight at bring-up; keep span limits 0.5–2.0 [D config.h] | M11 (known weights 0.5–10 N on the puck, log `analogRead`). Fail: reading off the weight by more than 0.5 N at 5 N (the force band `F_BAND_N` [D config.h]) |
| 8 | F06 | Pressed 3 mm pin walks out of its plate (2.5 mm of press fit per plate, nothing else holds it) | 192 | Add a pull-out coupon, then add axial retention (CA bead or a captured end) [A: no retention in the CAD today] | Coupon item 7 of tolerance_stacks.md (Coupon plan), extended with a pin pull test. Fail: pin moves under a 10 N hand pull [A: no sourced axial load] |
| 9 | F59 | R15 = 8 N ruled: force at the jaw floor with the trip failed exceeds 8 N in 55.09 % of builds (T09F, `results/T09F.md`, 44.91 % within) | 189 | **Applied 2026-10-16:** the floor relative to the calibrated contact is θ_c0 − 4.9° (`JAW_FLOOR_BELOW_C0_DEG`, was 6.2° for 10 N since round 2): T09F-relfloor8 PASS, Cpk 1.46; T09H unchanged (MARGINAL, Cpk 1.28) [D SUMMARY.md; controls.md 6.4] | Debug build with the FSR trip disabled; close on the M10 finger and read the M11 scale. Fail: force above 8 N (10 N for F35) |
| 10 | F51 | Pad or finger hits the needle or presser foot: broken needle, damaged finger, possible injury (S raised from 8 to 9 because the effect names injury, the scale's 9–10 band) | 180 | Dry-run all poses without cloth; machine off with the needle raised during tests; add a software keep-out [D DESIGN-BASIS.md R24] | Dry-run every pose with the needle raised. Fail: any pose closer than 20 mm to the foot [D DESIGN-BASIS.md 6] |

Just outside the top ten, RPN 180 down to 140: F29 FSR creep (180), F11 finger fold at 10 N (168), F47 FSR puck bonding, F13 TPU finger fatigue, F65 moisture swell and F66 lint in the mesh (150 each), F04 knuckle end play, F50 table hit and F36 squeeze cap with a 0.5 N margin (140 each). Two rows now score S ≥ 9 (F51, F64), so the action rule applies to them on severity alone. F28 (span error) feeds F36, F11 and the R15 rows F57–F59; those rows together are the R15 question.

### Trip-peak test (detects F57 and F58)

Not in DB §10 yet; this is the procedure until it is added there.
1. Put an independent force sensor between the pads: a button load cell no thicker than the cloth gap, read by its own amplifier and logger at 1 kHz or faster, or a mechanical peak-hold force gauge. Do not use the gripper's own FSR to judge the peak: the FSR is the instrument in doubt (F28) [A: the trip window is 29.5 ms as shipped and 19.5 ms with `F_TRIP_MS` 10 (`trip_window_s` in `analysis/gripper/tolstack/stacks/basis.yaml` and the T09P trip variants [D]), so 1 kHz gives at least 19 samples inside it; a kitchen scale or the M11 static set-up cannot catch a peak that short].
2. Use the softest and the stiffest finger from the M10 set, one at a time.
3. Run the firmware's normal close (the `G` grip command at the shipped speeds), with the trip set as the firmware will ship. Then repeat with a test build that holds the squeeze on, so the trip has to fire.
4. Close 10 times per finger and record each peak.
5. Fail: any peak above the cap, 8 N as ruled (10 N counted for the historical rows). Report both counts.

**Terms.** FSR: the force-sensing resistor under each pad. TCP: the tool centre point the arm is programmed to. Cpk, yield and worst case are defined in `docs/gripper/analysis/tolerance_stacks.md` (*Words used here*).

## 2. How to read this

Method: a design FMEA, the usual approach for ranking what could fail and how it would be caught. Public description: ASQ, https://asq.org/quality-resources/fmea [S2] (the page returned HTTP 403 to my fetch on 2026-10-11, so it was not read); Wikipedia's FMEA article [S1] was read instead. The standards behind the method are AIAG-VDA (2019) and IEC 60812; their text is not reproduced here. [S1] notes that AIAG-VDA replaced the RPN with an "action priority" table. This note keeps the plain RPN because it is easy to audit by hand, and adds an S ≥ 9 rule so a rare but severe risk is not hidden by a low product.

Each failure mode gets three scores from 1 to 10. **RPN = S × O × D**, so it runs 1 to 1000.

**Severity S: how bad is the effect.**

| S | Meaning (own wording) |
|---|---|
| 1–2 | Nobody notices |
| 3–4 | Small nuisance; the cycle still completes, or a retry fixes it |
| 5–6 | A cycle or seam is lost, or a cheap part is damaged and replaced at the bench |
| 7–8 | Arm or gripper damaged and rebuilt, a needle or machine strike, or force far above the cap |
| 9–10 | Injury risk, or loss of safe control with no warning |

**Occurrence O: how likely is the cause.**

| O | Meaning | Tolerance-stack rows: share of builds out of spec (100 % minus the "Yield (MC)" column) [D analysis/gripper/tolstack/results/SUMMARY.md] |
|---|---|---|
| 1–2 | Not credible in the life of the part | Not used: stack inputs are assumed, so a passing stack is never scored below 3 [A] |
| 3 | Rare; roughly 1 in 10,000 cycles or builds | Passes with Cpk ≥ 1.33 |
| 4 | Roughly 1 in 1,000 | Under 0.01 % out |
| 5 | Roughly 1 in 100 | 0.1 % to 1 % out |
| 6 | Roughly 1 in 50 | 1 % to 5 % out |
| 7 | Roughly 1 in 10 | 5 % to 20 % out |
| 8 | Roughly 1 in 4 | 20 % to 50 % out |
| 9 | Most builds or cycles | Over 50 % out |
| 10 | Certain as drawn | About 100 % out |

The scale has no bucket for 0.01 % to 0.1 % out; such a stack, with Cpk under 1.33, is scored 5 [A: rounded up]. Non-stack occurrence scores are judgement [A] unless the row cites a simulation or test.

**Detection D: how likely the current control is to catch it before it hurts.** High D means it slips through.

| D | Meaning |
|---|---|
| 1–2 | Caught automatically or at once (alarm, boot check, build step that cannot be skipped) |
| 3–4 | Caught by a routine bench test already in DB §10 or the firmware gates |
| 5–6 | Caught only by a special or long test that is not yet planned |
| 7–8 | Caught only by in-use symptoms |
| 9–10 | Not detectable with current means |

**Action rule.** RPN ≥ 100, or S ≥ 9, gets an action. Rows under 100 are watched and rescored after the bench data arrives.

**Where O comes from.** Every stack-driven O now comes from the CAD rev A baseline stack's "Yield (MC)" in `analysis/gripper/tolstack/results/SUMMARY.md` (m 1.5 z 19 gear, a 28.5 mm, pinned layout, recess Ø19.51, holes Ø3.6; N = 100,000 samples, seed 20260922) [D SUMMARY.md]. The earlier provisional marker is gone. Fix variants (the "option" rows of SUMMARY.md) are quoted in the Action column and never set O. `params.json` `wrist_interface` still lists a Ø19.45 pilot and a Ø24.0 hub (lines 488–489, checked 2026-10-11 [D cad/gripper/params.json]); the rev A stacks use Ø19.51 and a hub band at r 11.6 mm, so F21 and F23 name the file as out of step. The stacks are inputs-assumed (FDM scatter is assumed until the coupon is printed), so a passing stack is never scored below 3 [A].

## 3. DFMEA table

Units: N, mm, N·m, A, V, degrees. Jaw angle θ: 0 means pads 1 mm apart, negative is overtravel into the grip [D DESIGN-BASIS.md R18]. "Rigid B" means finger B's FSR backing is treated as rigid (DB D7).

| ID | Req | Subsystem | Function | Failure mode | Effect | Cause | Current control | S | O | D | RPN | Action | Owner artifact |
|---|---|---|---|---|---|---|---|---|---|---|---|---|---|
| F01 | R13, R20 | Mechanical: gears | Carry servo torque 1:1 to finger B | Tooth root fractures at a jam or stall | Finger B loses drive; jaw runs one-sided; grip lost | Finger B snags in the 120 °/s pre-close: peak 2.69 N·m, 3.60 N·m at 2.6× rotor inertia; stall 2.09 N·m at 6.65 V [D dyno.md 0; torque_and_actuator.md]. PA6-CF safety factor 1.04 at 2.6× inertia; PETG best case 0.90 [D dyno.md 0] | PA6-CF m 1.5 z 19 b 8 [D gears.md 0]; over-current trip 1.8 A for 100 ms [D config.h]; no hard stop on knuckle B [D gears.md 1] | 7 | 4 | 4 | 112 | Run M17 step-load. Measure rotor inertia. Do not raise pre-close speed to meet R19 at 0.5 s (240 °/s raises the jam shock [D controls.md 7 O1]). Fall back to the robust PA6-CF m 1.5 z 19 x 0.25 b 10 (minimum safety factor 1.18) if 0.7 mm of centre distance fits [D dyno.md 0] | `cad/gripper/params.json` (gear); `docs/gripper/analysis/gears.md` |
| F02 | R13 | Mechanical: gears | Keep mesh teeth parallel | Axis tilt edge-loads the teeth; wear and early fatigue | Backlash grows; tooth chipping; noise | Pin and bore tilt across the 8 mm gear face. Window ±0.07 mm: stack T16 passes, 100 % yield, Cpk 1.67, worst case −0.067…+0.067 mm; skipping the line-reaming (T16-noream) fails at 96.83 % yield, Cpk 0.71 [D analysis/gripper/tolstack/results/SUMMARY.md]. Edge-load factor K_Hβ 3.4 at the hold [D gears.md 0] | Bronze sleeves, pinned layout, line-reamed plates [D ASSEMBLY.md steps 1, 13, 14] | 6 | 3 | 5 | 90 | Coupon item 7–8 (pin tilt, sleeve rock) [D tolerance_stacks.md, Coupon plan]. Fail: tilt above 0.07 mm over the face. Watch; rescore after the coupon | `cad/gripper/params.json` (pins, plates); `docs/gripper/assembly/ASSEMBLY.md` steps 1, 13, 14 |
| F03 | R13 | Mechanical: gears | Hold backlash in 0.05–0.45 mm | Backlash outside the window | Too low: binding, heat. Too high: jaw lash, centre shift, force-loop chatter | Centre distance and runout scatter. Stack T07 (m 1.5 z 19, pinned layout) passes: 99.998 % yield (under 100 ppm out), Cpk 1.44, worst case −0.078…0.578 mm against 0.05–0.45 mm [D SUMMARY.md] | Pinned, bushed layout [D ASSEMBLY.md] | 5 | 3 | 4 | 60 | Dial-indicator backlash check at the horn (M17 setup). Fail: outside 0.05–0.45 mm [D SUMMARY.md T07] | `cad/gripper/params.json` (gear.backlash_jt, center_distance) |
| F04 | R13 | Mechanical: gears | Keep gear mid-planes aligned and the knuckle end play at 0.05–0.5 mm | End play outside the window: mesh walks along the 8 mm face (loose) or the knuckle binds (tight) | Half-face contact, tooth wear, noise; or a stiff pivot | Mid-plane alignment passes (T08: 100 % yield, Cpk 2.49). End play fails: T15, 89.67 % yield (10.33 % out), Cpk 0.50, worst case −0.71…1.31 mm. Cause: the front plate sits on three standoff tops that lie off the pin line, so a top-height error is extrapolated to pin B by 3.39, 2.81 and −5.2 times [D SUMMARY.md; analysis/gripper/tolstack/stacks/T15_standoff_endplay.yaml]. 0.85 mm shims, about 0.3 mm end play [D ASSEMBLY.md step 16] | Shim washers; "turns freely" check [D ASSEMBLY.md steps 12, 15, 16] | 5 | 7 | 4 | 140 | Pick the shims at assembly: feeler gauge the gap at each pin, stack shims from a 0.05 mm-step set so end play lands at 0.3 ± 0.05 mm (T15-shimselect: PASS, 100 % yield, Cpk 4.35; no CAD change, buy a shim assortment) [D SUMMARY.md]. Fail: end play outside 0.05–0.5 mm | `docs/gripper/assembly/ASSEMBLY.md` step 16; shim assortment (BOM) |
| F05 | R13 | Mechanical: gears | Set centre distance | Mesh too tight or too loose | Tight: stall and heat. Loose: lash | Chosen gear is PA6-CF m 1.5 z 19, a = 28.5 mm [D gears.md 0]. Stack T06 (rev A pinned layout) passes: 100 % yield, Cpk 2.04, worst case 28.356…28.644 mm against 28.286–28.714 mm. The pre-rev-A layout (knuckle A on the servo shaft) failed at 97.25 % yield, Cpk 0.75 [D SUMMARY.md] | Line-reamed pin holes [D ASSEMBLY.md step 1] | 7 | 3 | 3 | 63 | Watch. Check the centre distance with calipers on the reamed pair at assembly (coupon item 9). Fail: outside 28.286–28.714 mm [D SUMMARY.md T06] | `cad/gripper/params.json` (gear.center_distance); `ASSEMBLY.md` step 1 |
| F06 | R25 | Mechanical: knuckle pins | Locate pivots A and B | Pressed pin works loose from the plate | Pivot loses a plate; finger collapses; mesh unloads | Only 2.5 mm of press fit per plate (3.0 pin in 2.9 CAD bore, 1.16 mm³ interference) holds each pin [D ASSEMBLY.md step 5 note]. PETG creeps [A: general polymer behaviour, no data here] | "Starts into both bores by hand" check [D ASSEMBLY.md step 1] | 8 | 4 | 6 | 192 | Pull-out coupon (see top ten). Add axial retention. Rescore after the coupon | `cad/gripper/params.json` (pin features); `ASSEMBLY.md` step 5 |
| F07 | R25 | Mechanical: knuckle sleeves | Give each knuckle a 0.02 mm running fit | Bronze sleeve spins or walks in the printed bore | Knuckle cocks on the pin (tilt window ±0.07 mm, F02); wear debris | Sleeve pressed into a printed bore with an assumed interference [A: no press-fit data] | Press on the bench first [D ASSEMBLY.md step 13] | 6 | 4 | 5 | 120 | Coupon item 8 [D tolerance_stacks.md, Coupon plan]. Fail: sleeve rotates by hand or rocks on the pin more than 0.02 mm [A]. Bond with a drop of CA | `ASSEMBLY.md` step 13; `cad/gripper/params.json` (knuckle.sleeve_od) |
| F08 | R14 | Mechanical: knuckles | Hold fingertips in one plane | Fingertips mismatch out of plane | Pad contact narrows; FSR sees off-centre load; cloth skews | Pin perpendicularity and wobble. Window ±2.0 mm at the tip; stack T10B passes: 100 % yield, Cpk 1.95, worst case ±2.465 mm (out of window, but the Monte Carlo band is ±1.04 mm) [D SUMMARY.md] | Sleeves in both knuckles, finger pegs [D ASSEMBLY.md] | 5 | 3 | 4 | 60 | Check pad alignment with a flat block at assembly step 26. Fail: tip mismatch above 2.0 mm [D SUMMARY.md T10B] | `cad/gripper/params.json` (knuckle, pins); `ASSEMBLY.md` step 26 |
| F09 | R18 | Mechanical: dog coupling | Drive knuckle A from the horn | Dog pin hits the end of its arc slot, or lash widens the closed gap | Hard stop loads the mesh; angle error at touch | Slot reaches −16° to +25° against a −11° to +20° range [D ASSEMBLY.md Risks], so 8.6° of margin to the −7.4° floor [D config.h; arithmetic here]. 25T spline gives 14.4° steps; slot 3.14 mm for a 3.0 mm pin [D ASSEMBLY.md Risks]. Lash is set by the dog slot clearance (`dog_lash` in `analysis/gripper/tolstack/stacks/basis.yaml`) [D]. Stack T09 passes: first-contact angle −3.875…1.566° inside ±4°, 100 % yield, Cpk 2.37 [D SUMMARY.md]. The shaft-to-pin offset at the dogs is a separate, failing stack: F61 | Force-close absorbs lash; step 26 range run | 6 | 3 | 3 | 54 | Run the jaw −11° to +20° at step 26. Fail: any rub or stop contact inside the range | `cad/gripper/params.json` (servo.dog_r, knuckle.dog_slot_w) |
| F10 | R21 | Mechanical: servo drive | Hold the horn on the 25T spline | Horn slips or loosens on the spline | θ zero drifts mid-cycle; calibration is stale | Horn centre screw is in neither the BOM nor the CAD [D ASSEMBLY.md step 8 note]; spline play | R21 recalibrates each boot [D DESIGN-BASIS.md R21] | 6 | 4 | 5 | 120 | Add the screw to the BOM. Check horn rock on a dial indicator (shaft play, tolerance_stacks.md, Coupon plan). Re-run CALIBRATE after any bump | `ASSEMBLY.md` step 8; BOM |
| F11 | R15, R12 | Mechanical: TPU fingers | Hold cloth without folding. **R15 = 10 N as written** | Finger back flank buckles at 8.4–8.9 N, below the cap | Grip drops; cloth released; finger stays bent | Back-flank panel between root and first rib: fold at 8.88 N bare, 8.41 N with the PLA nail (E 56 MPa). Sim contact 10° early peaks at 9.62 N on the linear stiff bound (8.20 N max on the drawn plant); FSR reading half holds 9.66 N on the stiffest finger [D finger.md 5.2; controls.md 4.4, 7; `fw_sim.json`] | 8 N FSR trip in 20 ms; 7.5 N soft limit [D config.h]. Margin to fold only 0.4–0.9 N | 7 | 6 | 4 | 168 | Stiffen the back flank, rerun the fold check [D finger.md 1]. Rule R15 at ≤ 8 N, or fix the finger. M10 to 10 N. See Open question 1 | finger CAD; `docs/gripper/analysis/finger.md` |
| F12 | R15 | Mechanical: TPU fingers | Same as F11. **R15 ≈ 8 N proposed** | Same fold, now sitting just above the cap | Grip drops if an overshoot goes past the cap | The fold at 8.41–8.88 N is 0.4–0.9 N above an 8 N cap, so the margin is thin. No trip setting both passes at 8 N and stays clear of the hold band (F58) | Same as F11, once the trip is re-set | 7 | 4 | 4 | 112 | Same finger fix plus M10 to 8.9 N. Decide the trip and soft limit after Douglas rules R15 | finger CAD; `finger.md`; `firmware/gripper/config.h` |
| F13 | R25 | Mechanical: TPU fingers | Survive 1e5 grips (R25) | Rib corner cracks | Finger replaced; mid-seam failure | Hot spot at the 0.27 knockdown: 4.3e3 grips, set by 1e3 cap events (10 N) and tip collisions. At 0.5 knockdown 3.1e6 passes [D dyno.md 0]. Sharp rib corners are singular [D finger.md 7] | None beyond the FEA; 0.5 mm fillets suggested [D finger.md 7] | 5 | 5 | 6 | 150 | Fillet ribs; limit cap events; treat the finger as a consumable; run M10 after 1e3 cap cycles | finger CAD; `finger.md` |
| F14 | R12 | Mechanical: TPU fingers | Tip stiffness 0.88–1.63 N/mm (R12) | Finger outside the stiffness window | Too soft: cap stops the grip short of 5 N (4.0 N at 0.60 N/mm). Too stiff: higher force per degree | Printed TPU modulus varies: 67 and 56 MPa (Ultimaker TDS) against 26 and 9.8 MPa (other vendors) [D finger.md 2]. Recommended design 1.07–1.29 N/mm with the D7 parts [D finger.md 1]; CAD section at L 45 gives 2.38–2.85 [D finger.md 1] | Window check by FEA only | 6 | 5 | 3 | 90 | M10 on every printed finger. Fail: k below 0.88 or above 1.63 N/mm. Print the recommended section, not the CAD one | `finger.md`; DB M10 |
| F15 | R14 | Mechanical: finger roots | Locate each finger on its root block | Finger floats on the root | Pad gap and parallelism drift: the pads touch with a V-shaped gap | Stack T10 (finger on two pegs plus M2, rev A) fails: 96.42 % yield (3.58 % out), Cpk 0.60, worst case −0.805…2.091 mm against ±1.0 mm at the root when the tips first touch. Biggest term is pad face tilt (25 % of variance) on top of a 0.64 mm design V [D SUMMARY.md; analysis/gripper/tolstack/stacks/T10_pad_parallelism.yaml]. BOM pegs are 24 mm against 26.0 mm in the CAD (F48) [D ASSEMBLY.md Notes] | Two Ø2 dowels plus an M2 bolt [D ASSEMBLY.md steps 19, 21] | 5 | 6 | 4 | 120 | Toe the rigid contact faces in by 0.44° so they are parallel at first contact, not at θ = 0 (T10-toein: PASS, 100 % yield, Cpk 1.67) [D SUMMARY.md]. Feeler-check root gap at touch. Fail: gap outside ±1.0 mm. Fix the peg length in the BOM | `cad/gripper/params.json` (finger contact faces); `ASSEMBLY.md` BOM (pegs) |
| F16 | R25 | Mechanical: nail and backing | Hold the PLA nail and the FSR backing on the pads | Nail or backing debonds | Nail lifts at the cloth edge; FSR stack shifts | CA glue on TPU; table-touch loads; glue creep [A: no peel data] | Bond with jaw open [D ASSEMBLY.md steps 22, 25] | 5 | 4 | 5 | 100 | Peel test on a coupon. Consider a mechanical key or a second bond line | `ASSEMBLY.md` steps 22, 25 |
| F17 | none (derived from the housing) | Mechanical: housing | Carry the inserts and screws | PETG cracks at an insert or screw boss | Deck or plate comes loose | Printed holes run about 0.25 mm small, so insert bore equals insert OD with no melt-in interference [D ASSEMBLY.md step 2 note; tolerance_stacks.md, Process basis]. 220 °C iron near PETG's melt point | Insert flush check [D ASSEMBLY.md step 2] | 6 | 4 | 4 | 96 | Test inserts in the M12 coupon. Fail: insert pulls out below the load a wrist roll needs [A] | `ASSEMBLY.md` step 2; `cad/gripper/README.md` |
| F18 | none (derived from the servo mount) | Mechanical: housing | Seat the servo in the cradle | Servo too tight or too loose | Servo shaft off-centre; vibration | Stack T14 (20.4 mm pocket, DS3218MG listed 20.1 mm wide, not the CAD 20.0) fails: 95.16 % yield (4.84 % out), Cpk 0.55, clearance −0.050…0.450 mm against 0–0.30 mm; pocket width is 69 % of the variance [D SUMMARY.md] | Four servo-ear screws and nuts [D ASSEMBLY.md step 11] | 4 | 6 | 3 | 72 | Locate the servo by its output boss (the F61 fix), then open the pocket to the largest measured case width + 0.40 mm: 20.5 mm for a 20.1 mm servo, 20.9 mm for a 20.5 mm one (PASS, 100 % yield, Cpk 1.68 for either); measure three servos first, because the sources give 20.0, 20.1 and 20.5 mm [D SUMMARY.md]. Drop-in test with the real servo (coupon item 5) [D tolerance_stacks.md, Coupon plan] | `cad/gripper/params.json` (housing.cradle_pocket_clear) |
| F19 | none: no assembly-access requirement | Mechanical: housing | Let the deck screws be fitted | Deck screws 1–3 cannot be fitted as drawn | Gripper built with fewer screws; weak mount, or a redesign | Housing blocks the driver: 1.3 mm free length for screws 1 and 2, 9.8 mm for screw 3, against 40 mm wanted [D ASSEMBLY.md Findings, Driver access] | Found at the assembly step [D ASSEMBLY.md step 7] | 5 | 10 | 2 | 100 | CAD change so every screw has driver access (outside this file) | `cad/gripper/params.json` (housing.deck_screws) |
| F20 | R22 | Mechanical: wrist screws | Clamp the gripper to the roll horn | M3×6 screw bottoms before the plate clamps | Wrist joint loose; gripper rocks or loosens under roll | CAD hole depth 2.5 mm, clamp 3.0 mm: bottoms by 0.5 mm. Stack T03B: 0.00 % yield, Cpk −1.55, worst case −1.015…0.215 mm against a 0.2 mm tip clearance. M3×5 clears the floor (T03B-m3x5 MARGINAL, 99.916 % yield, Cpk 1.04) but engages too little thread (T03-m3x5 FAIL, 23.15 % yield, Cpk −0.27) [D SUMMARY.md]. The stock arm uses M3×6, which suggests the real hole is deeper [D tolerance_stacks.md, CAD rev B row 8]. **O 10 is conditional on the measured horn hole depth**: it holds only if the hole is the CAD 2.5 mm. At 3.75 mm or deeper T03B passes, O falls to 3 and the RPN to 72 (8 × 3 × 3) | "Stop if a screw bottoms" [D ASSEMBLY.md step 4] | 8 | 10 | 3 | 240 | Measure the horn hole depth first (M15), before buying screws. At 3.5 mm deep M3×6 is MARGINAL (T03B-depth35, Cpk 1.04; T03-depth35 engagement Cpk 2.46), so run each screw in by hand and check the head seats before torquing [D SUMMARY.md]. O falls if the real hole is deeper | `cad/gripper/params.json` (wrist_interface.horn_hole_depth); DB M15 |
| F21 | R22 | Mechanical: wrist pilot | Centre the gripper on the Ø19.2 horn | Pilot recess too tight, or too loose | Too tight: will not slide on. Too loose: axis offset up to 0.55 mm | Stack T02 (Ø19.2 horn in the printed Ø19.51 recess, rev A) is MARGINAL: 99.976 % yield (240 ppm out), Cpk 1.16, clearance 0.000…0.300 mm against 0.02–0.30 mm; the printed recess diameter is 80 % of the variance [D SUMMARY.md]. `params.json` line 488 still lists Ø19.45 (checked 2026-10-11) [D cad/gripper/params.json] | Seats on the real horn at step 3 [D ASSEMBLY.md step 3] | 5 | 5 | 3 | 75 | Open the recess to 19.56 mm and accept up to 0.40 mm diametral clearance (T02-relax40: PASS, Cpk 1.61; concentricity still inside budget, T04-relax40 PASS), or print the coupon and size the recess from the measured hole [D SUMMARY.md]. Coupon item 2 on the real horn (M12, M15). Move `params.json` to the rev A value | `cad/gripper/params.json` (wrist_mount.recess_d_cad) |
| F22 | R22 | Mechanical: wrist screws | Pass M3 screws and heads | Clearance hole or counterbore prints too small | Screw will not pass; head fouls | Rev A holes Ø3.6: stack T01 is MARGINAL, 99.996 % yield (under 100 ppm out), Cpk 1.31, hole position is 81 % of the variance. Counterbore Ø6.5: T01H passes, 100 % yield, Cpk 2.02. Stock Ø3.2 holes fail (T01-stock32: 7.81 % yield) and the stock Ø6.0 counterbore fails (T01H-stock60: 89.11 % yield) [D SUMMARY.md] | Fit check at steps 3, 4 | 4 | 4 | 2 | 32 | Open the 4 mount holes to 3.7 mm; the recess locates the mount so larger holes cost nothing (T01-cad37: PASS, Cpk 1.77) [D SUMMARY.md]. Confirm the printed sizes on coupon item 1 | `cad/gripper/params.json` (wrist_mount.clearance_hole_cad) |
| F23 | R9, R22 | Mechanical: wrist hub | Clear the wrist-link lip while rolling | Hub rubs the lip | Wrist roll scrapes or jams | Rev A hub band r 11.6 mm against the lip at r 12.6 mm: stack T11 passes, 100 % yield, Cpk 2.26, clearance 0.200…1.150 mm against 0.1 mm. Widen above the lip: T12 passes, 100 % yield, Cpk 1.85 (0.100…1.500 mm). The pre-rev-A hub r 12.0 failed (T11-stock12: 99.33 % yield) and so did the widen at 4.5 mm (T12-stock45: 92.96 % yield) [D SUMMARY.md]. `params.json` line 489 `hub_od_max` is still 24.0 (checked 2026-10-11) [D cad/gripper/params.json] | Roll sweep by hand | 6 | 3 | 3 | 54 | Move `params.json` to the rev A envelope (outside this file). Hand roll through ±150° with the real arm [D camera.md 1]. Fail: any rub | `cad/gripper/params.json` (wrist_interface hub and keepout) |
| F24 | R27 | Electrical: 6.5 V rail | Supply servo current | Rail sags at stall or at pre-close pulses | Servo stutters; grip force dips; arm supply glitches if shared | Stall 2.2 A on the datasheet; dyno Fit A gives 3.77 A at stall and 3.03 A peak per cycle, above R27's 3 A [D config.h; dyno.md 3, 4]. dyno.md says size the buck for 4 A until M6 | 1000 µF bulk capacitor, common ground [D DESIGN-BASIS.md R27] | 6 | 5 | 3 | 90 | Scope on the rail during a stall (R27 proof). Fail: dips below 6.35 V [D torque_and_actuator.md]. Spec the buck at 4 A | DB R27; power wiring |
| F25 | R27 | Electrical: 6.5 V rail | Stay under the servo's rating | Buck output above 6.8 V | Servo overheats or burns out | DS3218MG rated 4.8–6.8 V; rail 6.5 ± 0.15 V leaves 0.15 V to the rating [D torque_and_actuator.md 254] | Adjustable buck set by meter [A] | 7 | 3 | 4 | 84 | Meter the rail before connecting the servo; lock the trimmer with paint | power wiring (buck converter) |
| F26 | R5, R27 | Electrical: ESP32 supply | Keep the MCU running | USB 5 V brownout resets the ESP32 mid-grip | Reboot runs BOOT then HOME: jaw opens, cloth drops | Servo surge couples into a shared ground or USB hub [A: layout not drawn] | None found; firmware logs no reset reason (grep of `firmware/gripper`, 2026-10-11) | 6 | 4 | 5 | 120 | Log the reset reason at boot. Fail: any reset during a 30-min duty run. Power the ESP32 from a clean 5 V source | `firmware/gripper/` (reset log); power wiring |
| F27 | R5, R7 | Electrical: servo signal | Drive the servo with 3.3 V PWM | Servo ignores or jitters on the 3.3 V pulse | No jaw motion | 3.3 V logic high is assumed accepted by the servo [D DESIGN-BASIS.md 8; M16] | Pin and clamp ready for a 74AHCT125 [D controls.md 7 O8] | 5 | 4 | 2 | 40 | M16 sweep test. Fail: servo does not follow 1200–1900 µs [D config.h]. Add the level shifter | signal wiring (level shifter) |
| F28 | R14, R15 | Electrical: FSR chain | Read pad force | Span error: reading differs from true force | Reads low: the 8 N trip is blind, the cap is lost (9.66 N at k 1.63, FSR half). Reads high: under-grip (3.99 N true held at k 1.0, FSR 150 %; at k 1.63 the reading passes the 8 N trip and the grip faults) [D controls.md 7; `fw_sim.json`] | FSR 402 curve fitted to the Adafruit table [D config.h]; curve behind the backing unknown (M11) | `CALF <N>` span calibration; span limits 0.5–2.0 [D config.h] | 8 | 5 | 5 | 200 | M11, then CALF at every bring-up. Fail: off by more than 0.5 N at 5 N. Add a periodic known-weight check | `firmware/gripper/config.h` (CALF); DB M11 |
| F29 | R14 | Electrical: FSR chain | Hold a steady reading through 25.5 s | FSR resistance creeps under constant load | Loop corrects to the wrong force; slip or over-squeeze | Sustained load on a force-sensing resistor [A: no creep figure sourced here]; hold lasts 25.5 s [D DESIGN-BASIS.md 7] | Re-zero at each CALIBRATE [D config.h] | 6 | 5 | 6 | 180 | Add a 25.5 s dwell test to M11. Add a creep correction if drift exceeds 0.5 N | `firmware/gripper/config.h`; DB M11 |
| F30 | R3 | Electrical: FSR chain | Report a valid signal | FSR open, short, or tail breaks at the bend | Open: no contact seen, NO_CONTACT then RELEASE (safe). Short: FAULT_SENSOR | Tail routes out through a slot [D ASSEMBLY.md step 23]; short threshold 3150 mV may be unreachable if the ADC saturates near 3.1 V; a short still trips FSR_OVER [D controls.md 7 O10]. FSR-short producer is not host-tested [D controls.md 0] | Fault latch; sensor fault code [D controls.md 1] | 5 | 5 | 3 | 75 | Bench short and open the FSR; read the fault code. Strain-relieve the tail | `config.h`; `ASSEMBLY.md` step 23 |
| F31 | none: no connector requirement | Electrical: wiring | Keep connectors seated through arm motion | Servo, FSR or ground lead pulls out | Servo unplugged mid-feed: force lost, FSR_LOST, RELEASE. Ground lost: erratic PWM | Dupont-style leads on a moving arm [A: connector type not specified in the repository] | None found | 6 | 5 | 4 | 120 | Locking connectors and strain relief. Shake test on the bench arm. Fail: any dropout during a 5 min arm sweep [A] | wiring; `ASSEMBLY.md` |
| F32 | R20 | Electrical: INA219 | Sense servo current for R20 | Sensor absent, mis-addressed, or hung | R20 stall detection silent | I²C at 400 kHz; address 0x40 [D config.h]. Full scale ±3.2 A with the 0.1 Ω shunt [S3], below Fit A stall 3.77 A [D dyno.md 3], so the reading clips (the 1.8 A trip still fires) | `WARN INA219_ABSENT` at boot; `Wire.setTimeOut(5)` [D controls.md 3, 7 O10] | 7 | 4 | 3 | 84 | Read the boot log every bring-up. Fail: the WARN line appears. Block-the-finger R20 test | `config.h` |
| F33 | R19 | Firmware: close time. **R19 = 0.75 s (owner ruling 2026-10-12)** | Close the jaw fast enough | Close is slower than 0.75 s | Host starts the arm lift before the grip is made; cloth slips or is missed | Across the R12 window: contact at 0.503–0.511 s; 4.5 N at 0.589–0.643 s; HOLD at 0.718–0.853 s [D `fw_sim.json`]. To first contact, tolerance stack T09T: PASS, 100.000 % within 0.75 s, Cpk 8.28, range 0.463…0.551 s; servo angle error is 70 % of the variance [D SUMMARY.md] | Host waits for events, not a timer [D controls.md 2] | 4 | 5 | 2 | 40 | Retain the 6° slow zone; the 3° alternative was declined after simulation found excessive contact speed and early-contact force [D controls.md 6.4]. Host must wait for `FSR_TARGET`. Bench: timed video (R19 proof). Fail: first contact later than 0.75 s | DB R19 |
| F34 | R19 | Firmware: close time. **Historical comparison: R19 = 0.5 s, superseded 2026-10-12** | Compare the former close limit | Close is slower than the former 0.5 s limit | Three events, three answers for the current 0.75 s limit. To **first pad contact** (the stack T09T's event): passes. To **4.5 N**: all four stiffness cases pass (0.589–0.643 s). To **HOLD**: two of four miss (0.718, 0.768, 0.738, 0.853 s at k 0.88, 1.05, 1.24, 1.63) [D `fw_sim.json`]; to 5 N on the drawn plant, 50.3 % within 0.75 s [D controls.md 6.4] | Historical stack T09T-r19p075 (legacy scenario id): FAIL, 24.04 % within 0.5 s, Cpk −0.24 [D SUMMARY.md]. The HOLD readings above come from the sim, not the stack, so O stays a judgement [A] | Host waits for events, not a timer [D controls.md 2] | 4 | 8 | 2 | 64 | Historical comparison only; do not speed up pre-close to meet the superseded limit (jam shock, F01). Clarify which event ends R19's 0.75 s interval. Timed video (R19 proof) | DB R19 |
| F35 | R15, R18 | Firmware: position floor. **R15 = 10 N as written** | Stop the jaw from over-closing with the FSR trip failed | Floor angle does not cap the force | Force above 10 N; fold. At −11° the L45 finger gives 12.4–14.7 N linear (8.33–9.94 N nonlinear); equal fingers about 19 N, rigid B about 38 N at θ_min [D finger.md 6.2] | R18 floor of −11° was written as the cap; the firmware used an absolute −7.4° (the 10 N angle) until round 2, then θ_c0 − 6.2°, and since 2026-10-16 θ_c0 − 4.9° for the ruled 8 N (`JAW_FLOOR_BELOW_C0_DEG`), with −10.2° as the absolute backstop [D config.h]. Stack T09F with the old absolute floor, against the ruled 8 N: FAIL, 44.91 % within, Cpk −0.04, the contact-angle spread 57 % of the variance; with the relative floor (T09F-relfloor): FAIL, 47.07 % within, Cpk −0.03, range 6.408…9.863 N (it passed against the superseded 10 N; live row F59) [D SUMMARY.md] | Three layers: squeeze cap 4.87°, soft limit 7.5 N, 7.75 N trip; floor θ_c0 − 4.9° as backstop [D controls.md 4.1, 6.4]. Host tests check the cap and the floor (`jaw floor relative to theta_c0`) | 7 | 5 | 3 | 105 | **Done (round 2):** the floor is relative to the calibrated contact angle; it changed no simulated grip [D controls.md 6.4]. Gate: `squeeze cap: max u 4.867 deg` must hold [D gates.json]. Bench: trip disabled in a debug build, close on the M10 finger, read force on the M11 scale. Fail: above 10 N. Paired row for 8 N: F59 | `config.h` (jaw floor) |
| F36 | R15 | Firmware: force cap. **R15 = 10 N as written** | Hold the cap with a thin margin | Squeeze cap reaches 9.5 N on the stiffest finger (0.5 N margin, `F_CAP_MARGIN_N`) | Finger folds at 8.4–8.9 N before the cap; the FSR trip is blind if the FSR reads half | U_MAX = (10 − 0.5 margin − 0.5) / 1.849 N/deg = 4.87° [D controls.md 4.1 item 8; gates.json `max u 4.867 deg`]. On a 1.63 N/mm finger with the FSR reading half, hold = 9.66 N on the linear plant [D controls.md 7; `fw_sim.json`] | Squeeze cap, soft limit, trip [D config.h] | 7 | 4 | 5 | 140 | Lower U_MAX further (a 9 N basis) after M10 and M11 [D controls.md 8 O4]. See Open question 1 | `config.h` (U_MAX) |
| F37 | R14, R15 | Firmware: force cap. **R15 ≈ 8 N proposed** | Hold the cap and still reach 5 N | Position-only cap is too low for the target on soft fingers | Grip stops short of 5 N, R14 fails, SLIP raised | U_MAX would be (8 − 0.5 margin − 0.5) / 1.849 = 3.785° (the firmware compiled with `F_CAP_N` 8 [D `firmware_requests_stdout.txt`, cap8]; `test_plan.py` prints 3.79°). At k 0.88 the cap reaches 4.28 N; the target needs k ≥ 1.048 N/mm [D `test_plan_stdout.txt`]. In the firmware simulation across the R12 window the hold is 4.14 N at k 0.88, 4.70 N at 1.0, 4.94 N at 1.05 and 5.17 N at 1.1 N/mm, and R14 holds in 9.0 % of 1,000 drawn grips (46.7 % at 10 N) [D controls.md 6.4]. FEA gives 1.07–1.29 N/mm [D finger.md 1]. Stack T09H-r15p8 (squeeze cap 3.785°): FAIL, only 39.50 % of builds reach 5 N, Cpk −0.21, range 4.183…5.333 N. At the written 10 N cap (squeeze cap 4.867°) the same stack T09H passes: 100 % yield, Cpk 2.44 (hold reach 4.183…6.858 N); with the rev B dog slots it runs as T09H-relfloor: MARGINAL, 99.996 %, Cpk 1.28 [D SUMMARY.md, REVB.md] | None yet; this row exists only if the cap moves to 8 N | 6 | 8 | 3 | 144 | If R15 becomes 8 N, use a cap that tracks the measured k (M10) or a stiffer-finger rule (k ≥ 1.1 N/mm); the firmware at an 8 N cap is in `analysis/gripper/controls/firmware_requests.py` (row cap8). Fail: hold force below 5 N on any M10-measured finger | `config.h`; `analysis/gripper/firmware_sim` |
| F38 | R20 | Firmware: stall protection (R20) | Back off within 200 ms | Back-off is late, or trips falsely | Late: servo and mesh stay at stall torque. False trip: grip aborts at a hold | Back-off begins 140 ms after onset, reaches target at 200 ms, jaw trails about 50 ms more [D gates.json; controls.md O11]. Trip 1.8 A is near the 5–6.7 N hold current on Fit A (1.35 A at 5 N; 1.8 A near 6.7 N) [D controls.md 7 O6; dyno.md 0] | Over-current monitor at 50 Hz; FAULT opens the jaw 5° [D config.h] | 6 | 4 | 3 | 72 | Blocked-finger bench (R20 proof). Fail: back-off not begun in 200 ms. Measure the hold current (M6), then reset the trip | `config.h` |
| F39 | R21 | Firmware: calibration (R21) | Store the true 0.5 N touch angle | θ_c0 wrong or CALIBRATE faults | Wrong contact reference: over- or under-squeeze; no start | Debris or leftover cloth between pads; lag assumed 76 ms [D config.h; M8]. Window −4° to +4° [D config.h] | θ_c0 lands within 0.2° in sim; range check faults [D controls.md 0] | 6 | 4 | 3 | 72 | Read the boot log θ_c0 each start. Fail: outside −4°…+4° or off a feeler gauge reading [D controls.md 7 O2] | `config.h` |
| F40 | R6 | Firmware: state timeouts | Release a stuck state | Timeout releases the cloth mid-feed | Seam stops; cloth falls | FEED timeout 30 s, HOLD 60 s [D config.h]. A 200 mm seam at 10 mm/s takes 20 s; a 300 mm seam takes 30 s [D DESIGN-BASIS.md 6] | Timeouts are set above the duty-cycle feed [D config.h] | 5 | 4 | 3 | 60 | Set the host to re-grip for seams over 200 mm [D camera.md 1]. Host FSM test covers every timeout [D gates.json] | `config.h` |
| F41 | R6 | Firmware: host serial link | Receive `FEED` and `FEED_DONE` | Link drops or garbles during the grip | Gripper keeps squeezing up to the 30 or 60 s timeout; heat builds | No host heartbeat found in the firmware (grep of `firmware/gripper`, 2026-10-11 [A: absence of evidence]). Lines over 64 chars are dropped [D config.h] | State timeouts only | 6 | 4 | 4 | 96 | Add a host heartbeat that releases after a missed beat. Unplug-USB test during FEED | `firmware/gripper/` (host link) |
| F42 | R6 | Firmware: main loop | Keep the 50 Hz loop alive | Loop hangs | PWM stays at its last pulse; grip holds with no monitoring | No explicit watchdog in the sketch (grep for `watchdog` and `WDT` in `firmware/gripper` returned nothing, 2026-10-11). Output hardware keeps its last pulse [A] | Loop re-synchronises after an overrun [D controls.md 3] | 7 | 3 | 6 | 126 | Enable a task watchdog that detaches the servo. Fault-inject a hang on the bench | `firmware/gripper/` (main loop) |
| F43 | R13 | Assembly: reaming and pressing | Keep both pivots parallel | Plates not reamed as a pair, or front plate pressed on tilted | Axis tilt; mesh edge-loads (F02) | Line-reaming is the main fix: the reamed baseline T16 passes (100 % yield, Cpk 1.67); with reaming skipped (T16-noream) it fails, 96.83 % yield, Cpk 0.71 [D SUMMARY.md]. O follows the reamed baseline; skipping the step is a process error with no tracked rate. Plates are a matched pair; replacing one means reaming again [D ASSEMBLY.md step 1 note] | "Do not tilt it; start both pins together" [D ASSEMBLY.md step 16] | 6 | 3 | 5 | 90 | Square and feeler check at the pin tip (coupon item 7). Label matched pairs | `ASSEMBLY.md` steps 1, 16 |
| F44 | none (derived from the housing) | Assembly: heat-set inserts | Seat M3 inserts square and flush | Insert crooked, overheated, or loose | Deck loosens; PETG distorts | 220 °C iron on PETG; printed holes about 0.25 mm small [D ASSEMBLY.md step 2; tolerance_stacks.md, Process basis] | Flush check and cool-down [D ASSEMBLY.md step 2] | 6 | 5 | 4 | 120 | Practice on the coupon. Add a jig to hold the iron square | `ASSEMBLY.md` step 2 |
| F45 | none (derived from the housing) | Assembly: front-plate screws | Hold the front plate to the standoffs | Self-tapping M3×16 strips in the 2.5 mm pilot | Plate loose; pins lose support | PETG thread forming; torque 0.3 N·m assumed [D ASSEMBLY.md step 17]. CAD screw is shorter than the BOM [D ASSEMBLY.md Notes] | "Stop at first snug" [D ASSEMBLY.md step 17] | 5 | 5 | 4 | 100 | Use heat-set inserts in the standoffs or a torque-limited driver. Fix the screw length in the BOM | `ASSEMBLY.md` step 17; BOM |
| F46 | R1 | Assembly: dog pins | Drive knuckle A from the horn | A short or loose dog fails to reach the knuckle slot | Dog leaves the slot; knuckle A uncouples | B40 replaces the old M3×8 / M3×10 screw mismatch with custom M3×10 hardened shoulder dogs threaded into Ø6×3×3 steel horn inserts; the model has 3.0 mm engagement and 0.5 mm floor clearance [D CAD / dog_check.py]. Retention is [A] pending a coupon | Build step and coupon | 7 | 6 | 3 | 126 | Gauge dog projection and insert retention after assembly; reject below 3.0 mm engagement or any hand movement [A] | BOM; `cad/gripper/params.json` (servo.dog_pin) |
| F47 | R3, R14 | Assembly: FSR | Mount the FSR flat and centred | Puck off-centre, backing bonded tilted, glue bridges the sensor | Reading low and unrepeatable | Bonding done by hand with the jaw open; 4.45 mm closed gap blocks access later [D ASSEMBLY.md steps 22–25, Risks] | Visual check [D ASSEMBLY.md step 24] | 6 | 5 | 5 | 150 | M11 on the built finger. Fail: same 0.5 N rule as F28 | `ASSEMBLY.md` steps 22–25 |
| F48 | R14 | Assembly: finger pegs | Locate each finger on its root | Pegs sit 1.0 mm inside the cheeks | Peg engagement is shorter than designed; float up to ±0.21 mm | BOM pegs are 2×24 mm against 26.0 mm in the CAD; M2×25 against 26.0 mm [D ASSEMBLY.md Notes]. The finger-position stack T10 fails at baseline (96.42 % yield, F15) [D SUMMARY.md] | None | 4 | 6 | 4 | 96 | Match the BOM to the CAD. Feeler-check root gap | BOM; `ASSEMBLY.md` |
| F49 | R14 | Use: grip on cloth | Hold 5 N through 25.5 s against 2 N tension (R14) | Cloth slips under tension | Seam defect; cloth moves | Slip safety factor = 2 × μ × 5 N / 2 N = 2.0 at μ 0.4 [D DESIGN-BASIS.md R14]; μ 0.3 needs 6.7 N. μ is assumed [A, M2]. Friction capacity 3.81 N against a 4 N snag [D dyno.md 0] | Slip event below 3 N; loop re-squeezes [D config.h] | 6 | 5 | 3 | 90 | M2 incline test, 5 trials. Fail: μ below 0.4 (factor under 2). M3 tension check | DB M2, M3 |
| F50 | none: no table-contact requirement | Use: table contact | Slide the nail under the cloth edge | Nail or TPU tip hits the table hard | Finger, nail, gear or arm takes a shock; collision 28.5 N, arm-collision 2.53 N·m on the TPU tip [D dyno.md 0] | Arm descends faster than the detector reacts; thresholds (0.3 A rise, 40 ms) are unmeasured [D config.h; controls.md 7 O6] | Table-touch detector; host can send `G N` [D controls.md 1] | 7 | 5 | 4 | 140 | Bench: nail on the table, watch current. Slow the last millimetres of touchdown | `config.h` (touch detector) |
| F51 | R24 | Use: machine | Keep clear of the needle and foot | Pad or finger hits the needle or presser foot | Broken needle, damaged finger, possible injury | Arm position error near the head; release point set ≥ 20 mm before the foot [D DESIGN-BASIS.md 6]. No sensing of needle position [A] | Work-cell rule R24 [D DESIGN-BASIS.md R24] | 9 | 4 | 5 | 180 | Dry-run all poses without cloth; machine off with the needle raised during tests. Add a software keep-out | DB R24 |
<!-- r10-work-cell-rule:begin -->
| F52 | R10 | Use: arm payload | Stay within the arm's mass-moment budget (R10) | Gripper too heavy for shoulder_lift | Arm droops, overheats, or stalls | Current CAD mass 153.9 g gives a full-extension mass-moment of 53,342 g·mm (122.0 %), above the 43,720 g·mm budget; R10 remains FAIL at full extension. With the 10 g camera, mass would be 163.9 g and the overload would be worse. Do not fly the camera [D `cad/gripper/out/fitcheck.json`] | TP-14 reach gate [D] | 7 | 5 | 3 | 105 | Douglas's 2026-10-11 ruling keeps R10 at 43,720 g·mm. Enforce no holds with the gripper COM farther than r_limit = 284.1 mm from the shoulder_lift axis (43,720 g·mm / 153.9 g); the equivalent fingertip limit is 342.6 mm. M14 weighs the current build and TP-14 measures reach; never command or hold full extension. The old 103.9 g threshold no longer follows from the current inputs: at the current full-extension lever, fail above 126.1 g or load above 50 % of stall | `cad/gripper/out/fitcheck.json`; DB R10; TP-14 |
<!-- r10-work-cell-rule:end -->
| F53 | R26 | Use: thermal | Keep the servo case ≤ 60 °C after 30 min (R26) | Servo overheats | Torque falls (hold = 54 % of hot stall); timeouts; glue and TPU soften | Dyno fails 9 of 12 modelled cases, a case-proxy upper bound (96 °C Fit A, 25 °C ambient); the verdict waits on M7. TPU heat deflection 50.3 °C [D dyno.md 0; DESIGN-BASIS.md 4] | HOLD timeout 60 s [D config.h] | 7 | 6 | 3 | 126 | M7 IR thermometer, 30 min duty run. Fail: above 60 °C. Add a duty-cycle limiter; consider a servo with margin | `docs/gripper/analysis/thermal.md`; `config.h` |
| F54 | none: one-ply scope not a requirement | Use: cloth edge | Slide the nail under one ply | Mis-grab: two plies, folded corner, or no cloth | NO_CONTACT then release (safe), or a skewed grip | Contact more than about 10° above θ_c0 (over 20 mm of cloth) arrives in the 120 °/s leg and trips FSR_OVER at 8.4 N [D controls.md 7 O9] | NO_CONTACT margin 3°; FSR_OVER fault [D config.h] | 5 | 6 | 3 | 90 | Test with a 2-ply and a folded edge (M4 thickness). Confirm the one-ply scope with Douglas if thick cloth must be supported | `config.h`; DB M4 |
| F55 | R23 | Use: camera aim | Aim the optional wrist camera | Camera points off target | CV loses the edge | Stack T13 (rev A, locating tab) passes: 100 % yield, Cpk 1.83, worst case ±3.033° against ±3°. Without the tab (T13-notab) it fails, 68.01 % yield, Cpk 0.58 [D SUMMARY.md]. Primary camera is fixed off-arm [D camera.md 0] | Locating tab (rev A) | 3 | 3 | 3 | 27 | Only if the wrist camera is built. Aim check on a target card. Fail: more than ±3° | `cad/gripper/params.json` (camera_pad); `docs/gripper/analysis/camera.md` |
| F56 | R13 | Mechanical: servo gearbox | Survive back-driven shocks | Internal servo gears strip | Servo replaced; arm down for the rebuild | Shocks of 2.53–3.60 N·m against an unknown internal gear rating [A: not on the datasheet used] | Over-current trip; PWM clamp 1200–1900 µs [D config.h] | 7 | 3 | 5 | 105 | Spare servo on hand. Keep pre-close at 120 °/s. Check for play after the M17 step load | spare servo; `config.h` |
| F57 | R15 | Firmware: FSR over-force trip. **R15 = 10 N as written, historical: superseded by the 8 N ruling (Douglas 2026-10-12, DESIGN-BASIS R15); the live row is F58** | Stop the squeeze at the FSR trip | Peak pad force when the trip fires passes 10 N | Force above the cap; the finger already folds at 8.4–8.9 N (F11); finger or nail damaged | Historical, from the pre-ruling stack run at 10 N (85.98 % of builds within 10 N, 14.02 % over; no longer reproducible from `basis.yaml`; the live numbers are F58); range 7.273…11.383 N, nominal 9.149 N [D `analysis/gripper/tolstack/results/T09P.md`]. Trip is set at 7.75 N (8 N before the ruling) [D config.h]. The squeeze that continues while the trip is held (60 °/s for 20 ms plus 9.5 ms) is 85 % of the variance [D SUMMARY.md; analysis/gripper/tolstack/results/T09P.md] | 8 N FSR trip in 20 ms; soft limit 7.5 N; squeeze cap [D config.h] | 7 | 7 | 5 | 245 | **Open: no firmware fix.** The stack's fix, `F_TRIP_N` 7.0 with `F_TRIP_MS` 10 (T09P-trip7 passed against the superseded 10 N; Cpk now 0.18 against 8 N), was declined by the firmware simulation: a 7 N trip sits inside the hold band (setpoint + 1 N bias + 0.6 N deadband) and falsely trips 10 of 17 grips across the R12 window, 16 of 1,000 drawn `G 5` grips and 9 of 300 `G 7` grips, while the early-contact peaks it was meant to cut do not move (8.20 N drawn, 9.62 N linear stiff bound at 10° early, same as at 8 N / 20 ms): the jaw's lag sets them before any trip acts [D `analysis/gripper/controls/results/firmware_requests_stdout.txt`; controls.md 6.4]. What does move them is a slower approach (controls.md 4.4). Bench: trip-peak test (section 1). Fail: any peak above 10 N | `config.h` (approach speed); `controls.md` O9 |
| F58 | R15 | Firmware: FSR over-force trip. **R15 = 8 N, ruled (Douglas 2026-10-12)** | Same | Peak pad force at the trip passes 8 N | Force above the ruled cap in most builds | Stack T09P, `F_cap` 8.0 and `F_trip` 7.75 in `basis.yaml`, the trip alone: only 11.53 % of builds peak within 8 N (88.47 % over), Cpk −0.52, range 7.045…11.105 N [D `analysis/gripper/tolstack/results/T09P.md`, SUMMARY.md]. The T09P-trip7 option now also FAILs at 8 N: 65.44 % within, Cpk 0.18 [D `results/T09P-trip7.md`] | Same as F57 | 7 | 9 | 5 | 315 | **Applied 2026-10-16:** the jaw floor θ_c0 − 4.9° bounds the peak (T09P-floor49: PASS, 100 % within 8 N, Cpk 1.46, range 4.865…8.031 N, same samples as T09F-relfloor8) with no new false trip in the firmware simulation (controls.md 6.4). No trip setting fixes it alone. `F_TRIP_N` 5.5 with `F_TRIP_MS` 10 passes the stack (T09P-trip55: PASS, 100 % within 8 N, Cpk 1.48, range 5.000…7.760 N) [D SUMMARY.md] but sits inside the normal hold band (settles at 5.0–5.6 N, on-target band to 6.1 N, `firmware/gripper/config.h` lines 142 and 159 [D]), so it would fire during ordinary holds. An 8 N cap needs a lower R14 hold, a stiffer-finger rule, or a faster trip path; that is the requirements owner's call (`tolerance_stacks.md`, *The conflict*). Bench: trip-peak test (section 1). Fail: any peak above 8 N | `config.h`; DB R15 |
| F59 | R15, R18 | Firmware: position floor. **R15 = 8 N, ruled (Douglas 2026-10-12)** | Stop the jaw from over-closing with the FSR trip failed | Force at the jaw floor passes 8 N | Force above the ruled cap; finger folds | Stack T09F, `F_cap` 8.0: FAIL, 44.91 % within 8 N (55.09 % over), Cpk −0.04, range 3.589…13.338 N [D `analysis/gripper/tolstack/results/T09F.md`]; the shipped 6.2° relative floor (T09F-relfloor) now also FAILs at 8 N: 47.07 % within, Cpk −0.03 [D `results/T09F-relfloor.md`] | Same as F35 | 7 | 9 | 3 | 189 | **Applied 2026-10-16:** floor relative to the calibrated contact angle, θ_c0 − 4.9° for the 8 N cap (`JAW_FLOOR_BELOW_C0_DEG` 4.9; T09F-relfloor8: PASS, 100 % within 8 N, Cpk 1.46, range 4.865…8.031 N) [D SUMMARY.md; controls.md 6.4]. Bench: same trip-disabled run as F35. Fail: above 8 N | `config.h` (jaw floor) |
| F60 | none: `jaw_center_tol` is an assumed target | Mechanical: deck | Centre the jaw on the roll axis | Jaw centreline at the fingertips sits outside −0.193…+0.807 mm in X (the closing axis) | Pinch point is off the programmed point; the nail meets the cloth edge off-line; seam position error | Deck floats on 4 M3 screws in Ø3.6 holes (deck float is 64 % of the variance). Stack T05: FAIL, 99.36 % yield (0.64 % out), Cpk 0.92, worst case −1.330…1.944 mm [D SUMMARY.md] | None identified [A: not checked against ASSEMBLY.md for a pinch-point step] | 5 | 5 | 4 | 100 | Locate the deck on the spider with 2 printed Ø3 pegs in reamed Ø3 holes in the deck, or ream the 4 deck holes to 3.1 mm and use M3 shoulder screws (T05-deckpegs alone: PASS at Cpk 1.35 in the one-at-a-time rev A run, but MARGINAL at Cpk 1.30 in the combined rev B run). The one-time pinch-point TCP calibration is part of rev B (T05-tcpcal: PASS, Cpk 1.84 combined) [D SUMMARY.md]. Bench: coupon item 3 (hole positions), then a dial on the closed pads against the roll axis. Fail: X offset outside −0.193…+0.807 mm | `cad/gripper/params.json` (housing.deck_screws); TCP setup |
| F61 | R1 | Mechanical: dog coupling | Turn knuckle A from the servo shaft without side load | Servo shaft offset exceeds the dog slot tangential clearance | Dogs jam; servo bearing and pin A take side load, with friction, stiction and wear | As-drawn T14B: FAIL, 40.68 % yield, Cpk −0.06 [D SUMMARY.md]. B40 boss-located hardened shoulders in Ø6 inserts and 3.4 mm slots: T14B-boss34 option MARGINAL, 99.94 % yield, Cpk 1.10; T09-b40_shoulder34 PASS, Cpk 1.39 [D tolstack results]. Shoulder diameter and printed-slot bias remain assumptions | Step 26 range run [D ASSEMBLY.md] | 6 | 9 | 4 | 216 | Coupon item 8 and fitted-servo hand turn through −11°…+20°; gauge the slot, shoulder and boss fit. Fail: binding or stiction, insert movement, or lash beyond ±1.7° [A; T14B shoulder/slot geometry] | `cad/gripper/params.json` (knuckle.dog_slot_w, servo.horn_insert_od) |
| F62 | R25 | Mechanical: knuckle sleeves | Let each bronze bush run on its pin | Bush bore and pin overlap: the bush is an interference fit | Knuckle will not slide on, or binds and stiffens; bush forced and damaged; pivot friction | Bush bore 3.000–3.016 mm on an m6 dowel 3.002–3.008 mm can be an interference. Stack T16B: FAIL, 68.93 % yield (31.07 % out), Cpk 0.29, clearance −0.008…0.014 mm against 0 mm; sleeve bore is 88 % of the variance. The bush maker recommends a running shaft of f7 or h7; m6 is a press-fit size [D SUMMARY.md]. Line-to-line (0.000) is accepted at the tight end of rev B: the bush is oil-impregnated sintered bronze, the standard H7/h6 sliding fit has zero minimum clearance [A: ISO 286 fit tables, not re-fetched], 0.000 occurs only with both parts at their stated extremes (worst case), and the assembly check below rejects any pair that does not turn by hand | Press on the bench first; "turns freely" check [D ASSEMBLY.md steps 13, 15] | 6 | 8 | 3 | 144 | Use an h8 pin (2.986–3.000 mm) instead of the m6 dowel, **graded to the pressed bush bore so each pair runs 0.000–0.020 mm** (T16B-h8pin: PASS, 100 % yield, Cpk 1.05, clearance 0…0.030 mm ungraded; graded pairs keep T16 at Cpk 1.35, ungraded 1.01) [D SUMMARY.md, rev_b results]. Buy 3×6 bushes (no 3×5 bush was found in the catalogue searched [A]; confirm with the supplier) and open the knuckle bore to 6 mm. Bench: coupon item 8 (bronze-sleeve bore on the real pin). Fail: a graded pair does not slide on by hand, binds, or rocks more than 0.020 mm at the bush end [A]; an ungraded h8 pin can rock 0.030 mm, which is why the pins are graded | `cad/gripper/params.json` (knuckle.sleeve_od); `ASSEMBLY.md` step 13 |
| F63 | R26 | Mechanical: servo seat | Hold the servo against the plates at temperature | PETG servo seat or ear-screw preload creeps; the servo shifts in its pocket | Gear centre distance and backlash drift (T06, T07); the dog slot binds or the lash grows (T14B); the servo works loose | Four M3 ear screws squeeze bare PETG at 18.4–36.8 MPa under the nut. The mount runs at 67.5 °C (Fit A) or 48.9 °C (Fit B) in the hold, against PETG's 68 °C glass transition; the clamp left after a semester is about 69 % at 25 °C, 30 % at the Fit B mount temperature and 6 % at the Fit A temperature [D thermal.md 0, 3]. Hot-seat stack scenario [A: stand-in float ±0.10 mm, shaft ±0.05 mm, end play ±0.05 mm]: rev B T14B stays FAIL, falling to 98.76 % yield, Cpk 0.75, T14 from PASS to MARGINAL (Cpk 1.27), T15 stays PASS (Cpk 2.43); rev A as drawn only gets worse (T14B Cpk −0.09) [D `analysis/gripper/tolstack/results/rev_b/revb_hot.json`, `drawn_hot.json`] | Four servo-ear screws and nuts [D ASSEMBLY.md step 11]; nothing watches preload | 6 | 7 | 6 | 252 | Metal compression limiters in the four ear-screw holes, with washers, so the preload goes through metal (C1 in `docs/gripper/analysis/thermal.md`), plus the friction back-off hold in firmware (F1 there). Re-torque check at 1 and 4 weeks. Bench: clamped-coupon creep test (PETG seat, M3 screw, 500 N, 50 °C, 24 h, measure torque loss; thermal.md 6) and a thermocouple in the C3 hole. Fail: more than 50 % preload loss in 24 h [A], or a mount above 50 °C without limiters. Links: T14, T14B, T15 | `docs/gripper/analysis/thermal.md`; `cad/gripper/params.json` (housing seat) |
| F64 | none: no guarding or pinch requirement (propose a new one) | Use: operator contact | Keep hands clear of the closing fingers and the gear mesh | Pinch or entrapment at the closing fingers, or in the gear mesh if it is open at the sides | Finger, hair or cloth caught; bruise or cut; gears and servo damaged | Pad force up to 10 N at 65 mm; the mesh carries up to the 2.09 N·m servo stall, which is 147 N at the 14.25 mm pitch radius (2.09 / 0.01425, arithmetic here) [D torque_and_actuator.md 0; gears.md]. Fingers close at 120 °/s [D config.h]. Whether the mesh is open at the sides is not checked in the CAD [A] | Work-cell rule R24 keeps people out of the cell; no guard in the CAD [A] | 9 | 4 | 6 | 216 | Check the CAD for open gear sides and add a cover plate or finger guard; keep the arm unpowered whenever someone reaches in; label the cell. Bench: with the arm unpowered, a 6 mm probe must not reach the mesh [A]. Fail: the probe reaches it | `cad/gripper/params.json` (housing, gear cover) |
| F65 | R25 | Material: printed gears and knuckles | Hold gear and knuckle size over weeks | PA6-CF gears and knuckles take up moisture and swell | Centre distance, backlash and the sleeve fit move (T06, T07, T16, T16B); the jaw binds in humid weather or loses lash in dry | PA6-CF takes up water [A: the size change is not quantified here]. gears.md takes a 0.85 strength knockdown for moisture and plans a weigh test (M23), but no size change; no tolerance stack models it (`tolerance_stacks.md`, *Heat, and what these stacks do not model*) | None: storage and drying are not specified [A] | 5 | 5 | 6 | 150 | M23 (weigh a dried coupon over a week) extended with a caliper on a gear pair. Store the gripper dry; dry the parts before assembly. Fail: centre distance moves more than ±0.1 mm [A: a third of the T06 window] | `docs/gripper/analysis/gears.md` (M23) |
| F66 | R25 | Use: cloth handling | Keep the gear mesh and pivots clear of debris | Lint, thread or fibre packs into the mesh or the knuckle sleeves | Backlash and friction rise; the mesh jams or a tooth chips (F01); the jaw sticks | Sewing cloth sheds lint and loose thread, and the mesh sits near the cloth path; no seal or cover in the CAD [A: not checked]. The design backlash window starts at 0.05 mm (`jt_min` in `basis.yaml`), which leaves no room for fibre | None | 6 | 5 | 5 | 150 | Cover the mesh (the F64 guard also does this). Clean at each shift start. Bench: run the jaw through a dust of cut fibre, then check backlash. Fail: backlash outside 0.05–0.45 mm or a stick | `cad/gripper/params.json` (housing, gear cover); `ASSEMBLY.md` |
| F67 | R1, R25 | Mechanical: dog coupling | Retain two hardened shoulder dogs and their steel inserts in the horn | A threaded joint or press fit relaxes, or the 1 mm outer rim or 0.5 mm inner web cracks | Dog lash grows; a dog leaves its slot; knuckle A uncouples; one-sided jaw | B40 uses custom M3×10 Ø2.9 smooth-shoulder dogs in Ø6×3×3 steel inserts at r 7 in a Ø22 aluminium horn. The one-dog stall check gives bending SF 1.48, steel bearing SF 1.27, aluminium bearing SF 1.13 [A allowables; D dog_check.py]. Thread strength, press-fit strength, outer-rim and inner-web fatigue and machined dimensions are unmeasured | Coupon before assembly [A] | 6 | 4 | 5 | 120 | Pull-out and 1e5-cycle lash coupon; inspect at 1 week and every 1e4 cycles. Fail: any hand movement, rim/web crack, or lash beyond ±1.7° [A] | `cad/gripper/params.json` (servo.horn_insert_od, servo.dog_pin); BOM |

Row count: 67 (F63 added for the PETG seat; F64–F67 added for pinch, moisture swell, lint in the mesh and dog-screw loosening). Rows whose O now comes from a rev A stack baseline: F02, F03, F04, F05, F08, F09, F15, F18, F20, F21, F22, F23, F33, F35, F37, F43, F48, F55, F57–F62; F63's O is a judgement checked against the hot-seat run, and F64–F67 are judgement [A]. Existing ids are unchanged; F37 keeps its meaning (the 8 N squeeze cap, now 3.785° with the 0.5 N cap margin). Two columns were added to the table on 2026-10-11: **Req** (the DESIGN-BASIS requirement ids the row bears on; "none" marks a requirement gap) and **Owner artifact** (the file that holds the fix).

## 4. Findings the tactician should check

1. **An 8 N cap cannot reach 5 N on a soft finger with a position-only cap (F37).** U_MAX falls from 4.867° to 3.785° (the firmware compiled at 8 N, keeping the 0.5 N margin), and fingers softer than about 1.05 N/mm stop short of 5 N. Checked in the firmware simulation (round 2): across the R12 window the hold is 4.14 N at 0.88 N/mm and first reaches 5 N between 1.05 and 1.1 N/mm; R14 holds in 9.0 % of drawn grips against 46.7 % at 10 N [D controls.md 6.4]. Rev A stack T09H-r15p8, now on the firmware's 3.785° cap, puts 39.50 % of builds at 5 N or more [D SUMMARY.md].
2. **Seven of the top ten rows trace to two weak points: the force chain (F28, F29, F57, F58, F59) and the finger and cap (F11, F36).** One measurement set, M10 and M11, informs all of them; the trip-peak test (section 1) settles F57 and F58.
3. **Three assembly defects are certain as drawn today** (F19 deck screws, F46 dog pin part, F20 horn screw depth). Each shows up at its build step, so D is low, but the CAD or BOM still needs a change.
4. **Rev A stacks that still fail at baseline, each with a fix proved one at a time in SUMMARY.md (the B40 T14B fix is MARGINAL cold at Cpk 1.11 and still FAILS hot at Cpk 0.75):** T14B dog coupling (F61, 40.68 % yield), T16B bush on pin (F62, 68.93 %), T15 end play (F04, 89.67 %), T05 jaw centre (F60, 99.36 %), T10 pad parallelism (F15, 96.42 %), T14 servo pocket (F18, 95.16 %). The gear train itself passes (T06, T07, T08, T16 and T10B). Ten reported FAILs are nine independent ones: T03 passes on its own and fails only because T03B does. Each fix was proved one at a time; item 7 gives the set. Struck by the rev A rerun: the old need to rerun the gear stacks for m 1.5 z 19 (done) and the old F05 centre-distance concern (T06 passes, Cpk 2.04).
5. **Open items that remain.** `params.json` still lists a Ø19.45 pilot and a Ø24.0 hub (F21, F23). The fixed-variant results (T16B-h8pin Cpk 1.05, T16 with graded pins Cpk 1.35) are only just over the pass line, and T14B-boss34 (Cpk 1.10) is MARGINAL on assumed dimensions, so the coupon still decides it. The T09T-slow3 fix needs the `firmware_sim` rerun it names.
6. **Two rows score S ≥ 9: F51 (needle strike, "possible injury") and F64 (pinch at the fingers and the open mesh).** Both are judgement [A]; the action rule applies to them on severity alone. The loose wrist joint (F20) stays at S 8. The five force-cap rows F35, F36, F57, F58 and F59 were put at one S (7) because they share one effect.
7. **Rev B has no FAIL in the cold combined run.** The combined run (`tolerance_stacks.md`, *Combined rev B run*) has 23 of 26 checks PASS and 3 MARGINAL (T09H, T14B, T16; T14B Cpk 1.11, F61). It also showed that ungraded h8 pins put T16 at Cpk 1.01 (F62, F02) and that dog slots at 3.4 mm cost the closure window (T09, T09H); both are fixed in the rev B list. The hot-seat run (F63) puts T14B at FAIL, so the compression limiters matter.
8. **The requirements are silent on four things the rows need:** guarding and pinch (F64), assembly access (F19), connector retention (F31) and the jaw centreline target (F60). Each row's Req column says "none".

**Requested changes outside this note** (not made here):
- `docs/gripper/DESIGN-BASIS.md` §10: add the trip-peak test (section 1) as a new M test, since F57 and F58 (RPN 245 and 315) have no defined bench test there.
- `docs/gripper/DESIGN-BASIS.md` M15: state the pass depth for M3×6, 3.75 mm or more (MARGINAL from 3.5 mm) [D sweep_T03B_horn_hole_depth.md].
- `docs/gripper/DESIGN-BASIS.md` R15 and R19: record the open proposals (about 8 N; 0.75 s from `controls.md` 7 O1) next to the written values, so readers can find them.
- `docs/gripper/DESIGN-BASIS.md` §1: add a guarding and pinch requirement (F64, S 9) and an assembly-access requirement (F19); both are missing, and several rows in the Req column read "none".
- `docs/gripper/DESIGN-BASIS.md` R19: name the event the time ends on (first contact, 4.5 N or hold force). The three readings give three different verdicts (F34).
- `firmware/gripper/config.h`: the relative jaw floor (floor = θ_c0 − 4.9° since 2026-10-16, 6.2° before) is needed for R14 as well as R15 once the dog slots open to 3.4 mm; without it T09H falls to Cpk 0.99 (`tolerance_stacks.md`, *Combined rev B run*).

## 5. Sources

- S1. Wikipedia, "Failure mode and effects analysis", https://en.wikipedia.org/wiki/Failure_mode_and_effects_analysis, retrieved 2026-10-11. Used for the RPN definition and the AIAG-VDA 2019 action-priority note.
- S2. ASQ, "Failure Mode and Effects Analysis (FMEA)", https://asq.org/quality-resources/fmea, cited as the public method page. HTTP 403 on 2026-10-11; not read.
- S3. Adafruit INA219 breakout (product 904), https://www.adafruit.com/product/904, retrieved 2026-10-11: ±3.2 A, 0.1 Ω shunt, 26 V bus.
- Repository files cited as [D]: `docs/gripper/DESIGN-BASIS.md`, `docs/gripper/analysis/{controls,dyno,finger,gears,torque_and_actuator,camera,tolerance_stacks}.md`, `docs/gripper/assembly/ASSEMBLY.md`, `cad/gripper/params.json`, `firmware/gripper/config.h`, `analysis/gripper/firmware_sim/results/gates.json`, `docs/gripper/design_basis_out.json`, `analysis/gripper/tolstack/results/SUMMARY.md` with `results/<id>.md` and `stacks/*.yaml` (CAD rev A tolerance results, read 2026-10-11). "Coupon item N" is item N of the Coupon plan in `docs/gripper/analysis/tolerance_stacks.md` (CAD rev A; items 1–9 keep their earlier numbers, 10–11 are new).
- Upstream sources for the finger, gear and tolerance numbers are cited in those notes; none was re-fetched here.

## 6. Open questions for Douglas

1. **R15 force cap: ruled 8 N (Douglas 2026-10-12); the 10 N / 8 N comparison below is pre-ruling.** At 10 N the finger folds below the cap (8.4–8.9 N), the position cap has only a 0.5 N margin (F11, F36), and the trip peak exceeds 10 N in 14.02 % of builds in stack T09P (F57). At about 8 N the margin is thin, the position cap cannot reach 5 N on soft fingers (F12, F37: 39.50 % of builds reach 5 N; R14 in 9.0 % of simulated grips against 46.7 % at 10 N), and the trip peak exceeds 8 N in 88.47 % of builds with the 7.75 N trip alone (F58); the 4.9° floor (2026-10-16) now holds both F58 and F59 within 8 N in the stacks. The relative floor is now in the firmware (T09F PASS). The stack's trip fix for 10 N (F_TRIP_N 7.0 with F_TRIP_MS 10) was declined in the firmware simulation: it falsely trips normal holds and does not lower the early-contact peaks (F57). At 8 N no trip setting works either: the only trip that passes the stack (5.5 N) sits inside the normal hold band. What lowers the early-contact peaks under both values is a slower approach (controls.md 4.4) or ruling folds out of scope (controls.md O9). Not settled here. Recommendation for whoever decides (the owner keeps both values open): keep 10 N, thicken the finger (F11), and decide O9 (must a fold be gripped); 8 N leaves T09H failing and costs most of R14 [D SUMMARY.md; controls.md 6.4].
2. **R19 close time: 0.5 s, or 0.75 s, and to which event?** The sim reaches contact at 0.503–0.511 s, 4.5 N at 0.589–0.643 s, HOLD at 0.718–0.853 s across the R12 window. At 0.75 s it passes to 4.5 N but misses to HOLD for two of four finger stiffnesses (F33, F34). The stack T09T to first contact is 24.04 % within 0.5 s and 100 % within 0.75 s. Cutting `JAW_SLOW_ZONE_DEG` from 6 to 3 would make 0.5 s pass in the stack, but the firmware simulation declined it: the jaw meets the cloth at up to 41 °/s and an early contact passes 10 N (F33). Recommended: 0.75 s ending at the 4.5 N event.
3. **R20 timing reading (same class as R19).** "Back-off begins within 200 ms" is met with 60 ms spare; "unloaded within 200 ms" is not (F38). Recommended: the first reading.
