douglaspmcgowan/cloth-feed-gripper/ecad/gripper/kicad/out/gripper-schematic.pdf

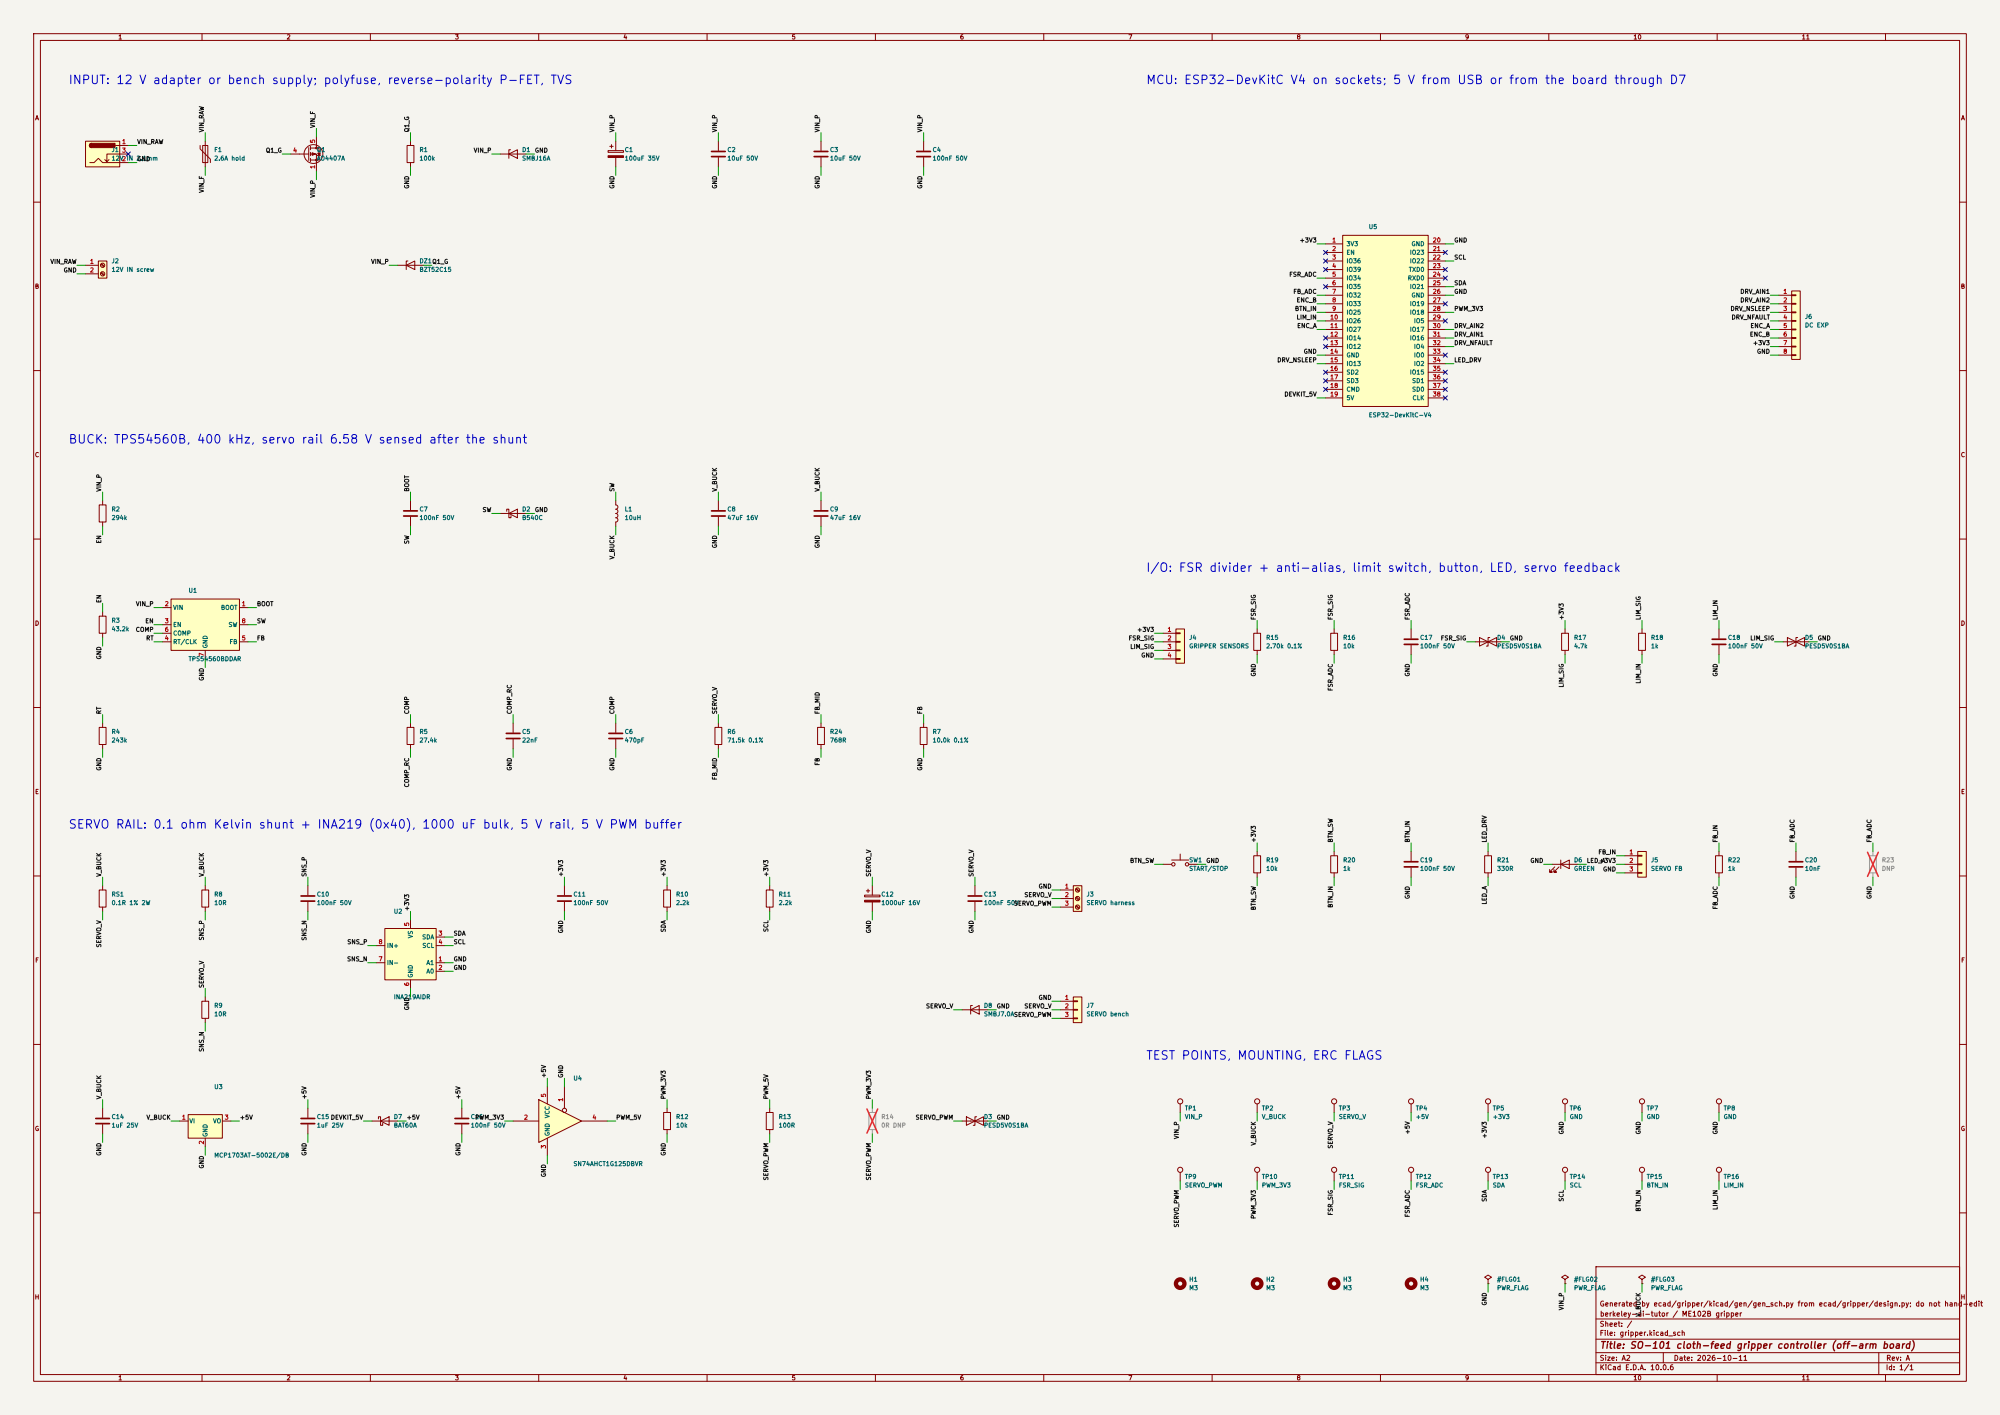
[picture p192: page 1]

INPUT: 12 V adapter or bench supply; polyfuse, reverse-polarity P-FET, TVS

MCU: ESP32-DevKitC V4 on sockets; 5 V from USB or from the board through D7

BUCK: TPS54560B, 400 kHz, servo rail 6.58 V sensed after the shunt

I/O: FSR divider + anti-alias, limit switch, button, LED, servo feedback

SERVO RAIL: 0.1 ohm Kelvin shunt + INA219 (0x40), 1000 uF bulk, 5 V rail, 5 V PWM buffer

TEST POINTS, MOUNTING, ERC FLAGS

Generated by ecad/gripper/kicad/gen/gen_sch.py from ecad/gripper/design.py; do not hand-edit TP3
SERVO_V

berkeley-ai-tutor / ME102B gripper
Sheet: /
File: gripper.kicad_sch
Title: SO-101 cloth-feed gripper controller (off-arm board)

Size: A2 | Rev: A
KiCad E.D.A. 10.0.6 | Id: 1/1
