douglaspmcgowan/cloth-feed-gripper/ecad/gripper/kicad/out/board/gripper-B_Cu.pdf

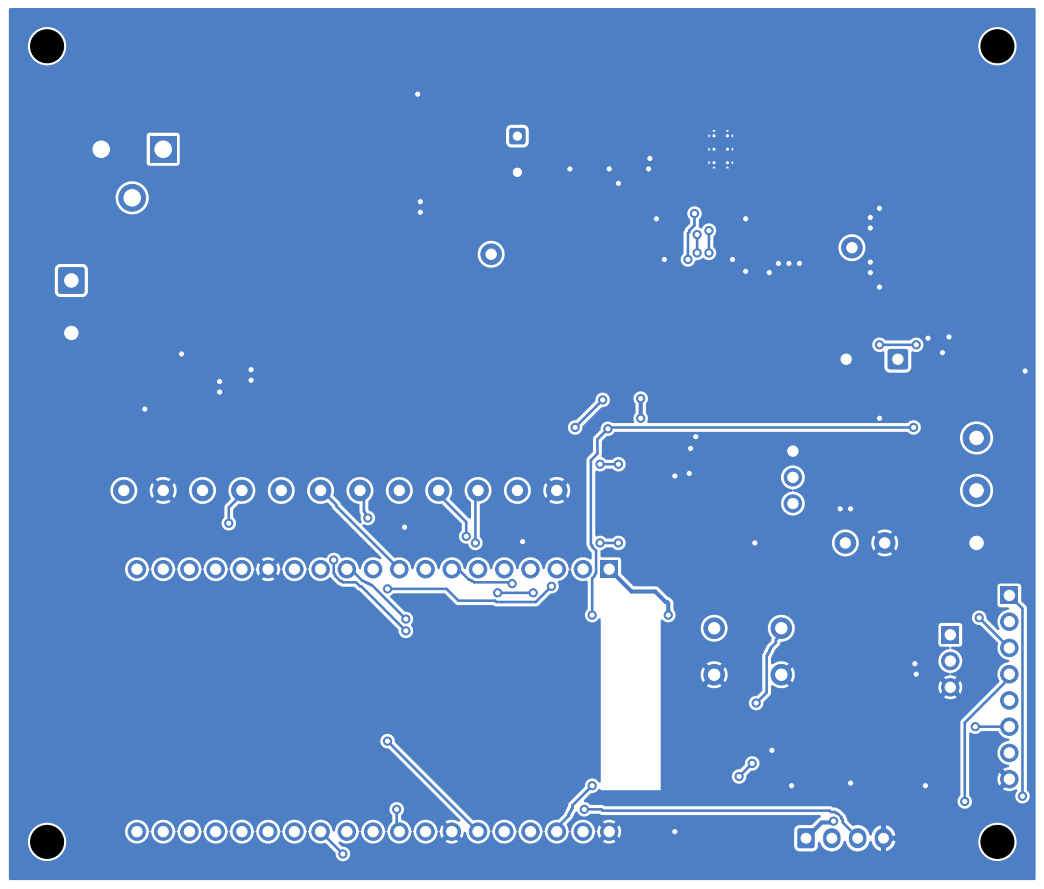
[picture p193: page 1]
