douglaspmcgowan/cloth-feed-gripper/ecad/gripper/kicad/out/board/gripper-Edge_Cuts.pdf

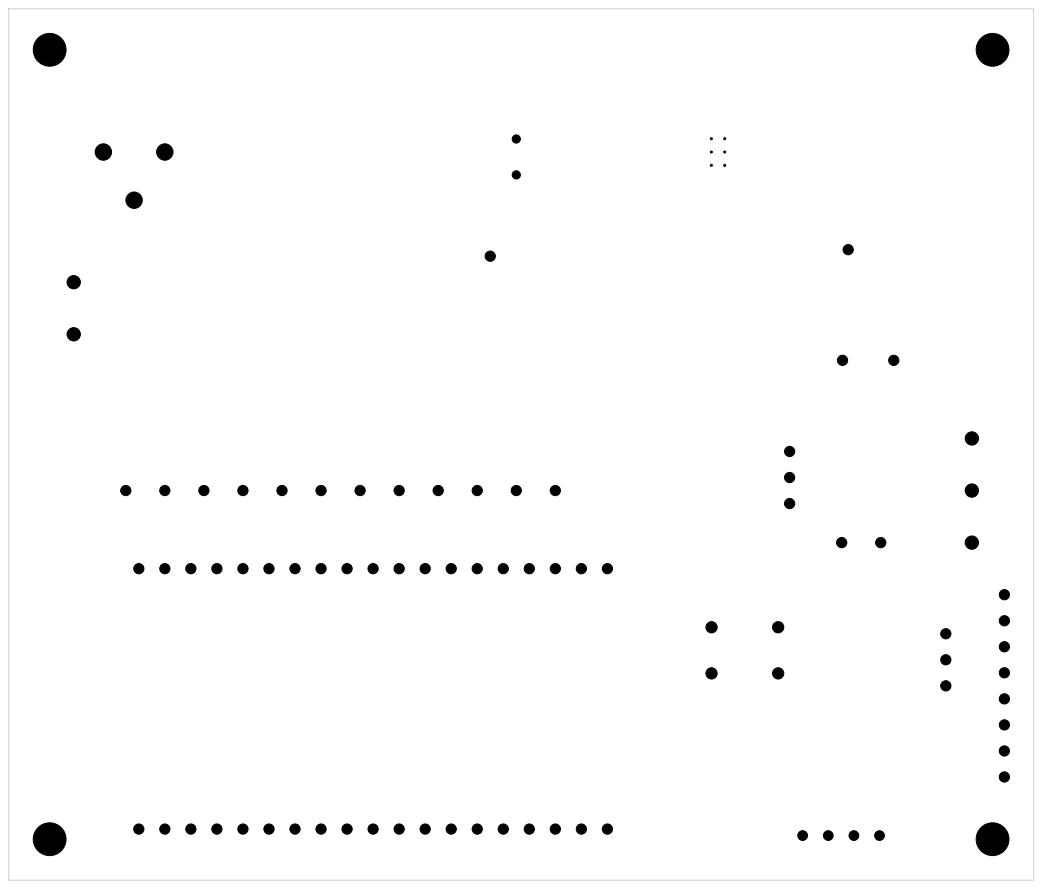
[picture p194: page 1]
