douglaspmcgowan/cloth-feed-gripper/ecad/gripper/kicad/gripper.kicad_pcb

## KiCad design ecad/gripper/kicad/gripper.kicad_pcb (2026-10-19)

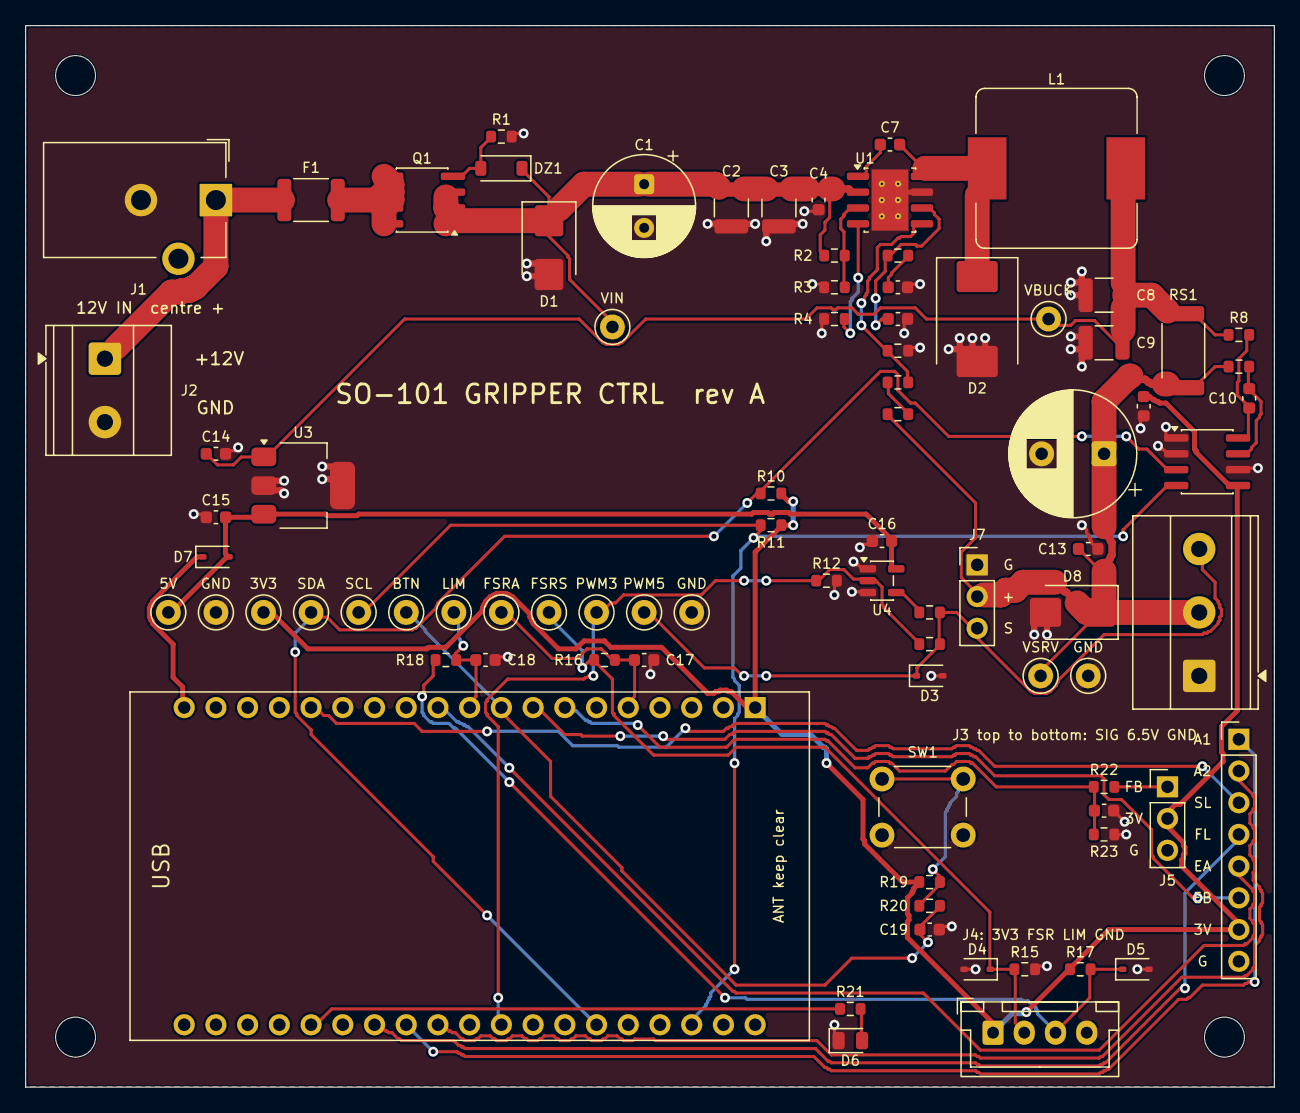
[picture p195: board gripper.kicad_pcb from above]

Board: 2 copper layers, 100.0 x 85.0 mm, 90 parts (0 on the bottom side), 41 nets.

Parts:
C1: 100uF 35V; CP_Radial_D8.0mm_P3.50mm
C2, C3: 10uF 50V; C_1210_3225Metric
C4, C7, C10, C11, C13, C16, C17, C18, C19: 100nF 50V; C_0603_1608Metric
C5: 22nF; C_0603_1608Metric
C6: 470pF; C_0603_1608Metric
C8, C9: 47uF 16V; C_1210_3225Metric
C12: 1000uF 16V; CP_Radial_D10.0mm_P5.00mm
C14, C15: 1uF 25V; C_0603_1608Metric
C20: 10nF; C_0603_1608Metric
D1: SMBJ16A; D_SMB
D2: B540C; D_SMC
D3, D4, D5: PESD5V0S1BA; D_SOD-323
D6: GREEN; LED_0805_2012Metric
D7: BAT60A; D_SOD-323
D8: SMBJ7.0A; D_SMB
DZ1: BZT52C15; D_SOD-123
F1: 2.6A hold; Fuse_1812_4532Metric
H1, H2, H3, H4: M3; MountingHole_3.2mm_M3
J1: 12V IN 2.1mm; BarrelJack_CUI_PJ-102AH_Horizontal
J2: 12V IN screw; TerminalBlock_Phoenix_MKDS-1,5-2-5.08_1x02_P5.08mm_Horizont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
J3: SERVO harness; TerminalBlock_Phoenix_MKDS-1,5-3-5.08_1x03_P5.08mm_Horizont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
J4: GRIPPER SENSORS; JST_XH_B4B-XH-A_1x04_P2.50mm_Vertical
J5: SERVO FB; PinHeader_1x03_P2.54mm_Vertical
J6: DC EXP; PinHeader_1x08_P2.54mm_Vertical
J7: SERVO bench; PinHeader_1x03_P2.54mm_Vertical
L1: 10uH; L_Bourns_SRP1245A
Q1: AO4407A; SOIC-8_3.9x4.9mm_P1.27mm
R1: 100k; R_0603_1608Metric
R2: 294k; R_0603_1608Metric
R3: 43.2k; R_0603_1608Metric
R4: 243k; R_0603_1608Metric
R5: 27.4k; R_0603_1608Metric
R6: 71.5k 0.1%; R_0603_1608Metric
R7: 10.0k 0.1%; R_0603_1608Metric
R8, R9: 10R; R_0603_1608Metric
R10, R11: 2.2k; R_0603_1608Metric
R12, R16, R19: 10k; R_0603_1608Metric
R13: 100R; R_0603_1608Metric
R14: 0R DNP; R_0603_1608Metric
R15: 2.70k 0.1%; R_0603_1608Metric
R17: 4.7k; R_0603_1608Metric
R18, R20, R22: 1k; R_0603_1608Metric
R21: 330R; R_0603_1608Metric
R23: DNP; R_0603_1608Metric
R24: 768R; R_0603_1608Metric
RS1: 0.1R 1% 2W; R_2512_6332Metric
SW1: START/STOP; SW_PUSH_6mm
TP1: VIN_P; TestPoint_Keystone_5000-5004_Miniature
TP2: V_BUCK; TestPoint_Keystone_5000-5004_Miniature
TP3: SERVO_V; TestPoint_Keystone_5000-5004_Miniature
TP4: +5V; TestPoint_Keystone_5000-5004_Miniature
TP5: +3V3; TestPoint_Keystone_5000-5004_Miniature
TP6, TP7, TP8: GND; TestPoint_Keystone_5000-5004_Miniature
TP9: SERVO_PWM; TestPoint_Keystone_5000-5004_Miniature
TP10: PWM_3V3; TestPoint_Keystone_5000-5004_Miniature
TP11: FSR_SIG; TestPoint_Keystone_5000-5004_Miniature
TP12: FSR_ADC; TestPoint_Keystone_5000-5004_Miniature
TP13: SDA; TestPoint_Keystone_5000-5004_Miniature
TP14: SCL; TestPoint_Keystone_5000-5004_Miniature
TP15: BTN_IN; TestPoint_Keystone_5000-5004_Miniature
TP16: LIM_IN; TestPoint_Keystone_5000-5004_Miniature
U1: TPS54560BDDAR; Texas_R-PDSO-G8_EP2.95x4.9mm_Mask2.4x3.1mm_ThermalVias
U2: INA219AIDR; SOIC-8_3.9x4.9mm_P1.27mm
U3: MCP1703AT-5002E/DB; SOT-223-3_TabPin2
U4: SN74AHCT1G125DBVR; SOT-23-5
U5: ESP32-DevKitC-V4; ESP32-DevKitC-V4_Socket

Connections:
/+3V3: C11.1, J4.1, J5.2, J6.7, R10.1, R11.1, R17.1, R19.1, TP5.1, U2.5, U5.1
/+5V: C15.1, C16.1, D7.2, TP4.1, U3.3, U4.5
/BOOT: C7.1, U1.1
/BTN_IN: C19.1, R20.2, TP15.1, U5.9
/BTN_SW: R19.2, R20.1, SW1.1
/COMP: C6.1, R5.1, U1.6
/COMP_RC: C5.1, R5.2
/DEVKIT_5V: D7.1, U5.19
/DRV_AIN1: J6.1, U5.31
/DRV_AIN2: J6.2, U5.30
/DRV_NFAULT: J6.4, U5.32
/DRV_NSLEEP: J6.3, U5.15
/EN: R2.2, R3.1, U1.3
/ENC_A: J6.5, U5.11
/ENC_B: J6.6, U5.8
/FB: R7.1, R24.2, U1.5
/FB_ADC: C20.1, R22.2, R23.1, U5.7
/FB_IN: J5.1, R22.1
/FB_MID: R6.2, R24.1
/FSR_ADC: C17.1, R16.2, TP12.1, U5.5
/FSR_SIG: D4.1, J4.2, R15.1, R16.1, TP11.1
/GND: C1.2, C2.2, C3.2, C4.2, C5.2, C6.2, C8.2, C9.2, C11.2, C12.2, C13.2, C14.2, C15.2, C16.2, C17.2, C18.2, C19.2, C20.2, D1.2, D2.2, D3.2, D4.2, D5.2, D6.1, D8.2, J1.2, J2.2, J3.1, J4.4, J5.3, J6.8, J7.1, R1.2, R3.2, R4.2, R7.2, R12.2, R15.2, R23.2, SW1.2, TP6.1, TP7.1, TP8.1, U1.7, U1.9, U2.1, U2.2, U2.6, U3.2, U4.1, U4.3, U5.14, U5.20, U5.26
/LED_A: D6.2, R21.2
/LED_DRV: R21.1, U5.34
/LIM_IN: C18.1, R18.2, TP16.1, U5.10
/LIM_SIG: D5.1, J4.3, R17.2, R18.1
/PWM_3V3: R12.1, R14.1, TP10.1, U4.2, U5.28
/PWM_5V: R13.1, U4.4
/Q1_G: DZ1.2, Q1.4, R1.1
/RT: R4.1, U1.4
/SCL: R11.2, TP14.1, U2.4, U5.22
/SDA: R10.2, TP13.1, U2.3, U5.25
/SERVO_PWM: D3.1, J3.3, J7.3, R13.2, R14.2, TP9.1
/SERVO_V: C12.1, C13.1, D8.1, J3.2, J7.2, R6.1, R9.1, RS1.2, TP3.1
/SNS_N: C10.2, R9.2, U2.7
/SNS_P: C10.1, R8.2, U2.8
/SW: C7.2, D2.1, L1.1, U1.8
/VIN_F: F1.2, Q1.5, Q1.6, Q1.7, Q1.8
/VIN_P: C1.1, C2.1, C3.1, C4.1, D1.1, DZ1.1, Q1.1, Q1.2, Q1.3, R2.1, TP1.1, U1.2
/VIN_RAW: F1.1, J1.1, J2.1
/V_BUCK: C8.1, C9.1, C14.1, L1.2, R8.1, RS1.1, TP2.1, U3.1
