douglaspmcgowan/cloth-feed-gripper/ecad/gripper/design.py

"""Single source of the gripper controller board: parts, values, footprints and nets.

Read by kicad/gen/gen_sch.py (schematic), kicad/gen/gen_pcb.py (board), kicad/gen/bom.py (BOM) and
the calc scripts (values). Sourcing (MPN, supplier, price, URL) lives in sourcing.py, keyed by the
`src` key of each part; the derived numbers live in calc/. Nothing here is a measurement.

Run nothing from this file: it is data. `python ecad/gripper/build.py` regenerates everything.
"""

DATE = '2026-10-11'

SHEET = {
    'paper': 'A2',
    'title': 'SO-101 cloth-feed gripper controller (off-arm board)',
    'date': DATE,
    'rev': 'A',
    'company': 'berkeley-ai-tutor / ME102B gripper',
    'comment': 'Generated by ecad/gripper/kicad/gen/gen_sch.py from ecad/gripper/design.py; do not hand-edit',
}

# ---------------------------------------------------------------------------------------------
# Electrical design values (the calc scripts read these and check them; see calc/)
# ---------------------------------------------------------------------------------------------
ELEC = {
    'vin_nom_V': 12.0,            # 12 V DC adapter, centre positive [A]
    'vin_min_V': 10.8,            # adapter -10 % [A]
    'vin_max_V': 13.2,            # adapter +10 % [A]
    'fsw_Hz': 400e3,              # TPS54560B switching frequency, set by R4
    'vref_V': 0.8,                # TPS54560B feedback reference [S]
    'r_fb_top_ohm': 71.5e3 + 768.0,  # R6 + R24, sensed at SERVO_V (after the shunt)
    'r_fb_bot_ohm': 10.0e3,       # R7
    'r_rt_ohm': 243e3,            # R4
    'r_uvlo_top_ohm': 294e3,      # R2
    'r_uvlo_bot_ohm': 43.2e3,     # R3
    'l_buck_H': 10e-6,            # L1
    'c_out_ceramic_F': 2 * 47e-6,  # C8 + C9, nominal (derate for DC bias in the calc)
    'c_bulk_F': 1000e-6,          # C12, after the shunt
    'c_wrist_F': 470e-6,          # harness capacitor at the forearm end of the servo cable (not on the PCB)
    'r_comp_ohm': 27.4e3,         # R5
    'c_comp_F': 22e-9,            # C5
    'c_pole_F': 470e-12,          # C6
    'r_shunt_ohm': 0.1,           # RS1; firmware INA219_SHUNT_OHM
    'r_ina_filter_ohm': 10.0,     # R8, R9
    'c_ina_filter_F': 100e-9,     # C10
    'r_fsr_fixed_ohm': 2700.0,    # R15; firmware R_FSR_FIXED_OHM
    'r_aa_ohm': 10e3,             # R16 anti-alias series
    'c_aa_F': 100e-9,             # C17 anti-alias shunt
    'r_i2c_pullup_ohm': 2.2e3,    # R10, R11
    'r_led_ohm': 330.0,           # R21
    'r_lim_pullup_ohm': 4.7e3,    # R17
    'r_lim_series_ohm': 1e3,      # R18
    'c_lim_F': 100e-9,            # C18
    'r_btn_pullup_ohm': 10e3,     # R19
    'r_btn_series_ohm': 1e3,      # R20
    'c_btn_F': 100e-9,            # C19
    'r_pwm_series_ohm': 100.0,    # R13
    'cable_len_m': 1.2,           # board to wrist, one way [A, measure at assembly]
    'cable_power_awg': 20,        # servo V+ and return
    'cable_signal_awg': 26,       # PWM, FSR, limit
}

# ESP32-DevKitC V4 header table. J2 is the left header (pin 1 = 3V3 at the antenna end), J3 the right.
DEVKITC = {
    'url': 'https://docs.espressif.com/projects/esp-dev-kits/en/latest/esp32/esp32-devkitc/user_guide.html',
    'J2': ['3V3', 'EN', 'IO36', 'IO39', 'IO34', 'IO35', 'IO32', 'IO33', 'IO25', 'IO26',
           'IO27', 'IO14', 'IO12', 'GND', 'IO13', 'SD2', 'SD3', 'CMD', '5V'],
    'J3': ['GND', 'IO23', 'IO22', 'TXD0', 'RXD0', 'IO21', 'GND', 'IO19', 'IO18', 'IO5',
           'IO17', 'IO16', 'IO4', 'IO0', 'IO2', 'IO15', 'SD1', 'SD0', 'CLK'],
    'row_pitch_mm': 25.4,
    'board_l_mm': 54.4,
    'board_w_mm': 27.9,
}

# GPIO -> (net, config.h macro). calc/pinmap_check.py compares this line by line with
# firmware/gripper/config.h and with the netlist exported from the committed schematic.
GPIO_NETS = {
    18: ('PWM_3V3', 'PIN_SERVO_PWM'),
    34: ('FSR_ADC', 'PIN_FSR_ADC'),
    32: ('FB_ADC', 'PIN_SERVO_FB_ADC'),
    25: ('BTN_IN', 'PIN_BUTTON'),
    26: ('LIM_IN', 'PIN_LIMIT_OPEN'),
    21: ('SDA', 'PIN_I2C_SDA'),
    22: ('SCL', 'PIN_I2C_SCL'),
    2: ('LED_DRV', 'PIN_STATUS_LED'),
    16: ('DRV_AIN1', 'PIN_DRV_AIN1'),      # DC-gearmotor branch, J6 only
    17: ('DRV_AIN2', 'PIN_DRV_AIN2'),
    13: ('DRV_NSLEEP', 'PIN_DRV_NSLEEP'),
    4: ('DRV_NFAULT', 'PIN_DRV_NFAULT'),
    27: ('ENC_A', 'PIN_ENC_A'),
    33: ('ENC_B', 'PIN_ENC_B'),
}


def devkit_pin_number(gpio):
    """DevKitC socket pin number (1-38) that carries a GPIO."""
    names = DEVKITC['J2'] + DEVKITC['J3']
    return names.index('IO%d' % gpio) + 1


def _devkit_pins():
    pins = {}
    names = DEVKITC['J2'] + DEVKITC['J3']
    for i, name in enumerate(names):
        num = str(i + 1)
        if name == '3V3':
            pins[num] = '+3V3'
        elif name == '5V':
            pins[num] = 'DEVKIT_5V'
        elif name == 'GND':
            pins[num] = 'GND'
        elif name.startswith('IO') and int(name[2:]) in GPIO_NETS:
            pins[num] = GPIO_NETS[int(name[2:])][0]
    return pins


R0603 = 'Resistor_SMD:R_0603_1608Metric'
C0603 = 'Capacitor_SMD:C_0603_1608Metric'
C0805 = 'Capacitor_SMD:C_0805_2012Metric'
C1210 = 'Capacitor_SMD:C_1210_3225Metric'
SOD323 = 'Diode_SMD:D_SOD-323'
TP_FP = 'TestPoint:TestPoint_Keystone_5000-5004_Miniature'


def part(ref, sym, value, fp, pins, at, src=None, **kw):
    p = {'ref': ref, 'sym': sym, 'value': value, 'fp': fp, 'pins': pins, 'at': at, 'src': src}
    p.update(kw)
    return p


def R(ref, value, a, b, at, src, fp=R0603, **kw):
    return part(ref, 'Device:R', value, fp, {'1': a, '2': b}, at, src, **kw)


def C(ref, value, a, b, at, src, fp=C0603, **kw):
    return part(ref, 'Device:C', value, fp, {'1': a, '2': b}, at, src, **kw)


def CP(ref, value, pos, at, src, fp, **kw):
    return part(ref, 'Device:C_Polarized', value, fp, {'1': pos, '2': 'GND'}, at, src, **kw)


def TP(ref, net, at):
    return part(ref, 'Connector:TestPoint', net, TP_FP, {'1': net}, at, 'tp', ref_dx=1.27)


def FLAG(n, net, at):
    return part('#FLG%02d' % n, 'power:PWR_FLAG', 'PWR_FLAG', '', {'1': net}, at, virtual=True)


def grid(col, row, x0, y0, dx=30.48, dy=33.02):
    return (round(x0 + col * dx, 2), round(y0 + row * dy, 2))


# Block origins (mm, A2 sheet 594 x 420)
B_IN = (30.48, 45.72)      # input protection
B_BUCK = (30.48, 152.4)    # buck regulator
B_RAIL = (30.48, 266.7)    # servo rail, shunt, INA219, 5 V, level shift
B_MCU = (350.52, 45.72)    # DevKitC and expansion
B_IO = (350.52, 190.5)     # FSR, limit, button, LED, feedback
B_TP = (350.52, 330.2)     # test points, mounting holes, flags

PARTS = [
    # ---- Input: J1 barrel / J2 screw terminal -> F1 polyfuse -> Q1 reverse-polarity P-FET -> D1 TVS
    part('J1', 'Connector:Barrel_Jack_Switch', '12V IN 2.1mm', 'Connector_BarrelJack:BarrelJack_CUI_PJ-102AH_Horizontal',
         {'1': 'VIN_RAW', '2': 'GND'}, grid(0, 0, *B_IN), 'barrel'),
    part('J2', 'Connector:Screw_Terminal_01x02', '12V IN screw', 'TerminalBlock_Phoenix:TerminalBlock_Phoenix_MKDS-1,5-2-5.08_1x02_P5.08mm_Horizontal',
         {'1': 'VIN_RAW', '2': 'GND'}, grid(0, 1, *B_IN), 'screw2'),
    part('F1', 'Device:Polyfuse', '2.6A hold', 'Fuse:Fuse_1812_4532Metric', {'1': 'VIN_RAW', '2': 'VIN_F'}, grid(1, 0, *B_IN), 'ptc'),
    part('Q1', 'Transistor_FET:FDS9435A', 'AO4407A', 'Package_SO:SOIC-8_3.9x4.9mm_P1.27mm',
         {'1': 'VIN_P', '2': 'VIN_P', '3': 'VIN_P', '4': 'Q1_G', '5': 'VIN_F', '6': 'VIN_F', '7': 'VIN_F', '8': 'VIN_F'},
         grid(2, 0, *B_IN), 'pfet', desc='Reverse-polarity P-FET: drain to the input, source to the load, gate to GND'),
    R('R1', '100k', 'Q1_G', 'GND', grid(3, 0, *B_IN), 'r_100k'),
    part('DZ1', 'Device:D_Zener', 'BZT52C15', 'Diode_SMD:D_SOD-123', {'1': 'VIN_P', '2': 'Q1_G'}, grid(3, 1, *B_IN), 'zener'),
    part('D1', 'Device:D_Zener', 'SMBJ16A', 'Diode_SMD:D_SMB', {'1': 'VIN_P', '2': 'GND'}, grid(4, 0, *B_IN), 'tvs'),
    CP('C1', '100uF 35V', 'VIN_P', grid(5, 0, *B_IN), 'c_100u35', 'Capacitor_THT:CP_Radial_D8.0mm_P3.50mm'),
    C('C2', '10uF 50V', 'VIN_P', 'GND', grid(6, 0, *B_IN), 'c_10u50', fp=C1210),
    C('C3', '10uF 50V', 'VIN_P', 'GND', grid(7, 0, *B_IN), 'c_10u50', fp=C1210),
    C('C4', '100nF 50V', 'VIN_P', 'GND', grid(8, 0, *B_IN), 'c_100n'),

    # ---- Buck: TPS54560B, set point sensed after the shunt at SERVO_V
    part('U1', 'Regulator_Switching:TPS54560BDDA', 'TPS54560BDDAR', 'Package_SO:Texas_R-PDSO-G8_EP2.95x4.9mm_Mask2.4x3.1mm_ThermalVias',
         {'1': 'BOOT', '2': 'VIN_P', '3': 'EN', '4': 'RT', '5': 'FB', '6': 'COMP', '7': 'GND', '8': 'SW', '9': 'GND'},
         grid(1, 1, *B_BUCK), 'buck', ref_dx=-5.08, ref_dy=10.16),
    R('R2', '294k', 'VIN_P', 'EN', grid(0, 0, *B_BUCK), 'r_294k'),
    R('R3', '43.2k', 'EN', 'GND', grid(0, 1, *B_BUCK), 'r_43k2'),
    R('R4', '243k', 'RT', 'GND', grid(0, 2, *B_BUCK), 'r_243k'),
    R('R5', '27.4k', 'COMP', 'COMP_RC', grid(3, 2, *B_BUCK), 'r_27k4'),
    C('C5', '22nF', 'COMP_RC', 'GND', grid(4, 2, *B_BUCK), 'c_22n'),
    C('C6', '470pF', 'COMP', 'GND', grid(5, 2, *B_BUCK), 'c_470p'),
    C('C7', '100nF 50V', 'BOOT', 'SW', grid(3, 0, *B_BUCK), 'c_100n'),
    part('D2', 'Device:D_Schottky', 'B540C', 'Diode_SMD:D_SMC', {'1': 'SW', '2': 'GND'}, grid(4, 0, *B_BUCK), 'schottky'),
    part('L1', 'Device:L', '10uH', 'Inductor_SMD:L_Bourns_SRP1245A', {'1': 'SW', '2': 'V_BUCK'}, grid(5, 0, *B_BUCK), 'inductor'),
    C('C8', '47uF 16V', 'V_BUCK', 'GND', grid(6, 0, *B_BUCK), 'c_47u16', fp=C1210),
    C('C9', '47uF 16V', 'V_BUCK', 'GND', grid(7, 0, *B_BUCK), 'c_47u16', fp=C1210),
    R('R6', '71.5k 0.1%', 'SERVO_V', 'FB_MID', grid(6, 2, *B_BUCK), 'r_71k5_p1'),
    R('R24', '768R', 'FB_MID', 'FB', grid(7, 2, *B_BUCK), 'r_768r',
      desc='Trim in series with R6: 71.5k + 768R = 72.27k, an orderable stand-in for 72.3k 0.1 %'),
    R('R7', '10.0k 0.1%', 'FB', 'GND', grid(8, 2, *B_BUCK), 'r_10k_p1'),

    # ---- Servo rail: Kelvin shunt, INA219, bulk capacitor, servo connectors, 5 V rail, PWM buffer
    # Kelvin by layout: R8 and R9 start at the inner edges of the RS1 pads (see gen_pcb.py)
    R('RS1', '0.1R 1% 2W', 'V_BUCK', 'SERVO_V', grid(0, 0, *B_RAIL), 'shunt', fp='Resistor_SMD:R_2512_6332Metric'),
    R('R8', '10R', 'V_BUCK', 'SNS_P', grid(1, 0, *B_RAIL), 'r_10r'),
    R('R9', '10R', 'SERVO_V', 'SNS_N', grid(1, 1, *B_RAIL), 'r_10r'),
    C('C10', '100nF 50V', 'SNS_P', 'SNS_N', grid(2, 0, *B_RAIL), 'c_100n'),
    part('U2', 'Sensor_Energy:INA219AxD', 'INA219AIDR', 'Package_SO:SOIC-8_3.9x4.9mm_P1.27mm',
         {'8': 'SNS_P', '7': 'SNS_N', '5': '+3V3', '6': 'GND', '1': 'GND', '2': 'GND', '3': 'SDA', '4': 'SCL'},
         grid(3, 0.5, *B_RAIL), 'ina219', ref_dx=-5.08, ref_dy=12.7),
    C('C11', '100nF 50V', '+3V3', 'GND', grid(4.5, 0, *B_RAIL), 'c_100n'),
    R('R10', '2.2k', '+3V3', 'SDA', grid(5.5, 0, *B_RAIL), 'r_2k2'),
    R('R11', '2.2k', '+3V3', 'SCL', grid(6.5, 0, *B_RAIL), 'r_2k2'),
    CP('C12', '1000uF 16V', 'SERVO_V', grid(7.5, 0, *B_RAIL), 'c_1000u16', 'Capacitor_THT:CP_Radial_D10.0mm_P5.00mm'),
    C('C13', '100nF 50V', 'SERVO_V', 'GND', grid(8.5, 0, *B_RAIL), 'c_100n'),
    part('D8', 'Device:D_Zener', 'SMBJ7.0A', 'Diode_SMD:D_SMB', {'1': 'SERVO_V', '2': 'GND'}, grid(8.5, 1, *B_RAIL), 'tvs_servo',
         desc='Clamp for back-driven servo energy: the non-synchronous buck cannot sink current'),
    part('J3', 'Connector:Screw_Terminal_01x03', 'SERVO harness', 'TerminalBlock_Phoenix:TerminalBlock_Phoenix_MKDS-1,5-3-5.08_1x03_P5.08mm_Horizontal',
         {'1': 'GND', '2': 'SERVO_V', '3': 'SERVO_PWM'}, grid(9.5, 0, *B_RAIL), 'screw3'),
    part('J7', 'Connector_Generic:Conn_01x03', 'SERVO bench', 'Connector_PinHeader_2.54mm:PinHeader_1x03_P2.54mm_Vertical',
         {'1': 'GND', '2': 'SERVO_V', '3': 'SERVO_PWM'}, grid(9.5, 1, *B_RAIL), 'hdr3',
         desc='Standard servo plug order (GND, V+, signal) for a servo plugged straight in on the bench; 3 A contacts'),
    part('U3', 'Regulator_Linear:MCP1703Ax-500xxDB', 'MCP1703AT-5002E/DB', 'Package_TO_SOT_SMD:SOT-223-3_TabPin2',
         {'1': 'V_BUCK', '2': 'GND', '3': '+5V'}, grid(1, 2, *B_RAIL), 'ldo5', ref_dy=10.16),
    C('C14', '1uF 25V', 'V_BUCK', 'GND', grid(0, 2, *B_RAIL), 'c_1u25'),
    C('C15', '1uF 25V', '+5V', 'GND', grid(2, 2, *B_RAIL), 'c_1u25'),
    part('D7', 'Device:D_Schottky', 'BAT60A', SOD323, {'1': 'DEVKIT_5V', '2': '+5V'}, grid(2.75, 2, *B_RAIL), 'd_5v',
         desc='Diode-OR of the board 5 V rail into the DevKitC 5V pin; the DevKitC has its own diode from USB'),
    part('U4', '74xGxx:74AHCT1G125', 'SN74AHCT1G125DBVR', 'Package_TO_SOT_SMD:SOT-23-5',
         {'1': 'GND', '2': 'PWM_3V3', '3': 'GND', '4': 'PWM_5V', '5': '+5V'}, grid(4.5, 2, *B_RAIL), 'ahct', ref_dy=12.7),
    C('C16', '100nF 50V', '+5V', 'GND', grid(3.5, 2, *B_RAIL), 'c_100n'),
    R('R12', '10k', 'PWM_3V3', 'GND', grid(5.5, 2, *B_RAIL), 'r_10k'),
    R('R13', '100R', 'PWM_5V', 'SERVO_PWM', grid(6.5, 2, *B_RAIL), 'r_100r'),
    R('R14', '0R DNP', 'PWM_3V3', 'SERVO_PWM', grid(7.5, 2, *B_RAIL), 'r_0r', dnp=True,
      desc='Bypass for U4: fit only with U4 removed, after M16 shows the servo accepts 3.3 V pulses'),
    part('D3', 'Device:D_TVS', 'PESD5V0S1BA', SOD323, {'1': 'SERVO_PWM', '2': 'GND'}, grid(8.5, 2, *B_RAIL), 'esd'),

    # ---- MCU: DevKitC on sockets, DC-branch expansion header
    part('U5', 'gripper:ESP32-DevKitC-V4', 'ESP32-DevKitC-V4', 'gripper:ESP32-DevKitC-V4_Socket',
         _devkit_pins(), grid(2, 1.5, *B_MCU), 'devkitc', ref_dx=-5.08, ref_dy=27.94),
    part('J6', 'Connector_Generic:Conn_01x08', 'DC EXP', 'Connector_PinHeader_2.54mm:PinHeader_1x08_P2.54mm_Vertical',
         {'1': 'DRV_AIN1', '2': 'DRV_AIN2', '3': 'DRV_NSLEEP', '4': 'DRV_NFAULT', '5': 'ENC_A', '6': 'ENC_B',
          '7': '+3V3', '8': 'GND'}, grid(6, 1.5, *B_MCU), 'hdr8',
         desc='DC-gearmotor branch (DRV8833 breakout + encoder); unused by the servo firmware'),

    # ---- Sensor connector J4 (FSR on finger B + open limit switch), FSR divider and anti-alias filter
    part('J4', 'Connector_Generic:Conn_01x04', 'GRIPPER SENSORS', 'Connector_JST:JST_XH_B4B-XH-A_1x04_P2.50mm_Vertical',
         {'1': '+3V3', '2': 'FSR_SIG', '3': 'LIM_SIG', '4': 'GND'}, grid(0, 0, *B_IO, 22.86), 'xh4'),
    R('R15', '2.70k 0.1%', 'FSR_SIG', 'GND', grid(1, 0, *B_IO, 22.86), 'r_2k7_p1'),
    R('R16', '10k', 'FSR_SIG', 'FSR_ADC', grid(2, 0, *B_IO, 22.86), 'r_10k'),
    C('C17', '100nF 50V', 'FSR_ADC', 'GND', grid(3, 0, *B_IO, 22.86), 'c_100n'),
    part('D4', 'Device:D_TVS', 'PESD5V0S1BA', SOD323, {'1': 'FSR_SIG', '2': 'GND'}, grid(4, 0, *B_IO, 22.86), 'esd'),
    R('R17', '4.7k', '+3V3', 'LIM_SIG', grid(5, 0, *B_IO, 22.86), 'r_4k7'),
    R('R18', '1k', 'LIM_SIG', 'LIM_IN', grid(6, 0, *B_IO, 22.86), 'r_1k'),
    C('C18', '100nF 50V', 'LIM_IN', 'GND', grid(7, 0, *B_IO, 22.86), 'c_100n'),
    part('D5', 'Device:D_TVS', 'PESD5V0S1BA', SOD323, {'1': 'LIM_SIG', '2': 'GND'}, grid(8, 0, *B_IO, 22.86), 'esd'),
    # ---- Button, status LED, servo feedback input
    part('SW1', 'Switch:SW_Push', 'START/STOP', 'Button_Switch_THT:SW_PUSH_6mm', {'1': 'BTN_SW', '2': 'GND'}, grid(0, 2, *B_IO, 22.86), 'tact'),
    R('R19', '10k', '+3V3', 'BTN_SW', grid(1, 2, *B_IO, 22.86), 'r_10k'),
    R('R20', '1k', 'BTN_SW', 'BTN_IN', grid(2, 2, *B_IO, 22.86), 'r_1k'),
    C('C19', '100nF 50V', 'BTN_IN', 'GND', grid(3, 2, *B_IO, 22.86), 'c_100n'),
    R('R21', '330R', 'LED_DRV', 'LED_A', grid(4, 2, *B_IO, 22.86), 'r_330r'),
    part('D6', 'Device:LED', 'GREEN', 'LED_SMD:LED_0805_2012Metric', {'1': 'GND', '2': 'LED_A'}, grid(5, 2, *B_IO, 22.86), 'led'),
    part('J5', 'Connector_Generic:Conn_01x03', 'SERVO FB', 'Connector_PinHeader_2.54mm:PinHeader_1x03_P2.54mm_Vertical',
         {'1': 'FB_IN', '2': '+3V3', '3': 'GND'}, grid(6, 2, *B_IO, 22.86), 'hdr3',
         desc='Optional servo pot tap (FB_ENABLED 0 in config.h); unused by default'),
    R('R22', '1k', 'FB_IN', 'FB_ADC', grid(7, 2, *B_IO, 22.86), 'r_1k'),
    C('C20', '10nF', 'FB_ADC', 'GND', grid(8, 2, *B_IO, 22.86), 'c_10n'),
    R('R23', 'DNP', 'FB_ADC', 'GND', grid(9, 2, *B_IO, 22.86), 'r_0r', dnp=True,
      desc='Divider bottom for the servo pot wiper: fit only if the wiper exceeds 3.1 V'),
]

# Test points: every node the bring-up and bench checks probe.
TP_NETS = ['VIN_P', 'V_BUCK', 'SERVO_V', '+5V', '+3V3', 'GND', 'GND', 'GND', 'SERVO_PWM', 'PWM_3V3',
           'FSR_SIG', 'FSR_ADC', 'SDA', 'SCL', 'BTN_IN', 'LIM_IN']
for _i, _net in enumerate(TP_NETS):
    PARTS.append(TP('TP%d' % (_i + 1), _net, grid(_i % 8, _i // 8, B_TP[0], B_TP[1], dx=22.86, dy=20.32)))
for _i in range(4):
    PARTS.append(part('H%d' % (_i + 1), 'Mechanical:MountingHole', 'M3', 'MountingHole:MountingHole_3.2mm_M3',
                      {}, grid(_i, 2.5, B_TP[0], B_TP[1], dx=22.86, dy=20.32), None, bom=False))
for _i, _net in enumerate(['GND', 'VIN_P', 'V_BUCK']):
    PARTS.append(FLAG(_i + 1, _net, grid(4 + _i, 2.5, B_TP[0], B_TP[1], dx=22.86, dy=20.32)))

# Symbol pin-name check: for these parts the generator asserts that the library symbol's pin name
# contains the text given (case-insensitive), so a wrong pin number cannot pass silently.
EXPECT = {
    'U1': {'1': 'BOOT', '2': 'VIN', '3': 'EN', '4': 'RT', '5': 'FB', '6': 'COMP', '7': 'GND', '8': 'SW'},
    'U2': {'1': 'A1', '2': 'A0', '3': 'SDA', '4': 'SCL', '5': 'V', '6': 'GND', '7': 'IN-', '8': 'IN+'},
    'U3': {'1': 'VI', '2': 'GND', '3': 'VO'},
    'U4': {'3': 'GND', '5': 'VCC'},   # library symbol leaves 1 (OE, top), 2 (A, left), 4 (Y, right) unnamed
    'Q1': {'1': 'S', '4': 'G', '5': 'D'},
    'D2': {'1': 'K', '2': 'A'},
    'D7': {'1': 'K', '2': 'A'},
    'DZ1': {'1': 'K', '2': 'A'},
    'D1': {'1': 'K', '2': 'A'},
    'D8': {'1': 'K', '2': 'A'},
    'D6': {'1': 'K', '2': 'A'},
}

TEXTS = [
    {'text': 'INPUT: 12 V adapter or bench supply; polyfuse, reverse-polarity P-FET, TVS', 'at': (B_IN[0] - 10.16, B_IN[1] - 20.32), 'size': 2.54},
    {'text': 'BUCK: TPS54560B, 400 kHz, servo rail 6.58 V sensed after the shunt', 'at': (B_BUCK[0] - 10.16, B_BUCK[1] - 20.32), 'size': 2.54},
    {'text': 'SERVO RAIL: 0.1 ohm Kelvin shunt + INA219 (0x40), 1000 uF bulk, 5 V rail, 5 V PWM buffer', 'at': (B_RAIL[0] - 10.16, B_RAIL[1] - 20.32), 'size': 2.54},
    {'text': 'MCU: ESP32-DevKitC V4 on sockets; 5 V from USB or from the board through D7', 'at': (B_MCU[0] - 10.16, B_MCU[1] - 20.32), 'size': 2.54},
    {'text': 'I/O: FSR divider + anti-alias, limit switch, button, LED, servo feedback', 'at': (B_IO[0] - 10.16, B_IO[1] - 20.32), 'size': 2.54},
    {'text': 'TEST POINTS, MOUNTING, ERC FLAGS', 'at': (B_TP[0] - 10.16, B_TP[1] - 15.24), 'size': 2.54},
]


def nets():
    """net -> sorted [(ref, pin)] from PARTS, virtual parts (power flags) excluded."""
    out = {}
    for p in PARTS:
        if p.get('virtual'):
            continue
        for pin, net in p['pins'].items():
            out.setdefault(net, []).append((p['ref'], pin))
    return {k: sorted(v) for k, v in out.items()}


def bom_parts():
    """Parts that are bought and placed (no power flags, no mounting holes)."""
    return [p for p in PARTS if not p.get('virtual') and p.get('bom', True)]
