douglaspmcgowan/cloth-feed-gripper/ecad/gripper/calc/run_all.py

"""Regenerate every number and figure of the gripper controller calculations.

Run from the repository root: python ecad/gripper/calc/run_all.py

Runs each script in order, writes out/<name>.json (results) and out/<name>.txt (what the script prints), then the figures under
out/figures/. Exit status 0 only if every script ran. Deterministic: no random numbers are used anywhere.
"""
import argparse
import contextlib
import importlib
import io
import os
import sys
import time
import traceback
import tempfile
import json
import shutil
import gc
import subprocess
from pathlib import Path

import _common as cm
import release_artifacts
import margin_inputs

ORDER = ['constants', 'power_budget', 'buck_design', 'fsr_frontend', 'ina219_budget', 'trace_width',
         'droop_sim', 'open_requirements', 'fault_limit', 'margins', 'pinmap_check', 'harness']
REFERENCE = None
NUMERIC_DIFFERENCES = []
KEPT_VALUES = []


def _clear_calculation_caches():
    for module_name in ORDER:
        module = sys.modules.get(module_name)
        if not module:
            continue
        for value in vars(module).values():
            clear = getattr(value, 'cache_clear', None)
            if clear:
                clear()


def _sensitivity_value(value, factor):
    if isinstance(value, tuple):
        return tuple(_sensitivity_value(item, factor) for item in value)
    changed = value * factor
    return max(1, round(changed)) if isinstance(value, int) else changed


def _first_stored_difference(left, right, key=''):
    if type(left) is not type(right):
        return key or '<root>'
    if isinstance(left, dict):
        if set(left) != set(right):
            return key or '<root>'
        for child in sorted(left):
            found = _first_stored_difference(
                left[child], right[child], '%s.%s' % (key, child) if key else child)
            if found:
                return found
    elif isinstance(left, list):
        if len(left) != len(right):
            return key + '.length'
        for index, (a, b) in enumerate(zip(left, right)):
            found = _first_stored_difference(a, b, '%s[%d]' % (key, index))
            if found:
                return found
    elif left != right:
        return key or '<root>'
    return None


def _module_result(name):
    _clear_calculation_caches()
    module = importlib.import_module(name)
    with margin_inputs.recording():
        return cm.classified_jsonable(name + '.json', module.run())


def _isolated_module_result(name, entry=None, value=None):
    with tempfile.TemporaryDirectory() as temporary_directory:
        output = Path(temporary_directory, 'result.json')
        command = [sys.executable, __file__, '--sensitivity-worker', name,
                   '--sensitivity-output', str(output)]
        if entry is not None:
            command.extend(('--sensitivity-setting', entry,
                            '--sensitivity-value', json.dumps(value)))
        completed = subprocess.run(command, check=False, capture_output=True, text=True)
        if completed.returncode:
            raise RuntimeError(completed.stderr or completed.stdout)
        return json.loads(output.read_text(encoding='utf-8'))


def _isolated_difference(name, entry, value):
    command = [sys.executable, __file__, '--sensitivity-compare', name,
               '--sensitivity-setting', entry, '--sensitivity-value', json.dumps(value)]
    completed = subprocess.run(command, check=False, capture_output=True, text=True)
    if completed.returncode:
        raise RuntimeError(completed.stderr or completed.stdout)
    return completed.stdout.strip() or None


def numerics_sensitivity(entries=None, write_table=False):
    """Measure convergence against the scalar quantities used by margin rows."""
    import numerics_sensitivity as ns
    try:
        table, failures = ns.measure(entries)
    except (ValueError, RuntimeError) as error:
        print('numerics sensitivity FAIL: %s' % error)
        return 1
    target = Path(cm.HERE, 'out/numerics_sensitivity.json')
    if write_table and not entries:
        ns.write_table(table, target)
    for entry, details in table['entries'].items():
        worst = max((run['worst']['fraction_of_margin'] for run in details['runs']), default=0)
        print('%s method: worst fraction %.9g' % (entry, worst))
    if failures:
        entry, factor, item = failures[0]
        print('numerics sensitivity FAIL: %s %sx row %s measured fraction %.9g' %
              (entry, factor, item['row'], item['fraction_of_margin']))
        return 1
    if not write_table and target.exists():
        committed = json.loads(target.read_text(encoding='utf-8'))
        for entry in table['entries']:
            difference = ns.comparison_difference(
                committed.get('entries', {}).get(entry), table['entries'].get(entry), entry)
            if difference:
                print('numerics sensitivity FAIL: %s' % difference)
                return 1
    print('numerics sensitivity: %d method entries passed' % len(table['entries']))
    return 0


def reconcile(filename, committed, generated, key=''):
    """Keep tolerably equal integrated values; exact values remain byte-strict."""
    if type(committed) is not type(generated):
        return generated
    if isinstance(generated, dict):
        if set(committed) != set(generated):
            return generated
        return {k: reconcile(filename, committed[k], generated[k], '%s.%s' % (key, k) if key else k) for k in generated}
    if isinstance(generated, list):
        if len(committed) != len(generated):
            return generated
        return [reconcile(filename, a, b, '%s[%d]' % (key, i)) for i, (a, b) in enumerate(zip(committed, generated))]
    if isinstance(generated, float) and cm.value_class(filename, key) == 'integrated':
        limit = cm.tolerance(filename, key, committed, generated)
        if abs(committed - generated) <= limit:
            if committed != generated:
                KEPT_VALUES.append((filename, key, abs(committed - generated) / max(abs(generated), 1e-30)))
            return committed
        NUMERIC_DIFFERENCES.append((filename, key, committed, generated, limit))
    return generated


def run_one(name, results):
    mod = importlib.import_module(name)
    buf = io.StringIO()
    t0 = time.time()
    with contextlib.redirect_stdout(buf):
        with margin_inputs.recording() as observed:
            raw = mod.run()
            if name == 'margins':
                raw = _add_numerical_sensitivity(raw)
        margin_inputs.MODULE_READS[name] = {
            item for item in observed if not item.startswith('module:')
        }
        if name == 'fault_limit':
            cm.OUTPUT_SCHEMA['fault_limit.json'] = frozenset(raw)
        res = cm.classified_values(name + '.json', raw)
        wanted = Path(REFERENCE, name + '.json') if REFERENCE else None
        if wanted and wanted.exists():
            res = reconcile(name + '.json', json.loads(wanted.read_text(encoding='utf-8')), res)
        mod.report(res)
    text = buf.getvalue()
    cm.write_text(name + '.txt', text, encoding='utf-8')
    cm.write_json(name, res)
    results[name] = res
    print('%-18s ok  %5.1f s  %d lines' % (name, time.time() - t0, text.count('\n')))


def _add_numerical_sensitivity(result):
    """Attach measured row evidence when a current convergence table exists."""
    import numerics_sensitivity as ns
    path = Path(cm.HERE, 'out/numerics_sensitivity.json')
    if path.exists():
        table = json.loads(path.read_text(encoding='utf-8'))
        values = ns.row_sensitivities(table, [row['id'] for row in result['rows']])
    else:
        values = {row['id']: {'fraction_of_margin': 0.0, 'cause': ''}
                  for row in result['rows']}
    for row in result['rows']:
        row['numerical_sensitivity'] = values[row['id']]
    return result


def figures(res):
    import matplotlib
    matplotlib.use('Agg')
    import matplotlib.pyplot as plt
    import numpy as np
    import fsr_frontend as ff
    os.makedirs(cm.FIG, exist_ok=True)
    made = []

    # 1. FSR node voltage against force
    fig, ax = plt.subplots(figsize=(7, 4.2))
    f = np.logspace(np.log10(0.1), np.log10(12), 200)
    for r_fixed, lab in ((2700.0, 'R15 2.70 k (design)'), (2610.0, '2.61 k (10 N cap, E96)'), (3160.0, '3.16 k (8 N cap, E96)')):
        ax.plot(f, [cm.node_mv(x, r_fixed) for x in f], label=lab)
    ax.axhspan(150, 2450, color='0.9', label='ADC span 150 to 2450 mV')
    ax.axvline(8, color='k', ls=':', lw=0.8)
    ax.axvline(10, color='k', ls=':', lw=0.8)
    ax.set_xscale('log')
    ax.set_xlabel('pad force (N)')
    ax.set_ylabel('FSR node voltage (mV)')
    ax.set_title('FSR node voltage against force (3.3 V supply, firmware power-law fit)')
    ax.legend(fontsize=8)
    ax.grid(True, which='both', alpha=0.3)
    p = os.path.join(cm.FIG, 'fsr_node_vs_force.png')
    fig.tight_layout()
    fig.savefig(p, dpi=110)
    plt.close(fig)
    made.append(p)

    # 2. filter magnitude response
    fig, ax = plt.subplots(figsize=(7, 4.2))
    fr = np.logspace(0, 3.4, 300)
    for force in (0.0, 0.5, 5.0, 10.0):
        pt = ff.filter_point(force)
        ax.plot(fr, 20 * np.log10(1 / np.sqrt(1 + (fr / pt['fc_Hz']) ** 2)), label=('open FSR' if not force else '%g N' % force) + ' (fc %.0f Hz)' % pt['fc_Hz'])
    ax.axvline(500, color='k', ls=':', lw=0.8)
    ax.set_xscale('log')
    ax.set_xlabel('frequency (Hz)')
    ax.set_ylabel('gain (dB)')
    ax.set_title('Anti-alias filter R16 + (R15 || FSR), C17; dotted line = 500 Hz Nyquist')
    ax.legend(fontsize=8)
    ax.grid(True, which='both', alpha=0.3)
    p = os.path.join(cm.FIG, 'filter_response.png')
    fig.tight_layout()
    fig.savefig(p, dpi=110)
    plt.close(fig)
    made.append(p)

    # 3. Bode
    b = res['buck_design']['bode']
    fig, (a1, a2) = plt.subplots(2, 1, figsize=(7, 6), sharex=True)
    for lab, m, ph in (('nominal (1 A, 12 V)', b['nom_mag_dB'], b['nom_ph_deg']), ('worst phase-margin corner', b['worst_mag_dB'], b['worst_ph_deg'])):
        a1.semilogx(b['f'], m, label=lab)
        a2.semilogx(b['f'], ph, label=lab)
    a1.axhline(0, color='k', lw=0.8)
    a2.axhline(-135, color='r', ls=':', lw=0.8, label='45 deg phase margin')
    a2.axhline(-180, color='k', lw=0.8)
    a1.set_ylabel('loop gain (dB)')
    a2.set_ylabel('phase (deg)')
    a2.set_xlabel('frequency (Hz)')
    a1.set_title('Loop gain T(s): compensator R5 27.4 k, C5 22 nF, C6 470 pF, feedback at SERVO_V')
    a1.legend(fontsize=8)
    a2.legend(fontsize=8)
    a1.grid(True, which='both', alpha=0.3)
    a2.grid(True, which='both', alpha=0.3)
    p = os.path.join(cm.FIG, 'loop_bode.png')
    fig.tight_layout()
    fig.savefig(p, dpi=110)
    plt.close(fig)
    made.append(p)

    # 4. stall-droop transient
    ds = res['droop_sim']
    fig, (a1, a2) = plt.subplots(2, 1, figsize=(7, 6), sharex=True)
    for s, ls in ((ds['cases'][0], '-'), (ds['cases'][1], '--')):
        t = s['trace']
        lab = '%s rise' % ('1 ms' if s['params']['rise'] > 5e-4 else '10 us')
        a1.plot(t['t_ms'], t['vbuck'], ls, color='C0', label='V_BUCK, ' + lab)
        a1.plot(t['t_ms'], t['servo_v'], ls, color='C1', label='SERVO_V, ' + lab)
        a1.plot(t['t_ms'], t['plug'], ls, color='C2', label='servo plug, ' + lab)
        a2.plot(t['t_ms'], t['iL'], ls, color='C3', label='inductor current, ' + lab)
        a2.plot(t['t_ms'], t['i_servo'], ls, color='C4', label='servo current, ' + lab)
    a2.axhline(6.3, color='r', ls=':', lw=0.8, label='current limit, min 6.3 A')
    a1.set_xlim(-0.2, 3)
    a1.set_ylabel('volts')
    a2.set_ylabel('amps')
    a2.set_xlabel('time after the stall step (ms)')
    a1.set_title('Fit A stall step, 1000 uF bulk + 470 uF forearm capacitor, 12 V in')
    a1.legend(fontsize=7)
    a2.legend(fontsize=7)
    a1.grid(True, alpha=0.3)
    a2.grid(True, alpha=0.3)
    p = os.path.join(cm.FIG, 'droop_transient.png')
    fig.tight_layout()
    fig.savefig(p, dpi=110)
    plt.close(fig)
    made.append(p)

    # 5. droop against bulk capacitance
    fig, ax = plt.subplots(figsize=(7, 4.2))
    for wrist, ls in ((True, '-'), (False, '--')):
        rows = [s for s in ds['sweep'] if s['params']['wrist'] == wrist]
        c = [s['params']['cb'] * 1e6 for s in rows]
        ax.plot(c, [s['plug_min_V'] for s in rows], 'o' + ls, color='C2', label='servo plug minimum, %s 470 uF forearm' % ('with' if wrist else 'without'))
        ax.plot(c, [s['servo_v_min_V'] for s in rows], 's' + ls, color='C1', label='SERVO_V minimum, %s forearm' % ('with' if wrist else 'without'))
    ax.axhline(4.8, color='r', ls=':', lw=0.8, label='servo minimum 4.8 V')
    ax.set_xscale('log')
    ax.set_xlabel('bulk capacitance C12 (uF)')
    ax.set_ylabel('minimum voltage in a Fit A, 10 us stall step (V)')
    ax.set_title('Stall droop against bulk capacitance')
    ax.legend(fontsize=7)
    ax.grid(True, which='both', alpha=0.3)
    p = os.path.join(cm.FIG, 'droop_vs_cbulk.png')
    fig.tight_layout()
    fig.savefig(p, dpi=110)
    plt.close(fig)
    made.append(p)
    return made
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
