douglaspmcgowan/cloth-feed-gripper/(commit log)

2026-10-11 Public site v1: landing page, film and design review app
    Squash of agent/site-v1. Serves public/ only. Gates run locally: Playwright 151 passed, check_public 0 open, check_live 26 ok, VerifyProject passed, gitleaks success.
2026-10-16 [cloud lane cfg-pr4-deferred-cloud] Remove harness remnants from .gitignore, SPEC, probes; fill PRODUCT.md (#6)
2026-10-19 Move gripper project into cloth-feed-gripper (source cleanup pending) (#8)
    * Document gripper move inventory and public safety holdbacks
    * Move gripper project from berkeley-ai-tutor
    * Read gripper site inputs from moved repository
    * Keep rev A check inputs with moved analysis
    * Document moved Python check dependencies
    * Record move provenance and retained process pages
    * Bring pinned SO-101 inputs into gripper repository
2026-10-19 Refresh stale gripper analysis and fit results (#9)
    * Checkpoint regenerated finger result; expose ruled moment-arm conflict
    * Correct finger moment arm and guard generated beam results
    * Align finger analysis prose with regenerated design point
    * Refresh dyno results from current beam and gear inputs
    * Correct POM rank in refreshed dyno prose
    * Refresh fit audit and committed viewer
2026-10-19 Re-sync the site from cloth-feed-gripper main 487c984 (#10)
    The site now reads this repository, so provenance names it and the two
    allowlist lines for the private source repository name are dropped.
2026-10-19 Refresh generated gripper results after finger-beam update (#13)
    * Refresh dyno input fingerprint
    * Refresh thermal dyno fingerprint
    * Refresh test plan dyno fingerprint
2026-10-19 B40: strengthen dog coupling with shoulder dogs and steel inserts (#14)
    * WIP: size B40 dog coupling and tolerance option
    * Document B40 coupling choice and assumptions
    * Record inner horn ligament for B40 coupon
    * Keep B40 risk text unambiguous for stack checks
    * Record inner horn web as a B40 coupon risk
    * Account for steel inserts in viewer BOM
    * Regenerate B40 CAD and dependent analysis results
    * B40: regenerate coupling tolerance figures
    * Refresh B40 derived review and test evidence
    * Refresh B40 mass and coupling README evidence
    * Pin regenerated B40 fit audit digest
    * Refresh B40 tolerance loop fingerprints
    * Update B40 tolerance verdict prose
    * Stabilize independent tol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
2026-10-19 Checkpoint R19 relabel at actuator selection stop
2026-10-19 Record ruled actuator and concept selections
2026-10-19 Refresh electrical convergence evidence and complete R19 ledger
2026-10-19 Pin historical actuation geometry with its rev A reference inputs
2026-10-20 Regenerate current fit audit and rebuild ruled R19 viewer
2026-10-20 Record B4 assembly grading disposition in fit audit
2026-10-20 Source buck gain margin limit to owner decision
2026-10-20 Refresh numerical evidence after buck decision note
2026-10-20 Regenerate gripper ordering outputs
2026-10-20 Source gripper power parts from selected datasheets
2026-10-20 Derive power-budget labels from constants; update stale test pins
2026-10-21 Guide first-time reviewers through the gripper design (#20)
    * docs: checkpoint professor demo baseline and design plan
    * feat: guide professors from gripper film to design evidence
    * fix: reveal the horn clearance finding from the guided tour
    * docs: record professor demo verification and delivery
    * chore: drop lane report from the tree
    ---------
2026-10-22 Record independent acceptance of repaired local review flows
2026-10-23 Prepare original camera continuation with preserved failure and fresh exact baseline
2026-10-23 Fix gripper camera framing and fit permalink
2026-10-23 Preserve terminal camera maker report; independent verification remains pending
2026-10-23 docs: adjudicate preserved camera candidate after source2 timeout
