douglaspmcgowan/cloth-feed-gripper/(notices)

Notices in the files:
docs/gripper/analysis/controls.md:
Section numbers.** Other documents cite this note's earlier numbering: "5.1" and "5.4" and "5.5" (simulation results, W2b-1) are now section 6 and 4.4; "7 O" (open items) is now section 8 O, same item numbers; "4.2 item 7" (squeeze cap) is now 4.1 item 8.
